davinciucberkeley-collab/DBF-Combined/redesign/interfaces/REPORT.md

# Interfaces merge report

Generated by `python -I redesign/interfaces/merge_check.py`. Do not edit by hand.

| Sources | Parts | Connection types | Edges | Errors | Warnings |
|---|---|---|---|---|---|
| 11 | 239 | 60 | 358 | 0 | 5 |

## Mass and CG (declared part data, flight parts)

| Subsystem | Parts | Status P/M/C/V | Mass g | Alloc g | CG x,y,z m | No mass | No CG |
|---|---|---|---|---|---|---|---|
| avionics | 7 | 0/7/0/0 | 36 | 45 | -0.017, 0.002, 0.062 | - | - |
| fins | 54 | 0/54/0/0 | 433 | 438 | 0.100, 0.000, 0.002 | - | - |
| harness | 38 | 0/38/0/0 | 141 | 129 | 0.066, 0.000, 0.014 | - | - |
| landing | 18 | 0/18/0/0 | 59 | 60 | 0.311, 0.000, 0.000 | - | - |
| mechanisms | 26 | 0/26/0/0 | 72 | 72 | 0.217, 0.000, -0.002 | - | - |
| pod | 12 | 0/12/0/0 | 145 | 146 | -0.007, -0.004, 0.049 | - | - |
| power | 13 | 0/13/0/0 | 626 | 630 | -0.031, -0.005, 0.046 | - | - |
| propulsion | 32 | 0/32/0/0 | 462 | 462 | 0.012, 0.000, 0.000 | - | - |
| wing | 15 | 0/15/0/0 | 392 | 405 | 0.114, 0.000, 0.005 | - | - |
| **total** | 215 | | **2367** | 2600 | 0.049, -0.001, 0.018 | | |

Budget: params/mass_budget.json

## Findings

| Severity | Check | Item | Detail |
|---|---|---|---|
| WARN | mass | harness | subsystem 141 g > allocation 129 g |
| WARN | mass | mechanisms | subsystem 72 g > allocation 72 g |
| WARN | one-sided | E-HRN-22 | avionics acknowledges an edge nobody declares |
| WARN | one-sided | E-WNG-14 | declared by wing; fins has not acknowledged it |
| WARN | one-sided | E-WNG-15 | declared by wing; fins has not acknowledged it |
