davinciucberkeley-collab/DBF-Combined/redesign/fusion/DATUMS.md

# K09-L datum sheet

Status: `PROPOSED` (A5, 2026-11-09, params revision A1-R3, geometry R3). Every designer builds from these names, never from
typed numbers. The table in section 3 is generated by `python -I redesign/fusion/k09kit.py --datums-md` from
`params/params.json` and, for the R3 points the designers own, from their subsystem files: `DP-MOTOR-FACE`,
`DX-COLLAR-*`, `DX-ANCHOR-*` from `subsystems/fins/params.json#fin_detail` (D3), `DX-FOOT-*` from
`subsystems/landing/params.json#landing.pad` (D5). `check.py` warns when the table is stale against any of them.
A datum moves only when A1 changes `params.json` or the owning designer changes those keys (and A5 regenerates).

## 1. Frame

| Item | Value | Source |
|---|---|---|
| Origin | wing root leading edge, on the chord line, in the plane of symmetry | `params.json#frame.origin` |
| +x | aft, LE → TE (cruise drag direction) | `params.json#frame.x` |
| +y | right wing tip, seen from behind in cruise | `params.json#frame.y` |
| +z | up in cruise (toward the pod) | `params.json#frame.z` |
| Handedness · units | right-handed · metres in files and code; `fusionkit` hands Fusion cm | `fusion/README.md` |
| Fusion view | Preferences > General > Design > Default modeling orientation = **Z up** | — |
| Symmetry | `DP-SYM` (y = 0) left/right; `DP-CHORD` (z = 0) upper/lower motor pairs | `params.json#frame.symmetry_plane` |
| Part position | centre of its bounding box; motors by shaft axis at the mount face | `params.json#frame.station_convention` |

## 2. Attitudes

| Attitude | Transform from the frame | Ground | Use |
|---|---|---|---|
| Cruise (model attitude) | none | — | all CAD, `interfaces.json` `cg_xyz_m`, analyses |
| Transport | none: the aircraft stays in the frame, props off, pitot boom out; the box is modelled around it, centre `DX-BOX` (`k09kit.box_frame()`) | box floor | `transport` module (flight: false), `check.py` transport fit |
| Hover / standing | rotate +90° about y (body +x → world −z, body +z → world +x), lift 0.368 m (TE 0.320 + foot 0.048, D-30) | `DP-GROUND` (x = TE + foot) on world z = 0 | renders, viewer, tip-over, ground keep-out |

`k09kit.hover_pose(params)` and `k09kit.to_hover(p, params)` give the transform. Never model a part in the hover
attitude. There is no tilt joint on K09-L: motors are fixed, the aircraft pitches as a whole.

## 3. Datums

Names: `DP-` plane (normal = the axis column), `DA-` axis (point + direction), `DX-` point. Motor stations
`UR UL LR LL`: U/L = +z/−z, R/L = +y/−y; counter-rotating pairs are diagonal (UR+LL, UL+LR). In code: `ctx.D('DP-SPAR')`
→ 0.080; `ctx.D('DX-HUB-UR')` → (−0.0082, 0.320, 0.190). In Fusion: component **00 Datums (DATUMS.md)**, grounded,
never edited by hand.

<!-- datums:begin (generated by k09kit.py --datums-md; do not edit by hand) -->
| Name | Kind | x | y | z | Normal / dir | From `params.json` | What it is |
|---|---|---|---|---|---|---|---|
| `DP-SYM` | plane | — | 0 | — | Y | `frame.symmetry_plane` | symmetry plane; ctx.mirror(plane="XZ") |
| `DP-CHORD` | plane | — | — | 0 | Z | `frame.origin` | wing chord plane; mirror plane for upper/lower motors |
| `DP-LE` | plane | 0 | — | — | X | `wing.le_x_m` | wing leading edge = frame origin |
| `DP-TE` | plane | 0.320 | — | — | X | `wing.te_x_m` | wing and fin trailing edge |
| `DP-SPAR` | plane | 0.080 | — | — | X | `wing.spar.x_m` | spar centreline station (25.0 % chord) |
| `DP-HINGE` | plane | 0.2496 | — | — | X | `wing.elevon.chord_frac` | elevon hinge line = c (1 - chord_frac) |
| `DP-CG` | plane | 0.049 | — | — | X | `cg.x_target_m` | CG target station (range in cg.x_range_m) |
| `DP-POD-LE` | plane | -0.140 | — | — | X | `pod.x_le_m` | pod front face |
| `DP-TUBE` | plane | 0.045 | — | — | X | `fins.tube.x_m` | motor-tube centreline station = fin LE |
| `DP-MOUNT` | plane | 0.034 | — | — | X | `propulsion.stations.x_mount_m` | tube front face = tube x - tube OD/2 (D-28: stays here) |
| `DP-MOTOR-FACE` | plane | 0.0244 | — | — | X | `fins/params.json#fin_detail.mount` | motor base plate face on the motor axis (D-28); the plate is canted 7 deg about this point |
| `DP-PROP` | plane | -0.0127 | — | — | X | `propulsion.stations.x_prop_plane_m` | propeller disc plane (all four props) |
| `DP-GROUND` | plane | 0.368 | — | — | X | `cg.foot_height_m` | ground in hover = TE + foot (D-30: 48 mm); nothing but feet beyond it |
| `DP-FIN-R` | plane | — | 0.320 | — | Y | `fins.y_m` | fin mid-plane, motor stations, through-core block |
| `DP-TIP-R` | plane | — | 0.575 | — | Y | `wing.span_m` | wing tip |
| `DP-SPAR-END-R` | plane | — | 0.500 | — | Y | `wing.spar.length_m` | spar end; foam outboard is unspanned |
| `DP-FIN-L` | plane | — | -0.320 | — | Y | `fins.y_m` | fin mid-plane, motor stations, through-core block |
| `DP-TIP-L` | plane | — | -0.575 | — | Y | `wing.span_m` | wing tip |
| `DP-SPAR-END-L` | plane | — | -0.500 | — | Y | `wing.spar.length_m` | spar end; foam outboard is unspanned |
| `DP-MOTOR-U` | plane | — | — | 0.190 | Z | `propulsion.stations.z_m` | upper / lower motor axis height |
| `DP-MOTOR-L` | plane | — | — | -0.190 | Z | `propulsion.stations.z_m` | upper / lower motor axis height |
| `DP-POD-BASE` | plane | — | — | 0.015 | Z | `pod.z_base_m` | pod floor on the upper skin |
| `DA-SPAR` | axis | 0.080 | 0 | 0.0066 | Y | `wing.spar.x_m` | spar axis, along Y |
| `DA-TUBE-R` | axis | 0.045 | 0.320 | 0 | Z | `fins.tube.length_m` | motor-tube axis, along Z; tube ends at z +/-0.172 |
| `DA-HINGE-R` | axis | 0.2496 | ±panel | upper skin | Y | `wing.elevon.chord_frac` | hinge line (z = upper surface, set by the module) |
| `DA-TUBE-L` | axis | 0.045 | -0.320 | 0 | Z | `fins.tube.length_m` | motor-tube axis, along Z; tube ends at z +/-0.172 |
| `DA-HINGE-L` | axis | 0.2496 | ±panel | upper skin | Y | `wing.elevon.chord_frac` | hinge line (z = upper surface, set by the module) |
| `DX-MOTOR-UR` | point | 0.045 | 0.320 | 0.190 | — | `propulsion.stations` | motor station: tube centreline at motor height; shaft along -x |
| `DX-HUB-UR` | point | -0.0127 | 0.320 | 0.190 | — | `propulsion.stations.x_prop_plane_m` | prop hub centre on the prop plane |
| `DX-FOOT-UR` | point | 0.368 | 0.320 | 0.218 | — | `landing/params.json#landing.pad` | foot pad contact on DP-GROUND: z = +/-(pad outer edge - edge round), CL-D5-CONTACT-Z, D-30 splay; tip-over pivot |
| `DX-COLLAR-UR` | point | 0.045 | 0.3023 | 0.1535 | — | `fins/params.json#fin_detail.station_collar` | brace end in the station-collar ear (tube axis x, ear just below the mount grip) |
| `DX-ANCHOR-UR` | point | 0.080 | 0.242 | 0.0266 | — | `fins/params.json#fin_detail.brace` | brace end in the anchor on the spar line (transport cradles stay inboard of it) |
| `DX-MOTOR-UL` | point | 0.045 | -0.320 | 0.190 | — | `propulsion.stations` | motor station: tube centreline at motor height; shaft along -x |
| `DX-HUB-UL` | point | -0.0127 | -0.320 | 0.190 | — | `propulsion.stations.x_prop_plane_m` | prop hub centre on the prop plane |
| `DX-FOOT-UL` | point | 0.368 | -0.320 | 0.218 | — | `landing/params.json#landing.pad` | foot pad contact on DP-GROUND: z = +/-(pad outer edge - edge round), CL-D5-CONTACT-Z, D-30 splay; tip-over pivot |
| `DX-COLLAR-UL` | point | 0.045 | -0.3023 | 0.1535 | — | `fins/params.json#fin_detail.station_collar` | brace end in the station-collar ear (tube axis x, ear just below the mount grip) |
| `DX-ANCHOR-UL` | point | 0.080 | -0.242 | 0.0266 | — | `fins/params.json#fin_detail.brace` | brace end in the anchor on the spar line (transport cradles stay inboard of it) |
| `DX-MOTOR-LR` | point | 0.045 | 0.320 | -0.190 | — | `propulsion.stations` | motor station: tube centreline at motor height; shaft along -x |
| `DX-HUB-LR` | point | -0.0127 | 0.320 | -0.190 | — | `propulsion.stations.x_prop_plane_m` | prop hub centre on the prop plane |
| `DX-FOOT-LR` | point | 0.368 | 0.320 | -0.218 | — | `landing/params.json#landing.pad` | foot pad contact on DP-GROUND: z = +/-(pad outer edge - edge round), CL-D5-CONTACT-Z, D-30 splay; tip-over pivot |
| `DX-COLLAR-LR` | point | 0.045 | 0.3023 | -0.1535 | — | `fins/params.json#fin_detail.station_collar` | brace end in the station-collar ear (tube axis x, ear just below the mount grip) |
| `DX-ANCHOR-LR` | point | 0.080 | 0.242 | -0.0127 | — | `fins/params.json#fin_detail.brace` | brace end in the anchor on the spar line (transport cradles stay inboard of it) |
| `DX-MOTOR-LL` | point | 0.045 | -0.320 | -0.190 | — | `propulsion.stations` | motor station: tube centreline at motor height; shaft along -x |
| `DX-HUB-LL` | point | -0.0127 | -0.320 | -0.190 | — | `propulsion.stations.x_prop_plane_m` | prop hub centre on the prop plane |
| `DX-FOOT-LL` | point | 0.368 | -0.320 | -0.218 | — | `landing/params.json#landing.pad` | foot pad contact on DP-GROUND: z = +/-(pad outer edge - edge round), CL-D5-CONTACT-Z, D-30 splay; tip-over pivot |
| `DX-COLLAR-LL` | point | 0.045 | -0.3023 | -0.1535 | — | `fins/params.json#fin_detail.station_collar` | brace end in the station-collar ear (tube axis x, ear just below the mount grip) |
| `DX-ANCHOR-LL` | point | 0.080 | -0.242 | -0.0127 | — | `fins/params.json#fin_detail.brace` | brace end in the anchor on the spar line (transport cradles stay inboard of it) |
| `DX-BLOCK-R` | point | 0.0625 | 0.320 | 0.0066 | — | `fins.saddle` | through-core block centre: tube bore on DA-TUBE, spar bore on DA-SPAR |
| `DX-BLOCK-L` | point | 0.0625 | -0.320 | 0.0066 | — | `fins.saddle` | through-core block centre: tube bore on DA-TUBE, spar bore on DA-SPAR |
| `DX-CG` | point | 0.049 | 0 | 0.0185 | — | `cg.x_target_m` | CG target |
| `DX-POD` | point | -0.0225 | 0 | 0.050 | — | `pod.size_m` | pod box centre |
| `DX-BOX` | point | 0.114 | 0 | 0 | — | `requirements.box_external_m` | transport box centre: aircraft upright, span along the box length, centred on the props-off envelope (box_frame) |
<!-- datums:end -->

## 4. Derived geometry designers need

Section: `subsystems/wing/s5010.dat` (B2's UIUC file, copied 2026-11-09; `k09kit.section()` reads it). Numbers from
`team/A5/claims.json` unless noted.

| Parameter | Value | Unit | Source | Status |
|---|---|---|---|---|
| Hinge line x / height of the upper skin there | 0.2496 / 0.0056 | m | `CL-A5-HINGE-X`, `CL-A5-HINGE-Z` | `CHECKED` |
| Elevon chord · section thickness at the hinge | 0.0704 · 0.0096 | m | `CALC-A5-HINGE` | `CHECKED` |
| Fin thickness (2 × `fins.board_t_m` 4.8 mm) | 0.0096 | m | `CALC-A5-ELEVON-GAPS` | `UNVERIFIED` (measure a sheet) |
| Smallest elevon end gap (fin faces, tips; the 0.14 m pod ends 155 mm ahead of the hinge) | 0.015 | m | `CL-A5-ELEVON-GAP-MIN` (≥ 0.010) | `CHECKED` |
| Spar foam cover at `wing.spar.z_m` 0.0066: upper / lower | 0.0050 / 0.0043 | m | `CL-A5-SPAR-COVER` (≥ 0.002) | `CHECKED` |
| Camber line at the spar station (x/c 0.25) | 0.0070 | m | `CL-A5-SPAR-Z-CAMBER` | `CHECKED` |
| Upper / lower skin at the tube (x 0.045) and at the spar (x 0.080) | +0.0198 / −0.0079 · +0.0226 / −0.0087 | m | `k09kit.surface_z()` | `CHECKED` |
| Motor tube (`DA-TUBE-*`): length · ends | 0.344 · z ±0.172 (18 mm short of `DP-MOTOR-U/L`) | m | `fins.tube.length_m` (D-26) | `PROPOSED` |
| Motor mount envelope: tube-end grip · plate face · caps | z ±(0.160 … 0.172) · `DP-MOTOR-FACE` 0.0309 on the axis (7° canted corners to 0.0284, D3) · z ±0.2075 | m | D3 `fin_detail.mount` | `PROPOSED` |
| Station collar (ring + ear + 40 mm tail) | z ±(0.1435 … 0.1595), x 0.031 … 0.096 | m | D3 `fin_detail.station_collar` | `PROPOSED` |
| Brace line `DX-COLLAR-*` → `DX-ANCHOR-*` (CF 10 × 3): length upper / lower | 0.145 / 0.157 | m | `k09kit.fin_brace_points()` | `CHECKED` (= D3 `fins.py`, test) |
| Anchor on the spar (20 × 16 mm, 8 mm proud) at y ±0.242; transport cradles stay inboard (≤ 0.23) | x 0.070 … 0.090 | m | D3 `fin_detail.anchor`, `transport.cradle` | `PROPOSED` |
| Through-core block envelope (`k09kit.core_block()`) | x 0.028 … 0.097, skin to skin, 36 mm wide | m | D3 `fin_detail.block` | `PROPOSED` |
| Half-fin outline (skeleton `k09kit.half_fin()`; D3's top edge slopes from the collar to a 40 mm square tip) | LE x 0.056 … TE 0.320, root on the skin, tip z ±0.210 | m | `fins.*` | `PROPOSED` |
| Foot pad contact (`DX-FOOT-*`) · pad outer edge | z ±0.218 · ±0.219 on `DP-GROUND` x 0.368 | m | D5 `landing.pad`, `CL-D5-CONTACT-Z` | `PROPOSED` |
| Aircraft envelope incl. prop discs and pitot (x · y · z) | −0.200 … 0.373 · ±0.580 · ±0.335 | m | `k09kit.envelope()` | `CHECKED` (check.py) |
| Transport box (0.54 m, D-31) in the aircraft frame: external / interior | x −0.149 … 0.402, y ±0.625, z ±0.270 / x −0.124 … 0.377, y ±0.600, z ±0.245 | m | `k09kit.box_frame()`, centre `DX-BOX` | `PROPOSED` |
| Prop keep-out | disc ⌀ 0.279 + 2 × 0.025, axial ±(0.008 + 0.025) about `DP-PROP` −0.0082 | m | `k09kit.prop_keepout()` | `PROPOSED` |

## 5. Rules

1. Read positions with `ctx.D(name)` or `ctx.value(key, unit)`; a literal that duplicates a datum fails review.
2. Build the right / upper-right part, then mirror: `k9.pair()` (through `DP-SYM`), `k9.quad()` (also `DP-CHORD`).
3. The elevon hinge is on the upper skin (`params.json#wing.elevon.hinge`): use `k9.hinge_point()`.
4. Nothing but the feet may reach `DP-GROUND`; nothing but a prop and its motor may enter a prop keep-out. The
   landing and propulsion modules register these; `check.py` enforces them.
5. Ground items (`transport`) are modelled in this frame at their transport position, around the aircraft;
   never move the aircraft to fit the box.
6. A new datum (a designer needs a shared station) is a change request to A5 with the `params.json` key it comes
   from; A5 adds it to `k09kit.datum_specs()` and regenerates this sheet.
