davinciucberkeley-collab/DBF-Combined/redesign/inputs/DECISIONS-ADOPTED.md

# Decisions adopted as inputs to redesign v1

> **Superseded in part (2026-11-09):** the team lead made the aircraft configuration open again; the only real
> constraints are the $2,000 budget, VTOL, transportability, student build and the schedule. Entries tied to the C0
> configuration (D1–D4, D12, D14, and the sizing-dependent parts of D5–D11) are void until the configuration study
> (`redesign/config-study/`) chooses a configuration. D13 (all CAD in Autodesk Fusion) and D15 still stand.

Source: one analysis agent per open decision (full write-ups in `decisions/D1.md` … `D15.md`), reconciled
2026-11-09. These are **fixed inputs** for the redesign. Status: adopted for the redesign, pending team sign-off.
A subsystem agent that believes one is wrong files a change request; it does not silently deviate.

| # | Decision | Adopted value |
|---|---|---|
| D1 | Baseline | 11-02 resize (v0.4.0) is the starting point: span 2.4 m, NACA 2415, MTOW 7.438 kg design, 4 lift + 1 pusher |
| D2 | Cruise speed | 18 m/s (stall 11.75 m/s design, R11 limit ≤ 12 m/s) |
| D3 | Mass | Sizing 7.438 kg; **hard as-built take-off limit ≤ 7.75 kg** (replaces R2's 8–15 kg target); growth margin only ~0.3 kg, so mass is tracked per subsystem |
| D4 | Payload / ballast | None. CG at 28 % MAC by layout (nose extension); ≤ 100 g nose trim allowed only as contingency, inside the 7.75 kg limit |
| D5 | Battery disconnect | Amass AS150U (anti-spark) on aircraft trunk and each pack; XT90S removed from the power path. **Pack-to-PDB wire 8 AWG** (10 AWG is under-rated at 53.9 A hover) |
| D6 | Lift ESCs | LANRC BLHeli_S 45 A, individual ESCs (4-pack × 2) |
| D7 | Airspeed | RMRC MS4525DO + pitot, I2C 0x28, `ARSPD_TYPE 1`, `ARSPD_BUS 0` (board baro SPL06 at 0x76) |
| D8 | GPS | RMRC SAM-M10Q-5883, JST-SH 6-pin |
| D9 | Spare motor | Not bought now; cash held, revisit March |
| D10 | Budget | Root `docs/purchasing/C0_BOM.csv` is the single BOM + $25 shop consumables; reserve ≥ $100 floor (expected ~$118) |
| D11 | Thermal | R21: no full mission / transition above 25 °C at the field; morning flights at Richmond Field Station; take-off hover ≤ 30 s before transition; battery-bay vents |
| D12 | Prop spec | Lift: 18.2 N hover, ≥ 29.2 N peak per rotor (T/W ≥ 1.6, R13); pusher 8.4 N at 18 m/s; 6 lift props (3 CW + 3 CCW), 2 pusher |
| D13 | CAD | **Overridden by the team lead: all CAD is done in Autodesk Fusion from now on.** The SOLIDWORKS `cad/` model and C# pipeline are frozen as the rev G reference record. The redesign Fusion model is generated by Python scripts in `redesign/fusion/` from `redesign/params/params.json`. |
| D14 | Tilt-wing | Archived; not a competing configuration |
| D15 | Links / repos | DBF-Combined GitHub Pages is canonical; old repos to be archived (team lead action) |

Cross-cutting findings to carry into the design:
- Thrust-to-weight is 1.68 vs a 1.6 floor and stall sets a ~7.76 kg ceiling: every gram counts.
- `docs/TEST-PLAN` 7.82 kg mass gate is wrong; use 7.75 kg.
- Joiner is a 6061-T6 tube with reserve factor 1.41 at ultimate (1.23 on minimum yield) — structures must re-check.
- Many existing docs are stale (SoloGood, HGLRC, MS5525, XT90S, 20 m/s). The redesign writes fresh docs; it does not patch the old ones.
