davinciucberkeley-collab/DBF-Combined/redesign/team/G1/PROCESS-TABLE.md

# G1 process table: every parts.csv line to one allowed process family

Revision G1-R1, 2026-11-13. Generated by `python -I redesign/team/G1/make_process_table.py` from `subsystems/*/parts.csv` (data: the CAD parts lists). Evidence for `R-PROCESS`.

133 part lines read from 11 subsystems; **0 exception(s)** (below).

| Process family | Lines | Subsystems |
|---|---|---|
| hot-wire XPS (templates, Jacobs: not listed, bought gear G11/H05) | 7 | pod, transport, wing |
| FDM print (PETG / ASA / TPU, see G3 print list) | 26 | avionics, fins, harness, landing, mechanisms, pod, power, wing |
| packing-tape skin / hand-laid tape | 3 | transport, wing |
| knife- or laser-cut foam board, laminated | 2 | fins, transport |
| laser-cut ply / print-and-laminate | 2 | transport |
| Coroplast score and fold, PE foam cut | 4 | transport |
| epoxy / microballoon bond or fillet | 2 | wing |
| electrical: cut, twist, solder, crimp (Electronics Lab) | 4 | harness, power |
| hand-cut foam, sheet and tube liners (knife, scissors, saw, fence) | 9 | harness, landing |
| bought, then cut / drilled / soldered to size | 21 | avionics, fins, landing, mechanisms, pod, power, propulsion, wing |
| bought, used as supplied (fasteners, wire, electronics, consumables) | 53 | avionics, fins, ground, harness, landing, mechanisms, pod, power, propulsion, transport |

## Lines per subsystem and family

| Subsystem | F1 | F2 | F3 | F4 | F5 | F6 | F7 | F8 | F9 | F10 | F11 |
|---|---|---|---|---|---|---|---|---|---|---|---|
| wing | 3 | 3 | 1 |  |  |  | 2 |  |  | 1 |  |
| fins |  | 5 |  | 1 |  |  |  |  |  | 5 | 7 |
| pod | 2 | 7 |  |  |  |  |  |  |  | 1 | 2 |
| landing |  | 4 |  |  |  |  |  |  | 7 | 1 | 1 |
| mechanisms |  | 4 |  |  |  |  |  |  |  | 5 | 3 |
| power |  | 1 |  |  |  |  |  | 2 |  | 3 | 9 |
| avionics |  | 1 |  |  |  |  |  |  |  | 4 | 2 |
| harness |  | 1 |  |  |  |  |  | 2 | 2 |  | 10 |
| propulsion |  |  |  |  |  |  |  |  |  | 1 | 7 |
| transport | 2 |  | 2 | 1 | 2 | 4 |  |  |  |  | 11 |
| ground |  |  |  |  |  |  |  |  |  |  | 1 |

Family key: F1 = hot-wire XPS (templates, Jacobs: not listed, bought gear G11/H05); F2 = FDM print (PETG / ASA / TPU, see G3 print list); F3 = packing-tape skin / hand-laid tape; F4 = knife- or laser-cut foam board, laminated; F5 = laser-cut ply / print-and-laminate; F6 = Coroplast score and fold, PE foam cut; F7 = epoxy / microballoon bond or fillet; F8 = electrical: cut, twist, solder, crimp (Electronics Lab); F9 = hand-cut foam, sheet and tube liners (knife, scissors, saw, fence); F10 = bought, then cut / drilled / soldered to size; F11 = bought, used as supplied (fasteners, wire, electronics, consumables)

## Exceptions (need a G1 decision or a parts.csv fix)

None.

## Notes

- Drilling is the only machining: motor-mount holes from a printed guide (never through the motor), pin holes through strip and laminate, brass-tube cartridge bores.
- The wing-core slot may be cut with a heated U-wire on a rail or a router with a ball bit (`wing/BUILD.md`); the router is hand-held woodshop work, not machining of a flight part to tolerance, and is allowed only as the fallback to the hot-tool route. G1 decision: hot tool first.
- Hot-wire gear is bought (`G11`, `H05`); Jacobs lists no hot-wire cutter (labs-and-equipment page, checked 2026-11-13).
