davinciucberkeley-collab/DBF-Combined/redesign/team/H1/JACOBS-LOAN-REQUEST.md

# Jacobs Hall staff questions: rewritten 2026-11-13 (was a loan request, D-72, `T-I1-BORROW`)

Status `PROPOSED`: **not sent**. Context: the owner pays the Maker Pass for the team outside the budget. The pass is drop-in access to the Jacobs Hall makerspaces
and says nothing about equipment loans (https://jacobsinstitute.berkeley.edu/making-at-jacobs/, checked 2026-11-13). The soldering station, solder, multimeters, power
supplies, oscilloscope and heat guns are on the Electronics Lab list (https://jacobsinstitute.berkeley.edu/our-spaces-at-a-glance/labs-and-equipment/, checked 2026-11-13),
so no purchase waits on a reply. The questions below are to remove the last unknowns; ask in person in the Electronics Lab (studio 110) or by email from a Berkeley account,
and file the reply as `team/H1/logs/T-I1-BORROW_<YYYYMMDD>.pdf`. Ask before the 20 Nov order if possible.

| # | Question | If yes | If no (cost, incl. tax) |
|---|---|---|---|
| 1 | Do the Electronics Lab soldering stations stock flux and desoldering wick? | do not buy `G10` | buy `G10` (gate `X10`), $16.54 |
| 2 | Does a lab multimeter read K-type thermocouples (3 channels for the ESC dummy, GT-04)? | do not buy `X09` | buy `X09`, $16.54 |
| 3 | May we hot-wire cut XPS in the shop, or machine 2 in XPS foam on the ShopBot? | a yes on the ShopBot would remove `G11` + `H05` ($62.54) if the team accepts CNC cores | keep the hot-wire gear (bought) |
| 4 | Does the Spring 2027 pass cover all four team members from 19 Jan, and when do spring trainings run? | build starts 19 Jan as planned | owner decision (outside the budget) |
| 5 | Scrap: two pieces of 3 mm mild steel plate about 40 x 200 mm, 2x4 and 18 mm plywood offcuts, 350 ohm 0.1 % resistors, a dial indicator with a magnetic base to use on the test frame | use them | `H01` hardware share, resistors about $5 `EST`; 10 mm dial re-zeroed mid-test |

Draft message for question 3 and 4 (send from a Berkeley account; the sender fills the name and contact):

> Hello Jacobs staff. We are a UC Berkeley capstone team building a 2.6 kg electric tailsitter drone. We hold Maker Passes. (1) Do the Electronics Lab stations have flux and
> desoldering wick? (2) Does a lab multimeter read K-type thermocouples? (3) We cut wing cores from 2 in XPS foam: is hot-wire cutting allowed in the shop, or may the ShopBot machine
> XPS foam? (4) Does our pass cover Spring 2027 from 19 January, and when are the spring trainings? Thank you. <name>, K09-L capstone team.
