davinciucberkeley-collab/DBF-Combined/redesign/team/I1/LINKS-CHECK.md

# Link check, I1 BOM (second pass 2026-11-11)

> R4 2026-11-13: lines G07, G08, G09 were deleted from the BOM (Electronics Lab, Maker Pass); their rows below are history. G10 is a gated fallback (X10); G11 and H05 are bought.

Method: web search plus WebFetch. Amazon, Home Depot, Zoro, Harbor Freight, Bolt Depot, getfpv and McMaster blocked fetch (403/503) and Aloft, West3D, Pyrodrone rate-limited (429), so those are 'link not opened; matched by search'. Lines opened: B05, B07, A04, M01, F05, D01, G07, G08, T09; for these price_status is CHK (seen 2026-11-11) and the page price is in the note. unit_usd is never changed. Edits live in LINK_FIXES in build_bom.py.

| line | item | old url | new url | how verified |
|---|---|---|---|---|
| B05 | Prop adapter ring APC LPAR06E-type (centres the hub on  | https://www.apcprop.com/ | https://gravesrc.com/apclpar06e-apc-adapter-rings-for-electric-propellers | opened 2026-11-11: APCLPAR06E, price seen $2.49 at Graves RC (BOM $0.50) |
| B07 | Motor screw M3x8 SHCS ISO 4762 A2 (16 fitted + 4 spare) | https://www.boltdepot.com/ | https://aspenfasteners.com/m3-0-5-x-8mm-din-912-iso-4762-metric-hex-socket-head-cap-screws-a2-stainless-steel | opened 2026-11-11: M3-0.5 x 8 A2 ISO 4762, bag of 125 (price per pack not shown) |
| A04 | Airspeed sensor RMRC digital (MS4525DO) + pitot tube | https://www.readymaderc.com/ | https://www.readymaderc.com/products/details/rmrc-digital-air-speed-sensor-pixhawk-ii-2 | opened 2026-11-11: RMRC kit, MS4525DO confirmed, price seen $59.99 (matches) |
| A05 | microSD card 16-32 GB (FC log) | https://www.amazon.com/ | https://www.amazon.com/dp/B08GY9NYRM | Amazon search result title; link not opened; matched by search |
| A06 | 2 x 150 mm U.FL / IPEX1 2.4 GHz T-antenna (dipole) for  | https://www.amazon.com/ | https://www.amazon.com/dp/B0BGN7N6PL | Amazon search result title; link not opened; matched by search |
| A07 | FC isolation set: alpha-gel 5 mm sheet (4 cubes), 1 mm  | https://www.amazon.com/ | https://www.getfpv.com/rtom-anti-vibration-moongel.html | not found; nearest substitute; link not opened; matched by search |
| M01 | Elevon servo Savox SH-0255MG+ 12 mm micro, 3.9 kgf-cm a | https://www.savoxusa.com/ | https://www.amainhobbies.com/savox-sh0255mg-digital-metal-gear-micro-servo-sav-sh-0255mg/p183344 | opened 2026-11-11: AMain SH-0255MGP, price seen $34.99 (BOM $41.99), page shows back order |
| W01 | XPS FOAMULAR NGX F-250 2 in x 4 x 8 ft (about 6 wing co | https://www.homedepot.com/ | https://www.homedepot.com/p/Owens-Corning-FOAMULAR-NGX-F-250-2-in-x-4-ft-x-8-ft-SSE-R-10-XPS-Rigid-Foam-Board-Insulation-52DDNGX/315197962 | Home Depot search result title/model; link not opened; matched by search |
| W05 | PETG filament 1 kg (Ambrosia) | https://west3d.com/ | https://west3d.com/products/ambrosia-petg-filament-of-the-gods-1kg-bambu-ams-friendly-cardboard-spools-premium-3d-printing-filament | vendor search result title and price snippet; link not opened; matched by search |
| W07 | Foam-safe glue (UHU Por / Gorilla clear) | https://www.amazon.com/ | https://www.amazon.com/dp/B004GHJ9NW | Amazon review-page URL for ASIN in search; link not opened; matched by search |
| H01 | Harness parts (F2 parts.csv HRN-103..106, 108, 109): 26 | https://www.amazon.com/ | https://www.amazon.com/dp/B0CKZCFC54 | Amazon search result title; one of six items; link not opened; matched by search |
| H02 | Mechanisms hardware (D6 parts.csv): Du-Bro 2-56 rod + s | https://www.amazon.com/ | https://www.amazon.com/dp/B0006O4G8M | Amazon search result title; one of four items; link not opened; matched by search |
| H03 | Charger-side XT60 pair for the AS150U charge adapter +  | https://www.amazon.com/ | https://www.amazon.com/dp/B08LLBMT1N | Amazon search result title; link not opened; matched by search |
| F01 | Amass AS150U connector pair (male + female) x 5: aircra | https://www.amazon.com/ | https://www.amazon.com/dp/B0BWH5D7H7 | Amazon search result title; link not opened; matched by search |
| F02 | Silicone wire 10 AWG red + black 0.3 m each (PWR-104) + | https://www.amazon.com/ | https://www.amazon.com/dp/B017TGYW3S | Amazon search result title; link not opened; matched by search |
| F03 | Silicone wire 16 AWG red + black + yellow, 3 m each (HR | https://www.amazon.com/ | https://www.amazon.com/dp/B017TFR664 | Amazon search result title; link not opened; matched by search |
| F04 | Silicone wire 20 AWG red + black, 1 m each | https://www.amazon.com/ | https://www.amazon.com/dp/B01AAX64EC | Amazon search result title; link not opened; matched by search |
| F05 | UBEC 6 V, 8 A class (Hobbywing type) | https://www.readymaderc.com/ | https://www.readymaderc.com/products/details/hobbywing-ubec-8a | opened 2026-11-11: HobbyWing UBEC-8A, price seen $18.49 (BOM $18), page says Discontinued |
| F06 | Mini blade fuse 5 A x 3 + inline holder | https://www.amazon.com/ | https://www.amazon.com/dp/B07L4QFXTB | Amazon search result title; link not opened; matched by search |
| F07 | Capacitor 680 uF 25 V low-ESR x 5 | https://www.amazon.com/ | https://www.amazon.com/pcs-Panasonic-FR-Capacitors-680uf/dp/B072SSXHW | Amazon search result title; link not opened; matched by search |
| F08 | FR4 1.6 mm 1 oz copper sheet 100 x 70 mm (bus board PWR | https://www.amazon.com/ | https://www.amazon.com/dp/B08LDXGCMJ | Amazon search result title (only exact 1.6 mm match); link not opened; matched by search |
| F09 | Adhesive-lined 3:1 heat-shrink assortment 2.4-9.5 mm (H | https://www.amazon.com/ | https://www.amazon.com/dp/B089D82FLG | Amazon search result title; link not opened; matched by search |
| C01 | M3 steel A2 kit: SHCS M3x16 x6 (D3 pinch bolts), nyloc  | https://www.boltdepot.com/ | https://boltdepot.com/Product-Details?product=4792 | Bolt Depot search snippet (product id per snippet); link not opened; matched by search |
| C06 | M3 nylon PA66 set: socket-head M3x18 x11, M3x16 x3 + he | https://www.amazon.com/ | https://www.amazon.com/dp/B0F5J2ZLXY | Amazon search result title; link not opened; matched by search |
| C02 | M3 x 5.7 brass heat-set inserts x12 + M3 nylon washers  | https://www.amazon.com/ | https://www.amazon.com/dp/B08BCRZZS3 | Amazon search result title; link not opened; matched by search |
| C03 | Pultruded CF rod 2.5 mm x 1 m x 2 (one + spare): strip  | https://www.amazon.com/ | https://alofthobbies.com/products/2-5mm-x-1000mm-rod | vendor search result title; fetch rate-limited; link not opened; matched by search |
| C04 | Loctite 243 (10 ml) + paint pen (torque witness) | https://www.amazon.com/ | https://www.amazon.com/dp/B004VODM24 | Amazon search result title; link not opened; matched by search |
| C05 | Laminating epoxy 30 min (small kit) + colloidal silica  | https://www.amazon.com/ | https://www.amazon.com/dp/B0CBLK7R2M | Amazon search result title; link not opened; matched by search |
| D01 | Pultruded CF strip 10 x 2 x 1000 mm x 1 (4 braces, FIN- | https://alofthobbies.com/ | https://alofthobbies.com/products/2mm-x-10mm-x-1000mm | opened 2026-11-11: 2 mm x 10 mm strip, price seen $5.50 (BOM $10.00), in stock |
| D02 | Pultruded CF strip 10 x 1 x 1000 mm x 3 (8 edge strips) | https://alofthobbies.com/ | https://alofthobbies.com/products/1mm-x-10mm-x-1000mm | vendor search result title; link not opened; matched by search |
| D03 | CF tube 20 x 18 x 1000 mm x 1 (D3 plugs 2 x 53 mm; C2's | https://alofthobbies.com/ | https://alofthobbies.com/products/20-x-18-x-1000mm-mw-carbon-tubing | vendor search result title; price from snippet only; link not opened; matched by search |
| D07 | Brass tube 7/32 in OD K&S x 1 (cartridge bore cutter GE | https://www.ksmetals.com/ | https://www.zoro.com/k-s-precision-metals-k-s-precision-metals-8130-022-od-x-12-l-in-round-brass-tube-691089/i/G304145442 | search result title; ksmetals.com not found; link not opened; matched by search |
| D04 | 10 mm hook-and-loop straps x 10 (ESC retention x4, spar | https://www.amazon.com/ | https://www.amazon.com/dp/B01LZK3UAR | Amazon search result title; link not opened; matched by search |
| D05 | Neoprene sheet 1/16 in 40A adhesive back 12 x 12 in | https://www.mcmaster.com/ | https://www.zoro.com/zoro-select-neoprene-sheet-40a-12x12x116-black-bulk-rs-n40txt-14/i/G4865769 | search result title; zoro.com blocked fetch; link not opened; matched by search |
| D06 | Pack straps 20 x 300 mm hook-and-loop rubber-backed x2  | https://www.amazon.com/ | https://www.amazon.com/dp/B019QYCXR8 | Amazon search result title; link not opened; matched by search |
| W08 | ASA filament 1 kg (motor mounts FIN-003, ESC pads FIN-0 | https://west3d.com/ | https://west3d.com/products/polymaker-polylite-asa-3d-printer-filament-1kg-1-75mm | vendor search result title; price from snippet only; link not opened; matched by search |
| T01 | Coroplast 4 mm 48 x 96 in x 2 (box base, lid) | https://www.homedepot.com/ | https://www.homedepot.com/p/Coroplast-48-in-x-96-in-x-0-157-in-White-Corrugated-Plastic-Sheet-CP4896S/205351385 | Home Depot search result title; price from snippet only; link not opened; matched by search |
| T02 | LSE double-sided tape, 1 roll (3M 300LSE class) | https://www.homedepot.com/ | https://www.pelicansalessupply.com/products/3m-adhesive-transfer-tape-3-4-wide-60-yd-series-9472le | search result title; fetch rate-limited; link not opened; matched by search |
| T03 | Cam-buckle straps x2 + strap handles x3 | https://www.homedepot.com/ | https://www.homedepot.com/p/Keeper-1-in-x-6-ft-x-400-lbs-Motorcycle-Cam-Buckle-Tie-Down-2-Pack-05715/204752873 | Home Depot search result title; link not opened; matched by search |
| T04 | Field pouch + 10 mm prop spanner (D-40) + M3x16 / nyloc | https://www.homedepot.com/ | https://www.harborfreight.com/12-in-zipper-utility-pouch-black-70998.html | search result title; harborfreight.com blocked fetch; link not opened; matched by search |
| T05 | Landing mat 0.8 x 0.8 m: 3 mm birch ply (Jacobs stock)  | https://www.homedepot.com/ | https://www.homedepot.com/p/Rubber-Cal-Neoprene-1-16-in-x-36-in-x-12-in-Commercial-Grade-45A-Soft-Rubber-Sheet-Rolls-20-104-0062-36-012/303172042 | Home Depot search result title; link not opened; matched by search |
| T06 | PE foam plank 2 in + 1 in (cradle columns, lid pillars) | https://www.homedepot.com/ | https://www.homedepot.com/p/Customizable-Polyethylene-Foam-Sheets-16L-x-12W-x-1-Thick-Padding-for-Cases-Tool-Foam-for-Packaging-Crafts-2-Pack-638PH01222D/336659215 | not found; nearest substitute; link not opened; matched by search |
| T07 | Field tote about 0.45 x 0.35 x 0.25 m (TX, landing-spar | https://www.homedepot.com/ | https://www.homedepot.com/p/Husky-12-Gal-Professional-Heavy-Duty-Waterproof-Stackable-Plastic-Storage-Container-with-Hinged-Lid-in-Red-248921/313861297 | Home Depot search result title; link not opened; matched by search |
| T08 | Landing-spares box 1 L food container (TRN-108) | https://www.homedepot.com/ | https://www.homedepot.com/p/OXO-Good-Grips-1-5-Qt-Short-Round-POP-Food-Storage-Container-with-Airtight-Lid-11283800/315329961 | Home Depot search result title; link not opened; matched by search |
| T09 | Labels for lid and end walls (TRN-109) | https://www.homedepot.com/ | https://www.avery.com/products/labels/5163 | opened 2026-11-11: Avery 5163 2x4 in, 1000 labels, price seen $46.99 (BOM $2.00) |
| H05 | Hot-wire bow/jig + airfoil template stock |  | https://www.amazon.com/dp/B0FBL3342W | Amazon search result title; partial; link not opened; matched by search |
| R02 | 18650 cells, 2-pack for the Pocket (not included) | https://www.getfpv.com/ | https://www.getfpv.com/lumenier-nav-3000mah-1s-18650-lithium-ion-battery-2pcs.html | vendor search result title and price snippet; link not opened; matched by search |
| G02 | LiPo bag (Pyrodrone) | https://pyrodrone.com/ | https://pyrodrone.com/products/pyrodrone-lipo-safe-pouch | vendor search result title; price from snippet only; link not opened; matched by search |
| G06 | Thrust stand: 20 kg load cell + HX711 + Nano | https://www.amazon.com/ | https://www.amazon.com/dp/B07BGS58TL | Amazon search result title; link not opened; matched by search |
| G07 | Soldering iron Pinecil V2 | https://pine64.com/ | https://pine64.com/product/pinecil-smart-mini-portable-soldering-iron/ | opened 2026-11-11: Pinecil V2, price seen $25.99 (matches), in stock |
| G08 | USB-C PD supply for the iron | https://www.amazon.com/ | https://www.anker.com/products/a2663 | opened 2026-11-11: Anker 715 (Nano II 65 W), 20 V 3.25 A PD, price seen $29.99 (BOM $20.00) |
| G09 | Multimeter | https://www.amazon.com/ | https://www.amazon.com/dp/B071JL6LLL | Amazon search result title; link not opened; matched by search |
| G10 | Solder, flux, wick | https://www.amazon.com/ | https://www.amazon.com/dp/B0H94VTN26 | Amazon search result title; link not opened; matched by search |
| G12 | Ground-test additions: 1 kgf bar cell + HX711 (torque a | https://www.amazon.com/ | https://www.amazon.com/dp/B0F52QCK3T | Amazon search result title; partial; link not opened; matched by search |
| G13 | 2 foil strain gauges 350 ohm (pack of 5-10) + cyanoacry | https://www.amazon.com/ | https://www.amazon.com/dp/B07WYD7Z4P | Amazon search result title; link not opened; matched by search |

NO PRODUCT PAGE FOUND (partial or none): A07, T06, H05
