davinciucberkeley-collab/DBF-Combined/redesign/team/I2/SCHEDULE.md

# I2 schedule: 16 Nov 2026 to 30 Apr 2027, team of 4

Revision I2-R1, 2026-11-13. Status `PROPOSED`; generated by `python -I redesign/team/I2/make_schedule.py` from the task list in that file (forward and backward pass, so
the critical path and slack below are computed). Hours are `EST` unless a source is named. Owners are roles (P1 wing and fin structure, P2 electrical and software, P3 printing,
pod, mechanisms and landing, P4 test, compliance and pilot), not names: the team assigns people. Requirement ids: `R-SCHEDULE`, `R-BUILD-HOURS` (A2).

## Verdict

| Item | Plan | Requirement | Status |
|---|---|---|---|
| First cut | 19 Jan 2027 (build week 1) | build start 2027-01-19 (`params.json#schedule`) | on date |
| First tethered hover | 22 Feb - 24 Feb (build week 5) | `R-SCHEDULE`: build week 4; `MANUFACTURING.md` section 5: week 5 is the honest target | **week 5 is the baseline; week 4 is the stretch. The two documents disagree: A1 decides** (`CR-I2-01`) |
| First transition (gate 6) | 14 Mar - 20 Mar (build week 8) | build week 7 | one week late (build week 8 vs 7); `MANUFACTURING.md` calls week 7 a stretch (`CR-I2-01`) |
| Crash-repair loop | 21 Mar - 31 Mar, 11 d | >= 1.5 weeks calendar (10.5 d) | meets, as a contingency block |
| Last task ends | 28 Apr 2027 (F06) | complete by 2027-04-30 | meets; slack of the last task 2 d |
| Build hours to first hover | 113.5 h (airframe, electrical, checks; excludes the transport box) from the BUILD-GUIDE stage times | <= 90 h (`R-BUILD-HOURS`) | **FAIL by 23.5 h on the guide's own stage times** (`CR-I2-02`) |
| Hours before first cut (Nov-Jan) | 226 h (EST) | not bounded | shifts hours out of the 3-week window; the requirement text does not say whether pre-work counts |
| Twin flown before the 15 Dec order | 08 Dec - 13 Dec | `R-SCHEDULE` | meets (needs the 7-business-day request out by 24 Nov) |
| Early order 20 Nov, December order 15 Dec | tasks `O01`, `OR2`; arrivals `O02`, `OR3` | `ORDER-PLAN.md` | consistent with its lead times (5 d; packs 14 d; servos 7 d) |

Facts the plan rests on, each from a page checked on 2026-11-13 unless stated:

- Fall instruction and Jacobs fall access end 18 Dec; spring instruction starts 19 Jan 2027, spring recess 22-26 Mar (third-party calendar sites; the Registrar page was not fetched: confirm) (https://berkeleyglobal.zendesk.com/hc/en-us/articles/4641371985943-Class-Start-Dates, search 2026-11-13).
- Jacobs Maker Pass: drop-in access, hands-on trainings only in the first half of each semester (https://jacobsinstitute.berkeley.edu/making-at-jacobs/). **The fall window (31 Aug - 23 Oct, `review/MANUFACTURING.md`) is already closed.** Any tool that needs hands-on training is therefore at risk until spring week 1 (`CR-I2-03`). `M02` asks staff in the week of 16 Nov.
- Soldering is Electronics Lab only (no loans, no home iron after the R4 BOM change): `EL1` before 18 Dec, `B12` and `B13` from 19 Jan. The closure block `HR1` contains no soldering.
- RFS: flight request 7 business days ahead (campus policy, https://oercs.berkeley.edu/policies/campus-policy-library/unmanned-aircraft-system-drone-policy), RFS asks 72 h (https://rfs.berkeley.edu/services.html); flights 06:00 to sunset only, so the flight card's 07:00-10:00 window sits inside it.
- Hot-wire cutting is not a Jacobs capability: the team needs a ventilated place (`CR-I2-04`, owner to name it) for `W01`, `B01`.

## Gantt (week commencing Monday; `#` = task active with slack, **X** = active on the critical path)

| ID | Task | Own | 11/16 | 11/23 | 11/30 | 12/7 | 12/14 | 12/21 | 12/28 | 1/4 | 1/11 | 1/18 | 1/25 | 2/1 | 2/8 | 2/15 | 2/22 | 3/1 | 3/8 | 3/15 | 3/22 | 3/29 | 4/5 | 4/12 | 4/19 | 4/26 | Start | End | Slack d |
|---|---|---|---|---|---|---|---|---|---|---|---|---|---|---|---|---|---|---|---|---|---|---|---|---|---|---|---|---|---|
| M01 | Compliance: TRUST, UC Drone Program, AMA / insurance answer, FAA registration | 4 | # | # |  |  |  |  |  |  |  |  |  |  |  |  |  |  |  |  |  |  |  |  |  |  | 16 Nov | 23 Nov | 23 |
| M02 | Jacobs: Spring-pass and training answers, flux/wick and K-type check (T-I1-BORROW) | 4 | # |  |  |  |  |  |  |  |  |  |  |  |  |  |  |  |  |  |  |  |  |  |  |  | 16 Nov | 20 Nov | 15 |
| S01 | SITL install and >= 10 h pilot log (R-PILOT) | 4 | # | # | # | # | # | # |  |  |  |  |  |  |  |  |  |  |  |  |  |  |  |  |  |  | 16 Nov | 25 Dec | 60 |
| O01 | Early order placed (20 Nov): packs and FC carts first | 2 | # |  |  |  |  |  |  |  |  |  |  |  |  |  |  |  |  |  |  |  |  |  |  |  | 21 Nov | 21 Nov | 15 |
| O02 | Early order arrives (lead 5 d EST, Thanksgiving week: allow 7) | 2 | # | # |  |  |  |  |  |  |  |  |  |  |  |  |  |  |  |  |  |  |  |  |  |  | 22 Nov | 28 Nov | 15 |
| O03 | Ovonic packs arrive (ships from Germany, about 14 d); weigh, log | 2 | # | # | # |  |  |  |  |  |  |  |  |  |  |  |  |  |  |  |  |  |  |  |  |  | 22 Nov | 05 Dec | 21 |
| TW2 | RFS flight request for twin days (7 business days ahead; RFS 72 h) | 4 |  | # | # |  |  |  |  |  |  |  |  |  |  |  |  |  |  |  |  |  |  |  |  |  | 24 Nov | 03 Dec | 23 |
| WN1 | RFS anemometer mornings x 3 (R-WIND-MEASURE) | 4 |  | # | # | # |  |  |  |  |  |  |  |  |  |  |  |  |  |  |  |  |  |  |  |  | 24 Nov | 07 Dec | 144 |
| H01 | Thrust stand build and calibration (GT-01), stand campaign (GT-02/03) | 1,2 |  | # | # | # |  |  |  |  |  |  |  |  |  |  |  |  |  |  |  |  |  |  |  |  | 29 Nov | 12 Dec | 15 |
| W01 | Hot-wire bow, templates (laser), practice cores x 2-3, LE sanding | 1,3 |  | # | # | # | # |  |  |  |  |  |  |  |  |  |  |  |  |  |  |  |  |  |  |  | 29 Nov | 16 Dec | 36 |
| TW1 | Foam-board twin build (about $40) | 3,2 |  |  | # | # |  |  |  |  |  |  |  |  |  |  |  |  |  |  |  |  |  |  |  |  | 30 Nov | 07 Dec | 19 |
| W02 | Test coupons, fin test article, tube bend test (GT-15/16): result to I1 by 10 Dec | 1,3 |  |  | # | # |  |  |  |  |  |  |  |  |  |  |  |  |  |  |  |  |  |  |  |  | 30 Nov | 11 Dec | 16 |
| W03 | Print jigs and test articles (clocking jig, cant gauge, drill guides) | 3 |  |  | # | # |  |  |  |  |  |  |  |  |  |  |  |  |  |  |  |  |  |  |  |  | 30 Nov | 11 Dec | 17 |
| EL1 | Electronics Lab days before Jacobs closes (18 Dec): bus board, AS150U, ESC leads, FC flash | 2 |  |  | # | # | # |  |  |  |  |  |  |  |  |  |  |  |  |  |  |  |  |  |  |  | 01 Dec | 17 Dec | 23 |
| TW3 | Twin flights: hover in 5 m/s, QLOITER 30 m, transition (R-TWIN) | 4,2,1,3 |  |  |  | # |  |  |  |  |  |  |  |  |  |  |  |  |  |  |  |  |  |  |  |  | 08 Dec | 13 Dec | 19 |
| OR2 | December order placed (15 Dec): Aloft cart first, servos same day | 2 |  |  |  |  | # |  |  |  |  |  |  |  |  |  |  |  |  |  |  |  |  |  |  |  | 15 Dec | 15 Dec | 18 |
| OR3 | December order arrives (lands about 20-22 Dec; the overseas carbon fallback would be 14 d: a risk, not the baseline) | 2 |  |  |  |  | # | # |  |  |  |  |  |  |  |  |  |  |  |  |  |  |  |  |  |  | 16 Dec | 22 Dec | 18 |
| FZ1 | Design freeze (18 Dec): CG fix, fin tip, collar, pins, mount material | 1,2,3,4 |  |  |  |  | # |  |  |  |  |  |  |  |  |  |  |  |  |  |  |  |  |  |  |  | 18 Dec | 18 Dec | 10 |
| PR1 | Home printing: blocks, collars (after freeze), pod prints, feet, pistons, mounts (ASA) | 3 |  |  |  |  | # | # | # | # | # |  |  |  |  |  |  |  |  |  |  |  |  |  |  |  | 19 Dec | 17 Jan | 10 |
| HR1 | Harness cut, labelled, twisted; ESC and FC flash; Plane 4.7; K09L.param; SITL (no soldering) | 2 |  |  |  |  |  | # | # | # | # | # |  |  |  |  |  |  |  |  |  |  |  |  |  |  | 23 Dec | 19 Jan | 18 |
| B03 | Spar plugs bonded (24 h cure): done before build week 1 in the home workspace (CR-I2-04), tube and plugs only | 1 |  |  |  |  |  |  |  | # |  |  |  |  |  |  |  |  |  |  |  |  |  |  |  |  | 04 Jan | 05 Jan | 22 |
| B01 | Cut cores 1 and 2, sand LE, accept core 1 by gauge | 1 |  |  |  |  |  |  |  |  |  | # |  |  |  |  |  |  |  |  |  |  |  |  |  |  | 19 Jan | 21 Jan | 3 |
| B08 | Fin laminates and cuts (3M 77, spray booth); half-fin boards | 3 |  |  |  |  |  |  |  |  |  | # |  |  |  |  |  |  |  |  |  |  |  |  |  |  | 19 Jan | 21 Jan | 13 |
| B11 | Pod box, tray, recess fillet, pod into the recess, handle (3 cures) | 3 |  |  |  |  |  |  |  |  |  | # | # | # |  |  |  |  |  |  |  |  |  |  |  |  | 19 Jan | 01 Feb | 12 |
| B12 | Power stack on the bench (Electronics Lab: soldering), weigh 88 g | 2 |  |  |  |  |  |  |  |  |  | # |  |  |  |  |  |  |  |  |  |  |  |  |  |  | 19 Jan | 23 Jan | 14 |
| B02 | Spar slot, pockets, grooves (core in its bed) | 1 |  |  |  |  |  |  |  |  |  | # |  |  |  |  |  |  |  |  |  |  |  |  |  |  | 22 Jan | 24 Jan | 3 |
| B04 | Spar and blocks in the clocking jig (cure) | 1,3 |  |  |  |  |  |  |  |  |  |  | **X** |  |  |  |  |  |  |  |  |  |  |  |  |  | 26 Jan | 27 Jan | 2 |
| B05 | Bond spar and blocks into the core, beads, weight on the bed (24 h cure) | 1 |  |  |  |  |  |  |  |  |  |  | **X** |  |  |  |  |  |  |  |  |  |  |  |  |  | 28 Jan | 29 Jan | 2 |
| B06 | Elevons free, torque-tube grooves | 1 |  |  |  |  |  |  |  |  |  |  | # |  |  |  |  |  |  |  |  |  |  |  |  |  | 30 Jan | 31 Jan | 89 |
| B07 | Motor tubes cut, plugged, through the blocks, squared in the jig (cure) | 1,3 |  |  |  |  |  |  |  |  |  |  | **X** | **X** |  |  |  |  |  |  |  |  |  |  |  |  | 30 Jan | 01 Feb | 2 |
| TB1 | Transport box and mat (X07 kit if the gate passes) | 3,4 |  |  |  |  |  |  |  |  |  |  |  | # | # |  |  |  |  |  |  |  |  |  |  |  | 01 Feb | 14 Feb | 75 |
| B09 | Half-fin roots and cove fillets (weigh a cup per batch) | 1,3 |  |  |  |  |  |  |  |  |  |  |  | **X** |  |  |  |  |  |  |  |  |  |  |  |  | 02 Feb | 04 Feb | 2 |
| FR1 | RFS flight request for the first hover block | 4 |  |  |  |  |  |  |  |  |  |  |  | # | # |  |  |  |  |  |  |  |  |  |  |  | 03 Feb | 12 Feb | 11 |
| B10 | Collars, strips, pins, braces, ESC pads, heat-tent post-cure | 1,3 |  |  |  |  |  |  |  |  |  |  |  | # | # |  |  |  |  |  |  |  |  |  |  |  | 05 Feb | 09 Feb | 4 |
| B13 | Harness solder and route; JR recesses; T-F2-CONT | 2 |  |  |  |  |  |  |  |  |  |  |  | **X** | **X** |  |  |  |  |  |  |  |  |  |  |  | 05 Feb | 11 Feb | 2 |
| B14 | Skin the wing (two people) | 1,3 |  |  |  |  |  |  |  |  |  |  |  |  | **X** |  |  |  |  |  |  |  |  |  |  |  | 12 Feb | 13 Feb | 2 |
| B15 | Servos, linkage, hinges (both sides in parallel, 2 x 24 h cures) | 3,1 |  |  |  |  |  |  |  |  |  |  |  |  | **X** | **X** |  |  |  |  |  |  |  |  |  |  | 14 Feb | 16 Feb | 2 |
| B16 | Motor mounts, motors, props, slip test, spin test | 1,2 |  |  |  |  |  |  |  |  |  |  |  |  | **X** | **X** |  |  |  |  |  |  |  |  |  |  | 14 Feb | 16 Feb | 2 |
| B17 | Avionics and calibration | 2 |  |  |  |  |  |  |  |  |  |  |  |  | # | # |  |  |  |  |  |  |  |  |  |  | 14 Feb | 15 Feb | 3 |
| B18 | Feet and corner caps (cure) | 3 |  |  |  |  |  |  |  |  |  |  |  |  | **X** | **X** |  |  |  |  |  |  |  |  |  |  | 14 Feb | 16 Feb | 2 |
| B19 | Weigh, CG, control directions, stand run-up, compassmot (GT-06/07/12/13/18) | 1,2,3,4 |  |  |  |  |  |  |  |  |  |  |  |  |  | **X** |  |  |  |  |  |  |  |  |  |  | 17 Feb | 20 Feb | 2 |
| RG1 | RC range check GT-14 (T-F5-RANGE), props off | 2,4 |  |  |  |  |  |  |  |  |  |  |  |  |  | **X** |  |  |  |  |  |  |  |  |  |  | 21 Feb | 21 Feb | 2 |
| F01 | First tethered hover (gate 3) | 4,2,1,3 |  |  |  |  |  |  |  |  |  |  |  |  |  |  | **X** |  |  |  |  |  |  |  |  |  | 22 Feb | 24 Feb | 2 |
| F02 | Free hover, QLOITER, landing practice (gate 4) | 4,2 |  |  |  |  |  |  |  |  |  |  |  |  |  |  | **X** | **X** |  |  |  |  |  |  |  |  | 25 Feb | 04 Mar | 2 |
| F03 | Fixed-wing tune as a plain flying wing (gate 5) | 4,2 |  |  |  |  |  |  |  |  |  |  |  |  |  |  |  | **X** | **X** |  |  |  |  |  |  |  | 05 Mar | 13 Mar | 2 |
| F04 | First transition at >= 50 m (gate 6) and back-transition (gate 7) | 4,2,1 |  |  |  |  |  |  |  |  |  |  |  |  |  |  |  |  | **X** | **X** |  |  |  |  |  |  | 14 Mar | 20 Mar | 2 |
| CR1 | Crash-repair loop (contingency block, >= 1.5 weeks calendar) | 1,3 |  |  |  |  |  |  |  |  |  |  |  |  |  |  |  |  |  | **X** | **X** | **X** |  |  |  |  | 21 Mar | 31 Mar | 2 |
| F05 | Transition round trips, landing practice in calm air (gates 7-8) | 4,2 |  |  |  |  |  |  |  |  |  |  |  |  |  |  |  |  |  |  |  | **X** | **X** | **X** |  |  | 01 Apr | 12 Apr | 2 |
| F06 | Full mission demonstrations (gate 9), data and report | 4,2,1,3 |  |  |  |  |  |  |  |  |  |  |  |  |  |  |  |  |  |  |  |  |  | **X** | **X** | **X** | 13 Apr | 28 Apr | 2 |

## Critical path

Computed as the tasks with the least slack (the minimum over all tasks, 2 d) against 30 Apr: B04 > B05 > B07 > B09 > B13 > B14 > B15 > B16 > B18 > B19 > RG1 > F01 > F02 > F03 > F04 > CR1 > F05 > F06.

| Task | Start | End | Why it is on the path |
|---|---|---|---|
| B04 Spar and blocks in the clocking jig (cure) | 26 Jan | 27 Jan | wing/BUILD.md step 7; MF-06 |
| B05 Bond spar and blocks into the core, beads, weight on the bed (24 h cure) | 28 Jan | 29 Jan | wing/BUILD.md step 8 |
| B07 Motor tubes cut, plugged, through the blocks, squared in the jig (cure) | 30 Jan | 01 Feb | BUILD-GUIDE stage 4 step 2 (stage 4 total 16 h, split EST) |
| B09 Half-fin roots and cove fillets (weigh a cup per batch) | 02 Feb | 04 Feb | BUILD-GUIDE stage 4 step 3 |
| B13 Harness solder and route; JR recesses; T-F2-CONT | 05 Feb | 11 Feb | BUILD-GUIDE stage 6 (1-2 days) |
| B14 Skin the wing (two people) | 12 Feb | 13 Feb | BUILD-GUIDE stage 6 (3-4 h for two people) |
| B15 Servos, linkage, hinges (both sides in parallel, 2 x 24 h cures) | 14 Feb | 16 Feb | BUILD-GUIDE stage 7 (half a day per side) |
| B16 Motor mounts, motors, props, slip test, spin test | 14 Feb | 16 Feb | BUILD-GUIDE stage 8 (1 h per station) |
| B18 Feet and corner caps (cure) | 14 Feb | 16 Feb | BUILD-GUIDE stage 10 (1 h bench + cartridges most of a day) |
| B19 Weigh, CG, control directions, stand run-up, compassmot (GT-06/07/12/13/18) | 17 Feb | 20 Feb | BUILD-GUIDE stage 11 (about 2 days); H1 plan |
| RG1 RC range check GT-14 (T-F5-RANGE), props off | 21 Feb | 21 Feb | team/F5/RANGE-TEST.md |
| F01 First tethered hover (gate 3) | 22 Feb | 24 Feb | team/H2/FLIGHT-TEST-PLAN.md gate 3 |
| F02 Free hover, QLOITER, landing practice (gate 4) | 25 Feb | 04 Mar | H2 plan gate 4 |
| F03 Fixed-wing tune as a plain flying wing (gate 5) | 05 Mar | 13 Mar | H2 plan gate 5; F4 TUNING-PLAN steps 6-6d |
| F04 First transition at >= 50 m (gate 6) and back-transition (gate 7) | 14 Mar | 20 Mar | H2 plan gates 6-7; R-SCHEDULE wk 7 |
| CR1 Crash-repair loop (contingency block, >= 1.5 weeks calendar) | 21 Mar | 31 Mar | R-SCHEDULE; MANUFACTURING.md section 5 (core 4-5 days through the cure chain) |
| F05 Transition round trips, landing practice in calm air (gates 7-8) | 01 Apr | 12 Apr | H2 plan |
| F06 Full mission demonstrations (gate 9), data and report | 13 Apr | 28 Apr | H2 plan gate 9; R-MISSION |

Long poles named by `MANUFACTURING.md`: design freeze (`FZ1`), Jacobs access and training (`M02`), Ovonic packs from Germany (`O03`, 14 d), Aloft carbon (`OR3`). The
path through the build is core, spar and blocks in the jig, tubes, collars, pins and braces, skin, bench checks, hover; the pod chain (`B11`) joins before skinning.
A late freeze or a failed fin-station decision (STATUS issue 1) moves every later date one-for-one.

## Team-of-4 load (person-hours per week, `EST`)

| Person | Total h | Peak week |
|---|---|---|
| P1 | 114 | 22.9 (week of 07 Dec) |
| P2 | 155 | 22.2 (week of 30 Nov) |
| P3 | 144 | 21.9 (week of 30 Nov) |
| P4 | 99 | 9.3 (week of 16 Nov) |

| Week of | P1 | P2 | P3 | P4 | Team h |
|---|---|---|---|---|---|
| 16 Nov | 0.0 | 3.0 | 0.0 | 9.3 | 12.3 |
| 23 Nov | 0.0 | 3.0 | 0.0 | 6.2 | 9.2 |
| 30 Nov | 17.9 | 22.2 | 21.9 | 5.8 | 67.8 |
| 07 Dec | 22.9 | 21.7 | 20.9 | 7.9 | 73.4 |
| 14 Dec | 4.2 | 11.4 | 4.2 | 3.3 | 23.1 |
| 21 Dec | 0.0 | 2.6 | 6.0 | 2.3 | 10.9 |
| 28 Dec | 0.0 | 3.0 | 6.0 | 0.0 | 9.0 |
| 04 Jan | 1.0 | 3.0 | 6.0 | 0.0 | 10.0 |
| 11 Jan | 0.0 | 3.0 | 6.0 | 0.0 | 9.0 |
| 18 Jan | 9.0 | 4.2 | 6.4 | 0.0 | 19.6 |
| 25 Jan | 8.5 | 0.0 | 5.7 | 0.0 | 14.2 |
| 01 Feb | 4.5 | 2.4 | 9.1 | 4.1 | 20.1 |
| 08 Feb | 5.5 | 9.6 | 9.2 | 4.4 | 28.7 |
| 15 Feb | 10.0 | 15.5 | 17.0 | 5.5 | 48.0 |
| 22 Feb | 4.0 | 7.3 | 4.0 | 7.3 | 22.7 |
| 01 Mar | 0.0 | 8.3 | 0.0 | 8.3 | 16.7 |
| 08 Mar | 0.0 | 8.3 | 0.0 | 8.3 | 16.7 |
| 15 Mar | 5.3 | 5.3 | 0.0 | 5.3 | 16.0 |
| 22 Mar | 7.5 | 0.0 | 7.5 | 0.0 | 15.0 |
| 29 Mar | 4.5 | 3.0 | 4.5 | 3.0 | 15.0 |
| 05 Apr | 0.0 | 7.5 | 0.0 | 7.5 | 15.0 |
| 12 Apr | 3.0 | 4.5 | 3.0 | 4.5 | 15.0 |
| 19 Apr | 3.8 | 3.8 | 3.8 | 3.8 | 15.0 |
| 26 Apr | 2.2 | 2.2 | 2.2 | 2.2 | 9.0 |

Capacity per student per week is **not in the repo** (`—`): the team states it before the freeze. Peaks above that capacity move tasks right, which the critical path above shows.
Flight-phase durations assume 5.0 to 5.7 usable mornings a week (`config-study/tiebreak/DECISION.md`, wind at 07-10 h), so 8-16 calendar days hold 6 to 13 flying mornings. Durations are calendar days including weekends and cures; weekend work is assumed in the build window. Hours of one task are spread evenly over its Mon-Fri days among its owners; the table is a load picture, not a roster.

## Open items for people

| # | Item | Why | By |
|---|---|---|---|
| CR-I2-01 | A1: hover in build week 4 (`R-SCHEDULE`) or 5 (`MANUFACTURING.md`)? | the stage times sum past 90 h and the cure chain needs 4 weeks to the restrained run | before 18 Dec |
| CR-I2-02 | A2 and G4: does `R-BUILD-HOURS` count pre-build work (printing, harness cut, templates)? | 114 h on the stage times vs 90 h | before 18 Dec |
| CR-I2-03 | Team: ask Jacobs staff for hands-on trainings now (laser, printer, drill press, woodshop, electronics) | the fall hands-on window closed 23 Oct; spring window opens with the term | week of 16 Nov |
| CR-I2-04 | Team: name a ventilated workspace for hot-wire cutting, epoxy and spray lamination (spray booth is at Jacobs) | Jacobs lists no hot-wire cutter; XPS fumes (`BUILD-GUIDE.md` safety) | before 30 Nov |
| CR-I2-05 | Owner: Spring 2027 Maker Pass for all four from 19 Jan | the pass is semesterly and not transferable (https://jacobsaccess.ist.berkeley.edu/Maker-Pass-troubleshooting.html) | before 19 Jan |
