davinciucberkeley-collab/DBF-Combined/redesign/collision/out/REPORT.md

# Interference check (no parts phasing)

Generated by `collision/collide.py` on 2026-11-12 from the stub-backend CAD (the geometry the GLB and the shop STLs are made from). Depth = how far a point of one part lies inside a different part (deepest sampled point); touching faces measure ~0 and pass. Error threshold 0.05 mm; listed from 0.01 mm.

**PASS.** 1077 bodies in 212 parts; 3 poses (static + each elevon joint at each limit); 359 s. Wire ends not seated in a part: 0.

## static

| Part A | Part B | Depth mm | At (x, y, z) mm | Deepest bodies | Result |
|---|---|---|---|---|---|
| GER-007-L | WNG-001 | 0.043 | 305.7, -563.8, -1.3 | WNG-001 "xps core y0.560-0.575" x GER-007-L "cap U" 0.04 mm | below tol |
| GER-007-R | WNG-001 | 0.043 | 305.7, 561.9, -1.3 | WNG-001 "xps core y0.560-0.575" x GER-007-R "cap U" 0.04 mm | below tol |
| FIN-001-UR | WNG-001 | 0.026 | 117.2, 325.6, 22.0 | FIN-001-UR "root fillet" x WNG-001 "xps core y0.305-0.335 aft" 0.03 mm; FIN-001-UR "root fillet" x WNG-001 "xps core y0.305-0.335 aft" 0.03 mm ... | below tol |
| FIN-001-UL | WNG-001 | 0.026 | 117.2, -325.6, 22.0 | FIN-001-UL "root fillet" x WNG-001 "xps core y0.305-0.335 aft" 0.03 mm; FIN-001-UL "root fillet" x WNG-001 "xps core y0.305-0.335 aft" 0.03 mm ... | below tol |
| E-HRN-29#3 | E-HRN-29#4 | 0.020 | 53.9, 61.3, 36.6 | E-HRN-29 "wire strand 3 (0.9 mm)" x E-HRN-29 "wire strand 4 (1.3 mm)" 0.02 mm | below tol |
| WNG-001 | WNG-003 | 0.019 | 283.7, -338.1, 1.8 | WNG-001 "xps core y0.302-0.303 aft" x WNG-003 "tape skin aft upper" 0.02 mm; WNG-001 "xps core y0.337-0.338 aft" x WNG-003 "tape skin aft upper" 0.02 mm ... | below tol |
| E-HRN-29 | WNG-003 | 0.018 | 109.2, 96.8, 22.3 | E-HRN-29 "wire strand 5 (1.3 mm)" x WNG-003 "tape skin upper" 0.02 mm | below tol |
| E-HRN-29#4 | E-HRN-29#5 | 0.015 | 52.8, 60.9, 36.7 | E-HRN-29 "wire strand 4 (1.3 mm)" x E-HRN-29 "wire strand 5 (1.3 mm)" 0.01 mm | below tol |
| E-HRN-28#4 | E-HRN-28#5 | 0.012 | 52.7, 56.4, 35.5 | E-HRN-28 "wire strand 4 (1.3 mm)" x E-HRN-28 "wire strand 5 (1.3 mm)" 0.01 mm | below tol |
| E-HRN-28#3 | E-HRN-28#4 | 0.010 | 54.0, 56.8, 35.7 | E-HRN-28 "wire strand 3 (0.9 mm)" x E-HRN-28 "wire strand 4 (1.3 mm)" 0.01 mm | below tol |

## elevons at lower limit (E-WNG-06 -25, E-WNG-04 -25, E-WNG-07 -25, E-WNG-05 -25)

Moved: MEC-004-L, MEC-004-R, MEC-005-L, MEC-005-R, MEC-006-L, MEC-006-R, MEC-009-LI, MEC-009-LO, MEC-009-RI, MEC-009-RO, WNG-011-L, WNG-011-R, WNG-012-L, WNG-012-R.

Not checked against the moved parts (linkage path not modelled): MEC-003-L, MEC-003-R, MEC-010-L, MEC-010-R.

No overlaps.

## elevons at upper limit (E-WNG-06 +25, E-WNG-04 +25, E-WNG-07 +25, E-WNG-05 +25)

Moved: MEC-004-L, MEC-004-R, MEC-005-L, MEC-005-R, MEC-006-L, MEC-006-R, MEC-009-LI, MEC-009-LO, MEC-009-RI, MEC-009-RO, WNG-011-L, WNG-011-R, WNG-012-L, WNG-012-R.

Not checked against the moved parts (linkage path not modelled): MEC-003-L, MEC-003-R, MEC-010-L, MEC-010-R.

No overlaps.

## Not checked

Not solids: HRN-001 (mass proxy), HRN-002-L (mass proxy), HRN-002-R (mass proxy). Wires (centre lines) are not solids. The pushrods and servo arms stay at neutral in the sweep (four-bar path not modelled here).
