davinciucberkeley-collab/DBF-Combined/redesign/team/A5/INTEGRATION.md

# Integration check (A5)

Generated by `python -I redesign/team/A5/integration_check.py` on 2026-11-11. Do not edit; re-run.

| Run | Result |
|---|---|
| `fusion/check.py` on `redesign/subsystems` | 10 modules built, **0 errors, 6 warnings** |
| Assembly (declared masses) | 2344.2 g, CG (0.0505, -0.0012, 0.0185) m |
| Allocation layout (R3 skeleton) | 2355.0 g, CG x 0.0466 m |

## Mass and CG by subsystem

| Subsystem | Owner | Allocation g | Declared g | parts.csv g | CG x m | Skeleton CG x m | Share of CG shift mm |
|---|---|---|---|---|---|---|---|
| `wing` | D1 | 405 | 391.7 | 391.7 | 0.1137 | 0.1156 | -0.71 |
| `fins` | D3 | 437 | 437.1 | 437.1 | 0.1005 | 0.1030 | -0.01 |
| `pod` | D2 | 146 | 146.0 | 146.0 | -0.0073 | -0.0175 | +0.23 |
| `landing` | D5 | 48 | 42.5 | 42.5 | 0.3203 | 0.3380 | -0.39 |
| `propulsion` | E1 | 462 | 462.0 | 462.0 | 0.0123 | 0.0125 | -0.05 |
| `mechanisms` | D6 | 72 | 71.4 | 71.4 | 0.2164 | 0.2261 | -0.95 |
| `power` | F1 | 648 | 639.8 | 639.8 | -0.0167 | -0.0361 | +5.57 |
| `avionics` | F3 | 45 | 36.5 | 36.5 | -0.0219 | -0.0350 | +0.50 |
| `harness` | F2 | 123 | 117.2 | 117.2 | 0.0665 | 0.0706 | -0.26 |
| `transport` | D7 | None | 0.0 | 0.0 | — | — | +0.00 |

Share of CG shift: this subsystem's x-moment change from the skeleton over the assembly mass, less the effect of its mass change on the skeleton CG; the column sums to the CG shift (+3.9 mm).

## Declared CG vs CAD centroid (> 10 mm)

| Part | Owner | Mass g | Declared CG m | CAD centroid m | Diff mm | Moment error g·m |
|---|---|---|---|---|---|---|
| `FIN-001-UL` | D3 | 25.5 | 0.2074, -0.3200, 0.0785 | 0.2001, -0.3200, 0.0975 | 20.3 | 517.5 |
| `FIN-001-UR` | D3 | 25.5 | 0.2074, 0.3200, 0.0785 | 0.2001, 0.3200, 0.0975 | 20.3 | 517.5 |
| `FIN-001-LL` | D3 | 26.23 | 0.2014, -0.3200, -0.0759 | 0.1967, -0.3200, -0.0946 | 19.2 | 504.8 |
| `FIN-001-LR` | D3 | 26.23 | 0.2014, 0.3200, -0.0759 | 0.1967, 0.3200, -0.0946 | 19.2 | 504.8 |
| `POD-001` | D2 | 24.7 | -0.0391, -0.0010, 0.0432 | -0.0249, 0.0001, 0.0385 | 15.0 | 371.2 |
| `AVN-005` | F3 | 4.84 | -0.1433, -0.0460, 0.0450 | -0.1545, -0.0460, 0.0450 | 11.2 | 54.1 |

## parts.csv vs interfaces.json

| Owner | Item | Problem |
|---|---|---|
| — | — | none |

## check.py issues by role

| Role | Severity | Check | Item | Detail |
|---|---|---|---|---|
| ? | WARN | missing | `GND-001` | PROPOSED part has no component (ground) |
| ? | WARN | datums | `DATUMS.md` | stale against params.json: python -I redesign/fusion/k09kit.py --datums-md |
| D3 | WARN | graph:one-sided | `E-WNG-14` | declared by wing; fins has not acknowledged it |
| D3 | WARN | graph:one-sided | `E-WNG-15` | declared by wing; fins has not acknowledged it |
| D3 | WARN | graph:mass | `fins` | subsystem 437 g > allocation 437 g |
| D7 | WARN | transport | `POD-006` | overlaps TRN-001 (nose pad) by 5 mm: pressed, or does not fit the box |
