davinciucberkeley-collab/DBF-Combined/redesign/team/C6/JOINTS.md

# Joints and fasteners — K09-L

Owner C6. Revision **C6-R5b**, 2026-11-10, at params A1-R5 (D-63 … D-72). Inputs read live: C1 claims and
`team/C1/data/envelope.json` (D-65 re-run of 14:29: half-fin section torsion **12.67 N·m** limit, J-FIN Mz 17.18 N·m
ult); C4's frozen R4 fin set `team/C4/claims.d3.json` (11:51: strip 1 243 N, pin 72.4 N, collar 6.24 N·m, solved at
C1's earlier 7.37 N·m); fins D3-R5b (`subsystems/fins/params.json`: pins Ø 2.5 at 15 mm, collar 15 mm, block edges
R 3 mm, root fillet fail-safe only); D5 R5 shoe bond (1 350 mm², 85.7 N, RF 1.57); F1 power frame. Re-run in a few
seconds: `python -I redesign/team/C6/joints.py`, `python -I redesign/team/C6/make_stacks.py`, then
`python -I redesign/proofs/build_graph.py`. Joint stacks `PROPOSED`; claims `UNVERIFIED` until the C6 coupons run.
Blocks for the edge owners: [`joint_stacks.json`](joint_stacks.json) (84 edges + 1 withdrawn). Every fastener of
every stack is a modelled part since R5c: [`FASTENERS-CAD.md`](FASTENERS-CAD.md) (`fastener_parts.py`).

Check method: reserve factor RF = allowable / applied at the **design load** = C1 ultimate (1.5 × limit) × fitting
factor 1.15, × 1.25 more for anything printed or bonded (`ASM-C1-FITTING-FACTOR`, `ASM-C1-PRINTED-FACTOR`).
RF ≥ 1.0 passes; the proof chain shows the margin RF − 1.

## What changed since C6-R4

The R5 action items were run as asked (C4's frozen set, 13 mm collar, 2.5 mm pins, D5's bond, the R 3 mm pocket,
fillet RF kept on the joint side). Two things moved underneath them. First, the four C1 envelope values `joints.py`
held as hand copies had drifted (J-FIN Mz 9.04 → 17.18 N·m ult), so they are now read live from `envelope.json`.
Second, C1 re-ran for D-65 (n 6.6, 39.3 / 59.0 N foot side load) twice during this session, and the half-fin torsion
went 7.39 → 8.13 → **12.67 N·m** limit. At 8.13 N·m the 13 mm collar read RF 0.9995, so C6 asked for 15 mm (CR-C6-36)
and D3 drew it within the hour. At 12.67 N·m, 15 mm is not enough either.

| Item | C6-R4 | C6-R5b (now) | Consequence |
|---|---|---|---|
| Collar torsion, max(C1, C4) | max(7.39, 6.26) N·m + 163 N brace | **max(12.67, 6.24) N·m** + 163 N brace (C1 governs) | needs **19.45 mm**; drawn 15 mm RF **0.77**; 16 mm 0.82 → **22 mm, RF 1.13** (CR-C6-37). The D-70 12 mm option is void (0.63 even at 4.1 MPa) |
| Pins | Ø 2 drawn 0.82; Ø 2.5 proposed 1.59 | **Ø 2.5 at 15 mm drawn: 1.60** on C4's 72.4 N | D-70 closed for C4's R4 load; on D-65 loads, estimate **0.93** (CR-C6-38) |
| Strip tail anchor / net section | 1.27 / 1.14 at 1 248 N | 1.27 / 1.15 at 1 243 N (C4 frozen) | estimate on D-65 loads **0.74 / 0.67** at ≈ 2 130 N: hold collar and tail prints for C4 (CR-C6-38) |
| Tube in block / block on spar | 5.03 / 5.66 | **2.65 / 4.64** (envelope read live) | still pass |
| Root fillet | 1.14 (15 mm, zoned) | **0.81** on D-65's 59 N side load; fail-safe only (D-68) | kept as a C6 claim; D3's CR-D3-35 (zone to 0.185 m) supported |
| Block pocket (D-68) | — | new `CALC-C6-BLOCK-POCKET`: wall area × 0.976; square-corner void 1.24 mm; pocket corner R 3.0–4.2 mm; beads 1.1 g | `E-FIN-51/52` rewritten; CR-C6-40 to D1 |
| Foot shoe `E-GER-01…04` | 1.57 | **1.57**, 85.7 N on 1 350 mm² (D5 R5) | — |
| Power frame `E-PWR-03` | 0.08 N·m | unchanged, **open with F1** (CR-C6-26) | — |
| Avionics crash load | 10.0 N (hand copy) | 5.62 N (envelope) | insert RF set by the unplug case; still 1.74 |

The `-EST` claims (`CALC-C6-FIN-SCALE`) scale C4's frozen strip and pin forces by k = C1 torsion now / the torsion C4
solved at (12.62 / 7.37 = **1.71**). The D-65 side load drives both the torsion and the strip couple, so linear scaling
is the right first estimate. They are bounding estimates for planning and retire when C4 re-runs.

## Verdict

| Question | Answer | Claim | Status |
|---|---|---|---|
| How many fastener sizes? | **One bought thread, M3**: steel 8 and 16 mm, PA66 16 and 18 mm, one nyloc, one washer, one heat-set insert, plus Ø 2.5 CF rod for pins. M2 and 2-56 only as supplied mechanism hardware; M3x4 + M6 nut with the prop adapter (D-58) | kit table | `PROPOSED` |
| Fastened joints pass? | Yes. Motor screws 0.20 N·m: head 1.32, separation 3.69, 3.5 mm engagement. Power frame at 0.08 N·m: engagement 1.22, install 1.35, tension 1.46, friction 1.24, insert 1.74 | `CL-C6-MOTOR-*`, `-CANT-ENGAGE`, `-PWR-*` | `UNVERIFIED` |
| Station collar? | **Fails as drawn.** 15 mm RF 0.77 on C1's 12.67 N·m; needs 19.45 mm; **22 mm gives 1.13** for ≈ +4.4 g `EST` (four) | `CL-C6-COLLAR-RF`, `-L-REQ`, `-RF-PROP` | `FAIL` → CR-C6-37 |
| Fin strips and pins? | On C4's frozen R4 loads: tail 1.27, net section 1.15, pins 1.60, bearing 3.45, strip net 2.41. **On C1's D-65 loads (estimate ×1.71): tail 0.74, net 0.67, pins 0.93** | `CL-C6-STRIP-*`, `-*-EST` | `FAIL` (estimate) → CR-C6-38 |
| Block bonds and pocket? | Tube in block 2.65, block on spar 4.64; pocket corners R 3.0–4.2 mm, no square corners | `CL-C6-TUBE-BLOCK-RF`, `-BLOCK-SPAR-RF`, `-POCKET-*` | `UNVERIFIED` |
| Foam bonds? | Foot shoe 1.57. Root fillet 0.81 (fail-safe path, D-68). Servo frame and horn ≥ 719 mm² | `CL-C6-FOOT-SHOE-RF`, `-FIN-ROOT-RF`, `-LINK-BOND-AREA-MIN` | root `FAIL` → D3 CR-D3-35 |
| Pod joints? | Pod bond 1.15 / 1.33 crash, tray 2.59, hatch 1.18, floor glue line 2.03 with the fillet C3 flies | `CL-C6-POD-*` | `UNVERIFIED` |

## Rules: which fastening goes where

| Situation | Use | Engagement minimum (D-41) | Torque / locking | Never |
|---|---|---|---|---|
| Steel screw into metal (motor base, prop adapter into the bell) | SHCS A2-70, tapped hole | ≥ 1.0 d (3.0 mm), except `E-PRP-01…04` (D-58: 2.0 mm); ≤ hole depth − 0.5 mm | per table; Loctite 243 on the **tip threads only** | threadlocker on or under a printed or nylon part |
| Through a printed part, both sides reachable | SHCS + ISO 7089 washer + ISO 10511 nyloc | nut fully on + 2 pitches (5.0 mm past the grip for M3) | ≤ 0.4 N·m; nyloc reused ≤ 3 times | split washers; plain nuts |
| Into a printed part, one side or repeated service | M3 × 5.7 brass heat-set insert, bore Ø 4.0 × ≥ engagement + 0.5 mm, boss wall ≥ 1.6 mm (boss Ø ≥ 7.2 mm), 230–245 °C | ≥ 1.5 d (4.5 mm), ≤ 5.7 mm (insert length) | steel ≤ 0.4 N·m; **PA66 ≤ 0.08 N·m**; no threadlocker; paint-pen witness | screws straight into printed plastic |
| Screw on a canted face | holes drilled square to the face, head seat parallel to it | as above | as above | holes normal to one face with the motor canted on pads |
| Within 50 mm of the compass, or beside bare bus bars | PA66 screw (+ PA66 nut) | nut fully on + 2 pitches; insert 1.5 d | ≤ 0.08 N·m (1.6 N on the luggage scale) | steel |
| Self-tapping into plastic | only the supplied M2 (servo cover, D-58); 1.6 mm pilot in a printed boss | ≥ 2.0 d (4.0 mm) | snug, head seated | |
| Anything into XPS or foam board | **no screw**: bond a printed hardpoint ≥ 719 mm² (`CL-C6-LINK-BOND-AREA-MIN`) and fasten into it | — | — | screws, pins or inserts in foam |
| Field joints | tool-free (straps, plug-ins, snap hooks), except the prop nut | — | — | any tool other than the one 10 mm spanner (D-40) |

Torque without a torque screwdriver: hook a luggage scale on the long arm of the hex key 50 mm from the screw axis;
0.08 N·m = 1.6 N, 0.20 N·m = 4.0 N (0.41 kg), 0.4 N·m = 8.0 N.

## Deviations from the thread rules (D-58, granted by A1)

| # | Interface | Deviation | Rule it breaks | Justification | Condition |
|---|---|---|---|---|---|
| a | `E-PRP-01…04` prop adapter → bell | vendor M3x4, **2.0 mm** minimum engagement (2.5 mm nominal) | 1.0 d into metal (3.0 mm) | strip RF 1.70 at 2.0 mm against the 0.83 kN tightening preload; service 14 N shear, 4 N axial per screw (`CL-E1-ADAPTER-STRIP`) | `T-E1-MOTOR-RM` measures ≥ 2.5 mm of bell thread; 0.5 N·m + 243 on the tips |
| b | `E-MEC-07…10`, `E-MEC-35/36` mechanisms | supplied **2-56** clevis thread; **M2 × 6** self-tapping cover screws (5.2 mm engaged in a 1.6 mm pilot, 6 mm deep) | M3 only | bought servo and clevis hardware; no M3 part at this size | silicone keeper on every clevis; covers snug only |

## Fastener kit (bought; I1)

| Item | Standard | Qty (incl. spares) | Used at | Tool |
|---|---|---|---|---|
| M3x8 SHCS A2-70 | ISO 4762 | 20 | motor to mount (`PRP-005`, 16) | 2.5 mm hex |
| M3x16 SHCS A2-70 | ISO 4762 | 6 | mount pinch bolts (4, `FIN-101`) | 2.5 mm hex |
| M3x16 PA66 screw + PA66 hex nut | — | 3 + 3 | GPS mast cross-bolt (1) | 2.5 mm hex / fingers |
| M3x18 PA66 screw, socket head preferred | — | 11 | power frame (4), `T-C6-NYLON-TORQUE` (5), spares | 2.5 mm hex (PH1 if pan head) |
| M3 nyloc A2 | ISO 10511 | 8 | pinch bolts | 5.5 mm spanner |
| M3 washer A2 | ISO 7089 | 12 | pinch bolts (8) | — |
| M3 × 5.7 brass heat-set insert | Ruthex RX-M3x5.7 class | 12 | power frame (4), `T-C6-INSERT` (3), spares | iron + insert tip |
| M3 nylon washer 0.5 mm + 10 mm nylon spacer (OD 6 / ID 3.2) | — | 6 + 6 | power frame | — |
| Pultruded CF rod **Ø 2.5 mm** × 1 m | — | 1 + 1 spare | strip through-pins at 15 mm (D-70): 15 per half-fin × 4 = 60 × 11.6 mm ≈ 0.70 m (76 pins ≈ 0.88 m at 12 mm, if CR-C6-38 needs it: still one rod) | 2.5 mm drill |
| Supplied, not bought | M3x4 × 4 + M6 nut + washer per adapter (`PRP-004`); servo cover M2 × 6 and 2-56 clevises (D6); gel cubes (F3) | — | prop adapter, mechanisms, FC | 2.5 mm hex, 10 mm spanner, Phillips #1 |
| Ground (D7 buys) | handle stacks `E-TRN-13…15`: M3x16 + fender washer + nyloc on a ply strip | — | transport box | 2.5 mm hex, 5.5 mm spanner |

Tool set for the whole aircraft: 2.5 mm hex key, 5.5 and 10 mm spanners, Phillips #1, luggage scale.

## Fastened and retained joint stacks

Ids are the declared edges in `subsystems/*/interfaces.json`. Order = install / removal within the owner's build.

| Interface | Parts | Fastener × n | Hole / insert | Engagement (min), mm | Washer / nut | Torque · locking | Design load · check | Status |
|---|---|---|---|---|---|---|---|---|
| `E-FIN-61…64` | `PRP-001-<st>` → `FIN-003-<st>` | M3x8 SHCS × 4 | Ø 3.4 drilled square to the canted 4.5 mm plate on the measured pattern | 3.5 (3.0); ≤ probed depth − 0.5 | none, head flat | **0.20 N·m** + 243 on tip | 90 N per screw incl. 7° side moment 0.14 N·m ult; head RF 1.32, no-gap RF 3.69, strip RF 29 | `PROPOSED` |
| `E-FIN-05…08` | `FIN-003-<st>` → `FIN-002-<R/L>` | M3x16 SHCS × 1 | Ø 3.4 through both ears (grip 10.5) | 5.5 past grip (5.0) | 2 washers + nyloc | set by `T-D3-SLIP` (85–100 N at the can), ≈ 0.14 N·m, ≤ 0.4 | prop nut 3.23 N·m: bearing RF 3.26, hoop 5.94; 7° side: slip RF 16.8 / 48 | `PROPOSED` |
| `E-PWR-03` | `PWR-006` frame → `POD-002` | **M3x18 PA66 × 4** | deck and spacer Ø 3.4; brass insert, bore 4.0 × 6.5 | **5.5 (4.5)**, ≤ 5.7; tip 1.0 clear | 0.5 nylon washer + 2.0 deck + 10 nylon spacer | **0.08 N·m** (1.6 N at 50 mm), no 243, witness | 50 N unplug at 18 mm: 39 N tension per screw, RF 1.46; shear 108 N, friction RF 1.24 (0.62 after creep, then spacer bending RF 7.2); insert RF 1.74; install RF 1.35 | `PROPOSED` (CR-C6-26) |
| `E-POD-06` | `POD-005` → `POD-007` | M3x16 PA66 × 1 | Ø 3.4 across the boss | 6.0 past grip (4.0); grip 10.0 (≤ 11.0) | PA66 nut | finger + ¼ turn (≤ 0.08 N·m) | mast is the fuse; non-magnetic | `PROPOSED` (D2 adopted CR-C6-18) |
| `E-AVN-01` | `AVN-001` → `POD-002` | 4 gel cubes 5 mm, no screws (F3) | — | — | + 10 mm strap over the board, 1–2 mm slack | — | 10 N crash on the strap if the cubes let go | `PROPOSED` |
| `E-AVN-04` | airspeed board → `POD-002` | foam tape + 1 tie (D-33) | — | — | — | — | 6 g part | `PROPOSED` |
| `E-MEC-35/36`, `E-MEC-03/04` | `MEC-007-<L/R>` → `MEC-008-<L/R>`; servo `MEC-001-<L/R>` held in the frame ear slots by the cover | M2 × 6 self-tapping pan head × 2 (`MEC-011-<L/R>`, the same two screws on both edges; D-58 b) | 1.6 pilot, 6 deep in the 4 × 5 × 6 mm end-wall bosses | 5.2 (4.0) | — | snug, from below (−z) | 2.0 N crash on 2 screws; thread shear 245 N each | `PROPOSED` (D6; 03/04 reinstated, FASTENERS-CAD) |
| `E-PRP-01…04` | `PRP-004-<st>` → `PRP-001-<st>` | M3x4 × 4 (supplied) | bell tapped | 2.5 (**2.0, D-58 a**) | — | 0.5 N·m + 243 | RF 1.70 (`CL-E1-ADAPTER-STRIP`) | `PROPOSED` |
| `E-PRP-05…08` field | `PRP-003-<st>` → `PRP-004-<st>` | M6 nut ISO 4032 (LH on CW motors) | prop on LPAR06E ring | nut fully on (5.2) | 1.0 mm washer | 1.5 N·m, bell held | `CL-E1-NUT-ENGAGE` | `UNVERIFIED` |
| `E-TRN-13…15` ground | handle → box | M3x16 × 2 + 12 mm fender washer + nyloc on a 3 mm ply strip | Ø 3.4 | grip ≤ 11.0 → ≥ 5.0 (nyloc + 2 pitches) | — | snug, wall not crushed | 57–59 N per bolt, 27 kPa on Coroplast | **confirmed** (CR-D7-10) |
| withdrawn | `E-PWR-05` (bus board taped, F1) | — | — | — | — | — | no C6 stack | — |
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
