davinciucberkeley-collab/DBF-Combined/redesign/subsystems/flight-software/SITL-PLAN.md

# flight-software — SITL plan

Revision F4-R5, 2026-11-10. Status `UNVERIFIED`: ArduPilot SITL is not installed on the design machine; nothing below has run. Owner F4; the
pilot's ≥ 10 h (`R-PILOT`, `P:requirements.sitl_hours_min`) run on the same set-up after S1–S13 pass.

## Set-up

| Item | Value | Status |
|---|---|---|
| Build | ArduPlane 4.7.x stable, the tag flashed on the CoreWing F405 Wing V2 (D-33) | — |
| Stage A model | `sim_vehicle.py -v ArduPlane -f quadplane-copter_tailsitter --add-param-file=K09L.param` | frame name `UNVERIFIED` (check `Tools/autotest/pysim/vehicleinfo.py`) |
| Stage A use | logic only: modes, failsafes, output map, transition sequence. Not for gains or margins | — |
| Stage B model | JSON SITL backend (`-f JSON`) driven by a Python model from B3's aero table (`team/B3/results/sc_results.json`, CR-B3-04e), E1 thrust/torque per output, 7° cant in the sense of SPEC.md, 2.6 kg, inertia from A3, one torsion mode 11.7–14.9 Hz (C2) | to write after install |
| Wind | `SIM_WIND_SPD` 0 / 5 / 8 m/s, `SIM_WIND_TURB` 1 | — |
| Sagged pack | battery model loaded to thrust factor 0.76 (D-35) | parameter names to confirm |
| Logs kept | `.bin` + one line per case in `team/F4/sitl/RESULTS.md` (case, build, pass/fail, numbers) | — |
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
