davinciucberkeley-collab/DBF-Combined/redesign/subsystems/flight-software/SPEC.md

# flight-software (FSW)

ArduPilot Plane tailsitter set-up for K09-L: parameter file, output map, transition logic, elevon schedule,
failsafes, tuning and SITL plans. Owner F4. No parts. Status `PROPOSED`, revision F4-R5, 2026-11-10 (D-65, D-66, D-71, D-62 CG). Firmware
ArduPlane 4.7.x stable on the CoreWing F405 Wing V2 (D-33, no Lua). Not loaded on any board and not run in SITL
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
