davinciucberkeley-collab/DBF-Combined/redesign/blender/out/examples/figures/aileron_closeup.annotated.png

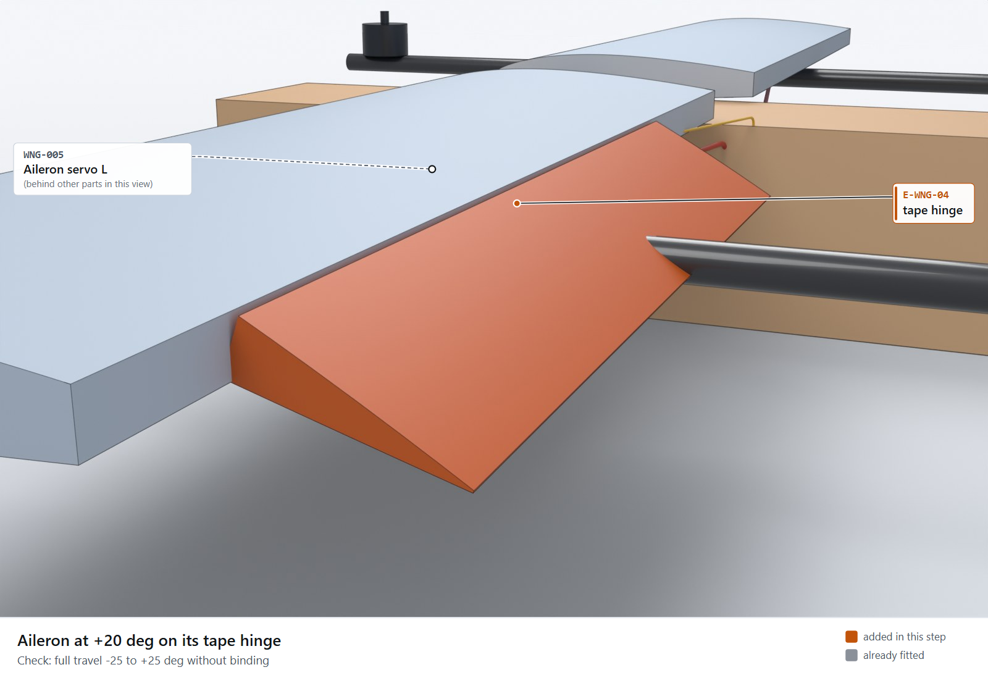
redesign/blender/out/examples/figures/aileron_closeup.annotated.png
