davinciucberkeley-collab/DBF-Combined/redesign/blender/out/examples/figures/aileron_closeup.jpg

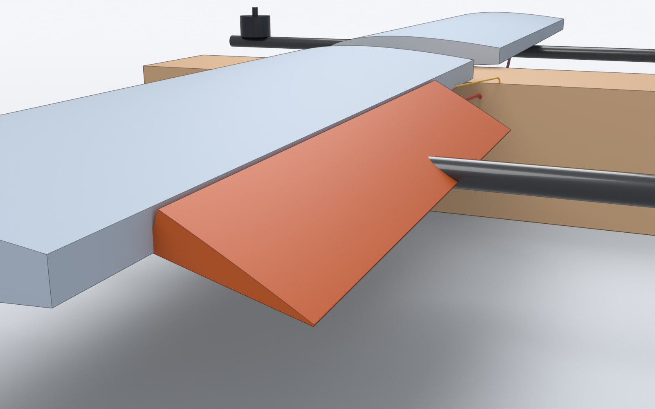
redesign/blender/out/examples/figures/aileron_closeup.jpg
