davinciucberkeley-collab/DBF-Combined/redesign/blender/out/examples/figures/exploded.annotated.png

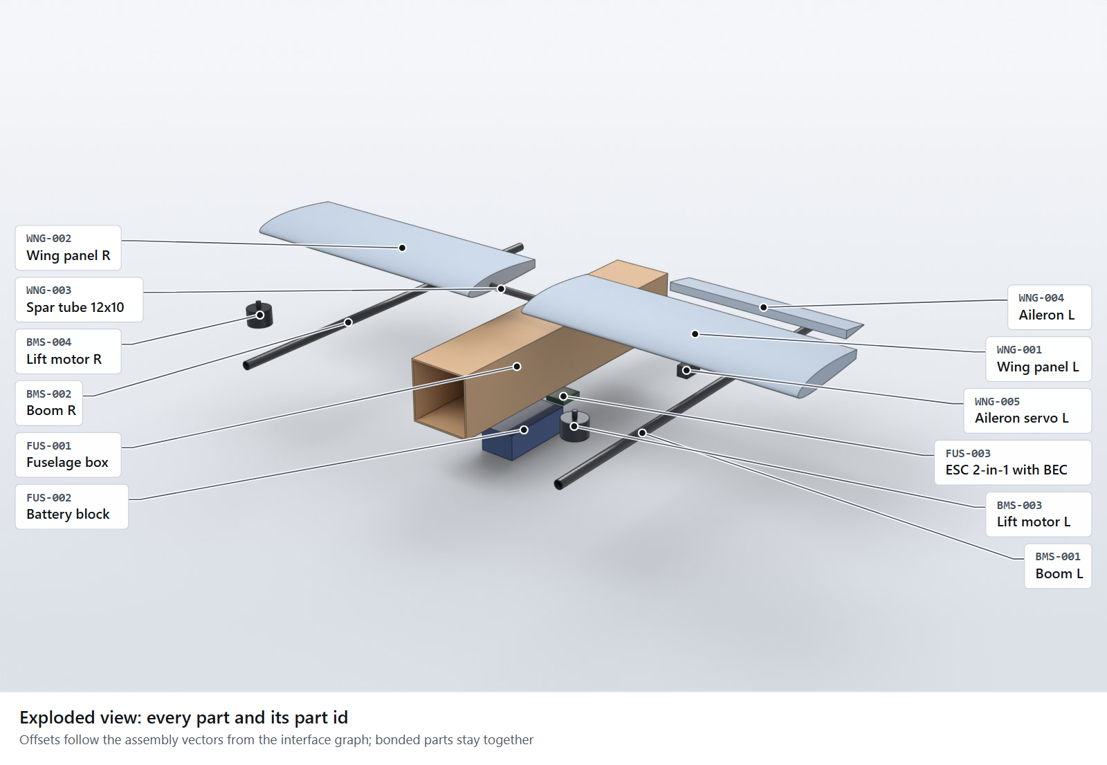
redesign/blender/out/examples/figures/exploded.annotated.png
