davinciucberkeley-collab/DBF-Combined/redesign/blender/out/examples/figures/exploded.jpg

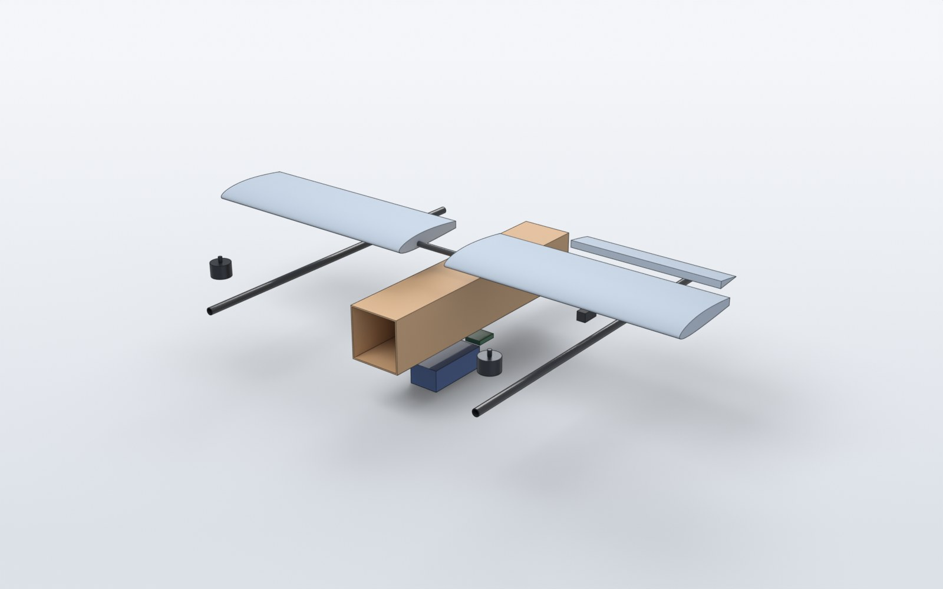
redesign/blender/out/examples/figures/exploded.jpg
