davinciucberkeley-collab/DBF-Combined/redesign/blender/out/examples/figures/iso.annotated.png

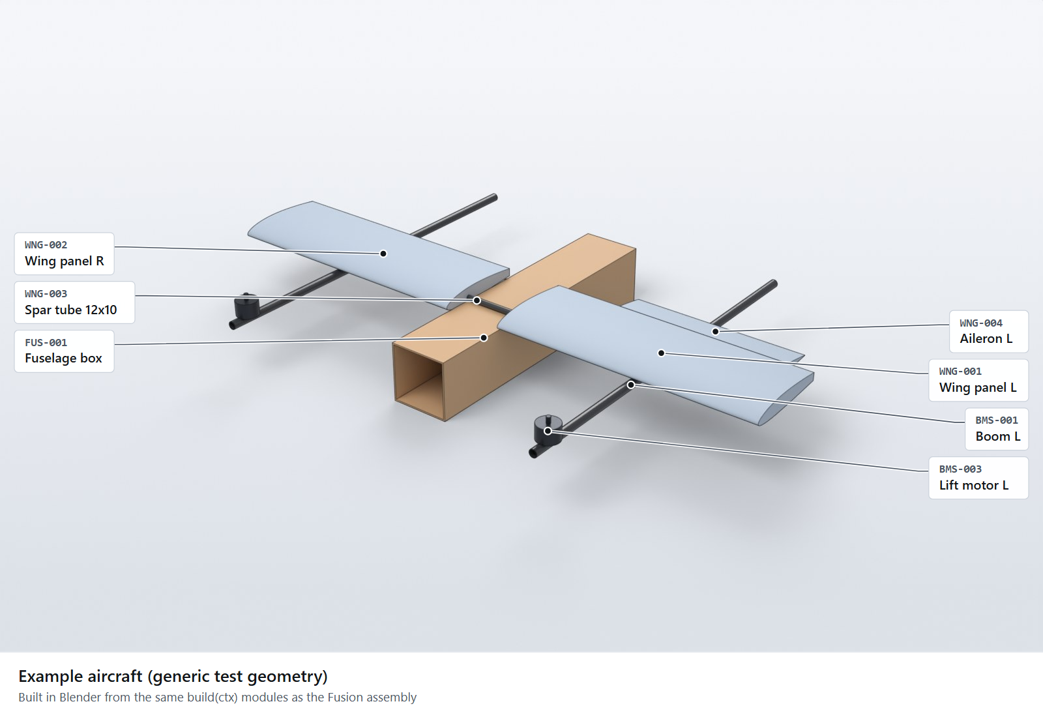
redesign/blender/out/examples/figures/iso.annotated.png
