davinciucberkeley-collab/DBF-Combined/redesign/blender/out/examples/figures/iso.jpg

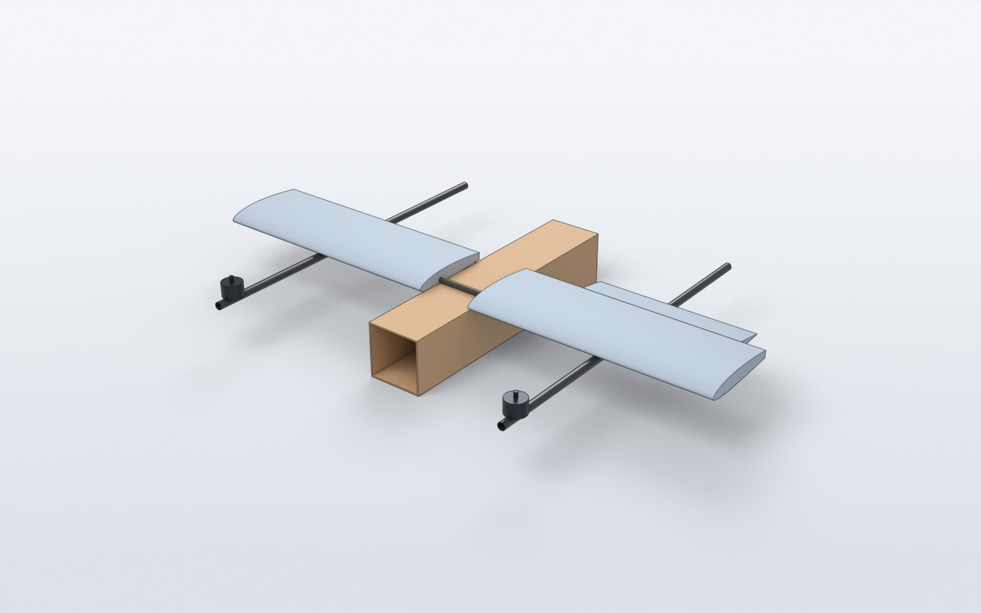
redesign/blender/out/examples/figures/iso.jpg
