davinciucberkeley-collab/DBF-Combined/redesign/blender/out/examples/figures/side.annotated.png

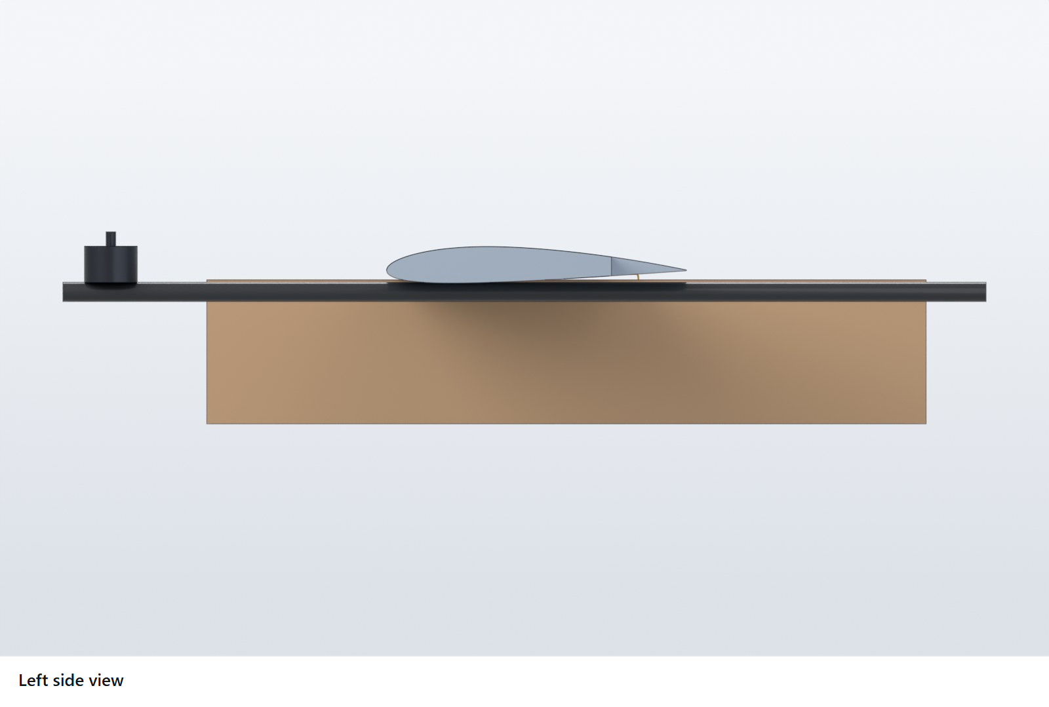
redesign/blender/out/examples/figures/side.annotated.png
