davinciucberkeley-collab/DBF-Combined/redesign/blender/out/examples/figures/side.jpg

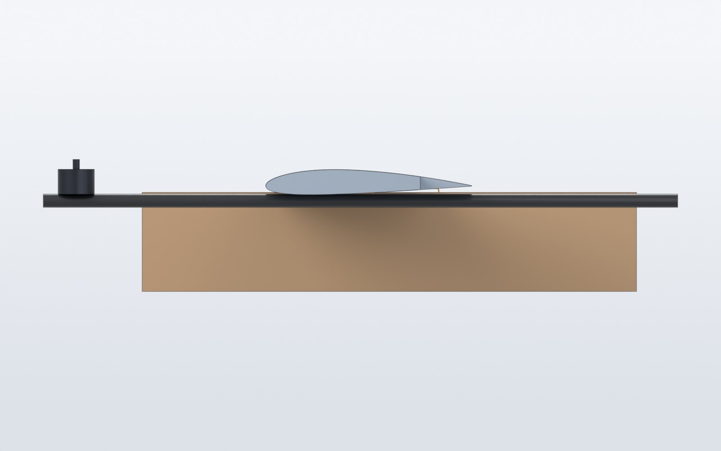
redesign/blender/out/examples/figures/side.jpg
