davinciucberkeley-collab/DBF-Combined/redesign/blender/out/examples/figures/top.annotated.png

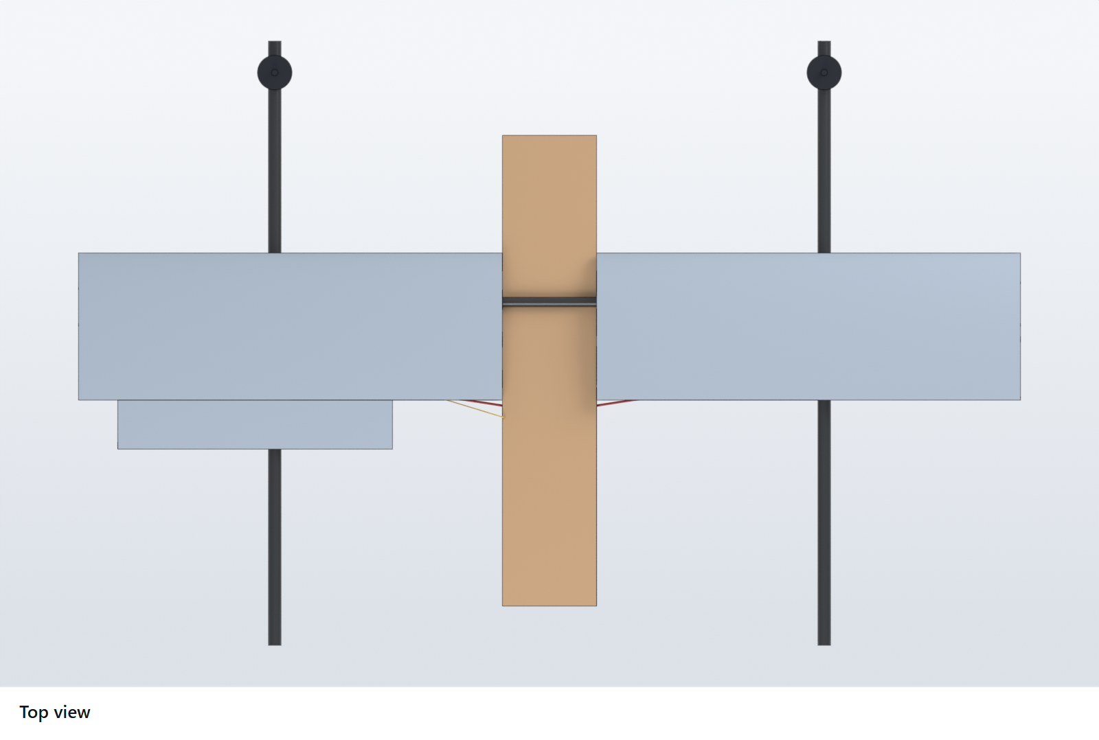
redesign/blender/out/examples/figures/top.annotated.png
