davinciucberkeley-collab/DBF-Combined/redesign/blender/out/examples/figures/top.jpg

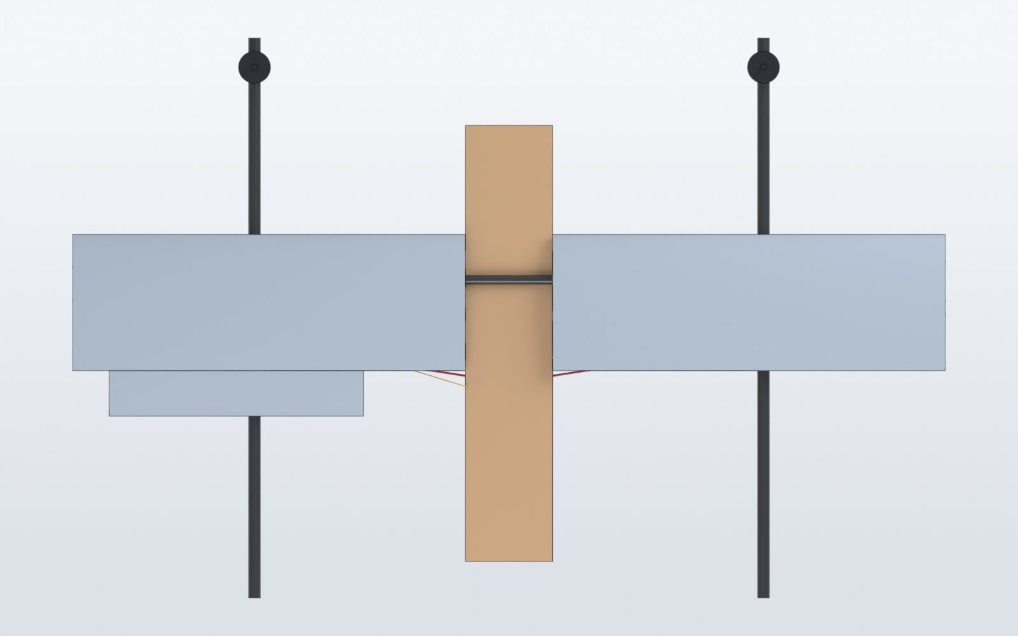
redesign/blender/out/examples/figures/top.jpg
