davinciucberkeley-collab/DBF-Combined/redesign/review/inspection-2026-11-11/fixed/00-overview.png

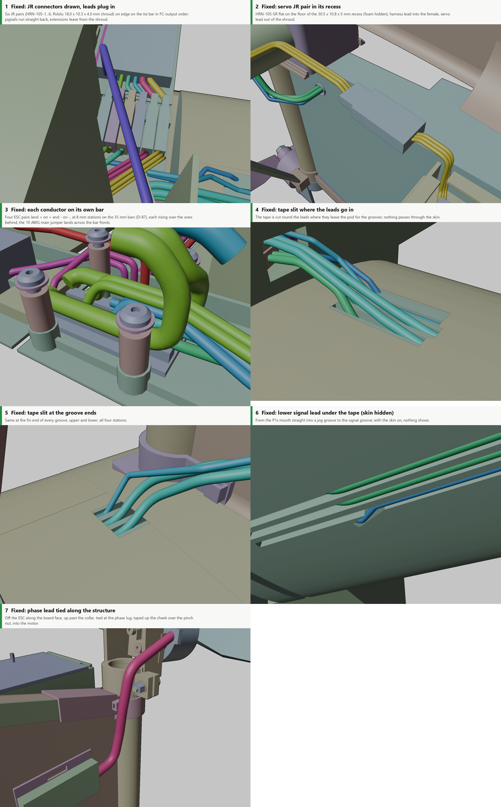
redesign/review/inspection-2026-11-11/fixed/00-overview.png
