davinciucberkeley-collab/DBF-Combined/redesign/review/inspection-2026-11-11/fixed/07.png

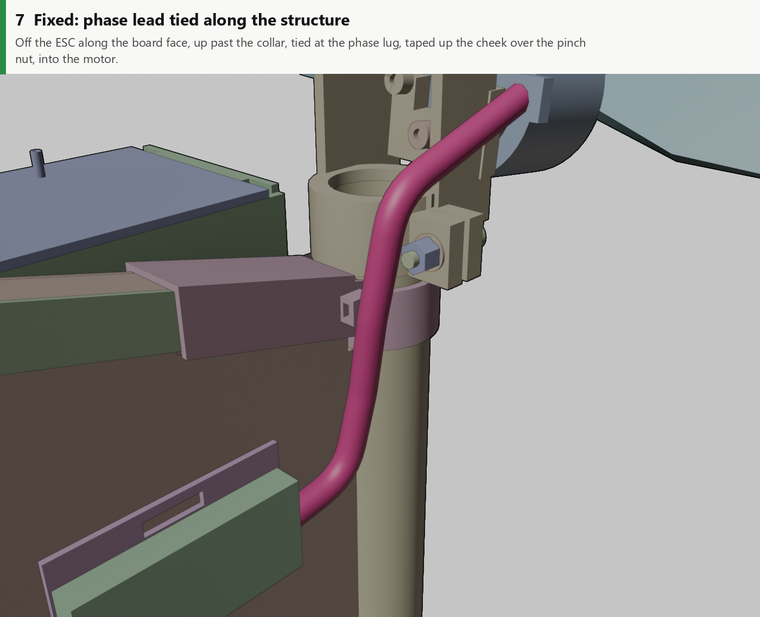
redesign/review/inspection-2026-11-11/fixed/07.png
