davinciucberkeley-collab/DBF-Combined/redesign/review/inspection-2026-11-11/round2/00-overview.png

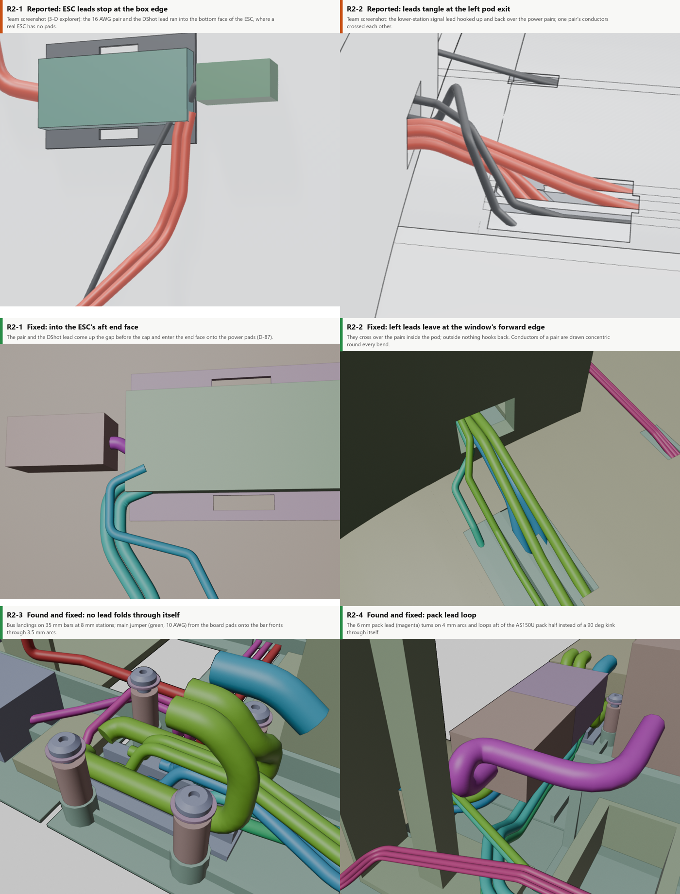
redesign/review/inspection-2026-11-11/round2/00-overview.png
