davinciucberkeley-collab/DBF-Combined/redesign/review/inspection-2026-11-11/round2/01.png

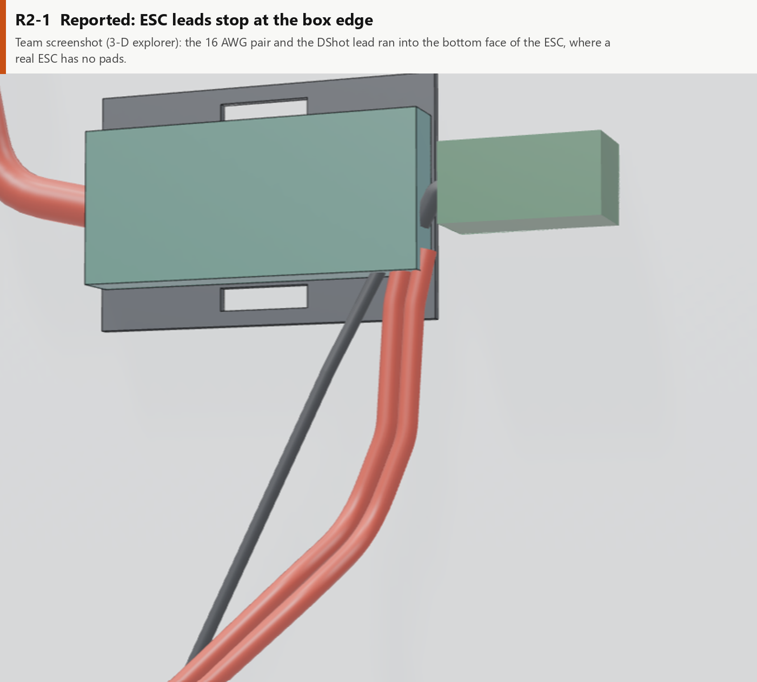
redesign/review/inspection-2026-11-11/round2/01.png
