davinciucberkeley-collab/DBF-Combined/redesign/review/inspection-2026-11-11/round2/04.png

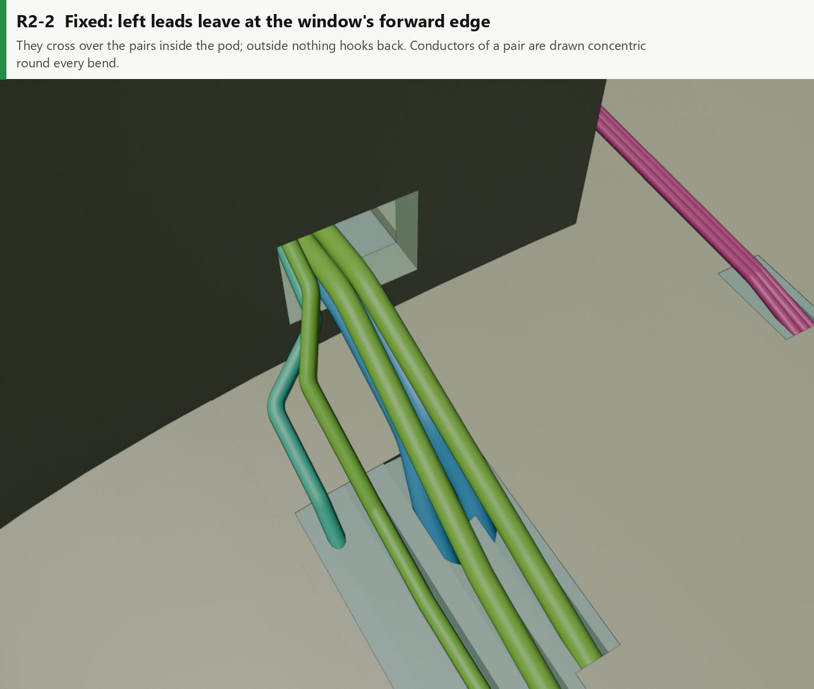
redesign/review/inspection-2026-11-11/round2/04.png
