davinciucberkeley-collab/DBF-Combined/redesign/review/inspection-2026-11-11/round2/05.png

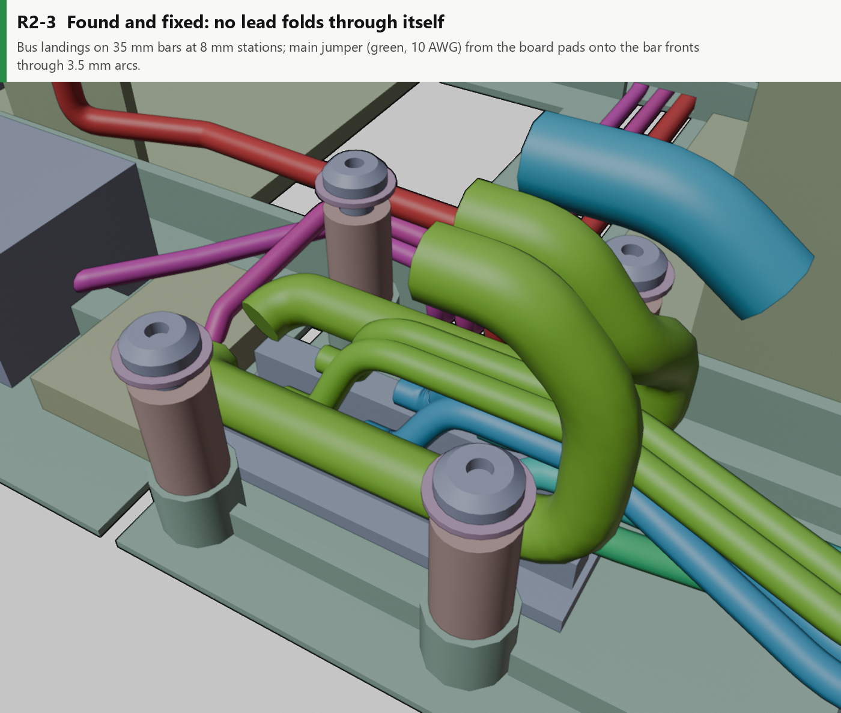
redesign/review/inspection-2026-11-11/round2/05.png
