davinciucberkeley-collab/DBF-Combined/redesign/review/inspection-2026-11-12/V1_esc_UR.png

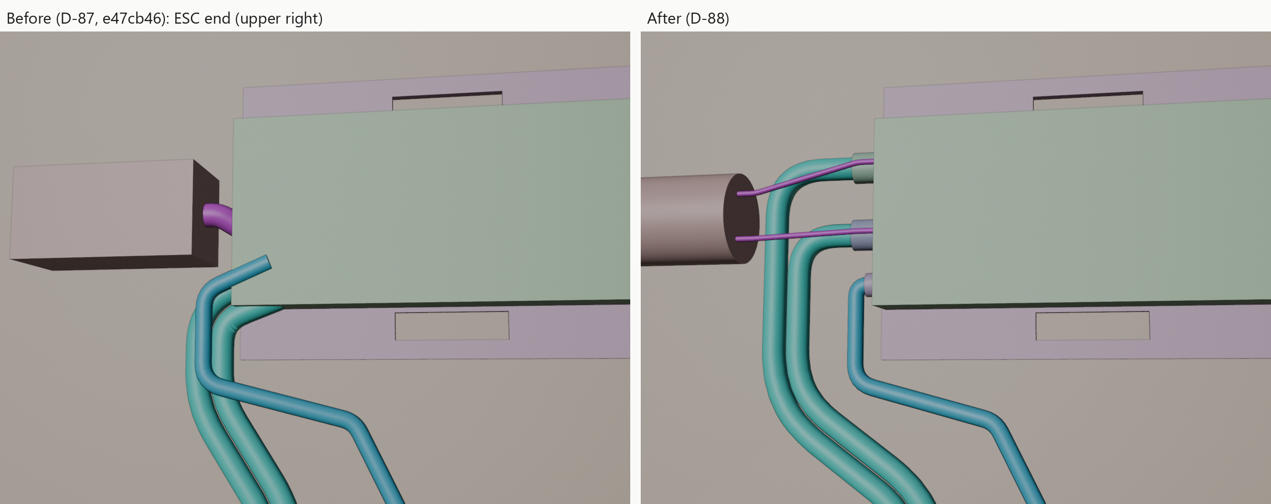
redesign/review/inspection-2026-11-12/V1_esc_UR.png
