davinciucberkeley-collab/DBF-Combined/redesign/review/inspection-2026-11-12/V2_pod_exit_L.png

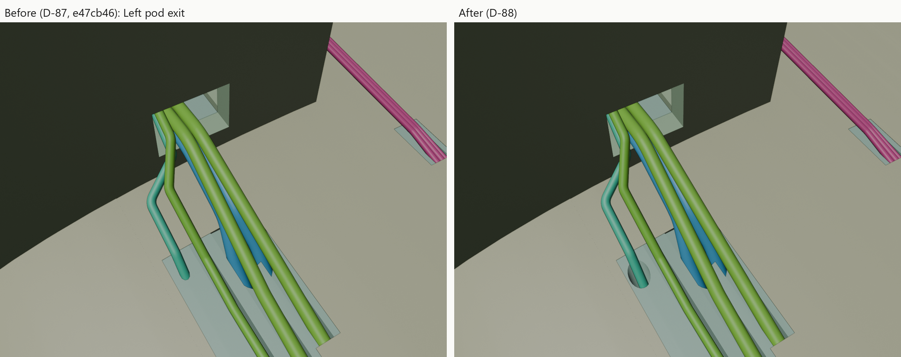
redesign/review/inspection-2026-11-12/V2_pod_exit_L.png
