davinciucberkeley-collab/DBF-Combined/redesign/review/inspection-2026-11-12/V3_bus.png

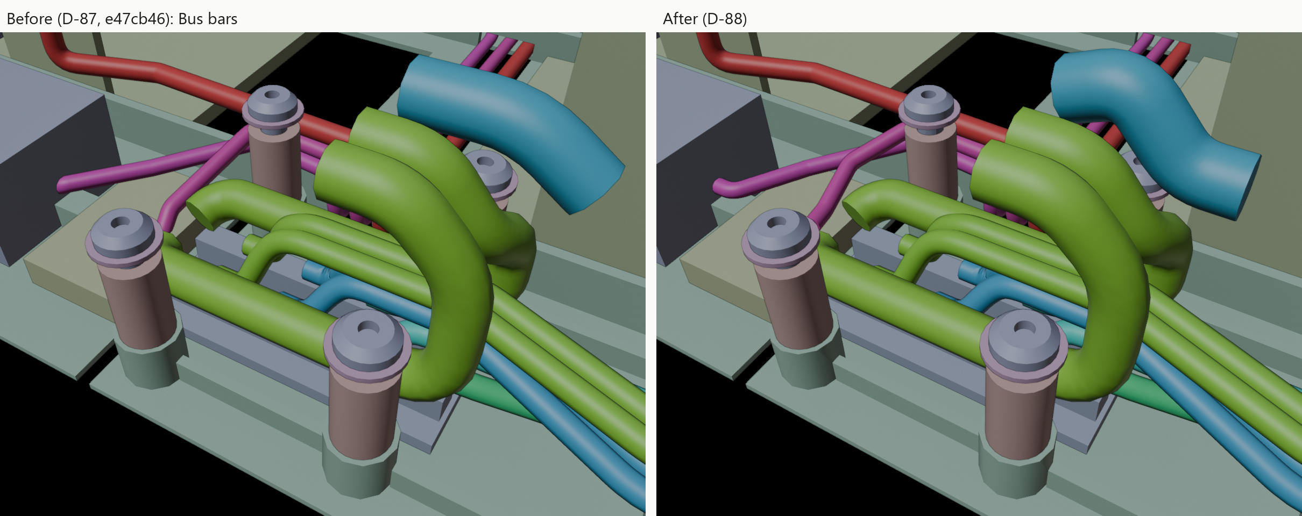
redesign/review/inspection-2026-11-12/V3_bus.png
