davinciucberkeley-collab/DBF-Combined/redesign/review/inspection-2026-11-12/V4_pack_lead.png

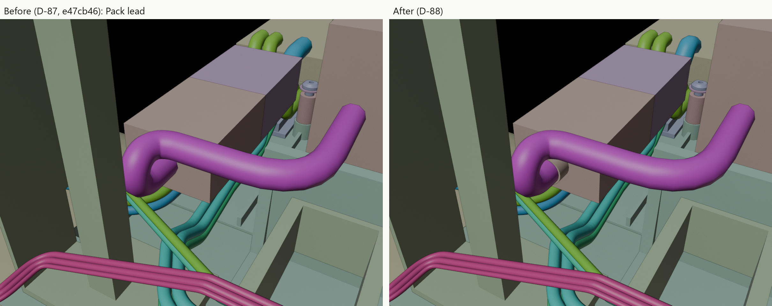
redesign/review/inspection-2026-11-12/V4_pack_lead.png
