davinciucberkeley-collab/DBF-Combined/redesign/review/inspection-2026-11-13/T1_fc_aft.png

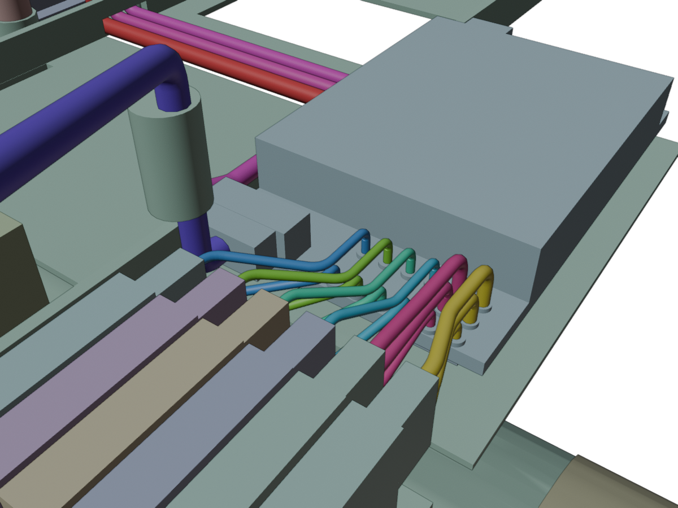
redesign/review/inspection-2026-11-13/T1_fc_aft.png
