davinciucberkeley-collab/DBF-Combined/redesign/review/inspection-2026-11-13/T2_fc_fore_rx_plug.png

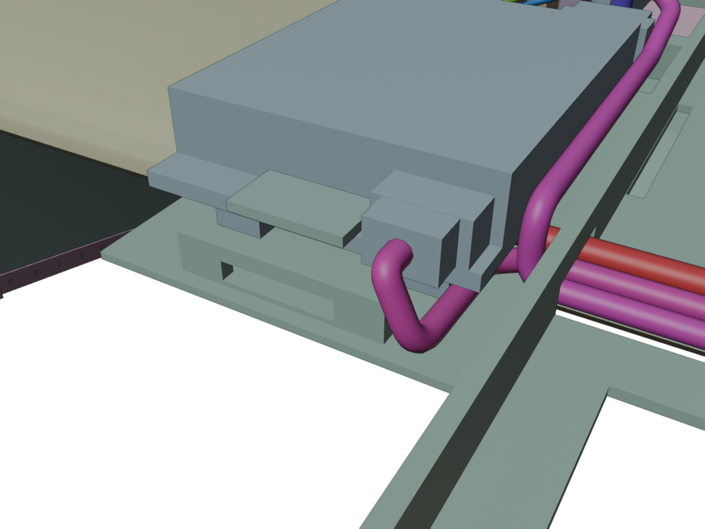
redesign/review/inspection-2026-11-13/T2_fc_fore_rx_plug.png
