davinciucberkeley-collab/DBF-Combined/redesign/review/inspection-2026-11-13/T3_rx_pads.png

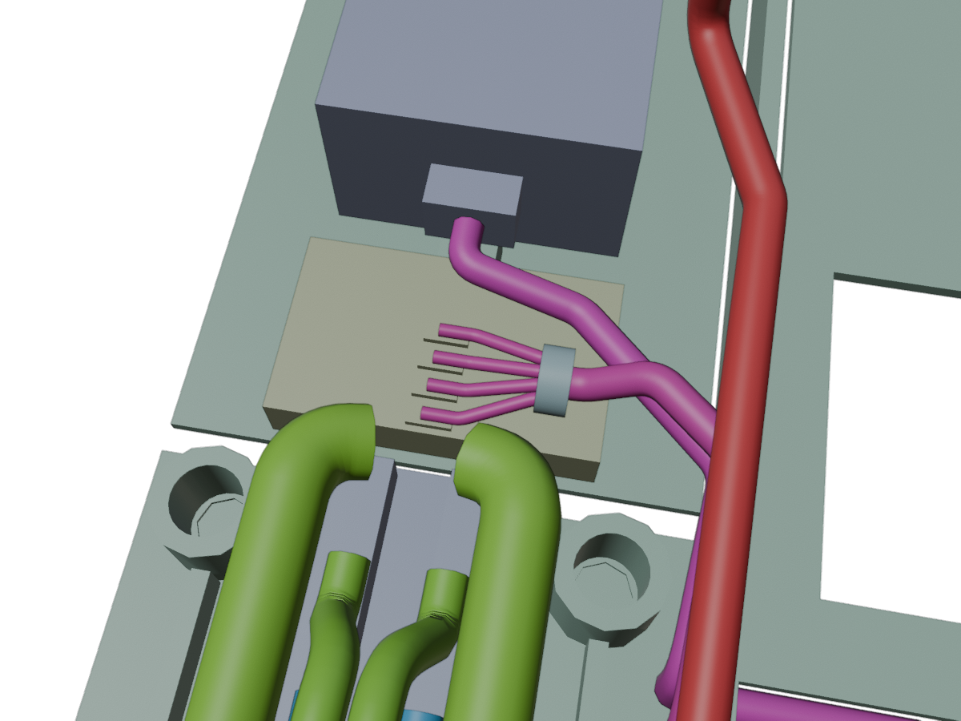
redesign/review/inspection-2026-11-13/T3_rx_pads.png
