davinciucberkeley-collab/DBF-Combined/redesign/review/inspection-2026-11-13/T5_gps_plug.png

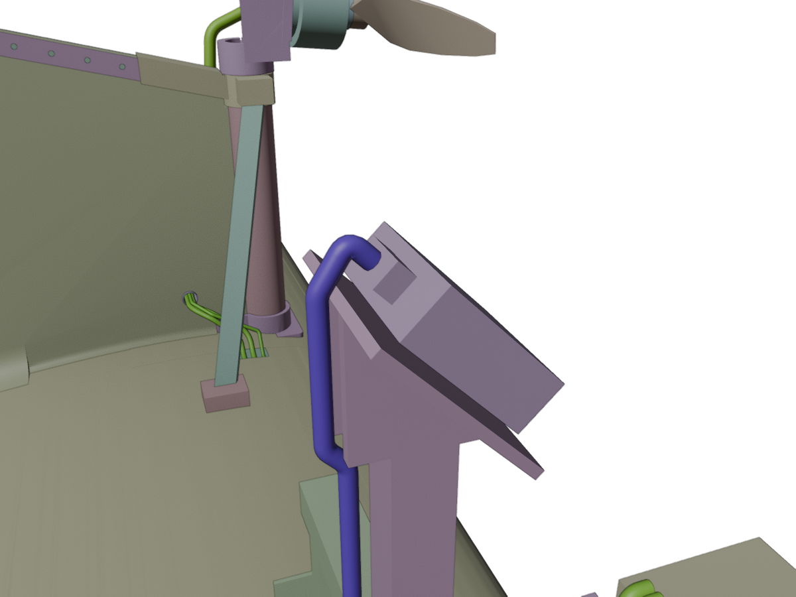
redesign/review/inspection-2026-11-13/T5_gps_plug.png
