davinciucberkeley-collab/DBF-Combined/redesign/review/inspection-2026-11-13/T6_pdb_link_pads.png

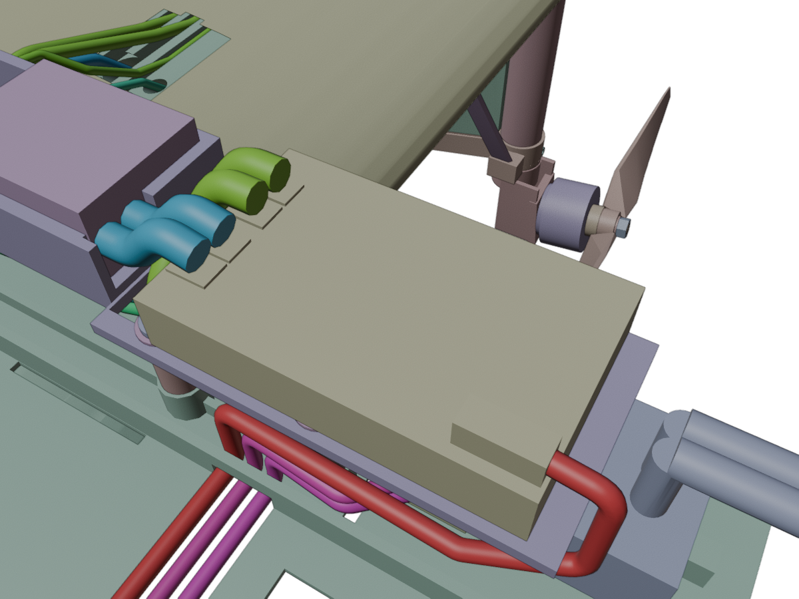
redesign/review/inspection-2026-11-13/T6_pdb_link_pads.png
