davinciucberkeley-collab/DBF-Combined/redesign/review/inspection-2026-11-13/T7_fc_under_link.png

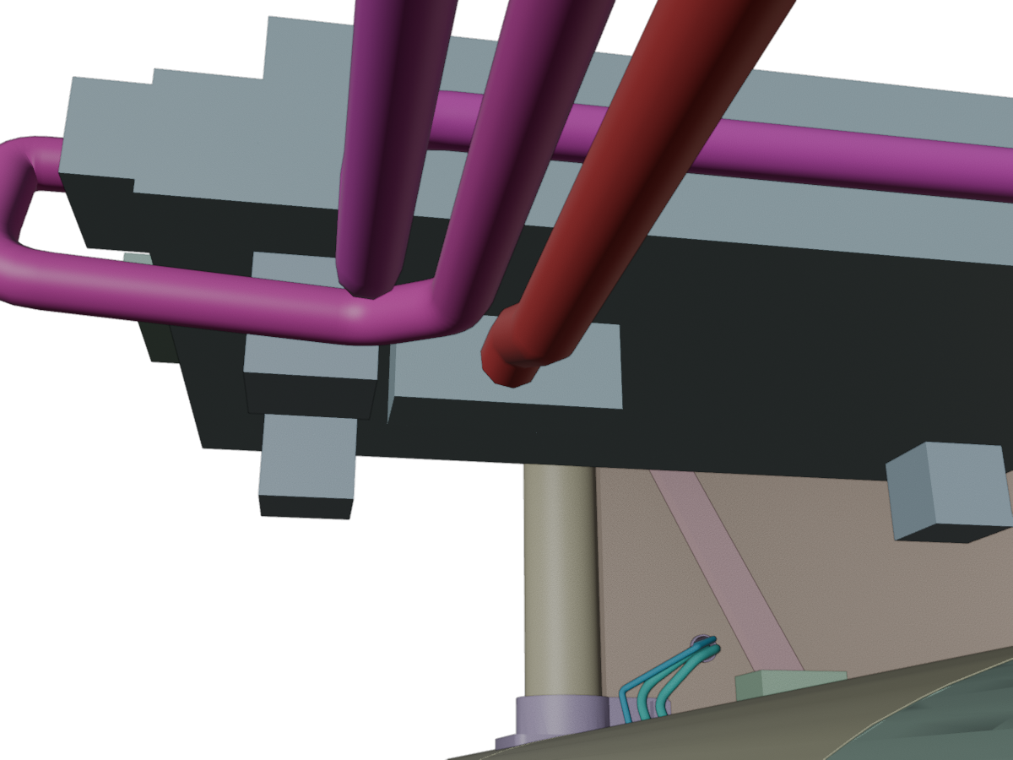
redesign/review/inspection-2026-11-13/T7_fc_under_link.png
