davinciucberkeley-collab/DBF-Combined/redesign/showcase/_work/cutaway-xray.jpg

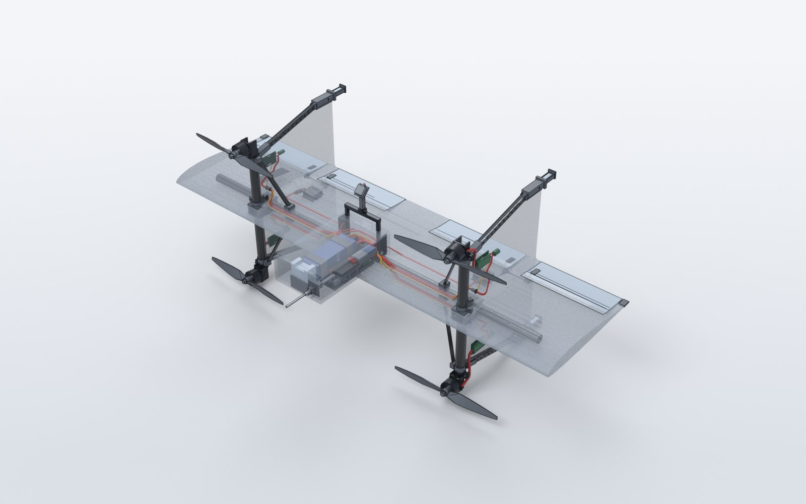
redesign/showcase/_work/cutaway-xray.jpg
