davinciucberkeley-collab/DBF-Combined/redesign/showcase/_work/detail-fasteners.jpg

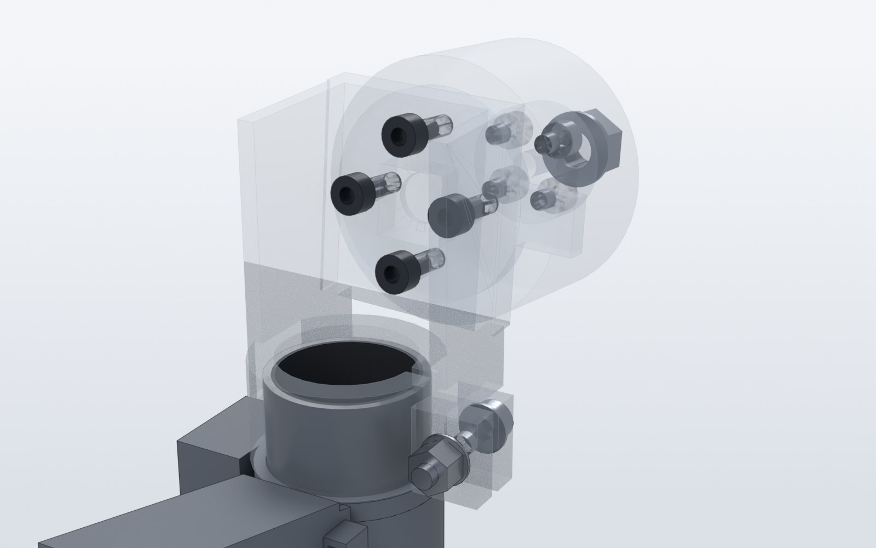
redesign/showcase/_work/detail-fasteners.jpg
