davinciucberkeley-collab/DBF-Combined/redesign/showcase/_work/detail-fin.jpg

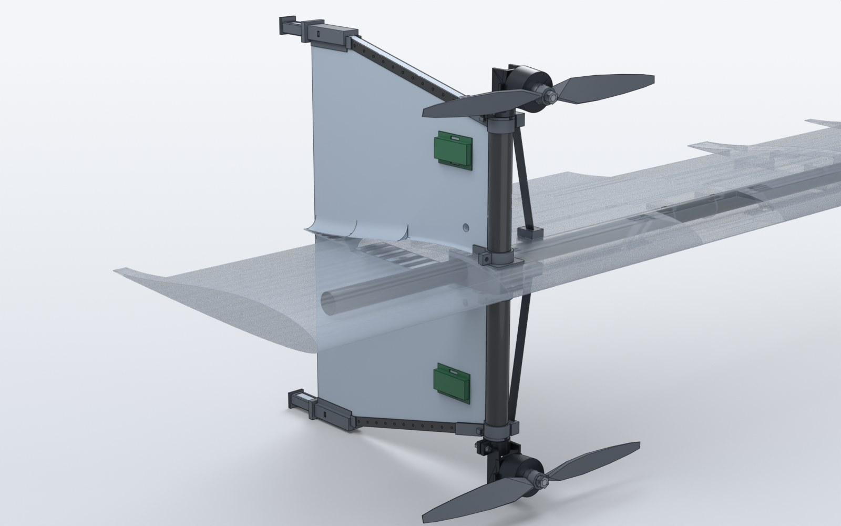
redesign/showcase/_work/detail-fin.jpg
