davinciucberkeley-collab/DBF-Combined/redesign/showcase/_work/detail-foot.jpg

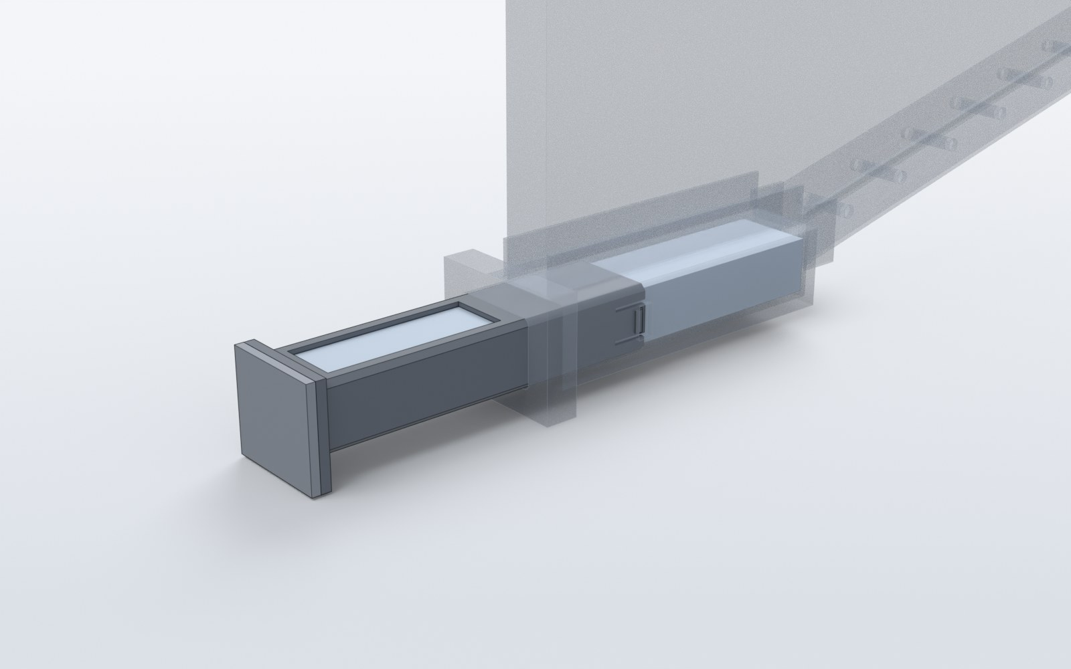
redesign/showcase/_work/detail-foot.jpg
