davinciucberkeley-collab/DBF-Combined/redesign/showcase/_work/detail-harness.jpg

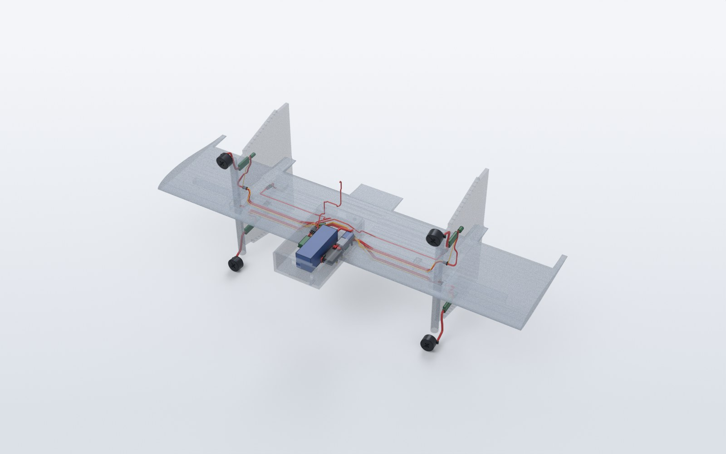
redesign/showcase/_work/detail-harness.jpg
