davinciucberkeley-collab/DBF-Combined/redesign/showcase/_work/detail-harness.png

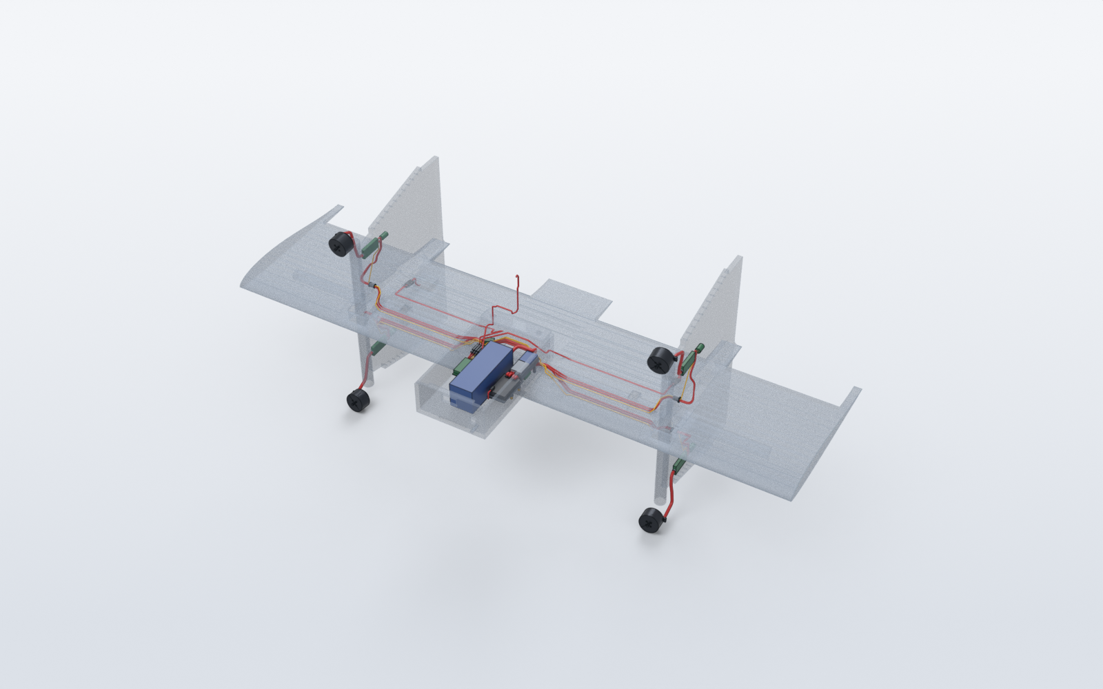
redesign/showcase/_work/detail-harness.png
