davinciucberkeley-collab/DBF-Combined/redesign/showcase/_work/detail-mechanisms.jpg

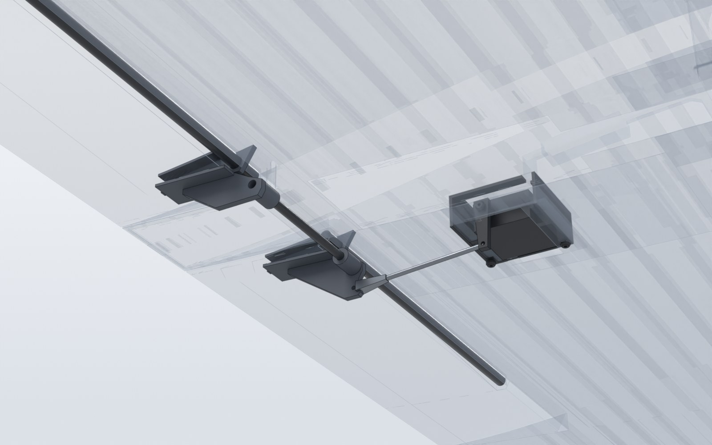
redesign/showcase/_work/detail-mechanisms.jpg
