davinciucberkeley-collab/DBF-Combined/redesign/showcase/_work/detail-pod.jpg

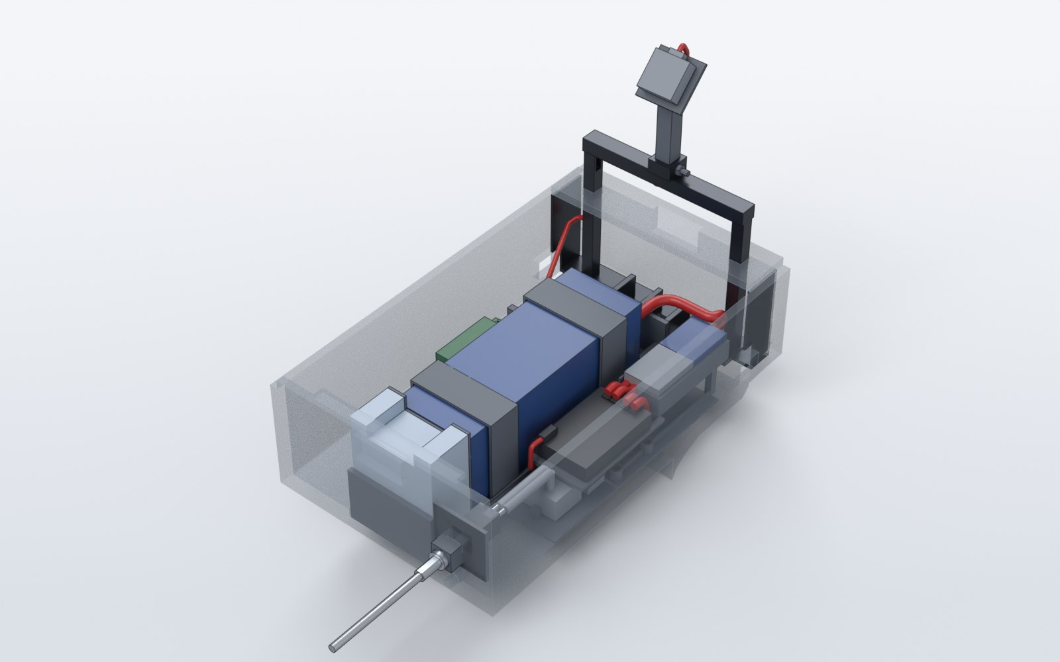
redesign/showcase/_work/detail-pod.jpg
