davinciucberkeley-collab/DBF-Combined/redesign/showcase/_work/detail-propulsion.jpg

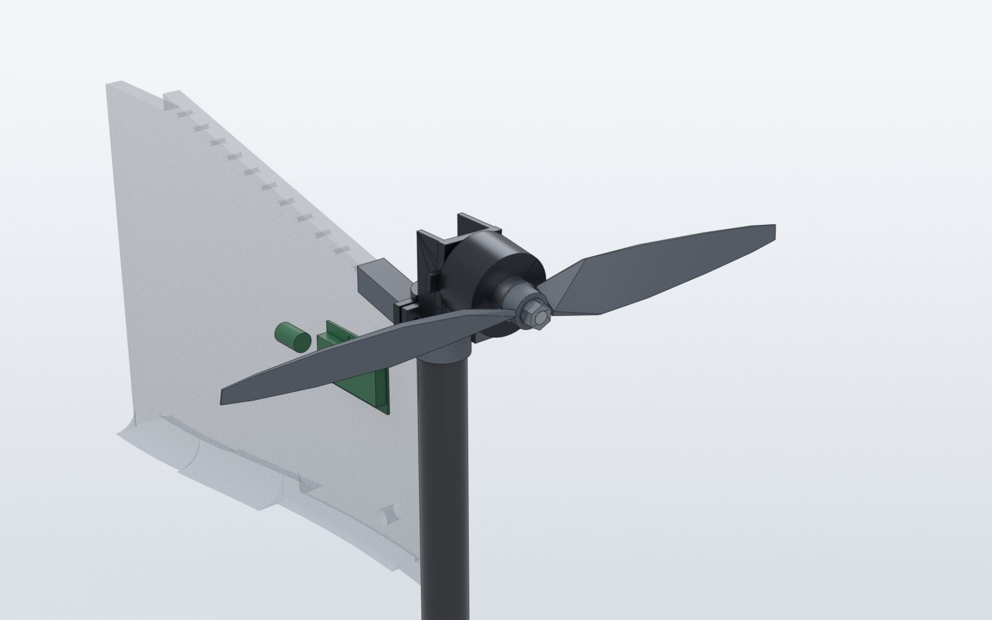
redesign/showcase/_work/detail-propulsion.jpg
