davinciucberkeley-collab/DBF-Combined/redesign/showcase/_work/detail-wing.jpg

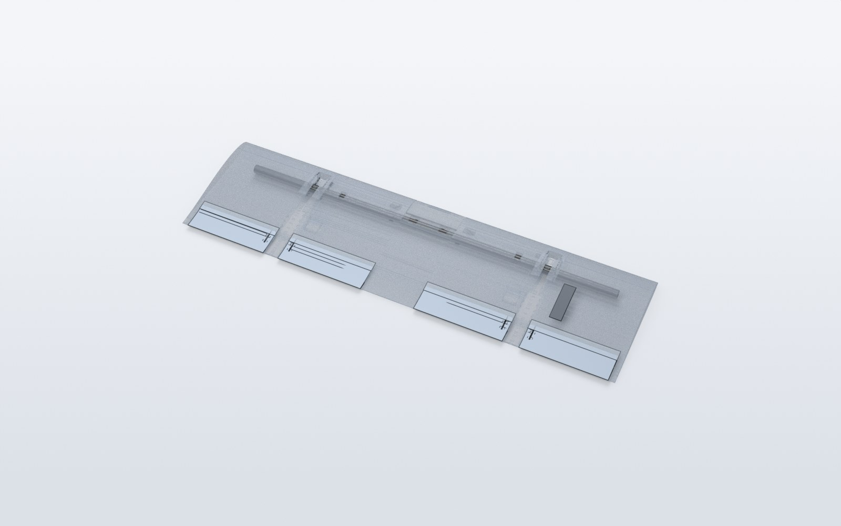
redesign/showcase/_work/detail-wing.jpg
