davinciucberkeley-collab/DBF-Combined/redesign/showcase/_work/exploded.jpg

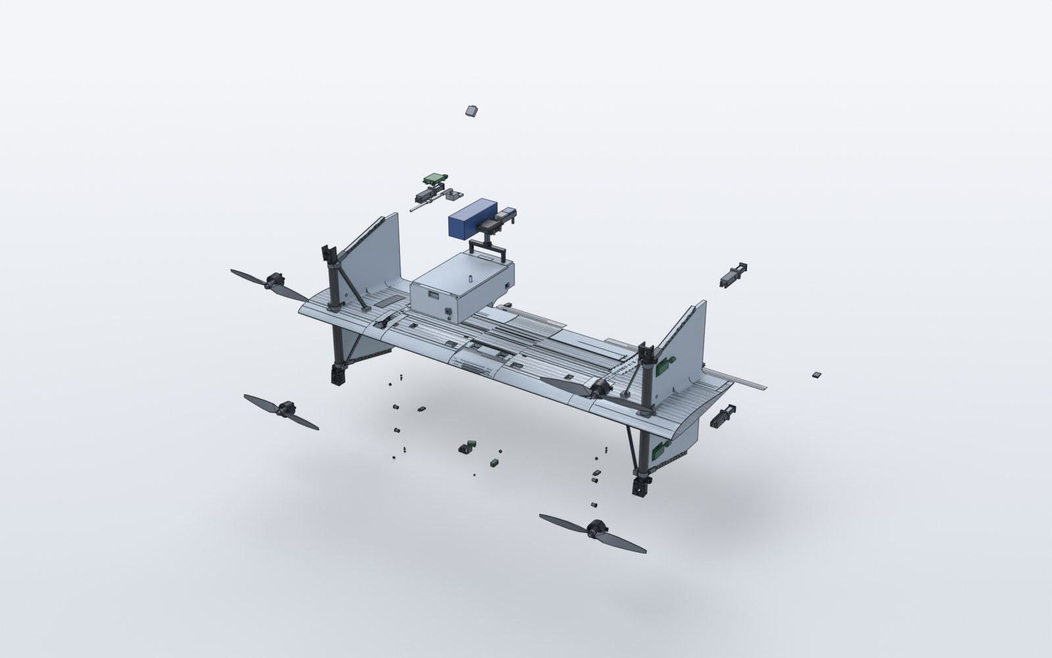
redesign/showcase/_work/exploded.jpg
