davinciucberkeley-collab/DBF-Combined/redesign/showcase/_work/front.jpg

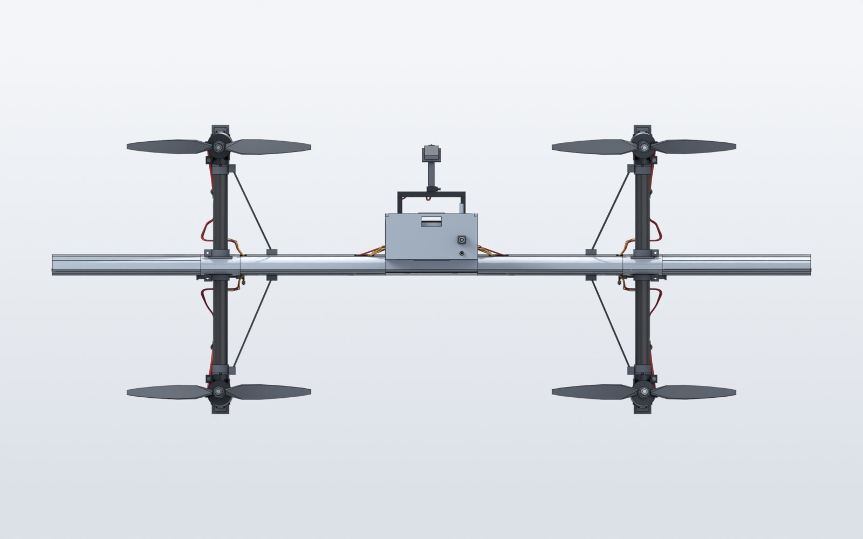
redesign/showcase/_work/front.jpg
