davinciucberkeley-collab/DBF-Combined/redesign/showcase/_work/hover-pose.jpg

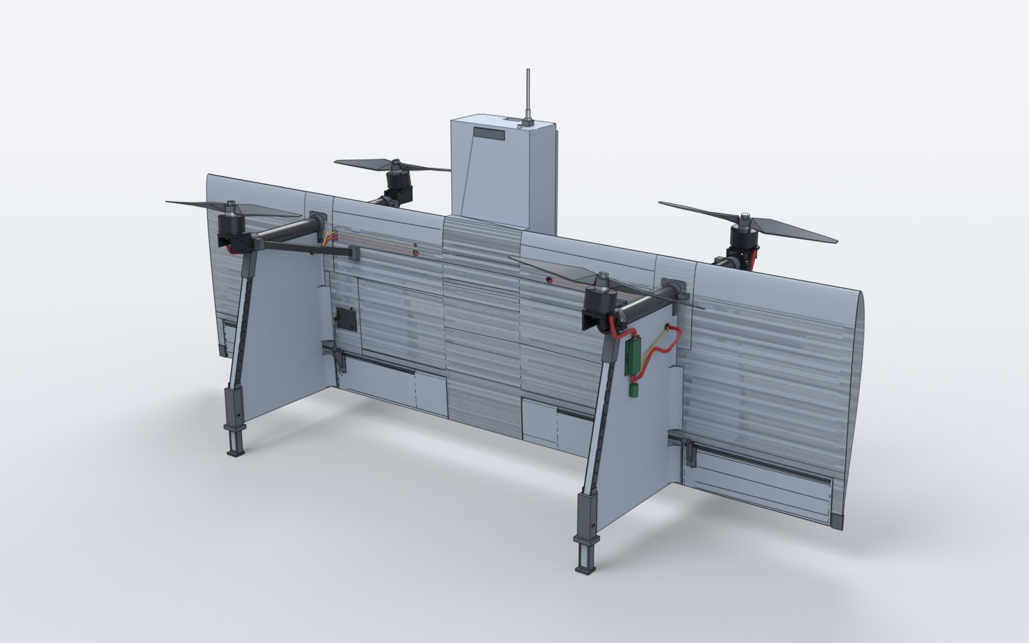
redesign/showcase/_work/hover-pose.jpg
