davinciucberkeley-collab/DBF-Combined/redesign/showcase/_work/side.jpg

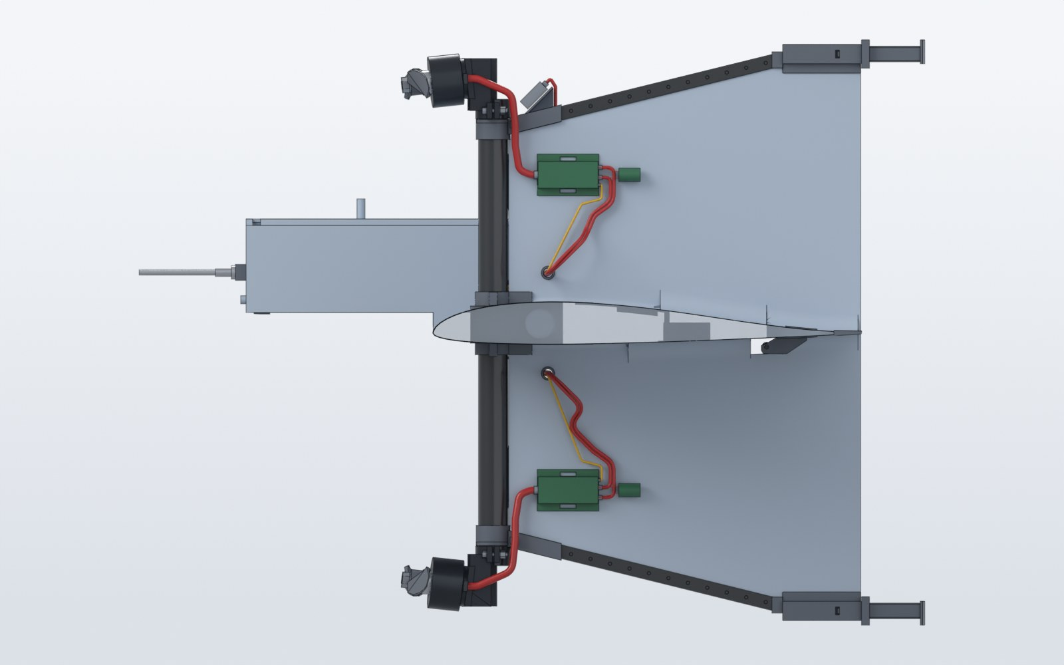
redesign/showcase/_work/side.jpg
