davinciucberkeley-collab/DBF-Combined/redesign/showcase/_work/top.jpg

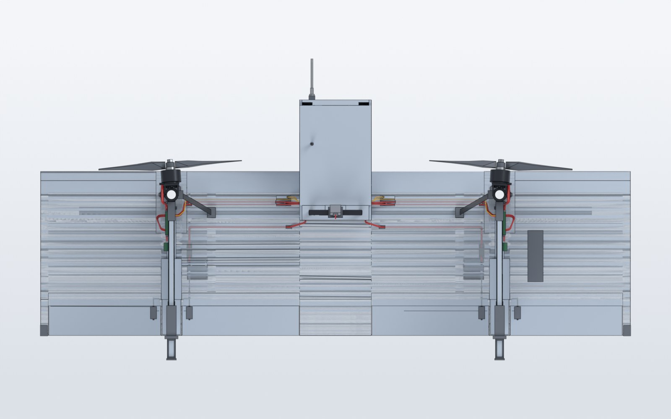
redesign/showcase/_work/top.jpg
