davinciucberkeley-collab/DBF-Combined/redesign/showcase/_work/transport-box.jpg

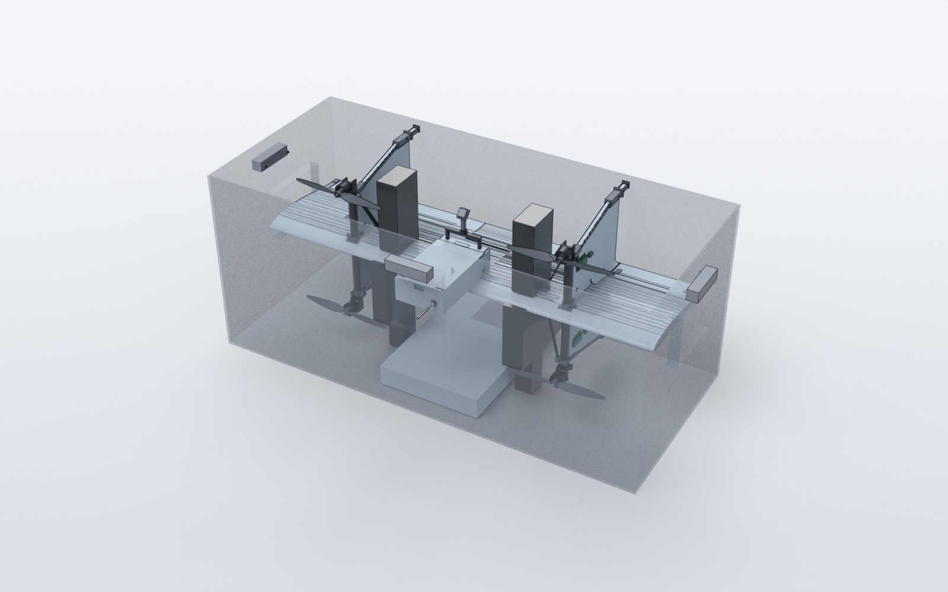
redesign/showcase/_work/transport-box.jpg
