davinciucberkeley-collab/DBF-Combined/redesign/showcase/animation/poster.png

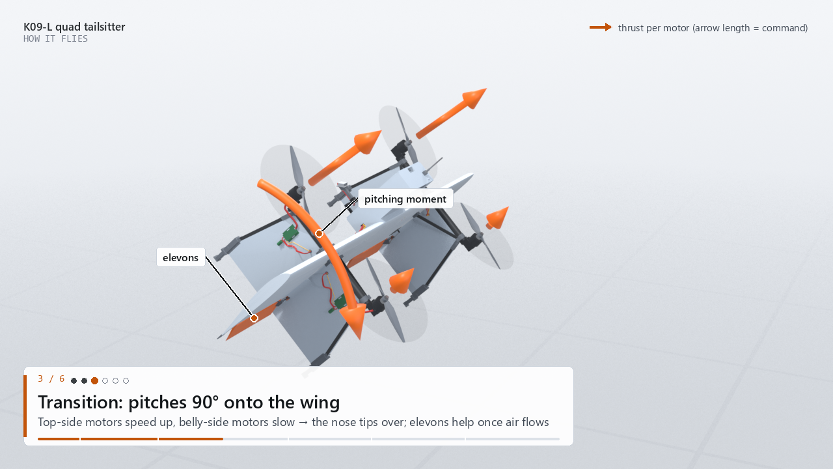
redesign/showcase/animation/poster.png
