davinciucberkeley-collab/DBF-Combined/redesign/showcase/pages/overview-decision.png

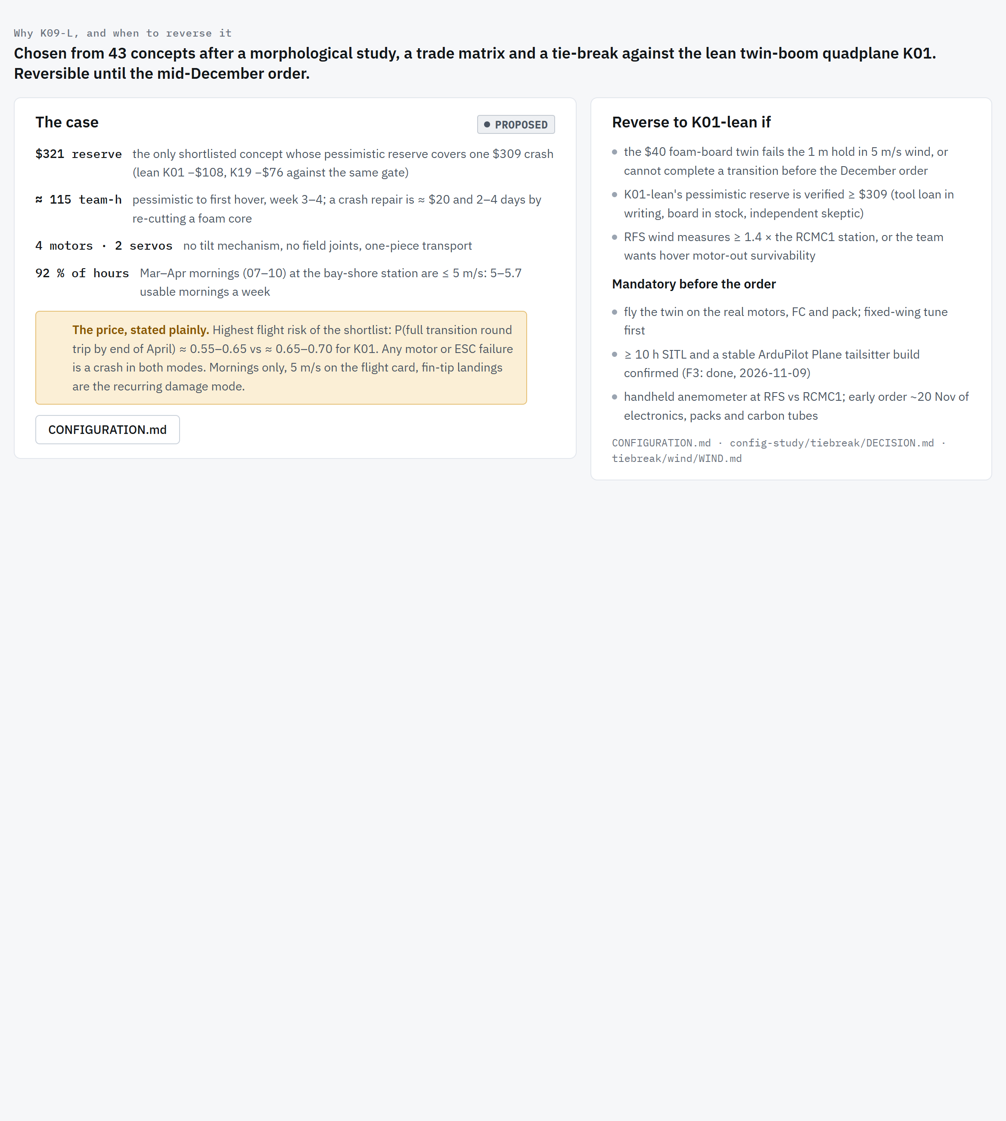
redesign/showcase/pages/overview-decision.png
