davinciucberkeley-collab/DBF-Combined/redesign/showcase/pages/overview-sources.png

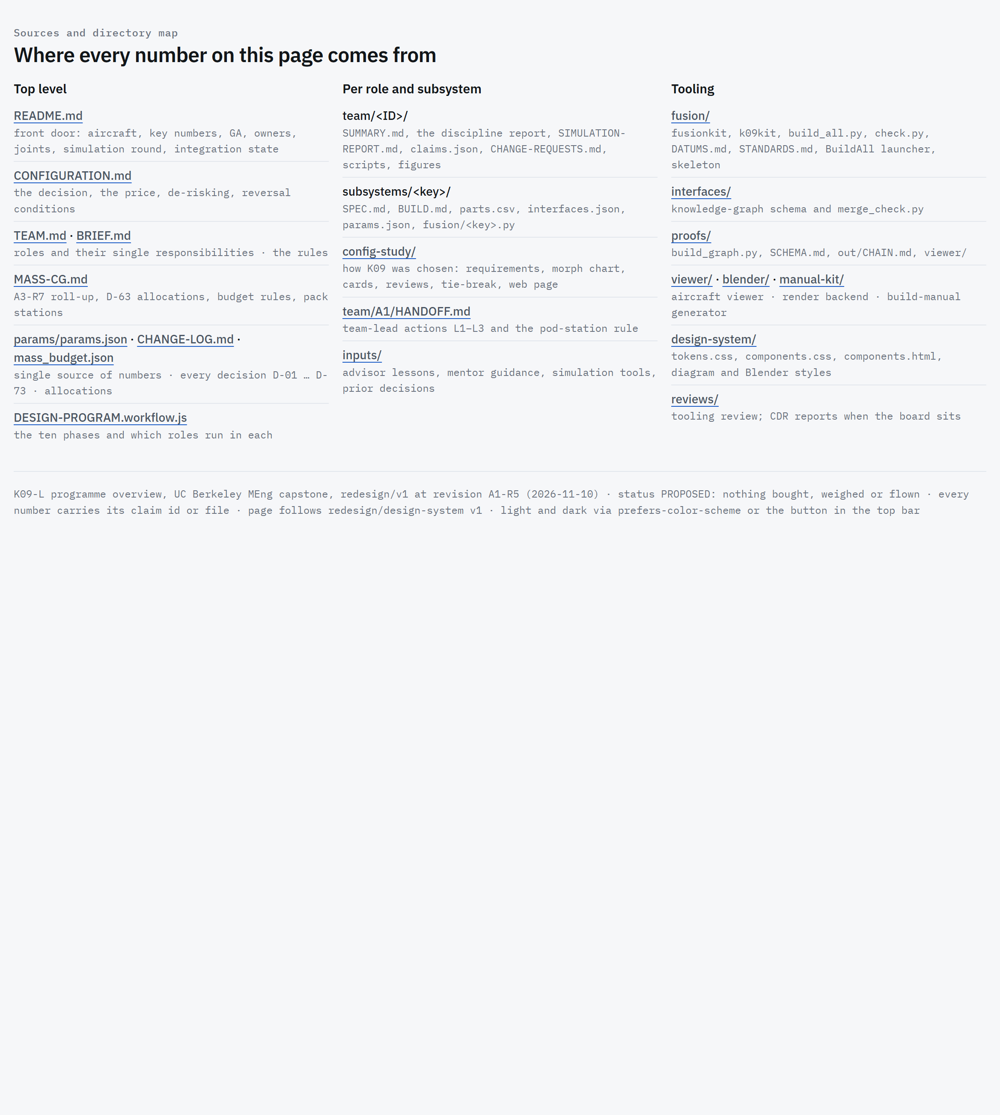
redesign/showcase/pages/overview-sources.png
