davinciucberkeley-collab/DBF-Combined/redesign/site/assets/drawing/front.webp

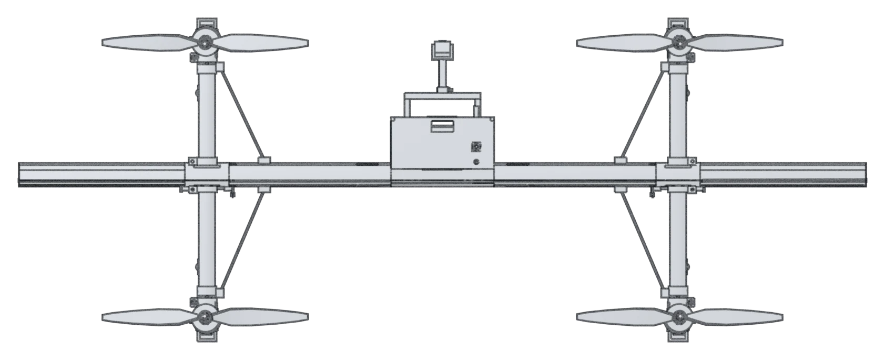
redesign/site/assets/drawing/front.webp
