davinciucberkeley-collab/DBF-Combined/redesign/site/assets/drawing/iso.webp

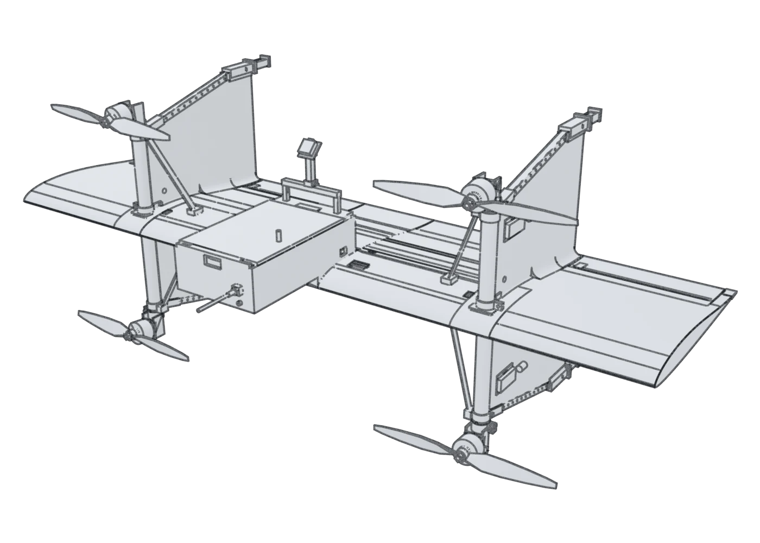
redesign/site/assets/drawing/iso.webp
