davinciucberkeley-collab/DBF-Combined/redesign/site/assets/drawing/side.webp

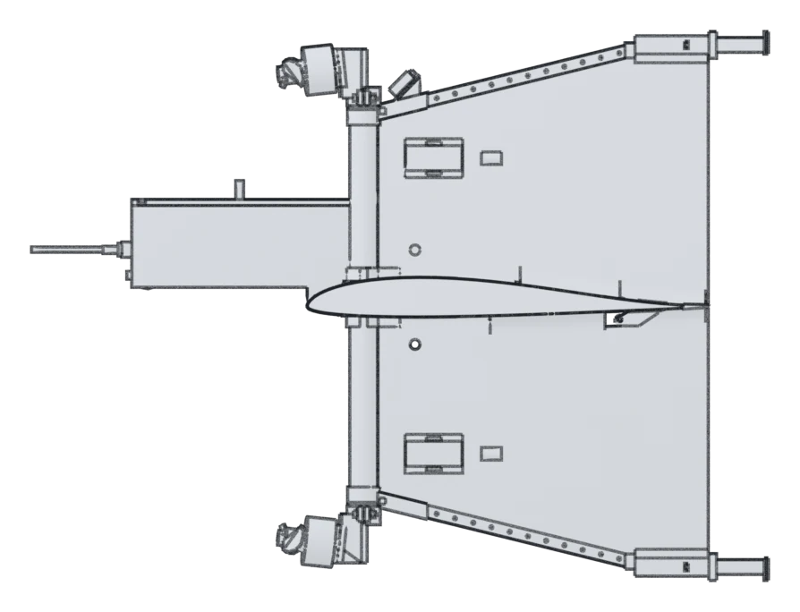
redesign/site/assets/drawing/side.webp
