davinciucberkeley-collab/DBF-Combined/redesign/site/assets/drawing/top.webp

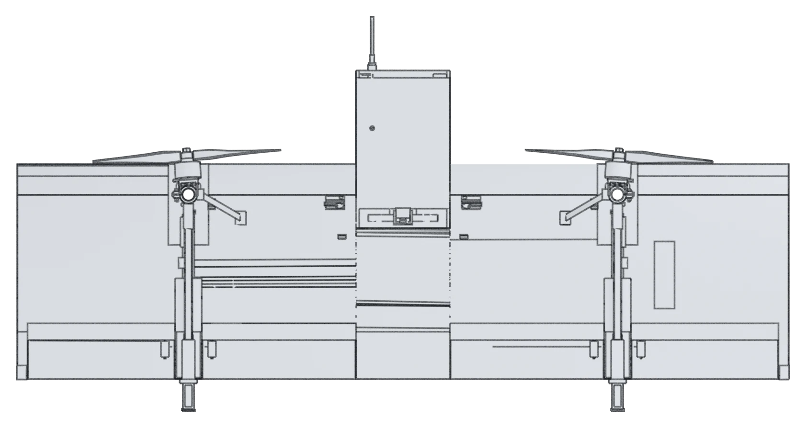
redesign/site/assets/drawing/top.webp
