davinciucberkeley-collab/DBF-Combined/redesign/site/assets/renders/thumb/detail-foot.jpg

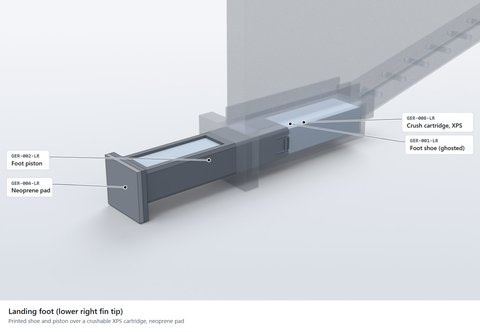
redesign/site/assets/renders/thumb/detail-foot.jpg
