davinciucberkeley-collab/DBF-Combined/redesign/site/assets/renders/thumb/detail-mechanisms.jpg

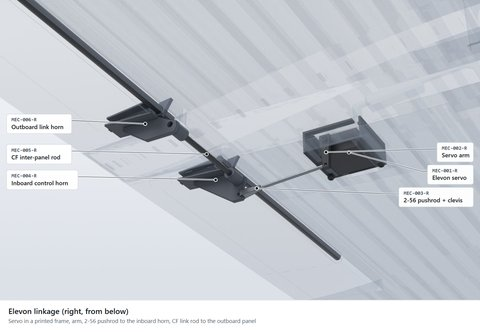
redesign/site/assets/renders/thumb/detail-mechanisms.jpg
