davinciucberkeley-collab/DBF-Combined/redesign/site/assets/renders/thumb/detail-pod.jpg

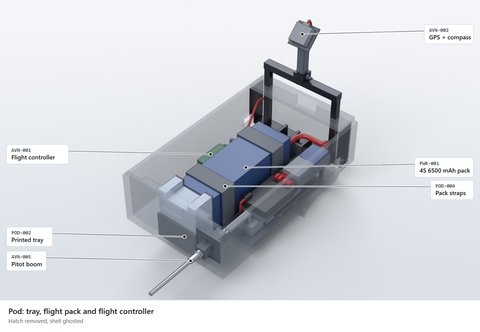
redesign/site/assets/renders/thumb/detail-pod.jpg
