davinciucberkeley-collab/DBF-Combined/redesign/team/B1/sim/png/fig-b1-convergence.png

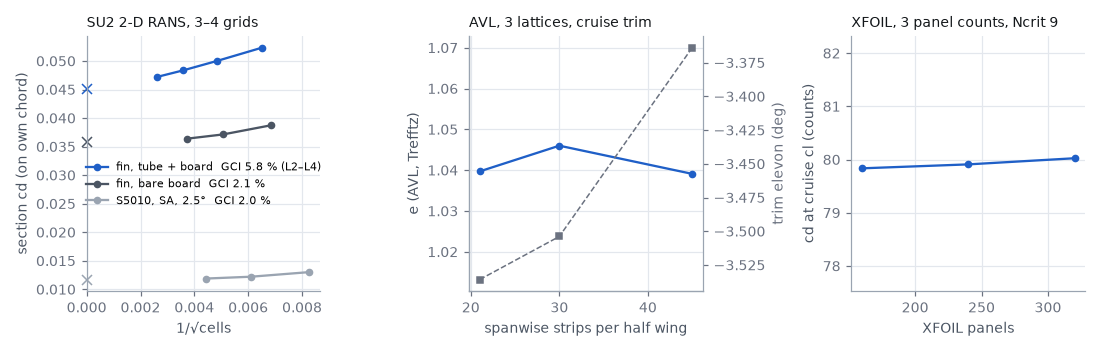
redesign/team/B1/sim/png/fig-b1-convergence.png
