davinciucberkeley-collab/DBF-Combined/redesign/team/B1/sim/png/fig-b1-corridor-asdesigned.png

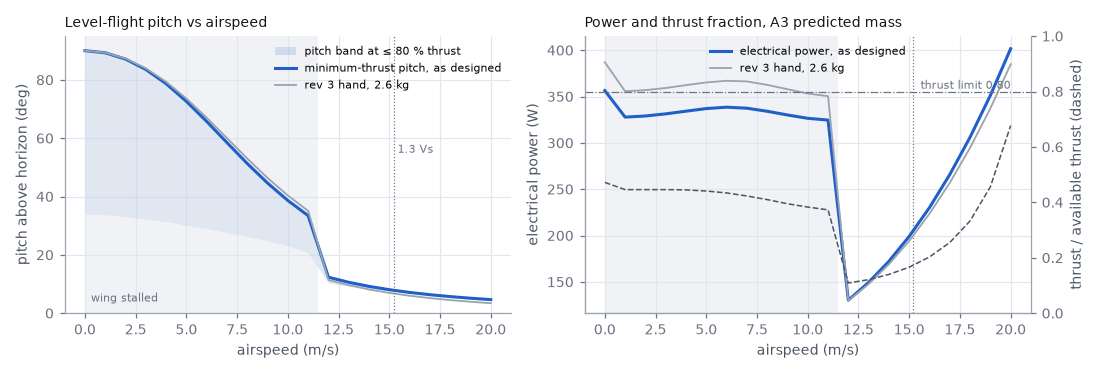
redesign/team/B1/sim/png/fig-b1-corridor-asdesigned.png
