davinciucberkeley-collab/DBF-Combined/redesign/team/B1/sim/png/fig-b1-cruise-power.png

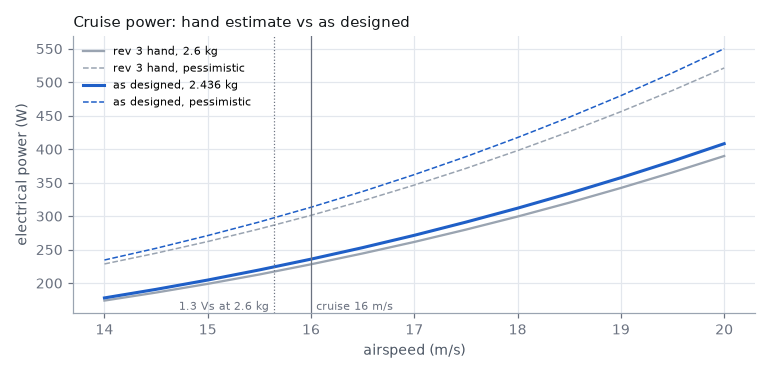
redesign/team/B1/sim/png/fig-b1-cruise-power.png
