davinciucberkeley-collab/DBF-Combined/redesign/team/B1/sim/png/fig-b1-drag-breakdown.png

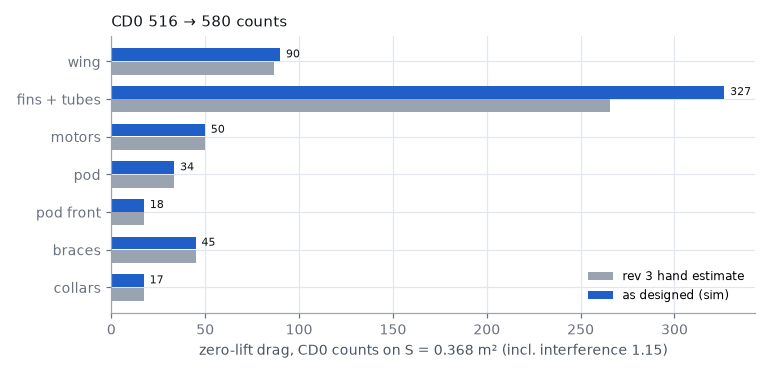
redesign/team/B1/sim/png/fig-b1-drag-breakdown.png
