davinciucberkeley-collab/DBF-Combined/redesign/team/B1/sim/png/fig-b1-margins.png

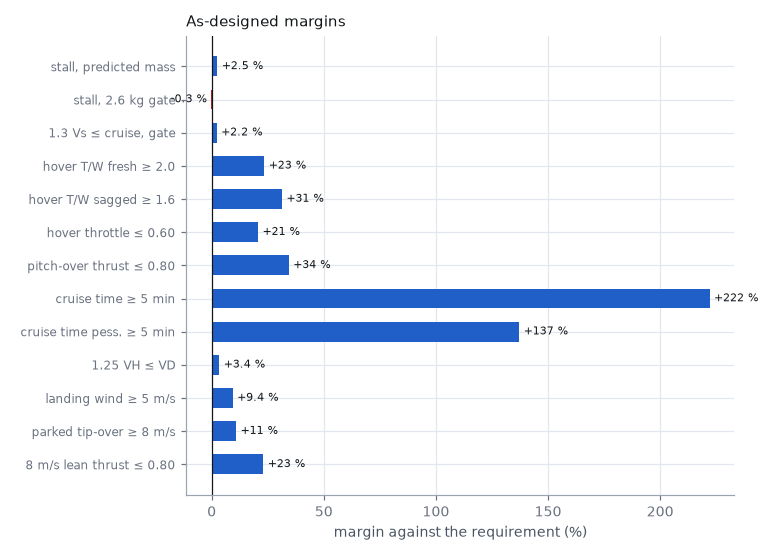
redesign/team/B1/sim/png/fig-b1-margins.png
