davinciucberkeley-collab/DBF-Combined/redesign/team/I1/BOM.csv

line | group | part_id | item | vendor | part_number | url | order | qty_fitted | qty_spare | qty_total | unit_usd | unit_usd_pessimistic | ext_usd | tax_usd | ext_incl_tax_usd | lead_time_days | long_lead | price_status | price_seen | note
B01 | propulsion | PRP-001 | Motor SunnySky X3108S KV900 | SunnySky USA | X3108S, KV900 variant | https://sunnyskyusa.com/products/sunnysky-x3108s-motors | EARLY | 4 | 1 | 5 | 24.99 | 24.99 | 124.95 | 12.81 | 137.76 | 5 |  | CHK | 2026-11-09 | search snippet of the vendor page: $24.99, 60 in stock; page itself 429 on fetch. Measure bolt pattern and lead length on arrival
B02 | propulsion | PRP-002 | ESC LANRC BLHeli_S 45 A 4-pack (4 fitted, 0 spare) | Amazon | ASIN B0D2HS4Y4J | https://www.amazon.com/dp/B0D2HS4Y4J | EARLY | 1 | 0 | 1 | 30.00 | 30.00 | 30.00 | 3.07 | 33.07 | 4 |  | CARRY | 2026-11-01 | UNVERIFIED: Amazon 503 on 2026-11-09, search finds no US LANRC 4-pack page. Check the live page (title, 45 A, 4-pack, price) before the order. Fallback Holybro Tekko32 F4 45A AM32 $22.50 each (backorder to Dec 2026): +$60 for 4
B03 | propulsion | PRP-003 | Prop APC 11x5.5MR / 11x5.5MRP (LP11055MR / MRP): 2 + 2 fitted, 4 spare | APC | LP11055MR, LP11055MRP | https://www.apcprop.com/product/11x5-5mr/ | EARLY | 4 | 4 | 8 | 3.83 | 3.83 | 30.64 | 3.14 | 33.78 | 5 |  | CHK | 2026-11-09 | vendor page fetched 2026-11-09: $3.83, 0.60 oz; stock not stated on the page
B04 | propulsion | PRP-003 | Prop APC 11x4.5MR / 11x4.5MRP (LP11045MR, LP11045MRP) for the thrust-stand A/B | APC | LP11045MR, LP11045MRP | https://www.apcprop.com/product/11x4-5mr/ | EARLY | 4 | 0 | 4 | 3.83 | 3.83 | 15.32 | 1.57 | 16.89 | 5 |  | CHK | 2026-11-09 | 2 MR + 2 MRP (CR-E1-12); $3.83 per SRC-APC-11X45MR, checked 2026-11-09
B05 | propulsion | PRP-004 | Prop adapter ring APC LPAR06E-type (centres the hub on the M6 post) | APC | LPAR06E | https://gravesrc.com/apclpar06e-apc-adapter-rings-for-electric-propellers | EARLY | 4 | 8 | 12 | 0.50 | 0.50 | 6.00 | 0.61 | 6.61 | 5 |  | CHK | 2026-11-11 | price ESTIMATE as cost.csv; link: Graves RC (US reseller) page for APC LPAR06E; motionrc.com listing seen sold out. Price not seen
B07 | propulsion | PRP-005 | Motor screw M3x8 SHCS ISO 4762 A2 (16 fitted + 4 spare) | Bolt Depot | M3-0.5 x 8 socket head A2 | https://aspenfasteners.com/m3-0-5-x-8mm-din-912-iso-4762-metric-hex-socket-head-cap-screws-a2-stainless-steel | EARLY | 16 | 4 | 20 | 0.10 | 0.10 | 2.00 | 0.20 | 2.20 | 5 |  | CHK | 2026-11-11 | per-piece price from the old design's F01; check Bolt Depot minimum order; the hardware kit may already hold M3x8; link: Bolt Depot has no M3x8 A2 page in search; Aspen Fasteners (US) lists the exact M3-0.5 x 8 mm ISO 4762 A2 screw. Price not seen
P01 | power | PWR-001 | LiPo Ovonic 4S 6500 mAh 120C hard case, EC5, 2-pack (2 flight packs, no packs 3-4, no 4S 4000) | Ampow / OVONIC (same SKU) | 2-Pack Ovonic 14.8V 120C 4S 6500mAh Hardcase LiPo, EC5 plug, 1/8 scale RC car | https://www.ampow.com/products/2-pack-ovonic-4s-6500mah-120c-lipo-hardcase-ec5-1-8-rc-car | EARLY | 1 | 0 | 1 | 114.48 | 131.43 | 114.48 | 11.73 | 126.21 | 14 | YES | EST | 2026-11-10 | D-64 / CR-E2-24. NO USD price found: ampow page 429, us.ovonicshop.com has no EC5 hard-case listing. Baseline = EUR 98.69 (E2, EU page) x 1.16 = $114.48; pessimistic = EUR 113.30 (ampow el-gb page, in stock, 2026-11-10 search) x 1.16 = $131.43. Ampow ships from Germany: lead about 14 days (long). Two checks BEFORE paying: (a) 10 AWG discharge leads confirmed by the seller (12 AWG: stop, tell E2 and F1), (b) EC5 / 4S / 6500 / hard case / 2 packs in the cart. Listed 551 +/- 5 g, 135 x 46 x 49 mm. The 130C XT60 SKU (680 g, 12 AWG) is NOT bought. Fallback if unavailable: Tattu 4S 6750 25C XT90 605 g (A1 must accept the mass)
A01 | avionics | AVN-001 | Flight controller CoreWing F405 Wing APP V2 | ReadyMadeRC | CoreWing F405 Wing APP V2 | https://www.readymaderc.com/products/details/87195-corewing-f405-wing-app-v2-fixed-wing-flight-controller-unsoldered-pins | EARLY | 1 | 0 | 1 | 67.26 | 67.26 | 67.26 | 6.89 | 74.15 | 5 |  | CARRY | 2026-10-13 | WB-01 / BR-05 / D-74: place this cart FIRST in the early order and run subsystems/power/BOARD-CHECK.md the day it arrives, before D2 freezes the pod CAD; check the PDB ('PDB Board PLUS') and the 470 uF cap are in the box (the RMRC 'included' list names neither; the CoreWing manual lists both). CR-F3-06 / CR-A1-39: order V2 now (the Mini lacks bdshot). ReadyMadeRC product 87195 'unsoldered pins'; the old URL returns 404 and search shows no price, so the price is carried from 2026-10-13: re-read before ordering. Fallback SpeedyBee F405 Wing APP $47.99 (-$19.27, RaceDayQuads, stock unverified)
A02 | avionics | AVN-002 | GPS + compass HGLRC M100-5883 | RaceDayQuads | M100-5883 | https://www.racedayquads.com/products/hglrc-m100-5883-gps-module-10th-gen | EARLY | 1 | 0 | 1 | 20.49 | 20.49 | 20.49 | 2.10 | 22.59 | 5 |  | CARRY | 2026-10-13
A03 | avionics | AVN-003 | Receiver RadioMaster RP3 V2 ELRS | RadioMaster | RP3 V2 ELRS 2.4 GHz, FCC variant | https://www.radiomasterrc.com/products/rp3-expresslrs-2-4ghz-nano-receiver | EARLY | 1 | 0 | 1 | 19.99 | 19.99 | 19.99 | 2.05 | 22.04 | 5 |  | CHK | 2026-11-09 | CR-F5-06: select the FCC variant, NOT LBT (LBT caps 100 mW). Page fetched 2026-11-09: $19.99 sale, FCC and LBT both listed at $19.99 and available
A04 | avionics | AVN-004 | Airspeed sensor RMRC digital (MS4525DO) + pitot tube | ReadyMadeRC | RMRC digital airspeed sensor MS4525DO + pitot | https://www.readymaderc.com/products/details/rmrc-digital-air-speed-sensor-pixhawk-ii-2 | DEC (GATED X08) | 1 | 0 | 1 | 59.99 | 59.99 | 59.99 | 6.15 | 66.14 | 10 |  | CHK | 2026-11-11 | CR-F3-06: MS4525DO replaces the MS5525 line (same $59.99). Needed for the fixed-wing tune (January), not for the twin. Lever if the reserve needs help (+$66.14 incl. tax, DECISION 5.1); link: RMRC kit page (sensor + pitot + tubing); confirm the board is the MS4525DO (sensor-board-only SKU 86845 names it). Price not seen
A05 | avionics | AVN-006 | microSD card 16-32 GB (FC log) | Amazon | SanDisk class, 16-32 GB | https://www.amazon.com/dp/B08GY9NYRM | EARLY | 1 | 0 | 1 | 6.00 | 6.00 | 6.00 | 0.61 | 6.61 | 4 |  | EST | 2026-11-09 | CR-F3-06: team stock first; nothing is owned, so carried. Gel pads from shop consumables; link: SanDisk Ultra 32 GB A1 microSDHC; representative product; any equivalent; link not opened; matched by search
A06 | avionics | AVN-003 | 2 x 150 mm U.FL / IPEX1 2.4 GHz T-antenna (dipole) for the RP3 V2 (D-72) | Amazon | 2.4 GHz 150 mm U.FL T antenna, pair | https://www.amazon.com/dp/B0BGN7N6PL | EARLY | 1 | 0 | 1 | 6.00 | 6.00 | 6.00 | 0.61 | 6.61 | 4 |  | EST | 2026-11-10 | CR-F5-11 / CR-F3-15: stock 65 mm leads do not reach the carbon-free zone. F5 estimate $6, no listing fetched. U.FL plug-in, no iron needed. Check IPEX1 vs IPEX4 on the RP3 V2; link: FrSky 150 mm IPEX1 dipole; sold singly, not a verified T-antenna pair; confirm IPEX1 and order 2; link not opened; matched by search
A07 | avionics | AVN-006 | FC isolation set: alpha-gel 5 mm sheet (4 cubes), 1 mm foam tape, 10 mm hook-and-loop | Amazon | alpha-gel sheet + VHB-class tape | https://www.getfpv.com/rtom-anti-vibration-moongel.html | DEC | 1 | 0 | 1 | 10.00 | 10.00 | 10.00 | 1.02 | 11.02 | 4 |  | EST | 2026-11-10 | F3 AVN-006 prices $3 and CR-F3-06 says shop consumables, but nothing is owned and gel sheets sell for about $10: carried at $10 (+$7 over F3). Drop if Jacobs stock is confirmed; link: NO PRODUCT PAGE FOUND for a 5 mm alpha-gel sheet; RTOM Moongel (drum damping gel) is not a confirmed match; representative product; any equivalent; link not opened; matched by search
M01 | mechanisms | MEC-001 | Elevon servo Savox SH-0255MG+ 12 mm micro, 3.9 kgf-cm at 6 V (2 fitted; the spare is gated X02) | Savox USA / hobby dealer | SH-0255MG+ | https://www.amainhobbies.com/savox-sh0255mg-digital-metal-gear-micro-servo-sav-sh-0255mg/p183344 | DEC | 2 | 0 | 2 | 41.99 | 41.99 | 83.98 | 8.61 | 92.59 | 7 |  | CHK | 2026-11-11 | CR-D6-02 / CR-A1-52: replaces the ES3005HV placeholder (42 g, does not fit the 12 mm pocket). $41.99 from D6 (SRC-D6-SH0255-PRICE, UNVERIFIED); no dealer page re-read. Buy from a US dealer with stock; no other 12 mm servo with >= 3.5 kgf-cm is known; link: US dealer AMain page for Savox SH-0255MGP (the SH-0255MG+); savoxusa.com lists it at $41.99 per search snippet; AMain price not seen
W01 | airframe | WNG-001 | XPS FOAMULAR NGX F-250 2 in x 4 x 8 ft (about 6 wing cores) | Home Depot El Cerrito | F-250 2 in | https://www.homedepot.com/p/Owens-Corning-FOAMULAR-NGX-F-250-2-in-x-4-ft-x-8-ft-SSE-R-10-XPS-Rigid-Foam-Board-Insulation-52DDNGX/315197962 | LOCAL | 1 | 0 | 1 | 59.97 | 59.97 | 59.97 | 6.15 | 66.12 | 0 |  | CARRY | 2026-10-01 | pick-up; check the sheet is flat and unbroken; link: Home Depot model 52DDNGX (scored square edge); price not seen; link not opened; matched by search
W02 | airframe | FIN-001 | Foam board 20x30 in, 10-pack (fins, first foam-board twin) | Amazon | ASIN B074QZMLQF | https://www.amazon.com/dp/B074QZMLQF | EARLY | 1 | 0 | 1 | 35.92 | 35.92 | 35.92 | 3.68 | 39.60 | 4 |  | CARRY | 2026-10-01
W03 | airframe | WNG-002 | Carbon tube 22x20x1000 mm matte, US stock (one for C4's bend test, then the spare) | Aloft Hobbies | 22 x 20 x 1000mm MW carbon tubing matte | https://alofthobbies.com/products/22-x-20-x-1000mm-mw-carbon-tubing-matte-finish | EARLY | 1 | 0 | 1 | 24.00 | 24.00 | 24.00 | 2.46 | 26.46 | 5 |  | CHK | 2026-11-09 | CR-J1-07. Vendor page: $24.00, in stock, shipping at checkout; mandrel-wound, layup unstated. Weigh and bend-test on arrival
W04 | airframe | WNG-002 | Carbon tube 22x20x1000 mm matte (spar + 2 motor tubes cut from one + 0 spare), order after the bend test | Aloft Hobbies | same SKU as W03 | https://alofthobbies.com/products/22-x-20-x-1000mm-mw-carbon-tubing-matte-finish | DEC | 2 | 0 | 2 | 24.00 | 28.32 | 48.00 | 4.92 | 52.92 | 5 |  | CHK | 2026-11-09 | baseline: Aloft $24 if the W03 bend test passes. Pessimistic and fallback: the BOM's overseas Amazon tube $28.32 (cost.csv, ~14 days: order first, 15 Dec at the latest)
W05 | airframe | FIN-002 | PETG filament 1 kg (Ambrosia) | West3D | PETG 1 kg | https://west3d.com/products/ambrosia-petg-filament-of-the-gods-1kg-bambu-ams-friendly-cardboard-spools-premium-3d-printing-filament | DEC | 1 | 0 | 1 | 20.99 | 20.99 | 20.99 | 2.15 | 23.14 | 5 |  | CARRY | 2026-10-01 | non-structural prints in Jacobs' free PLA; link: West3D Ambrosia PETG 1 kg; search snippet shows $20.99, matches; link not opened; matched by search
W06 | airframe | WNG-003 | Packing tape Scotch Heavy Duty, 6 rolls | Amazon | ASIN B000087KUA | https://www.amazon.com/dp/B000087KUA | EARLY | 1 | 0 | 1 | 19.98 | 19.98 | 19.98 | 2.05 | 22.03 | 4 |  | CARRY | 2026-10-01
W07 | airframe | WNG-004 | Foam-safe glue (UHU Por / Gorilla clear) | Amazon | ESTIMATE vendor | https://www.amazon.com/dp/B004GHJ9NW | EARLY | 1 | 0 | 1 | 12.99 | 12.99 | 12.99 | 1.33 | 14.32 | 4 |  | EST | 2026-11-01 | link: UHU Por 50 ml; representative product; any equivalent; link not opened; matched by search
H01 | hardware | HRN-103 | Harness parts (F2 parts.csv HRN-103..106, 108, 109): 26 AWG servo extension 2 m $5, 28 AWG 3 colours $7, JR/Futaba connector kit $7, JST-GH housings + pigtails $12, cable ties $4, PET braid sleeve $6 | Amazon / DigiKey | assorted, see F2 parts.csv | https://www.amazon.com/dp/B0CKZCFC54 | EARLY | 1 | 0 | 1 | 41.00 | 41.00 | 41.00 | 4.20 | 45.20 | 4 |  | EST | 2026-11-10 | F2 prices all EST UNVERIFIED; one line = six purchases. 16 AWG, 20 AWG and heat-shrink are F03, F04, F09. JST-GH from DigiKey adds shipping: use pre-crimped pigtails from Amazon if the cart allows; link: line = six purchases; link is the JST-GH pigtail kit only. Servo extension e.g. https://www.amazon.com/dp/B00Q683IFE; representative product; any equivalent; link not opened; matched by search
H02 | hardware | MEC-005 | Mechanisms hardware (D6 parts.csv): Du-Bro 2-56 rod + steel clevises $8, 1/8 in (3.18 mm) pultruded CF rod 1 m $5, CF tube 5 x 4 x 1000 mm $8, M2 x 6 self-tapping pan-head screws (servo covers MEC-011: 4 fitted + spares, pack of 20) $3 | Amazon / hobby shop | Du-Bro 2-56, CF rod 1/8 in, CF tube 5x4, M2 x 6 self-tapping pan head A2 | https://www.amazon.com/dp/B0006O4G8M | DEC | 1 | 0 | 1 | 24.00 | 24.00 | 24.00 | 2.46 | 26.46 | 5 |  | EST | 2026-11-10 | CR-D6-02, CR-D6-16: the 1/8 in CF rod replaces the 3/32 in music wire ($5, was $3). Hinge tape is the wing tape (W06). M2 x 6: 2 per servo cover (E-MEC-03/04, -35/36, C6 FASTENERS-CAD); buy even if the servo box has screws (length unverified); link: link is the Du-Bro DUB185 2-56 rod + steel Kwik-Link only; CF rod, CF tube 5x4 and M2x6 screws not linked; representative product; any equivalent; link not opened; matched by search
H03 | hardware | HRN-002 | Charger-side XT60 pair for the AS150U charge adapter + 0.3 m 10 AWG stub | Amazon | XT60 pair, 10 AWG silicone | https://www.amazon.com/dp/B08LLBMT1N | DEC | 1 | 0 | 1 | 5.00 | 5.00 | 5.00 | 0.51 | 5.51 | 4 |  | EST | 2026-11-09 | was $15 for the whole AS150U re-termination; F01 now buys the five AS150U pairs, so only the charger-side XT60 and a short 10 AWG stub remain; link: Hobbypark XT60 pair with 10 AWG leads; representative product; any equivalent; link not opened; matched by search
H06 | hardware | HRN-113 | Amass XT30U male + female pairs, 10-pair pack (4 fitted: one per ESC pair at the pod side exits, WB-03; rest spares) | Amazon | Amass XT30U (genuine Amass, 2-pin, 20 A) | https://www.amazon.com/ | EARLY | 1 | 0 | 1 | 9.99 | 9.99 | 9.99 | 1.02 | 11.01 | 4 |  | EST | 2026-11-11 | D-74 / WB-03: pod-wing power disconnect, harness SPEC.md 'Pod-wing power disconnect'. Price EST (10-pair packs list about $8-12); buy genuine Amass (1.2 mOhm contact resistance, 20 A on 16 AWG per the Amass manual), not unbranded
F01 | power | PWR-003 | Amass AS150U connector pair (male + female) x 5: aircraft, 2 packs, charge lead, spare | Amazon | Amass AS150U | https://www.amazon.com/dp/B0BWH5D7H7 | EARLY | 5 | 0 | 5 | 5.00 | 5.00 | 25.00 | 2.56 | 27.56 | 5 |  | EST | 2026-11-09 | F1 price EST $25 for 5; open the Amass sheet. Confirm the SKU is the anti-spark AS150U, not AS150; link: Amass AS150U with signal pin, one pair; need 5 pairs (check pack size); confirm AS150U not AS150; link not opened; matched by search
F02 | power | PWR-004 | Silicone wire 10 AWG red + black 0.3 m each (PWR-104) + 8 AWG 0.1 m each (bus bars) | Amazon | 10 AWG + 8 AWG silicone | https://www.amazon.com/dp/B017TGYW3S | EARLY | 1 | 0 | 1 | 8.00 | 8.00 | 8.00 | 0.82 | 8.82 | 4 |  | EST | 2026-11-09 | main pigtail; vendors sell 1 m minimum; link: BNTECHGO 10 AWG red+black 5 ft; 8 AWG bus wire not linked; representative product; any equivalent; link not opened; matched by search
F03 | power | PWR-004 | Silicone wire 16 AWG red + black + yellow, 3 m each (HRN-101) | Amazon | BNTECHGO 16 AWG 252/0.08 silicone, 10 ft per colour | https://www.amazon.com/dp/B017TFR664 | EARLY | 1 | 0 | 1 | 14.00 | 14.00 | 14.00 | 1.43 | 15.43 | 4 |  | EST | 2026-11-09 | ESC leads, F2 cuts; link: BNTECHGO 16 AWG red+black 10 ft; no yellow in this listing, add a yellow 16 AWG; representative product; any equivalent; link not opened; matched by search
F04 | power | PWR-005 | Silicone wire 20 AWG red + black, 1 m each | Amazon | 20 AWG silicone | https://www.amazon.com/dp/B01AAX64EC | EARLY (GATED X12) | 1 | 0 | 1 | 4.00 | 4.00 | 4.00 | 0.41 | 4.41 | 4 |  | EST | 2026-11-09 | was UBEC feed + servo bus; D-74 deletes the UBEC, so this line is held behind gate X12 with F05 / F06; link: BNTECHGO 20 AWG red+black 10 ft each; representative product; any equivalent; link not opened; matched by search
F05 | power | PWR-005 | UBEC 6 V, 8 A class (Hobbywing type) | Amazon | UBEC 6 V 8 A | https://www.readymaderc.com/products/details/hobbywing-ubec-8a | EARLY (GATED X12) | 1 | 0 | 1 | 18.00 | 18.00 | 18.00 | 1.84 | 19.84 | 5 |  | CHK | 2026-11-11 | F1: datasheet UNVERIFIED; 13 g in A3's roll-up. D-74: gate X12, bought only if power/BOARD-CHECK.md step 7 fails; then buy a 4S-input part (the linked UBEC-8A is listed 2-3S); link: Hobbywing UBEC-8A (5/6 V, 8 A, 2-3S); a retailer snippet marks it discontinued: check stock; alt RMRC 8A/12A UBEC
F06 | power | PWR-003 | Mini blade fuse 5 A x 3 + inline holder | Amazon | ATM mini fuse + holder | https://www.amazon.com/dp/B07L4QFXTB | EARLY (GATED X12) | 1 | 0 | 1 | 6.00 | 6.00 | 6.00 | 0.61 | 6.61 | 4 |  | EST | 2026-11-09 | UBEC feed protection; gate X12 with F05 (D-74); link: HUIQIAODS 2-pack inline holders with 5 A ATM fuses (listing mixes ATM/ATC wording: check); representative product; any equivalent; link not opened; matched by search
F07 | power | PWR-003 | Capacitor 680 uF 25 V low-ESR x 5 | Amazon | 680 uF 25 V | https://www.amazon.com/pcs-Panasonic-FR-Capacitors-680uf/dp/B072SSXHW | EARLY | 1 | 0 | 1 | 5.00 | 5.00 | 5.00 | 0.51 | 5.51 | 4 |  | EST | 2026-11-09 | one per ESC + 1 spare; link: Panasonic FR 680 uF 25 V 6-pack (ultra low ESR); representative product; any equivalent; link not opened; matched by search
F08 | power | PWR-105 | FR4 1.6 mm 1 oz copper sheet 100 x 70 mm (bus board PWR-004 / PWR-105; 3 boards per sheet) | Amazon | FR4 single-sided copper clad | https://www.amazon.com/dp/B08LDXGCMJ | EARLY | 1 | 0 | 1 | 3.00 | 3.00 | 3.00 | 0.31 | 3.31 | 4 |  | EST | 2026-11-10 | F1 replaced the bare PDB with a cut FR4 bus board; was $6; link: IIVVERR FR-4 single-sided 100x70x1.6 mm 5-pack; representative product; any equivalent; link not opened; matched by search
F09 | power | PWR-003 | Adhesive-lined 3:1 heat-shrink assortment 2.4-9.5 mm (HRN-107; also F1 joints) | Amazon | Wirefy 3:1 assortment | https://www.amazon.com/dp/B089D82FLG | EARLY | 1 | 0 | 1 | 9.00 | 9.00 | 9.00 | 0.92 | 9.92 | 4 |  | EST | 2026-11-09 | joints; link: Wirefy 3:1 adhesive-lined kit 200 pcs; representative product; any equivalent; link not opened; matched by search
C01 | hardware | HRN-003 | M3 steel A2 kit: SHCS M3x16 x6 (D3 pinch bolts), nyloc x8, washer x12 (C6 kit R4; M3x8 x20 is B07) | Bolt Depot | ISO 4762 / 10511 / 7089 A2 | https://boltdepot.com/Product-Details?product=4792 | EARLY | 1 | 0 | 1 | 5.00 | 5.00 | 5.00 | 0.51 | 5.51 | 5 |  | EST | 2026-11-09 | C6 kit table; piece prices about $3 plus minimum-order rounding. M3x8 x20 is B07. M3 only; link: Bolt Depot M3 18-8 nylon-insert nut (kit also needs M3x16 screws and washers, product 4513: not linked); representative product; any equivalent; link not opened; matched by search
C06 | hardware | PWR-101 | M3 nylon PA66 set: socket-head M3x18 x11, M3x16 x3 + hex nut x3, 0.5 mm washer x6, 10 mm spacer OD 6 / ID 3.2 x6 (power frame, GPS mast, T-C6-NYLON-TORQUE) | Amazon | PA66 M3 socket-head assortment + spacers | https://www.amazon.com/dp/B0F5J2ZLXY | DEC | 1 | 0 | 1 | 7.00 | 7.00 | 7.00 | 0.72 | 7.72 | 4 |  | EST | 2026-11-10 | CR-C6-30 / CR-C6-26: PA66 SOCKET heads (not pan) so the 2.5 mm hex key torques them at 0.08 N m; PWR-101..103 are inside this line. C6 kit total EST $26, here $28; link: Happinesspark PA66 socket-head M3 assortment; spacers separate (e.g. https://www.amazon.com/dp/B074N5HD42); representative product; any equivalent; link not opened; matched by search
C02 | hardware | HRN-003 | M3 x 5.7 brass heat-set inserts x12 + M3 nylon washers / FC grommets x8 | Amazon | Ruthex-class RX-M3x5.7 | https://www.amazon.com/dp/B08BCRZZS3 | DEC | 1 | 0 | 1 | 9.00 | 9.00 | 9.00 | 0.92 | 9.92 | 4 |  | EST | 2026-11-09 | pod FC plate (4), PDB (4), spares (4); link: Ruthex RX-M3x5.7 inserts, 100 pcs; nylon washers not included; representative product; any equivalent; link not opened; matched by search
C03 | hardware | FIN-012 | Pultruded CF rod 2.5 mm x 1 m x 2 (one + spare): strip through-pins at 15 mm, 48 pins (D3 FIN-012 uses the same rod) | Amazon | CF rod 2.5 mm x 1000 mm | https://alofthobbies.com/products/2-5mm-x-1000mm-rod | DEC | 2 | 0 | 2 | 3.50 | 3.50 | 7.00 | 0.72 | 7.72 | 4 |  | EST | 2026-11-10 | CR-C6-31 / CR-C6-35 / D-70: 2 mm to 2.5 mm; if 2.5 mm cannot be bought, 2 mm at 9 mm pitch. Not double counted with D3; link: Aloft 2.5 mm x 1000 mm pultruded CF rod, $2.63 per search snippet (BOM $3.50), not changed; link not opened; matched by search
C04 | hardware | HRN-003 | Loctite 243 (10 ml) + paint pen (torque witness) | Amazon | Loctite 243 | https://www.amazon.com/dp/B004VODM24 | DEC | 1 | 0 | 1 | 9.00 | 9.00 | 9.00 | 0.92 | 9.92 | 4 |  | EST | 2026-11-09 | motor screws, tip threads only; link: Loctite 243 10 mL (page shown unavailable in snippet); paint pen not linked; representative product; any equivalent; link not opened; matched by search
C05 | hardware | HRN-003 | Laminating epoxy 30 min (small kit) + colloidal silica + glass microballoons | Amazon | 30 min epoxy kit | https://www.amazon.com/dp/B0CBLK7R2M | DEC | 1 | 0 | 1 | 14.00 | 14.00 | 14.00 | 1.43 | 15.43 | 4 |  | EST | 2026-11-09 | C6 and D3 (FIN-105) both list shop stock; nothing is owned, so one kit is carried. Drop if Jacobs Hall confirms stock in writing; link: West System 105 + 206 slow hardener + 406 silica (larger than a small kit; 206 is slow, not 30 min; no microballoons); representative product; any equivalent; link not opened; matched by search
D01 | airframe | FIN-009 | Pultruded CF strip 10 x 2 x 1000 mm x 1 (4 braces, FIN-009) | Aloft Hobbies | CF strip 10x2 | https://alofthobbies.com/products/2mm-x-10mm-x-1000mm | DEC | 1 | 0 | 1 | 10.00 | 10.00 | 10.00 | 1.02 | 11.02 | 5 |  | CHK | 2026-11-11 | D3 est. about $10 per length; link: Aloft 2 mm x 10 mm x 1000 mm strip; search snippet shows $5.50 (BOM $10.00): not changed, page not fetched
D02 | airframe | FIN-011 | Pultruded CF strip 10 x 1 x 1000 mm x 3 (8 edge strips) | Aloft Hobbies | CF strip 10x1 | https://alofthobbies.com/products/1mm-x-10mm-x-1000mm | DEC | 3 | 0 | 3 | 6.00 | 6.00 | 18.00 | 1.84 | 19.84 | 5 |  | EST | 2026-11-09 | D3 est. about $6 per length, 3 m asked in CR-D3-09; link: Aloft 1 mm x 10 mm x 1000 mm strip; price not seen; link not opened; matched by search
D03 | airframe | FIN-006 | CF tube 20 x 18 x 1000 mm x 1 (D3 plugs 2 x 53 mm; C2's spar plugs if the same size) | Aloft Hobbies | 20 x 18 x 1000 CF tube | https://alofthobbies.com/products/20-x-18-x-1000mm-mw-carbon-tubing | DEC | 1 | 0 | 1 | 20.00 | 20.00 | 20.00 | 2.05 | 22.05 | 5 |  | EST | 2026-11-09 | D3 priced a $1 share; stock is sold by the metre. Ask C2 whether its six 36 mm plugs use this tube; link: Aloft 20x18x1000 mm MW tube; search snippet shows $19.25 (BOM $20.00): not changed, page not fetched; link not opened; matched by search
D07 | landing | GER-013 | Brass tube 7/32 in OD K&S x 1 (cartridge bore cutter GER-013, shop tool, not flying) | Amazon / hobby shop | K&S 7/32 in round brass tube | https://www.zoro.com/k-s-precision-metals-k-s-precision-metals-8130-022-od-x-12-l-in-round-brass-tube-691089/i/G304145442 | DEC | 1 | 0 | 1 | 3.00 | 3.00 | 3.00 | 0.31 | 3.31 | 5 |  | EST | 2026-11-10 | CR-D5-27: 7/32 in replaces 1/4 in. D5 price UNVERIFIED, no listing fetched; link: K&S 8130 round brass tube 7/32 in OD x 12 in via Zoro (US); price not seen; link not opened; matched by search
D04 | airframe | FIN-104 | 10 mm hook-and-loop straps x 10 (ESC retention x4, spares) | Amazon | ONE-WRAP class | https://www.amazon.com/dp/B01LZK3UAR | DEC | 1 | 0 | 1 | 8.00 | 8.00 | 8.00 | 0.82 | 8.82 | 4 |  | EST | 2026-11-09 | D3 FIN-104, 4 needed; link: nearest listing: 0.5 in x 8 in hook-and-loop ties, 10-pack (12.7 mm, not 10 mm); representative product; any equivalent; link not opened; matched by search
D05 | landing | GER-006 | Neoprene sheet 1/16 in 40A adhesive back 12 x 12 in | Amazon | neoprene 40A 1/16 in | https://www.zoro.com/zoro-select-neoprene-sheet-40a-12x12x116-black-bulk-rs-n40txt-14/i/G4865769 | DEC | 1 | 0 | 1 | 12.00 | 12.00 | 12.00 | 1.23 | 13.23 | 5 |  | EST | 2026-11-09 | CR-D5-10: D5 names McMaster-Carr (separate cart and shipping); an Amazon sheet is carried. Price UNVERIFIED; 4 pads + 12 spares per sheet; link: Zoro Select neoprene 40A, 12 x 12 in x 1/16 in, textured, acrylic adhesive back (BULK-RS-N40TXT-14); McMaster would not give a part number; representative product; any equivalent; link not opened; matched by search
D06 | pod | POD-004 | Pack straps 20 x 300 mm hook-and-loop rubber-backed x2 + 2 EVA shims (POD-004) | Amazon | battery strap | https://www.amazon.com/dp/B019QYCXR8 | DEC | 1 | 0 | 1 | 7.00 | 7.00 | 7.00 | 0.72 | 7.72 | 4 |  | EST | 2026-11-09 | D2 POD-004; link: Apex RC 20x300 mm rubberized straps 5-pack; EVA shims not linked; representative product; any equivalent; link not opened; matched by search
W08 | airframe | FIN-003 | ASA filament 1 kg (motor mounts FIN-003, ESC pads FIN-007; D-42) | West3D | ASA 1 kg | https://west3d.com/products/polymaker-polylite-asa-3d-printer-filament-1kg-1-75mm | DEC | 1 | 0 | 1 | 24.99 | 24.99 | 24.99 | 2.56 | 27.55 | 5 |  | EST | 2026-11-09 | NOT in CR-A1-39: D-42 prints mounts and pads in ASA and Jacobs Hall stocks PLA only, so a spool is bought. 4 x 12.66 + 4 x 1.86 g = 58 g; a 0.5 kg spool if offered; link: West3D carries Polymaker PolyLite ASA 1 kg (no Ambrosia ASA there); search snippet shows $25.99-28.99 vs BOM $24.99: not changed; link not opened; matched by search
T01 | transport | TRN-001 | Coroplast 4 mm 48 x 96 in x 2 (box base, lid) | Home Depot El Cerrito | Coroplast 4 mm | https://www.homedepot.com/p/Coroplast-48-in-x-96-in-x-0-157-in-White-Corrugated-Plastic-Sheet-CP4896S/205351385 | LOCAL (GATED X07) | 2 | 0 | 2 | 15.00 | 15.00 | 30.00 | 3.07 | 33.07 | 0 |  | EST | 2026-11-09 | D7 TRN-001 $30 incl. lid TRN-005; replaces H04 plywood box; link: Home Depot Coroplast CP4896S 4 mm white; search snippet shows about $37.98 per sheet vs BOM $15: large gap, price not changed; link not opened; matched by search
T02 | transport | TRN-101 | LSE double-sided tape, 1 roll (3M 300LSE class) | Home Depot El Cerrito | 3M 300LSE class | https://www.pelicansalessupply.com/products/3m-adhesive-transfer-tape-3-4-wide-60-yd-series-9472le | LOCAL (GATED X07) | 1 | 0 | 1 | 12.00 | 12.00 | 12.00 | 1.23 | 13.23 | 0 |  | EST | 2026-11-09 | D7; link: 3M 9472LE transfer tape (300LSE acrylic), 3/4 in x 60 yd, about $68.34 per snippet vs BOM $12; not Home Depot; other sellers sell by case of 12; link not opened; matched by search
T03 | transport | TRN-006 | Cam-buckle straps x2 + strap handles x3 | Home Depot El Cerrito | 25 mm tie-down, luggage handle | https://www.homedepot.com/p/Keeper-1-in-x-6-ft-x-400-lbs-Motorcycle-Cam-Buckle-Tie-Down-2-Pack-05715/204752873 | LOCAL (GATED X07) | 1 | 0 | 1 | 24.00 | 24.00 | 24.00 | 2.46 | 26.46 | 0 |  | EST | 2026-11-09 | D7 TRN-006-A/B 2 x 6 + TRN-007 3 x 4; link: Keeper 05715 cam-buckle 2-pack (snippet $13.99-15.92); handles not linked; representative product; any equivalent; link not opened; matched by search
T04 | transport | TRN-008 | Field pouch + 10 mm prop spanner (D-40) + M3x16 / nyloc / fender washers x6 | Home Depot El Cerrito | pouch, 10 mm spanner | https://www.harborfreight.com/12-in-zipper-utility-pouch-black-70998.html | LOCAL (GATED X07) | 1 | 0 | 1 | 13.80 | 13.80 | 13.80 | 1.41 | 15.21 | 0 |  | EST | 2026-11-09 | D7 TRN-008 8 + TRN-106 4 + TRN-102 1.80; link: Yukon 12 in zipper pouch (the field pouch); 10 mm spanner is a separate item, e.g. https://www.homedepot.com/p/Husky-10-mm-12-Point-Metric-Full-Polish-Combination-Wrench-HCW10MM/202916162; M3 hardware not linked; representative product; any equivalent; link not opened; matched by search
T05 | transport | TRN-104 | Landing mat 0.8 x 0.8 m: 3 mm birch ply (Jacobs stock) + 1.5 mm rubber sheet, cloth-tape hinge (TRN-104, CR-D7-17) | Home Depot El Cerrito | rubber sheet 1.5 mm + cloth tape | https://www.homedepot.com/p/Rubber-Cal-Neoprene-1-16-in-x-36-in-x-12-in-Commercial-Grade-45A-Soft-Rubber-Sheet-Rolls-20-104-0062-36-012/303172042 | LOCAL (GATED X07) | 1 | 0 | 1 | 25.00 | 25.00 | 25.00 | 2.56 | 27.56 | 0 |  | EST | 2026-11-09 | CR-D7-17 settles CR-I1-18: one rubber-on-ply mat (mu 0.7, C5). D7 estimate $25; ply is free if Jacobs stock is confirmed; link: Rubber-Cal neoprene 1/16 in x 12 x 36 in 45A (snippet $15.31, may be stale); thickness near 1.5 mm; representative product; any equivalent; link not opened; matched by search
T06 | transport | TRN-002 | PE foam plank 2 in + 1 in (cradle columns, lid pillars) | Home Depot El Cerrito | PE foam 1.7 pcf | https://www.homedepot.com/p/Customizable-Polyethylene-Foam-Sheets-16L-x-12W-x-1-Thick-Padding-for-Cases-Tool-Foam-for-Packaging-Crafts-2-Pack-638PH01222D/3366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 | LOCAL (GATED X07) | 1 | 0 | 1 | 18.00 | 18.00 | 18.00 | 1.84 | 19.84 | 0 |  | EST | 2026-11-09 | D7 TRN-002-L/R 12, TRN-004-L/R 6; XPS offcuts for the tray; link: NO PRODUCT PAGE FOUND for 2 in PE plank at Home Depot; 1 in PE foam sheets as nearest; representative product; any equivalent; link not opened; matched by search
T07 | transport | TRN-107 | Field tote about 0.45 x 0.35 x 0.25 m (TX, landing-spares box, flight card, anemometer) (TRN-107) | Home Depot El Cerrito | tote | https://www.homedepot.com/p/Husky-12-Gal-Professional-Heavy-Duty-Waterproof-Stackable-Plastic-Storage-Container-with-Hinged-Lid-in-Red-248921/313861297 | LOCAL (GATED X07) | 1 | 0 | 1 | 8.00 | 8.00 | 8.00 | 0.82 | 8.82 | 0 |  | EST | 2026-11-10 | CR-D7-17; link: Husky 12 gal tote; check size against the 0.45 x 0.35 x 0.25 m target; representative product; any equivalent; link not opened; matched by search
T08 | transport | TRN-108 | Landing-spares box 1 L food container (TRN-108) | Home Depot El Cerrito | 1 L box | https://www.homedepot.com/p/OXO-Good-Grips-1-5-Qt-Short-Round-POP-Food-Storage-Container-with-Airtight-Lid-11283800/315329961 | LOCAL (GATED X07) | 1 | 0 | 1 | 3.00 | 3.00 | 3.00 | 0.31 | 3.31 | 0 |  | EST | 2026-11-10 | CR-D7-17; link: OXO 1.5 qt (about 1.4 L, snippet $17.99, above BOM $3); representative product; any equivalent; link not opened; matched by search
T09 | transport | TRN-109 | Labels for lid and end walls (TRN-109) | Home Depot El Cerrito | label sheet | https://www.avery.com/products/labels/5163 | LOCAL (GATED X07) | 1 | 0 | 1 | 2.00 | 2.00 | 2.00 | 0.20 | 2.20 | 0 |  | CHK | 2026-11-11 | CR-D7-17; link: Avery 5163 white 2 x 4 in labels, 1000-pack; price seen $46.99 vs BOM $2.00, price not changed; representative product; any equivalent
H05 | hardware | WNG-005 | Hot-wire bow/jig + airfoil template stock | Home Depot El Cerrito | - | https://www.amazon.com/dp/B0FBL3342W | LOCAL | 1 | 0 | 1 | 15.00 | 15.00 | 15.00 | 1.54 | 16.54 | 0 |  | EST | 2026-11-09 | K01 REVIEW section 2; link: Ni80 20 ga 30 ft wire only (BOM line also needs bow/jig and template stock: NO PRODUCT PAGE FOUND for those); representative product; any equivalent; link not opened; matched by search
R01 | avionics | GND-001 | Transmitter RadioMaster Pocket Crush ELRS | RadioMaster | Pocket Crush, ELRS / FCC variant | https://www.radiomasterrc.com/products/pocket-crush-radio-controller | EARLY | 1 | 0 | 1 | 64.99 | 64.99 | 64.99 | 6.66 | 71.65 | 5 |  | CHK | 2026-11-09 | CR-F5-06: choose 'ELRS / FCC' (page lists ELRS/FCC and ELRS/LBT at $64.99). The page does not state the module power: F5 confirms 25-250 mW on arrival. Fetched 2026-11-09. Batteries not included
R02 | avionics | GND-001 | 18650 cells, 2-pack for the Pocket (not included) | GetFPV | Lumenier 18650 2-pack | https://www.getfpv.com/lumenier-nav-3000mah-1s-18650-lithium-ion-battery-2pcs.html | EARLY | 1 | 0 | 1 | 24.49 | 24.49 | 24.49 | 2.51 | 27.00 | 5 |  | CARRY | 2026-11-09 | K09 REVIEW section 6; the Pocket does not run on USB alone. RadioMaster says batteries cannot ship separately from a radio order: if GetFPV cannot ship them, add RadioMaster cells to the same order; link: GetFPV Lumenier NAV 3000 mAh 18650 2-pack; snippet $24.49 matches; one cached page showed Out of Stock; link not opened; matched by search
G01 | ground | GND-002 | Charger HTRC C150 150 W AC | Amazon | ASIN B0H4QLJYHY | https://www.amazon.com/dp/B0H4QLJYHY | EARLY | 1 | 0 | 1 | 56.99 | 56.99 | 56.99 | 5.84 | 62.83 | 4 |  | CARRY | 2026-11-01 | E2: read the manual for max charge current and IR function on arrival
G02 | ground | GND-003 | LiPo bag (Pyrodrone) | Pyrodrone | LiPo bag | https://pyrodrone.com/products/pyrodrone-lipo-safe-pouch | EARLY | 2 | 0 | 2 | 9.99 | 9.99 | 19.98 | 2.05 | 22.03 | 5 |  | CARRY | 2026-11-01 | link: Pyrodrone LiPo Safe Pouch; snippet $7.99 vs BOM $9.99: not changed; link not opened; matched by search
G03 | ground | GND-004 | Ammo can (Harbor Freight 63750) | Harbor Freight | 63750 | https://www.harborfreight.com/50-caliber-metal-ammo-can-63750.html | LOCAL | 1 | 0 | 1 | 19.99 | 19.99 | 19.99 | 2.05 | 22.04 | 0 |  | CARRY | 2026-11-01
G04 | ground | GND-005 | Watt meter 150 A | Amazon | ASIN B0F13JWDFV | https://www.amazon.com/dp/B0F13JWDFV | EARLY | 1 | 0 | 1 | 12.99 | 12.99 | 12.99 | 1.33 | 14.32 | 4 |  | CARRY | 2026-11-01
G05 | ground | GND-006 | IR thermometer | Amazon | ASIN B0BN317X6Z | https://www.amazon.com/dp/B0BN317X6Z | EARLY | 1 | 0 | 1 | 8.98 | 8.98 | 8.98 | 0.92 | 9.90 | 4 |  | CARRY | 2026-11-01
G06 | ground | GND-007 | Thrust stand: 20 kg load cell + HX711 + Nano | Amazon | kit (budget-energy-test.md) | https://www.amazon.com/dp/B07BGS58TL | EARLY | 1 | 0 | 1 | 17.97 | 17.97 | 17.97 | 1.84 | 19.81 | 4 |  | CARRY | 2026-11-01 | H1: the stand must take >= 2.5 kgf; link: NOYITO 20 kg load cell + HX711 combo; Arduino Nano not included; link not opened; matched by search
G10 | ground | GND-010 | Flux + desoldering wick (fallback only: the Electronics Lab stations supply solder; flux and wick are not listed) | Amazon | ESTIMATE | https://www.amazon.com/dp/B0H94VTN26 | EARLY (GATED X10) | 1 | 0 | 1 | 15.00 | 15.00 | 15.00 | 1.54 | 16.54 | 4 |  | EST | 2026-11-09 | 2026-11-13: the soldering iron, multimeter and PD supply (old G07-G09) are Electronics Lab equipment covered by the Jacobs Maker Pass (paid outside the budget) and are no longer BOM lines. Bought only if the lab has no flux or wick (gate X10, check on the first visit); link: KELLYSHUN flux paste + 63/37 solder wire + tip tinner; no wick, add desoldering wick; representative product; any equivalent; link not opened; matched by search
G11 | ground | GND-011 | Hot-wire: NICE-POWER 30 V 10 A supply + Ni80 24 AWG | Amazon | ASIN B0CRSS744F + B0CP9V3DBX | https://www.amazon.com/dp/B0CRSS744F | EARLY | 1 | 0 | 1 | 41.73 | 41.73 | 41.73 | 4.28 | 46.01 | 4 |  | CARRY | 2026-11-01 | BOUGHT (2026-11-13): the Jacobs labs-and-equipment page lists no hot-wire foam cutter (checked 2026-11-13), so X11 is dissolved. EARLY order so the bow and 2-3 practice cores exist before Jacobs closes 18 Dec. The ASIN B0CRSS744F title reads 0-30 V 0-10 A 150 W (15 V 10 A / 30 V 5 A); price carried from 2026-11-01, not re-read
G12 | groundtest | GND-012 | Ground-test additions: 1 kgf bar cell + HX711 (torque arm) + 5 K-type thermocouple probes | Amazon | 1 kg bar load cell + HX711; K-type bead probe x5 | https://www.amazon.com/dp/B0F52QCK3T | EARLY | 1 | 0 | 1 | 17.00 | 17.00 | 17.00 | 1.74 | 18.74 | 4 |  | EST | 2026-11-09 | CR-A1-39 / D-39: the only NEW ground-test purchase, <= $20. With G06 (20 kgf cell kit, $17.97) the bought rig is $34.97; everything else on H1's list is borrowed (ORDER-PLAN borrow table); link: 1 kg load cell + HX711 listing; K-type probes not linked (e.g. https://www.amazon.com/dp/B0FW56V11S); link not opened; matched by search
G13 | groundtest | GND-012 | 2 foil strain gauges 350 ohm (pack of 5-10) + cyanoacrylate gauge kit, for T-C4-FIN-PROOF (paper face + strip) | Amazon | 350 ohm foil gauge 3 x 5 mm, pack | https://www.amazon.com/dp/B07WYD7Z4P | DEC | 1 | 0 | 1 | 9.00 | 9.00 | 9.00 | 0.92 | 9.92 | 4 |  | EST | 2026-11-10 | CR-C4-38 / D-70: two gauges on the fin proof article; read on the HX711 from G12 as a half bridge with two 350 ohm resistors (H1 confirms the amp). Pushes the NEW ground-test purchase to $26.00, above the D-39 $20 line: A1 decision; link: Eastar BF350-3AA 350 ohm foil gauge; CA adhesive not linked; representative product; any equivalent; link not opened; matched by search
TOTAL |  |  | Goods pre-tax, baseline |  |  |  |  |  |  |  |  |  | 1366.05
TOTAL |  |  | Sales tax 10.25 % |  |  |  |  |  |  |  |  |  | 140.02
TOTAL |  |  | Shipping, all vendors (ESTIMATE) |  |  |  |  |  |  |  |  |  | 120.00
TOTAL |  |  | FAA registration (not taxed) |  |  |  |  |  |  |  |  |  | 5.00
TOTAL |  |  | Lines marked GATED are excluded from every total below
TOTAL |  |  | Spend baseline |  |  |  |  |  |  |  |  |  | 1631.07
TOTAL |  |  | Spend pessimistic (list prices + adders 57) |  |  |  |  |  |  |  |  |  | 1716.28
TOTAL |  |  | Reserve baseline / pessimistic |  |  |  |  |  |  |  |  |  | 368.93 / 283.72
TOTAL |  |  | Reserve baseline / pessimistic if gated lines X07, X08 were also bought |  |  |  |  |  |  |  |  |  | 105.66 / 20.45
