davinciucberkeley-collab/DBF-Combined/redesign/subsystems/harness/parts.csv

part_id | name | qty | make_or_buy | process | material | mass_g | unit_cost_usd | vendor_or_file | notes
HRN-001 | Pod harness bundle (lumped) | 1 | make | cut, twist, solder, crimp | copper + silicone | 38.2 | 0 | subsystems/harness/WIRE-LIST.csv | every lead's pod run + GPS cable + JR row + GH plugs; position from interfaces.json
HRN-002 | Wing-fin harness bundle (lumped, per side; R and L differ) | 2 | make | cut, twist, solder, lay in grooves | copper + silicone | 44.42 | 0 | subsystems/harness/WIRE-LIST.csv | per unit = mean of R 44.7 g and L 44.2 g; instance masses in interfaces.json
HRN-101 | Silicone wire 16 AWG 252/0.08, red 3 m + black 3 m + yellow 1.5 m | 1 | buy | - | - | 0 | 14.0 | Amazon: BNTECHGO 16 AWG silicone wire, 10 ft per colour (red, black, yellow) | mass carried in HRN-001/002. Price EST, UNVERIFIED. ESC leads 4 x 2 conductors (2.32 m each colour) + phase extensions; replaces F1's 16 AWG line
HRN-104 | Silicone wire 28 AWG, 3 colours x 3 m | 1 | buy | - | - | 0 | 7.0 | Amazon: BNTECHGO 28 AWG silicone wire, 6-colour kit | mass carried in HRN-001/002. Price EST, UNVERIFIED. DShot pairs and pigtails
HRN-105 | JR/Futaba connector kit (male + female housings, crimp contacts), 10 sets | 1 | buy | - | - | 0 | 7.0 | Amazon: generic JR servo connector kit 2.54 mm (needs an open-barrel crimper, e.g. Engineer PA-09) | mass carried in HRN-001/002. Price EST, UNVERIFIED. 8 used: 6 tray in-line pairs, 2 wing-recess pairs (servo leads re-terminated); 2 spare
HRN-106 | JST-GH 1.25 mm housings GHR-04V-S (x4), GHR-06V-S (x4) + pre-crimped 28 AWG leads 150 mm (x20) | 1 | buy | - | - | 0 | 12.0 | DigiKey: JST GHR-04V-S, GHR-06V-S; pre-crimped GH leads (JST SSHL-002T-P0.2 contacts) | mass carried in HRN-001/002. Price EST, UNVERIFIED. no crimp tool needed: insert contacts; FC-side plugs usually come with the CoreWing kit (F3)
HRN-107 | Adhesive-lined heat-shrink 3:1 assortment (2.4-9.5 mm) | 1 | buy | - | - | 0 | 9.0 | Amazon: Wirefy 3:1 adhesive-lined heat-shrink assortment | mass carried in HRN-001/002. Price EST, UNVERIFIED. every solder joint and splice
HRN-108 | Cable ties 2.5 x 100 mm, 100 pack | 1 | buy | - | - | 0 | 4.0 | Amazon: generic nylon 66 ties 4 in | mass carried in HRN-001/002. Price EST, UNVERIFIED.
HRN-109 | PET expandable braided sleeve 6 mm, 2 m | 1 | buy | - | - | 0 | 6.0 | Amazon: Alex Tech 1/4 in PET braided sleeve | mass carried in HRN-001/002. Price EST, UNVERIFIED. exit and crossing chafe sleeves
HRN-110 | Fin-hole grommet ASA 10/7 x 12 mm (printed, G3) | 6 | make | - | - | 0 | 0.0 | subsystems/harness/BUILD.md | mass carried in HRN-001/002. Price EST, UNVERIFIED. 4 + 2 spare; D-83: 4 fitted drawn as parts HRN-110-UR/UL/LR/LL (0.5 g each EST)
HRN-111 | Straw liner 7 mm PP, 40 mm (P1 pass-through) | 2 | make | - | - | 0 | 0.0 | drinking straw | mass carried in HRN-001/002. Price EST, UNVERIFIED.
HRN-112 | Straw liner 4 mm PP, 15 mm (servo lead hole, CR-D1-06) | 2 | make | - | - | 0 | 0.0 | coffee stirrer straw | mass carried in HRN-001/002. Price EST, UNVERIFIED.
HRN-102 | Silicone wire 22 AWG, red + black 1.5 m each | 1 | buy | - | - | 0 | 4.0 | Amazon: BNTECHGO 22 AWG silicone wire, red/black 10 ft | mass carried in HRN-001/002. Price EST, UNVERIFIED. elevon servo + / - (FC pad -> wing recess, D-74 follow-up: 26 AWG gave 5.61 V at double stall); the signal core is 28 AWG from HRN-104
HRN-113 | Amass XT30U male + female pairs, 10-pair pack | 1 | buy | - | - | 0 | 9.99 | team/I1/BOM.csv#H06 (Amass XT30U, genuine, 2-pin, 20 A) | mass carried in HRN-001/002. Price EST, UNVERIFIED. D-74 / WB-03: 4 fitted as parts HRN-113-UR/UL/LR/LL (2.0 g each, drawn 20.1 x 10.2 x 5.2 mm): right pair stacked just inside the right exit, left pair stacked in the tunnel under the cradle; rest spares
HRN-114 | Male pin-header strip 1 x 40 (pitch per power BOARD-CHECK.md step 4) + 10-way 28 AWG ribbon 0.3 m | 1 | buy | - | - | 0 | 3.0 | any (DigiKey / Amazon); 1.27 mm pitch -> bought IDC ribbon instead | mass carried in HRN-001/002. Price EST, UNVERIFIED. W-PMOD board link, case S (D-74); not needed in case U; I1 to add to the BOM
