davinciucberkeley-collab/DBF-Combined/redesign/subsystems/power/parts.csv

part_id | name | qty | make_or_buy | process | material | mass_g | unit_cost_usd | vendor_or_file | notes
PWR-001 | Flight pack 4S 6500 mAh (re-terminated AS150U, own 10 AWG leads 0.10 m) | 1 | buy | re-terminate (solder AS150U pack half) | LiPo | 550.0 | 41.49 | team/I1/BOM.csv#P01 (Ovonic 4S 6500 130C 2-pack $82.97) | mass UNVERIFIED (listings 503-680 g, weigh on arrival); CG = pack centroid at the D-24 station; the body also shows the leads and the AS150U pack half
PWR-002 | Main disconnect AS150U aircraft half + two 10 AWG main jumpers | 1 | buy | solder, bond into PWR-006 | electronics (bought) | 18.6 | 5.0 | team/I1/BOM.csv#F01 (Amass AS150U pair) | AS150U half 9.0 g EST + 10 AWG jumpers 9.6 g (W-MAIN-1 0.030 m + W-MAIN-2 0.050 m, + and -); the wires are harness edges E-HRN-11/12, their mass is booked here (CR-F1-18)
PWR-003 | Power module: CoreWing F405 Wing V2 power board (V/I sense, servo BEC), separated from the FC stack | 1 | buy | separate from the stack, set the servo-BEC jumper to 6 V, foam-tape on PWR-006 | electronics (bought) | 28.0 | 0.0 | team/I1/BOM.csv#A01 (part of the CoreWing V2 stack, F3) | 90 A cont / 215 A peak sense, 64 A/V (CL-F3-SENSE-*; CoreWing manual V2.1); servo BEC 8 A cont / 14 A peak on the 6 V jumper feeds the elevon servos through the FC Vx rail (D-74, CL-F1-SERVO-BEC-RATING; Vx >= 5.8 V at BOARD-CHECK.md step 7); outline 52 x 32 mm (manual), M2 holes 30.5 x 26.5; drawn 52 mm pads-aft in keep-out KO-PWR-BOARD 56 x 34 x 24 mm (deck re-drawn to it, D-74), fits split (PDB alone) and whole stack (SPEC.md); height and link pitch measured at BOARD-CHECK.md; mass ~28 g EST (listing 11.4 g) moved from AVN-001 (F3 CR-F3-13, CR-F1-19)
PWR-004 | Bus board: FR4 strip with two tinned 8 AWG bus bars (+ / -) | 1 | make | shear FR4, file isolation slot, solder bars | FR4 + copper (made) | 8.8 | 3.0 | FR4 1 oz single-sided sheet + 8 AWG offcut (team/I1/BOM.csv#F02, F08 replaced) | 4 ESC pigtails (XT30U female at the pod side exits, D-74) and the main input solder to the bars on the bench; 36 x 16 mm between D2 boss rows
PWR-006 | Power frame: deck on 4 spacers (56 x 34 mm board seat = KO-PWR-BOARD), wire window, AS150U cradle, legs (printed PETG) | 1 | make | FDM PETG, deck flat on the bed | PETG (printed) | 8.06 | 1.5 | subsystems/power/fusion/power.py (export STL) | PETG 100 % (2 mm plates), 4 perimeters; screws, spacers, washers, tie and tape inside the mass; D-74: deck 42 -> 56 mm, fuse clip deleted [C6-HW] 1.64 g of fasteners now modelled as their own parts (team/C6/fastener_parts.py)
PWR-008 | ESC capacitor 680 uF 25 V low-ESR (UR/UL/LR/LL) | 4 | buy | solder at the ESC pads, foam-tape | electronics (bought) | 2.2 | 1.0 | team/I1/BOM.csv#F07 (x5, 1 spare) | one per ESC, leads <= 20 mm
PWR-101 | Power-frame screw set: 4 x M3x18 pan head, nylon PA66 | 1 | buy | - | nylon PA66 | 0.64 | 0.40 | any nylon M3 assortment (I1 C06) | [C6-HW] per set (one node per joint, CAD set of bodies; C6 FASTENERS-CAD); 4 fitted + 7 in I1 C06 (T-C6-NYLON-TORQUE, spares); 0.16 g each; 0.08 N m (1.6 N at 50 mm), no 243; mass moved out of PWR-006
PWR-102 | Power-frame spacer set: 4 x nylon spacer M3, 10 mm, OD 6 / ID 3.2 | 1 | buy | - | nylon PA66 | 0.92 | 0.40 | any (I1 C06) | [C6-HW] per set (one node per joint, CAD set of bodies; C6 FASTENERS-CAD); 4 fitted + 2 spare (I1 C06); 0.23 g each; mass moved out of PWR-006
PWR-103 | Power-frame washer set: 4 x M3 nylon washer 0.5 mm | 1 | buy | - | nylon PA66 | 0.08 | 0.08 | any (I1 C06) | [C6-HW] per set (one node per joint, CAD set of bodies; C6 FASTENERS-CAD); under the screw heads; 4 fitted + 2 spare (I1 C06); mass moved out of PWR-006
PWR-104 | Silicone wire 10 AWG red + black, 0.3 m each | 1 | buy | - | copper + silicone | 0 | 4.0 | team/I1/BOM.csv#F02 (replaces 8 AWG) | main jumpers; mass inside PWR-002
PWR-105 | FR4 sheet 1.6 mm, 1 oz copper one side, 100 x 70 mm | 1 | buy | - | FR4 | 0 | 3.0 | any | bus board; 3 boards per sheet
PWR-106 | Foam tape 3M VHB-class 1.1 mm, 25 mm wide | 1 | buy | - | acrylic foam | 0 | 0.0 | shared shop stock | power board, bus board, caps; mass inside each part
PWR-201 | Second flight pack (ground: charge / rotate; flight false) | 1 | buy | - | LiPo | 0 | 41.49 | team/I1/BOM.csv#P01 | not on the aircraft; 550 g in the LiPo bag, not in the flying roll-up
PWR-202 | AS150U-to-XT60 charge lead (built from F01 + H03) | 1 | make | solder | copper + PA | 0 | 0.0 | team/I1/BOM.csv#H03 | ground item; 6.5 A charge
PWR-107 | Power-frame insert set: 4 x M3 x 5.7 brass heat-set insert in POD-002 | 1 | buy | - | brass (CuZn39Pb3) | 1.6 | 0.60 | Ruthex-class RX-M3x5.7 (I1 C02) | [C6-HW] per set (one node per joint, CAD set of bodies; C6 FASTENERS-CAD); set at 230-245 C in D2's 7.2 mm bosses (bore 4.0 x 6.5); 0.40 g each EST; new mass (no part carried it before); 12 in I1 C02 incl. T-C6-INSERT coupons
