davinciucberkeley-collab/DBF-Combined/redesign/subsystems/wing/parts.csv

part_id | name | qty | make_or_buy | process | material | mass_g | unit_cost_usd | vendor_or_file | notes
WNG-001 | Wing core, one piece (XPS), with all cuts | 1 | make | hot-wire (templates from wing.py), slot and pockets by hot tool / knife | XPS foam F-250 | 201.9 | 15.99 | FOAMULAR NGX F-250 2 in sheet (SRC-XPS-F250), 6 cores per sheet | S5010, 1.150 x 0.320 m, hot-wired LE sanded smooth; spar bore 22.4 mm (slot from below, cap re-bonded); pod recess x 0.0226-0.065 floor z 0.015, |y| <= 0.07; pod saddle windows |y| 0.029-0.053 with tie channels at 0.036; anchor pockets |y| 0.2335-0.2505 top and bottom; block pockets |y| 0.302-0.338 x 0.028-0.097 full depth, corners R 3.15, 3 x 3 mm lip chamfers inboard and outboard both surfaces; ESC grooves both surfaces |y| 0.086-0.296; servo groove and branch with the JR recess x 0.150-0.168 |y| 0.280-0.290 5 mm deep; servo pockets (open below) x 0.1722-0.2075 |y| 0.2527-0.2879; elevon cut-outs with R 3 mm corners at the fin-root tabs; mass incl. the 15 g slot fill (C2); cost incl. the wing epoxy, microballoons and silica ($6.00, shared kit)
WNG-002 | Spar CF 22x20x1000 | 1 | buy | cut square, scuff 120 grit, IPA | CF tube 22x20 (bought) | 102.0 | 28.32 | SRC-CF-TUBE 22 x 20 x 1000 mm $28.32 | unspliced, |y| <= 0.50, axis x 0.080 z +0.0066 (D-03); stock length used as is
WNG-003 | Tape skin (packing tape, both surfaces, doublers, tip edge layer) | 1 | make | hand-laid spanwise strips, 10 % overlap | packing tape (BOPP), 48 mm | 47.9 | 15.66 | Scotch Heavy Duty packing tape 48 mm (cost.csv) | 1 layer each side; one 100 mm LE strip laid last (edges x 0.045 upper / 0.047 lower, aft of x/c 0.10); none under the pod (x 0-0.095, |y| <= 0.07) or the half-fin roots; 60 mm doublers over the block pockets (wrapped round the LE, continuous over the lip beads) and the servo pockets; 24 mm strip folded round each fin-root tab edge; 2nd layer folded round each tip
WNG-004 | Spar plug under the through-core block (PETG) | 2 | make | FDM PETG 4 perimeters 50 % gyroid | PETG (printed) | 7.0 | 0.25 | subsystems/wing/fusion/wing.py | D 19.8 x 36 mm inside the spar at |y| 0.320, bonded with thickened epoxy (C2 CR-C2-01); per-unit mass = mean of R 7.0 g, L 7.0 g
WNG-005 | Spar plug at the brace anchors (PETG) | 2 | make | FDM PETG 30 % fill | PETG (printed) | 4.0 | 0.25 | subsystems/wing/fusion/wing.py | D 19.8 x 20 mm inside the spar at |y| 0.242; upper and lower anchors share it; pushed in first; per-unit mass = mean of R 4.0 g, L 4.0 g
WNG-006 | Block-pocket lip beads (microballoon epoxy) | 2 | make | chamfer the pocket lip 3 x 3 mm 45 deg, fill wet with the block bond, sand flush | epoxy + glass microballoons 1:1 by volume | 1.0 | 0.00 | subsystems/wing/fusion/wing.py | inboard and outboard pocket lips, upper and lower, x 0.0279-0.0972 (D-68, CR-C2-11); 60 mm tape doubler over them; per-unit mass = mean of R 1.0 g, L 1.0 g
WNG-007 | Recess-step fillet (microballoon epoxy) | 1 | make | spatula fillet, cure 24 h, sand to a flat 45 deg face before the pod goes in | epoxy + glass microballoons 1:1 by volume | 1.1 | 0.00 | subsystems/wing/fusion/wing.py | floor-to-step corner at x 0.065, legs 5 mm floor x 5 mm step, |y| <= 0.070 (D-69, CR-C3-17); pod floor bevelled onto it
WNG-011 | Elevon inboard | 2 | make | cut from the core after the hot-wire pass; tape both faces | XPS foam F-250 + packing-tape skin | 3.7 | 0.00 | subsystems/wing/fusion/wing.py | y 0.071-0.299, hinge x 0.2496 on the upper skin, lower edge bevelled 30 deg; D6 torque-tube groove (open below) |y| 0.1335-0.296 and 2.5 mm horn-blade slot at y 0.285; outboard front corner relieved round the R 3 mm tab fill; tape cut back for the horn flange (14 mm) and backplate (12 mm); per-unit mass = mean of R 3.7 g, L 3.7 g
WNG-012 | Elevon outboard | 2 | make | cut from the core after the hot-wire pass; tape both faces | XPS foam F-250 + packing-tape skin | 3.5 | 0.00 | subsystems/wing/fusion/wing.py | y 0.341-0.559, hinge x 0.2496 on the upper skin, lower edge bevelled 30 deg; D6 torque-tube groove |y| 0.344-0.556 and 2.5 mm link-horn slot at y 0.355; inboard front corner relieved round the R 3 mm tab fill; tape cut back for the horn flange and backplate; per-unit mass = mean of R 3.5 g, L 3.5 g
WNG-020 | FAA registration label | 1 | make | print, laminate, apply | vinyl label (printed) | 0.5 | 1.00 | registration number from H3 (FAADroneZone) | right wing upper surface x 0.115-0.215, y 0.375-0.405; visible without tools
