davinciucberkeley-collab/DBF-Combined/redesign/subsystems/mechanisms/parts.csv

part_id | name | qty | make_or_buy | process | material | mass_g | unit_cost_usd | vendor_or_file | notes
MEC-001 | Elevon servo Savox SH-0255MG+ | 2 | buy | bought | servo (bought) | 15.8 | 41.99 | Savox SH-0255MG+ (SRC-D6-SH0255) | UNVERIFIED price (SRC-D6-SH0255-PRICE); 3.9 kgf cm at 6 V, 1.4 A stall; buy 3 (1 spare, I1)
MEC-002 | Servo arm, single, hole at 15.6 mm | 2 | buy | trim + drill | nylon (supplied with servo) | 0.6 | 0.0 | supplied with MEC-001; hole drilled 1.6 mm | supplied with the servo
MEC-003 | Pushrod 2-56 steel, Z-bend + steel clevis + keeper | 2 | buy | cut, Z-bend | steel (bought) | 1.58 | 2.5 | Du-Bro 2-56 threaded rod + 2-56 steel clevis (SRC-D6-CLEVIS) | per side: 1/3 of a 12 in 2-56 rod + 1 clevis + keeper; EST
MEC-004 | Control horn, inboard panel (clevis + rod boss) | 2 | make | FDM PETG 100 % | PETG (printed) | 3.2 | 0.2 | subsystems/mechanisms/fusion/mechanisms.py#build_horn | mass per unit EST; instances L R
MEC-005 | Inter-panel rod, 1/8 in pultruded CF | 2 | buy | cut 67 mm (abrasive disc), scuff | CF rod pultruded (bought) | 0.85 | 1.5 | 1/8 in (3.18 mm) pultruded carbon rod (SRC-D6-CFROD) | cut from one 1 m 1/8 in pultruded CF rod (EST $5/rod); D6-R2, was music wire
MEC-006 | Link horn, outboard panel (rod boss) | 2 | make | FDM PETG 100 % | PETG (printed) | 2.95 | 0.2 | subsystems/mechanisms/fusion/mechanisms.py#build_horn | mass per unit EST; instances L R
MEC-007 | Servo cover with arm slot | 2 | make | FDM PETG | PETG (printed) | 1.53 | 0.1 | subsystems/mechanisms/fusion/mechanisms.py#build_cover | mass per unit EST; instances L R [C6-HW] 0.20 g of fasteners now modelled as their own parts (team/C6/fastener_parts.py)
MEC-008 | Servo frame (ear slots, cover bosses) | 2 | make | FDM PETG | PETG (printed) | 3.19 | 0.2 | subsystems/mechanisms/fusion/mechanisms.py#build_frame | mass per unit EST; instances L R
MEC-009 | Elevon torque tube CF 5 x 4 mm | 4 | buy | cut, scuff | CF tube 5x4 roll-wrapped (bought) | 2.58 | 2.0 | CF tube 5 x 4 x 1000 mm (SRC-D6-CFTUBE) | cut from one 1 m tube (EST $8): 2 x 0.210 m outboard + 2 x 0.160 m inboard
MEC-010 | Elevon hinge tape, two strips | 2 | buy | cut | packing tape BOPP | 0.57 | 0.2 | clear packing tape 48 mm, slit to 25 mm | from the wing tape roll
MEC-011 | Servo cover screw pair: 2 x M2 x 6 self-tapping pan head A2 | 2 | buy | - | A2 stainless | 0.4 | 0.30 | supplied with the servo if 6 mm, else I1 H02 (M2 x 6 self-tapping) | [C6-HW] per set (one node per joint, CAD set of bodies; C6 FASTENERS-CAD); closes E-MEC-35/36 and holds the servo in its ear slots (E-MEC-03/04, FIX 1); 1.6 mm pilot 6 mm deep, snug; 0.2 g each (was booked 0.1 g each in MEC-007); D-58 b
MEC-012 | Servo arm screw: M2 x 4 pan head (supplied with MEC-001) | 2 | buy | - | A2 stainless | 0.17 | 0.00 | supplied with MEC-001 | [C6-HW] per set (one node per joint, CAD set of bodies; C6 FASTENERS-CAD); Loctite 222; new mass (no part carried it before)
