davinciucberkeley-collab/DBF-Combined/redesign/subsystems/fins/parts.csv

part_id | name | qty | make_or_buy | process | material | mass_g | unit_cost_usd | vendor_or_file | notes
FIN-001 | Half-fin, two-layer foam board (UR/UL/LR/LL) | 4 | make | laminate + knife cut | foam board 4.8 mm x 2, paper faced, laminated | 25.96 | 0.4 | Dollar Tree / Adams foam board 20 x 30 in, $1.25 (SRC-K09-CARD) | two 4.8 mm boards spray-laminated (D-26), knife-cut together from the DXF of this outline (notch for the collar tongue, D5 stepped 45.4 mm tip); LE butts the tube; root fillets are microballoon epoxy (BUILD step 11); per-unit mass = mean of UR 25.60 g, UL 25.60 g, LR 26.33 g, LL 26.33 g
FIN-002 | Motor tube CF 22x20, 344 mm | 2 | buy | cut (fine-tooth saw, tape-wrapped) | CF tube 22x20 (bought) | 35.09 | 14.16 | SRC-CF-TUBE 22 x 20 x 1000 mm $28.32, two tubes per stock length (I1 fixes the listing) | two per 1 000 mm stock length; scuff the bond zones (block, collars) with 120 grit; per-unit mass = mean of R 35.09 g, L 35.09 g
FIN-003 | Motor mount ASA, 7 deg canted plate, slip clamp (prints A and B) | 4 | make | 3D print + drill | ASA (printed) | 9.99 | 0.4 | fusion/fins.py (Fusion export STL), ASA ~$25/kg (D-42) | ASA (D-42), 0.2 mm layers, 5 perimeters, enclosed printer; collar axis vertical on the bed; slit + ears outboard; A = UR/LL, B = UL/LR (mirror); drill the motor holes 3.4 mm through the pilots to the measured pattern; plate face 7.5 mm ahead of the collar front, cheeks 17 mm (D-61); per-unit mass = mean of UR 11.39 g, UL 11.39 g, LR 11.39 g, LL 11.39 g [C6-HW] 1.40 g of fasteners now modelled as their own parts (team/C6/fastener_parts.py)
FIN-004 | Through-core block (tube socket + spar saddle + strap eyes) | 2 | make | 3D print | PETG (printed) | 40.87 | 0.7 | fusion/fins.py, PETG | PETG, 3 perimeters, 15 % gyroid, spar bore horizontal on the bed; sand the socket top/bottom flush; strap eyes print with it; four vertical plan-form edges R 3 mm (D-68) to match the R 3 mm pocket corners; per-unit mass = mean of R 40.87 g, L 40.87 g
FIN-006 | Tube plug CF 20x18 x 53 mm | 2 | buy | cut + sand | CF tube 20x18 (bought) | 5.45 | 1.06 | CF tube 20 x 18 x 1000 mm, $20 per metre (I1 D03): one length gives both FIN-006 plugs (2 x 53 mm) and C2 six 36 mm spar plugs (216 mm) with ~0.65 m spare (CR-I1-17); cost = 53 mm share | CF 20 x 18 offcut, 53 mm, sanded to slide in the 20 mm bore, laminating epoxy; per-unit mass = mean of R 5.45 g, L 5.45 g
FIN-007 | ESC pad, ASA | 4 | make | 3D print | ASA (printed) | 2.04 | 0.05 | fusion/fins.py, ASA (D-42) | ASA 1.2 mm, 100 % (D-42); two strap slots, matching slots knifed through the laminate; per-unit mass = mean of UR 2.04 g, UL 2.04 g, LR 2.04 g, LL 2.04 g
FIN-008 | Station collar, 15 mm + 40 mm two-face tail | 4 | make | 3D print | PETG (printed) | 10.5 | 0.15 | fusion/fins.py, PETG | PETG, 100 %, printed upside down on the tail cap (slots open upward on the bed); 15 mm ring (CR-C6-36), 40 mm two-face tail, brace ear inboard; phase tie lug at x 0.060, slot open along x (CR-F2-16); per-unit mass = mean of UR 10.50 g, UL 10.50 g, LR 10.50 g, LL 10.50 g
FIN-009 | Brace, CF strip 10 x 2 (C4 CR-C4-16) | 4 | buy | cut | CF strip, pultruded (bought) | 5.15 | 2.0 | pultruded CF strip 10 x 2 x 1000 mm, ~$10 per length, 4 braces per length UNVERIFIED (I1, CR-D3-09) | pultruded CF strip 10 x 2 mm, cut to length on the jig, ends scuffed; per-unit mass = mean of UR 4.96 g, UL 4.96 g, LR 5.35 g, LL 5.35 g
FIN-010 | Brace anchor on the spar | 4 | make | 3D print | PETG (printed) | 3.17 | 0.1 | fusion/fins.py, PETG | PETG, 80 %, brace slot vertical on the bed; foot sits on the spar through a core pocket; per-unit mass = mean of UR 3.24 g, UL 3.24 g, LR 3.09 g, LL 3.09 g
FIN-011 | Edge strip, CF 10 x 1 | 8 | buy | cut | CF strip, pultruded (bought) | 3.87 | 2.0 | pultruded CF strip 10 x 1 x 1000 mm, ~$6 per length, 4 strips per length UNVERIFIED (I1, CR-D3-09) | pultruded CF strip 10 x 1 mm, cut to the template, one per laminate face, ends at the step front x 0.2746; per-unit mass = mean of URO 3.87 g, URI 3.87 g, ULO 3.87 g, ULI 3.87 g, LRO 3.87 g, LRI 3.87 g, LLO 3.87 g, LLI 3.87 g
FIN-012 | Edge-strip pin set, CF rod 2.5 mm | 4 | buy | cut + drill + bond | CF rod 2.5 mm, pultruded (bought) | 1.37 | 0.75 | pultruded CF rod 2.5 x 1000 mm, ~$4, one rod makes all four pin sets UNVERIFIED (I1) | pultruded CF rod 2.5 mm cut to 12 mm (D-70); 2.5 mm drill through strip-laminate-strip after cure, epoxy injected before the pin, sanded flush; per-unit mass = mean of UR 1.37 g, UL 1.37 g, LR 1.37 g, LL 1.37 g
FIN-101 | Pinch bolt: M3x16 SHCS ISO 4762 A2 | 4 | buy | - | A2 stainless | 1.1 | 0.10 | Bolt Depot (I1 C01) | [C6-HW] per set (one node per joint, CAD set of bodies; C6 FASTENERS-CAD); 4 fitted + 2 spare (I1 C01); ISO 4762 M3x16 1.1 g (was booked 1.0 g in FIN-003 mount.hardware_g)
FIN-102 | Pinch-bolt nut: M3 nyloc ISO 10511 A2 | 4 | buy | - | A2 stainless | 0.36 | 0.05 | Bolt Depot (I1 C01) | [C6-HW] per set (one node per joint, CAD set of bodies; C6 FASTENERS-CAD); 4 fitted + 4 spare (I1 C01); reuse <= 3 times; DIN 985 / ISO 10511 M3 0.36 g
FIN-103 | Pinch-bolt washer pair: 2 x M3 ISO 7089 A2 | 4 | buy | - | A2 stainless | 0.24 | 0.06 | Bolt Depot (I1 C01) | [C6-HW] per set (one node per joint, CAD set of bodies; C6 FASTENERS-CAD); one under the head, one under the nyloc; 8 fitted + 4 spare (I1 C01); ISO 7089 M3 0.12 g each
FIN-104 | Hook-and-loop strap 10 x 200 mm + 25 x 40 mm tape | 4 | buy | - | nylon | 0 | 0.4 | any (Velcro ONE-WRAP class) | ESC retention, one strap per ESC (E-FIN-65...68, CR-E3-02); mass with the ESC (propulsion)
FIN-105 | 30 min epoxy + glass microballoons + colloidal silica (consumable) | 1 | buy | - | epoxy | 0 | 0.0 | shared shop stock (G2) | mass inside the bonded parts
FIN-106 | Spray adhesive 3M 77 class (consumable) | 1 | buy | - | - | 0 | 0.0 | shared shop stock (G2) | laminates the two board layers (D-26); mass inside FIN-001 (fin.adhesive_kgm2)
FIN-107 | Loctite 243 (consumable) | 1 | buy | - | - | 0 | 0.0 | shared shop stock (G2) | motor screws, tip only (E-FIN-61...64)
