davinciucberkeley-collab/DBF-Combined/redesign/subsystems/landing/parts.csv

part_id | name | qty | make_or_buy | process | material | mass_g | unit_cost_usd | vendor_or_file | notes
GER-001 | Foot shoe (UR UL LR LL) | 4 | make | FDM print, PETG, 0.2 mm layers, standing on the rim end (layers stacked along the sleeve axis, CR-C5-18), 1.2 mm walls = 3 perimeters, 100 % solid, R 1 inside fillets from the model; supports only under the leg ends at the TE | PETG (printed) | 9.93 | 0.1 | subsystems/landing/fusion/landing.py (export body GER-001-UR; one part for all four) | sleeve 19.1 x 14.4 mm, 1.2 mm walls with R 1.0 inside fillets, short snap windows, on the half-fin TE step; back wall on the step front and strip end faces, legs 7 mm down both faces, 8 mm collar cheeks over the edge-strip ends, 3.4 mm rim at the sleeve end (R6, CR-C5-18); permanent; includes 0.35 g epoxy; mass per unit, EST from CALC-D5-MASS
GER-002 | Foot piston (UR UL LR LL) | 4 | make | FDM print, PETG, 0.2 mm layers, flange on the bed, 2 perimeters, slots and hook ramps from the model | PETG (printed) | 3.28 | 0.08 | subsystems/landing/fusion/landing.py (export GER-002-UR; print 2 orange + 2 blue) | tine 16.3 x 11.6 mm (1 mm corner chamfers), 25 mm engaged at rest, two 6.5 mm snap fingers with ramped hooks, stop flange, inspection windows, replace-mark groove; ORANGE on UR/UL, BLUE on LR/LL; slides 38 mm into the shoe when the cartridge crushes; mass per unit, EST from CALC-D5-MASS
GER-003 | Crush cartridge type U (solid) (UR UL) | 2 | make | cut from 2 in F-400 (D-76): 14.5 x 9.8 mm sticks across the thickness, 35.0 mm long (3 per foot), each pressed 1 mm to 34.0 mm | XPS foam FOAMULAR 400 (cut, D-76) | 0.51 | 0.0 | wing-core offcut, knife cut (BUILD.md step 4) | 3 segments 34.0 mm long, 14.5 x 9.8 mm, each pre-crushed 1 mm (cut 35.0 mm), crush axis = board thickness, orange stripe; plateau 39.2 N; bonded on the piston floor; consumable; mass per unit, EST from CALC-D5-MASS
GER-004 | Foot pad (UR UL LR LL) | 4 | make | scissors/knife from sheet, 19.1 x 17.8 mm, 1 mm corner round | neoprene 40A 1/16 in, adhesive back (bought sheet, cut) | 0.71 | 0.25 | from GER-006 sheet | ground contact 19.1 x 17.8 mm, mu >= 0.7 (CR-C1-02); outboard edge at z +/-0.219 (contact 0.218); mass per unit, EST from CALC-D5-MASS
GER-007 | Wingtip TE corner cap (R L) | 2 | make | FDM print, TPU 95A, 2 perimeters, open side up | TPU (printed) | 0.73 | 0.03 | subsystems/landing/fusion/landing.py (export GER-007-R, mirror for L) | TPU 95A U-cap over the fixed wingtip TE corner (y 0.5615-0.575) + tip wall, held by 2 wraps of 12 mm filament tape (CR-C5-04); includes 0.10 g tape; mass per unit, EST from CALC-D5-MASS
GER-008 | Crush cartridge type L (bored) (LR LL) | 2 | make | as GER-003, then a 3.97 mm axial bore with a sharpened 5/32 in K&S brass tube (before pressing) | XPS foam FOAMULAR 400 (cut, D-76) | 0.47 | 0.0 | wing-core offcut, knife cut + brass-tube bore (BUILD.md step 4) | type U with a 3.97 mm axial bore (sharpened 5/32 in brass tube), pre-crushed, blue stripe; plateau 35.8 N; bonded on the piston floor; consumable; mass per unit, EST from CALC-D5-MASS
GER-005 | Spare insert, upper (orange piston + type-U cartridge + pad, pre-glued) | 4 | make | as GER-002/003/004 | PETG / XPS / neoprene | 4.5 | 0.35 | field kit | ground spare, not flying
GER-009 | Spare insert, lower (blue piston + type-L cartridge + pad, pre-glued) | 4 | make | as GER-002/008/004 | PETG / XPS / neoprene | 4.46 | 0.35 | field kit | ground spare, not flying
GER-010 | Spare cartridge pair type U, loose (orange stripe) | 16 | make | as GER-003 | XPS F-400 | 0.51 | 0.0 | field kit | ground spare, not flying (C5 CR-C5-06: 16 per type)
GER-011 | Spare cartridge pair type L, loose (blue stripe) | 16 | make | as GER-008 | XPS F-400 | 0.47 | 0.0 | field kit | ground spare, not flying (C5 CR-C5-06: 16 per type)
GER-012 | Spare shoe | 2 | make | as GER-001 | PETG (printed) | 9.58 | 0.1 | field kit | ground spare, not flying
GER-006 | Neoprene sheet 1/16 in 40A adhesive back 12 x 12 in | 1 | buy | bought | neoprene 40A | 193.2 | 12.0 | SRC-D5-NEOPRENE (UNVERIFIED price) | stock for GER-004 and spares; not flying (whole-sheet mass; flying pads are counted in GER-004)
GER-013 | Brass tube 5/32 in OD (K&S), sharpened, cartridge bore cutter | 1 | buy | bought | brass | 10.5 | 3.0 | hobby shop, K&S 5/32 in round tube (UNVERIFIED price) | shop tool, not flying
