davinciucberkeley-collab/DBF-Combined/redesign/subsystems/ground/parts.csv

part_id | name | qty | make_or_buy | process | material | mass_g | unit_cost_usd | vendor_or_file | notes
GND-001 | RC transmitter RadioMaster Pocket (Crush), internal ELRS 2.4 GHz FCC, with 2 x 18650 cells | 1 | buy | bought; ELRS 3.x FCC domain, EdgeTX model K09L (model match on) | electronics (bought) | 330.0 | 89.48 | RadioMaster (I1 BOM R01) + GetFPV 18650 2-pack (R02) | flight: false; radio link E-AVN-09 to AVN-003 (declared by avionics, acknowledged here); 25-250 mW, flown at 100 mW fixed, range check at 25 mW (T-F5-RANGE); no electrical role (battery inside, no harness wire); mass about 0.33 kg incl. cells: seller figure, UNVERIFIED, weigh on arrival (T-F5-BENCH)
