davinciucberkeley-collab/DBF-Combined/redesign/subsystems/avionics/parts.csv

part_id | name | qty | make_or_buy | process | material | mass_g | unit_cost_usd | vendor_or_file | notes
AVN-001 | Flight controller CoreWing F405 Wing APP V2 | 1 | buy | bought; 100 mm signal pigtails soldered | electronics (bought) | 12.0 | 67.26 | ReadyMadeRC (I1 BOM A01) | FC top board + wireless app board (stable ArduPilot Plane 4.7.x, target CoreWingF405WingV2, Q_TAILSIT_ENABLE 1); flat, arrow -x (AHRS_ORIENTATION 0); the power board of the stack is PWR-003 on the PDB plate (price shared) (mass EST until weighed, T-F3-ARRIVAL)
AVN-002 | GPS + compass HGLRC M100-5883 | 1 | buy | bought | electronics (bought) | 7.73 | 20.49 | getfpv.com / RaceDayQuads (I1 BOM A02) | u-blox M10 + QMC5883 compass; 21 x 21 x 8 mm, 7.73 g; on the 45 deg mast pad, arrow toward the nose; no steel within 50 mm (mass EST until weighed, T-F3-ARRIVAL)
AVN-003 | RC receiver RadioMaster RP3 V2 (ELRS 2.4 GHz) | 1 | buy | bought; FCC firmware flashed | electronics (bought) | 4.6 | 19.99 | RadioMaster dealer (I1 BOM A03) | 22 x 13 x 4 mm, 4.6 g with two U.FL antennas; CRSF on SERIAL6; telemetry over the same link (no separate radio) (mass EST until weighed, T-F3-ARRIVAL)
AVN-004 | Airspeed sensor MS4525DO (I2C 0x28) | 1 | buy | bought; 2 silicone lines cut to 40 mm | electronics (bought) | 4.51 | 59.99 | ReadyMadeRC digital airspeed sensor (I1 BOM A04) | RMRC board 20 x 21 x 13 mm, 3.5 g, ports up, between the tray tie posts; I2C1 0x28 (ARSPD_TYPE 1); replaces the MS5525 (0x76 clashes with the baro) (mass EST until weighed, T-F3-ARRIVAL)
AVN-005 | Pitot boom (plug-in): pitot-static probe in a printed keyed sleeve | 1 | make | FDM PETG sleeve (100 % infill), probe bonded with 5 min epoxy | PETG (printed) + aluminium probe | 4.84 | 0.50 | subsystems/avionics/fusion/avionics.py; probe in BOM A04 kit | tip at params avionics.pitot_tip_xyz_m; 6 mm sleeve with a 5.6 mm key flat on +z and a 10 mm shoulder on the socket collar; 2 barbed couplers on the probe root barbs part when the boom is pulled; removed for transport (mass EST until weighed, T-F3-ARRIVAL)
AVN-006 | Isolation and retention set: 4 gel cubes, foam tape, ties, FC strap | 1 | buy | cut 5 mm cubes from gel sheet; tape and ties from shop stock | silicone gel + consumables | 2.4 | 3.00 | Kyosho Zeal / alpha-gel 5 mm sheet; 3M VHB-class tape | gel cubes under the FC corners (f_n ~ 36 Hz); 1 mm foam tape under GPS, RX, airspeed board; 3 ties; 10 mm hook-and-loop strap over the FC with 1-2 mm slack (C6 secondary retention) (mass EST until weighed, T-F3-ARRIVAL)
AVN-007 | microSD 16-32 GB (logging) | 1 | buy | bought; FAT32 | electronics (bought) | 0.4 | 0.00 | team stock (else ~$6) | SDHC class 10; LOG_BITMASK default + batch sampler for T-F3-VIBE (mass EST until weighed, T-F3-ARRIVAL)
