davinciucberkeley-collab/DBF-Combined/analysis/benchmarks/aircraft.csv

name | configuration | source_url | date_checked | mtow_kg | empty_mass_kg | payload_kg | wingspan_m | wing_area_m2 | length_m | cruise_speed_ms | max_speed_ms | stall_speed_ms | endurance_min | endurance_condition | range_km | battery | battery_mass_kg | n_lift_rotors | lift_prop_in | lift_motor | cruise_prop_motor | hover_limits | price_usd | wing_loading_kgm2_DERIVED | disk_loading_Nm2_DERIVED | battery_Wh_DERIVED | battery_Wh_per_kg_MTOW_DERIVED | aspect_ratio_DERIVED | battery_mass_fraction_DERIVED | payload_fraction_DERIVED | W_V_over_P_DERIVED | notes
C0 (this project; design, not built) | Lift+cruise quadplane (4 lift + 1 pusher) | caller brief (repo analysis) | 2026-10-26 | 6.55 | — | 0.50 | 2.400 | 0.682 | — | 20.0 | — | 11.75 | 13 | mission 120 s hover + 600 s cruise + 40 s transition, 20% reserve (design) | — | 2x 6S 6500 mAh LiPo | 0.82 | 4 | 17.0 | — | — | — | $2,000 total budget cap | 9.6 | 110 | 144 | 22 | 8.45 | 0.13 | 0.08 | 3.8 | Reference row. Predicted L/D 7.46, CD0 0.0445 (clean 0.0266), cruise 338 W, hover 916 W (FM 0.52 assumed). Empty mass not given; MTOW-battery-payload = 5.23 kg (derived). W*V/P from 338 W cruise.
DeltaQuad Evo | Lift+cruise quadplane (flying wing, 4 lift + pusher) | https://docs.deltaquad.com/evo/vehicle-specifications | 2026-10-26 | 10.00 | 4.80 | 1.00–3.00 | 2.690 | 0.840 | 0.750 | 16.5 | — | — | 272 | dual battery, 90% battery use, low wind, sea level, low-altitude VTOL (manufacturer) | 270 | 2x 6S 22 Ah semi-solid-state Li-ion (Wh not published) | 4.00 | 4 | — | — | — | — | — | 11.9 | — | 977 | 98 | 8.61 | 0.40 | 0.10–0.30 | 8.4 | Payload 3 kg single battery, 1 kg dual. Empty incl. 1 battery 6.8 kg -> battery ~2.0 kg each (derived). Wh assumes 3.7 V/cell nominal (estimate). W*V/P uses MTOW 10 kg, 90% of est. 977 Wh over 272 min; marketing best case. Tolerances 'provisional'.
DeltaQuad Pro #CARGO | Lift+cruise quadplane (flying wing, 4 lift + pusher) | https://www.deltaquad.com/cargo (official page in search index; returned 404 on direct fetch 2026-10-26) | 2026-10-26 | 6.20 | — | 1.20 | 2.350 | 0.900 | 0.900 | — | — | — | 110–165 | 2+ h no payload; 1 h 50 at 1 kg payload; 2 h 45 with auxiliary LiPo and 400 g payload (manufacturer) | 150 | — | — | 4 | — | — | — | — | — | 6.9 | — | — | — | 6.14 | — | 0.19 | — | Discontinued predecessor of Evo. Range 150 km from 2017 launch article (unmannedsystemstechnology.com, 403 on fetch). Values via search-index snippet of official page: medium confidence.
Foxtech Baby Shark 260 VTOL | Lift+cruise quadplane (4 lift + pusher) | https://www.suasnews.com/2019/01/foxtech-baby-shark-260-vtol/ | 2026-10-26 | 12.00 | 5.50 | 6.50 | 2.500 | — | — | — | 27.8 | 15.00–16.00 | 150 | 'Max flight time 2.5 hours', no conditions (manufacturer); a used-unit seller on discuss.ardupilot.org reports max ~30 min flown | — | suggested 2x 6S 5000 mAh LiPo (lift) + 6S 30000-40000 mAh Li-ion (cruise) | — | 4 | 16.5 | 4x T-motor MN505 KV260, 60 A ESC | 4120 KV500, 15x8 wood prop, 100 A ESC | — | — | — | 213 | 888–1110 | 74–93 | — | — | 0.54 | — | Empty = 'total weight 5.5 kg without battery'; frame 2.68 kg. Max payload 6.5 kg INCLUDES battery. Wh from suggested packs at 3.7 V/cell (estimate). 2.5 h is marketing.
Foxtech Loong 2160 VTOL | Lift+cruise quadplane (4 lift + tractor 'puller') | https://docs.px4.io/main/en/frames_vtol/vtol_quadplane_foxtech_loong_2160.html | 2026-10-26 | 7.00–8.50 | — | 1.50 | 2.160 | — | 1.200 | 17.0 | — | — | 90 | 'up to 1 h 30 min depending on weather and takeoff weight' (PX4 docs) | — | recommended 12S 22 Ah (linked product named 6S 22000 mAh - conflict) | — | 4 | — | — | — | hover current up to 120 A on 12S power module | — | — | — | 488–977 | 57–140 | — | — | 0.18–0.21 | — | '~7 kg takeoff weight excluding payload'; MTOW range = 7 to 7+1.5 kg payload (derived). Battery voltage ambiguous so Wh range spans 6S-12S.
MakeFlyEasy Fighter VTOL | Lift+cruise quadplane (4+1) | https://ardupilot.org/plane/docs/common-makeflyeasy-fighter-vtol.html | 2026-10-26 | 11.50 | — | 2.50 | 2.430 | 0.725 | 1.450 | 17.0–20.0 | — | 10.00 | — | — | 150 | — | — | 4 | — | — | — | — | — | 15.9 | — | — | — | 8.14 | — | 0.22 | — | Range 150 km at 600 g load. 4+1 per zbotic.in retailer. Stall 10 m/s at MTOW wing loading 15.9 kg/m2 implies CLmax ~2.5 -> almost certainly not at MTOW / marketing.
MakeFlyEasy Striver Mini VTOL | Lift+cruise quadplane (4+1) | https://ardupilot.org/plane/docs/common-makeflyeasy-striver-mini-vtol.html | 2026-10-26 | 7.50 | — | 1.00 | 2.100 | 0.590 | 1.200 | 18.0–21.0 | — | — | 107 | 19 m/s, 600 g load, 6S 22000 mAh, 6.8 kg takeoff, (manufacturer test) | 115 | 6S 22000 mAh (test condition) | — | 4 | — | — | — | — | — | 11.5 | — | 488 | 72 | 7.47 | — | 0.13 | 5.1 | MTOW listed as '<7.5 kg'. Wh assumes 3.7 V/cell (Li-ion type implied, estimate). W*V/P at 6.8 kg, 90% usable energy assumed. Wh/kg uses the 6.8 kg test mass.
MakeFlyEasy Freeman 2300 VTOL | Lift+cruise quadplane (4+1) | https://rcdrone.top/products/makeflyeasy-freeman-2300-rc-plane (403 on direct fetch; values from search summary) | 2026-10-26 | 8.00 | — | 1.00 | 2.300 | — | 1.070 | 18.1 | — | — | 80 | claimed; 80 km range with 1000 g load (retailer) | 80 | — | — | 4 | — | — | — | — | — | — | — | — | — | — | — | 0.12 | — | Retailer listing only; low confidence. Length is fuselage.
JOUAV CW-007 | Fixed-wing VTOL (subtype not stated by maker; lift+cruise assumed - verify) | https://jouav.com/products/cw-007.html | 2026-10-26 | 6.80 | — | 1.00 | 2.200 | — | 1.300 | 17.0 | — | — | 55 | max flight time; 'theoretical values from lab tests' (manufacturer) | — | battery (unspecified) | — | — | — | — | — | wind limit takeoff/landing 10 m/s | — | — | — | — | — | — | — | 0.15 | — | Length is fuselage. Configuration not explicitly stated on page.
JOUAV CW-10 | Lift+cruise ('fixed wing and quadrotor hybrid') | https://www.vision-systems.com/embedded/article/16750971/uav-with-fixed-wing-and-quadrotor-hybrid-design-to-be-shown-at-xponential | 2026-10-26 | — | — | 1.00–2.00 | 2.591 | — | — | 19.7 | 30.0 | — | 90 | 'up to 90 minutes' (2017 trade-show article) | — | — | — | 4 | — | — | — | — | — | — | — | — | — | — | — | — | — | 2017 article; payload 2.2-4.4 lb. MTOW not published. Possibly superseded model.
JOUAV CW-20E | Fixed-wing VTOL (lift+cruise family; subtype not stated on page) | https://www.jouav.com/flightSystem/cw-25e.html | 2026-10-26 | 24.90 | — | 5.00–6.00 | 3.500 | — | 2.070 | 20.0 | — | — | 150–180 | 150 min spec table; 180 min with 2 kg payload in overview (conflict) | — | — | — | — | — | — | — | — | — | — | — | — | — | — | — | 0.20–0.24 | — | Upper end of size range; payload 5 vs 6 kg conflict on same page.
Avy Aera | Lift+cruise (4 VTOL motors + pusher) | https://avy.eu/product/aera | 2026-10-26 | 19.50 | — | 2.00–3.00 | 2.400 | — | 1.500 | 23.0 | 38.9 | — | 60–75 | standard battery: 60 min spec table vs 75 min text (conflict); extended 100-120 min | 80–130 | 1 kWh smart battery | — | 4 | — | — | — | — | — | — | — | 1000 | 51 | — | — | 0.10–0.15 | 6.1 | Span taken from 'W' of 1500x2400x300 L×W×H (inferred). Max speed 140 km/h from avy.eu/discover. W*V/P: MTOW, 115 km range at MTOW, 23 m/s, all 1000 Wh used (upper-bound estimate).
ALTI Transition (hybrid) | Lift+cruise quadplane, petrol pusher + electric lift (hybrid) | https://www.ust-media.com/ust-magazine/UST008/files/assets/basic-html/page-23.html | 2026-10-26 | 12.00 | — | 2.00 | 2.745 | — | 1.925 | — | 30.0 | — | 240–360 | 4-6 h wing-borne, still being tested (magazine profile); later claims 8-12 h | 300 | battery for VTOL only; petrol cruise | — | 4 | — | custom Al/steel motors | petrol engine, pusher | — | — | — | — | — | — | — | — | 0.17 | — | Fuel cruise - endurance not comparable to battery aircraft. Later article cites 16 kg MTOW (conflict).
Mugin-2 Pro 2930 VTOL | Lift+cruise quadplane, gasoline cruise + electric lift (hybrid) | https://www.muginuav.com/product/mugin-2-pro/ | 2026-10-26 | 23.00 | — | 3.00 | 2.930 | 0.970 | 2.021 | 21.0–23.0 | — | 18.00 | 120–300 | 2 h at 3 kg/2.5 L fuel; 4.5 h at 1 kg/5 L; 'up to 5 h' (manufacturer) | — | VTOL battery unspecified; 5 L fuel | — | — | — | — | gasoline engine | — | — | 23.7 | — | — | — | 8.85 | — | 0.13 | — | Length from unlabeled overall dims. Search snippet of an older page gave 100.85 dm2 / 7.8 kg empty / 5 kg payload (conflict).
Skywalker X8 quadplane (ArduPilot 'Tale of Two Quadplanes') | Lift+cruise quadplane conversion (flying wing, 4 lift + pusher) | https://discuss.ardupilot.org/t/a-tale-of-two-quadplanes/18856 | 2026-10-26 | 5.10 | — | — | — | — | — | — | — | — | 25 | rough calculation, not measured (builder) | — | 2x 4S 5800 mAh LiPo parallel | — | 4 | 14.0 | 4x T-Motor 3510-13 700 kV, 40 A ESC | SK3 40xx, 13x8.5 prop, 85 A ESC | measured hover up to 60 A (~888 W at 14.8 V nominal, derived); transition spikes >90 A | — | — | 126 | 172 | 34 | — | — | — | — | Hobby build, measured currents (approximate - one pack metered). Cruise ~10 A measured after prop change (~148 W derived), speed not stated. Hover W/kg ~174 (derived).
Skywalker X8 quadplane (ArduPilot 'Build 4') | Lift+cruise quadplane conversion (flying wing, lift + pusher) | https://discuss.ardupilot.org/t/skywalker-x8-quadplane-build-4/42083 | 2026-10-26 | 7.00 | 5.00 | — | — | 0.960 | — | 17.0 | — | — | 5–60 | ~5 min on vertical battery (test); up to ~60 min with 2 forward packs (unverified) | 60 | 4S 5000 mAh (lift) + 1-2x 4S 8000 mAh (cruise) | — | 4 | 12.0–13.0 | SunnySky 3120-1100 kV (count not stated) | SK3 4240-740 kV, 13x8 | measured 60 A hover, 90 A peak (~888 W at 14.8 V, derived) | — | 7.3 | 200–235 | 192–311 | 27–44 | — | — | — | 7.9 | Measured: <10 A cruise at 17 m/s airspeed (W*V/P is upper bound since <10 A). Lift prop 12x4.8 vs 13 in conflict; 4 lift motors assumed. Area 96 dm2 with wing extensions. Range estimated.
U. Michigan QuadPlane (Mathur & Atkins, arXiv 2301.12316) | Lift+cruise quadplane (4 vertical pushers + tractor), academic | https://arxiv.org/html/2301.12316v1 | 2026-10-26 | 1.68 | — | — | 1.219 | 0.186 | — | — | — | 10.09 | — | — | — | 4S 2650 mAh LiPo | — | 4 | 9.5 | 920 kV, 30 A ESC | 920 kV, 9.5x4.5 | — | — | 9.1 | 90 | 39 | 23 | 8.00 | — | — | — | Below 3 kg target range; included for wind-tunnel-measured aero (paper reports increased drag/reduced thrust from rotor-wing interaction). Area = span x 6 in chord (derived). AR 8 stated.
Wingcopter 178 Heavy Lift (delivery) | CONTRAST: tilt-rotor (4 rotors) | https://wingcopter.com/wp-content/uploads/2021/02/Technical-Details-Wingcopter-178-Heavy-Lift-A-Delivery-Variant-1-1.pdf | 2026-10-26 | 18.00 | 8.40 | 6.00 | 1.780 | — | 1.460 | 24.0 | 42.0 | 14.00 | 35–120 | max 120 min; range table 35/50/85/100 min for 2/3/4/4 batteries at 6/4/2/0 kg payload, ideal conditions, 30% reserve | 40–120 | 2-4x LiPo 22.2 V 16 Ah | 3.60–7.20 | 4 | — | — | same rotors tilted | multicopter mode max 2 min at a time | — | — | — | 710–1421 | 39–79 | — | 0.20–0.40 | 0.33 | 5.2 | Battery ~1.8 kg each derived from (12.0-8.4)/2. 14 m/s = fixed-wing minimum speed (not stall). W*V/P: 4 batt, 0 kg payload (15.7 kg), 120 km in 100 min, 70% of 1421 Wh used.
Quantum Systems Trinity F90+ | CONTRAST: tilt-rotor (flying wing, 3 rotors) | https://www.ferntech.co.nz/trinity-f90-plus-fixed-wing-mapping-drone | 2026-10-26 | 5.00 | — | 0.70 | 2.394 | — | — | 17.0 | — | — | 60–90 | 60 min default limit; 90+ min unlocked (export-controlled) | 100 | Wh not published | 1.50 | — | — | — | — | — | NZ$32,798 (currency not stated; discontinued) | — | — | — | — | — | 0.30 | 0.14 | — | Battery mass 1.5 kg -> 30% of MTOW. Rotor count not on cited page.
WingtraOne Gen II | CONTRAST: tailsitter | https://wingtra.com/wingtraone-gen-ii-drone/ | 2026-10-26 | 4.80 | — | 0.80 | 1.250 | — | — | 16.0 | — | — | 59 | 'up to 59 min', conditions in KB (manufacturer) | — | 2x 99 Wh Li-ion (pair) | — | 2 | — | — | — | — | — | — | — | 198 | 41 | — | — | 0.17 | 3.5 | Older docs list MTOW 4.5 kg; 3.7 kg with batteries (volatusdrones.ca/korec). Span from retailers. W*V/P at 4.5 kg, 100% of 198 Wh (upper bound).
Autel Dragonfish Lite | CONTRAST: tilt-rotor | https://www.gpsworld.com/autel-robotics-tilt-rotor-dragonfish-lite-and-pro-uavs-available-in-us/ | 2026-10-26 | 5.50 | — | 1.00 | 1.600 | — | 0.965 | — | 30.0 | — | 75–81 | 75 min (GPS World) vs 81 min (Autel brochure) | — | — | — | — | — | — | — | — | — | — | — | — | — | — | — | 0.18 | — | 4.5 kg incl. 2 batteries. Max speed is series-wide. Values via search summaries of retailer/press pages.
Heewing T2 Cruza VTOL | CONTRAST: tilt-rotor tricopter (3 motors, 2 tilt servos) | https://www.fpv24.com/en/heewing/heewing-t2-cruza-vtol-fpv-glider-airplane-pnp-black | 2026-10-26 | 2.00–3.50 | — | — | 1.200 | — | 1.110 | — | — | — | — | — | — | 6S LiPo 2000-20000 mAh (not incl.) | — | 3 | 10.0 | 3x 2812 (fpv24) vs 3x 3110 (rotorama) - conflict | shared tilting motors | — | EUR 779.90 PNP (fpv24); EUR 723.79 (rotorama) | — | 129–226 | — | — | — | — | — | — | Below 3 kg at low end. Configuration inferred from parts list (3 motors + 2 tilt servos).
TiltOne box-wing (Univ. Pisa / SkyBox, NATO STO-MP-AVT-323-27) | CONTRAST: tilt-wing box-wing, 4 props (academic) | https://publications.sto.nato.int/publications/STO%20Meeting%20Proceedings/STO-MP-AVT-323/MP-AVT-323-27.pdf | 2026-10-26 | 11.00 | — | 0.30 | 1.000 | 0.500 | 1.000 | 19.5 | — | 15.60 | 39 | design: 5 min hover + ~34 min cruise on 80% of capacity (calculated) | 40 | 2x 6S 10000 mAh 15C LiPo | — | 4 | 13.0 | Kv 490 (bench: 3.35 kgf max, ~35 A) | same (tilt-wing), 13x6 | calc hover 1417 W, cruise 569 W | — | 22.0 | 315 | 444 | 40 | — | — | 0.03 | 3.7 | 11 kg is a design mass cap, not weighed. L/D max ~6 (AVL/XFOIL est.). Stall 15.6 m/s 'very conservative'. AR not meaningful for box-wing (b^2/S = 2). Hover W/kg 129 (derived).
