davinciucberkeley-collab/DBF-Combined/redesign/manufacturing/out/PRINT-LIST.csv

file | part | instances | material | colour | qty_flight | qty_spare | qty_total | orientation | layer_mm | perimeters | infill | supports | size_on_bed_mm | est_time_each_min | est_mass_each_g | cad_mass_each_g | status | machine | source | notes
print/WNG-004_PETG_x2.stl | WNG-004 | R L | PETG |  | 2 | 0 | 2 | largest flat face -Y on the bed (307 mm2) | 0.2 (default) | 4 | 50 % gyroid | none | 19.8 x 19.8 x 36.0 | 32 | 10.3 | 7.0 | print | Prusa FDM (Jacobs open-access printers, studio 110/120) | wing/parts.csv; wing/BUILD.md stock row
print/WNG-005_PETG_x2.stl | WNG-005 | R L | PETG |  | 2 | 0 | 2 | largest flat face -Y on the bed (307 mm2) | 0.2 (default) | 2 (default) | 30 % | none | 19.8 x 19.8 x 20.0 | 16 | 3.8 | 4.0 | print | Prusa FDM (Jacobs open-access printers, studio 110/120) | wing/parts.csv
print/FIN-003-A_ASA_x4.stl | FIN-003-A | UR LL | ASA |  | 2 | 2 | 4 | face -Z on the bed (shopconfig) | 0.2 | 5 | 20 % (default) | check: 601 mm2 overhang > 50 deg (auto) | 36.6 x 36.3 x 48.0 | 43 | 10.6 | 9.99 | print | Enclosed printer: NOT on the Jacobs open-access list (MF-15). Staffed Fortus/Markforged lab (room 332) or a teammate's enclosed printer | fins/parts.csv ("collar axis vertical on the bed"); spares: MANUFACTURING.md "Make x2" (8 total: 4 A + 4 B) | A = UR/LL, B = UL/LR; drill 3.4 mm to the measured motor; R5 prints only
print/FIN-003-B_ASA_x4.stl | FIN-003-B | UL LR | ASA |  | 2 | 2 | 4 | face -Z on the bed (shopconfig) | 0.2 | 5 | 20 % (default) | check: 601 mm2 overhang > 50 deg (auto) | 36.6 x 36.3 x 48.0 | 43 | 10.6 | 9.99 | print | Enclosed printer: NOT on the Jacobs open-access list (MF-15). Staffed Fortus/Markforged lab (room 332) or a teammate's enclosed printer | fins/parts.csv ("collar axis vertical on the bed"); spares: MANUFACTURING.md "Make x2" (8 total: 4 A + 4 B) | A = UR/LL, B = UL/LR; drill 3.4 mm to the measured motor; R5 prints only
print/FIN-004-A_PETG_x2.stl | FIN-004-A | R | PETG |  | 1 | 1 | 2 | largest flat face +X on the bed (939 mm2) | 0.2 (default) | 3 | 15 % gyroid | check: 2010 mm2 overhang > 50 deg (auto) | 48.4 x 42.6 x 69.3 | 92 | 37.8 | 40.87 | print | Prusa FDM (Jacobs open-access printers, studio 110/120) | fins/parts.csv ("spar bore horizontal on the bed"); spare: MANUFACTURING.md (3 blocks)
print/FIN-004-B_PETG_x1.stl | FIN-004-B | L | PETG |  | 1 | 0 | 1 | largest flat face +X on the bed (939 mm2) | 0.2 (default) | 3 | 15 % gyroid | check: 2010 mm2 overhang > 50 deg (auto) | 48.4 x 42.6 x 69.3 | 92 | 37.8 | 40.87 | print | Prusa FDM (Jacobs open-access printers, studio 110/120) | fins/parts.csv ("spar bore horizontal on the bed"); spare: MANUFACTURING.md (3 blocks)
print/FIN-007_ASA_x4.stl | FIN-007 | UR LR UL LL | ASA |  | 4 | 0 | 4 | largest flat face -Y on the bed (1354 mm2) | 0.2 (default) | 2 (default) | 100 % | none | 46.0 x 31.0 x 1.2 | 9 | 1.7 | 2.04 | print | Enclosed printer: NOT on the Jacobs open-access list (MF-15). Staffed Fortus/Markforged lab (room 332) or a teammate's enclosed printer | fins/parts.csv
print/FIN-008-A_PETG_x4.stl | FIN-008-A | UR LL | PETG |  | 2 | 2 | 4 | face +Z on the bed (shopconfig) - no flat face there, check supports | 0.2 (default) | 3 | 100 % ring; tongue 3 perimeters + 20 % gyroid | check: 330 mm2 overhang > 50 deg (auto) | 63.8 x 35.5 x 25.9 | 33 | 12.2 | 10.5 | ON HOLD: STATUS issue 1 / MF-13 "do not print collars until settled" (freeze 18 Dec) | Prusa FDM (Jacobs open-access printers, studio 110/120) | fins/parts.csv ("upside down on the tail cap"), fins/BUILD.md prints row; spares: MANUFACTURING.md (8 collars)
print/FIN-008-B_PETG_x4.stl | FIN-008-B | LR UL | PETG |  | 2 | 2 | 4 | face -Z on the bed (shopconfig) - no flat face there, check supports | 0.2 (default) | 3 | 100 % ring; tongue 3 perimeters + 20 % gyroid | check: 330 mm2 overhang > 50 deg (auto) | 63.8 x 35.5 x 25.9 | 33 | 12.2 | 10.5 | ON HOLD: STATUS issue 1 / MF-13 "do not print collars until settled" (freeze 18 Dec) | Prusa FDM (Jacobs open-access printers, studio 110/120) | fins/parts.csv ("upside down on the tail cap"), fins/BUILD.md prints row; spares: MANUFACTURING.md (8 collars)
print/FIN-010-A_PETG_x1.stl | FIN-010-A | UR | PETG |  | 1 | 0 | 1 | largest flat face -Y on the bed (260 mm2) | 0.2 (default) | 2 (default) | 80 % | check: 70 mm2 overhang > 50 deg (auto) | 20.0 x 13.0 x 16.0 | 16 | 4.5 | 3.17 | print | Prusa FDM (Jacobs open-access printers, studio 110/120) | fins/parts.csv ("brace slot vertical on the bed")
print/FIN-010-B_PETG_x1.stl | FIN-010-B | LR | PETG |  | 1 | 0 | 1 | largest flat face -Y on the bed (245 mm2) | 0.2 (default) | 2 (default) | 80 % | check: 71 mm2 overhang > 50 deg (auto) | 20.0 x 12.3 x 16.0 | 16 | 4.3 | 3.17 | print | Prusa FDM (Jacobs open-access printers, studio 110/120) | fins/parts.csv ("brace slot vertical on the bed")
print/FIN-010-C_PETG_x1.stl | FIN-010-C | UL | PETG |  | 1 | 0 | 1 | largest flat face -Y on the bed (260 mm2) | 0.2 (default) | 2 (default) | 80 % | check: 65 mm2 overhang > 50 deg (auto) | 20.0 x 13.0 x 16.0 | 16 | 4.5 | 3.17 | print | Prusa FDM (Jacobs open-access printers, studio 110/120) | fins/parts.csv ("brace slot vertical on the bed")
print/FIN-010-D_PETG_x1.stl | FIN-010-D | LL | PETG |  | 1 | 0 | 1 | largest flat face -Y on the bed (245 mm2) | 0.2 (default) | 2 (default) | 80 % | check: 67 mm2 overhang > 50 deg (auto) | 20.0 x 12.3 x 16.0 | 16 | 4.3 | 3.17 | print | Prusa FDM (Jacobs open-access printers, studio 110/120) | fins/parts.csv ("brace slot vertical on the bed")
print/POD-001-lip_PETG_x1.stl | POD-001-lip | POD-001 | PETG |  | 1 | 0 | 1 | largest flat face -Z on the bed (542 mm2) | 0.2 | 2 (default) | 20 % (default) | none | 90.4 x 6.0 x 2.8 | 8 | 1.9 |  | print | Prusa FDM (Jacobs open-access printers, studio 110/120) | pod/BUILD.md step 1 (nose lip, antenna tube B); board and XPS bodies go to the cut list
print/POD-001-tube_PETG_x1.stl | POD-001-tube | POD-001 | PETG |  | 1 | 0 | 1 | largest flat face -X on the bed (18 mm2) | 0.2 | 2 (default) | 20 % (default) | none | 5.8 x 5.8 x 18.8 | 10 | 0.4 |  | print | Prusa FDM (Jacobs open-access printers, studio 110/120) | pod/BUILD.md step 1 (nose lip, antenna tube B); board and XPS bodies go to the cut list
print/POD-002-floorF_PETG_x1.stl | POD-002-floorF | POD-002 | PETG |  | 1 | 0 | 1 | largest flat face -Z on the bed (4520 mm2) | 0.2 | 2 (default) | 100 % (T, aft stop, plates); others default | none | 101.7 x 55.0 x 1.0 | 15 | 5.7 |  | print | Prusa FDM (Jacobs open-access printers, studio 110/120) | pod/BUILD.md step 1 (separate prints, bonded full-area to the floor)
print/POD-002-floorR_PETG_x1.stl | POD-002-floorR | POD-002 | PETG |  | 1 | 0 | 1 | largest flat face -Z on the bed (3894 mm2) | 0.2 | 2 (default) | 100 % (T, aft stop, plates); others default | none | 84.5 x 55.0 x 30.5 | 33 | 11.3 |  | print | Prusa FDM (Jacobs open-access printers, studio 110/120) | pod/BUILD.md step 1 (separate prints, bonded full-area to the floor)
print/POD-002-stopT_PETG_x1.stl | POD-002-stopT | POD-002 | PETG |  | 1 | 0 | 1 | largest flat face -Z on the bed (648 mm2) | 0.2 | 2 (default) | 100 % (T, aft stop, plates); others default | none | 54.0 x 12.0 x 32.0 | 26 | 7.3 |  | print | Prusa FDM (Jacobs open-access printers, studio 110/120) | pod/BUILD.md step 1 (separate prints, bonded full-area to the floor)
print/POD-002-guide_PETG_x2.stl | POD-002-guide | POD-002 POD-002 | PETG |  | 2 | 0 | 2 | largest flat face +Z on the bed (268 mm2) | 0.2 | 2 (default) | 100 % (T, aft stop, plates); others default | none | 178.7 x 1.5 x 6.0 | 9 | 2.0 |  | print | Prusa FDM (Jacobs open-access printers, studio 110/120) | pod/BUILD.md step 1 (separate prints, bonded full-area to the floor)
print/POD-002-FC_PETG_x1.stl | POD-002-FC | POD-002 | PETG |  | 1 | 0 | 1 | largest flat face -Z on the bed (2275 mm2) | 0.2 | 2 (default) | 100 % (T, aft stop, plates); others default | none | 62.0 x 36.7 x 4.8 | 10 | 2.5 |  | print | Prusa FDM (Jacobs open-access printers, studio 110/120) | pod/BUILD.md step 1 (separate prints, bonded full-area to the floor)
print/POD-002-avn_PETG_x1.stl | POD-002-avn | POD-002 | PETG |  | 1 | 0 | 1 | largest flat face -Z on the bed (1762 mm2) | 0.2 | 2 (default) | 100 % (T, aft stop, plates); others default | none | 48.0 x 36.7 x 5.8 | 9 | 2.0 |  | print | Prusa FDM (Jacobs open-access printers, studio 110/120) | pod/BUILD.md step 1 (separate prints, bonded full-area to the floor)
print/POD-002-PDB_PETG_x1.stl | POD-002-PDB | POD-002 | PETG |  | 1 | 0 | 1 | largest flat face -Z on the bed (3085 mm2) | 0.2 | 2 (default) | 100 % (T, aft stop, plates); others default | none | 84.0 x 36.7 x 6.8 | 15 | 4.7 |  | print | Prusa FDM (Jacobs open-access printers, studio 110/120) | pod/BUILD.md step 1 (separate prints, bonded full-area to the floor) | CAD bodies touching along an edge fused with a 0.01 mm overlap
print/POD-002-JR_PETG_x1.stl | POD-002-JR | POD-002 | PETG |  | 1 | 0 | 1 | largest flat face -Z on the bed (147 mm2) | 0.2 | 2 (default) | 100 % (T, aft stop, plates); others default | none | 36.7 x 4.0 x 5.0 | 7 | 0.9 |  | print | Prusa FDM (Jacobs open-access printers, studio 110/120) | pod/BUILD.md step 1 (separate prints, bonded full-area to the floor)
print/POD-003-tongue_PETG_x1.stl | POD-003-tongue | POD-003 | PETG |  | 1 | 0 | 1 | largest flat face -Z on the bed (497 mm2) | 0.2 | 2 (default) | 20 % (default) | none | 90.4 x 5.5 x 2.0 | 7 | 1.3 |  | print | Prusa FDM (Jacobs open-access printers, studio 110/120) | pod/BUILD.md step 1 (hatch tongue, latch tab, antenna tube A)
print/POD-003-tab_PETG_x1.stl | POD-003-tab | POD-003 | PETG |  | 1 | 0 | 1 | largest flat face -Z on the bed (480 mm2) | 0.2 | 2 (default) | 20 % (default) | none | 40.0 x 12.0 x 1.0 | 5 | 0.6 |  | print | Prusa FDM (Jacobs open-access printers, studio 110/120) | pod/BUILD.md step 1 (hatch tongue, latch tab, antenna tube A)
print/POD-003-tube_PETG_x1.stl | POD-003-tube | POD-003 | PETG |  | 1 | 0 | 1 | largest flat face -Z on the bed (18 mm2) | 0.2 | 2 (default) | 20 % (default) | none | 5.8 x 5.8 x 23.8 | 11 | 0.6 |  | print | Prusa FDM (Jacobs open-access printers, studio 110/120) | pod/BUILD.md step 1 (hatch tongue, latch tab, antenna tube A)
print/POD-010_PETG_x1.stl | POD-010 | POD-010 | PETG |  | 1 | 0 | 1 | largest flat face -X on the bed (2787 mm2) | 0.2 (default) | 2 (default) | 100 % | none | 58.9 x 51.4 x 1.5 | 14 | 5.3 | 5.3 | print | Prusa FDM (Jacobs open-access printers, studio 110/120) | pod/parts.csv ("solid")
print/POD-008-2mm_PETG-white_x1.stl | POD-008-2mm | POD-008 | PETG | white | 1 | 0 | 1 | largest flat face -X on the bed (197 mm2) | 0.2 | 2 (default) | 20 % (default) | none | 50.0 x 12.0 x 2.0 | 5 | 0.5 |  | print | Prusa FDM (Jacobs open-access printers, studio 110/120) | pod/BUILD.md step 1; set from pod/params.json spacer_set_m, colours spacer_colour
print/POD-008-4mm_PETG-yellow_x1.stl | POD-008-4mm | POD-008 | PETG | yellow | 1 | 0 | 1 | largest flat face -X on the bed (197 mm2) | 0.2 | 2 (default) | 20 % (default) | none | 50.0 x 12.0 x 4.0 | 7 | 1.0 |  | print | Prusa FDM (Jacobs open-access printers, studio 110/120) | pod/BUILD.md step 1; set from pod/params.json spacer_set_m, colours spacer_colour
print/POD-008-6mm_PETG-green_x1.stl | POD-008-6mm | POD-008 | PETG | green | 1 | 0 | 1 | largest flat face -Z on the bed (300 mm2) | 0.2 | 2 (default) | 20 % (default) | none | 50.0 x 6.0 x 12.0 | 10 | 1.4 |  | print | Prusa FDM (Jacobs open-access printers, studio 110/120) | pod/BUILD.md step 1; set from pod/params.json spacer_set_m, colours spacer_colour
print/POD-008-8mm_PETG-blue_x1.stl | POD-008-8mm | POD-008 | PETG | blue | 1 | 0 | 1 | largest flat face -Z on the bed (400 mm2) | 0.2 | 2 (default) | 20 % (default) | none | 50.0 x 8.0 x 12.0 | 10 | 1.8 |  | print | Prusa FDM (Jacobs open-access printers, studio 110/120) | pod/BUILD.md step 1; set from pod/params.json spacer_set_m, colours spacer_colour
print/POD-006_PETG_x1.stl | POD-006 | POD-006 | PETG |  | 1 | 0 | 1 | largest flat face -X on the bed (115 mm2) | 0.2 | 2 (default) | 20 % (default) | check: 880 mm2 overhang > 50 deg (auto) | 32.0 x 32.0 x 34.8 | 23 | 5.6 | 5.8 | print | Prusa FDM (Jacobs open-access printers, studio 110/120) | pod/BUILD.md step 1
print/POD-007_PETG_x2.stl | POD-007 | POD-007 | PETG |  | 1 | 1 | 2 | face -Z on the bed (shopconfig) | 0.2 | 3 | 25 % (40 % feet and grip; bridge 100 %) | under the strut ribs (pod/BUILD.md) | 130.4 x 39.7 x 110.6 | 110 | 41.8 | 39.8 | print | Prusa FDM (Jacobs open-access printers, studio 110/120) | pod/BUILD.md step 1 ("standing on the foot plates"; parts.csv says "lying flat": BUILD.md is newer); spare: MANUFACTURING.md "Make x2"
print/POD-005_PETG_x1.stl | POD-005 | POD-005 | PETG |  | 1 | 0 | 1 | largest flat face (-0.71 0.00 0.71) on the bed (784 mm2) | 0.2 | 2 (default) | 20 % (default) | none | 56.0 x 28.0 x 43.5 | 24 | 5.1 | 5.5 | print | Prusa FDM (Jacobs open-access printers, studio 110/120) | pod/BUILD.md step 1
print/GER-001_PETG_x6.stl | GER-001 | UR UL LR LL | PETG |  | 4 | 2 | 6 | face +X on the bed (shopconfig) | 0.2 | 3 | 100 % | only under the two leg ends at the TE | 25.9 x 24.8 x 73.0 | 40 | 9.6 | 9.93 | print | Prusa FDM (Jacobs open-access printers, studio 110/120) | landing/parts.csv + BUILD.md step 1 ("rim end on the bed"); spares = GER-012 x2
print/GER-002_PETG-orange_x6.stl | GER-002 | UR UL | PETG | orange | 2 | 4 | 6 | face +X on the bed (shopconfig) | 0.2 | 2 | 20 % (default) | none | 19.1 x 17.8 x 64.8 | 26 | 3.3 | 3.28 | print | Prusa FDM (Jacobs open-access printers, studio 110/120) | landing/parts.csv + BUILD.md step 2 ("flange on the bed"); spares = GER-005 x4 (orange) + GER-009 x4 (blue) inserts
print/GER-007-A_TPU95A_x1.stl | GER-007-A | R | TPU95A |  | 1 | 0 | 1 | face +Y on the bed (shopconfig) | 0.2 (default) | 2 | 20 % (default) | none | 20.8 x 4.0 x 14.3 | 12 | 0.6 | 0.73 | print | Prusa FDM with a direct-drive extruder (Jacobs open access); slow, 2 mm3/s | landing/parts.csv ("open side up")
print/GER-007-B_TPU95A_x1.stl | GER-007-B | L | TPU95A |  | 1 | 0 | 1 | face -Y on the bed (shopconfig) | 0.2 (default) | 2 | 20 % (default) | none | 20.8 x 4.0 x 14.3 | 12 | 0.6 | 0.73 | print | Prusa FDM with a direct-drive extruder (Jacobs open access); slow, 2 mm3/s | landing/parts.csv ("open side up")
print/GER-002_PETG-blue_x6.stl | GER-002 | LR LL | PETG | blue | 2 | 4 | 6 | face +X on the bed (shopconfig) | 0.2 | 2 | 20 % (default) | none | 19.1 x 17.8 x 64.8 | 26 | 3.3 | 3.28 | print | Prusa FDM (Jacobs open-access printers, studio 110/120) | landing/parts.csv + BUILD.md step 2 ("flange on the bed"); spares = GER-005 x4 (orange) + GER-009 x4 (blue) inserts
print/MEC-004-A_PETG_x2.stl | MEC-004-A | R | PETG |  | 1 | 1 | 2 | largest flat face -Y on the bed (36 mm2) | 0.2 (default) | 2 (default) | 100 % | check: 599 mm2 overhang > 50 deg (auto) | 44.7 x 29.1 x 18.2 | 14 | 3.1 | 3.2 | print | Prusa FDM (Jacobs open-access printers, studio 110/120) | mechanisms/BUILD.md ("horns flat on the y face"); spares: MANUFACTURING.md "Make x2"
print/MEC-004-B_PETG_x2.stl | MEC-004-B | L | PETG |  | 1 | 1 | 2 | largest flat face +Y on the bed (36 mm2) | 0.2 (default) | 2 (default) | 100 % | check: 599 mm2 overhang > 50 deg (auto) | 44.7 x 29.1 x 18.2 | 14 | 3.1 | 3.2 | print | Prusa FDM (Jacobs open-access printers, studio 110/120) | mechanisms/BUILD.md ("horns flat on the y face"); spares: MANUFACTURING.md "Make x2"
print/MEC-006-A_PETG_x2.stl | MEC-006-A | R | PETG |  | 1 | 1 | 2 | largest flat face +Y on the bed (36 mm2) | 0.2 (default) | 2 (default) | 100 % | check: 510 mm2 overhang > 50 deg (auto) | 44.7 x 22.2 x 18.2 | 14 | 2.9 | 2.95 | print | Prusa FDM (Jacobs open-access printers, studio 110/120) | mechanisms/BUILD.md ("flat on the y face"); spares: MANUFACTURING.md "Make x2"
print/MEC-006-B_PETG_x2.stl | MEC-006-B | L | PETG |  | 1 | 1 | 2 | largest flat face -Y on the bed (36 mm2) | 0.2 (default) | 2 (default) | 100 % | check: 510 mm2 overhang > 50 deg (auto) | 44.7 x 22.2 x 18.2 | 14 | 2.9 | 2.95 | print | Prusa FDM (Jacobs open-access printers, studio 110/120) | mechanisms/BUILD.md ("flat on the y face"); spares: MANUFACTURING.md "Make x2"
print/MEC-007-A_PETG_x1.stl | MEC-007-A | R | PETG |  | 1 | 0 | 1 | largest flat face -Z on the bed (1673 mm2) | 0.2 (default) | 2 | 20 % (default) | none | 42.9 x 40.9 x 0.8 | 7 | 1.7 | 1.53 | print | Prusa FDM (Jacobs open-access printers, studio 110/120) | mechanisms/BUILD.md (cover 2 perimeters)
print/MEC-007-B_PETG_x1.stl | MEC-007-B | L | PETG |  | 1 | 0 | 1 | largest flat face -Z on the bed (1673 mm2) | 0.2 (default) | 2 | 20 % (default) | none | 42.9 x 40.9 x 0.8 | 7 | 1.7 | 1.53 | print | Prusa FDM (Jacobs open-access printers, studio 110/120) | mechanisms/BUILD.md (cover 2 perimeters)
print/MEC-008-A_PETG_x2.stl | MEC-008-A | R | PETG |  | 1 | 1 | 2 | largest flat face +Z on the bed (475 mm2) | 0.2 (default) | 3 | 20 % (default) | check: 28 mm2 overhang > 50 deg (auto) | 34.9 x 34.9 x 13.5 | 13 | 2.9 | 3.19 | print | Prusa FDM (Jacobs open-access printers, studio 110/120) | mechanisms/BUILD.md (frame 3 perimeters); spares: MANUFACTURING.md "Make x2"
print/MEC-008-B_PETG_x2.stl | MEC-008-B | L | PETG |  | 1 | 1 | 2 | largest flat face +Z on the bed (475 mm2) | 0.2 (default) | 3 | 20 % (default) | check: 28 mm2 overhang > 50 deg (auto) | 34.9 x 34.9 x 13.5 | 13 | 2.9 | 3.19 | print | Prusa FDM (Jacobs open-access printers, studio 110/120) | mechanisms/BUILD.md (frame 3 perimeters); spares: MANUFACTURING.md "Make x2"
print/PWR-006_PETG_x1.stl | PWR-006 | PWR-006 | PETG |  | 1 | 0 | 1 | largest flat face +Z on the bed (263 mm2) | 0.2 | 4 | 100 % | check: 3275 mm2 overhang > 50 deg (auto) | 126.0 x 34.0 x 28.8 | 36 | 13.0 | 8.06 | print | Prusa FDM (Jacobs open-access printers, studio 110/120) | power/BUILD.md step 2 ("deck flat on the bed": deck parallel to the bed; the cradle walls and legs leave no free deck face, so the wall tops go down)
print/AVN-005_PETG_x1.stl | AVN-005 | AVN-005 | PETG |  | 1 | 0 | 1 | largest flat face -X on the bed (15 mm2) | 0.2 (default) | 2 (default) | 100 % | none; use a brim (tall, 10 mm footprint) | 9.8 x 9.8 x 49.8 | 19 | 1.1 | 4.84 | print | Prusa FDM (Jacobs open-access printers, studio 110/120) | avionics/BUILD.md step 7; the aluminium probe and couplers are bought
print/HRN-110-A_ASA_x3.stl | HRN-110-A | LL LR | ASA |  | 2 | 1 | 3 | largest flat face -Y on the bed (40 mm2) | 0.2 (default) | 2 (default) | 100 % | none | 10.0 x 10.0 x 12.0 | 7 | 0.2 | 0 | print | Enclosed printer: NOT on the Jacobs open-access list (MF-15). Staffed Fortus/Markforged lab (room 332) or a teammate's enclosed printer | harness/parts.csv (x6 incl. 2 spare), D-83: flange on the bed, barrel up | CAD bodies touching along an edge fused with a 0.01 mm overlap
print/HRN-110-B_ASA_x3.stl | HRN-110-B | UL UR | ASA |  | 2 | 1 | 3 | largest flat face -Y on the bed (40 mm2) | 0.2 (default) | 2 (default) | 100 % | none | 10.0 x 10.0 x 12.0 | 7 | 0.2 | 0 | print | Enclosed printer: NOT on the Jacobs open-access list (MF-15). Staffed Fortus/Markforged lab (room 332) or a teammate's enclosed printer | harness/parts.csv (x6 incl. 2 spare), D-83: flange on the bed, barrel up
jigs/JIG-01_PETG_x2.stl | JIG-01 | R L | PETG |  | 2 | 0 | 2 | face -Z on the bed (shopconfig) | 0.2 | 4 | 40 % | none | 64.0 x 64.0 x 51.0 | 100 | 44.6 |  | JIG (shop aid) | Prusa FDM (Jacobs open-access printers, studio 110/120) | manufacturing/jigs.py | flange on the bed; bore = tube OD + 0.3 mm; bolt to the base board with 4 x M4
jigs/JIG-02_PETG_x4.stl | JIG-02 | R | PETG |  | 1 | 3 | 4 | largest flat face -Z on the bed (814 mm2) | 0.2 | 3 | 30 % | none | 77.0 x 34.0 x 25.0 | 48 | 20.1 |  | JIG (shop aid) | Prusa FDM (Jacobs open-access printers, studio 110/120) | manufacturing/jigs.py | 4 total: one per half-fin root bond
jigs/JIG-03-A_PETG_x2.stl | JIG-03-A | UR LL | PETG |  | 2 | 0 | 2 | largest flat face +Z on the bed (1665 mm2) | 0.2 | 3 | 40 % | none | 60.0 x 31.2 x 24.0 | 62 | 27.6 |  | JIG (shop aid) | Prusa FDM (Jacobs open-access printers, studio 110/120) | manufacturing/jigs.py | face D is the cant datum: do not sand it; write A or B on the part
jigs/JIG-03-B_PETG_x2.stl | JIG-03-B | UL LR | PETG |  | 2 | 0 | 2 | largest flat face +Z on the bed (1665 mm2) | 0.2 | 3 | 40 % | none | 60.0 x 31.2 x 24.0 | 62 | 27.6 |  | JIG (shop aid) | Prusa FDM (Jacobs open-access printers, studio 110/120) | manufacturing/jigs.py | face D is the cant datum: do not sand it; write A or B on the part
