davinciucberkeley-collab/DBF-Combined/redesign/team/A3/mass_model.csv

item_id | subsystem | discipline | name | qty | sym | mass_g | x_m | y_m | z_m | lx_m | ly_m | lz_m | maturity | growth_pct | part_ids | with_parts | basis | if_sub_g
WNG-E01 | wing | structure | XPS core one piece incl. elevon panels (less spar slot) | 1 | - | 201.9 | =0.42*P:wing.chord_m | 0 | 0 | =P:wing.chord_m | =P:wing.span_m | =P:wing.t_c*P:wing.chord_m | CALC |  | WNG-001 |  | C2 CL-C2-WING-MASS core 201.9 g (team/C2/sizing.json mass_g); centroid 42 % chord; density UNVERIFIED
WNG-E02 | wing | structure | Packing-tape skin both sides | 1 | - | 48.6 | =0.5*P:wing.chord_m | 0 | 0 | =P:wing.chord_m | =P:wing.span_m | 0.03 | EST |  | WNG-003 |  | C2 sizing.json tape 48.6 g incl. overlap and block/servo doublers
WNG-E03 | wing | structure | CF spar 22x20 x 1000 mm | 1 | - | 102.0 | =P:wing.spar.x_m | 0 | =P:wing.spar.z_m | 0.022 | =P:wing.spar.length_m | 0.022 | CALC |  | WNG-002 |  | C2 sizing.json spar 102 g; weigh on arrival
WNG-E04 | wing | structure | Spar slot epoxy fill | 1 | - | 15.0 | =P:wing.spar.x_m | 0 | 0 | 0.03 | =P:wing.spar.length_m | 0.03 | EST |  |  |  | C2 sizing.json slot fill 15 g
WNG-E05 | wing | structure | Edge tape and FAA label | 1 | - | 5 | =0.5*P:wing.chord_m | 0 | 0 | =P:wing.chord_m | =P:wing.span_m | 0.01 | EST |  |  |  | A3 EST; not in C2's 397 g (allocation note carries it)
WNG-E06 | wing | structure | Spar plug under the through-core block (PETG 19.8 x 36 mm) | 2 | y | 7.0 | =P:wing.spar.x_m | 0.32 | =P:wing.spar.z_m | 0.036 | 0.02 | 0.02 | EST |  | WNG-004 |  | fallback and self-inertia box for D1 WNG-004-L/R (7.0 g each at |y| 0.320; CR-A1-44)
WNG-E07 | wing | structure | Spar plug at the brace anchors (PETG 19.8 x 20 mm) | 2 | y | 4.0 | =P:wing.spar.x_m | 0.242 | =P:wing.spar.z_m | 0.02 | 0.02 | 0.02 | EST |  | WNG-005 |  | fallback and self-inertia box for D1 WNG-005-L/R (4.0 g each at |y| 0.242; upper and lower anchors share one plug). D1 four plugs 22 g (was six plugs 30 g at C2)
FIN-E01 | fins | structure | Fin foam board (layers per params) | 4 | yz | =P:fins.areal_mass_kgm2*P:fins.layers*P:fins.chord_m*P:fins.half_height_m*1000 | =(P:fins.le_x_m+P:fins.te_x_m)/2 | =P:fins.y_m | =P:fins.half_height_m/2 | =P:fins.chord_m | 0.01 | =P:fins.half_height_m | EST |  | FIN-001 |  | fallback only (fins/parts.csv exists); one row per half-fin; box for FIN-001 self-inertia
FIN-E02 | fins | structure | CF motor tube 22x20 | 2 | y | =P:wing.spar.mass_per_m_kgm*P:fins.tube.length_m*1000 | =P:fins.tube.x_m | =P:fins.y_m | 0 | 0.022 | 0.022 | =P:fins.tube.length_m | CALC |  | FIN-002 |  | fallback only; box for FIN-002 self-inertia
FIN-E03 | fins | structure | Printed motor mount | 4 | yz | 11.3 | =P:propulsion.stations.x_mount_m-0.005 | =P:fins.y_m | =P:propulsion.stations.z_m | 0.04 | 0.04 | 0.04 | EST |  |  |  | fallback only; D3 CAD 11.28 g
FIN-E04 | fins | structure | Printed PETG through-core block (tube + spar bores) | 2 | y | 40.1 | =(P:fins.tube.x_m+P:wing.spar.x_m)/2 | =P:fins.y_m | 0 | =P:wing.spar.x_m-P:fins.tube.x_m+0.022 | 0.04 | 0.03 | EST |  |  |  | fallback only; matches FIN-004-L/R (CR-A4-17a); D3 CAD 40.14 g
FIN-005 | fins | structure | Fin-tube bond and clip set per half-fin | 4 | yz | 15 | =P:fins.tube.x_m+0.02 | =P:fins.y_m | =P:fins.half_height_m/2 | 0.04 | 0.02 | =P:fins.half_height_m | EST |  |  |  | fallback only; CR-A4-17c one set per half-fin (FIN-005-<station>); D3's CAD carries bonds inside the bonded parts (FIN-105) so no adder
FIN-E06 | fins | structure | Fin glue tape and consumables | 2 | y | 14 | =(P:fins.le_x_m+P:fins.te_x_m)/2 | =P:fins.y_m | 0 | =P:fins.chord_m | 0.01 | =2*P:fins.half_height_m | EST |  |  |  | fallback only
POD-E01 | pod | structure | Pod shell tray and hatch | 1 | - | 51 | =P:pod.x_le_m+P:pod.size_m[0]/2 | 0 | =P:pod.z_base_m+P:pod.size_m[2]/2 | =P:pod.size_m[0] | =P:pod.size_m[1] | =P:pod.size_m[2] | EST |  |  |  | fallback only (pod/parts.csv exists); D2 POD-001..003
POD-E02 | pod | structure | Pack strap and Velcro | 1 | - | 10.1 | =P:pod.pack_x_nominal_m-0.0002 | 0 | =P:pod.z_base_m+P:pod.size_m[2] | 0.10 | 0.05 | 0.01 | EST |  | POD-004 |  | fallback and box for POD-004; moves with the pack (D-47 nominal station); POD-004 positioned by overrides.csv until D2-R5
GER-E01 | landing | structure | Foot 48 mm (shoe piston cartridge pad) | 4 | yz | 10.28 | =P:wing.te_x_m+P:cg.foot_height_m/2 | =P:fins.y_m | =P:fins.half_height_m | 0.02 | 0.02 | 0.05 | EST |  |  |  | fallback only; D5-R4 parts.csv shoe 5.68 + piston 3.14 + cartridge 0.66 + pad 0.80 (48 mm foot; the old +0.85 g adder GER-E02 is retired)
PRP-E01 | propulsion | propulsion | Motor X3108S KV900 with factory leads | 4 | yz | =P:propulsion.motor_mass_kg*1000 | =P:propulsion.stations.x_mount_m-P:fins.tube.od_m/2-P:propulsion.motor_length_m/2 | =P:propulsion.stations.y_m | =P:propulsion.stations.z_m | =P:propulsion.motor_length_m | =P:propulsion.motor_diameter_m | =P:propulsion.motor_diameter_m | DATASHEET |  | PRP-001;PRP-005 |  | positions for E1 parts.csv motors and motor screws (no propulsion/interfaces.json yet)
PRP-E02 | propulsion | propulsion | Prop APC 11x5.5MR | 4 | yz | 17.0 | =P:propulsion.stations.x_prop_plane_m | =P:propulsion.stations.y_m | =P:propulsion.stations.z_m | 0.01 | =P:propulsion.prop_diameter_m | 0.02 | DATASHEET |  | PRP-003 |  | E1 parts.csv 17.0 g
PRP-E03 | propulsion | propulsion | Prop adapter nut and washer | 4 | yz | 6.7 | =P:propulsion.stations.x_prop_plane_m+0.005 | =P:propulsion.stations.y_m | =P:propulsion.stations.z_m | 0.02 | 0.01 | 0.01 | EST |  | PRP-004 |  | E1 parts.csv 6.7 g
PRP-E04 | propulsion | propulsion | ESC LANRC 45 A on fin pad with leads | 4 | yz | 11.0 | 0.101 | =P:fins.y_m | 0.118 | 0.04 | 0.005 | 0.02 | EST |  | PRP-002 |  | E1 parts.csv 11.0 g EST; on the ESC pad FIN-007 (x 0.101 z +/-0.118 from fins/interfaces.json)
PWR-E01 | power | energy | Flight pack 4S 6500 (LiPo) | 1 | - | =P:battery.mass_kg*1000 | =P:pod.pack_x_nominal_m | 0 | =P:pod.z_base_m+0.003+P:battery.size_m[2]/2 | =P:battery.size_m[0] | =P:battery.size_m[1] | =P:battery.size_m[2] | DATASHEET | 0 | PWR-001 |  | nominal centroid x = pod.pack_x_nominal_m (D-47 -0.022; was -0.001 at D-24); box gives PWR-001 its self-inertia; listings 503-680 g reported as bounding cases at their D-47 stations (ASM-A3-PACK-RANGE / -STATIONS) not as growth
PWR-E02 | power | electrical | AS150U aircraft half + heat-shrink (parked) | 1 | - | 10.0 | 0.045 | -0.046 | 0.035 | 0.055 | 0.022 | 0.014 | DATASHEET |  |  |  | F1 ASM-F1-MASS-ITEMS; parked slot x 0.030-0.060 left channel (F1 POWER.md)
PWR-E03 | power | electrical | Main path 8 AWG 0.15 m (two conductors) | 1 | - | 29.03 | 0.03 | -0.03 | 0.035 | 0.15 | 0.02 | 0.01 | CALC |  |  |  | F1 CL-F1-MAIN-MASS 29.03 g
PWR-E04 | power | electrical | UBEC 6 V 8 A class | 1 | - | 13.0 | -0.04 | -0.046 | 0.03 | 0.04 | 0.025 | 0.01 | DATASHEET |  |  |  | F1 ASM-F1-MASS-ITEMS; left channel >= 0.10 m from the GPS mast
PWR-E05 | power | electrical | Bus PDB board | 1 | - | 6.0 | -0.06 | -0.046 | 0.03 | 0.04 | 0.03 | 0.005 | DATASHEET |  |  |  | F1 ASM-F1-MASS-ITEMS; left channel
PWR-E06 | power | electrical | Mini blade fuse 5 A + holder | 1 | - | 3.0 | -0.03 | -0.046 | 0.03 | 0.03 | 0.01 | 0.01 | EST |  |  |  | F1 ASM-F1-MASS-ITEMS
PWR-E07 | power | electrical | 4 x 680 uF caps on the bus | 1 | - | 8.0 | -0.06 | -0.046 | 0.04 | 0.03 | 0.03 | 0.015 | DATASHEET |  |  |  | F1 ASM-F1-MASS-ITEMS
PWR-E08 | power | electrical | CoreWing V2 power board (separated from the FC stack) | 1 | - | 28.0 | -0.031 | -0.046 | 0.044 | 0.042 | 0.032 | 0.009 | EST |  | PWR-003 |  | F3 CR-F3-13 / F1 CR-F1-19: 28 g moved from AVN-001 to power
AVN-E01 | avionics | avionics | CoreWing F405 Wing V2 top board (power board moved to PWR-003) | 1 | - | 12.0 | -0.01 | 0.046 | 0.03 | 0.054 | 0.036 | 0.015 | DATASHEET |  | AVN-001 |  | F3 ASM-F3-MASS; right channel (-0.010 0.046) tray top (F3 AVIONICS.md)
AVN-E02 | avionics | avionics | GPS + compass HGLRC M100-5883 | 1 | - | 7.73 | 0.08 | 0 | 0.169 | 0.025 | 0.025 | 0.01 | EST |  | AVN-002 |  | F3; mast top (0.080 0 0.169)
AVN-E03 | avionics | avionics | Receiver RadioMaster RP3 V2 | 1 | - | 3.0 | -0.03 | -0.046 | 0.025 | 0.02 | 0.01 | 0.005 | EST |  | AVN-003 |  | F3; left floor
AVN-E04 | avionics | avionics | Airspeed MS4525DO | 1 | - | 5.0 | -0.085 | -0.046 | 0.03 | 0.03 | 0.02 | 0.01 | EST |  | AVN-004 |  | F3; left channel front behind the pitot socket
AVN-E05 | avionics | avionics | Pitot boom sleeve tube couplers silicone | 1 | - | 4.84 | -0.15 | -0.046 | 0.045 | 0.07 | 0.006 | 0.006 | EST |  | AVN-005 |  | F3; boom from the pod nose to the tip (-0.185 -0.046 0.045)
AVN-E06 | avionics | avionics | Gel pads foam tape ties | 1 | - | 2.4 | -0.01 | 0.046 | 0.022 | 0.05 | 0.04 | 0.005 | EST |  | AVN-006 |  | F3
AVN-E07 | avionics | avionics | microSD | 1 | - | 0.5 | -0.01 | 0.046 | 0.03 | 0.015 | 0.011 | 0.001 | DATASHEET |  | AVN-007 |  | F3; in the FC
HRN-E01 | harness | electrical | ESC power lead pair 16 AWG 0.5 m | 4 | yz | 16.16 | =(P:pod.x_le_m+0.08+P:fins.tube.x_m+0.04)/2 | =P:fins.y_m/2 | =0.3*P:propulsion.stations.z_m | 0.15 | =P:fins.y_m | 0.05 | CALC |  |  |  | F1 CL-F1-ESC-MASS 64.6 g / 4 (18 AWG rejected)
HRN-E02 | harness | electrical | ESC signal lead 0.5 m | 4 | yz | 1.5 | =(P:pod.x_le_m+0.14+P:fins.tube.x_m+0.04)/2 | =P:fins.y_m/2 | =0.3*P:propulsion.stations.z_m | 0.15 | =P:fins.y_m | 0.05 | EST |  |  |  | A3 EST; F2 mass_estimate.csv pending (CR-A3-06)
HRN-E03 | harness | electrical | Motor phase bullets and short leads | 4 | yz | 4 | =P:fins.tube.x_m+0.01 | =P:fins.y_m | =0.8*P:propulsion.stations.z_m | 0.03 | 0.01 | 0.05 | EST |  |  |  | 3 x 3.5 mm bullet pairs per station (E1 motor mass has no bullets)
HRN-E04 | harness | electrical | Servo lead extension and UBEC servo bus 20 AWG | 2 | y | 5 | =0.6*P:wing.chord_m | =P:fins.y_m/2 | 0 | 0.05 | =P:fins.y_m | 0.005 | EST |  |  |  | A3 EST; F1 POWER.md bus 4.6 g + feed 2.0 g sit inside this and HRN-E05
HRN-E05 | harness | electrical | Sensor cables GPS airspeed RX | 1 | - | 6 | =P:pod.x_le_m+0.10 | 0 | 0.04 | 0.10 | 0.02 | 0.02 | EST
HRN-E06 | harness | electrical | Ties sleeve heat shrink chafe guard | 2 | y | 5 | 0.0 | =P:fins.y_m/2 | 0 | 0.1 | =P:fins.y_m | 0.02 | EST
MEC-E01 | mechanisms | controls | Elevon servo >= 3.93 kgf cm | 2 | y | 18.5 | =0.63*P:wing.chord_m | =P:wing.elevon.inboard_y_m[1] | 0 | 0.023 | 0.012 | 0.025 | EST |  | MEC-001 |  | B2 CR-B2-10: 4 kgf cm class typically 17-20 g; D6 chooses
MEC-E02 | mechanisms | controls | Control horn (one per side on the inboard panel) | 2 | y | 1.5 | =(1-P:wing.elevon.chord_frac/2)*P:wing.chord_m | =P:wing.elevon.inboard_y_m[1] | 0 | 0.02 | 0.01 | 0.02 | EST |  | MEC-004 |  | CR-A4-17b: MEC-004-L/R; outboard panel driven by the link MEC-005
MEC-E03 | mechanisms | controls | Pushrod and clevises | 2 | y | 3 | =(0.63+1-P:wing.elevon.chord_frac)/2*P:wing.chord_m | =P:wing.elevon.inboard_y_m[1] | 0 | 0.06 | 0.005 | 0.005 | EST
MEC-E04 | mechanisms | controls | Inter-panel link across fin root | 2 | y | 3 | =(1-P:wing.elevon.chord_frac/2)*P:wing.chord_m | =P:fins.y_m | 0 | 0.02 | 0.06 | 0.01 | EST |  | MEC-005
MEC-E05 | mechanisms | controls | Hinge tape | 2 | y | 4 | =(1-P:wing.elevon.chord_frac)*P:wing.chord_m | =(P:wing.elevon.inboard_y_m[0]+P:wing.elevon.outboard_y_m[1])/2 | 0 | 0.02 | =P:wing.elevon.outboard_y_m[1]-P:wing.elevon.inboard_y_m[0] | 0.001 | EST
MEC-E06 | mechanisms | controls | Servo cover and frame | 2 | y | 2 | =0.63*P:wing.chord_m | =P:wing.elevon.inboard_y_m[1] | 0 | 0.03 | 0.02 | 0.005 | EST
GER-R5-SLEEVE | landing | structure | Shoe sleeve-end fix: wall 2.0, rim 3.0, R 1 mm fillet, 25 mm engagement (D-63, D-65) | 4 | yz | 1.25 | 0.301 | 0.32 | 0.2076 | 0.025 | 0.012 | 0.012 | EST |  |  | y | D-63 (C5 CR-C5-18): +5 g EST on the four GER-001 shoes; A3 adder until D5-R5 lists it | 42.46
