davinciucberkeley-collab/DBF-Combined/redesign/showcase/stl/k09l-assembly.stl

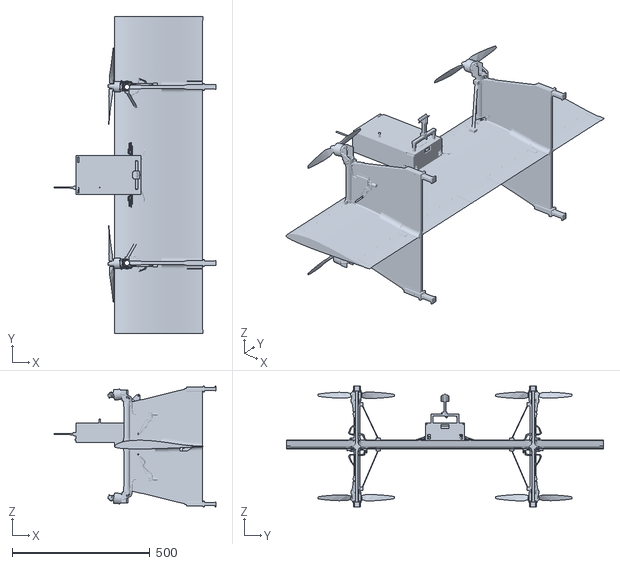
[picture p106: CAD file, 2026-11-13]
redesign/showcase/stl/k09l-assembly.stl
588.0 x 1151.6 x 438.0
