davinciucberkeley-collab/DBF-Combined/cad/mesh/Pitot_Tube.STL

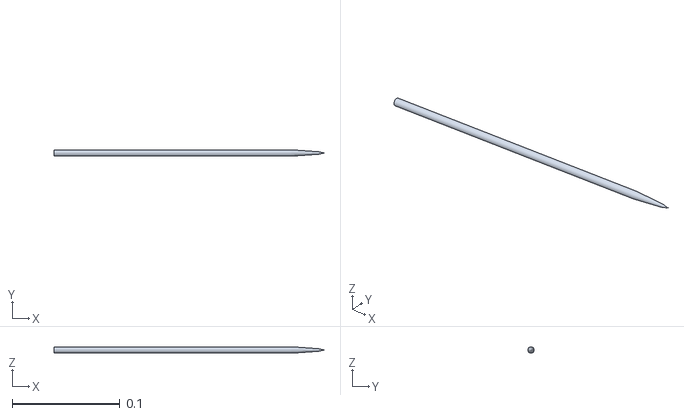
[picture p107: CAD file, 2026-11-09]
cad/mesh/Pitot_Tube.STL
0.25 x 0.00597 x 0.006
