davinciucberkeley-collab/DBF-Combined/redesign/manufacturing/out/laser/foamboard_sheet1of5.dxf

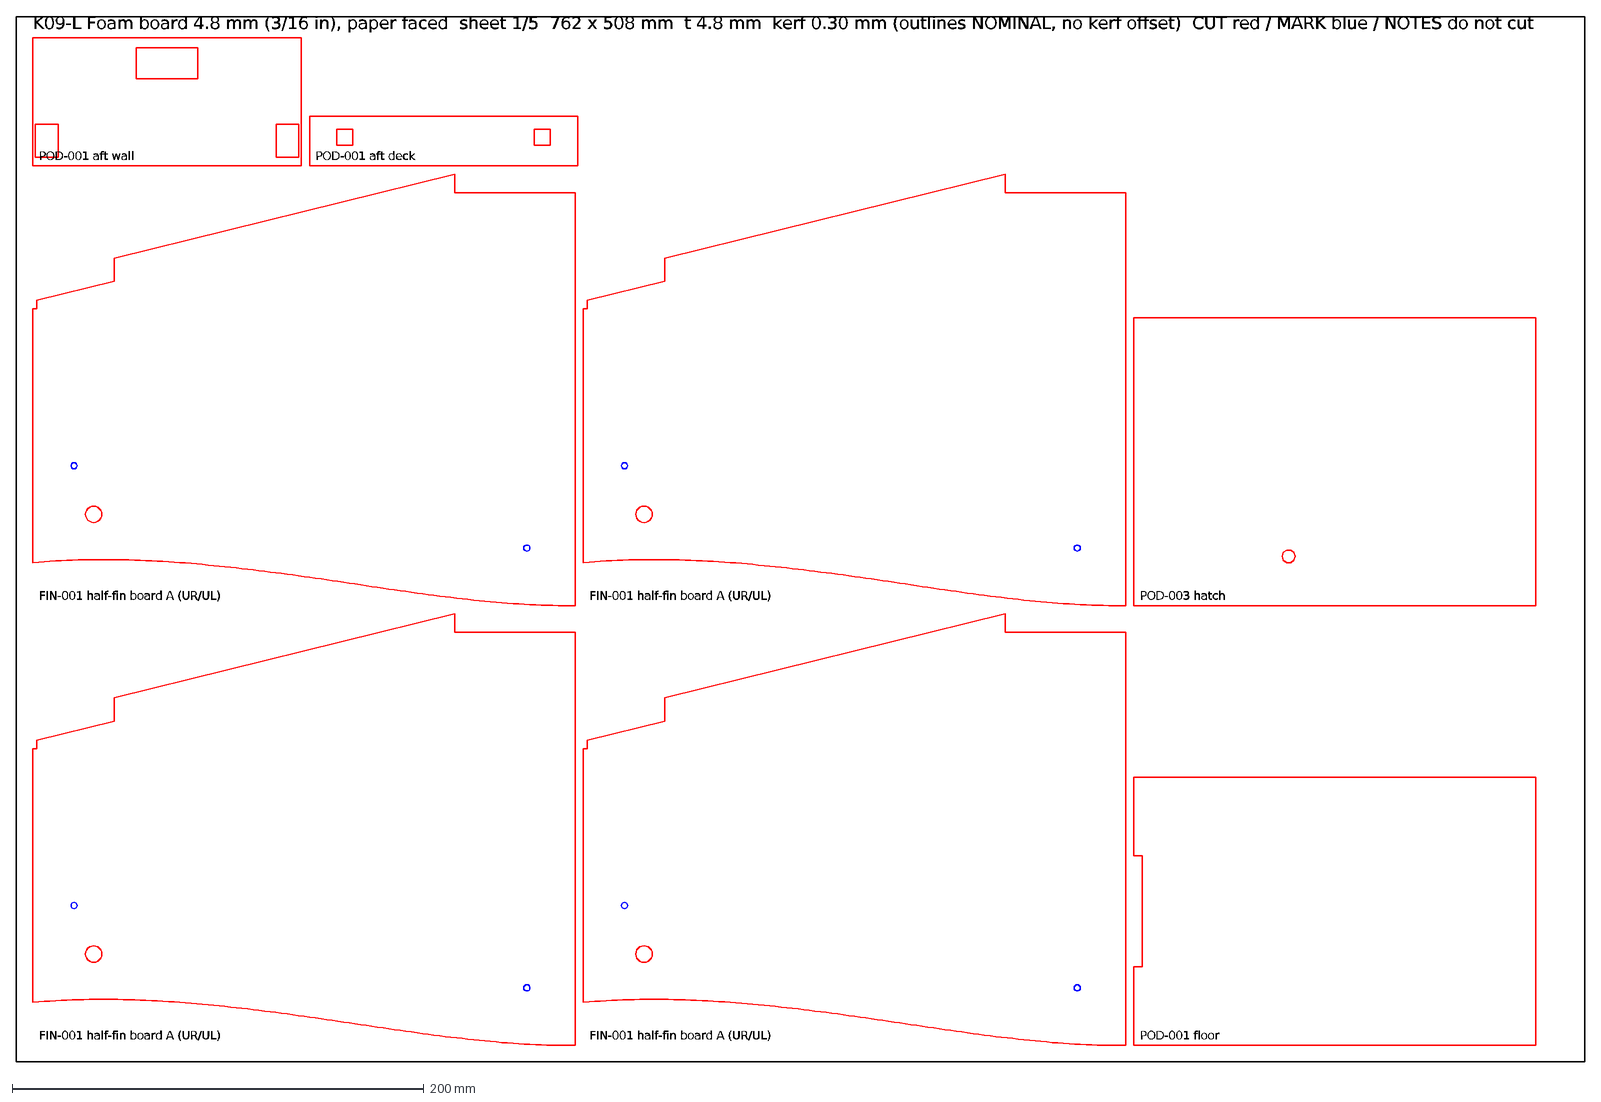
[picture p109: CAD file, 2026-11-12]
redesign/manufacturing/out/laser/foamboard_sheet1of5.dxf
K09-L Foam board 4.8 mm (3/16 in), paper faced sheet 1/5 762 x 508 mm t 4.8 mm kerf 0.30 mm (outlines NOMINAL, no kerf offset) CUT red / MARK blue / NOTES do no
FIN-001 half-fin board A (UR/UL)
POD-001 floor
POD-001 aft wall
POD-001 aft deck
POD-003 hatch
