davinciucberkeley-collab/DBF-Combined/redesign/showcase/stl/mechanisms.stl

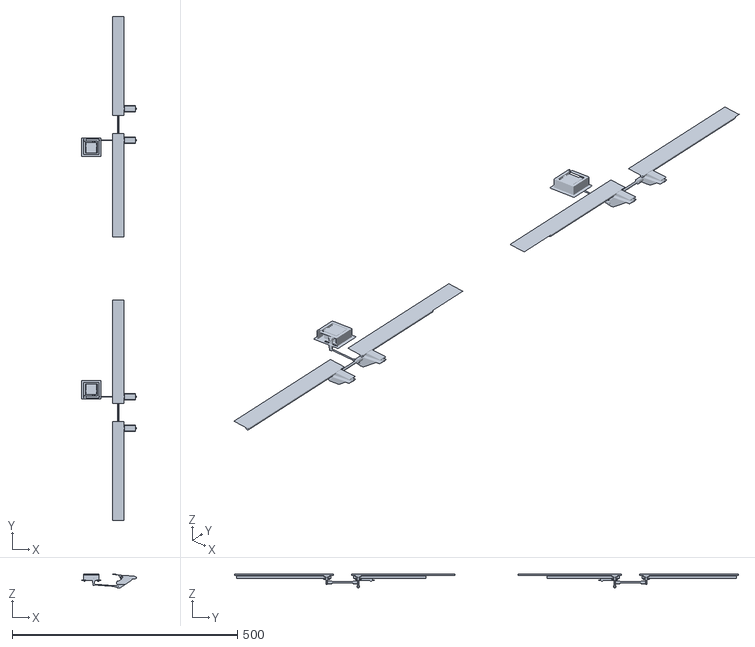
[picture p110: CAD file, 2026-11-13]
redesign/showcase/stl/mechanisms.stl
121.3 x 1120.0 x 30.9
