davinciucberkeley-collab/DBF-Combined/cad/mesh/N02_M5_Nylock.STL

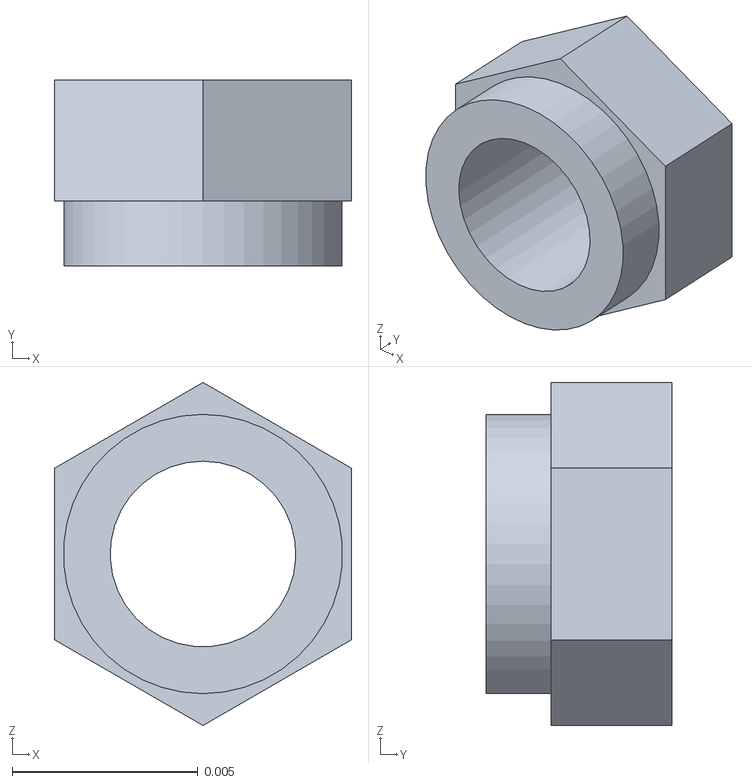
[picture p111: CAD file, 2026-11-09]
cad/mesh/N02_M5_Nylock.STL
0.008 x 0.005 x 0.00924
