davinciucberkeley-collab/DBF-Combined/redesign/manufacturing/out/hotwire/WNG-001_template_tip.dxf

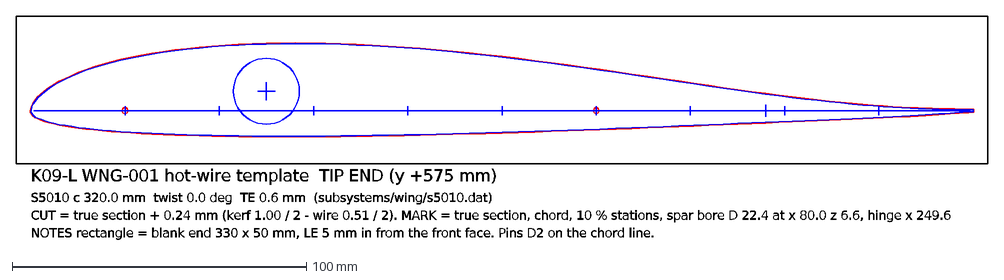
[picture p112: CAD file, 2026-11-11]
redesign/manufacturing/out/hotwire/WNG-001_template_tip.dxf
K09-L WNG-001 hot-wire template TIP END (y +575 mm)
S5010 c 320.0 mm twist 0.0 deg TE 0.6 mm (subsystems/wing/s5010.dat)
CUT = true section + 0.24 mm (kerf 1.00 / 2 - wire 0.51 / 2). MARK = true section, chord, 10 % stations, spar bore D 22.4 at x 80.0 z 6.6, hinge x 249.6
NOTES rectangle = blank end 330 x 50 mm, LE 5 mm in from the front face. Pins D2 on the chord line.
