davinciucberkeley-collab/DBF-Combined/redesign/showcase/stl/avionics.stl

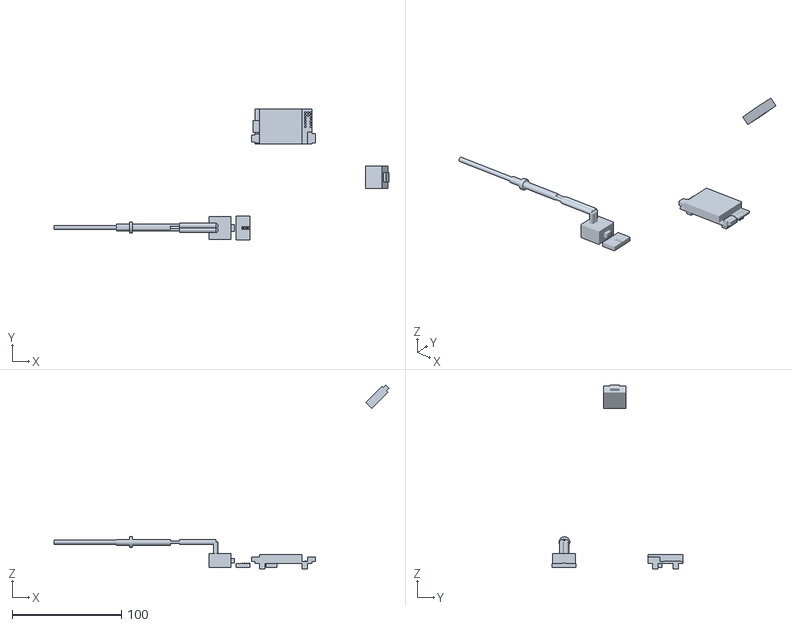
[picture p114: CAD file, 2026-11-13]
redesign/showcase/stl/avionics.stl
306.5 x 119.7 x 168.0
