davinciucberkeley-collab/DBF-Combined/cad/mesh/Fuselage_Pod.STL

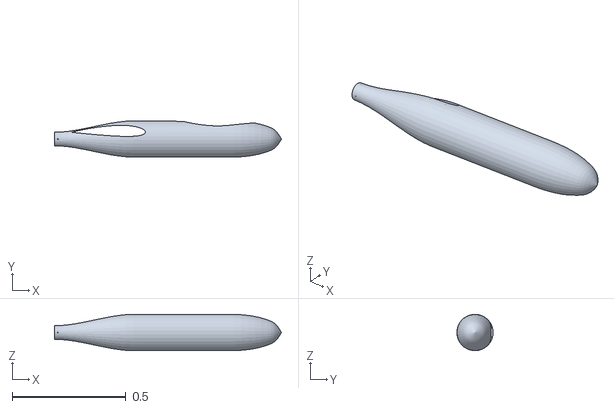
[picture p115: CAD file, 2026-11-09]
cad/mesh/Fuselage_Pod.STL
1.00 x 0.16 x 0.16
