davinciucberkeley-collab/DBF-Combined/redesign/showcase/stl/harness.stl

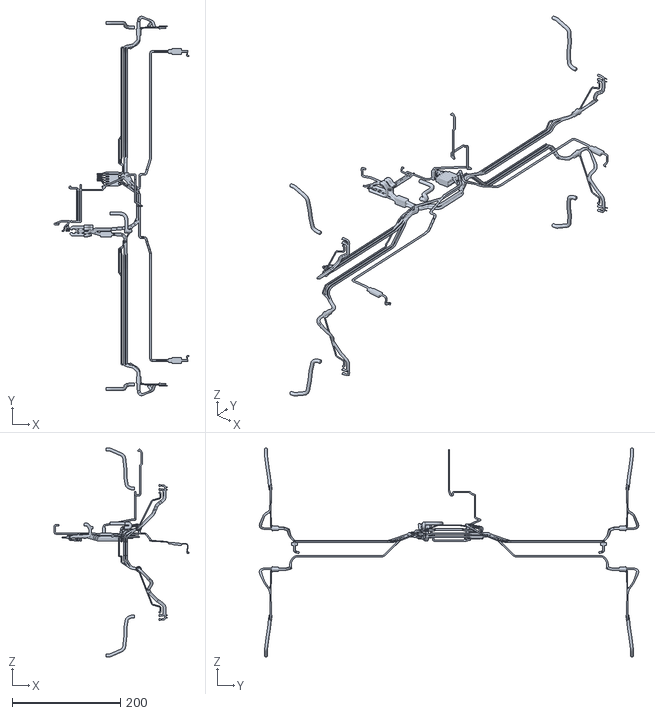
[picture p117: CAD file, 2026-11-13]
redesign/showcase/stl/harness.stl
248.5 x 700.0 x 385.4
