davinciucberkeley-collab/DBF-Combined/redesign/manufacturing/out/laser/foamboard_sheet3of5.dxf

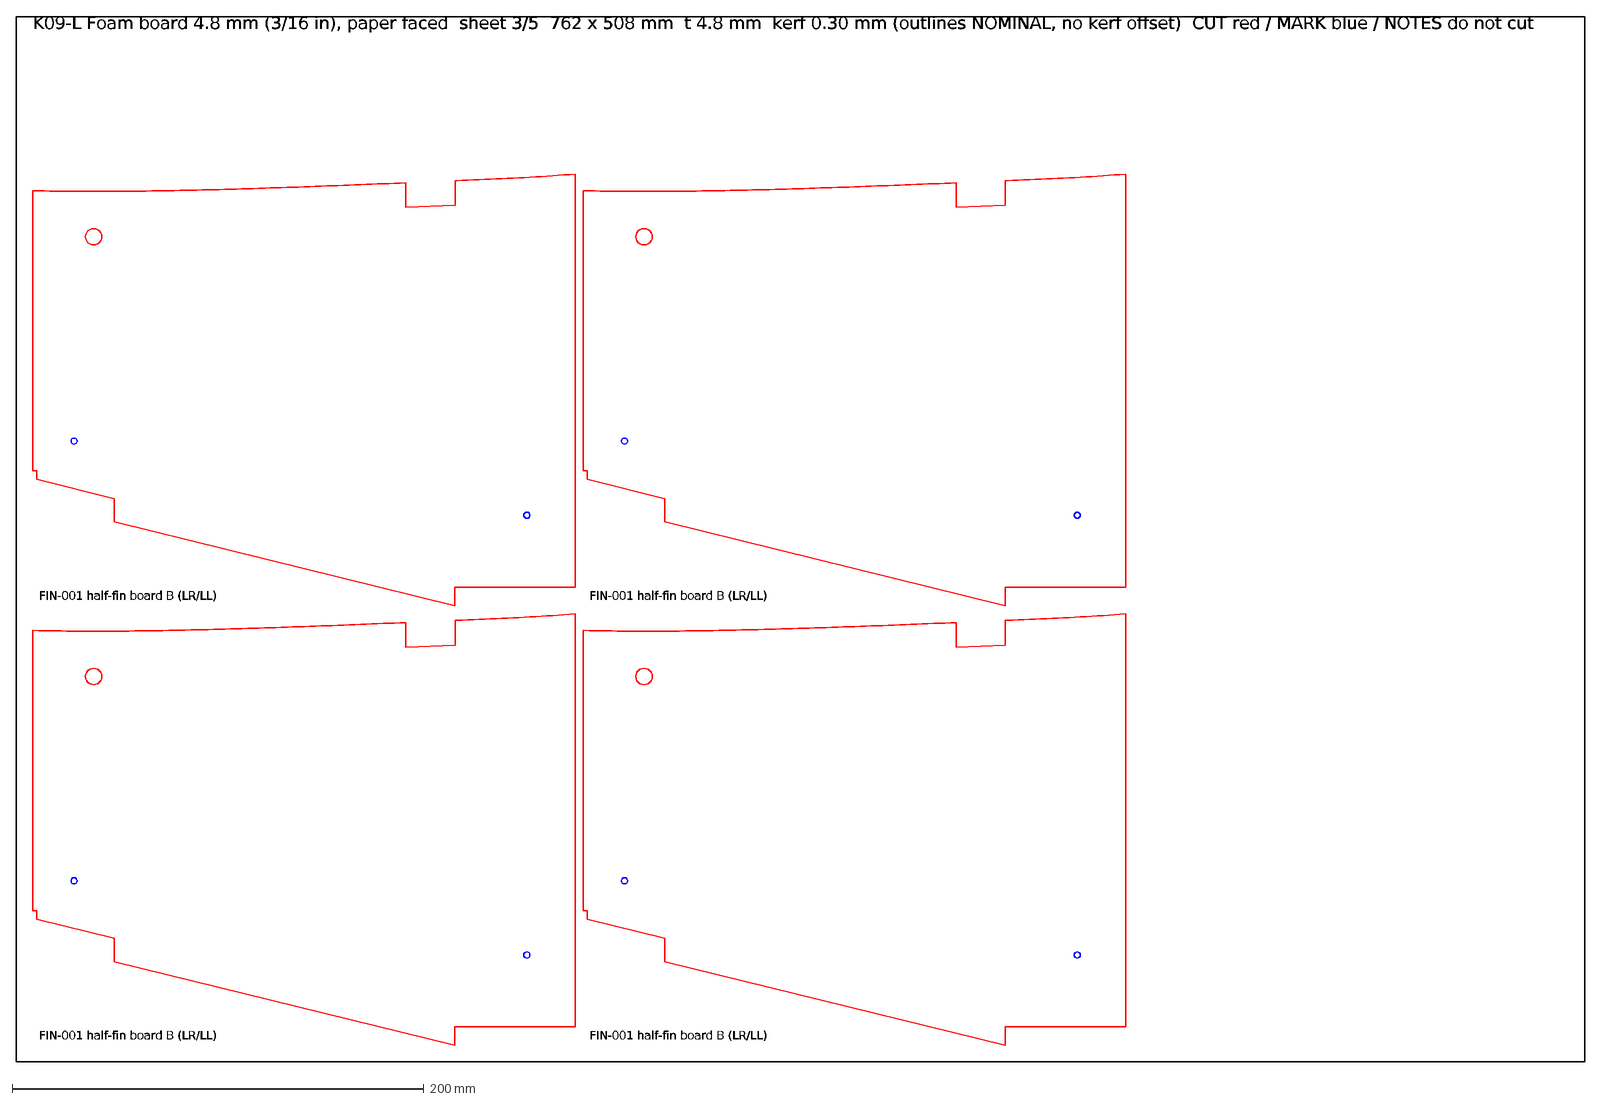
[picture p118: CAD file, 2026-11-12]
redesign/manufacturing/out/laser/foamboard_sheet3of5.dxf
K09-L Foam board 4.8 mm (3/16 in), paper faced sheet 3/5 762 x 508 mm t 4.8 mm kerf 0.30 mm (outlines NOMINAL, no kerf offset) CUT red / MARK blue / NOTES do no
FIN-001 half-fin board B (LR/LL)
