davinciucberkeley-collab/DBF-Combined/redesign/showcase/stl/power.stl

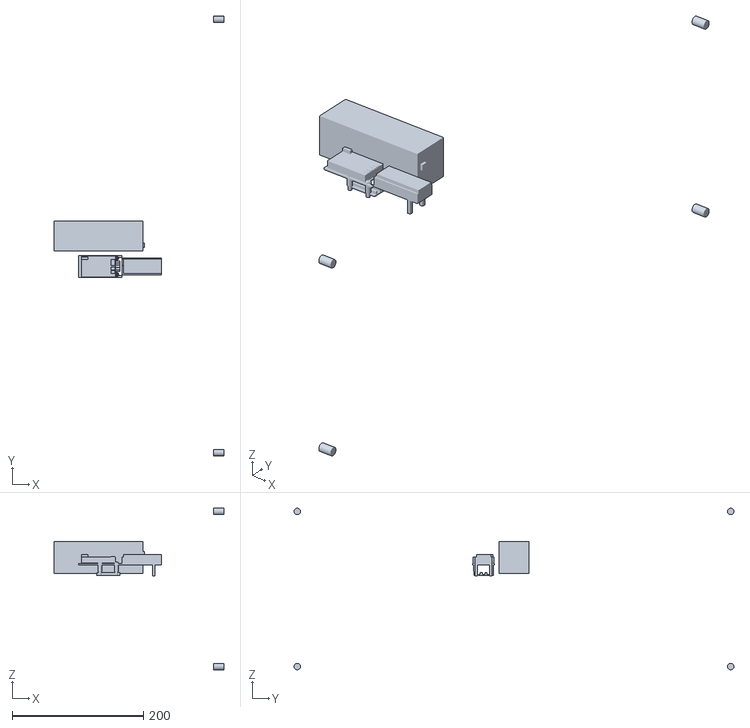
[picture p119: CAD file, 2026-11-13]
redesign/showcase/stl/power.stl
258.5 x 669.6 x 246.0
