davinciucberkeley-collab/DBF-Combined/cad/mesh/Battery_Tray.STL

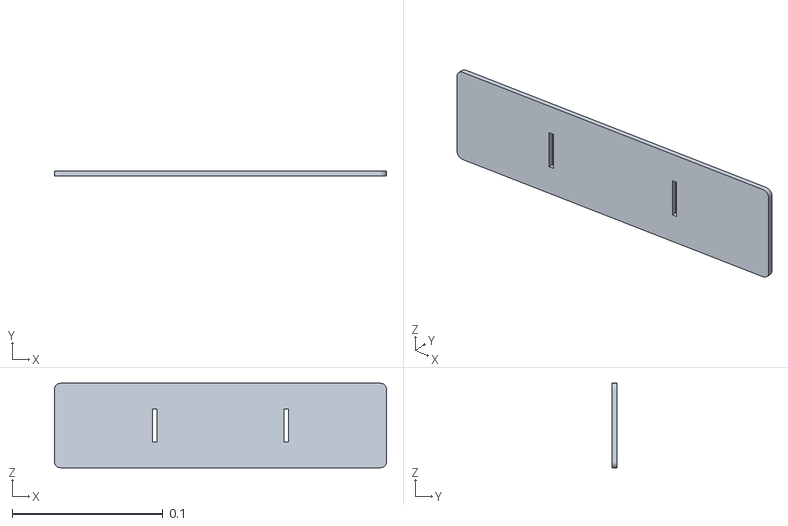
[picture p120: CAD file, 2026-11-09]
cad/mesh/Battery_Tray.STL
0.22 x 0.003 x 0.056
