davinciucberkeley-collab/DBF-Combined/cad/mesh/Lift_Motor.STL

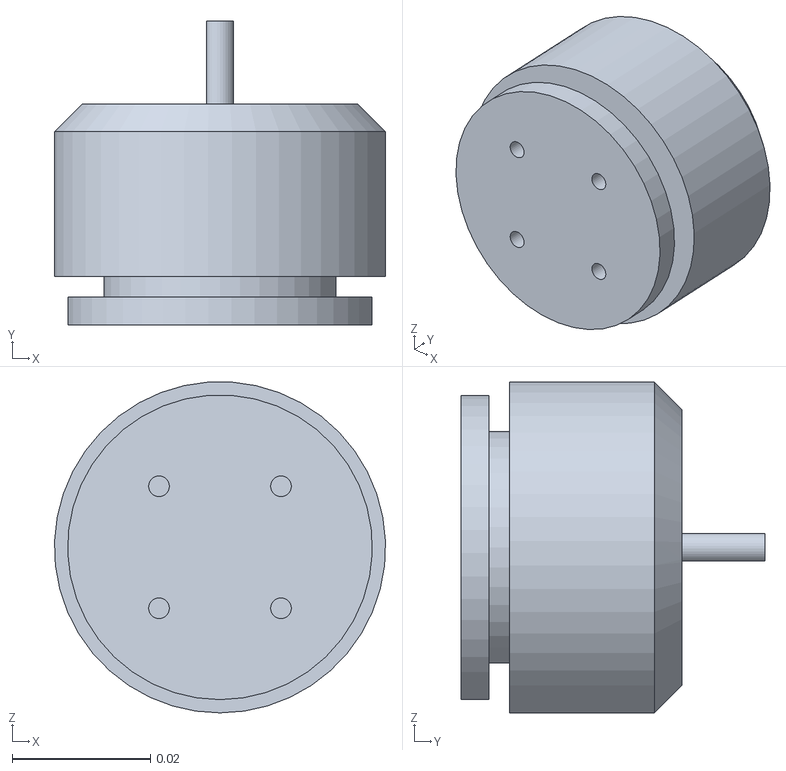
[picture p121: CAD file, 2026-11-09]
cad/mesh/Lift_Motor.STL
0.048 x 0.044 x 0.0479
