davinciucberkeley-collab/DBF-Combined/redesign/showcase/stl/wing.stl

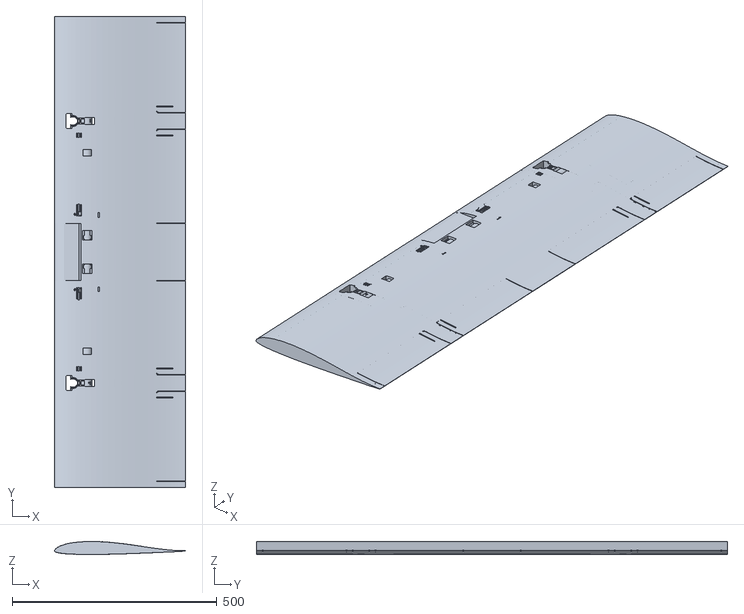
[picture p122: CAD file, 2026-11-13]
redesign/showcase/stl/wing.stl
320.3 x 1150.4 x 32.0
