davinciucberkeley-collab/DBF-Combined/cad/mesh/Spar_Collar.STL

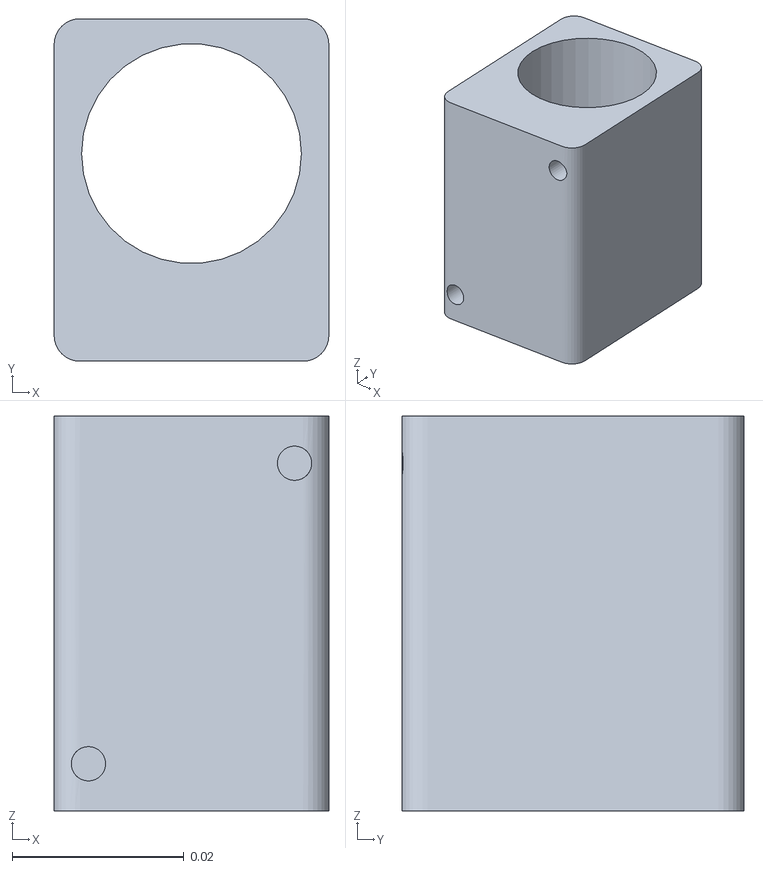
[picture p123: CAD file, 2026-11-09]
cad/mesh/Spar_Collar.STL
0.032 x 0.0399 x 0.046
