davinciucberkeley-collab/DBF-Combined/redesign/showcase/stl/transport.stl

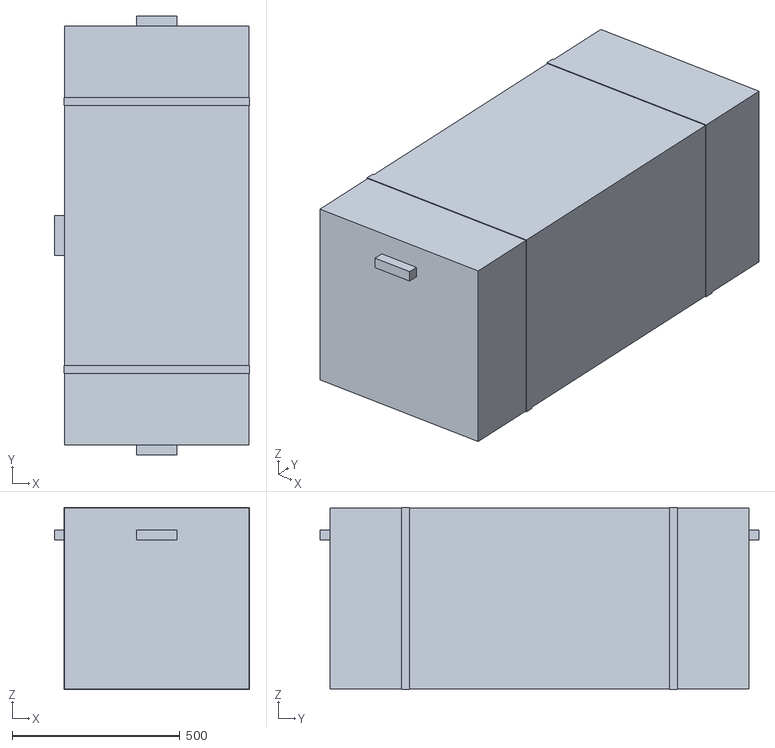
[picture p124: CAD file, 2026-11-13]
redesign/showcase/stl/transport.stl
582.0 x 1310.0 x 544.0
