davinciucberkeley-collab/DBF-Combined/redesign/manufacturing/out/laser/foamboard_sheet5of5.dxf

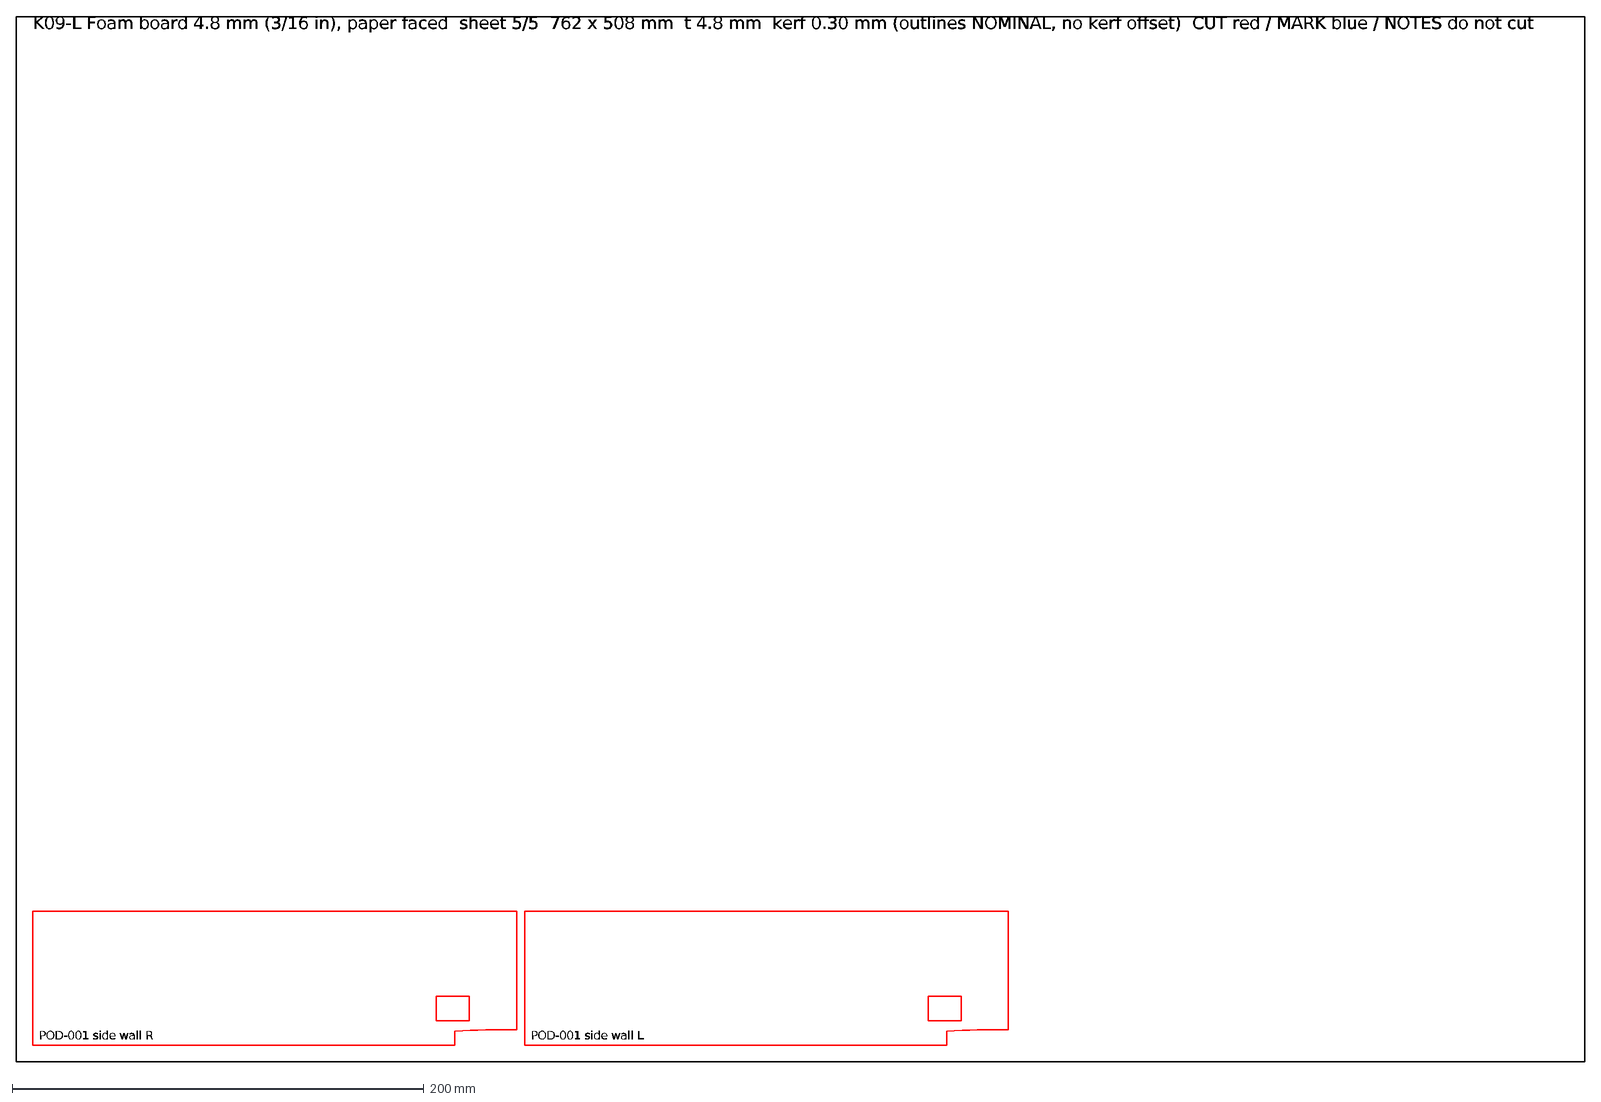
[picture p126: CAD file, 2026-11-11]
redesign/manufacturing/out/laser/foamboard_sheet5of5.dxf
K09-L Foam board 4.8 mm (3/16 in), paper faced sheet 5/5 762 x 508 mm t 4.8 mm kerf 0.30 mm (outlines NOMINAL, no kerf offset) CUT red / MARK blue / NOTES do no
POD-001 side wall R
POD-001 side wall L
