davinciucberkeley-collab/DBF-Combined/redesign/showcase/stl/propulsion.stl

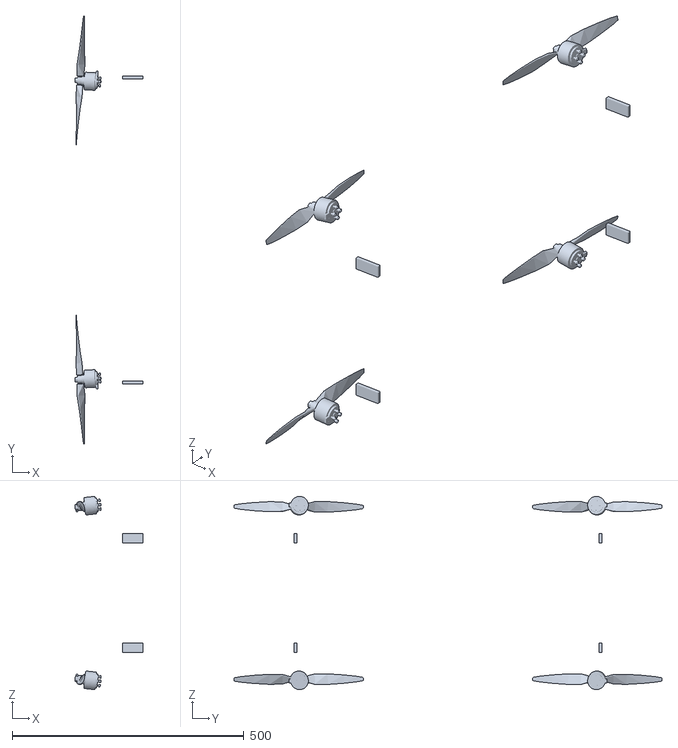
[picture p127: CAD file, 2026-11-13]
redesign/showcase/stl/propulsion.stl
147.3 x 923.6 x 417.1
