davinciucberkeley-collab/DBF-Combined/cad/mesh/Pushrod_Aileron.STL

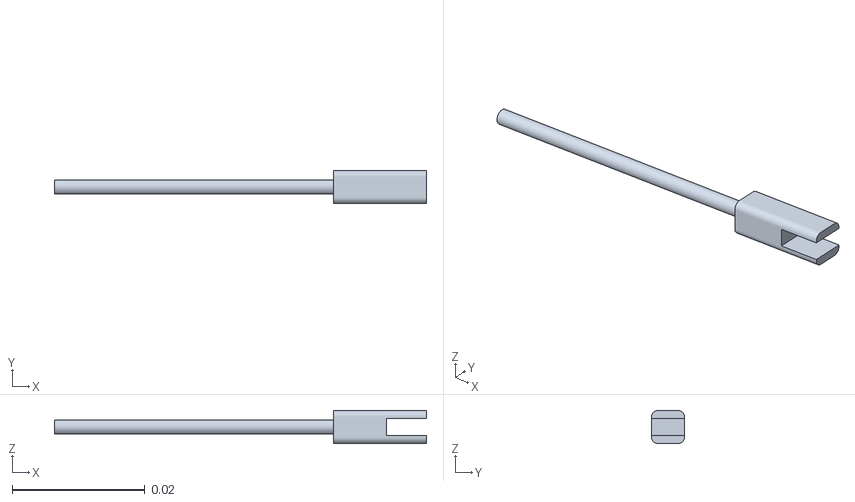
[picture p128: CAD file, 2026-11-09]
cad/mesh/Pushrod_Aileron.STL
0.056 x 0.005 x 0.005
