davinciucberkeley-collab/DBF-Combined/redesign/showcase/stl/pod.stl

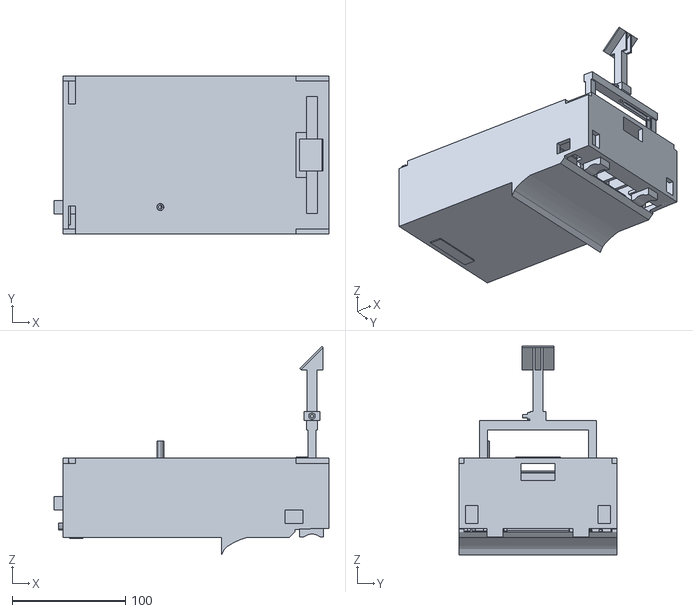
[picture p129: CAD file, 2026-11-13]
redesign/showcase/stl/pod.stl
243.0 x 140.0 x 184.3
