davinciucberkeley-collab/DBF-Combined/cad/mesh/F02_M3x16_SHCS.STL

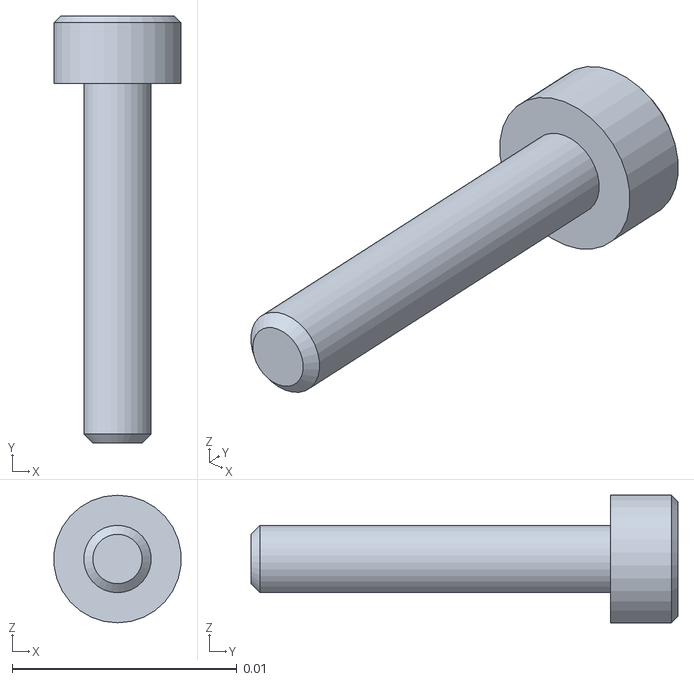
[picture p130: CAD file, 2026-11-09]
cad/mesh/F02_M3x16_SHCS.STL
0.00565 x 0.019 x 0.00568
