davinciucberkeley-collab/DBF-Combined/(list of files, cad)

Other CAD files:
cad/model/VTOL_Exploded.SLDASM
cad/model/FC_Tray.SLDPRT
cad/sim/THERM_Lift_Motor.SLDPRT
cad/sim/thermal/THERM_Pusher.SLDPRT
concepts/variants/a1/fusion/a1.step
concepts/variants/a1/fusion/kinematics/Tip_Prop_Set_L.stl
concepts/variants/a1/fusion/stl/Fuselage_Pod.stl
concepts/variants/a2/fusion/a2.step
concepts/variants/a2/fusion/kinematics/Canopy.stl
concepts/variants/a2/fusion/stl/RX1.stl
concepts/variants/a3/fusion/a3.step
concepts/variants/a3/fusion/stl/Lift_Nacelle_L1.stl
explorations/tiltwing/cad/cruise_tilt0/Tail_Tilt_Spar.stl
explorations/tiltwing/cad/hover_tilt90/H_Tail_NACA0009.stl
inventory/fusion/kinematics/Arm_Aileron_R.stl
inventory/fusion/stl/J-29_ESC_mounting_lift_L.stl
inventory/fusion/VTOL_Fusion.step
inventory/v031/cad/mesh/Fuselage_Pod.STL
redesign/manufacturing/out/jigs/JIG-02_PETG_x4.stl
redesign/manufacturing/out/print/PWR-006_PETG_x1.stl
tools/opencae-studio/opencae/tests/data/geometry/wing_s1223_half.step
cad/model/Pushrod_Rudder.SLDPRT
cad/sim/FEA_Boom_Arm.SLDPRT
cad/sim/thermal/THERM_Pod.SLDPRT
concepts/variants/a1/fusion/kinematics/Tip_Prop_Set_R.stl
concepts/variants/a1/fusion/stl/Nacelle_Mount_R.stl
concepts/variants/a2/fusion/kinematics/Battery_6S_LiPo.stl
concepts/variants/a2/fusion/stl/J-A2-01_Tail_joint_inserts.stl
concepts/variants/a3/fusion/kinematics/Lift_Prop_L4.stl
concepts/variants/a3/fusion/stl/Motor_Mount_1.stl
explorations/tiltwing/cad/cruise_tilt0/Tail_Prop_2.stl
explorations/tiltwing/cad/hover_tilt90/Wing_Prop_4.stl
inventory/fusion/kinematics/Pushrod_Aileron_L.stl
inventory/fusion/stl/JB_J1_L.stl
inventory/v031/cad/mesh/Pusher_Prop_14in.STL
redesign/manufacturing/out/jigs/JIG-03-B_PETG_x2.stl
redesign/manufacturing/out/print/MEC-008-B_PETG_x2.stl
cad/model/Pusher_Motor.SLDPRT
cad/sim/FEA_Spar_Joiner.SLDPRT
cad/sim/thermal/THERM_Lift_Unit.SLDPRT
concepts/variants/a1/fusion/stl/Tip_Tube_Ext_R.stl
concepts/variants/a2/fusion/kinematics/Pusher_Prop_Set.stl
concepts/variants/a2/fusion/stl/J-26_FC_stack_on_avionics_deck_deck_on_formers.stl
concepts/variants/a3/fusion/stl/Motor_Mount_3.stl
explorations/tiltwing/cad/cruise_tilt0/Wing_Prop_4.stl
explorations/tiltwing/cad/hover_tilt90/Wing_Tilt_Spar.stl
inventory/fusion/kinematics/Wheel_RL.stl
inventory/fusion/stl/Hinge_Elevator.stl
inventory/v031/cad/mesh/Gear_Clamp.STL
redesign/manufacturing/out/jigs/JIG-03-A_PETG_x2.stl
redesign/manufacturing/out/print/MEC-008-A_PETG_x2.stl
cad/model/Fin_Shoe.SLDPRT
cad/sim/thermal/THERM_Motor_Only.SLDPRT
concepts/variants/a1/fusion/stl/Tip_Connectors_L.stl
concepts/variants/a2/fusion/stl/RID1.stl
concepts/variants/a3/fusion/stl/Reed_L2.stl
explorations/tiltwing/cad/cruise_tilt0/Wing_Tilt_Spar.stl
explorations/tiltwing/cad/hover_tilt90/Tail_Prop_2.stl
inventory/fusion/kinematics/Arm_Aileron_L.stl
inventory/fusion/stl/J-05_Rear_boom_clamp_R.stl
inventory/v031/cad/mesh/Pitot_Tube.STL
redesign/manufacturing/out/jigs/JIG-01_PETG_x2.stl
redesign/manufacturing/out/print/HRN-110-B_ASA_x3.stl
cad/model/Boom_Rear_Stub.SLDPRT
concepts/variants/a1/fusion/stl/Pod_Aft_Cap.stl
concepts/variants/a2/fusion/stl/XT90S_1.stl
concepts/variants/a3/fusion/kinematics/Lift_Prop_L2.stl
concepts/variants/a3/fusion/stl/Reed_Wire_L1.stl
explorations/tiltwing/cad/cruise_tilt0/Tail_Nacelle_1.stl
explorations/tiltwing/cad/hover_tilt90/TiltWing_hover_tilt90.step
inventory/fusion/kinematics/Lift_Prop_L2.stl
inventory/fusion/stl/ESC_L4.stl
inventory/v031/cad/mesh/Wing_Panel_R.STL
redesign/manufacturing/out/laser/coroplast_sheet1of2.dxf
redesign/manufacturing/out/print/MEC-004-A_PETG_x2.stl
cad/model/Tail_Clamp_Cap.SLDPRT
concepts/variants/a1/fusion/stl/Tip_Tube_Ext_L.stl
concepts/variants/a3/fusion/stl/Reed_Wire_L2.stl
explorations/tiltwing/cad/cruise_tilt0/Wing_Nacelle_1.stl
explorations/tiltwing/cad/hover_tilt90/Wing_Nacelle_2.stl
inventory/fusion/kinematics/Pushrod_Rudder_L.stl
inventory/fusion/stl/J-02_Wing_saddle_pod_R.stl
inventory/v031/cad/mesh/Aileron_R.STL
redesign/manufacturing/out/laser/coroplast_sheet2of2.dxf
redesign/manufacturing/out/print/MEC-006-A_PETG_x2.stl
cad/model/Battery_Tray.SLDPRT
concepts/variants/a1/fusion/stl/Nacelle_Mount_L.stl
concepts/variants/a2/fusion/stl/Fuselage_Pod.stl
concepts/variants/a3/fusion/kinematics/Lift_Cap_L1.stl
concepts/variants/a3/fusion/stl/Magnet_Fix_L2.stl
explorations/tiltwing/cad/cruise_tilt0/Wing_Nacelle_4.stl
explorations/tiltwing/cad/hover_tilt90/Tail_Nacelle_2.stl
inventory/fusion/kinematics/Arm_Rudder_R.stl
inventory/fusion/stl/Boom_Front_1.stl
inventory/v031/cad/mesh/Landing_Leg.STL
redesign/manufacturing/out/laser/ply3_sheet2of2.dxf
redesign/manufacturing/out/print/FIN-010-C_PETG_x1.stl
cad/model/Horn_Backplate.SLDPRT
concepts/variants/a2/fusion/stl/Tail_connectors.stl
concepts/variants/a3/fusion/kinematics/Lift_Prop_L1.stl
concepts/variants/a3/fusion/stl/Reed_L1.stl
explorations/tiltwing/cad/cruise_tilt0/Wing_S1223.stl
explorations/tiltwing/cad/hover_tilt90/Wing_S1223.stl
inventory/fusion/kinematics/Elevator.stl
inventory/fusion/stl/Boom_Rear_Stub_2.stl
inventory/v031/cad/mesh/Battery_6S_LiPo.STL
redesign/manufacturing/out/print/FIN-010-A_PETG_x1.stl
cad/model/Pushrod_Aileron.SLDPRT
concepts/variants/a1/fusion/stl/Pitot_Tube.stl
concepts/variants/a2/fusion/stl/W15x_phase_extension.stl
concepts/variants/a3/fusion/kinematics/Lift_Cap_L2.stl
concepts/variants/a3/fusion/stl/Reed_Wire_L4.stl
explorations/tiltwing/cad/cruise_tilt0/Tail_Nacelle_2.stl
explorations/tiltwing/cad/hover_tilt90/Wing_Prop_3.stl
inventory/fusion/kinematics/Pusher_Prop_Set.stl
inventory/fusion/stl/JB_J2_R.stl
inventory/v031/cad/mesh/Boom_Rear_Stub.STL
redesign/manufacturing/out/laser/ply3_sheet1of2.dxf
redesign/manufacturing/out/print/MEC-006-B_PETG_x2.stl
cad/model/Lift_Prop.SLDPRT
concepts/variants/a1/fusion/stl/W_TIP_R_pod.stl
concepts/variants/a2/fusion/stl/J-29_ESC_mounting_lift_ESCs_on_boom_outboard_faces__C_.stl
concepts/variants/a3/fusion/kinematics/Lift_Cap_L4.stl
concepts/variants/a3/fusion/stl/Motor_Mount_2.stl
explorations/tiltwing/cad/cruise_tilt0/H_Tail_NACA0009.stl
cad/drawings/DBF-DRW-001.SLDDRW
cad/mesh/Aileron_L.STL
cad/mesh/Aileron_R.STL
cad/mesh/Battery_6S_LiPo.STL
cad/mesh/Bolt_Pillar.STL
cad/mesh/Boom_Clamp_F_Lower.STL
cad/mesh/Boom_Clamp_F_Upper.STL
cad/mesh/Boom_Clamp_R_Lower.STL
cad/mesh/Boom_Clamp_R_Upper.STL
cad/mesh/Boom_Front.STL
cad/mesh/Boom_Rear_Stub.STL
cad/mesh/Canopy.STL
cad/mesh/Control_Horn.STL
cad/mesh/Crush_Sleeve.STL
cad/mesh/Elevator.STL
cad/mesh/F01_M3x8_SHCS.STL
cad/mesh/F03_M3x20_SHCS.STL
cad/mesh/F04_M3x40_SHCS.STL
cad/mesh/F05_M3x30_SHCS.STL
cad/mesh/F06_M3x35_SHCS.STL
cad/mesh/F07_M3x8_BHCS.STL
cad/mesh/F08_M3x12_SHCS.STL
cad/mesh/F09_M5x20_BHCS.STL
cad/mesh/F09_M5x25_BHCS.STL
cad/mesh/F10_M2x10_SHCS.STL
cad/mesh/F11_M2x14_PAN.STL
cad/mesh/F13_M3x8_SHCS.STL
cad/mesh/FC_Tray.STL
cad/mesh/Fin.STL
cad/mesh/Fin_Shoe.STL
cad/mesh/Gear_Clamp_Lower.STL
cad/mesh/Gear_Clamp_Upper.STL
cad/mesh/Gear_Fairing.STL
cad/mesh/H_Tail.STL
cad/mesh/Horn_Backplate.STL
cad/mesh/Horn_Hardpoint.STL
cad/mesh/I01_M3_Insert.STL
cad/mesh/Joiner_Stop.STL
cad/mesh/Landing_Leg.STL
cad/mesh/Lift_Prop.STL
cad/mesh/Motor_Mount_Cap.STL
cad/mesh/Motor_Mount_Upper.STL
cad/mesh/N01_M3_Nylock.STL
cad/mesh/N03_M2_Hex_Nut.STL
cad/mesh/N04_M6_Bullet_Nut.STL
cad/mesh/Part12.STL
cad/mesh/Part5.STL
cad/mesh/Pitot_Clamp.STL
cad/mesh/Prop_Plate.STL
cad/mesh/Prop_Washer.STL
cad/mesh/Pusher_Adapter.STL
cad/mesh/Pusher_Cup.STL
cad/mesh/Pusher_Motor.STL
cad/mesh/Pusher_Prop_14in.STL
cad/mesh/Pushrod_Elevator.STL
cad/mesh/Pushrod_Rudder.STL
cad/mesh/Rear_Hardpoint.STL
cad/mesh/Root_Tongue.STL
cad/mesh/Rudder.STL
cad/mesh/Servo.STL
cad/mesh/Servo_Tray.STL
cad/mesh/Spar_Tube.STL
cad/mesh/Splice_Plug.STL
cad/mesh/Tail_Clamp_Cap.STL
cad/mesh/Tail_Clamp_Upper.STL
cad/mesh/W01_M3_Washer.STL
cad/mesh/Wing_Joiner.STL
cad/mesh/Wing_Panel_L.STL
cad/mesh/Wing_Panel_R.STL
cad/mesh/Wing_Saddle.STL
cad/model/Aileron_L.SLDPRT
cad/model/Aileron_R.SLDPRT
cad/model/Battery_6S_LiPo.SLDPRT
cad/model/Bolt_Pillar.SLDPRT
cad/model/Boom_Clamp_F_Lower.SLDPRT
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
