davinciucberkeley-collab/DBF-Combined/redesign/review/WIRING-BATTERY.md

# K09-L build review: wiring, power distribution and battery

Reviewer: electrical integration ("how would we actually build this?"), 2026-11-11, branch `redesign/v1`.
Scope: pack bay and retention, AS150U, power stack, bus board, UBEC and fuse, ESC leads and caps, the wing and fin
grooves, phase splices, FC, GPS and compass, RX, airspeed and pitot line. Sources: `subsystems/{harness,power,avionics,pod}/`,
`team/F1..F4, E2, E3, D2`, `params/params.json`, `params/CHANGE-LOG.md`, the three showcase renders and `hover-pose.png`.
I did not make new Blender renders: the showcase renders and the CAD coordinates in the SPECs were enough for these
findings. Every number below is quoted from the repo or a cited web source, or it is labelled as my estimate (`REVIEWER EST`).

## Verdict

The electrical design is careful on paper and mostly right on gauges: 10 AWG mains, 16 AWG ESC leads at an 8.4 A
hover share, an AS150U rated well above the 30.3 A continuous need, a cap at every ESC, and no solder joints buried in
the foam grooves (every splice sits on a fin face or in the pod). Building it is the weak part. Four things stop me from
handing it to a student crew as written:

- **The CoreWing stack split is unproven.** The pod's power layout assumes the CoreWing power board separates from the
  FC and talks to it over a 6-pin GH link without Vx, with outputs on FC pads. None of that is published, and the
  cited sources disagree even on the servo BEC rating.
- **The two BUILD files contradict each other** on when the ESC leads are soldered to the bus bars.
- **The wing-fin harness has no disconnect.** One lead fault or one broken fin means peeling the skin tape and
  desoldering 10 AWG and 8 AWG joints inside a foam-board pod.
- **The only safety disconnect sits inside the hatch.** It is a stiff connector in a cradle hung on nylon screws, and
  it is also the only post-crash kill on an unfused pack.

Buy one CoreWing V2, one ESC 4-pack and one pack now and measure them. Add a connector per ESC pair inside the pod.
Put the AS150U on a short flying pigtail. Then the pod CAD can be frozen for FEA. Wire gauge, voltage drop and compass
interference do not need more analysis before CFD/FEA. They need bench tests that are already planned.

## Findings

| ID | Severity | Component | Problem | Evidence | Changes CFD/FEA inputs? | Recommended fix | Cost / time |
|---|---|---|---|---|---|---|---|
| WB-01 | **Blocker** (for freezing the pod CAD) | CoreWing F405 Wing V2 stack, `PWR-003` / `AVN-001`, link `W-PMOD` | The pod power architecture rests on unverified board facts. It assumes all of these: the power board separates, its outline is ≤ 42 × 32 × 9 mm, a JST-GH 6 link to the FC exists, Vx can be left off that link, PWM outputs are pads on the FC top board, and the servo BEC is 4.5 A, which is why the UBEC is there. The CoreWing manual says its PDB pin definitions differ from the SpeedyBee F405 Wing APP. F1's separation argument leans on the SpeedyBee layout. The Banggood kit list includes a 90° 3 × 12 PWM header, and which board carries it is not published. | `subsystems/power/SPEC.md` open issues (CR-F1-21); `team/F1/POWER.md` § "does it separate?" (outline assumed 52 × 32, deck takes 42); `harness/SPEC.md` open issue 2 (pin-out unpublished, ports ±10 mm); ArduPilot CoreWing page (servo BEC 8 A cont / 14 A peak, 5/6/7.2 V; 470 µF 35 V input cap "should be installed"); Banggood listing (servo BEC "4A sustained, 14A peak"; 3 × 12 PWM header; current sense 90 A / 125 A peak vs ArduPilot 215 A) | **Yes.** Pod FEA (C3): if the PDB is 52 mm, the deck grows 10 mm forward to x ≈ −0.063 (F1 note), so the frame, PDB plate, bosses and the unplug load case move. Mass and CG roll-up (A3) change if the 28 g EST becomes the 11.4 g listing or the whole stack goes on gel. | Buy one CoreWing V2 "unsoldered pins" kit now and do `T-F3-ARRIVAL` / `T-PWR-ARRIVAL` this month. Photograph both sides and caliper each board. Map which board carries S1–S12, Vx, the current-sense and Vbat pins, and the battery pads. Then decide between the split and the whole stack on gel, and freeze the deck and plate. | $67 already in the BOM (A01), pulled forward. 1 day of bench work. Pod CAD re-run if the outline differs. |
| WB-02 | Major | Bus board `PWR-004` ↔ ESC leads `W-PWR-*`, build order | The two BUILD files disagree. Power BUILD step 5 solders the four 16 AWG pairs to the bars before the frame and deck go on, and the header says this happens "before the harness ESC leads are routed into the wing". Harness BUILD threads the bare pod end of each lead from the fin, because the ESC and cap are soldered on the bench first and cannot pass the Ø 8 mm fin hole or the 7 mm P1 straw. It also says the stack is built and screwed in before harness step 8 solders to the bars. Followed literally, harness step 8 means 8 joints onto 8 AWG bars 11.1 mm under the deck, inside a foam-board and PETG pod, with an 80–100 W iron. | `power/BUILD.md` header and steps 5–7; `harness/BUILD.md` header, steps 5, 6, 8; `power/SPEC.md` "deck clear of the bus-bar joints 11.1 mm"; `W-MAIN-2` ties the board on the deck to the bars, so the frame cannot be lifted clear without desoldering | No | Rewrite one sequence: wing and fins → ESCs soldered on the bench → leads routed and taped → bus board soldered **before** the frame goes on. Better still, use the connectors in WB-03 so the bus board is fully soldered on the bench and only plugs are made inside the pod. | 1 h to reconcile the documents. Fixed for good with WB-03. |
| WB-03 | Major | ESC power leads (4 × 16 AWG, 0.475–0.620 m), fin-break repair | There is no disconnect anywhere between the bus bars and the ESC pads. The harness is soldered at both ends on purpose ("no bullet contacts in the propulsion path, −15.6 g"). Replacing a damaged lead means peeling the packing-tape skin over the groove, removing the power frame (4 screws plus a 10 AWG `W-MAIN-2` desolder) and desoldering at the bars inside the pod. Replacing a broken half-fin, a planned failure mode (D-23 "mounts are the fuse"; fins BUILD repair table "half-fin broken … 24 h cure"), means desoldering the 16 AWG pair, cap and DShot splice at the ESC and pulling 0.6 m of lead back through the grommet. | `harness/SPEC.md` removable-joint table and "Soldered on purpose"; `power/BUILD.md` "Service … unsolder ESC leads at the bars"; `fins/BUILD.md` § Repair; `CHANGE-LOG.md` D-23 | No CFD. FEA: no if the connectors sit inside the pod. Pod CAD fit check needed: four plug pairs in the tunnel or exit zone. | Put one keyed 2-pin power connector per ESC pair **inside the pod at the side-wall exits**, with the bus-board side as short pigtails made on the bench. XT60 class is enough: the repo cites Amass XT60 at 35 A continuous, against 8.4 A hover and 24.8 A limited per ESC. DShot already has a JR in-line. Keep the ESC end soldered. Optionally add a second plug at the fin root if fin swaps turn out frequent. The connector adds contact resistance, so re-run `CL-F1-DROP-PEAK` (see WB-11). | Parts < $15 (`REVIEWER EST`). Mass: weigh it. Harness and propulsion are at zero margin, so take it from the reserve. 2 h. Saves many hours on the first repair. |
| WB-04 | Major | Main disconnect AS150U `PWR-002` in the cradle; arming procedure | (a) The pack-to-aircraft disconnect is also the only hardware kill (D-32, D5 "disconnect as the physical safety switch"). It sits inside the pod, under a hatch with a hook tab. When the aircraft stands nose-up, that hatch is vertical and between the upper props (`hover-pose.png`). (b) Mating force is 4–8 kg (D5), pushed into a PETG cradle on 4 × M3 nylon screws at 0.08–0.2 N·m. Those screws go into inserts in a 0.8 mm plate bonded to foam board, and the unplug moment check is RF 1.11 `UNVERIFIED` at a 0.05 MPa allowable. That joint takes the load every flight, and the mating life is 100 cycles. (c) The field card says "Plug in last, after the RC link is up". The RX is powered only from the pack through the FC, so the link cannot be up before the plug goes in. The card does not say what it means. | `pod/SPEC.md` `CL-D2-PDB-PAD-M` 2.16 vs 1.94 N·m; `power/SPEC.md` `E-PWR-01/-03`; `inputs/decisions/D5.md`; `pod/BUILD.md` field card step 4; `power/BUILD.md` "thumb on the cradle when unplugging"; requirement D8 (`config-study/requirements/REQUIREMENTS.md`) | **Yes** (pod FEA): the 1.94 N·m unplug load case on the PDB plate goes away if the cradle goes. | Put the aircraft half on a ~0.10 m 10 AWG flying pigtail. F1 already accepts this gauge and length for the pack's own lead: 16.4 °C ≤ 20 °C, `CL-F1-PACKLEAD-RISE`. Park the pigtail in a light clip so it can be mated two-handed with no load on the frame. Rewrite the card as "transmitter on, model selected, throttle down, then plug; arm only from the RC switch; e-stop `RC9_OPTION 31` checked". Add a post-crash line: "approach from behind the pod, open the hatch, pull the plug". | $0. 1 h. F1 relaxes its "never extend the jumpers" rule for this lead only. |
| WB-05 | Major | Fusing and post-crash safety | There is no fuse in the propulsion path. I agree with that for flight: a fuse that opens kills a motor. But a crash that cuts or crushes a 16 AWG lead under the wing tape, or at the fin-root grommet, puts a 120C 6500 mAh pack across a dead short inside an XPS-and-tape wing. The only interrupt is behind the hatch (WB-04). | `team/F1/POWER.md` § Protection ("propulsion path fuse: none"); `params.json#battery.pack` (Ovonic 120C) | No | Keep no in-flight fuse. Make the disconnect reachable in seconds (WB-04). Add to the field kit and card: LiPo bag, sand, and a rule to pull the plug before touching the props or fins after any crash. Optionally add a high-rated fuse per ESC branch, well above the 24.8 A limiter and the 51.6 A 2 s burst. Agree on it as a team. | $10–20 field kit (`REVIEWER EST`). Card edit. |
| WB-06 | Major | Pack station: spacer stack and crush block per pack | Each pack needs its own spacer colours and its own block length: 16 / 14 / 8 mm stacks; blocks of 26.2 / 28.2 / 34.2 mm. Grabbing the wrong set moves the pack by up to 16 mm. 0.55 kg / 2.46–2.6 kg × 16 mm ≈ 3.4–3.6 mm of CG shift (`REVIEWER EST`), against a CG band of 0.0466–0.0514 m (4.8 mm wide, about ±2.4 mm around 0.049). Play inside a correct stack (0.4–1.9 mm) is only ≈ 0.4 mm of CG and does not matter. The crush block is single-use after a nose-in. | `pod/SPEC.md` "Pack on the crush stack" and key numbers; `pod/BUILD.md` step 16; `params.json#cg.x_range_m`; `CHANGE-LOG.md` D-62/D-63 (≈ 2 458 g predicted) | No (CG is A3's roll-up, not CFD) | Make one kit per pack. Velcro or tether the spacer stack and block to that pack, colour-matched to its label. Add a preflight balance check on the CG marks (`T-A3-CG-BALANCE` per pack). Replace and re-cut the block after any nose-first hit. | $0. 10 min per pack. |
| WB-07 | Major | ESC caps `PWR-008` and the FC input cap | (a) The 680 µF part is unnamed (`EST`, "low-ESR radial 10 × 20 mm"). Its ripple rating has not been checked against F2's bound of 4.2 A RMS hover and 12.4 A max (CR-F2-18 still open). It is rated 25 V on a 16.8 V pack, while the CoreWing kit ships a 35 V part for the same job. (b) The can is foam-taped on the fin face in the prop wash, hanging on 11 mm folded legs. Those legs are the only thing holding it, under vibration and tip strikes. (c) The CoreWing's own 470 µF 35 V input cap, which ArduPilot says "should be installed", appears nowhere in the power stack. Its analog current sensor is noise-sensitive, and the 100 A limiter (`Q_M_BAT_CURR_MAX 100`) depends on it. | `power/params.json#cap_m`; `team/F2/SUMMARY.md` (`CL-F2-CAP-RIPPLE-*`); `CHANGE-LOG.md` CR-F2-18 row; ArduPilot CoreWing page | **Yes, CFD, if the caps are not in the CFD geometry:** a 10 × 20 mm can on each fin's outboard face in the slipstream. Check the B4 / CFD body list. | Specify a named 35 V low-ESR part whose datasheet ripple rating is ≥ the `T-F1-RIPPLE` measurement, or use two in parallel. Bed the can in a dab of silicone or epoxy so the legs carry no load. Fit the supplied 470 µF 35 V at the power-board battery pads. | ≈ $5. Mass +1–3 g (`REVIEWER EST`, weigh). 1 h. |
| WB-08 | Minor | Wing-to-fin and wing-to-pod transitions (strain relief) | At the fin root the lead leaves the groove 12 mm early, climbs over the bead lip and boss, is tied at the lug, passes the Ø 8 mm grommet 22 mm off the skin, and is taped on the fin face. The fin is designed to move or break first in a tip-over (D-23). There is no service loop, so a root crack or mount slip pulls on the ESC pad joints. The pod side exits (16 × 12 mm, PET sleeve, taped edges) are fine: the pod is bonded to the wing, so nothing moves there. | `harness/SPEC.md` routing "Fin root", "Fin face"; `CL-F2-FREE-SPAN` 47 mm ≤ 50 | No | Leave a 20–30 mm service loop on the fin face below the ESC. Add a drop of silicone at the grommet so the lead cannot saw. WB-03 makes a lead replacement cheap. | $0. 15 min per fin. |
| WB-09 | Minor | UBEC `PWR-005` + 5 A fuse `PWR-007` | The UBEC exists because the FC servo BEC was taken as 4.5 A against a required 5.6 A (2 × 2 × 1.4 A stall). ArduPilot's page lists the Wing V2 servo BEC as 8 A continuous / 14 A peak at a selectable 6 V. The Banggood listing says 4 A sustained. The two stalled servos actually draw 2.8 A. The UBEC part is unnamed ("8 A class", `UNVERIFIED`) and overruns its pod zone (CR-D2-27). | `team/F1/POWER.md` § Protection; `power/parts.csv` `PWR-005`; `pod/SPEC.md` open issues; ArduPilot and Banggood sources in WB-01 | No (pod mass −16.5 g if deleted, A3 only) | Decide at arrival (WB-01). If the board's servo BEC, set to 6 V, holds ≥ 5.8 V with both servos stalled (`T-F1-SERVO-STALL`), delete the UBEC, the fuse and two 20 AWG runs. If not, name the UBEC part and give it its own zone. | Possible saving 16.5 g and ≈ $24. 1 h test. |
| WB-10 | Minor | Wing grooves, 16 AWG under packing tape | Groove 3.0 × 3.1 mm, routed by hand with a 3 mm ball-nose. The modelled clearance to the walls and the tape is 0.05–0.35 mm. The silicone OD of the purchased reel has not been measured. A wire standing proud makes tape bumps and chafes. | `ROUTE-CLEARANCE.md` "tight after … 0.05–0.35 mm"; `wing/SPEC.md` groove sizes; `harness/BUILD.md` step 3 | No, unless a wire ends up proud; then it is a small CFD surface item | Caliper the reel OD on arrival. Cut the groove to OD + 0.5 mm with a depth-stop sled on a straightedge. Lay the wire before the tape and run a finger-check along it. | 0 $. 30 min. |
| WB-11 | Minor | Voltage drop on the long ESC leads | At the 100 A limiter the drop to the LR ESC is 4.89 % against F1's own 5 % limit (+2 %). Any connector (WB-03), a cold joint or a longer cut fails it on paper. 16 AWG is correct for heat: 9.2 °C open-groove rise at 8.4 A. The 5 % figure is a choice, not a hardware limit. | `team/F1/POWER.md` "Voltage drop" (`CL-F1-DROP-PEAK`, `-ESC-LEN-ALLOW` 0.643 m) | No (r_ext feeds E1/E2 performance, not CFD/FEA) | Treat 5 % as a guideline. Measure `T-F1-DROP` on the built harness, connectors included. Go to 14 AWG on the two right-hand leads only if the measured drop costs real thrust, and that needs a deeper groove. | 0 $. Test already planned. |
| WB-12 | Minor | Compass (HGLRC M100-5883 on the mast) | F3 estimates interference at 0.075 of the Earth field in hover and 0.247 at 100 A (limit 0.3), with 8.7° of uncorrected heading at hover. The ESC side exits (x 0.056–0.072) and the pod crossing (x 0.085–0.088) sit almost directly under the mast (0.075–0.080, 0, ~0.17–0.18). My dipole check says the separated + / − grooves in the wing are negligible. The pod loop dominates. The chip is listed as QMC5883 by sellers, and F3 lists L or P as unknown. Driver support in Plane 4.7 must be confirmed for whichever it is. | `team/F3/AVIONICS.md` lines 65–67, 91, 99; `CL-F2-GROOVE-MAST` 0.180 m; HGLRC listings | No | Keep every power pair twisted right up to the side exit. Run `COMPASS_MOTCT` current-based compassmot on the stand. Check the chip ID at `T-F3-I2C-SCAN`. If interference exceeds 30 %, raise the mast before re-routing anything. | 0 $. Test planned. |
| WB-13 | Minor | Pitot line (MS4525DO, couplers inside the hatch) | Every set-up means pushing two 40 mm silicone lines onto barbed couplers inside a crowded bay, next to antenna tube B. T/S can be swapped, a line can come off, or it can kink under the hatch. The blow test only proves that T is connected. | `avionics/BUILD.md` steps 5, 7, 8 | No | Use two different coupler sizes or colours so T and S cannot be swapped. Give the lines a short loop clipped to the tie post. Add a card check: cover the static holes, blow on the tip, airspeed rises; then suck on the tip, airspeed reads ≈ 0 or negative. | < $5. 10 min. |
| WB-14 | Minor | Heat in the closed pod | The FC peaks at 54.9 °C (vented mission), 68.3 °C sealed, 68.9 °C hover-only, against an 85 °C limit. The model covers ram air in cruise only. Ground time with the hatch closed (waiting for GPS lock in the sun) is handled only by a "hatch open > 5 min" note. The power board's BECs, the UBEC and the shunt all sit in the same air. | `team/E3/THERMAL.md` lines 53–55, 90–104 | No | Card rule: hatch stays open until the pre-arm checks pass, and close it ≤ 2 min before take-off. Log the FC temperature in the first tethered hover. | 0 $ |
| WB-15 | Minor | Pack access and swap | The bay is 52 mm wide for a 46 mm hard case, and the pack has no lift tab. The block and spreader are loose. If the hatch is opened with the aircraft standing nose-up, they sit on top of the pack and fall out. The 10 AWG pack lead turns back over the aft-stop edge (taped) and the strut ribs into the park within 84 mm. My estimate is 3–5 min per swap: hatch, plug, two straps, block, pack, matching spacers, re-route lead, plug, hatch, pitot lines (`REVIEWER EST`). | `pod/BUILD.md` field card; `WIRE-LIST.csv` `W-PACK` 0.084 m; `hover-pose.png` | No | Add a ribbon lift loop under the pack. Do swaps with the aircraft lying flat on the box cradle. Tether the block (WB-06). Add a PET edge guard on the aft stop. | 0 $. Swap time goes down to roughly 2–3 min (`REVIEWER EST`). |
| WB-16 | Minor | Pack itself (Ovonic 4S 6500 120C hardcase, EC5) | The lead gauge is unpublished. F1 rejects a 12 AWG pack (28.5 °C rise). Listing masses range from 503 to 680 g, and the gate depends on the weigh-in. The re-termination from EC5 to AS150U is a hot job, and the LiPo procedure is written (good). | `params.json#battery.*`; `team/F1/POWER.md` derating table; web listings (no AWG found) | Indirect: mass and CG (A3) | Buy the two packs now. Caliper the leads, weigh, measure IR. | $83 already in the BOM, pulled forward |
| WB-17 | Minor | Current-sense routing (`W-PMOD`, 28 AWG GH-6, 0.175 m under the pack) | The analog current and voltage lines run in the under-pack floor channel, 10 mm from the 16 AWG tunnel. ArduPilot warns that this board's sensor is sensitive to ESC switching noise. `T-F1-SENSOR-CAL` checks it on the bench only (5–30 A clamp). | `WIRE-LIST.csv` `W-PMOD`; `team/F1/POWER.md` tests; ArduPilot CoreWing page | No | Twist the current-sense wire with its ground. Repeat the calibration on the thrust stand with the motors running at 20–40 A. | 0 $ |
| WB-18 | Minor | ESC (LANRC BLHeli_S 45 A, Amazon) and bidirectional DShot | The rpm notch and the rpm cap (CR-B4-06) need Bluejay with bidirectional DShot on outputs 1–4. The ESC's Bluejay layout is unidentified (`SERVO_DSHOT_ESC 1` "UNVERIFIED for Bluejay"). The longest DShot run is 0.674 m of 28 AWG next to the + groove, with a margin of +4 % on an assumed 0.7 m limit. The 45 A rating comes from a seller listing. | `propulsion/parts.csv` `PRP-002`; `K09L.param` lines 46–53; `CL-F2-DSHOT-LEN` | No | Buy one 4-pack now. Identify the MCU and layout, flash Bluejay, and check the bdshot error rate on the CoreWing over a 0.7 m lead (`T-F2-DSHOT`) before the December order. The fallback (Tekko32 AM32) is already named. | $30 pulled forward. Half a day. |

Counts: **1 Blocker, 6 Major, 11 Minor.**

What is fine and needs no action: 10 AWG mains (0.5 °C above the joints); 16 AWG for the hover share (9.2 °C); the AS150U
rating against 37.8 A / 120 A (reseller figures; open the Amass sheet, as F1 already says); no soldered joints in the
foam grooves; signal runs in their own lanes; GH and JR service plugs on the avionics; the LiPo re-termination
procedure; ArduPilot arming on an RC switch with an RC e-stop (`RC9_OPTION 31`); retention in hover attitude (the pack
sits on the spacer stack, the aft stop and the strut, along +x) and in a crash (crush block, stops and straps, owned
by C3/C5).

## Build steps as I'd actually do them

Order assumes WB-01 is closed (board measured), WB-03 is adopted (one plug per ESC pair in the pod) and WB-04 is
adopted (AS150U pigtail).

1. **Arrival bench (week 1).** Measure the CoreWing V2 boards, one ESC, one pack, the UBEC (if kept), the AS150U, the
   caps, and the OD of every wire reel. Flash the FC with Plane 4.7 and the ESC with Bluejay. Bench-test bdshot over a
   0.7 m 28 AWG twisted lead. Write the numbers into the params files, then freeze the pod CAD.
2. **Bench: ESC sub-assemblies (×4 + 1 spare).** Solder a 16 AWG pair, cut to length + 30 mm, to each ESC's pads from
   below. Twist it. Solder the cap legs to the same pads, bed the can in silicone, and fit adhesive heat-shrink. Splice
   the 28 AWG DShot pair to the factory signal lead. Crimp the plug half on the pod end **after** threading (step 5).
   Continuity, polarity, then a 10 N pull test.
3. **Bench: power stack, out of the pod.** Make the bus board: FR4 with two tinned 8 AWG bars, then four short 16 AWG
   pigtails with the aircraft-side plugs, plus the 20 AWG fuse feed. Mount the power board on the deck with the
   supplied 470 µF 35 V cap at its battery pads. Fit the 10 AWG pigtail with the AS150U aircraft half. Fit the
   `W-MAIN-2` jumpers to the bars. Do all of this with an 80–100 W iron in free air. Check the loop resistance
   (`T-F1-DROP` coupon) and > 1 MΩ between rails.
4. **Wing (before skinning).** Rout the grooves to the measured OD + 0.5 mm with a depth sled. Drill P1 and the fin
   holes, then glue the straws and grommets. Dry-fit an offcut of each wire for the full length.
5. **Fins.** Strap each ESC on its pad. Thread the free end of the pair inboard through the grommet, leaving a
   20–30 mm service loop on the fin face. Tie at the boss lug. Lay the wire in the grooves (the lower pairs via P1) and
   tape-tab it. Bring the end into the pod through the side exit. Crimp or solder the plug half on now.
6. **Phase leads.** Measure the motor lead reach first. If an extension is needed, make staggered splices with an
   outer sleeve and the two ties. Label the phase order. Hand-spin the motor and check for ≥ 5 mm clearance off the
   bell.
7. **Skin the wing** over the grooves. Run a finger along each run and check that nothing stands proud.
8. **Pod.** Drop the pre-wired stack onto the inserts (4 screws, no soldering in the pod). Mate the four ESC plugs at
   the exits and tie them in their lanes. Fit the UBEC if kept, then the FC on gel with its pigtails to the JR bar. Run
   the GH cables: GPS up the leg, then RX, airspeed and the power-board link, with the current-sense wire twisted.
9. **Props off. Power-up check.** Full continuity and isolation check with the pack out. Then plug the pack through an
   inline smoke stopper or current-limited supply first. Check the 6 V rail, 5 V, I²C scan, ESC beeps and motor
   direction from `MOTOR_TEST`.
10. **Stand tests.** `T-F1-RIPPLE` at each ESC, `T-F1-DROP`, current-sense calibration with the motors running,
    compassmot, `T-F1-WIRE-HEAT` on the straw and groove coupon.
11. **Field kit per pack.** Label each pack and tether its spacer stack and block to it. Weigh the pack, then do the
    CG balance check.
12. **Field card.** TX on → aircraft flat on the cradle → pack in → plug → hatch open until pre-arm passes → pitot
    lines → hatch → stand it up → arm by switch. Crash: e-stop, approach from behind, open the hatch, pull the plug,
    bag the pack.

## Questions for the team

1. F3/F1: which CoreWing board physically carries the S1–S12 header and its Vx rail? What pins join the FC to the
   PDB? If the outputs live on the PDB, the "FC output pad" pigtails and the "no Vx on the GH-6 link" plan both
   change.
2. F1: the ArduPilot page says the servo BEC is 8 A continuous at 6 V. Banggood says 4 A sustained. Where does the
   4.5 A in D-32 come from? Will you drop the UBEC and fuse if the stall test passes on the board BEC?
3. F2/F1: are you willing to add one plug per ESC pair in the pod, if that means relaxing the self-imposed 5 % drop
   limit or adding a few grams?
4. D2/F1: can the AS150U come out of the bonded cradle onto a short pigtail? That would remove the 1.94 N·m unplug
   case from the PDB plate.
5. H3: what exactly does "plug in last, after the RC link is up" mean, given the RX has no power until the pack is
   plugged? Is the pack swapped with the aircraft standing or lying flat?
6. F1: which named 680 µF part, and at what voltage and ripple rating? Is the supplied 470 µF 35 V input cap being
   fitted?
7. B4/CFD: are the four ESC caps (10 × 20 mm) and the ESC strap in the CFD geometry?
8. A3/H3: how is a wrong spacer stack caught before take-off? Is there a CG check on every pack change?
9. E1: has anyone identified the LANRC 45 A ESC's MCU and Bluejay layout?
10. F3: QMC5883L or QMC5883P on the M100-5883, and is that variant's driver in Plane 4.7?
11. Everyone: after a crash, who pulls the plug, from where, and how long does it take with the hatch tab and the
    upper props in the way?

Web sources used: [ArduPilot CoreWing F405 Wing V2 page](https://ardupilot.org/plane/docs/common-CoreWingF405WingV2.html),
[Banggood CoreWing F405 Wing APP V2 listing](https://www.banggood.com/COREWING-F405-Wing-APP-V2-Flight-Controller-Supports-VTOL-Ardupilot-for-Fixed-wing-RC-Airplane-p-2048661.html),
[HGLRC M100-5883 listing (fpv24)](https://www.fpv24.com/en/hglrc/hglrc-m100-gps-qmc5883l-compass-fpv),
[Ovonic 4S 6500 120C hardcase listing (Ampow)](https://www.ampow.com/el-gb/products/2-pack-ovonic-4s-6500mah-120c-lipo-hardcase-ec5-1-8-rc-car).
