davinciucberkeley-collab/DBF-Combined/redesign/team/G3/PRINT-LIST.md

# G3 print plan and print list: K09-L

Revision G3-R1, 2026-11-13. Status `PROPOSED`. Generated by `python -I redesign/team/G3/make_print_plan.py` from `manufacturing/out/PRINT-LIST.csv`
(the exporter's per-file list, itself built from the CAD parts lists `subsystems/*/parts.csv`); re-run after any CAD change and after
`python -B redesign/manufacturing/make_shop_files.py`. Times and masses are the exporter's estimates (`EST`): the slicer replaces them on the first print. STLs are in `manufacturing/out/print/` and `jigs/`.
Requirement `R-PROCESS` (printed parts <= 0.2 m on any axis): the largest bed dimension of any file is 178.7 mm (limit 200 mm: pass).

## 1. Printer classes and decisions

| Class | Material | Why | Where | Decision |
|---|---|---|---|---|
| A | PETG, 0.2 mm, 3-4 perimeters | blocks, tray, pod, landing, mechanisms, plugs | Jacobs Prusa printers if staff confirm PETG, else a team printer | print everything here that C4/C6 have not put on hold |
| J | PLA, 0.2 mm | jigs and drill guides (shop aids) | Jacobs Prusa printers (free PLA) | print first; flight loads never pass through them |
| B | TPU 95A, 2 perimeters | two wingtip corner caps `GER-007`, 0.73 g each | a Prusa with a direct-drive extruder | print last; **no TPU spool is in the BOM** (BR-32): the smallest spool, price `—`, goes to I1 (`CR-G3-02`) |
| C | ASA, 0.2 mm, 5 perimeters | motor mounts `FIN-003` (D-42: ASA for temperature), ESC pads `FIN-007`, grommets `HRN-110` | enclosed printer, not Jacobs open access | **book an enclosed printer now** (`CR-G3-01`); fallback: PETG mounts only if C4 and C6 re-run on PETG (BR-30), not decided here |

Colours: the CAD colours (blue, green, orange, white, yellow) identify parts (spacers by thickness, pistons upper/lower). The BOM holds one PETG spool (W05) of no stated colour,
so **G3 decides: print in one colour and mark the colour code with the paint pen from `C04`** (dot on the part, matching the colour table in `subsystems/pod/params.json` `spacer_set_m`
and landing `BUILD.md`). If the team prefers coloured filament, that is a purchase for I1, not assumed.

## 2. Totals by class

| Class | Pieces | Machine hours `EST` | Filament g `EST` | Where |
|---|---|---|---|---|
| A: Prusa, PETG (Jacobs open access, or a team printer) | 76 | 32.9 | 555 | Jacobs Prusa printers, no cost or training required for PLA per the labs page (https://jacobsinstitute.berkeley.edu/our-spaces-at-a-glance/labs-and-equipment/, checked 2026-11-13); PETG is not stated there: ask staff, else a team printer |
| B: Prusa, TPU (direct drive) | 2 | 0.4 | 1 | a Prusa with a direct-drive extruder, slow (2 mm3/s, `shopconfig.py`) |
| C: enclosed printer (ASA) | 18 | 7.0 | 93 | **not on the Jacobs open-access list** (MF-15); Fortus 380MC / Markforged are staffed lab machines (room 332); or a teammate's enclosed printer; or PETG/CF-PETG if C4 signs off (BR-30) |
| J: Prusa, PLA (Jacobs free filament), shop aids | 10 | 10.7 | 280 | Jacobs Prusa printers: PLA is free and needs no training (labs page, checked 2026-11-13). **G3 decision: print the shop aids in PLA, not PETG** (they carry no flight load; this keeps 280 g off the PETG spool) |
| **All** | 106 | 51.0 | 929 | |

By material, flight set only (jigs excluded): PETG 555 g, ASA 93 g; jigs 280 g of PLA.

| Check | Value | Limit | Result |
|---|---|---|---|
| PETG flight filament vs spool W05 (1 x 1 kg) | 555 g with spares (jigs are PLA: 280 g, Jacobs free stock) | 1 000 g, keep 20 % for failed prints and purge (rule: <= 800 g) | pass (margin 445 g) |
| ASA vs spool W08 | 93 g | 1 000 g | pass (spool is far larger than the need; the smallest practical spool, CR-I1-20) |
| Parts on hold | FIN-008-A x4, FIN-008-B x4: 98 g, 4.4 h | print only after the 18 Dec freeze | STATUS issue 1 (collar height) |
| Mass: exporter vs CAD (flight parts) | see the g-each column against `subsystems/*/parts.csv` | A3 weighs every first print | open until weighed |

## 3. Print order (what goes on the bed first)

1. **Jigs and drill guides** (`jigs/`: JIG-01 tube posts, JIG-02 fin-alignment collar, JIG-03 cant gauge A/B): needed for the first block and mount (MF-06, MF-07). Print in the week of 30 Nov (`I2` task `W03`).
2. **Test-fit set** (BUILD-GUIDE stage 1 step 5): one mount, one collar, one servo frame, one block; fit them on the real motor, tube and servo, then print the flight set. The collar is on hold until the 18 Dec freeze: print the test collar only.
3. **Flight set** after the freeze, in the closure window (19 Dec - 18 Jan, `I2` task `PR1`, about 30 days for the machine hours below on one printer).
4. **Make two of every crash part from day one** (`review/MANUFACTURING.md` section 5): the quantities in the table already include the spares (8 mounts, 8 collars, 3 blocks, 2 spare shoes, 8 spare pistons).
5. Weigh each first print and report to A3 (`T-A3-WEIGH-PARTS`) before the rest of the batch (BUILD-GUIDE stage 10 step 1 does this for the foot).

## 4. The print list

Source: `manufacturing/out/PRINT-LIST.csv`; status `print` = flight part, `jig` = shop aid, `ON HOLD` = do not print yet. Class column letters refer to section 1.

| # | Part | Instances | Mat | Colour (CAD) | Qty fl + sp | Printer class | Orientation | Layer mm | Perim | Infill | Supports | Bed mm | Time each min | g each | Time total h | g total | Status | File |
|---|---|---|---|---|---|---|---|---|---|---|---|---|---|---|---|---|---|---|
| 1 | JIG-01 | R L | PLA (CAD: PETG) | - | 2 + 0 | J | face -Z on the bed (shopconfig) | 0.2 | 4 | 40 % | none | 64.0 x 64.0 x 51.0 | 100 | 44.6 | 3.3 | 89.2 | jig | `jigs/JIG-01_PETG_x2.stl` |
| 2 | JIG-02 | R | PLA (CAD: PETG) | - | 1 + 3 | J | largest flat face -Z on the bed (814 mm2) | 0.2 | 3 | 30 % | none | 77.0 x 34.0 x 25.0 | 48 | 20.1 | 3.2 | 80.4 | jig | `jigs/JIG-02_PETG_x4.stl` |
| 3 | JIG-03-A | UR LL | PLA (CAD: PETG) | - | 2 + 0 | J | largest flat face +Z on the bed (1665 mm2) | 0.2 | 3 | 40 % | none | 60.0 x 31.2 x 24.0 | 62 | 27.6 | 2.1 | 55.2 | jig | `jigs/JIG-03-A_PETG_x2.stl` |
| 4 | JIG-03-B | UL LR | PLA (CAD: PETG) | - | 2 + 0 | J | largest flat face +Z on the bed (1665 mm2) | 0.2 | 3 | 40 % | none | 60.0 x 31.2 x 24.0 | 62 | 27.6 | 2.1 | 55.2 | jig | `jigs/JIG-03-B_PETG_x2.stl` |
| 5 | FIN-003-A | UR LL | ASA | - | 2 + 2 | C | face -Z on the bed (shopconfig) | 0.2 | 5 | 20 % (default) | check: 601 mm2 overhang > 50 deg (auto) | 36.6 x 36.3 x 48.0 | 43 | 10.6 | 2.9 | 42.4 | print | `print/FIN-003-A_ASA_x4.stl` |
| 6 | FIN-003-B | UL LR | ASA | - | 2 + 2 | C | face -Z on the bed (shopconfig) | 0.2 | 5 | 20 % (default) | check: 601 mm2 overhang > 50 deg (auto) | 36.6 x 36.3 x 48.0 | 43 | 10.6 | 2.9 | 42.4 | print | `print/FIN-003-B_ASA_x4.stl` |
| 7 | FIN-004-A | R | PETG | - | 1 + 1 | A | largest flat face +X on the bed (939 mm2) | 0.2 (default) | 3 | 15 % gyroid | check: 2010 mm2 overhang > 50 deg (auto) | 48.4 x 42.6 x 69.3 | 92 | 37.8 | 3.1 | 75.6 | print | `print/FIN-004-A_PETG_x2.stl` |
| 8 | FIN-004-B | L | PETG | - | 1 + 0 | A | largest flat face +X on the bed (939 mm2) | 0.2 (default) | 3 | 15 % gyroid | check: 2010 mm2 overhang > 50 deg (auto) | 48.4 x 42.6 x 69.3 | 92 | 37.8 | 1.5 | 37.8 | print | `print/FIN-004-B_PETG_x1.stl` |
| 9 | FIN-010-A | UR | PETG | - | 1 + 0 | A | largest flat face -Y on the bed (260 mm2) | 0.2 (default) | 2 (default) | 80 % | check: 70 mm2 overhang > 50 deg (auto) | 20.0 x 13.0 x 16.0 | 16 | 4.5 | 0.3 | 4.5 | print | `print/FIN-010-A_PETG_x1.stl` |
| 10 | FIN-010-B | LR | PETG | - | 1 + 0 | A | largest flat face -Y on the bed (245 mm2) | 0.2 (default) | 2 (default) | 80 % | check: 71 mm2 overhang > 50 deg (auto) | 20.0 x 12.3 x 16.0 | 16 | 4.3 | 0.3 | 4.3 | print | `print/FIN-010-B_PETG_x1.stl` |
| 11 | FIN-010-C | UL | PETG | - | 1 + 0 | A | largest flat face -Y on the bed (260 mm2) | 0.2 (default) | 2 (default) | 80 % | check: 65 mm2 overhang > 50 deg (auto) | 20.0 x 13.0 x 16.0 | 16 | 4.5 | 0.3 | 4.5 | print | `print/FIN-010-C_PETG_x1.stl` |
| 12 | FIN-010-D | LL | PETG | - | 1 + 0 | A | largest flat face -Y on the bed (245 mm2) | 0.2 (default) | 2 (default) | 80 % | check: 67 mm2 overhang > 50 deg (auto) | 20.0 x 12.3 x 16.0 | 16 | 4.3 | 0.3 | 4.3 | print | `print/FIN-010-D_PETG_x1.stl` |
| 13 | WNG-004 | R L | PETG | - | 2 + 0 | A | largest flat face -Y on the bed (307 mm2) | 0.2 (default) | 4 | 50 % gyroid | none | 19.8 x 19.8 x 36.0 | 32 | 10.3 | 1.1 | 20.6 | print | `print/WNG-004_PETG_x2.stl` |
| 14 | WNG-005 | R L | PETG | - | 2 + 0 | A | largest flat face -Y on the bed (307 mm2) | 0.2 (default) | 2 (default) | 30 % | none | 19.8 x 19.8 x 20.0 | 16 | 3.8 | 0.5 | 7.6 | print | `print/WNG-005_PETG_x2.stl` |
| 15 | AVN-005 | AVN-005 | PETG | - | 1 + 0 | A | largest flat face -X on the bed (15 mm2) | 0.2 (default) | 2 (default) | 100 % | none; use a brim (tall, 10 mm footprint) | 9.8 x 9.8 x 49.8 | 19 | 1.1 | 0.3 | 1.1 | print | `print/AVN-005_PETG_x1.stl` |
| 16 | FIN-007 | UR LR UL LL | ASA | - | 4 + 0 | C | largest flat face -Y on the bed (1354 mm2) | 0.2 (default) | 2 (default) | 100 % | none | 46.0 x 31.0 x 1.2 | 9 | 1.7 | 0.6 | 6.8 | print | `print/FIN-007_ASA_x4.stl` |
| 17 | GER-001 | UR UL LR LL | PETG | - | 4 + 2 | A | face +X on the bed (shopconfig) | 0.2 | 3 | 100 % | only under the two leg ends at the TE | 25.9 x 24.8 x 73.0 | 40 | 9.6 | 4.0 | 57.6 | print | `print/GER-001_PETG_x6.stl` |
| 18 | GER-002 | UR UL | PETG | orange | 2 + 4 | A | face +X on the bed (shopconfig) | 0.2 | 2 | 20 % (default) | none | 19.1 x 17.8 x 64.8 | 26 | 3.3 | 2.6 | 19.8 | print | `print/GER-002_PETG-orange_x6.stl` |
| 19 | GER-002 | LR LL | PETG | blue | 2 + 4 | A | face +X on the bed (shopconfig) | 0.2 | 2 | 20 % (default) | none | 19.1 x 17.8 x 64.8 | 26 | 3.3 | 2.6 | 19.8 | print | `print/GER-002_PETG-blue_x6.stl` |
| 20 | GER-007-A | R | TPU95A | - | 1 + 0 | B | face +Y on the bed (shopconfig) | 0.2 (default) | 2 | 20 % (default) | none | 20.8 x 4.0 x 14.3 | 12 | 0.6 | 0.2 | 0.6 | print | `print/GER-007-A_TPU95A_x1.stl` |
| 21 | GER-007-B | L | TPU95A | - | 1 + 0 | B | face -Y on the bed (shopconfig) | 0.2 (default) | 2 | 20 % (default) | none | 20.8 x 4.0 x 14.3 | 12 | 0.6 | 0.2 | 0.6 | print | `print/GER-007-B_TPU95A_x1.stl` |
| 22 | HRN-110-A | LL LR | ASA | - | 2 + 1 | C | largest flat face -Y on the bed (40 mm2) | 0.2 (default) | 2 (default) | 100 % | none | 10.0 x 10.0 x 12.0 | 7 | 0.2 | 0.3 | 0.6 | print | `print/HRN-110-A_ASA_x3.stl` |
| 23 | HRN-110-B | UL UR | ASA | - | 2 + 1 | C | largest flat face -Y on the bed (40 mm2) | 0.2 (default) | 2 (default) | 100 % | none | 10.0 x 10.0 x 12.0 | 7 | 0.2 | 0.3 | 0.6 | print | `print/HRN-110-B_ASA_x3.stl` |
| 24 | MEC-004-A | R | PETG | - | 1 + 1 | A | largest flat face -Y on the bed (36 mm2) | 0.2 (default) | 2 (default) | 100 % | check: 599 mm2 overhang > 50 deg (auto) | 44.7 x 29.1 x 18.2 | 14 | 3.1 | 0.5 | 6.2 | print | `print/MEC-004-A_PETG_x2.stl` |
| 25 | MEC-004-B | L | PETG | - | 1 + 1 | A | largest flat face +Y on the bed (36 mm2) | 0.2 (default) | 2 (default) | 100 % | check: 599 mm2 overhang > 50 deg (auto) | 44.7 x 29.1 x 18.2 | 14 | 3.1 | 0.5 | 6.2 | print | `print/MEC-004-B_PETG_x2.stl` |
| 26 | MEC-006-A | R | PETG | - | 1 + 1 | A | largest flat face +Y on the bed (36 mm2) | 0.2 (default) | 2 (default) | 100 % | check: 510 mm2 overhang > 50 deg (auto) | 44.7 x 22.2 x 18.2 | 14 | 2.9 | 0.5 | 5.8 | print | `print/MEC-006-A_PETG_x2.stl` |
| 27 | MEC-006-B | L | PETG | - | 1 + 1 | A | largest flat face -Y on the bed (36 mm2) | 0.2 (default) | 2 (default) | 100 % | check: 510 mm2 overhang > 50 deg (auto) | 44.7 x 22.2 x 18.2 | 14 | 2.9 | 0.5 | 5.8 | print | `print/MEC-006-B_PETG_x2.stl` |
| 28 | MEC-007-A | R | PETG | - | 1 + 0 | A | largest flat face -Z on the bed (1673 mm2) | 0.2 (default) | 2 | 20 % (default) | none | 42.9 x 40.9 x 0.8 | 7 | 1.7 | 0.1 | 1.7 | print | `print/MEC-007-A_PETG_x1.stl` |
| 29 | MEC-007-B | L | PETG | - | 1 + 0 | A | largest flat face -Z on the bed (1673 mm2) | 0.2 (default) | 2 | 20 % (default) | none | 42.9 x 40.9 x 0.8 | 7 | 1.7 | 0.1 | 1.7 | print | `print/MEC-007-B_PETG_x1.stl` |
| 30 | MEC-008-A | R | PETG | - | 1 + 1 | A | largest flat face +Z on the bed (475 mm2) | 0.2 (default) | 3 | 20 % (default) | check: 28 mm2 overhang > 50 deg (auto) | 34.9 x 34.9 x 13.5 | 13 | 2.9 | 0.4 | 5.8 | print | `print/MEC-008-A_PETG_x2.stl` |
| 31 | MEC-008-B | L | PETG | - | 1 + 1 | A | largest flat face +Z on the bed (475 mm2) | 0.2 (default) | 3 | 20 % (default) | check: 28 mm2 overhang > 50 deg (auto) | 34.9 x 34.9 x 13.5 | 13 | 2.9 | 0.4 | 5.8 | print | `print/MEC-008-B_PETG_x2.stl` |
| 32 | POD-001-lip | POD-001 | PETG | - | 1 + 0 | A | largest flat face -Z on the bed (542 mm2) | 0.2 | 2 (default) | 20 % (default) | none | 90.4 x 6.0 x 2.8 | 8 | 1.9 | 0.1 | 1.9 | print | `print/POD-001-lip_PETG_x1.stl` |
| 33 | POD-001-tube | POD-001 | PETG | - | 1 + 0 | A | largest flat face -X on the bed (18 mm2) | 0.2 | 2 (default) | 20 % (default) | none | 5.8 x 5.8 x 18.8 | 10 | 0.4 | 0.2 | 0.4 | print | `print/POD-001-tube_PETG_x1.stl` |
| 34 | POD-002-FC | POD-002 | PETG | - | 1 + 0 | A | largest flat face -Z on the bed (2275 mm2) | 0.2 | 2 (default) | 100 % (T, aft stop, plates); others default | none | 62.0 x 36.7 x 4.8 | 10 | 2.5 | 0.2 | 2.5 | print | `print/POD-002-FC_PETG_x1.stl` |
| 35 | POD-002-JR | POD-002 | PETG | - | 1 + 0 | A | largest flat face -Z on the bed (147 mm2) | 0.2 | 2 (default) | 100 % (T, aft stop, plates); others default | none | 36.7 x 4.0 x 5.0 | 7 | 0.9 | 0.1 | 0.9 | print | `print/POD-002-JR_PETG_x1.stl` |
| 36 | POD-002-PDB | POD-002 | PETG | - | 1 + 0 | A | largest flat face -Z on the bed (3085 mm2) | 0.2 | 2 (default) | 100 % (T, aft stop, plates); others default | none | 84.0 x 36.7 x 6.8 | 15 | 4.7 | 0.2 | 4.7 | print | `print/POD-002-PDB_PETG_x1.stl` |
| 37 | POD-002-avn | POD-002 | PETG | - | 1 + 0 | A | largest flat face -Z on the bed (1762 mm2) | 0.2 | 2 (default) | 100 % (T, aft stop, plates); others default | none | 48.0 x 36.7 x 5.8 | 9 | 2 | 0.1 | 2.0 | print | `print/POD-002-avn_PETG_x1.stl` |
| 38 | POD-002-floorF | POD-002 | PETG | - | 1 + 0 | A | largest flat face -Z on the bed (4520 mm2) | 0.2 | 2 (default) | 100 % (T, aft stop, plates); others default | none | 101.7 x 55.0 x 1.0 | 15 | 5.7 | 0.2 | 5.7 | print | `print/POD-002-floorF_PETG_x1.stl` |
| 39 | POD-002-floorR | POD-002 | PETG | - | 1 + 0 | A | largest flat face -Z on the bed (3894 mm2) | 0.2 | 2 (default) | 100 % (T, aft stop, plates); others default | none | 84.5 x 55.0 x 30.5 | 33 | 11.3 | 0.6 | 11.3 | print | `print/POD-002-floorR_PETG_x1.stl` |
| 40 | POD-002-guide | POD-002 POD-002 | PETG | - | 2 + 0 | A | largest flat face +Z on the bed (268 mm2) | 0.2 | 2 (default) | 100 % (T, aft stop, plates); others default | none | 178.7 x 1.5 x 6.0 | 9 | 2 | 0.3 | 4.0 | print | `print/POD-002-guide_PETG_x2.stl` |
| 41 | POD-002-stopT | POD-002 | PETG | - | 1 + 0 | A | largest flat face -Z on the bed (648 mm2) | 0.2 | 2 (default) | 100 % (T, aft stop, plates); others default | none | 54.0 x 12.0 x 32.0 | 26 | 7.3 | 0.4 | 7.3 | print | `print/POD-002-stopT_PETG_x1.stl` |
| 42 | POD-003-tab | POD-003 | PETG | - | 1 + 0 | A | largest flat face -Z on the bed (480 mm2) | 0.2 | 2 (default) | 20 % (default) | none | 40.0 x 12.0 x 1.0 | 5 | 0.6 | 0.1 | 0.6 | print | `print/POD-003-tab_PETG_x1.stl` |
| 43 | POD-003-tongue | POD-003 | PETG | - | 1 + 0 | A | largest flat face -Z on the bed (497 mm2) | 0.2 | 2 (default) | 20 % (default) | none | 90.4 x 5.5 x 2.0 | 7 | 1.3 | 0.1 | 1.3 | print | `print/POD-003-tongue_PETG_x1.stl` |
| 44 | POD-003-tube | POD-003 | PETG | - | 1 + 0 | A | largest flat face -Z on the bed (18 mm2) | 0.2 | 2 (default) | 20 % (default) | none | 5.8 x 5.8 x 23.8 | 11 | 0.6 | 0.2 | 0.6 | print | `print/POD-003-tube_PETG_x1.stl` |
| 45 | POD-005 | POD-005 | PETG | - | 1 + 0 | A | largest flat face (-0.71 0.00 0.71) on the bed (784 mm2) | 0.2 | 2 (default) | 20 % (default) | none | 56.0 x 28.0 x 43.5 | 24 | 5.1 | 0.4 | 5.1 | print | `print/POD-005_PETG_x1.stl` |
| 46 | POD-006 | POD-006 | PETG | - | 1 + 0 | A | largest flat face -X on the bed (115 mm2) | 0.2 | 2 (default) | 20 % (default) | check: 880 mm2 overhang > 50 deg (auto) | 32.0 x 32.0 x 34.8 | 23 | 5.6 | 0.4 | 5.6 | print | `print/POD-006_PETG_x1.stl` |
| 47 | POD-007 | POD-007 | PETG | - | 1 + 1 | A | face -Z on the bed (shopconfig) | 0.2 | 3 | 25 % (40 % feet and grip; bridge 100 %) | under the strut ribs (pod/BUILD.md) | 130.4 x 39.7 x 110.6 | 110 | 41.8 | 3.7 | 83.6 | print | `print/POD-007_PETG_x2.stl` |
| 48 | POD-008-2mm | POD-008 | PETG | white | 1 + 0 | A | largest flat face -X on the bed (197 mm2) | 0.2 | 2 (default) | 20 % (default) | none | 50.0 x 12.0 x 2.0 | 5 | 0.5 | 0.1 | 0.5 | print | `print/POD-008-2mm_PETG-white_x1.stl` |
| 49 | POD-008-4mm | POD-008 | PETG | yellow | 1 + 0 | A | largest flat face -X on the bed (197 mm2) | 0.2 | 2 (default) | 20 % (default) | none | 50.0 x 12.0 x 4.0 | 7 | 1 | 0.1 | 1.0 | print | `print/POD-008-4mm_PETG-yellow_x1.stl` |
| 50 | POD-008-6mm | POD-008 | PETG | green | 1 + 0 | A | largest flat face -Z on the bed (300 mm2) | 0.2 | 2 (default) | 20 % (default) | none | 50.0 x 6.0 x 12.0 | 10 | 1.4 | 0.2 | 1.4 | print | `print/POD-008-6mm_PETG-green_x1.stl` |
| 51 | POD-008-8mm | POD-008 | PETG | blue | 1 + 0 | A | largest flat face -Z on the bed (400 mm2) | 0.2 | 2 (default) | 20 % (default) | none | 50.0 x 8.0 x 12.0 | 10 | 1.8 | 0.2 | 1.8 | print | `print/POD-008-8mm_PETG-blue_x1.stl` |
| 52 | POD-010 | POD-010 | PETG | - | 1 + 0 | A | largest flat face -X on the bed (2787 mm2) | 0.2 (default) | 2 (default) | 100 % | none | 58.9 x 51.4 x 1.5 | 14 | 5.3 | 0.2 | 5.3 | print | `print/POD-010_PETG_x1.stl` |
| 53 | PWR-006 | PWR-006 | PETG | - | 1 + 0 | A | largest flat face +Z on the bed (263 mm2) | 0.2 | 4 | 100 % | check: 3275 mm2 overhang > 50 deg (auto) | 126.0 x 34.0 x 28.8 | 36 | 13 | 0.6 | 13.0 | print | `print/PWR-006_PETG_x1.stl` |
| 54 | FIN-008-A | UR LL | PETG | - | 2 + 2 | A | face +Z on the bed (shopconfig) - no flat face there, check supports | 0.2 (default) | 3 | 100 % ring; tongue 3 perimeters + 20 % gyroid | check: 330 mm2 overhang > 50 deg (auto) | 63.8 x 35.5 x 25.9 | 33 | 12.2 | 2.2 | 48.8 | ON HOLD | `print/FIN-008-A_PETG_x4.stl` |
| 55 | FIN-008-B | LR UL | PETG | - | 2 + 2 | A | face -Z on the bed (shopconfig) - no flat face there, check supports | 0.2 (default) | 3 | 100 % ring; tongue 3 perimeters + 20 % gyroid | check: 330 mm2 overhang > 50 deg (auto) | 63.8 x 35.5 x 25.9 | 33 | 12.2 | 2.2 | 48.8 | ON HOLD | `print/FIN-008-B_PETG_x4.stl` |

## 5. Process notes by part family (from the BUILD.md files)

| Family | Rule | Source |
|---|---|---|
| Through-core block `FIN-004` | spar bore horizontal on the bed, 3 perimeters, 15 % gyroid; sets the thrust lines, so check both bores with the clocking jig before bonding | `fins/parts.csv`, MF-06 |
| Motor mount `FIN-003` | ASA, collar axis vertical; check the 1.5 mm slit with a feeler; drill 3.4 mm to the measured motor from a printed guide, never through the motor; post-cure 4 h at 50 C needs a heat box | MM-01, MM-04, `MANUFACTURING.md` section 2 |
| Landing shoes and pistons | PETG, rim end on the bed; fit is sensitive to extrusion: print a test piston first | `landing/BUILD.md`; `MANUFACTURING.md` |
| Tray and pod prints | seven prints epoxied full-area to the board; spacers by thickness, colour-coded | `pod/parts.csv` POD-002, POD-008 |
| Servo frame, covers, horns | PETG 100 % infill for the horns | `mechanisms/parts.csv` |
| TPU caps | two wraps of 12 mm filament tape hold them (`E-GER-21/22`) | `wing/BUILD.md` step 12 |
| ASA grommets `HRN-110` | six pieces (3 A + 3 B) | `harness/parts.csv` |
| Elevated risk | supports flagged `check` in the table are auto-estimated overhangs: slice with the real orientation and look | `PRINT-LIST.csv` supports column |

## 6. Change requests from G3

| # | To | What | Why |
|---|---|---|---|
| CR-G3-01 | G1, I2 | Book an enclosed printer for 93 g of ASA (7.0 h) before 18 Dec | ASA is not on the Jacobs open-access list (`MANUFACTURING.md` MF-15) |
| CR-G3-02 | I1 | Add the smallest TPU 95A spool (two caps, 1.2 g) to the BOM; price `—` (no vendor page read) | BR-32; `GER-007` is TPU |
| CR-G3-03 | D2, D5 | Accept paint-pen colour coding instead of coloured filament, or say which parts must be coloured | one PETG spool in the BOM |
| CR-G3-04 | C4, C6 | State by 18 Dec whether collars are printed in PETG or another material (hold) | STATUS issue 1 |
