davinciucberkeley-collab/DBF-Combined/redesign/manufacturing/out/CHECKS.md

# Shop-file checks

Generated by `make_shop_files.py` (params.json). PASS/FAIL per check; NOTE = information.

**249 checks, 0 FAIL.**

| Result | Check | Detail |
|---|---|---|
| PASS | every CAD module builds | 10 modules |
| PASS | STL watertight: WNG-004_PETG_x2.stl | open/non-manifold edges 0, mis-oriented 0 |
| PASS | STL size < 5 MB: WNG-004_PETG_x2.stl | 0.01 MB |
| PASS | volume sane: WNG-004_PETG_x2.stl | mesh 11053 mm3, sum of CAD bodies 11085 mm3 (overlaps make the sum larger) |
| PASS | STL watertight: WNG-005_PETG_x2.stl | open/non-manifold edges 0, mis-oriented 0 |
| PASS | STL size < 5 MB: WNG-005_PETG_x2.stl | 0.01 MB |
| PASS | volume sane: WNG-005_PETG_x2.stl | mesh 6141 mm3, sum of CAD bodies 6158 mm3 (overlaps make the sum larger) |
| PASS | STL watertight: FIN-003-A_ASA_x4.stl | open/non-manifold edges 0, mis-oriented 0 |
| PASS | STL size < 5 MB: FIN-003-A_ASA_x4.stl | 0.05 MB |
| PASS | bbox = CAD bodies: FIN-003-A_ASA_x4.stl | STL 36.3 x 36.6 x 48.0 vs CAD 36.3 x 36.7 x 48.0 mm |
| PASS | volume sane: FIN-003-A_ASA_x4.stl | mesh 9885 mm3, sum of CAD bodies 10374 mm3 (overlaps make the sum larger) |
| PASS | STL watertight: FIN-003-B_ASA_x4.stl | open/non-manifold edges 0, mis-oriented 0 |
| PASS | STL size < 5 MB: FIN-003-B_ASA_x4.stl | 0.05 MB |
| PASS | bbox = CAD bodies: FIN-003-B_ASA_x4.stl | STL 36.3 x 36.6 x 48.0 vs CAD 36.3 x 36.7 x 48.0 mm |
| PASS | volume sane: FIN-003-B_ASA_x4.stl | mesh 9885 mm3, sum of CAD bodies 10374 mm3 (overlaps make the sum larger) |
| PASS | STL watertight: FIN-004-A_PETG_x2.stl | open/non-manifold edges 0, mis-oriented 0 |
| PASS | STL size < 5 MB: FIN-004-A_PETG_x2.stl | 0.09 MB |
| PASS | bbox = CAD bodies: FIN-004-A_PETG_x2.stl | STL 42.6 x 48.4 x 69.3 vs CAD 42.6 x 48.4 x 69.3 mm |
| PASS | volume sane: FIN-004-A_PETG_x2.stl | mesh 53967 mm3, sum of CAD bodies 54217 mm3 (overlaps make the sum larger) |
| PASS | STL watertight: FIN-004-B_PETG_x1.stl | open/non-manifold edges 0, mis-oriented 0 |
| PASS | STL size < 5 MB: FIN-004-B_PETG_x1.stl | 0.09 MB |
| PASS | bbox = CAD bodies: FIN-004-B_PETG_x1.stl | STL 42.6 x 48.4 x 69.3 vs CAD 42.6 x 48.4 x 69.3 mm |
| PASS | volume sane: FIN-004-B_PETG_x1.stl | mesh 53967 mm3, sum of CAD bodies 54217 mm3 (overlaps make the sum larger) |
| PASS | STL watertight: FIN-007_ASA_x4.stl | open/non-manifold edges 0, mis-oriented 0 |
| PASS | STL size < 5 MB: FIN-007_ASA_x4.stl | 0.00 MB |
| PASS | bbox = CAD bodies: FIN-007_ASA_x4.stl | STL 1.2 x 31.0 x 46.0 vs CAD 1.2 x 31.0 x 46.0 mm |
| PASS | volume sane: FIN-007_ASA_x4.stl | mesh 1625 mm3, sum of CAD bodies 1625 mm3 (overlaps make the sum larger) |
| PASS | STL watertight: FIN-008-A_PETG_x4.stl | open/non-manifold edges 0, mis-oriented 0 |
| PASS | STL size < 5 MB: FIN-008-A_PETG_x4.stl | 0.07 MB |
| PASS | bbox = CAD bodies: FIN-008-A_PETG_x4.stl | STL 25.9 x 35.5 x 63.8 vs CAD 25.9 x 35.5 x 63.8 mm |
| PASS | volume sane: FIN-008-A_PETG_x4.stl | mesh 9627 mm3, sum of CAD bodies 9936 mm3 (overlaps make the sum larger) |
| PASS | STL watertight: FIN-008-B_PETG_x4.stl | open/non-manifold edges 0, mis-oriented 0 |
| PASS | STL size < 5 MB: FIN-008-B_PETG_x4.stl | 0.07 MB |
| PASS | bbox = CAD bodies: FIN-008-B_PETG_x4.stl | STL 25.9 x 35.5 x 63.8 vs CAD 25.9 x 35.5 x 63.8 mm |
| PASS | volume sane: FIN-008-B_PETG_x4.stl | mesh 9630 mm3, sum of CAD bodies 9936 mm3 (overlaps make the sum larger) |
| PASS | STL watertight: FIN-010-A_PETG_x1.stl | open/non-manifold edges 0, mis-oriented 0 |
| PASS | STL size < 5 MB: FIN-010-A_PETG_x1.stl | 0.00 MB |
| PASS | bbox = CAD bodies: FIN-010-A_PETG_x1.stl | STL 13.0 x 16.0 x 20.0 vs CAD 13.0 x 16.0 x 20.0 mm |
| PASS | volume sane: FIN-010-A_PETG_x1.stl | mesh 4068 mm3, sum of CAD bodies 4157 mm3 (overlaps make the sum larger) |
| PASS | STL watertight: FIN-010-B_PETG_x1.stl | open/non-manifold edges 0, mis-oriented 0 |
| PASS | STL size < 5 MB: FIN-010-B_PETG_x1.stl | 0.00 MB |
| PASS | bbox = CAD bodies: FIN-010-B_PETG_x1.stl | STL 12.3 x 16.0 x 20.0 vs CAD 12.3 x 16.0 x 20.0 mm |
| PASS | volume sane: FIN-010-B_PETG_x1.stl | mesh 3833 mm3, sum of CAD bodies 3920 mm3 (overlaps make the sum larger) |
| PASS | STL watertight: FIN-010-C_PETG_x1.stl | open/non-manifold edges 0, mis-oriented 0 |
| PASS | STL size < 5 MB: FIN-010-C_PETG_x1.stl | 0.00 MB |
| PASS | bbox = CAD bodies: FIN-010-C_PETG_x1.stl | STL 13.0 x 16.0 x 20.0 vs CAD 13.0 x 16.0 x 20.0 mm |
| PASS | volume sane: FIN-010-C_PETG_x1.stl | mesh 4068 mm3, sum of CAD bodies 4157 mm3 (overlaps make the sum larger) |
| PASS | STL watertight: FIN-010-D_PETG_x1.stl | open/non-manifold edges 0, mis-oriented 0 |
| PASS | STL size < 5 MB: FIN-010-D_PETG_x1.stl | 0.00 MB |
| PASS | bbox = CAD bodies: FIN-010-D_PETG_x1.stl | STL 12.3 x 16.0 x 20.0 vs CAD 12.3 x 16.0 x 20.0 mm |
| PASS | volume sane: FIN-010-D_PETG_x1.stl | mesh 3833 mm3, sum of CAD bodies 3920 mm3 (overlaps make the sum larger) |
| PASS | STL watertight: POD-001-lip_PETG_x1.stl | open/non-manifold edges 0, mis-oriented 0 |
| PASS | STL size < 5 MB: POD-001-lip_PETG_x1.stl | 0.00 MB |
| PASS | bbox = CAD bodies: POD-001-lip_PETG_x1.stl | STL 2.8 x 6.0 x 90.4 vs CAD 2.8 x 6.0 x 90.4 mm |
| PASS | volume sane: POD-001-lip_PETG_x1.stl | mesh 1519 mm3, sum of CAD bodies 1519 mm3 (overlaps make the sum larger) |
| PASS | STL watertight: POD-001-tube_PETG_x1.stl | open/non-manifold edges 0, mis-oriented 0 |
| PASS | STL size < 5 MB: POD-001-tube_PETG_x1.stl | 0.00 MB |
| PASS | volume sane: POD-001-tube_PETG_x1.stl | mesh 345 mm3, sum of CAD bodies 345 mm3 (overlaps make the sum larger) |
| PASS | STL watertight: POD-002-floorF_PETG_x1.stl | open/non-manifold edges 0, mis-oriented 0 |
| PASS | STL size < 5 MB: POD-002-floorF_PETG_x1.stl | 0.00 MB |
| PASS | bbox = CAD bodies: POD-002-floorF_PETG_x1.stl | STL 1.0 x 55.0 x 101.7 vs CAD 1.0 x 55.0 x 101.7 mm |
| PASS | volume sane: POD-002-floorF_PETG_x1.stl | mesh 4520 mm3, sum of CAD bodies 4520 mm3 (overlaps make the sum larger) |
| PASS | STL watertight: POD-002-floorR_PETG_x1.stl | open/non-manifold edges 0, mis-oriented 0 |
| PASS | STL size < 5 MB: POD-002-floorR_PETG_x1.stl | 0.01 MB |
| PASS | bbox = CAD bodies: POD-002-floorR_PETG_x1.stl | STL 30.5 x 55.0 x 84.5 vs CAD 30.5 x 55.0 x 84.5 mm |
| PASS | volume sane: POD-002-floorR_PETG_x1.stl | mesh 8914 mm3, sum of CAD bodies 8914 mm3 (overlaps make the sum larger) |
| PASS | STL watertight: POD-002-stopT_PETG_x1.stl | open/non-manifold edges 0, mis-oriented 0 |
| PASS | STL size < 5 MB: POD-002-stopT_PETG_x1.stl | 0.00 MB |
| PASS | bbox = CAD bodies: POD-002-stopT_PETG_x1.stl | STL 12.0 x 32.0 x 54.0 vs CAD 12.0 x 32.0 x 54.0 mm |
| PASS | volume sane: POD-002-stopT_PETG_x1.stl | mesh 5767 mm3, sum of CAD bodies 5767 mm3 (overlaps make the sum larger) |
| PASS | STL watertight: POD-002-guide_PETG_x2.stl | open/non-manifold edges 0, mis-oriented 0 |
| PASS | STL size < 5 MB: POD-002-guide_PETG_x2.stl | 0.00 MB |
| PASS | STL watertight: POD-002-FC_PETG_x1.stl | open/non-manifold edges 0, mis-oriented 0 |
| PASS | STL size < 5 MB: POD-002-FC_PETG_x1.stl | 0.00 MB |
| PASS | bbox = CAD bodies: POD-002-FC_PETG_x1.stl | STL 4.8 x 36.7 x 62.0 vs CAD 4.8 x 36.7 x 62.0 mm |
| PASS | volume sane: POD-002-FC_PETG_x1.stl | mesh 1994 mm3, sum of CAD bodies 1994 mm3 (overlaps make the sum larger) |
| PASS | STL watertight: POD-002-avn_PETG_x1.stl | open/non-manifold edges 0, mis-oriented 0 |
| PASS | STL size < 5 MB: POD-002-avn_PETG_x1.stl | 0.00 MB |
| PASS | bbox = CAD bodies: POD-002-avn_PETG_x1.stl | STL 5.8 x 36.7 x 48.0 vs CAD 5.8 x 36.7 x 48.0 mm |
| PASS | volume sane: POD-002-avn_PETG_x1.stl | mesh 1569 mm3, sum of CAD bodies 1569 mm3 (overlaps make the sum larger) |
| PASS | STL watertight: POD-002-PDB_PETG_x1.stl | open/non-manifold edges 0, mis-oriented 0 |
| PASS | STL size < 5 MB: POD-002-PDB_PETG_x1.stl | 0.03 MB |
| PASS | bbox = CAD bodies: POD-002-PDB_PETG_x1.stl | STL 6.8 x 36.7 x 84.0 vs CAD 6.8 x 36.7 x 84.0 mm |
| PASS | volume sane: POD-002-PDB_PETG_x1.stl | mesh 3698 mm3, sum of CAD bodies 3622 mm3 (overlaps make the sum larger) |
| PASS | STL watertight: POD-002-JR_PETG_x1.stl | open/non-manifold edges 0, mis-oriented 0 |
| PASS | STL size < 5 MB: POD-002-JR_PETG_x1.stl | 0.00 MB |
| PASS | bbox = CAD bodies: POD-002-JR_PETG_x1.stl | STL 4.0 x 5.0 x 36.7 vs CAD 4.0 x 5.0 x 36.7 mm |
| PASS | volume sane: POD-002-JR_PETG_x1.stl | mesh 680 mm3, sum of CAD bodies 680 mm3 (overlaps make the sum larger) |
| PASS | STL watertight: POD-003-tongue_PETG_x1.stl | open/non-manifold edges 0, mis-oriented 0 |
| PASS | STL size < 5 MB: POD-003-tongue_PETG_x1.stl | 0.00 MB |
| PASS | bbox = CAD bodies: POD-003-tongue_PETG_x1.stl | STL 2.0 x 5.5 x 90.4 vs CAD 2.0 x 5.5 x 90.4 mm |
| PASS | volume sane: POD-003-tongue_PETG_x1.stl | mesh 994 mm3, sum of CAD bodies 994 mm3 (overlaps make the sum larger) |
| PASS | STL watertight: POD-003-tab_PETG_x1.stl | open/non-manifold edges 0, mis-oriented 0 |
| PASS | STL size < 5 MB: POD-003-tab_PETG_x1.stl | 0.00 MB |
| PASS | bbox = CAD bodies: POD-003-tab_PETG_x1.stl | STL 1.0 x 12.0 x 40.0 vs CAD 1.0 x 12.0 x 40.0 mm |
| PASS | volume sane: POD-003-tab_PETG_x1.stl | mesh 480 mm3, sum of CAD bodies 480 mm3 (overlaps make the sum larger) |
| PASS | STL watertight: POD-003-tube_PETG_x1.stl | open/non-manifold edges 0, mis-oriented 0 |
| PASS | STL size < 5 MB: POD-003-tube_PETG_x1.stl | 0.00 MB |
| PASS | volume sane: POD-003-tube_PETG_x1.stl | mesh 436 mm3, sum of CAD bodies 436 mm3 (overlaps make the sum larger) |
| PASS | STL watertight: POD-010_PETG_x1.stl | open/non-manifold edges 0, mis-oriented 0 |
| PASS | STL size < 5 MB: POD-010_PETG_x1.stl | 0.00 MB |
| PASS | bbox = CAD bodies: POD-010_PETG_x1.stl | STL 1.5 x 51.4 x 58.9 vs CAD 1.5 x 51.4 x 58.9 mm |
| PASS | volume sane: POD-010_PETG_x1.stl | mesh 4181 mm3, sum of CAD bodies 4181 mm3 (overlaps make the sum larger) |
| PASS | STL watertight: POD-008-2mm_PETG-white_x1.stl | open/non-manifold edges 0, mis-oriented 0 |
| PASS | STL size < 5 MB: POD-008-2mm_PETG-white_x1.stl | 0.00 MB |
| PASS | bbox = CAD bodies: POD-008-2mm_PETG-white_x1.stl | STL 2.0 x 12.0 x 50.0 vs CAD 2.0 x 12.0 x 50.0 mm |
| PASS | volume sane: POD-008-2mm_PETG-white_x1.stl | mesh 394 mm3, sum of CAD bodies 394 mm3 (overlaps make the sum larger) |
| PASS | STL watertight: POD-008-4mm_PETG-yellow_x1.stl | open/non-manifold edges 0, mis-oriented 0 |
| PASS | STL size < 5 MB: POD-008-4mm_PETG-yellow_x1.stl | 0.00 MB |
| PASS | bbox = CAD bodies: POD-008-4mm_PETG-yellow_x1.stl | STL 4.0 x 12.0 x 50.0 vs CAD 4.0 x 12.0 x 50.0 mm |
| PASS | volume sane: POD-008-4mm_PETG-yellow_x1.stl | mesh 787 mm3, sum of CAD bodies 787 mm3 (overlaps make the sum larger) |
| PASS | STL watertight: POD-008-6mm_PETG-green_x1.stl | open/non-manifold edges 0, mis-oriented 0 |
| PASS | STL size < 5 MB: POD-008-6mm_PETG-green_x1.stl | 0.00 MB |
| PASS | bbox = CAD bodies: POD-008-6mm_PETG-green_x1.stl | STL 6.0 x 12.0 x 50.0 vs CAD 6.0 x 12.0 x 50.0 mm |
| PASS | volume sane: POD-008-6mm_PETG-green_x1.stl | mesh 1181 mm3, sum of CAD bodies 1181 mm3 (overlaps make the sum larger) |
| PASS | STL watertight: POD-008-8mm_PETG-blue_x1.stl | open/non-manifold edges 0, mis-oriented 0 |
| PASS | STL size < 5 MB: POD-008-8mm_PETG-blue_x1.stl | 0.00 MB |
| PASS | bbox = CAD bodies: POD-008-8mm_PETG-blue_x1.stl | STL 8.0 x 12.0 x 50.0 vs CAD 8.0 x 12.0 x 50.0 mm |
| PASS | volume sane: POD-008-8mm_PETG-blue_x1.stl | mesh 1574 mm3, sum of CAD bodies 1574 mm3 (overlaps make the sum larger) |
| PASS | STL watertight: POD-006_PETG_x1.stl | open/non-manifold edges 0, mis-oriented 0 |
| PASS | STL size < 5 MB: POD-006_PETG_x1.stl | 0.01 MB |
| PASS | bbox = CAD bodies: POD-006_PETG_x1.stl | STL 32.0 x 32.0 x 34.8 vs CAD 32.0 x 32.0 x 34.8 mm |
| PASS | volume sane: POD-006_PETG_x1.stl | mesh 5770 mm3, sum of CAD bodies 5770 mm3 (overlaps make the sum larger) |
| PASS | STL watertight: POD-007_PETG_x2.stl | open/non-manifold edges 0, mis-oriented 0 |
| PASS | STL size < 5 MB: POD-007_PETG_x2.stl | 0.04 MB |
| PASS | bbox = CAD bodies: POD-007_PETG_x2.stl | STL 39.7 x 110.6 x 130.4 vs CAD 39.7 x 110.6 x 130.4 mm |
| PASS | volume sane: POD-007_PETG_x2.stl | mesh 32908 mm3, sum of CAD bodies 32908 mm3 (overlaps make the sum larger) |
| PASS | STL watertight: POD-005_PETG_x1.stl | open/non-manifold edges 0, mis-oriented 0 |
| PASS | STL size < 5 MB: POD-005_PETG_x1.stl | 0.01 MB |
| PASS | volume sane: POD-005_PETG_x1.stl | mesh 3985 mm3, sum of CAD bodies 3985 mm3 (overlaps make the sum larger) |
| PASS | STL watertight: GER-001_PETG_x6.stl | open/non-manifold edges 0, mis-oriented 0 |
| PASS | STL size < 5 MB: GER-001_PETG_x6.stl | 0.03 MB |
| PASS | bbox = CAD bodies: GER-001_PETG_x6.stl | STL 24.8 x 25.9 x 73.0 vs CAD 24.8 x 25.9 x 73.0 mm |
| PASS | volume sane: GER-001_PETG_x6.stl | mesh 7543 mm3, sum of CAD bodies 7543 mm3 (overlaps make the sum larger) |
| PASS | STL watertight: GER-002_PETG-orange_x6.stl | open/non-manifold edges 0, mis-oriented 0 |
| PASS | STL size < 5 MB: GER-002_PETG-orange_x6.stl | 0.01 MB |
| PASS | bbox = CAD bodies: GER-002_PETG-orange_x6.stl | STL 17.8 x 19.1 x 64.8 vs CAD 17.8 x 19.1 x 64.8 mm |
| PASS | volume sane: GER-002_PETG-orange_x6.stl | mesh 2581 mm3, sum of CAD bodies 2581 mm3 (overlaps make the sum larger) |
| PASS | STL watertight: GER-007-A_TPU95A_x1.stl | open/non-manifold edges 0, mis-oriented 0 |
| PASS | STL size < 5 MB: GER-007-A_TPU95A_x1.stl | 0.00 MB |
| PASS | bbox = CAD bodies: GER-007-A_TPU95A_x1.stl | STL 4.0 x 14.3 x 20.8 vs CAD 4.0 x 14.3 x 20.8 mm |
| PASS | volume sane: GER-007-A_TPU95A_x1.stl | mesh 517 mm3, sum of CAD bodies 517 mm3 (overlaps make the sum larger) |
| PASS | STL watertight: GER-007-B_TPU95A_x1.stl | open/non-manifold edges 0, mis-oriented 0 |
| PASS | STL size < 5 MB: GER-007-B_TPU95A_x1.stl | 0.00 MB |
| PASS | bbox = CAD bodies: GER-007-B_TPU95A_x1.stl | STL 4.0 x 14.3 x 20.8 vs CAD 4.0 x 14.3 x 20.8 mm |
| PASS | volume sane: GER-007-B_TPU95A_x1.stl | mesh 517 mm3, sum of CAD bodies 517 mm3 (overlaps make the sum larger) |
| PASS | STL watertight: GER-002_PETG-blue_x6.stl | open/non-manifold edges 0, mis-oriented 0 |
| PASS | STL size < 5 MB: GER-002_PETG-blue_x6.stl | 0.01 MB |
| PASS | bbox = CAD bodies: GER-002_PETG-blue_x6.stl | STL 17.8 x 19.1 x 64.8 vs CAD 17.8 x 19.1 x 64.8 mm |
| PASS | volume sane: GER-002_PETG-blue_x6.stl | mesh 2581 mm3, sum of CAD bodies 2581 mm3 (overlaps make the sum larger) |
| PASS | STL watertight: MEC-004-A_PETG_x2.stl | open/non-manifold edges 0, mis-oriented 0 |
| PASS | STL size < 5 MB: MEC-004-A_PETG_x2.stl | 0.04 MB |
| PASS | volume sane: MEC-004-A_PETG_x2.stl | mesh 2461 mm3, sum of CAD bodies 2535 mm3 (overlaps make the sum larger) |
| PASS | STL watertight: MEC-004-B_PETG_x2.stl | open/non-manifold edges 0, mis-oriented 0 |
| PASS | STL size < 5 MB: MEC-004-B_PETG_x2.stl | 0.04 MB |
| PASS | volume sane: MEC-004-B_PETG_x2.stl | mesh 2461 mm3, sum of CAD bodies 2535 mm3 (overlaps make the sum larger) |
| PASS | STL watertight: MEC-006-A_PETG_x2.stl | open/non-manifold edges 0, mis-oriented 0 |
| PASS | STL size < 5 MB: MEC-006-A_PETG_x2.stl | 0.04 MB |
| PASS | volume sane: MEC-006-A_PETG_x2.stl | mesh 2247 mm3, sum of CAD bodies 2321 mm3 (overlaps make the sum larger) |
| PASS | STL watertight: MEC-006-B_PETG_x2.stl | open/non-manifold edges 0, mis-oriented 0 |
| PASS | STL size < 5 MB: MEC-006-B_PETG_x2.stl | 0.04 MB |
| PASS | volume sane: MEC-006-B_PETG_x2.stl | mesh 2247 mm3, sum of CAD bodies 2321 mm3 (overlaps make the sum larger) |
| PASS | STL watertight: MEC-007-A_PETG_x1.stl | open/non-manifold edges 0, mis-oriented 0 |
| PASS | STL size < 5 MB: MEC-007-A_PETG_x1.stl | 0.00 MB |
| PASS | bbox = CAD bodies: MEC-007-A_PETG_x1.stl | STL 0.8 x 40.9 x 42.9 vs CAD 0.8 x 40.9 x 42.9 mm |
| PASS | volume sane: MEC-007-A_PETG_x1.stl | mesh 1338 mm3, sum of CAD bodies 1338 mm3 (overlaps make the sum larger) |
| PASS | STL watertight: MEC-007-B_PETG_x1.stl | open/non-manifold edges 0, mis-oriented 0 |
| PASS | STL size < 5 MB: MEC-007-B_PETG_x1.stl | 0.00 MB |
| PASS | bbox = CAD bodies: MEC-007-B_PETG_x1.stl | STL 0.8 x 40.9 x 42.9 vs CAD 0.8 x 40.9 x 42.9 mm |
| PASS | volume sane: MEC-007-B_PETG_x1.stl | mesh 1338 mm3, sum of CAD bodies 1338 mm3 (overlaps make the sum larger) |
| PASS | STL watertight: MEC-008-A_PETG_x2.stl | open/non-manifold edges 0, mis-oriented 0 |
| PASS | STL size < 5 MB: MEC-008-A_PETG_x2.stl | 0.01 MB |
| PASS | bbox = CAD bodies: MEC-008-A_PETG_x2.stl | STL 13.5 x 34.9 x 34.9 vs CAD 13.5 x 34.9 x 34.9 mm |
| PASS | volume sane: MEC-008-A_PETG_x2.stl | mesh 2249 mm3, sum of CAD bodies 2529 mm3 (overlaps make the sum larger) |
| PASS | STL watertight: MEC-008-B_PETG_x2.stl | open/non-manifold edges 0, mis-oriented 0 |
| PASS | STL size < 5 MB: MEC-008-B_PETG_x2.stl | 0.01 MB |
| PASS | bbox = CAD bodies: MEC-008-B_PETG_x2.stl | STL 13.5 x 34.9 x 34.9 vs CAD 13.5 x 34.9 x 34.9 mm |
| PASS | volume sane: MEC-008-B_PETG_x2.stl | mesh 2249 mm3, sum of CAD bodies 2529 mm3 (overlaps make the sum larger) |
| PASS | STL watertight: PWR-006_PETG_x1.stl | open/non-manifold edges 0, mis-oriented 0 |
| PASS | STL size < 5 MB: PWR-006_PETG_x1.stl | 0.01 MB |
| PASS | bbox = CAD bodies: PWR-006_PETG_x1.stl | STL 28.8 x 34.0 x 126.0 vs CAD 28.8 x 34.0 x 126.0 mm |
| PASS | volume sane: PWR-006_PETG_x1.stl | mesh 10274 mm3, sum of CAD bodies 10534 mm3 (overlaps make the sum larger) |
| PASS | STL watertight: AVN-005_PETG_x1.stl | open/non-manifold edges 0, mis-oriented 0 |
| PASS | STL size < 5 MB: AVN-005_PETG_x1.stl | 0.02 MB |
| PASS | volume sane: AVN-005_PETG_x1.stl | mesh 878 mm3, sum of CAD bodies 878 mm3 (overlaps make the sum larger) |
| PASS | STL watertight: HRN-110-A_ASA_x3.stl | open/non-manifold edges 0, mis-oriented 0 |
| PASS | STL size < 5 MB: HRN-110-A_ASA_x3.stl | 0.04 MB |
| PASS | volume sane: HRN-110-A_ASA_x3.stl | mesh 162 mm3, sum of CAD bodies 162 mm3 (overlaps make the sum larger) |
| PASS | STL watertight: HRN-110-B_ASA_x3.stl | open/non-manifold edges 0, mis-oriented 0 |
| PASS | STL size < 5 MB: HRN-110-B_ASA_x3.stl | 0.03 MB |
| PASS | volume sane: HRN-110-B_ASA_x3.stl | mesh 160 mm3, sum of CAD bodies 162 mm3 (overlaps make the sum larger) |
| PASS | STL watertight: JIG-01_PETG_x2.stl | open/non-manifold edges 0, mis-oriented 0 |
| PASS | STL size < 5 MB: JIG-01_PETG_x2.stl | 0.05 MB |
| PASS | bbox = CAD bodies: JIG-01_PETG_x2.stl | STL 51.0 x 64.0 x 64.0 vs CAD 51.0 x 64.0 x 64.0 mm |
| PASS | volume sane: JIG-01_PETG_x2.stl | mesh 40561 mm3, sum of CAD bodies 40561 mm3 (overlaps make the sum larger) |
| PASS | STL watertight: JIG-02_PETG_x4.stl | open/non-manifold edges 0, mis-oriented 0 |
| PASS | STL size < 5 MB: JIG-02_PETG_x4.stl | 0.02 MB |
| PASS | bbox = CAD bodies: JIG-02_PETG_x4.stl | STL 25.0 x 34.0 x 77.0 vs CAD 25.0 x 34.0 x 77.0 mm |
| PASS | volume sane: JIG-02_PETG_x4.stl | mesh 20346 mm3, sum of CAD bodies 20346 mm3 (overlaps make the sum larger) |
| PASS | STL watertight: JIG-03-A_PETG_x2.stl | open/non-manifold edges 0, mis-oriented 0 |
| PASS | STL size < 5 MB: JIG-03-A_PETG_x2.stl | 0.00 MB |
| PASS | bbox = CAD bodies: JIG-03-A_PETG_x2.stl | STL 24.0 x 31.2 x 60.0 vs CAD 24.0 x 31.2 x 60.0 mm |
| PASS | volume sane: JIG-03-A_PETG_x2.stl | mesh 39221 mm3, sum of CAD bodies 39221 mm3 (overlaps make the sum larger) |
| PASS | STL watertight: JIG-03-B_PETG_x2.stl | open/non-manifold edges 0, mis-oriented 0 |
| PASS | STL size < 5 MB: JIG-03-B_PETG_x2.stl | 0.00 MB |
| PASS | bbox = CAD bodies: JIG-03-B_PETG_x2.stl | STL 24.0 x 31.2 x 60.0 vs CAD 24.0 x 31.2 x 60.0 mm |
| PASS | volume sane: JIG-03-B_PETG_x2.stl | mesh 39221 mm3, sum of CAD bodies 39221 mm3 (overlaps make the sum larger) |
| PASS | WNG-004 = wing plugs.od_m x length | STL 19.8 x 19.8 x 36.0 vs params 19.8 x 19.8 x 36.0 mm |
| PASS | WNG-005 = wing plugs.od_m x length | STL 19.8 x 19.8 x 20.0 vs params 19.8 x 19.8 x 20.0 mm |
| PASS | FIN-007 ESC pad = fin_detail.esc_pad len x h x t | STL 1.2 x 31.0 x 46.0 vs params 1.2 x 31.0 x 46.0 mm |
| PASS | POD-008 spacer 2 mm = pod spacer_set_m | 2.00 mm thick |
| PASS | POD-008 spacer 4 mm = pod spacer_set_m | 4.00 mm thick |
| PASS | POD-008 spacer 6 mm = pod spacer_set_m | 6.00 mm thick |
| PASS | POD-008 spacer 8 mm = pod spacer_set_m | 8.00 mm thick |
| PASS | JIG-01 post height | 51.0 mm |
| PASS | FIN-003 mounts = propulsion.n_motors | 4 |
| PASS | DXF closed CUT polylines: foamboard_sheet1of5.dxf | 18 closed outlines |
| PASS | DXF pieces inside the sheet: foamboard_sheet1of5.dxf | 762 x 508 mm |
| PASS | DXF closed CUT polylines: foamboard_sheet2of5.dxf | 12 closed outlines |
| PASS | DXF pieces inside the sheet: foamboard_sheet2of5.dxf | 762 x 508 mm |
| PASS | DXF closed CUT polylines: foamboard_sheet3of5.dxf | 8 closed outlines |
| PASS | DXF pieces inside the sheet: foamboard_sheet3of5.dxf | 762 x 508 mm |
| PASS | DXF closed CUT polylines: foamboard_sheet4of5.dxf | 8 closed outlines |
| PASS | DXF pieces inside the sheet: foamboard_sheet4of5.dxf | 762 x 508 mm |
| PASS | DXF closed CUT polylines: foamboard_sheet5of5.dxf | 4 closed outlines |
| PASS | DXF pieces inside the sheet: foamboard_sheet5of5.dxf | 762 x 508 mm |
| PASS | DXF closed CUT polylines: coroplast_sheet1of2.dxf | 6 closed outlines |
| PASS | DXF pieces inside the sheet: coroplast_sheet1of2.dxf | 2438.4 x 1219.2 mm |
| PASS | DXF closed CUT polylines: coroplast_sheet2of2.dxf | 2 closed outlines |
| PASS | DXF pieces inside the sheet: coroplast_sheet2of2.dxf | 2438.4 x 1219.2 mm |
| PASS | DXF closed CUT polylines: ply3_sheet1of2.dxf | 19 closed outlines |
| PASS | DXF pieces inside the sheet: ply3_sheet1of2.dxf | 1219.2 x 609.6 mm |
| PASS | DXF closed CUT polylines: ply3_sheet2of2.dxf | 4 closed outlines |
| PASS | DXF pieces inside the sheet: ply3_sheet2of2.dxf | 1219.2 x 609.6 mm |
| PASS | FIN-001 board UR/UL: tip |z| = fins.half_height_m, TE x = fins.te_x_m | tip 210.00 (params 210.00), TE 320.00 (params 320.00) mm |
| PASS | FIN-001 board LR/LL: tip |z| = fins.half_height_m, TE x = fins.te_x_m | tip 210.00 (params 210.00), TE 320.00 (params 320.00) mm |
| PASS | POD-001 floor width = pod.size_m[1] - 2 board_t | 130.4 vs 130.4 mm |
| PASS | TRN-001 floor = trn.box.external_m L x W | 1250.0 x 550.0 mm |
| PASS | JIG-01 board post spacing = 2 x fins.y_m | 640.00 vs 640.00 mm |
| PASS | template root chord = wing.chord_m + 2 x kerf offset | 320.51 vs 320.49 mm |
| PASS | template root section max thickness = wing.t_c x chord | 31.44 vs 31.42 mm |
| PASS | template root depth = section z-extent (.dat) + 2 x offset | 31.92 vs 31.94 mm |
| PASS | template root TE >= k09kit.TE_MIN_M | TE 0.60 mm |
| PASS | template root spar mark at wing.spar.x_m / z_m | x 80.0 z 6.6 mm, bore D 22.4 |
| PASS | template tip chord = wing.chord_m + 2 x kerf offset | 320.51 vs 320.49 mm |
| PASS | template tip section max thickness = wing.t_c x chord | 31.44 vs 31.42 mm |
| PASS | template tip depth = section z-extent (.dat) + 2 x offset | 31.92 vs 31.94 mm |
| PASS | template tip TE >= k09kit.TE_MIN_M | TE 0.60 mm |
| PASS | template tip spar mark at wing.spar.x_m / z_m | x 80.0 z 6.6 mm, bore D 22.4 |
