davinciucberkeley-collab/DBF-Combined/redesign/manufacturing/out/SHOP-PACK.md

# K09-L shop pack

Generated by `python -B redesign/manufacturing/make_shop_files.py` from the CAD builders (stub backend) and Blender 4.2. Re-run after any CAD change; every file below is rebuilt. Checks: [`CHECKS.md`](CHECKS.md). Fixes MF-01 (review/MANUFACTURING.md).

## What is here

| File(s) | What | Make on (Jacobs Hall) |
|---|---|---|
| `print/*.stl` (51 files, 96 prints) | Every printed flight part, one STL per distinct geometry, mm, already in print orientation (flat face down; see the `orientation` column). Name = `<part>_<material>_x<qty incl. spares>.stl`. Mirror parts are separate files (A/B) | PETG/TPU: Prusa (open access). ASA: enclosed printer, not on the open-access list (MF-15) |
| `PRINT-LIST.csv` | Per file: part, material, colour, qty (flight + spare), orientation, layer, perimeters, infill, supports, est. time and mass each, CAD mass, source of each setting, hold status | - |
| `jigs/*.stl` (4 files) | JIG-01 tube posts, JIG-02 fin-alignment collar, JIG-03 cant gauge A/B | Prusa, PETG |
| `laser/foamboard_sheet*.dxf` | Half-fin boards (2 per laminate, incl. 4 spare laminates) and the pod shell / hatch boards, nested on 20 x 30 in sheets | Universal laser **48 x 25 in** (the only bed a 20 x 30 sheet fits); or print `foamboard_1to1_letter.pdf` and knife-cut |
| `laser/coroplast_sheet*.dxf` | Box floor, walls, lid and lid lips as separate panels on 48 x 96 in sheets (MF-16: the cross blank does not fit a sheet) | Knife and straightedge on the bench (panels exceed every laser bed) |
| `laser/ply3_sheet*.dxf` | JIG-01 base board and top bar, 3 handle backing strips, 2 landing-mat panels | Universal laser 48 x 25 in |
| `laser/foamboard_1to1_letter.pdf` (15 pages) | 1:1 knife templates of every foam-board piece | any printer at 100 % |
| `hotwire/WNG-001_template_root.dxf`, `..._tip.dxf` | S5010 c 320 hot-wire templates, true size + 0.24 mm kerf offset, TE 0.6 mm; MARK layer: true section, chord line, 10 % stations, spar bore D 22.4 at x 80 z 6.6, hinge x 249.6; pin holes on the chord line | Universal laser, 2 mm hardboard/ply |
| `hotwire/WNG-001_templates_1to1_letter.pdf` (4 pages) | The same templates tiled 1:1 on letter paper with registration crosses and a 100 mm scale check, for gluing onto hardboard if the laser is not available | any printer at 100 % |
| `CUT-LIST.csv` | Every sheet piece: file, qty, size, material, kerf, which laser bed it fits, source | - |
| `contact-sheet.png`, `dxf-preview.png` | Picture of every print on its bed; every nest | - |

Estimated printing: about **40 printer-hours** for all flight prints incl. spares (PRINT-LIST estimate: volume flow + layer changes, not a slicer), filament about ASA 93 g, PETG 555 g, TPU95A 1 g.

## Order to make them

Shop access ends 18 Dec (MF-04): items 1-6 before then.

1. **Print the jigs and the fit-test set** (`jigs/`, then one each of FIN-004, FIN-003-A, GER-001, GER-002). Check the 22.3 mm bores on a real tube, the shoe/piston slide, the block on the spar. If a fit is off, change the CAD params (not the STL) and re-run.
2. **Laser-cut the hot-wire templates** (`hotwire/*.dxf`, 2 mm hardboard). Sand the riding edge. Pin both to the blank ends through the chord-line holes so both LEs sit on one line. Cut 2-3 practice cores; measure the kerf and update `shopconfig.HOTWIRE["kerf_mm"]` if it is not 1.0 mm (MF-05).
3. **Laser-cut the ply** (`laser/ply3_*`): JIG-01 board and top bar first (needed for the spar bond), then handle strips and mat panels.
4. **Print the long-lead flight parts**: FIN-004 blocks (+1 spare; MF-06), FIN-003 mounts in ASA (A and B, 8 total), WNG-004/005 plugs, POD-002 tray set, POD-007 handle, PWR-006 frame, MEC-* horns/frames/covers, GER-001/002 (colours), GER-007 in TPU. **FIN-008 collars are ON HOLD** until the 18 Dec freeze (MF-13).
5. **Cut the foam-board** (`laser/foamboard_*`): laminate fin boards in pairs (3M 77, spray booth) - either cut single boards and laminate on pins through the MARK circles, or laminate first and knife-cut the pair from the 1:1 PDF. Then the pod board set.
6. **Wing core** (wing/BUILD.md 2-5) with the templates; then **spar + block bond in JIG-01**: bolt the two posts to the base board, stand dummy 22 mm tubes (tape-wrapped as release) in the posts, thread both blocks, slide the spar through, drop the top bar over both tube tops, check the tubes with a square in two directions, bond and cure 24 h without moving the jig.
7. **Half-fin root bonds with JIG-02**: slide a collar down each motor tube to the tube end, half-fin in the slot, root fillet, cure. Remove before the station collars go on.
8. **Motor mounts with JIG-03** (fins/BUILD.md step 18): hold the gauge (A on UR/LL, B on UL/LR) flat on the outboard fin face against the tube at |z| 60-85 mm (clear of the ESC pad), zero an angle cube on face D (the face looking forward, -x), move the cube to the bell top (prop off): 0.0 +/- 0.5 deg; turn the cube 90 deg and repeat. Face D is 7.00 deg from square to the tube (the modelled cant, params propulsion.stations.cant_deg).
9. **Coroplast box** (`laser/coroplast_*`, knife): panels, corner angles, then transport/BUILD.md 5-16.

## Jigs: how to use

| Jig | Files | Use |
|---|---|---|
| JIG-01 tube-bore / block clocking (MF-06) | `jigs/JIG-01_*` (2 posts), `laser/ply3_*` (base board, top bar) | Board flat on the bench; posts bolted with 4 x M4 each into the engraved squares; the LE line on the board is parallel to the tube line. Bores in post and bar are tube OD + 0.3 / + 0.4 mm. The two supports 45 mm and ~cradle + core height mm apart hold each tube within about 0.4 deg, so both blocks are clocked by the tubes, not by eye |
| JIG-02 fin-alignment collar (MF-08) | `jigs/JIG-02_*` (x4) | On the motor tube near its end; the half-fin laminate sits in the slot (laminate + 0.3 mm), so the fin plane passes through the tube axis and stays square to the wing while the root fillet cures |
| JIG-03 cant gauge (MF-07) | `jigs/JIG-03-A_*` (UR/LL), `JIG-03-B_*` (UL/LR) | Datum face D = the bell top of that station as modelled (7 deg tangential cant). Relieved over the 10 mm LE edge strip so it sits on the board face. Check after every prop strike or mount slip |

## Not exported, or exported with a caveat

- POD-001 "fb floor bevel": not a flat sheet body (depth 130.4 mm, section 4.8 x 4.8 mm) -> shaped by hand (pod/BUILD.md step 3)
- Hot-wired and hand-cut foam parts (wing core cuts, elevons, pod LE filler and crush block, cradle saddles, prop tray, cartridges) are not sheet or print parts: the templates and BUILD.md numbers cover them.
- DXF outlines are nominal (no kerf offset). Laser kerf is listed per sheet; the hot-wire templates DO include the wire kerf.
