davinciucberkeley-collab/DBF-Combined/redesign/blender/out/examples/figures/step_1.annotated.png

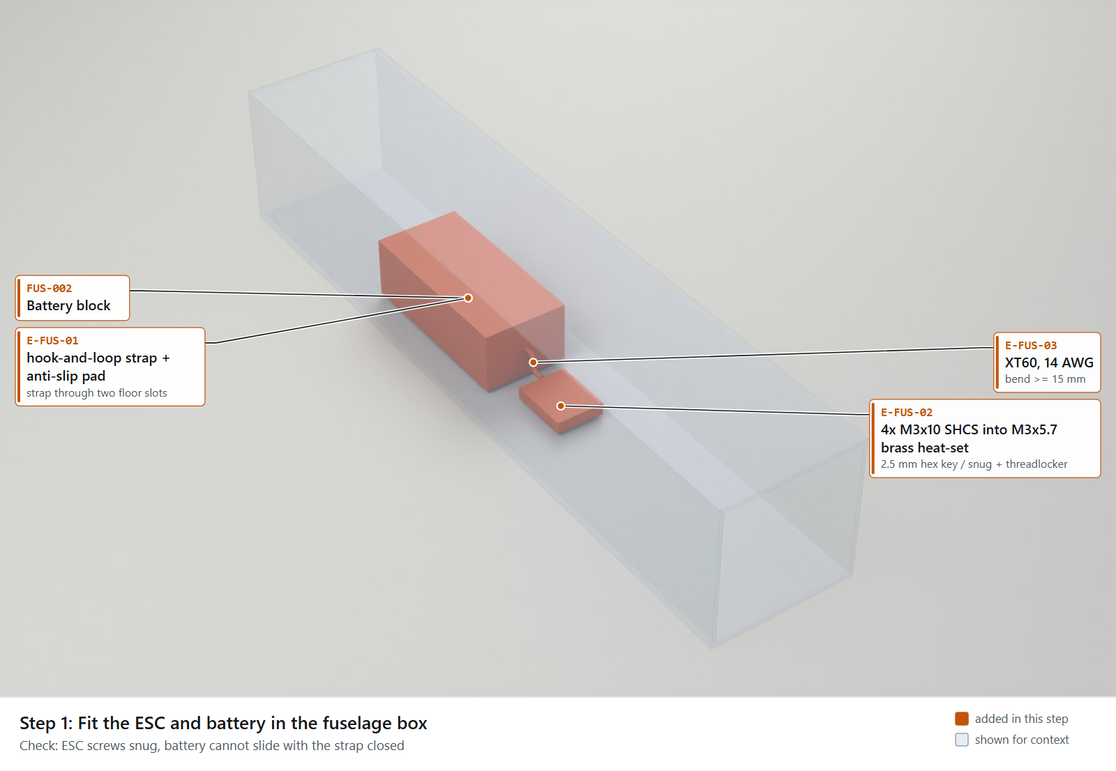
redesign/blender/out/examples/figures/step_1.annotated.png
