davinciucberkeley-collab/DBF-Combined/redesign/blender/out/examples/figures/step_1.jpg

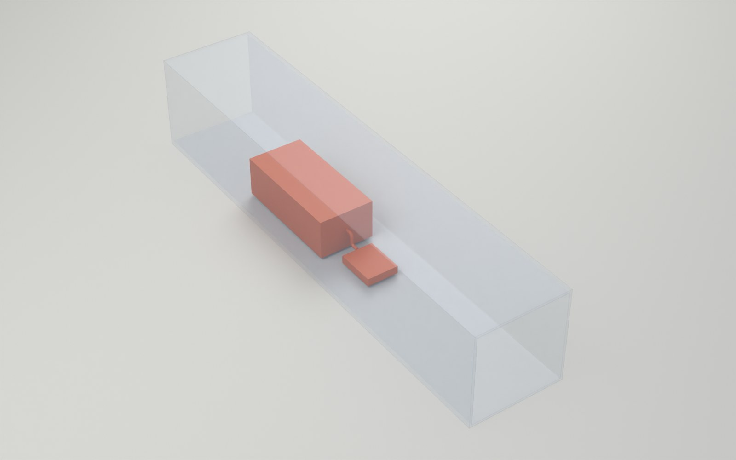
redesign/blender/out/examples/figures/step_1.jpg
