davinciucberkeley-collab/DBF-Combined/redesign/blender/out/examples/figures/step_2.annotated.png

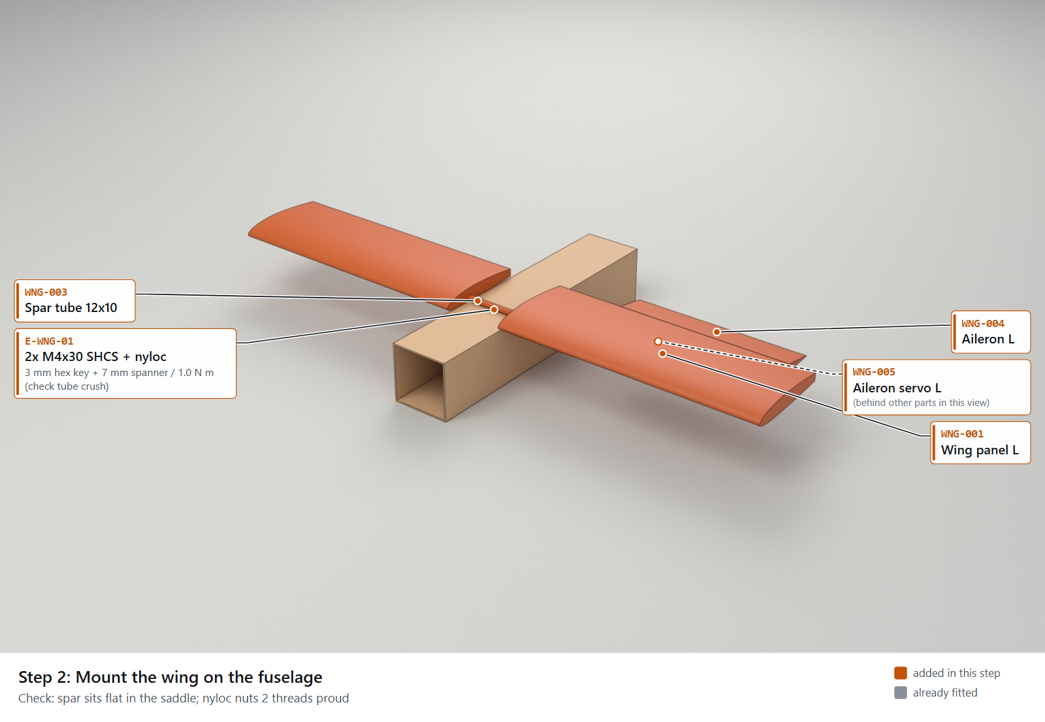
redesign/blender/out/examples/figures/step_2.annotated.png
