davinciucberkeley-collab/DBF-Combined/redesign/blender/out/examples/figures/step_2.jpg

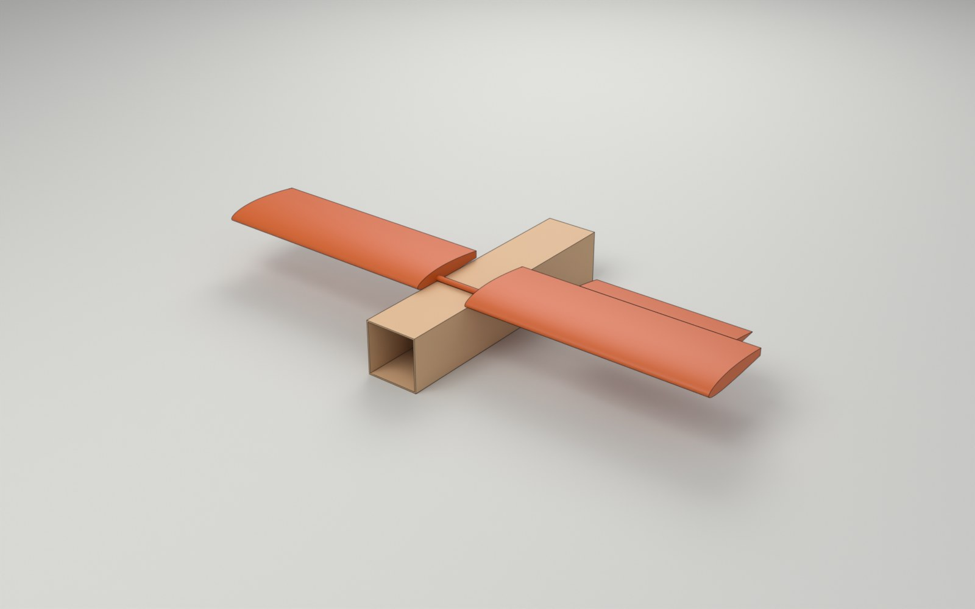
redesign/blender/out/examples/figures/step_2.jpg
