davinciucberkeley-collab/DBF-Combined/redesign/blender/out/examples/figures/step_3.annotated.png

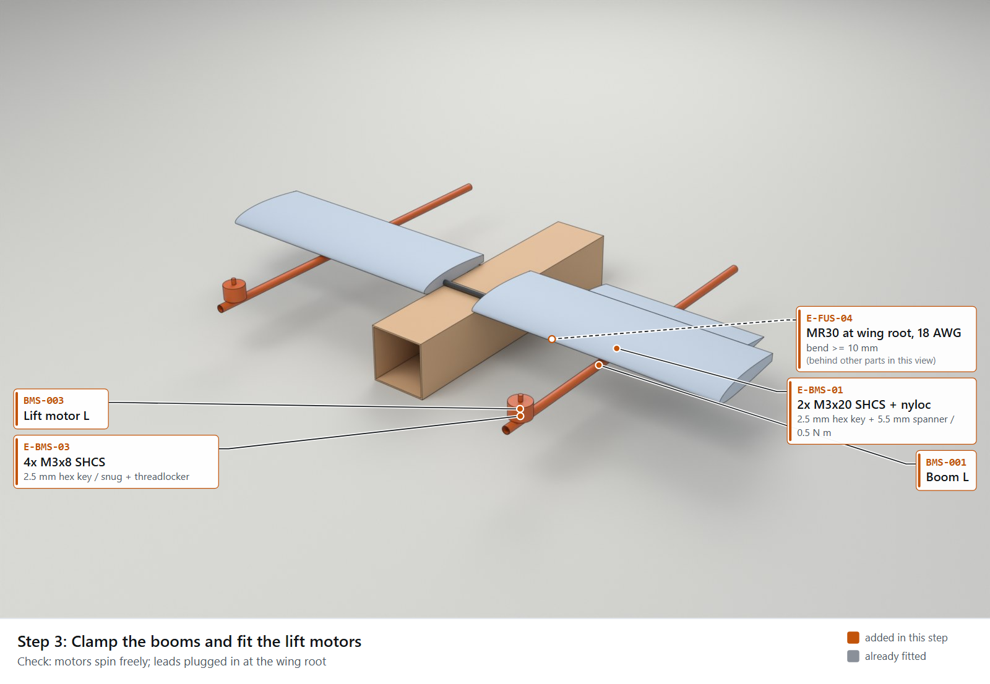
redesign/blender/out/examples/figures/step_3.annotated.png
