davinciucberkeley-collab/DBF-Combined/redesign/blender/out/examples/figures/step_3.jpg

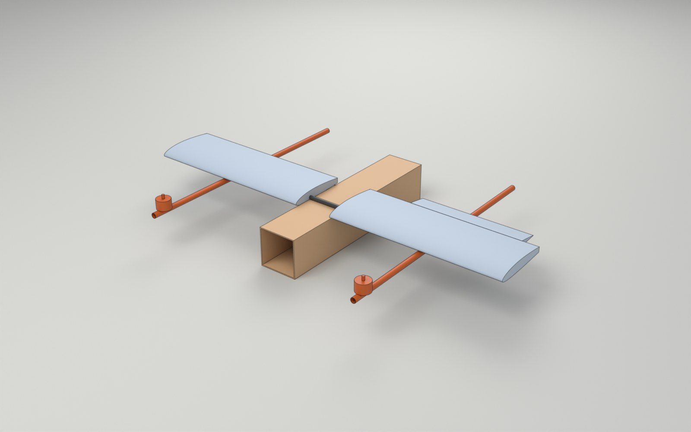
redesign/blender/out/examples/figures/step_3.jpg
