davinciucberkeley-collab/DBF-Combined/redesign/manufacturing/out/contact-sheet.png

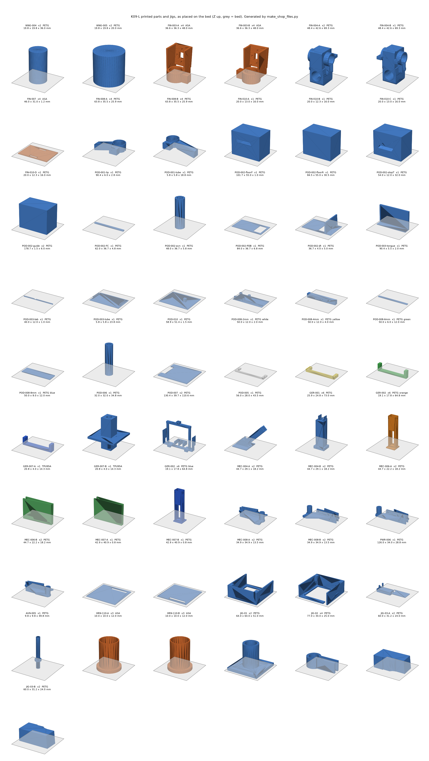
redesign/manufacturing/out/contact-sheet.png
