davinciucberkeley-collab/DBF-Combined/redesign/manufacturing/out/dxf-preview.png

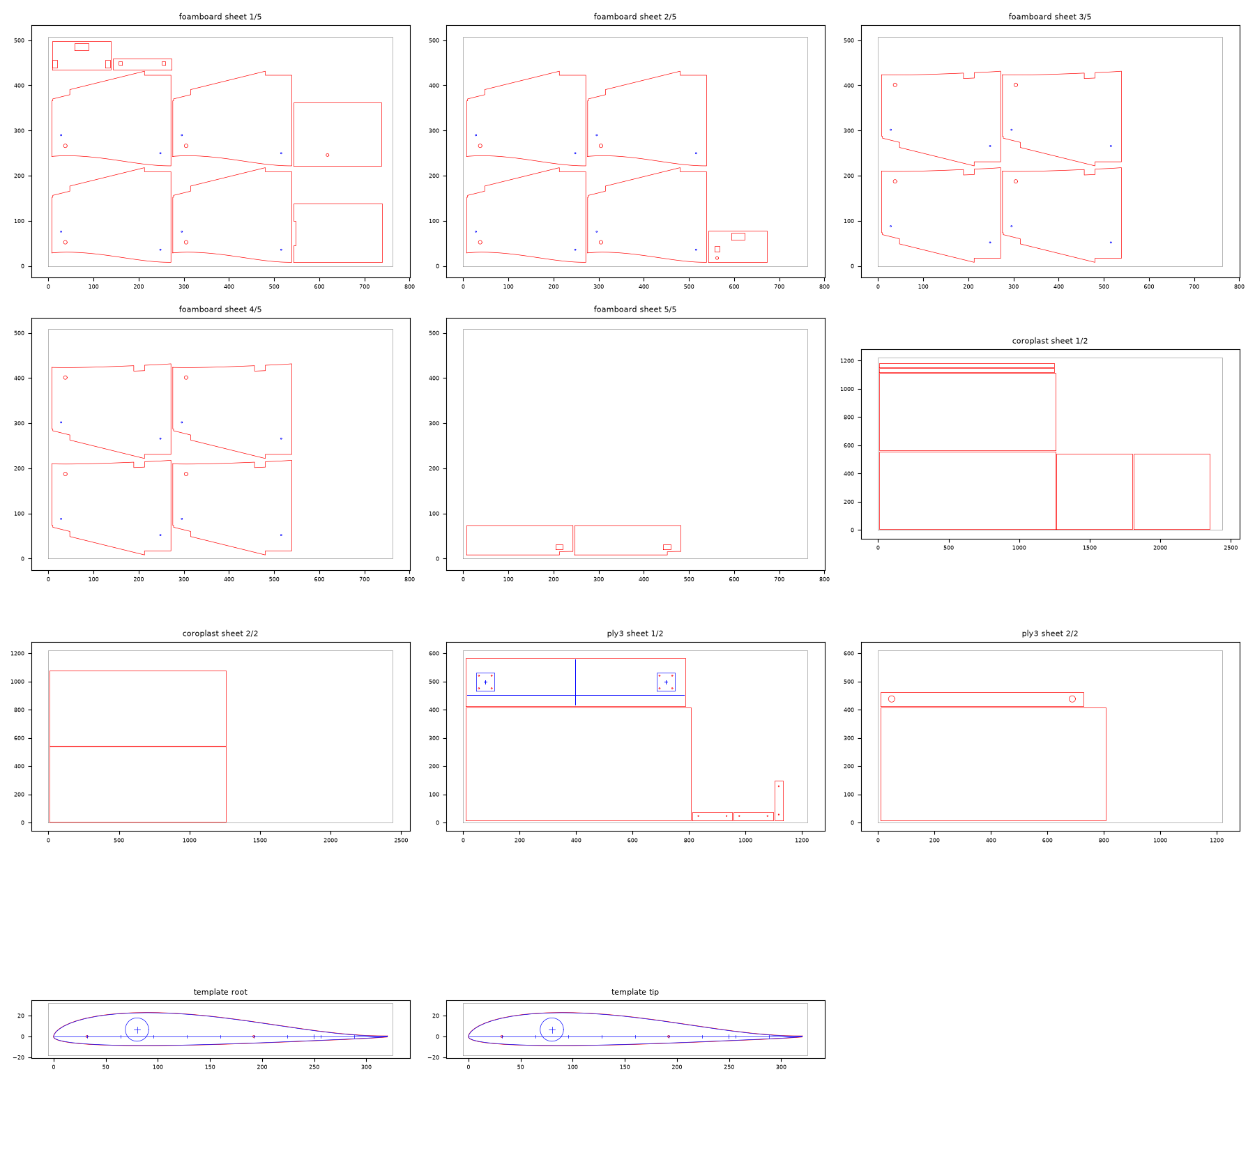
redesign/manufacturing/out/dxf-preview.png
