davinciucberkeley-collab/DBF-Combined/redesign/showcase/pages/overview-howto.png

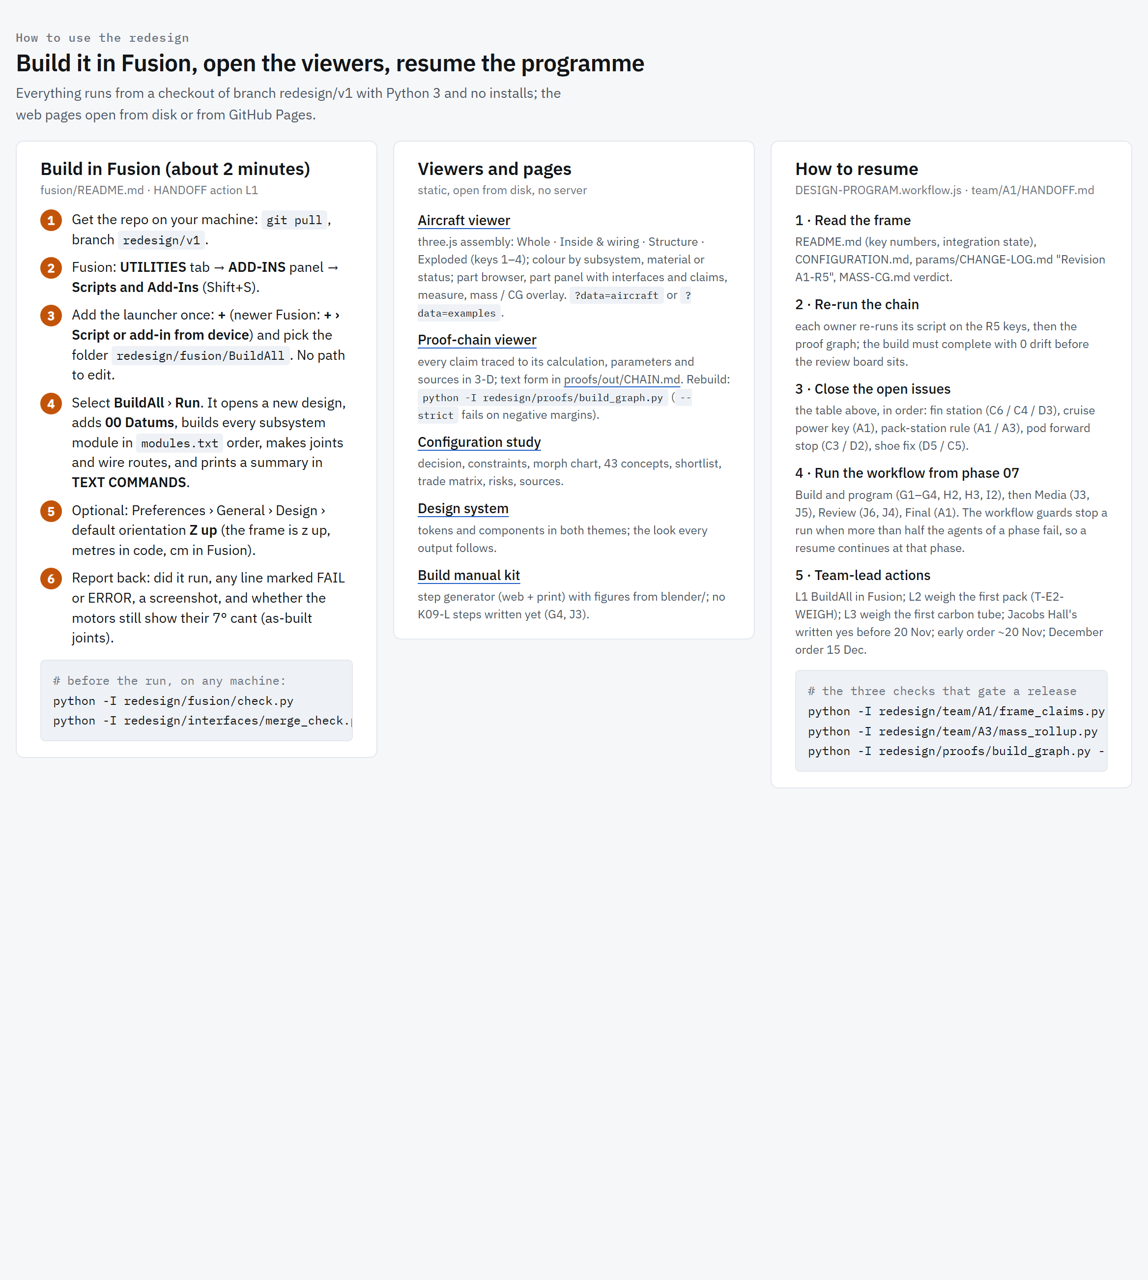
redesign/showcase/pages/overview-howto.png
