davinciucberkeley-collab/DBF-Combined/redesign/subsystems/flight-software/TUNING-PLAN.md

# flight-software — tuning plan

Revision F4-R5, 2026-11-10 (D-65 descent, D-71 `AIRSPEED_MIN` from the measured stall). Status `PROPOSED`; nothing below has been done. Order follows CONFIGURATION.md (twin
first, fixed-wing tune before any transition) and the ArduPilot tailsitter tuning guide. Each step has a stop
condition; a failed step is repeated, not skipped. Owner F4 with H1 (bench, stand) and H2 (flight).

| Step | Where | What | Parameters touched | Done when |
|---|---|---|---|---|
| 1 | bench, **props off** | load `K09L.param`; motor test A–D; check by eye (inclinometer) that every prop end leans outboard and toward the wing (SPEC.md, CR-F4-11); LH nuts on LL and UR; elevon directions in FBWA and QSTABILIZE; failsafes with the transmitter off and a bench supply | `SERVO5/6_MIN/MAX/TRIM/REVERSED` (`T-D6-THROW`, CR-D6-09): start from the file (L 1003/1500/1976 rev, R 1024/1500/1997), full pitch + full roll stick in FBWA, protractor on each TE, trim each end to +25.0 / −25.0° separately; no end outside 1000–2000 µs without D6 | map as SPEC.md; elevons move the right way; each TE ±25° ± 0.5°; RC loss → QLAND shown in the HUD |
| 1b | bench, props on, hanging (CR-B4-16b, `T-F4-HANG-YAW`) | airframe nose-up on one line; motor test UR + LL only at 15 %: frame yaws the way of their reaction torque (−x); repeat UL + LR (+x) | none | both pairs yaw the expected way; otherwise stop: cant prints swapped (CR-F4-11) |
| 2 | thrust stand (H1), one station | load `K09L-STAND.param` over the flight file (limiter 25 A, raw-IMU batch log ≥ 1 kHz, CR-H1-18); full stick in QSTABILIZE, fresh pack; ESC rpm telemetry; 10 % output step for the thrust lag (`T-F4-THRUST-LAG`); thrust vs output curve; reload `K09L.param` after | `Q_M_SPIN_MAX`, `Q_M_SPIN_MIN`/`ARM`, `Q_M_THST_EXPO` (from the curve), `SERVO_BLH_POLES` | rpm ≤ 9 350 at 0.84; output 0.704 gives ≤ 7 950 rpm; pack ≤ 100 A on four motors (R-ESC-CURRENT); lag reported to B3 (below 30 ms: pitch margin < 6 dB at 4 Hz) |
| 3 | twin / tethered hover | hover 60 s, log `INS_LOG_BAT`; set notch from the FFT | `INS_HNTCH_*`, `Q_M_THST_HOVER` (learnt) | no gyro peak at 1P/2P; VIBE < 30 m/s², Clip 0 |
| 4 | tethered hover | after T-C2-TAP-TEST: sharp pitch and yaw stick inputs → feed-forward from log, then D and P by oscillate-and-halve; QAUTOTUNE roll only. **P ceilings (crossover ≤ 4.5 / 4.5 / 2.4 Hz until T-C2-TAP-TEST, CR-B3-19; A3-R5 inertia): roll 0.34, pitch 0.14 (with D 0.002), yaw 0.94, yaw D 0** (`CALC-F4-XOVER`); reject autotune values above them; a gyro FFT peak at 12–15 Hz or 21–27 Hz → static notch `INS_HNTC2_*` on it before any gain increase | `Q_A_RAT_*` | no oscillation; yaw holds in 5 m/s fan or wind; no 12–15 Hz peak growing with gain |
| 5 | free hover | QLOITER, landings wingtip into wind with QLAND for the last 6 m (0.3 m/s, CR-D5-21); one QHOVER full-down-stick descent from 10 m to 2 m on the twin to read the overshoot over `Q_PILOT_SPD_DN` 1.0 (≤ 1.2 m/s, D-65); RC9 cut at contact, 20 logged touchdowns (`T-F4-TD-CUT`) | `Q_WVANE_GAIN`, `Q_LOIT_*` if needed | hold within 1 m in 5 m/s (R-TWIN); contact → RCOU minimum ≤ 0.5 s |
| 6 | hand-launch, FBWA | plain flying wing, motors as throttle; AUTOTUNE pitch then roll; trim elevons (expect −6.1° at 16 m/s, target CG; CR-B3-15). Before the MS4525DO is bought (CR-I1-16): `ARSPD_TYPE` 0, FBWA only (no CRUISE/AUTO/RTL in fixed wing); speed scaling then uses the synthetic estimate | `RLL_RATE_*`, `PTCH_RATE_*`, `TRIM`, `YAW2SRV_DAMP`, `RUDD_DT_GAIN` | yaw doublet damped (T-B3-YAW-DOUBLET); TECS holds 16 m/s (sensor fitted) |
| 6b | FBWA at ≥ 80 m | full-down stick, idle, 20 s (`T-F4-DIVE`); keep FW `RLL/PTCH_RATE_D` at 0 (12 Hz default D filter sits on the torsion mode) | — | airspeed ≤ 20.5 m/s |
| 6c | FBWB at ≥ 60 m, fresh pack | full-throttle level leg, 20 s (CR-B1-17 b, CR-C1-20) | `THR_MAX`, downward only | airspeed ≤ 21.8 m/s, ESC rpm ≤ 7 950; each motor RCOU ≤ 0.79 with rudder |
| 6d | twin, then K09-L at ≥ 60 m (B2's `T-B2-STALL`, D-71) | three slow-flight stalls in FBWA at 2.6 kg and the forward CG (0.0466), airspeed logged, 1 kt/s deceleration; F4 reads the trimmed stall from the logs | `AIRSPEED_MIN` = ceil(1.3 × measured stall) (16 while ≤ 12.31 m/s), `AIRSPEED_STALL` = ceil(measured stall), `AIRSPEED_CRUISE` ≥ `AIRSPEED_MIN`; re-run `fsw_check.py` | three runs agree within 0.3 m/s; `CL-F4-ARSPD-MIN-D71` re-pointed at the measured value; no transition before this step |
| 7 | transition at ≥ 50 m | FBWA from QHOVER, 12 °/s, morning ≤ 5 m/s; abort to QHOVER on any doubt | `Q_TAILSIT_RAT_FW`, `Q_TAILSIT_ANGLE` | ≥ 15.5 m/s, height loss ≤ 10 m (T-B1-TRANSITION-LOG); peak motor output logged |
| 8 | back-transition at ≥ 50 m | QHOVER from cruise | `Q_TAILSIT_RAT_VT`, `Q_TAILSIT_THR_VT` | no tumble, height loss ≤ 10 m |
| 9 | after the cold-pack stand run | raise `Q_TAILSIT_RAT_FW` to **15 °/s at most** (CR-B1-12 rev 3), only if the stand shows sag ≥ 0.76 and step-7 logs show peak output ≤ 0.7 | `Q_TAILSIT_RAT_FW` | peak output ≤ 0.77 of full on a pack at `BATT_LOW` |

Rules: one parameter change per flight; every change logged with the log number in `team/F4/sitl/RESULTS.md` or the
flight log; the parameter file is re-saved and re-checked (`python -I redesign/team/F4/fsw_check.py`) after each
session. Gains above the step-4 ceilings or `THR_MAX` above 70 need a new F4 revision, not a field change.
