davinciucberkeley-collab/DBF-Combined/redesign/team/A2/VERIFICATION-MATRIX.md

# Verification matrix — K09-L quad tailsitter

Generated 2026-11-10 23:22 UTC by `team/A2/build_requirements.py` from `team/A2/requirements.json` and `proofs/out/graph.json` (graph built 2026-11-10 20:10 UTC, OK). Status is computed by `proofs/build_graph.py` from the claims that name each requirement in `verifies`; nobody types it. Re-run: `python -I redesign/team/A2/build_requirements.py`.

## Summary

| Requirements | With ≥ 1 claim | `VERIFIED` | `CHECKED` | `PROPOSED` | `UNVERIFIED` | `FAIL` |
|---|---|---|---|---|---|---|
| 59 | 44 | 0 | 1 | 1 | 57 | 11 |

Failing now: `R-MASS-GATE` (CL-A1-MASS-SIZED is UNVERIFIED; CL-A1-RESERVE-COVERS is UNVERIFIED; CL-A1-ALLOC-GATE is UNVERIFIED; CL-A3-MASS-BASIC is UNVERIFIED; CL-A3-MASS-PREDICTED is UNVERIFIED; CL-A3-GATE-MARGIN is UNVERIFIED; CL-A3-GATE-MARGIN-680: FAILS: margin -66.0% (0.03403 kg vs >= 0.1 kg); CL-A3-GATE-MARGIN-503 is UNVERIFIED; CL-A5-ASSY-MASS is UNVERIFIED), `R-MASS-ALLOC` (CL-A3-ALLOC-WORST: FAILS: margin -4.4% (1.044 vs <= 1); CL-C2-WING-MASS is UNVERIFIED; CL-C3-POD-MASS-REC is UNVERIFIED; CL-D1-WING-MASS is UNVERIFIED; CL-D2-MASS is UNVERIFIED; CL-D3-MASS: FAILS: margin -4.0% (434.8 g vs <= 418 g)), `R-STATIC-MARGIN` (CL-A1-CG-RANGE-AFT is UNVERIFIED; CL-A1-PACK-CG-AFT is UNVERIFIED; CL-B3-SM-TARGET is UNVERIFIED; CL-B3-V-CG-A3-AFT is UNVERIFIED; CL-B3-V-SM-A3 is UNVERIFIED; CL-B3-V-CG-A3-AFT-ENV is UNVERIFIED; CL-B3-V-SM-A3-ENV: FAILS: margin -4.8% (0.0476 vs >= 0.05)), `R-WIND` (CL-B1-LEAN-5MS is UNVERIFIED; CL-B1-WIND-HOVER-MAX is UNVERIFIED; CL-B1-GUST-8-THRUST is UNVERIFIED; CL-B1-GROUND-TIP-WIND is UNVERIFIED; CL-B1V-WIND-HOVER-MAX is UNVERIFIED; CL-B1V-GROUND-TIP-WIND is UNVERIFIED; CL-B1V-GUST-8-THRUST is UNVERIFIED; CL-B3-HOVER-PITCH-RATIO is UNVERIFIED; CL-B3-HOVER-ROLL-RATIO is UNVERIFIED; CL-B3-HOVER-YAW-RATIO is UNVERIFIED; CL-C5-V-LAND-SPANWISE is UNVERIFIED; CL-C5-V-PARK-GUST is UNVERIFIED; CL-C5-SIM3D-V-BROADSIDE: FAILS: margin -20.0% (4 m/s vs >= 5 m/s); CL-C5-SIM3D-V-SPANWISE is UNVERIFIED), `R-PROP-CLEAR` (CL-A1-PROP-CLEAR is UNVERIFIED; CL-B4-GAP-V is UNVERIFIED; CL-B4-TIP-WING is UNVERIFIED; CL-B4-TIP-WING-LOWER is UNVERIFIED; CL-B4-GAP-TUBE-ENV: FAILS: margin -15.4% (0.02114 m vs >= 0.025 m); CL-B4-GAP-TUBE is UNVERIFIED; CL-B4-GAP-COLLAR is UNVERIFIED; CL-D3-PROP-GAP is UNVERIFIED; CL-D3-PROP-TIP-GAP is UNVERIFIED; CL-E1-TIP-GAP-TUBE: FAILS: margin -15.6% (0.02111 m vs >= 0.025 m)), `R-PACK-MASS` (CL-A3-GATE-MARGIN-680: FAILS: margin -66.0% (0.03403 kg vs >= 0.1 kg); CL-E2-SKU-MASS-MARGIN is UNVERIFIED), `R-STRUCT-MARGIN` (CL-C2-SPAR-SIGMA-ULT is UNVERIFIED; CL-C2-SPAR-SIGMA-ENV is UNVERIFIED; CL-C2-SPAR-TAU-ULT is UNVERIFIED; CL-C2-SPAR-BUCKLE is UNVERIFIED; CL-C2-SPAR-SIGMA-BRACE is UNVERIFIED; CL-C2-V-REVERSAL is UNVERIFIED; CL-C2-V-DIVERGENCE is UNVERIFIED; CL-C2-V-FLUTTER is UNVERIFIED; CL-C2-PLUG-BEARING is UNVERIFIED; CL-C2-SPAR-BOND-TAU is UNVERIFIED; CL-C2-CHORD-TAPE is UNVERIFIED; CL-C2-TIP-FOAM is UNVERIFIED; CL-C2-ROOT-TAPE is UNVERIFIED; CL-C2-POD-FOAM is UNVERIFIED; CL-C2-FEA-SPAR-SIGMA-ULT is UNVERIFIED; CL-C2-FEA-TIP-DEFL-FRAC is UNVERIFIED; CL-C2-FEA-FOAM-S1 is UNVERIFIED; CL-C2-FEA-FOAM-TAU is UNVERIFIED; CL-C2-FEA-PETG is UNVERIFIED; CL-C2-FEA-FOAM-CORNER-S1: FAILS: margin -35.5% (2.032e+05 Pa vs <= 1.5e+05 Pa); CL-C2-FEA-FOAM-CORNER-S3: FAILS: margin -65.8% (1.99e+05 Pa vs <= 1.2e+05 Pa); CL-C3-FEA-BOND-R-DESIGN: FAILS: margin -40.5% (1.405 vs <= 1); CL-C3-FEA-TIED-R-DESIGN is UNVERIFIED; CL-C3-BOND-R-DESIGN is UNVERIFIED; CL-C3-BOND-SIGMA-DESIGN is UNVERIFIED; CL-C3-OVERHANG-DESIGN is UNVERIFIED; CL-C3-HANDLE-TIES is UNVERIFIED; CL-C3-GRIP is UNVERIFIED; CL-C4-D3-MS-FACE is UNVERIFIED; CL-C4-D3-MS-EDGE is UNVERIFIED; CL-C4-D3-MS-TUBE is UNVERIFIED; CL-C4-D3-MS-BRACE is UNVERIFIED; CL-C4-D3-MS-BRACE-END is UNVERIFIED; CL-C4-D3-MS-COLLAR is UNVERIFIED; CL-C4-D3-MS-ANCHOR is UNVERIFIED; CL-C4-D3-MS-EAR is UNVERIFIED; CL-C4-D3-MS-STRIP-PAPER is UNVERIFIED; CL-C4-D3-MS-CAP-G3 is UNVERIFIED; CL-C4-D3-MS-MOUNT-SLIP is UNVERIFIED; CL-C4-D3-BLOCK-MS is UNVERIFIED; CL-C4-D3-MS-FACE-SHOE is UNVERIFIED; CL-C6-MOTOR-HEAD-RF is UNVERIFIED; CL-C6-MOTOR-SEP-RF is UNVERIFIED; CL-C6-MOTOR-STRIP-RF is UNVERIFIED; CL-C6-MOUNT-SIDE-SLIP-RF is UNVERIFIED; CL-C6-MOUNT-SIDE-AXIAL-RF is UNVERIFIED; CL-C6-MOUNT-ROCK-RF is UNVERIFIED; CL-C6-MOUNT-HOOP-RF is UNVERIFIED; CL-C6-PWR-INSTALL-RF is UNVERIFIED; CL-C6-PWR-TENSION-RF is UNVERIFIED; CL-C6-PWR-SLIP-RF is UNVERIFIED; CL-C6-PWR-SPACER-RF is UNVERIFIED; CL-C6-INSERT-PULL-RF is UNVERIFIED; CL-C6-TUBE-BLOCK-RF is UNVERIFIED; CL-C6-BLOCK-SPAR-RF is UNVERIFIED; CL-C6-COLLAR-RF is UNVERIFIED; CL-C6-COLLAR-RF-13MM is UNVERIFIED; CL-C6-COLLAR-RF-16MM is UNVERIFIED; CL-C6-COLLAR-L-REQ is UNVERIFIED; CL-C6-STRIP-ANCHOR-F is UNVERIFIED; CL-C6-STRIP-ANCHOR-RF is UNVERIFIED; CL-C6-STRIP-EMBED-REQ is UNVERIFIED; CL-C6-STRIP-TAIL-NET-RF is UNVERIFIED; CL-C6-STRIP-FACE-RF is UNVERIFIED; CL-C6-STRIP-PIN-RF: FAILS: margin -18.5% (0.815 vs >= 1); CL-C6-STRIP-PIN-RF-PROP is UNVERIFIED; CL-C6-STRIP-PIN-RF-ALT is UNVERIFIED; CL-C6-STRIP-PIN-PITCH-MAX is UNVERIFIED; CL-C6-STRIP-PIN-BRG-RF is UNVERIFIED; CL-C6-STRIP-NET-PIN-RF is UNVERIFIED; CL-C6-BRACE-END-RF is UNVERIFIED; CL-C6-ANCHOR-PULL-RF is UNVERIFIED; CL-C6-FOOT-SHOE-RF is UNVERIFIED; CL-C6-FIN-ROOT-RF is UNVERIFIED; CL-C6-FIN-ROOT-RF-PROP is UNVERIFIED; CL-C6-POD-WING-RF is UNVERIFIED; CL-C6-POD-HATCH-RF is UNVERIFIED; CL-C6-POD-ALLOW-RATIO is UNVERIFIED; CL-C6-LINK-BOND-AREA-MIN is UNVERIFIED; CL-D2-TIE-CAP is UNVERIFIED; CL-D3-SLIP-HOLD is UNVERIFIED; CL-D3-STRAP-EYE-RF is UNVERIFIED; CL-D3-ROOT-FILLET-RF-ALLOW is UNVERIFIED; CL-D3-BRACE-PCR is UNVERIFIED; CL-D3-WIRE-HOLE-CLEAR is UNVERIFIED), `R-VIBRATION` (CL-C2-WING-MODE-SEP: FAILS: margin -64.2% (0.07166 vs >= 0.2); CL-C4-D3-SEP is UNVERIFIED; CL-C4-D3-SEP-WORST is UNVERIFIED; CL-C4-D3-SEP-WHIRL is UNVERIFIED; CL-C4-D3-MOUNT-K-REQ is UNVERIFIED; CL-C4-SIM-SEP is UNVERIFIED; CL-F3-VIBE-T1P is UNVERIFIED; CL-F4-XOVER-RLL is UNVERIFIED; CL-F4-XOVER-PIT is UNVERIFIED; CL-F4-FILT-SEP is UNVERIFIED; CL-F4-NOTCH-LOW is UNVERIFIED; CL-J1-TUBE-MODE-SEP: FAILS: margin -91.4% (0.0172 vs >= 0.2)), `R-PACK-RETENTION` (CL-C1-CRASH-N is UNVERIFIED; CL-C1-PACK-CRASH-LOAD is UNVERIFIED; CL-C3-FEA-BOND-R-CRASH: FAILS: margin -1003.7% (11.04 vs <= 1); CL-C3-FEA-TIED-R-CRASH: FAILS: margin -350.0% (4.5 vs <= 1); CL-C3-FEA-SADDLE-TIES is UNVERIFIED; CL-C3-FEA-OVERHANG-CRASH is UNVERIFIED; CL-C3-FEA-AFT-STOP-PEAK: FAILS: margin -232.9% (4.993e+07 Pa vs <= 1.5e+07 Pa); CL-C3-FEA-AFT-TRAY-BEND: FAILS: margin -92.6% (4.816e+07 Pa vs <= 2.5e+07 Pa); CL-C3-FEA-AFT-PEEL: FAILS: margin -716.3% (4.081e+05 Pa vs <= 50000 Pa); CL-C3-FEA-AFT-PROP-PEEL is UNVERIFIED; CL-C3-FEA-AFT-PROP-PEAK is UNVERIFIED; CL-C3-FEA-FWD-PEEL: FAILS: margin -704.1% (4.02e+05 Pa vs <= 50000 Pa); CL-C3-FEA-FWD-BED-PEEL: FAILS: margin -681.6% (3.908e+05 Pa vs <= 50000 Pa); CL-C3-STRUT-BEARING is UNVERIFIED; CL-C3-STRUT-BUCKLE is UNVERIFIED; CL-C3-STRUT-BRIDGE is UNVERIFIED; CL-C3-FEA-FWD-TRAY-BEND: FAILS: margin -197.6% (7.441e+07 Pa vs <= 2.5e+07 Pa); CL-C3-BOND-R-CRASH is UNVERIFIED; CL-C3-AFT-STOP-D2: FAILS: margin -10.6% (1.659e+07 Pa vs <= 1.5e+07 Pa); CL-C3-AFT-STOP-BOND is UNVERIFIED; CL-C3-AFT-STOP-REC: FAILS: margin -10.6% (1.659e+07 Pa vs <= 1.5e+07 Pa); CL-C3-FWD-STOP-REC is UNVERIFIED; CL-C3-GUIDE-D2 is UNVERIFIED; CL-C3-GUIDE-REC is UNVERIFIED; CL-C3-STRAP-LEG is UNVERIFIED; CL-C3-STRAP-OVERLAP-REQ is UNVERIFIED; CL-C3-TRAY-FLAT is UNVERIFIED; CL-C3-FLOOR-GLUE-FILLET is UNVERIFIED; CL-C3-OVERHANG-CRASH is UNVERIFIED; CL-C3-FWD-STOP-FUSE is UNVERIFIED; CL-C3-BLOCK-A-SHARE is UNVERIFIED; CL-C3-STOP-SECTION-PENALTY is UNVERIFIED; CL-C5-PACK-NOSE-ROOM is UNVERIFIED; CL-C5-PACK-ROOM-MARGIN-WORST is UNVERIFIED; CL-C6-POD-CRASH-RF is UNVERIFIED; CL-C6-POD-TRAY-RF is UNVERIFIED; CL-C6-POD-FLOOR-RF: FAILS: margin -9.6% (0.9035 vs >= 1); CL-C6-POD-FLOOR-RF-PROP is UNVERIFIED; CL-D2-BLOCK-B-550 is UNVERIFIED; CL-D2-BLOCK-B-LIGHT is UNVERIFIED; CL-D2-BLOCK-B-HEAVY is UNVERIFIED; CL-D2-BLOCK-B-NOM is UNVERIFIED; CL-D2-PACK-X-FWD-MIN is UNVERIFIED; CL-D2-FWD-STOP-BOND is UNVERIFIED; CL-D2-AFT-STOP-BOND is UNVERIFIED; CL-D2-STRAP-CAP is UNVERIFIED), `R-LANDING-IMPACT` (CL-C1-N-LAND-STROKE-MIN is UNVERIFIED; CL-C1-WINGTIP-STRIKE-ANGLE is UNVERIFIED; CL-C1-FOOT-D5-RATIO is UNVERIFIED; CL-C5-DROP-PAIR-PITCH is UNVERIFIED; CL-C5-DROP-PAIR-ROLL is UNVERIFIED; CL-C5-DYN-LEVEL-FREE-PROP is UNVERIFIED; CL-C5-DYN-N-LEVEL is UNVERIFIED; CL-C5-SIM3D-STROKE: FAILS: margin -10.2% (0.03859 m vs <= 0.035 m); CL-C5-SIM3D-N: FAILS: margin -9.8% (6.586 vs <= 6); CL-C5-SIM3D-BOTTOM-TILT: FAILS: margin -50.0% (5 deg vs >= 10 deg); CL-C5-FEA-SHOE-SF: FAILS: margin -78.1% (0.2189 vs >= 1); CL-D3-TIP-SQUARE is UNVERIFIED; CL-D3-TIP-STEP-MISMATCH is UNVERIFIED; CL-D3-ROOT-FILLET-RF is UNVERIFIED; CL-D3-ROOT-FILLET-RF-ALLOW is UNVERIFIED), `R-DISCONNECT` (CL-PWR-JUMPER-RISE is UNVERIFIED; CL-F1-DISC-REQ-CONT is UNVERIFIED; CL-F1-DISC-REQ-SHORT is UNVERIFIED; CL-F1-ILIM-WORST is UNVERIFIED; CL-F1-MAIN-RISE is UNVERIFIED; CL-F1-MAIN-PEAK is UNVERIFIED; CL-F1-ESC-RISE is UNVERIFIED; CL-F1-ESC-PEAK is UNVERIFIED; CL-F1-BUNDLE-RISE is UNVERIFIED; CL-F1-BUNDLE-PEAK is UNVERIFIED; CL-F1-PACKLEAD-RISE is UNVERIFIED; CL-F1-PACKLEAD-PEAK is UNVERIFIED; CL-J1-DISCONNECT-REQ is UNVERIFIED; CL-J1-DISCONNECT-REQ-PESS is UNVERIFIED; CL-J1-XT60-CONT-PESS: FAILS: margin -6.3% (35 A vs >= 37.36 A); CL-J1-XT60-BURST: FAILS: margin -50.0% (60 A vs >= 120 A)).

Method: A analysis · I inspection · T test · D demonstration. On disk: evidence files that exist today / listed (a `logs/<test id>_*.csv` entry is H1's raw-data name per CR-H1-07 and counts when any dated file matches). `UNVERIFIED (no claim)` means the owner has not yet emitted a claim naming the id.

## Matrix

| ID | Title | Owner | Support | Method | Evidence | On disk | Claims | Margin | Status |
|---|---|---|---|---|---|---|---|---|---|
| `R-CONFIG` | Configuration K09-L | A1 | A4 | I | `README.md` `team/A1/claims.json` | 2/2 | `CL-A1-WING-AREA` | — | `CHECKED` |
| `R-MISSION` | Mission endurance | B1 | E2 H2 | A+T | `team/B1/claims.json` `team/E2/claims.json` `team/H2/logs/` | 2/3 | `CL-B1-CRUISE-P` `CL-B1-CRUISE-TIME` `CL-B1-CRUISE-TIME-PESS` `CL-B1V-CRUISE-P` `CL-B1V-CRUISE-TIME` `CL-B1V-CRUISE-TIME-PESS` `CL-E1-CRUISE-P-55` `CL-E2-CRUISE-MIN-BASE` `CL-E2-CRUISE-MIN-PESS` `CL-E2-CRUISE-TO-LOW-PESS` `CL-F4-BATT-CRT` | +0 % | `UNVERIFIED` |
| `R-ENVELOPE` | Props-off envelope | A5 | D1 D3 | A+I | `fusion/check.py` `team/A5/claims.json` | 2/2 | — | — | `UNVERIFIED` (no claim) |
| `R-STALL` | Stall speed | B2 | B1 H2 | A+T | `team/B2/claims.json` `team/A1/claims.json` `team/H2/logs/` | 2/3 | `CL-A1-STALL-GATE` `CL-B1-VS-GATE` `CL-B1-VS-SIZED` `CL-B1V-VS-PRED` `CL-B1V-VS-GATE` `CL-B2-STALL-GATE` `CL-B2-STALL-GATE-FWD` `CL-B2R3-VS-GATE-FWD` `CL-B2R3-VS-GATE-AFT` `CL-B3-VS-TRIM` `CL-B3-VS-TRIM-FWD` `CL-B3-V-VS-A3` | +0 % | `UNVERIFIED` |
| `R-TRANSITION` | Transition speed | B1 | F4 H2 | A+T | `team/B1/claims.json` `team/H2/logs/` | 1/2 | `CL-A1-TRANSITION-GATE` `CL-B1-VT-GATE` `CL-B1-CORR-THRUST` `CL-B1-TRANS-ALT-LOSS` `CL-B1-TRANS-THRUST` `CL-B1V-VT-PRED` `CL-B1V-VT-GATE` `CL-B1V-TRANS-THRUST` `CL-B1V-TRANS-ALT-LOSS` `CL-B1V-CORR-THRUST` `CL-B2-TRANSITION-GATE` `CL-B2-TRANSITION-GATE-FWD` `CL-B2R3-VTR-GATE-FWD` `CL-B3-VT-TRIM` `CL-B3-TRANS-PITCH-USE` `CL-B3-V-VT` `CL-E1-CORRIDOR-45` `CL-E1-CORRIDOR-55` `CL-F4-ARSPD-MIN-FLOOR` `CL-F4-CRUISE-TRANS` | +0 % | `UNVERIFIED` |
| `R-MASS-GATE` | Mass gate 2.6 kg | A3 | H1 | A+T | `MASS-CG.md` `team/A1/claims.json` `team/A3/claims.json` `team/H1/claims.json` `team/H1/logs/T-A1-WEIGH_*.csv` | 4/5 | `CL-A1-MASS-SIZED` `CL-A1-RESERVE-COVERS` `CL-A1-ALLOC-GATE` `CL-A3-MASS-BASIC` `CL-A3-MASS-PREDICTED` `CL-A3-GATE-MARGIN` `CL-A3-GATE-MARGIN-680` `CL-A3-GATE-MARGIN-503` `CL-A5-ASSY-MASS` | -66 % | `UNVERIFIED` `FAIL` |
| `R-MASS-ALLOC` | Subsystem mass allocations | A3 | all designers | A+T | `MASS-CG.md` `team/A3/claims.json` | 2/2 | `CL-A3-ALLOC-WORST` `CL-C2-WING-MASS` `CL-C3-POD-MASS-REC` `CL-D1-WING-MASS` `CL-D2-MASS` `CL-D3-MASS` | -4 % | `UNVERIFIED` `FAIL` |
| `R-CG-RANGE` | As-built CG range | A3 | B3 A5 H1 | A+T | `MASS-CG.md` `team/A3/claims.json` `team/B3/claims.verify.json` `team/A5/claims.json` `team/A1/claims.json` `team/H1/claims.json` `team/H1/logs/T-A3-CG-BALANCE_*.csv` | 6/7 | `CL-A1-CG-RANGE-FWD` `CL-A1-CG-RANGE-AFT` `CL-A1-CG-CENTRED` `CL-A1-PACK-STATION` `CL-A1-PACK-CG-FWD` `CL-A1-PACK-CG-AFT` `CL-A1-NOSE-BALLAST` `CL-A3-CG-X-RANGE` `CL-A3-CG-X-STATIONS` `CL-A3-PACK-TRIM` `CL-A3-CG-Y` `CL-A3-CG-Z-RANGE` `CL-A5-ASSY-CG-X` `CL-A5-ASSY-CG-X-FWD` `CL-A5-ASSY-CG-X-RANGE-USE` `CL-B3-V-CG-A3-FWD` `CL-B3-V-CG-A3-AFT` `CL-B3-V-CG-A3-AFT-ENV` `CL-D2-PACK-X-NOM` `CL-D2-PACK-X-LIGHT` `CL-D2-PACK-X-550` `CL-D2-PACK-FWD-ROOM` `CL-D2-AFT-REACH` `CL-D2-PACK-TRAVEL` `CL-D2-SPACER-SUM` | +0 % | `UNVERIFIED` |
| `R-HOVER-SPLIT` | Hover pitch-trim thrust split | A3 | B3 F4 H2 | A+T | `MASS-CG.md` `team/A3/claims.json` `team/H2/logs/` | 2/3 | `CL-A3-HOVER-SPLIT` | +3 % | `UNVERIFIED` |
| `R-STATIC-MARGIN` | Static margin | B3 | H2 | A+T | `team/B3/claims.json` `team/B3/claims.verify.json` `team/H2/logs/` | 2/3 | `CL-A1-CG-RANGE-AFT` `CL-A1-PACK-CG-AFT` `CL-B3-SM-TARGET` `CL-B3-V-CG-A3-AFT` `CL-B3-V-SM-A3` `CL-B3-V-CG-A3-AFT-ENV` `CL-B3-V-SM-A3-ENV` | -5 % | `UNVERIFIED` `FAIL` |
| `R-HOVER-TW` | Hover thrust-to-weight | E1 | H1 | A+T | `team/E1/claims.json` `team/A1/claims.json` `team/H1/claims.json` | 3/3 | `CL-A1-HOVER-TW-GATE` `CL-A1-HOVER-TW-SAG` `CL-B1-HOVER-THROTTLE` `CL-B1-HOVER-TW-SAG` `CL-B1V-HOVER-THROTTLE` `CL-B1V-HOVER-TW-SAG` `CL-B1V-HOVER-TW` `CL-B4-TW-CAP` `CL-B4-SIM-TW-CAP` `CL-E1-TW-TABLE` `CL-E1-ILIM-TW-FRESH` `CL-E1-TW-WORST` | +17 % | `UNVERIFIED` |
| `R-WIND` | Wind | B1 | H2 H3 | A+D | `team/B1/claims.json` `team/H2/logs/` | 1/2 | `CL-B1-LEAN-5MS` `CL-B1-WIND-HOVER-MAX` `CL-B1-GUST-8-THRUST` `CL-B1-GROUND-TIP-WIND` `CL-B1V-WIND-HOVER-MAX` `CL-B1V-GROUND-TIP-WIND` `CL-B1V-GUST-8-THRUST` `CL-B3-HOVER-PITCH-RATIO` `CL-B3-HOVER-ROLL-RATIO` `CL-B3-HOVER-YAW-RATIO` `CL-C5-V-LAND-SPANWISE` `CL-C5-V-PARK-GUST` `CL-C5-SIM3D-V-BROADSIDE` `CL-C5-SIM3D-V-SPANWISE` `CL-D5-PAD-MU` | -20 % | `UNVERIFIED` `FAIL` |
| `R-GUST-LEAN` | 8 m/s gust survive-and-land | B1 | F4 | A | `team/B1/claims.json` `subsystems/flight-software/params/` | 1/2 | — | — | `UNVERIFIED` (no claim) |
| `R-TIPOVER` | Stance tip-over | C5 | D5 H1 H3 | A+T | `team/C5/LANDING.md` `team/C5/claims.json` `team/C5/claims.sim.json` `team/A1/claims.json` `team/H1/GROUND-TEST-PLAN.md` `team/H1/logs/T-C5-TILT-BOARD_*.csv` `team/H3/FLIGHT-CARD.md` | 5/7 | `CL-A1-TIPOVER` `CL-B1-GROUND-TIP-WIND` `CL-B1V-GROUND-TIP-WIND` `CL-C1-TIPOVER-WITH-FOOT` `CL-C5-TIPOVER-R1` `CL-C5-TIPOVER-WORST` `CL-C5-TIPOVER-D47` `CL-C5-TIPOVER-REQ-SPANWISE` `CL-C5-SIM3D-DRIFT-TIPS` `CL-D5-TIPOVER-CORNER` | +2 % | `UNVERIFIED` |
| `R-DIRECTIONAL` | Directional stability in cruise | B3 | J1 H2 | A+T | `team/B3/claims.json` `team/J1/claims.json` `team/H2/logs/` | 2/3 | `CL-B3-CNB` `CL-B3-DR-ZETA` `CL-B3-V-CNB` `CL-B3-V-DR-ZETA` `CL-J1-FIN-YAW-ARM` | +18 % | `UNVERIFIED` |
| `R-SPIRAL` | Spiral mode | B3 | F4 H2 H3 | A+I+D | `team/B3/claims.verify.json` `team/B3/S-AND-C.md` `subsystems/flight-software/K09L.param` `team/F4/claims.json` `team/H3/FLIGHT-CARD.md` `team/H2/logs/` | 4/6 | — | — | `UNVERIFIED` (no graph) |
| `R-HOVER-AUTHORITY` | Hover control authority | B3 | A3 H2 | A+D | `team/B3/claims.json` `team/H2/logs/` | 1/2 | `CL-B3-HOVER-PITCH-RATIO` `CL-B3-HOVER-PITCH-ACCEL` `CL-B3-HOVER-ROLL-RATIO` `CL-B3-HOVER-ROLL-ACCEL` `CL-B3-HOVER-YAW-RATIO` `CL-B3-HOVER-YAW-ACCEL` `CL-B3-HOVER-CANT-REQ` `CL-B3-FLEX-GM-PITCH` `CL-B3-FLEX-GM-YAW` | +46 % | `UNVERIFIED` |
| `R-CRUISE-AUTHORITY` | Elevon authority in cruise | B3 | B2 H2 | A+T | `team/B3/claims.json` `team/H2/logs/` | 1/2 | `CL-B3-TRIM-USE-VT` `CL-B3-ROLL-RATE-VT` | +39 % | `UNVERIFIED` |
| `R-ELEVON-AREA` | Elevon area | B3 | D1 H2 | A+D | `team/A1/claims.json` `team/B3/claims.json` `team/H2/logs/` | 2/3 | `CL-A1-ELEVON-FRAC` `CL-A5-ELEVON-GAP-MIN` `CL-B3-ELEVON-FRAC-MAX` `CL-B3-ELEVON-FRAC-MIN` `CL-D1-ELEVON-FRAC` | +14 % | `UNVERIFIED` |
| `R-SERVO-TORQUE` | Elevon servo torque | D6 | B2 H1 | A+T | `team/B2/sim/claims.sim.json` `team/B2/claims.json` `team/D6/claims.json` `subsystems/mechanisms/SPEC.md` `team/H1/claims.json` | 5/5 | `CL-B2R3-SERVO-TORQUE-REQ` `CL-D6-SERVO-TORQUE-REQ` | +11 % | `UNVERIFIED` |
| `R-PROP-CLEAR` | Prop clearance | D3 | B4 E1 A5 | A+I | `team/E1/claims.json` `team/B4/claims.json` `team/A5/claims.json` `team/A1/claims.json` `fusion/check.py` `subsystems/fins/SPEC.md` | 6/6 | `CL-A1-PROP-CLEAR` `CL-B4-GAP-V` `CL-B4-TIP-WING` `CL-B4-TIP-WING-LOWER` `CL-B4-GAP-TUBE-ENV` `CL-B4-GAP-TUBE` `CL-B4-GAP-COLLAR` `CL-D3-PROP-GAP` `CL-D3-PROP-TIP-GAP` `CL-E1-TIP-GAP-TUBE` | -16 % | `UNVERIFIED` `FAIL` |
| `R-AIRSPEED` | Airspeed sensor placement and accuracy | F3 | B4 H2 | A+T | `subsystems/avionics/SPEC.md` `team/F3/claims.json` `team/B4/claims.json` `team/H2/logs/` | 3/4 | `CL-D2-PITOT-BOOM-L` `CL-F3-ASPD-ERR` | +10 % | `UNVERIFIED` |
| `R-ESC-CURRENT` | Motor and ESC current with the pack-current limiter | E1 | F4 F1 H1 | I+A+T | `subsystems/flight-software/K09L.param` `team/E1/claims.json` `team/F4/claims.json` `team/H1/GROUND-TEST-PLAN.md` `team/H1/logs/T-E1-STAND_*.csv` `team/H1/logs/T-H1-RESTRAINED-RUN_*.csv` | 4/6 | `CL-E1-HOVER-I-55` `CL-E1-IMAX-168-55` `CL-E1-IPACK-LIM` `CL-E1-ILIM-I` `CL-F4-BAT-CURR-MAX` `CL-F4-SPIN-MAX` `CL-F4-BAT-CURR-MOTOR` | +0 % | `UNVERIFIED` |
| `R-PACK-MASS` | Flight pack mass and capacity | E2 | A3 | T | `team/E2/claims.json` `team/E2/pack_log.csv` `team/H1/GROUND-TEST-PLAN.md` | 3/3 | `CL-A3-GATE-MARGIN-680` `CL-E2-SKU-MASS-MARGIN` `CL-E2-PACK-MASS` | -66 % | `UNVERIFIED` `FAIL` |
| `R-THERMAL` | Thermal limits | E3 | E1 E2 H1 H2 H3 | A+T | `team/E3/THERMAL.md` `team/E3/claims.json` `team/E3/sim/claims.json` `team/E3/thermal_results.json` `team/H1/GROUND-TEST-PLAN.md` `team/H1/logs/T-E3-MOTOR-TAU_*.csv` `team/H1/logs/T-E3-ESC-PAD_*.csv` `team/H1/logs/T-E3-ESC-PAD-CFD_*.csv` `team/H2/logs/` `team/H3/FLIGHT-CARD.md` | 5/10 | `CL-D3-ESC-WASH` `CL-E1-HOVER-DT` `CL-E2-PACK-T-END` `CL-E3-MOTOR-PEAK` `CL-E3-MOUNT-ASA` `CL-E3-ESC-PEAK` `CL-E3-ESC-ABUSE` `CL-E3-BURST-MAX` `CL-E3-PACK-END` `CL-E3-FC-PEAK` `CL-E3-FC-HOVERONLY` `CL-E3-CEIL-MISSION` `CL-E3-CEIL-HOVERONLY` `CL-E3-SWEEP-DES` `CL-E3-GT04-ESC-RISE` `CL-E3-ASD-MOTOR-PEAK` `CL-E3-ASD-ESC-PEAK` `CL-E3-ASD-PACK-END` `CL-E3-ASD-FC-PEAK` `CL-E3-CEIL-ASD` | +6 % | `UNVERIFIED` |
| `R-LOADS` | Load cases defined | C1 | B1 C5 | A | `team/C1/LOADS.md` `team/C1/claims.json` | 2/2 | `CL-C1-T-CAP` `CL-C1-T-LIMIT` `CL-C1-VD` `CL-C1-N-LIMIT-POS` `CL-C1-N-LIMIT-NEG` `CL-C1-GUST-N-POS` `CL-C1-SPAR-MB-ULT` `CL-C1-SPAR-MX-ULT` `CL-C1-SPAR-MZ-ULT` `CL-C1-WING-TORSION-ULT` `CL-C1-WING-SHEAR-ULT` `CL-C1-FINJOINT-F-ULT` `CL-C1-FINJOINT-M-ULT` `CL-C1-FINJOINT-M-DESIGN` `CL-C1-FINHALF-MB-ULT` `CL-C1-MOUNT-F-ULT` `CL-C1-MOUNT-M-ULT` `CL-C1-MOTOR-F-ULT` `CL-C1-POD-F-ULT` `CL-C1-FOOT-F-ULT` `CL-C1-FINHALF-T-LIM` `CL-C1-FINHALF-T-ULT` `CL-C1-TRANSPORT-N-ALLOW` `CL-C1-TRANSPORT-N-ALLOW-X` `CL-C1-TRANSPORT-N-ALLOW-Y` `CL-C1-TRANSPORT-N-ALLOW-LID` `CL-C1-TRANSPORT-N-ALLOW-AFT` `CL-C1-FINHALF-T-WINGPLANE-LIM` `CL-C1-FINHALF-T-WINGPLANE-ULT` `CL-C1-MOTOR-FSIDE-LIM` `CL-C1-MOTOR-MB-LIM` `CL-C1-MOTOR-MB-ULT` `CL-C1-PILLAR-F-LIM` `CL-C1-CRADLE-F-LIM` `CL-C1-CRADLE-PAD-P-LIM` `CL-C1-FINJOINT-M-FLIGHT-LIM` `CL-C1-DROP-HEIGHT-ALLOW` `CL-C1-CRADLE-STROKE-REQ` `CL-C1-TRANSPORT-N-AFT` `CL-D7-CRADLE-STROKE` `CL-D7-DROP-N` `CL-D7-A1-BOX-DROP-ALLOW` | +0 % | `UNVERIFIED` |
| `R-STRUCT-MARGIN` | Structural margins | C2 | C3 C4 C5 C6 H1 | A+T | `team/C2/claims.json` `team/C3/claims.json` `team/C4/claims.json` `team/C5/claims.json` `team/C6/claims.json` `team/H1/claims.json` | 6/6 | `CL-C2-SPAR-SIGMA-ULT` `CL-C2-SPAR-SIGMA-ENV` `CL-C2-SPAR-TAU-ULT` `CL-C2-SPAR-BUCKLE` `CL-C2-SPAR-SIGMA-BRACE` `CL-C2-TIP-DEFL-FRAC` `CL-C2-V-REVERSAL` `CL-C2-V-DIVERGENCE` `CL-C2-V-FLUTTER` `CL-C2-PLUG-BEARING` `CL-C2-SPAR-BOND-TAU` `CL-C2-CHORD-TAPE` `CL-C2-TIP-FOAM` `CL-C2-ROOT-TAPE` `CL-C2-POD-FOAM` `CL-C2-FEA-SPAR-SIGMA-ULT` `CL-C2-FEA-TIP-DEFL-FRAC` `CL-C2-FEA-FOAM-S1` `CL-C2-FEA-FOAM-TAU` `CL-C2-FEA-PETG` `CL-C2-FEA-FOAM-CORNER-S1` `CL-C2-FEA-FOAM-CORNER-S3` `CL-C3-FEA-BOND-R-DESIGN` `CL-C3-FEA-TIED-R-DESIGN` `CL-C3-BOND-R-DESIGN` `CL-C3-BOND-SIGMA-DESIGN` `CL-C3-OVERHANG-DESIGN` `CL-C3-HANDLE-TIES` `CL-C3-GRIP` `CL-C4-D3-MS-FACE` `CL-C4-D3-MS-EDGE` `CL-C4-D3-MS-TUBE` `CL-C4-D3-MS-BRACE` `CL-C4-D3-MS-BRACE-END` `CL-C4-D3-MS-COLLAR` `CL-C4-D3-MS-ANCHOR` `CL-C4-D3-MS-EAR` `CL-C4-D3-MS-STRIP-PAPER` `CL-C4-D3-MS-CAP-G3` `CL-C4-D3-MS-MOUNT-SLIP` `CL-C4-D3-BLOCK-MS` `CL-C4-D3-MS-FACE-SHOE` `CL-C6-MOTOR-HEAD-RF` `CL-C6-MOTOR-SEP-RF` `CL-C6-MOTOR-STRIP-RF` `CL-C6-MOUNT-SIDE-SLIP-RF` `CL-C6-MOUNT-SIDE-AXIAL-RF` `CL-C6-MOUNT-ROCK-RF` `CL-C6-MOUNT-HOOP-RF` `CL-C6-PWR-INSTALL-RF` `CL-C6-PWR-TENSION-RF` `CL-C6-PWR-SLIP-RF` `CL-C6-PWR-SPACER-RF` `CL-C6-INSERT-PULL-RF` `CL-C6-TUBE-BLOCK-RF` `CL-C6-BLOCK-SPAR-RF` `CL-C6-COLLAR-RF` `CL-C6-COLLAR-RF-13MM` `CL-C6-COLLAR-RF-16MM` `CL-C6-COLLAR-L-REQ` `CL-C6-STRIP-ANCHOR-F` `CL-C6-STRIP-ANCHOR-RF` `CL-C6-STRIP-EMBED-REQ` `CL-C6-STRIP-TAIL-NET-RF` `CL-C6-STRIP-FACE-RF` `CL-C6-STRIP-PIN-RF` `CL-C6-STRIP-PIN-RF-PROP` `CL-C6-STRIP-PIN-RF-ALT` `CL-C6-STRIP-PIN-PITCH-MAX` `CL-C6-STRIP-PIN-BRG-RF` `CL-C6-STRIP-NET-PIN-RF` `CL-C6-BRACE-END-RF` `CL-C6-ANCHOR-PULL-RF` `CL-C6-FOOT-SHOE-RF` `CL-C6-FIN-ROOT-RF` `CL-C6-FIN-ROOT-RF-PROP` `CL-C6-POD-WING-RF` `CL-C6-POD-HATCH-RF` `CL-C6-POD-ALLOW-RATIO` `CL-C6-LINK-BOND-AREA-MIN` `CL-D2-TIE-CAP` `CL-D3-SLIP-HOLD` `CL-D3-STRAP-EYE-RF` `CL-D3-ROOT-FILLET-RF-ALLOW` `CL-D3-BRACE-PCR` `CL-D3-WIRE-HOLE-CLEAR` | -66 % | `UNVERIFIED` `FAIL` |
| `R-FIN-TUBE-JOINT` | Fin-tube-block joint | C4 | D3 C6 G3 | A+I | `subsystems/fins/SPEC.md` `team/C4/claims.json` | 2/2 | `CL-C4-D3-MS-BRACE-END` `CL-C4-D3-MS-COLLAR` `CL-C4-D3-MS-ANCHOR` `CL-C4-D3-COLLAR-H-REQ` `CL-C4-D3-BLOCK-MS` `CL-C6-MOUNT-SIDE-SLIP-RF` `CL-C6-MOUNT-SIDE-AXIAL-RF` `CL-C6-MOUNT-ROCK-RF` `CL-C6-MOUNT-HOOP-RF` `CL-C6-TUBE-BLOCK-RF` `CL-C6-BLOCK-SPAR-RF` `CL-C6-COLLAR-RF` `CL-C6-COLLAR-RF-13MM` `CL-C6-COLLAR-RF-16MM` `CL-C6-COLLAR-L-REQ` `CL-C6-STRIP-ANCHOR-F` `CL-C6-STRIP-ANCHOR-RF` `CL-C6-STRIP-EMBED-REQ` `CL-C6-STRIP-TAIL-NET-RF` `CL-C6-BRACE-END-RF` `CL-C6-ANCHOR-PULL-RF` `CL-C6-FIN-ROOT-RF` `CL-C6-FIN-ROOT-RF-PROP` `CL-D3-COLLAR-H` `CL-D3-COLLAR-H-C6` `CL-D3-TONGUE-FIT` `CL-D3-TAIL-EMBED` | +0 % | `UNVERIFIED` |
| `R-VIBRATION` | Rotor-excited vibration | C4 | C2 B3 F4 E1 H1 H2 | A+T | `team/C4/claims.sim.json` `team/C4/claims.d3.json` `team/C2/claims.json` `team/F4/claims.json` `team/B3/claims.json` `team/H1/GROUND-TEST-PLAN.md` `team/H1/logs/T-C4-TAP-D3_*.csv` `team/H1/logs/T-C2-TAP-TEST_*.csv` `team/H2/logs/` | 6/9 | `CL-C2-WING-MODE-SEP` `CL-C4-D3-SEP` `CL-C4-D3-SEP-WORST` `CL-C4-D3-SEP-WHIRL` `CL-C4-D3-MOUNT-K-REQ` `CL-C4-SIM-SEP` `CL-F3-VIBE-T1P` `CL-F4-XOVER-RLL` `CL-F4-XOVER-PIT` `CL-F4-FILT-SEP` `CL-F4-NOTCH-LOW` `CL-J1-TUBE-MODE-SEP` | -91 % | `UNVERIFIED` `FAIL` |
| `R-PACK-RETENTION` | Pack retained in a crash | C3 | D2 C5 H1 | A+T | `subsystems/pod/SPEC.md` `team/C3/claims.json` `team/H1/GROUND-TEST-PLAN.md` `team/H1/logs/GT-10-PACK-PULL_*.csv` | 3/4 | `CL-C1-CRASH-N` `CL-C1-PACK-CRASH-LOAD` `CL-C3-FEA-BOND-R-CRASH` `CL-C3-FEA-TIED-R-CRASH` `CL-C3-FEA-SADDLE-TIES` `CL-C3-FEA-OVERHANG-CRASH` `CL-C3-FEA-AFT-STOP-PEAK` `CL-C3-FEA-AFT-TRAY-BEND` `CL-C3-FEA-AFT-PEEL` `CL-C3-FEA-AFT-PROP-PEEL` `CL-C3-FEA-AFT-PROP-PEAK` `CL-C3-FEA-FWD-PEEL` `CL-C3-FEA-FWD-BED-PEEL` `CL-C3-STRUT-BEARING` `CL-C3-STRUT-BUCKLE` `CL-C3-STRUT-BRIDGE` `CL-C3-FEA-FWD-TRAY-BEND` `CL-C3-BOND-R-CRASH` `CL-C3-AFT-STOP-D2` `CL-C3-AFT-STOP-BOND` `CL-C3-AFT-STOP-REC` `CL-C3-FWD-STOP-REC` `CL-C3-GUIDE-D2` `CL-C3-GUIDE-REC` `CL-C3-STRAP-LEG` `CL-C3-STRAP-OVERLAP-REQ` `CL-C3-TRAY-FLAT` `CL-C3-FLOOR-GLUE-FILLET` `CL-C3-OVERHANG-CRASH` `CL-C3-FWD-STOP-FUSE` `CL-C3-BLOCK-A-SHARE` `CL-C3-STOP-SECTION-PENALTY` `CL-C5-PACK-NOSE-ROOM` `CL-C5-PACK-ROOM-MARGIN-WORST` `CL-C6-POD-CRASH-RF` `CL-C6-POD-TRAY-RF` `CL-C6-POD-FLOOR-RF` `CL-C6-POD-FLOOR-RF-PROP` `CL-D2-BLOCK-B-550` `CL-D2-BLOCK-B-LIGHT` `CL-D2-BLOCK-B-HEAVY` `CL-D2-BLOCK-B-NOM` `CL-D2-PACK-X-FWD-MIN` `CL-D2-FWD-STOP-BOND` `CL-D2-AFT-STOP-BOND` `CL-D2-STRAP-CAP` | -1004 % | `UNVERIFIED` `FAIL` |
| `R-LANDING-IMPACT` | Fin-tip landing | C5 | D5 C1 C4 F4 H1 | A+T | `team/C5/LANDING.md` `team/C5/SIMULATION-REPORT.md` `team/C5/claims.sim.json` `team/C5/claims.json` `team/C1/claims.json` `subsystems/landing/SPEC.md` `subsystems/flight-software/K09L.param` `team/H1/GROUND-TEST-PLAN.md` `team/H1/logs/T-C5-AIRCRAFT-DROP_*.csv` `team/H1/logs/T-C5-FOOT-RIG_*.csv` | 8/10 | `CL-C1-N-LAND-STROKE-MIN` `CL-C1-WINGTIP-STRIKE-ANGLE` `CL-C1-FOOT-D5-RATIO` `CL-C5-DROP-PAIR-PITCH` `CL-C5-DROP-PAIR-ROLL` `CL-C5-DYN-LEVEL-FREE-PROP` `CL-C5-DYN-N-LEVEL` `CL-C5-SIM3D-STROKE` `CL-C5-SIM3D-N` `CL-C5-SIM3D-BOTTOM-TILT` `CL-C5-FEA-SHOE-SF` `CL-D3-TIP-SQUARE` `CL-D3-TIP-STEP-MISMATCH` `CL-D3-ROOT-FILLET-RF` `CL-D3-ROOT-FILLET-RF-ALLOW` | -78 % | `UNVERIFIED` `FAIL` |
| `R-DISCONNECT` | Connectors carry the current | F1 | E1 E2 H1 | A+T | `team/F1/POWER.md` `team/F1/claims.json` `team/H1/GROUND-TEST-PLAN.md` `team/H1/logs/T-F1-WIRE-HEAT_*.csv` `team/H1/logs/T-F1-CONN-HEAT_*.csv` | 3/5 | `CL-PWR-JUMPER-RISE` `CL-F1-DISC-REQ-CONT` `CL-F1-DISC-REQ-SHORT` `CL-F1-ILIM-WORST` `CL-F1-AS150U-CONT` `CL-F1-AS150U-SHORT` `CL-F1-AS150U-BURST` `CL-F1-MAIN-RISE` `CL-F1-MAIN-PEAK` `CL-F1-ESC-RISE` `CL-F1-ESC-PEAK` `CL-F1-BUNDLE-RISE` `CL-F1-BUNDLE-PEAK` `CL-F1-PACKLEAD-RISE` `CL-F1-PACKLEAD-PEAK` `CL-J1-DISCONNECT-REQ` `CL-J1-DISCONNECT-REQ-PESS` `CL-J1-XT60-CONT` `CL-J1-XT60-CONT-PESS` `CL-J1-XT60-BURST` `CL-J1-AS150U-CONT` `CL-J1-AS150U-BURST` | -50 % | `UNVERIFIED` `FAIL` |
| `R-AVIONICS-POWER` | Avionics power | F1 | F3 H1 | A+T | `subsystems/power/SPEC.md` `team/F1/claims.json` `team/H1/claims.json` | 3/3 | `CL-F1-SERVO-BEC-REQ` `CL-F1-SERVO-STALL-BUS` `CL-F1-UBEC-RATING` `CL-F1-SENSOR-PEAK` `CL-F1-SENSOR-CONT` `CL-F1-PMOD-RISE` `CL-F3-5V-REQ` `CL-F3-SENSE-CONT` | +43 % | `UNVERIFIED` |
| `R-HARNESS-INSTALL` | Wiring is an installation | F2 | A4 | I | `subsystems/harness/SPEC.md` `subsystems/harness/interfaces.json` | 2/2 | `CL-F2-ESC-LEN-MAX` `CL-F2-MAIN-LEN` `CL-F2-CAP-LEAD` `CL-F2-MASS` `CL-F2-BEND` `CL-F2-FREE-SPAN` | +2 % | `UNVERIFIED` |
| `R-FC-STABLE` | Stable autopilot build | F3 | F4 | I+D | `subsystems/avionics/SPEC.md` `team/F3/claims.json` | 2/2 | `CL-F3-FC-STABLE` | — | `PROPOSED` |
| `R-FSW-PARAMS` | Tailsitter parameter file | F4 | E1 H1 | I+D | `subsystems/flight-software/SPEC.md` `subsystems/flight-software/params/` | 1/2 | `CL-F4-MOTOR-MAP-ERR` `CL-F4-BAT-CURR-MAX` | +0 % | `UNVERIFIED` |
| `R-ARM-KILL` | Arming and emergency stop | F4 | H1 H3 | T | `subsystems/flight-software/SPEC.md` `team/F5/claims.json` `team/H1/GROUND-TEST-PLAN.md` `team/H1/logs/GT-12-ARM-KILL_*.csv` | 3/4 | `CL-F5-SWITCH-LATENCY` | +94 % | `UNVERIFIED` |
| `R-FAILSAFES` | Failsafes and geofence | F4 | H1 H3 | T+D | `subsystems/flight-software/SPEC.md` `subsystems/flight-software/SITL-PLAN.md` `team/H1/claims.json` | 3/3 | `CL-E2-BATT-CRT-MAH` `CL-E2-BATT-LOW-MAH` `CL-F4-DESCENT` `CL-F4-BATT-CRT` `CL-F4-BATT-LOW` `CL-F4-FENCE-ALT` `CL-F4-FENCE-RADIUS` `CL-F5-FS-TIME` | +0 % | `UNVERIFIED` |
| `R-RC-LINK` | RC link and telemetry | F5 | H2 | T | `team/F5/RC-LINK.md` `team/F5/claims.json` `team/H1/GROUND-TEST-PLAN.md` `team/H1/logs/T-F5-RANGE_*.csv` `team/H2/logs/` | 3/5 | `CL-D2-ANT-A-CLR` `CL-D2-ANT-B-CLR` `CL-F5-LINK-DIST` `CL-F5-LINK-MARGIN` `CL-F5-RC-RSSI-REQ` | +13 % | `UNVERIFIED` |
| `R-COMPASS` | Compass and GPS | F3 | F2 H1 | T+I | `subsystems/avionics/SPEC.md` `team/F3/claims.json` `team/H1/GROUND-TEST-PLAN.md` `team/H1/logs/T-F3-COMPASSMOT_*.csv` | 3/4 | `CL-D2-GPS-CLR` `CL-F3-COMPASS-RATIO` `CL-F3-GPS-CLEAR` | +52 % | `UNVERIFIED` |
| `R-TRANSPORT` | One-piece transport | D7 | C1 A1 | A+D | `team/A1/claims.json` `team/D7/claims.json` `subsystems/transport/SPEC.md` `subsystems/transport/CAR-FIT.md` | 4/4 | `CL-A1-BOX-FIT` `CL-A4-FIELD-DISCONNECTS` `CL-C5-BOX-X-SLACK-NOSE` `CL-D5-BOX-SLACK` `CL-D7-CRADLE-STROKE` `CL-D7-DROP-N` `CL-D7-BOX-H-REQ` `CL-D7-TUBE-CLEAR-DROP` `CL-D7-SIDE-CLEAR` `CL-D7-TIP-PAD-GAP` `CL-D7-A1-BOX-DROP-ALLOW` `CL-D7-CRADLE-PAD-AREA` `CL-D7-BRACE-GAP` `CL-D7-HANDLE-ENGAGE` `CL-D7-LOADED-MASS` | +0 % | `UNVERIFIED` |
| `R-FIELD-SETUP` | Field set-up time | D7 | G4 E1 | D | `subsystems/transport/CHECKLIST.md` `subsystems/transport/SPEC.md` `team/D7/claims.json` | 3/3 | `CL-D7-SETUP-MIN` | +5 % | `UNVERIFIED` |
| `R-CAR-FIT` | Box fits two cars | D7 | A1 | D | `subsystems/transport/CAR-FIT.md` `subsystems/transport/SPEC.md` | 2/2 | — | — | `UNVERIFIED` (no claim) |
| `R-PROCESS` | Build processes | G1 | G2 G3 | I | `team/G1/PROCESS-PLAN.md` | 0/1 | — | — | `UNVERIFIED` (no claim) |
| `R-BUILD-HOURS` | Build hours | I2 | G4 | A+D | `team/I2/SCHEDULE.md` `team/G4/claims.json` | 0/2 | — | — | `UNVERIFIED` (no claim) |
| `R-SCHEDULE` | Milestones | I2 | I1 H3 | I | `team/I2/SCHEDULE.md` | 0/1 | — | — | `UNVERIFIED` (no claim) |
| `R-CRASH-REPAIR` | Crash repair | G1 | I1 G2 | I+D | `team/G1/PROCESS-PLAN.md` `team/I1/BOM.csv` | 1/2 | `CL-D3-SLIP-FUSE` | +25 % | `UNVERIFIED` |
| `R-BUDGET` | Budget $2 000 | I1 | A1 | A | `team/I1/BOM.csv` `team/I1/claims.json` `team/I1/bom_summary.json` `team/I1/ORDER-PLAN.md` | 4/4 | `CL-A1-RESERVE` `CL-I1-SPEND-BASE` `CL-I1-SPEND-PESS` `CL-I1-RESERVE-PESS` | +1 % | `UNVERIFIED` |
| `R-RESERVE` | Crash reserve | I1 | A1 | A | `team/I1/BOM.csv` `team/I1/claims.json` `team/I1/bom_summary.json` | 3/3 | `CL-A1-RESERVE` `CL-I1-RESERVE-PESS` `CL-I1-RESERVE-BASE` | +1 % | `UNVERIFIED` |
| `R-NO-FLOATING` | Every part connected | A4 | A5 | A | `interfaces/REPORT.md` `fusion/check.py` | 2/2 | — | — | `UNVERIFIED` (no claim) |
| `R-JOINT-STACK` | Joint stacks | C6 | A4 G4 | I | `team/C6/JOINTS.md` `team/C6/joint_stacks.json` `team/C6/claims.json` `interfaces/interfaces.json` | 4/4 | `CL-C6-CANT-ENGAGE` `CL-C6-PINCH-ENGAGE-RF` `CL-C6-PINCH-TORQUE` `CL-C6-PWR-ENGAGE-RF` `CL-C6-PWR-BORE-RF` `CL-C6-PWR-INSERT-LEN-RF` `CL-C6-SNAP-L-MIN` `CL-D2-MAST-BOLT-PAST` `CL-D3-SCREW-ENGAGE` | +4 % | `UNVERIFIED` |
| `R-PROOF-BUILD` | Proof chain builds | J2 | A2 | A | `proofs/out/CHAIN.md` `team/A2/VERIFICATION-MATRIX.md` | 2/2 | — | — | `UNVERIFIED` (no claim) |
| `R-LEGAL` | FAA and university compliance | H3 | A1 | I | `team/H3/COMPLIANCE.md` | 0/1 | — | — | `UNVERIFIED` (no claim) |
| `R-SITE` | Site rules and flight card | H3 | H2 | I+D | `team/H3/FLIGHT-CARD.md` `team/H3/COMPLIANCE.md` | 0/2 | — | — | `UNVERIFIED` (no claim) |
| `R-BATT-HANDLING` | Battery handling | H3 | E2 | I | `team/H3/BATTERY-PROCEDURE.md` `team/E2/claims.json` | 1/2 | `CL-D2-BAY-L` `CL-D2-BAY-W` `CL-D2-BAY-H` | +0 % | `UNVERIFIED` |
| `R-PILOT` | Pilot readiness | H2 | F4 | I | `team/H2/PILOT-LOG.md` `subsystems/flight-software/SITL-PLAN.md` | 1/2 | — | — | `UNVERIFIED` (no claim) |
| `R-TWIN` | Foam-board twin gate | H2 | F4 B3 E1 | D | `team/H2/TWIN-REPORT.md` `team/H2/logs/` | 0/2 | — | — | `UNVERIFIED` (no claim) |
| `R-TEST-ORDER` | Test gates in order | H2 | H1 H3 | D | `team/H2/FLIGHT-TEST-PLAN.md` `team/H2/logs/` | 0/2 | — | — | `UNVERIFIED` (no claim) |
| `R-WIND-MEASURE` | RFS wind measured | H3 | B1 | T | `team/H3/WIND-RFS.md` | 0/1 | — | — | `UNVERIFIED` (no claim) |

## By owner

| Owner | Requirements | Open (no claim yet) |
|---|---|---|
| A1 | `R-CONFIG` | — |
| A3 | `R-MASS-GATE` `R-MASS-ALLOC` `R-CG-RANGE` `R-HOVER-SPLIT` | — |
| A4 | `R-NO-FLOATING` | `R-NO-FLOATING` |
| A5 | `R-ENVELOPE` | `R-ENVELOPE` |
| B1 | `R-MISSION` `R-TRANSITION` `R-WIND` `R-GUST-LEAN` | `R-GUST-LEAN` |
| B2 | `R-STALL` | — |
| B3 | `R-STATIC-MARGIN` `R-DIRECTIONAL` `R-SPIRAL` `R-HOVER-AUTHORITY` `R-CRUISE-AUTHORITY` `R-ELEVON-AREA` | `R-SPIRAL` |
| C1 | `R-LOADS` | — |
| C2 | `R-STRUCT-MARGIN` | — |
| C3 | `R-PACK-RETENTION` | — |
| C4 | `R-FIN-TUBE-JOINT` `R-VIBRATION` | — |
| C5 | `R-TIPOVER` `R-LANDING-IMPACT` | — |
| C6 | `R-JOINT-STACK` | — |
| D3 | `R-PROP-CLEAR` | — |
| D6 | `R-SERVO-TORQUE` | — |
| D7 | `R-TRANSPORT` `R-FIELD-SETUP` `R-CAR-FIT` | `R-CAR-FIT` |
| E1 | `R-HOVER-TW` `R-ESC-CURRENT` | — |
| E2 | `R-PACK-MASS` | — |
| E3 | `R-THERMAL` | — |
| F1 | `R-DISCONNECT` `R-AVIONICS-POWER` | — |
| F2 | `R-HARNESS-INSTALL` | — |
| F3 | `R-AIRSPEED` `R-FC-STABLE` `R-COMPASS` | — |
| F4 | `R-FSW-PARAMS` `R-ARM-KILL` `R-FAILSAFES` | — |
| F5 | `R-RC-LINK` | — |
| G1 | `R-PROCESS` `R-CRASH-REPAIR` | `R-PROCESS` |
| H2 | `R-PILOT` `R-TWIN` `R-TEST-ORDER` | `R-PILOT` `R-TWIN` `R-TEST-ORDER` |
| H3 | `R-LEGAL` `R-SITE` `R-BATT-HANDLING` `R-WIND-MEASURE` | `R-LEGAL` `R-SITE` `R-WIND-MEASURE` |
| I1 | `R-BUDGET` `R-RESERVE` | — |
| I2 | `R-BUILD-HOURS` `R-SCHEDULE` | `R-BUILD-HOURS` `R-SCHEDULE` |
| J2 | `R-PROOF-BUILD` | `R-PROOF-BUILD` |

## Retired limit ids still cited

These scripts cite an `ASM-A2-…` id that was retired by D-14. A2 emits a thin alias (value copied from `params.json`) so they build; each owner points at the `P:requirements.<key>` instead, then the alias goes.

| Retired id | Point at | Files |
|---|---|---|
| `ASM-A2-SERVO-TORQUE-FACTOR` | `P:requirements.servo_torque_factor` | `redesign/team/B2/claims.json` `redesign/team/B2/wing_claims.py` |

## How to verify this matrix

1. `python -I redesign/proofs/build_graph.py` must print `OK` (the statuses above come from its `graph.json`).
2. `python -I redesign/team/A2/build_requirements.py` must exit 0: every P1–P25 line maps to a requirement, every `R-…` id in the graph has a row, no id is defined twice, every `{P:key}` and source key exists in `params.json`, no row names a retired limit.
3. Before CDR every row has ≥ 1 claim; before first flight `build_graph.py --strict` passes (`R-PROOF-BUILD`).
