davinciucberkeley-collab/DBF-Combined/tools/opencae-studio/docs/validation/validation_report.html

# OpenCAE Studio - engineering validation

{"solver": "CalculiX 2.21", "quick": false, "date": "2026-10-28 21:00", "su2": "found", "runtime_s": 966.9}

## Summary

Benchmark | Criterion | Result
A - Axially loaded bar | |error| < 0.01 % for u = FL/(AE) and sigma = F/A on every mesh | PASS
B - Cantilever beam (tip load) | finest C3D10 tip deflection within 2 % of Euler-Bernoulli and Timoshenko; global equilibrium residual < 1e-5 on every mesh | PASS
C - Mesh refinement / convergence | monotone convergence of C3D10 tip deflection; mid-span bending stress within 2 % of M*c/I on the finest mesh | PASS
D - Boundary condition validation | every insufficiently constrained case is detected before solving; the properly constrained control case is accepted | PASS
E - Units and serialization | identical physics in mm-N-s and m-N-s (rel. diff < 1e-4, limited by 6-digit output); reopened project has equal inputs, geometry, mesh, stored results and reproduces the solution | PASS
X - Extended physics (thermal, dynamics, stability, flow) | every quantity within its stated tolerance of the closed-form / reference value | PASS

## A - Axially loaded bar

Steel bar 100.0 x 10.0 x 10.0 mm, F = 5000.0 N along +X on the end face; symmetry constraints on x = 0, y = 0, z = 0 faces (uniaxial stress, free lateral contraction).

Theory: u = FL/(AE) = 2.500000e-02 mm, sigma = F/A = 50.0000 MPa.

Element | h max [mm] | Nodes | u tip [mm] | u error [%] | max nodal sigma dev [%] | max IP sigma dev [%]
C3D4 | 10 | 87 | 2.500000e-02 | +0.00000 | 0.00000 | 0.00000
C3D4 | 5 | 190 | 2.500000e-02 | +0.00000 | 0.00000 | 0.00000
C3D4 | 2.5 | 1073 | 2.500000e-02 | +0.00000 | 0.00000 | 0.00000
C3D10 | 10 | 458 | 2.500000e-02 | +0.00000 | 0.00100 | 0.00000
C3D10 | 5 | 998 | 2.500000e-02 | +0.00000 | 0.00100 | 0.00000
C3D10 | 2.5 | 6602 | 2.500000e-02 | +0.00000 | 0.00100 | 0.00000

- The exact solution is a linear displacement field, which both C3D4 and C3D10 represent exactly; agreement to output precision verifies the whole pipeline (geometry, load mapping, units, deck, result parsing) rather than discretisation accuracy.
- .frd values carry 6 significant digits, limiting the attainable agreement to ~1e-5.

## B - Cantilever beam (tip load)

Steel cantilever L = 200.0 mm, 20.0 x 20.0 mm section, root face fully fixed, F = 1000.0 N (-Z) as uniform traction on the tip face. Tip deflection = mean -Uz of tip-face nodes.

Euler-Bernoulli FL³/(3EI) = 1.000000 mm; Timoshenko (Cowper k) = 1.007650 mm.

Element | h max | Nodes | Elements | tip defl. [mm] | vs EB [%] | vs Timoshenko [%] | mid-span |sxx| [MPa] | vs Mc/I [%] | peak VM nodal | peak VM IP | equilibrium resid. | solve [s]
C3D10 | 10 | 998 | 433 | 0.998226 | -0.177 | -0.935 | 75.016 | +0.02 | 150.3 | 136.3 | 1.2e-12 | 0.08
C3D10 | 8 | 2011 | 944 | 0.999033 | -0.097 | -0.855 | 75.019 | +0.03 | 151.4 | 137.3 | 3.3e-12 | 0.19
C3D10 | 6 | 4437 | 2364 | 0.999770 | -0.023 | -0.782 | 74.997 | -0.00 | 150.7 | 146.0 | 3.9e-12 | 0.52
C3D10 | 5 | 6630 | 3594 | 0.999822 | -0.018 | -0.777 | 74.929 | -0.09 | 150.6 | 149.2 | 7.0e-12 | 0.83
C3D10 | 4 | 11370 | 6585 | 1.000133 | +0.013 | -0.746 | 75.022 | +0.03 | 154.2 | 157.2 | 4.1e-12 | 1.84
C3D10 | 3 | 24247 | 14755 | 1.000445 | +0.044 | -0.715 | 74.961 | -0.05 | 171.4 | 169.8 | 3.7e-12 | 5.29
C3D10 | 2.5 | 39598 | 24960 | 1.000534 | +0.053 | -0.706 | 75.047 | +0.06 | 180.7 | 177.9 | 5.0e-12 | 11.40
C3D4 | 10 | 190 | 433 | 0.475560 | -52.444 | -52.805 | 22.423 | -70.10 | 84.5 | 120.5 | 9.5e-13 | 0.03
C3D4 | 8 | 363 | 944 | 0.682559 | -31.744 | -32.262 | 42.469 | -43.37 | 91.3 | 114.0 | 8.1e-13 | 0.03
C3D4 | 6 | 731 | 2364 | 0.795696 | -20.430 | -21.034 | 50.433 | -32.76 | 104.5 | 128.3 | 2.0e-12 | 0.07
C3D4 | 5 | 1079 | 3594 | 0.838190 | -16.181 | -16.817 | 55.025 | -26.63 | 113.3 | 141.9 | 2.8e-12 | 0.16
C3D4 | 4 | 1753 | 6585 | 0.882113 | -11.789 | -12.458 | 59.525 | -20.63 | 123.9 | 143.9 | 2.3e-12 | 0.19
C3D4 | 3 | 3607 | 14755 | 0.933430 | -6.657 | -7.366 | 65.474 | -12.70 | 131.1 | 149.7 | 2.8e-12 | 0.43
C3D4 | 2.5 | 5717 | 24960 | 0.952277 | -4.772 | -5.495 | 66.537 | -11.28 | 135.7 | 149.3 | 1.6e-12 | 0.71

- Euler-Bernoulli: plane sections remain plane and normal to the axis; shear deformation neglected.
- Timoshenko: adds shear deformation with Cowper's shear coefficient k = 10(1+nu)/(12+11nu).
- Small displacements, linear-elastic isotropic material.
- Beam theory assumes the load acts at the section centroid and ignores how the end is clamped; the 3-D model fixes all displacements on the root face (which also suppresses Poisson contraction, slightly stiffening the root) and applies the load as a uniform traction on the tip face.
- Beam theory gives the bending stress M*c/I away from the ends. The 3-D model has stress singularities at the corners of the fully clamped root face, so peak FE stress there grows with mesh refinement and must not be compared directly; compare stresses a section depth away from the root.
- Slenderness L/h = 10: shear deformation adds ~0.8 % (Timoshenko). The fully clamped root (Poisson contraction suppressed) stiffens the 3-D model slightly, so the converged solid result lies close to Euler-Bernoulli and just below Timoshenko.
- Linear tetrahedra (C3D4) are known to be overly stiff in bending (shear locking) and converge slowly; they are included to show this behaviour, not as a recommendation.

## C - Mesh refinement / convergence

Element | Observed order p | Richardson tip defl. [mm] | GCI fine [%] | Monotone
C3D10 | 3.64 | 1.000633 | 0.012 | True
C3D4 | 2.53 | 0.986033 | 4.431 | True

- Richardson extrapolation and the grid convergence index (GCI, Roache) use the three finest meshes of each element type with h = (V / n_elements)^(1/3).
- The peak von Mises stress sits at the corners of the fully clamped root face, a stress singularity: it keeps rising with refinement (see table) and is not a convergent quantity. Mid-span bending stress, away from the root and load introduction, converges.
- A Richardson estimate is only meaningful in the asymptotic range. C3D4 results are still dominated by shear locking at these densities, so its extrapolated value and GCI are indicative only; the C3D10 sequence is the reference for the converged solution.

convergence_cantilever

peak_stress_singularity

## D - Boundary condition validation

Case | Pre-check | Messages | CalculiX if bypassed
no constraints | detected | model has no constraints: the stiffness matrix is singular (rigid-body motion). | -
ux = 0 only on root face | detected | model is insufficiently constrained (rigid-body restraint rank 3/6). Unrestrained motion(s): translation Z, translation Y, rotation about X. | ran, max |u| = 5.296e+10 mm
single fixed vertex | detected | model is insufficiently constrained (rigid-body restraint rank 3/6). Unrestrained motion(s): rotation about X, rotation about Y, rotation about Z. | ran, max |u| = 8.198e+10 mm
fully fixed root face (control) | accepted | | ran, max |u| = 1.002e+00 mm

- The pre-check computes the rank of the six rigid-body modes evaluated at all constrained DOFs; rank < 6 means a rigid-body motion is unrestrained, and the free modes are named.
- With the pre-check bypassed, the table records what CalculiX itself does with the singular system. Depending on the case, SPOOLES may still return a 'solution' with enormous or arbitrary displacements, which is why the application blocks such models instead of relying on solver diagnostics.

## E - Units and serialization

{
  "units": {
    "max_rel_diff_displacement": 1.0001670280178445e-06,
    "max_rel_diff_von_mises": 6.637201823557087e-06,
    "mm_tip_uz": 0.999833,
    "m_tip_uz": 0.000999833
  },
  "serialization": {
    "inputs_equal": true,
    "geometry_equal": true,
    "mesh_equal": true,
    "stored_results_equal": true,
    "resolve_max_abs_diff": 0.0,
    "results_current_after_reopen": true
  }
}
- The unit comparison solves the same mesh (scaled) in both systems to isolate unit handling from mesher differences.

## X - Extended physics (thermal, dynamics, stability, flow)

Benchmark | Quantity | FE / FV | Reference | Error [%] | Tolerance [%] | Pass | Reference / note
T1 slab, flux + fixed T | T(L) [°C] | 40 | 40 | +0.000 | 0.01 | True | T = T0 + q x / k
T1 slab, flux + fixed T | heat through fixed face [W] | 1 | 1 | +0.000 | 0.01 | True | energy balance
T2 slab, convection | T(0) [°C] | 120 | 120 | +0.000 | 0.01 | True | q = h (T0 - T_inf)
T3 slab, radiation | T(0) [°C] | 417.73 | 417.73 | +0.000 | 0.01 | True | q = eps sigma (T0^4 - T_inf^4)
T4 heat generation | T max [°C] | 25 | 25 | -0.000 | 0.1 | True | T_max = q L^2 / (8 k)
T5 transient conduction, dt = 10 s | T(L, t = 520 s) [°C] | 96.9791 | 97.6249 | -0.661 | 1.5 | True | Fourier series; backward Euler error ~ dt
T5 transient conduction, dt = 5 s | T(L, t = 520 s) [°C] | 97.3005 | 97.6249 | -0.332 | 1.5 | True | Fourier series; backward Euler error ~ dt
M1 cantilever modes | f1 bending [Hz] | 406.618 | 407.69 | -0.263 | 1 | True | Euler-Bernoulli
M1 cantilever modes | torsion [Hz] | 3608.14 | 3593.95 | +0.395 | 1 | True | square section, J = 0.1406 a^4
M1 cantilever modes | axial [Hz] | 6328.98 | 6309.43 | +0.310 | 1 | True | quarter-wave rod
B1 Euler column (fixed-free) | P_cr [N] | 10289.5 | 10280.8 | +0.084 | 1 | True | pi^2 E I / (4 L^2)
S1 end moment | tip deflection [mm] | 0.746093 | 0.75 | -0.521 | 2 | True | M L^2 / (2 E I)
S2 large deflection (NLGEOM) | vertical tip deflection / L | 0.301436 | 0.3017 | -0.088 | 1 | True | elastica, P L^2 / EI = 1 (Bisshopp & Drucker)
S2 large deflection (NLGEOM) | horizontal shortening / L | 0.0563552 | 0.0566 | -0.432 | 3 | True | elastica
S3 restrained thermal expansion | sigma_xx [MPa] | -239.998 | -240 | -0.001 | 0.1 | True | -E alpha dT
F1 2-D channel, 8 quads across | dp/dx [Pa/m] | -1.06666 | -1.04993 | +1.593 | 2 | True | plane Poiseuille, Re = 100
F1 2-D channel, 16 quads across | dp/dx [Pa/m] | -1.12938 | -1.12491 | +0.398 | 1 | True | plane Poiseuille, Re = 100
F1 2-D channel, 32 quads across | dp/dx [Pa/m] | -1.1636 | -1.16239 | +0.104 | 1 | True | plane Poiseuille, Re = 100
F2 square duct, 10 hexes across | dp/dz [Pa/m] | -1.18974 | -1.15124 | +3.344 | 4 | True | f Re = 56.91 (Shah & London)
F2 square duct, 20 hexes across | dp/dz [Pa/m] | -1.29396 | -1.28274 | +0.875 | 4 | True | f Re = 56.91 (Shah & London)
F3 circular pipe (tets, D/h = 20) | dp/dz [Pa/m] | -1.50398 | -1.46133 | +2.919 | 4 | True | Hagen-Poiseuille, Re = 50; 444721 cells, 520 s
F3 circular pipe (tets, D/h = 20) | centre-line velocity [m/s] | 0.00915555 | 0.00902727 | +1.421 | 3 | True | u_max = 2 U_mean
F4 sphere drag, Re = 20 | Cd | 2.6359 | 2.60955 | +1.010 | 8 | True | Schiller-Naumann correlation (±5 % vs experiments); side walls at 4 D
