davinciucberkeley-collab/DBF-Combined/redesign/params/CHANGE-LOG.md

# params.json change log — K09-L

Owner A1 (chief engineer). One row per decision; `params.json#meta.revision` names the current revision. A decision
changes `params.json` only here; the owning role then re-runs its script so `build_graph.py` shows no drift.
Every change request written so far is dispositioned in the second table (accept / reject / forward with one reason).

| Revision | Date | What | Re-check |
|---|---|---|---|
| A1-R0 | 2026-11-09 | design frame from the config study (chord 0.30, MH 45, tubes at x −0.10, CG 0.060) | — |
| A1-R1 | 2026-11-09 | after the first analysis round: D-01 … D-15 | `python -I redesign/team/A1/frame_claims.py` |
| A1-R2 | 2026-11-09 | change-request round: D-16 … D-23 | same, then `python -I redesign/proofs/build_graph.py` |
| A1-R3 | 2026-11-09 | detail-analysis round (C2–C6, D2, D3, D5, D7, E3, F1, F3, F4, F5, H1, I1 and the B/E re-runs): D-24 … D-46 | same; A3 re-runs `mass_rollup.py`, B3/B4/B1/E2/E1/C1 re-run on the R3 keys |
| **A1-R4** | 2026-11-09 | integration round (A3-R5 roll-up, A4-R4 and A5 integration checks, every designer's parts.csv and interfaces.json): D-47 … D-58 | same; D2 re-lays the bay first, then A3, B3, B1, E2, C1, C5, F4, H1 re-run on the R4 keys |
| A1-R4a | 2026-11-09 | addendum: D-59 (pack aft travel 12 mm, per-pack flight stations, nose-ballast cap; two new keys, no existing value changed) | `frame_claims.py`; D2 moves the aft stop, A3 reads the keys (CR-A1-53, -54) |
| A1-R4b | 2026-11-10 | addendum: D-60 (CG range [0.0509, 0.0548] on B3's R4 limits; the 0.0529 target was accepted but never written, superseded by D-62) | `frame_claims.py` |
| **A1-R5** | 2026-11-10 | simulation round (B1–B4 CFD/VLM, C2–C5 FEA and 6-DOF, E3 CFD, plus the integration-fix deliveries of A3-R6a, A5, C1-R4, C6-R4, D1, D3-R4, D5-R5, D6-R2, D7-R4, E1 rev 7, E2-R4, F1-R4, F2, F3, F4, F5): D-61 … D-73 | `frame_claims.py` (24 claims); D2 re-lays the bay and D3 the mount first, then A3, B3, B4, B1, E1, E2, C1, C3, C4, C5, D5, D7, F4, H1 re-run on the R5 keys |

## Decisions

| Id | Decision | From | Keys changed | Why (numbers) |
|---|---|---|---|---|
| D-01 | Chord 0.30 → **0.32 m**; cruise 15 → **16 m/s** | CR-B2-01, CR-B1-01, CR-A1-05, CR-A2-07 | `wing.chord_m`, `wing.te_x_m`, `performance.cruise_ms` | trimmed CLmax 0.80 gives Vs 11.86 m/s and 1.3 Vs 15.42 m/s at 2.6 kg (+1 % / +4 %); CLmax ≥ 0.92 is not reachable trimmed; +40 g from the reserve |
| D-02 | Airfoil MH 45 → **S5010** | CR-B2-02 | `wing.airfoil`, `wing.t_c` 0.0982, `performance.clmax` 0.80 (`CL-B2-CLMAX-DESIGN`) | trimmed CLmax +4 %, softer stall, same t/c and process; `ASM-A1-CLMAX` 0.9 superseded |
| D-03 | Spar centre z 0 → **+0.0066 m** (camber line at x 0.080) | CR-B2-03, CR-A5-01 | `wing.spar.z_m` | at z 0 the 22 mm tube breaks the lower skin by 2.9 mm; centred it has 3.7 mm foam each side |
| D-04 | **Motor tubes through the wing core at x = +0.045 m** (B3 option O4b); fin LE on the tube, fin chord 0.275, two half-fins per side, printed through-core block joins tube, spar and core | CR-B3-02, CR-A4-03, CR-A5-03, P25 | `fins.le_x_m`, `fins.chord_m`, `fins.pieces_per_fin`, `fins.tube.x_m`, `fins.saddle`, `propulsion.stations.x_mount_m` 0.045, `x_prop_plane_m` −0.005 | cruise Cn_β −0.105 → +0.044 /rad; tube-to-spar offset 0.18 → 0.035 m; prop-to-tube gap stays 39 mm |
| D-05 | Prop 11×4.5MR → **APC 11×5.5MR/MRP**; 4 × 11×4.5MR kept for the stand A/B | CR-E1-01, CR-B4-01, CR-B4-02, CR-E1-12 | `propulsion.prop`, `prop_mass_kg` 0.017, `thrust_max_per_motor_kg` 1.62 (limiter, fresh pack), `current_max_per_motor_a` 24.8, `thrust_table_g_w` note | −17 % cruise power for +3 % hover power, same price and diameter |
| D-06 | Voltage-sag thrust factor 0.93 → **0.72** (worst state: 20 % charge, 10 °C) | CR-E2-01c | `propulsion.voltage_sag` | T/W with sag at the gate 1.79 ≥ 1.6; E1's warm case 0.86 is the other bound; one worst-state claim to come (E1 + E2) |
| D-07 | **Allocations 2 200 g, A1 reserve 400 g** (wing 405, fins 370, pod 105, landing 40, propulsion 440, power 595, avionics 75, harness 105, mechanisms 65) | CR-A3-01, CR-B2-05, CR-E1-13, CR-A1-04 | `mass.allocation_g.*`, `mass.growth_reserve_g`, `requirements.mtow_sized_kg` 2.55 | A3 bottom-up plus D-01/D-04/D-11 geometry and the 15 g servos; predicted 2 495 g leaves 105 g under the gate |
| D-08 | Pod LE −0.02 → **−0.105 m** (pod spans −0.105 … 0.095) | CR-B3-02/03, CR-A3-02, CR-A5-03 | `pod.x_le_m`, `avionics.pitot_tip_xyz_m` −0.185 | with the motors at 0.045 the pod group moves forward, not aft, to hold the CG near 0.044 |
| D-09 | **3° tangential motor cant** | CR-B3-05, CR-B4-04 | `propulsion.stations.cant_deg` | hover yaw authority / 5 m/s disturbance 1.08 → 3.75; costs 0.14 % of thrust |
| D-10 | **CG range 0.040–0.049 m, target 0.044**; static margin ≥ 5 % kept | CR-B3-01, CR-A1-06 | `cg.x_range_m`, `cg.x_target_m`, `mass_budget.json#cg_x_m` | NP with props 0.0641 m at the R0 geometry; the old aft end 0.075 would be SM −3.6 %. B3 re-derives at R1 (D-17) |
| D-11 | **Feet 45 mm** beyond the TE, crush stroke ≥ 40 mm at η 0.5 (or ≥ 25 mm at η ≥ 0.8); landing allocation 24 → 40 g | CR-C1-01, CR-A4-02, CR-J1-08 | `cg.foot_height_m`, `requirements.foot_crush_stroke_min_m`, `landing_n_design` 6, `mass.allocation_g.landing` | with 10 mm feet a 2.2° roll error lands on the wingtip and n = 23 at 1.5 m/s |
| D-12 | **Two flight packs.** No 4S 4000 fallback; packs 3–4 ($87.37) only if the pessimistic reserve after the December order stays ≥ $309 + $87; test days at 2 sorties until then | CR-E2-01e, CR-E2-05 | `battery.pack` note | 4000 mAh gives 2.3 min pessimistic cruise (< 5); packs 3–4 now would take the reserve to $234 (< one $309 crash) |
| D-13 | **Performance block at the 2.6 kg gate**, conservative value carried where B1/E1/E2 disagree | CR-B1-02, CR-E1-02, CR-E2-01d | `performance.*` (hover 400 W / 27 A, cruise 307 W / 20.7 A, 12.3 min, 6.4 min pessimistic, lean 15 / 34°) | one basis for F1, F4, E2; B1 re-runs with the 11×5.5MR at 16 m/s |
| D-14 | **Limits adopted from A2 (39) and C1 (5)** as `requirements.*` keys | CR-A2-01, CR-C1-06 | `requirements.load_factor_limit_*`, `vd_ms`, `thrust_limit_per_motor_n`, `landing_*`, `box_drop_m`, `crash_decel_g`, `vibration_sep_frac`, … | one source per limit; A2 retires the `ASM-A2-*` duplicates |
| D-15 | Small adoptions: fin height **0.38 m** confirmed; `fins.board_t_m` 0.0048; `battery.size_m` [0.140, 0.048, 0.050] and pod height 0.07; `propulsion.rpm_max` 9 350; pitot on the pod nose; download 1.06 kept; `SRC-X3108S`, `SRC-APC-11X45MR`, `SRC-APC-11X55MR`, `SRC-S5010` checked; `SRC-LANRC-45A`, `SRC-OVONIC-4S6500` stay unchecked | CR-A2-02, CR-A5-05, CR-E2-01a/b, CR-E2-02, CR-B4-02, CR-B4-05, CR-A4-07, CR-E1-03 | as listed | numbers their owners produced; the pack is weighed before its source is marked checked |
| **D-16** | **Transport box 0.45 → 0.50 m high** (external 1.25 × 0.55 × 0.50) | `CL-A1-BOX-FIT` −25 mm, CR-A4-02 | `requirements.box_external_m` | the tube ends (±0.21 m) set a 0.425 m envelope; with 25 mm walls a 0.45 box is 25 mm short, a 0.50 box has 25 mm slack. D7 measures two cars before freezing; fallback 0.48 m with 12 mm lining |
| **D-17** | **Hold the pod at −0.105 m; no further layout move until B3 re-derives the CG range at R1 geometry** (c 0.32, S5010, tube at 0.045, 3° cant). Until then A3 carries the pack 29 mm forward of the pod centre (CG 0.044 on the R0 range). If the re-derived aft limit is < 0.051 m, A1 moves the pod to −0.125 | CR-A3-02, CR-B3-03, CR-A5-03, `CL-A3-CG-X-RANGE` | `cg._note`, `pod.x_le_m` note | A3 roll-up (basic, pack centred) 0.051 m is 2 mm aft of a range derived at the old NP; tubes and props at 0.045 and the longer chord both move the NP aft, so moving geometry twice would be waste |
| **D-18** | **Hover pitch-trim split limit 1.25** (`requirements.hover_split_max`) | CR-B3-10, CR-A3-04 | new key | B3: the 1.19 split uses 9.7 % of the pitch differential against 12.5 % allowed; no tube offset or pack recess |
| **D-19** | **Static margin stays 0.05**; CR-J1-02's 0.03 rejected | CR-J1-02, CR-B3-01 | — | B2's trimmed CLmax 0.80 already pays the elevon up-trim at SM 5 %; B3 keeps 5 % as the aft limit |
| **D-20** | **Joint ownership rules:** elevon hinge is owned by `wing` (D6 designs); ESC power leads by `harness` only (`power` owns the boxes); electrical `part_a` = supply side | CR-A4-01 | README joint table | an owner must hold one side of its edge; no edge under two owners |
| **D-21** | **CR-B3-07 superseded:** cruise stays 16 m/s; `ARSPD_FBW_MIN` comes from B3's trimmed stall at R1 geometry, not the 16.6 m/s derived at c 0.30 / MH 45 | CR-B3-07 | — | at c 0.32 and S5010 (trimmed CLmax 0.80) 1.3 Vs = 15.42 m/s; B3's 12.73 m/s stall was the R0 wing |
| **D-22** | **Box drop 0.3 m stays**; D7 puts ≥ 70 mm crush foam under the spar cradles (or a cradle under the pod with ≥ 55 mm); 1.5 m/s sink stays | CR-C1-05, CR-C1-10 | `requirements.box_drop_m` note | the cradle sits inside the 0.21 m the lower tubes need anyway, so the foam costs no box height; a 0.087 m label limit is not credible for students |
| **D-23** | **Mounts are the fuse:** printed motor mounts and props fail before the tube and the through-core block in a tip-over; carry point on the pod/spar with a "do not lift by the motors" label, and C4 still sizes the fin joint to case G2 (10.7 N·m) | CR-C1-03, CR-C1-04 | `fins.saddle` note (unchanged) | 3.5 J tip-over cannot be bumpered; students will lift by the tubes anyway |

### Revision A1-R3 (detail-analysis round)

| Id | Decision | From | Keys changed | Why (numbers) |
|---|---|---|---|---|
| **D-24** | **CG range at R1 geometry: 0.050–0.055 m, target 0.0526 m; the pod stays at the D-08 layout; D-17 closed.** A3 sets the pack nominal centroid to x = −0.001 m (4 mm aft of the old pod centre); the −0.125 m fallback, `CALC-A1-POD-RULE` and `ASM-A1-POD-*` are retired; replaced by `CALC-A1-CG-RANGE` (params range inside B3's claims, pack-centred CG +1.5 mm from the forward end) | CR-B3-11; supersedes CR-A3-11, CR-A5-11, CR-D2-02, CR-A1-22/23/24 | `cg.x_range_m`, `cg.x_target_m`, `cg._note`, `pod.x_le_m` note, `mass_budget.json#cg_x_m` | NP with props and pod 0.0713 m; forward limit from elevon trim ≤ 12.5° at CLmax (`CL-B3-CG-FWD` 0.0499), aft from SM 5 % (`CL-B3-CG-AFT` 0.0553); pack-centred CG 0.0515 is inside; the pod at −0.125 would be 5.5 mm ahead of the forward limit. B3 re-runs once for D-26/D-27 |
| **D-25** | **Pod nose shell to −0.115 m with an XPS crush block; pod 0.21 × 0.14 × 0.07 m; pitot tip [−0.195, −0.046, 0.045]; pod allocation 122 g.** Tray, hatch and bay forward stop (x −0.1002) unchanged; the 3 mm printed forward stop is the spreader backstop; D2 re-lays the bay so the pack aft face reaches x 0.069 (0.073 with a 680 g pack); CR-C3-02 (−0.108) void | CR-C5-02, CR-C3-06, CR-C3-03, CR-D2-01, CR-D2-03, CR-C3-01 | `pod.x_le_m`, `pod.size_m`, `avionics.pitot_tip_xyz_m`, `mass.allocation_g.pod` | ≥ 24.3 mm of crush holds any 503–680 g pack to ≤ 100 g in a 5 m/s nose-in crash (`CL-C5-PACK-NOSE-ROOM` fails by 5 mm today); a 0.10 m pod cannot hold the 52 mm bay and the FC side by side (+3 % drag, B1 re-runs); at y 0 the pitot socket sits in the pack; C3 stops + guides 9.5 g |
| **D-26** | **Fins: two board layers (one layer rejected), half-fins 0.21 m high, tube 0.344 m, fins allocation 408 g, half-fin ids `FIN-001-UR/UL/LR/LL`** | CR-C4-14 (over CR-D3-02), CR-B3-14, CR-C4-20, CR-D3-01, CR-C4-15, CR-A4-15b, CR-A5-15 (over CR-D3-08) | `fins.layers` note, `fins.half_height_m`, `fins.tube.length_m`, `fins.saddle`, `fins.pieces_per_fin` note, `propulsion.stations.z_m` note, `mass.allocation_g.fins` | one-layer station mode 228 Hz is 14 % from cruise 2P (`CL-C4-D3-SEP-1L` 0.14 FAIL; two layers 0.41); Cn_β at the aft limit 0.0286 → 0.0373 /rad with 0.21 m fins (R-DIRECTIONAL ≥ 0.03), +6 g, envelope unchanged; the shorter tube lets the motor screws be reached from behind the plate (−7.8 g per tube; C4 mount stiffness ≥ 900 N·m/rad); D3 CAD 364.5 + 37.5 g second layer = 402 g; one suffix family per part (README rule) |
| **D-27** | **Motor cant 3° → 7°**, same sense (UR + LL print A, UL + LR print B) | CR-B3-12; A2's 30 % differential cap kept | `propulsion.stations.cant_deg` | 3° gives hover yaw 1.15 × the 5 m/s disturbance and 1.15 rad/s² against 1.5 × and 2 rad/s² (`CL-B3-HOVER-YAW-RATIO/ACCEL` FAIL); 6.1° needed, 7° gives 2.23 × / 2.24 rad/s² for 0.75 % thrust. B4 re-runs swirl recovery; D3 changes one print parameter; C4/C6 check the 12 % side component on the mount |
| **D-28** | **Prop plane x −0.0082 m, motor plate face x 0.0309 m** (D3's CAD stack carried over E1's −0.0033); the tube front face stays at 0.034; D3 and E1 freeze the stack on the measured motor | CR-D3-04 (over CR-E1-16), CR-E1-16 | `propulsion.stations.x_prop_plane_m`, `x_mount_m` note | the 2 mm collar wall sits ahead of the tube, so the plate moves 3 mm forward to keep ≥ 39 mm (0.14 D, B4) from the prop plane to any structure (`CL-D3-PROP-GAP` 1.02); E1's stack 37.3 mm would put the plane at −0.0064 |
| **D-29** | **Loads: n⁺ 3.4, VD 27.2 m/s, thrust limit 21.1 N per motor; elevon deflection schedule (full travel to VA 20.5 m/s, ≤ 1/3 at VD) enforced by F4; servo ≥ 3.93 kgf·cm** | CR-C1-16, CR-C1-13, CR-C1-12, CR-H1-01, CR-F4-07, CR-C1-15, CR-B2-10 | `requirements.load_factor_limit_pos`, `vd_ms`, `thrust_limit_per_motor_n` | gust n 3.36 at VH 21.8 m/s; VD = 1.25 × the 11×5.5MR pitch speed at the 9 350 rpm cap; `CL-C1-T-CAP` 21.08 N (the 100 A limiter is time-filtered and does not bound a step); F4 keeps the cap rather than lowering it to 8 590 rpm; spar and fin joints are landing-governed, mounts and motors +18 %; hinge moment at VD would need 5.9 kgf·cm, the schedule keeps B2's 3.93 at 1.3 × cruise |
| **D-30** | **Feet 48 mm, constant-force cartridge stroke ≥ 38 mm with biased plateaus; landing 43 g; tip-over ≥ 30° toward the pod side at the worst flying CG with the pad contact at z ±0.218 and z_cg subtracted; the 33° target (CR-A1-20) retired** | CR-C5-10, CR-C5-11 (over CR-C1-17's 41 / 26 mm), CR-C5-01, CR-D5-01, CR-D5-06 | `cg.foot_height_m`, `requirements.foot_crush_stroke_min_m`, `tipover_min_deg` note, `mass.allocation_g.landing`, `CALC-A1-TIPOVER` | C5's planar model: the 17 mm z_cg pitches a level landing onto the pod-side pair and a pair-first touchdown lands the second pair harder (today 32.8 mm needed vs 29 usable, FAIL); 38 mm gives 34.5 of 35 mm, n 5.84 / 5.54; 48 mm keeps the TE ≥ 10 mm off the ground after the stroke; tip-over 32.4° worst flying CG, 30.6° corner bound (`CL-A1-TIPOVER`), 28.3–29.2° unsplayed (FAIL) |
| **D-31** | **Transport box 1.25 × 0.55 × 0.54 m (`PROPOSED`, freeze after two measured cars; fallback 0.50 m with a "max drop 0.15 m" label); box 3.63 kg; packs in the LiPo bag; envelope [1.15, 0.483, 0.438]; D-22's "costs no box height" corrected** | CR-D7-01, CR-D7-07, CR-D5-01, CR-A2-18 | `requirements.box_external_m`, `box_wall_m` note, `box_drop_m` note, `box_mass_max_kg` note, `mass.transport_box_kg`, `transport.envelope_props_off_m`, `transport.cradle` | in a floor drop the aircraft sinks by the ~70 mm cradle stroke, so the lower tube ends and pads need that travel above the floor: height needed 0.535 m (`CL-D7-BOX-H-REQ`); the 0.50 box allows a 0.18 m drop (`CL-D7-A1-BOX-DROP-ALLOW` −42 %); loaded 5.90 kg without packs, 7.00 with |
| **D-32** | **Main disconnect Amass AS150U, packs re-terminated (XT60 rejected); `electrical.r_ext_mohm` 6.5; UBEC fitted with a 5 A fuse; power allocation 620 g.** Closes CR-A2-08, CR-A4-09, CR-J1-04 | CR-F1-02, CR-F1-03, CR-F3-04, CR-F1-14 | `electrical.main_disconnect`, `electrical.r_ext_mohm`, `battery.pack`, `mass.allocation_g.power` | required 37.8 A continuous (1.25 × 30.3 A) and 53.7 A ≤ 60 s; XT60 35 A fails and has no cited rating ≥ 120 A momentary; AS150U 70 / 140 A (reseller: F1 opens the maker sheet before the order); FC servo BEC 4.5 A < 5.2 A needed; power excluding the pack 69 g vs 45 carried; pack leads ≥ 10 AWG (12 AWG rises 28 °C) |
| **D-33** | **Avionics: CoreWing F405 Wing APP V2 (Plane 4.7.x stable, target CoreWingF405WingV2); MS4525DO airspeed at 0x28 (MS5525 dropped); HGLRC M100-5883 on a 45°-tilted mast pad; telemetry over ELRS (no radio); RC FCC firmware; avionics 80 g; `requirements.rc_rssi_check_min_dbm` −93.8; range check at 25 mW** | CR-F3-01, CR-F3-03, CR-F5-06, CR-F5-07, CR-F5-05 | `avionics.flight_controller`, `airspeed`, `gps`, `rc`, `telemetry`, `requirements.range_check_min_m` note, `rc_rssi_check_min_dbm`, `mass.allocation_g.avionics` | stable tailsitter build checked on firmware.ardupilot.org; the MS5525's 0x76 clashes with the board baro on the only I²C bus; a level patch faces the horizon in hover; 78.5 g vs 75 (the FC's 40 g includes its power board, carried at 0 g in power); no Lua on any F405; a SiK pair only if the reserve later allows |
| **D-34** | **Propulsion allocation 476 g; motor screws stay in `propulsion`; `propulsion.motor_max_a` 25 A, `esc_burst_a` 55 A added** | CR-E1-14, CR-A2-12b | `mass.allocation_g.propulsion`, `propulsion.motor_max_a`, `propulsion.esc_burst_a` | per station: motor 81.0 with leads, ESC 11.0 with leads and heat-shrink, prop 17, adapter + nut + washer 6.7, screws 3.2 = 118.9 g (`CL-E1-MASS-PRP` 475.6 FAIL at 440); E1's limiter claims cite parameters, not typed ratings (CR-A2-13) |
| **D-35** | **Voltage-sag thrust factor 0.72 → 0.76** (E2's limiter-consistent value); E1's 0.854 (`CL-E1-TW-WORST` 2.18) is the other bound; E1 and E2 publish one worst-state claim and the cold-pack stand run decides | CR-E2-12, CR-E1-15 | `propulsion.voltage_sag`, `CL-A1-HOVER-TW-SAG` note | T/W with sag at the gate 1.89 ≥ 1.6; E2 applied (V/14.8)² to an already current-limited thrust (E1: with the limiter binding thrust ∝ V), so 0.72 double-counted; the lower of the two reconciled numbers is carried (D-13 rule). F4's 12 °/s pitch-over rate (CR-B1-12) was derived at 0.72: B1 re-checks at 0.76 |
| **D-36** | **Performance block from B1 rev 2 (16 m/s, 11×5.5MR): cruise 218 W / 14.7 A (pessimistic 285 W / 19.3 A), L/D 6.9, cruise after hover 13.7 min (E2 mission base; B1 17.0), pessimistic 7.3 (E2 re-run; B1 12.7), hover-only 11.9, lean 16 / 36°, transition 15.6 m/s (B3 `CL-B3-VT-TRIM` at the forward CG limit), stall 11.9.** E1's 247 W not carried (reads the old L/D 5.6) | CR-B1-10, CR-B3-15, CR-E2-12, CR-E1-19 (part), CR-B1-11 | `performance.*` | the 13.7 / 7.3 min are `build_graph.py`'s re-run of E2's `CALC-E2-BUDGET-*` on B1's `CL-B1-CRUISE-P` 216.9 / 283.4 W (E2 publishes, CR-E2-11); `AIRSPEED_MIN` 15.6 (F4; 15 holds only if Vs ≤ 12.5); B1 re-runs for the 0.14 m pod (+3 % drag) |
| **D-37** | **Airspeed error allowance 1.0 → 0.5 m/s**; cruise stays 16 m/s (B1's 16.5 m/s alternative not taken) | CR-B1-13, CR-F3-09 | `requirements.airspeed_err_max_ms` | margin from cruise down to 1.3 Vs is 0.49–0.58 m/s; F3's RSS budget 0.44 m/s after `ARSPD_AUTOCAL` and reciprocal legs; 16.5 m/s would cost 15 W and 1.1 min |
| **D-38** | **Mass allocations 2 324 g (wing 405, fins 408, pod 122, landing 43, propulsion 476, power 620, avionics 80, harness 105, mechanisms 65); A1 reserve 276 g; growth allowance 250 → 170 g; sized 2.59 kg.** A3 re-runs the roll-up on these allocations; the gate rests on A3's maturity growth ≤ 170 g and the pack weigh-in | CR-C4-15, CR-C3-03, CR-C5-11, CR-E1-14, CR-F1-02, CR-F3-01, CR-A3-12, CR-C2-06, CR-D5-06 | `mass.allocation_g.*`, `mass.growth_reserve_g`, `requirements.growth_allowance_kg`, `mtow_sized_kg`, `mass_budget.json` | six allocations raised to the designers' own numbers (+124 g); the flat 250 g allowance double-counted growth on CAD and datasheet masses; `CL-A1-MASS-SIZED` 2.594 kg (+0 %), `CL-A1-RESERVE-COVERS` +6 g: thin. A1 rough prediction with A3's factors: ≈ 2 450 g with a 550 g pack, ≈ 2 580 g with 680 g, before the 100 g overrun. Levers: Tekko32 ESCs −21 g, aluminium nuts −4 g, pack ≤ 550 g; the one-layer fin (−40 g) is rejected (D-26) and 18 AWG leads (−18 g) by F1 |
| **D-39** | **Budget: ground-test equipment counts against the $2 000; cost keys from I1's BOM (spend 1 569.03 / 1 680.35, reserve 319.65); lever order for any new line: gate the Small Parts adapter set (X05, $26.40), SpeedyBee FC (+$21.25), defer the airspeed sensor last (+$66.14)** | CR-H1-02, CR-I1-02, CR-I1-03, CR-E1-20 | `cost.*` | the pessimistic margin to the $309 crash is $10.65; H1's rigs ≈ $160–180 `EST` cannot all be bought: borrow from Jacobs Hall, buy ≤ $20 (load cell); the adapter set is out of stock anyway and E1's fallback (motor-box adapters + Loctite) is accepted; expected reserve ≈ $326 |
| **D-40** | **Field kit: one 10 mm prop spanner is the single allowed tool** (R-FIELD-SETUP "no tools" re-worded by A2) | CR-C6-05, CR-D7-05 | `requirements.field_setup_max_min` note, `transport.field_steps` | the M6 prop nut at 1.5 N·m is the only field joint needing a tool; a tool-free prop retention is not worth inventing (4 × 35 s of a 265 s set-up) |
| **D-41** | **Thread engagement per type: 1.0 d metal, 1.5 d heat-set insert, 2.0 d self-tapping plastic, nyloc + 2 pitches** | CR-C6-06 | `requirements.thread_engagement_min` note, `thread_engagement_insert_min`, `thread_engagement_plastic_min`, `nyloc_pitches_min` | A2 (1.0 d in an insert) and SCHEMA (1.5 d) disagreed |
| **D-42** | **Thermal keys: `env.ambient_ceiling_c` 43, `pack_takeoff_max_c` 34, `full_throttle_max_s` 10; motor mounts and ESC pads printed in ASA (PETG 58 °C limit fails by 8 K)** | CR-E3-07, CR-E3-01, CR-E3-04, CR-E3-05 | `env.*`, `fins.saddle` note | motor base 65.8 °C mission / 66.4 steady hover; ESC pad 61.6 °C; from a hover-warm motor full throttle is thermally limited to ~13 s (E1's "≤ 30 s" is not available); the PETG collar would relax the D-23 slip-torque preload |
| **D-43** | **Spar stays 22 × 20 mm at z +0.0066 m** (CR-B2-09's +0.0070 and the 16 × 14 trade rejected) | CR-B2-09, CR-C2-10 | — | cover 5.0 / 4.3 mm already passes ≥ 2 mm (`CL-A5-SPAR-COVER`); C2 sized the slot and plugs at 0.0066; a 16 × 14 spar saves 29 g but costs 26 % of the first torsion frequency and needs separate stock |
| **D-44** | **`R-STALL` is judged over the R3 CG range** (0.050–0.055): B2 re-runs `CL-B2-STALL-GATE-FWD` at 0.050 (B3: 11.93 m/s there); the SM-7.8 % case at 0.040 is void | CR-B2-11 (closed by D-24) | `performance.stall_ms` note | at the old forward limit the stall was 12.06 m/s (−0.5 %); the new forward limit is set by elevon trim, not SM, and sits 10 mm further aft |
| **D-45** | **Wing modes close by the tap-test branch of `R-VIBRATION` plus the rpm-tracking notch;** B3 adds the 12–15 Hz antisymmetric torsion mode to the hover loop model; F4 keeps the rate-loop crossover ≤ 5 Hz | CR-C2-03, CR-C2-04, CR-C4-06 | — (A2 words it) | no spar between 16 and 25 mm clears the ±20 % windows over the E uncertainty (`CL-C2-WING-MODE-SEP` 0.077 FAIL); fin/tube modes are C4's `CL-C4-D3-SEP` 0.41 (supersedes `CL-J1-TUBE-MODE-SEP`) |
| **D-46** | **Shared tooling: A4 is assigned the `redesign/interfaces/` changes** (19 plan connection types; `merge_check.py`: harness-owned electrical edges exempt from the `owner` warning, non-structural types skipped in the floating check, power wires followed `part_a` → `part_b`); A5 re-runs `fusion/tests` and `check.py` after | CR-A4-15a, CR-A5-10a | — | `merge_check.py --strict` cannot pass at a gate while 23 wires warn `owner`; `check.py`, `build_all.py` and the Blender backend import the module |

## Change-request dispositions

`accept` = adopted in `params.json` or README; `forward` = not A1's to decide, A1's position given, the named role acts;
`reject` = not adopted; `closed` = already answered by another row. One line each; evidence is the requester's file.

### To A1

| CR | From | Decision | Reason |
|---|---|---|---|
| CR-A2-01 | A2 | accept (D-14) | 39 limits are `requirements.*` keys; A2 retires `ASM-A2-*` |
| CR-A2-02 | A2 | accept (D-15) | fin height 0.38 m; P6's 0.40 was the old fin chord |
| CR-A2-03 | A2 | closed | CR-A1-09 closed; CR-A4-13 and CR-J1-09 are answered by A2's `R-NO-FLOATING`, `R-DIRECTIONAL`, `R-VIBRATION` |
| CR-A3-01 | A3 | accept with changes (D-07) | A3's 2 185 g plus D-01/D-04/D-11 geometry and 15 g servos = 2 200 g; reserve 400 g |
| CR-A3-02 | A3 | superseded (D-04, D-08, D-17) | with the motors at 0.045 the pod moved forward 85 mm, not aft |
| CR-A4-01 | A4 | accept (D-20) | README joint table rewritten |
| CR-A4-02 | A4 | accept (D-11, D-16) | feet 45 mm; box 0.50 m |
| CR-A5-01 | A5 | accept as B2's value (D-03) | 0.0066 m on the S5010 camber line, not the 0.0048 placeholder |
| CR-A5-03 | A5 | closed (D-04, D-08, D-10, D-17) | layout CG now 0.051 (A3) against 0.040–0.049; B3 re-derives the range |
| CR-A5-05 | A5 | accept (D-15) | `fins.board_t_m` 0.0048 |
| CR-A5-08 | A5 | accept, assigned to the team lead | a teammate with Fusion runs BuildAll on the skeleton; listed in HANDOFF |
| CR-B1-01 | B1 | accept (D-01) | cruise 16 m/s |
| CR-B1-02 | B1 | accept in part (D-13) | B1's values carried where they are the conservative ones; B1 re-runs with the 11×5.5MR |
| CR-B2-01 | B2 | accept (D-01) | chord 0.32 m, cruise 16 m/s; gate mass unchanged |
| CR-B2-02 | B2 | accept (D-02) | S5010 |
| CR-B2-03 | B2 | accept (D-03) | spar z 0.0066 m |
| CR-B3-01 | B3 | accept (D-10) | CG range 0.040–0.049, SM 0.05, elevons unchanged |
| CR-B3-02 | B3 | accept O4b (D-04) | tube at 0.045 through the core; fallback O7 not needed |
| CR-B3-05 | B3 | accept (D-09) | 3° cant |
| CR-B3-07 | B3 | superseded (D-21) | re-run at R1 geometry before any cruise-speed change |
| CR-B4-02 | B4 | accept (D-05, D-15) | prop, rpm_max, pitot, download 1.06 kept, APC source checked |
| CR-C1-01 | C1 | accept (D-11) | feet 45 mm, stroke ≥ 40 mm |
| CR-C1-06 | C1 | accept (D-14) | five load limits are `requirements.*` keys |
| CR-E1-01 | E1 | accept with changes (D-05, D-06) | prop and 24.8 A adopted; `thrust_max` carried as 1.62 kg (fresh, limited) with sag 0.72 from E2 instead of 1.48 kg |
| CR-E1-02 | E1 | accept (D-13) | hover 400 W / 27 A; cruise carried at B1's 307 W until B1 re-runs |
| CR-E1-03 | E1 | accept (D-15) | sources marked as E1 reported; LANRC stays unchecked |
| CR-E2-01 | E2 | accept (D-06, D-12, D-13, D-15) | pack envelope, sag 0.72, pessimistic 6.4 min, no 4000 fallback; mass stays `UNVERIFIED` |
| CR-E2-05 | E2 | defer (D-12) | packs 3–4 only if the post-order reserve is ≥ $396; 2 sorties per test day |
| CR-J1-02 | J1 | reject (D-19) | SM stays 0.05; the up-trim penalty is inside B2's trimmed CLmax |

### Forwarded (A1's position; the named role acts)

| CR | To | Decision | Reason |
|---|---|---|---|
| CR-A1-01 | A5 | closed | `fusion/modules.txt` rewritten |
| CR-A1-02 | A4 | open | the six queued `interfaces/` changes; apply D-20 and CR-A3-09, CR-A5-04 in the same pass |
| CR-A1-03 | J4 / viewer | open | prefix → hue map |
| CR-A1-04 … 09 | A3, B1/B2, B3, E1, E2, A2 | closed | D-07, D-01, D-10, D-15, D-15, A2's P-map |
| CR-A2-04 | A3 | forward | point the CG claims at `R-CG-RANGE`, `CL-A3-ALLOC-WORST` at `R-MASS-ALLOC` |
| CR-A2-05 | A4 | forward | `R-NO-FLOATING`, `R-JOINT-STACK` |
| CR-A2-06 | J1 | forward | `R-VIBRATION`, `R-DIRECTIONAL`; re-run after R1 (six calcs drift today) |
| CR-A2-07 | B1, B2 | closed by D-01 | B2 re-runs `CL-B2-STALL-GATE` at c 0.32; B1 the 8 m/s lean is already at the gate |
| CR-A2-08, CR-A4-09, CR-J1-04 | F1 | forward | A1 accepts XT60 only with a claim that the ≤ 5 s momentary case at the 100 A limiter is inside a cited XT60 burst rating; otherwise AS150U. UBEC: F1 decides on the FC's BEC rating × 2 |
| CR-A2-09 | C1 | closed | `team/C1/LOADS.md` exists; C1 re-runs at R1 |
| CR-A2-10 | H1, H2, H3 | forward | use A2's file names |
| CR-A2-11 | J2 | forward, optional | `--requirements` filter |
| CR-A3-03 | B3 | forward (D-17) | NP with props at R1 geometry is B3's first job |
| CR-A3-04, CR-B3-10 | A3, B3, F4 | accept (D-18) | split 1.25; A3 points `ASM-A3-SPLIT-MAX` at `P:requirements.hover_split_max` |
| CR-A3-05, CR-E1-13 | E1 | forward | propulsion allocation stays 440 g; E1 writes `parts.csv` with per-unit masses incl. leads |
| CR-A3-06 | F1, F2 | forward | 18 AWG if 30 A momentary on 0.5 m passes `wire_temp_rise_max_c`; `team/F2/mass_estimate.csv` |
| CR-A3-07 | D2 | forward | pod carries mast and pitot mount; pack low |
| CR-A3-08 | E2 | forward | weigh one pack in the November order first |
| CR-A3-09 | A4, A5 | accept | per-unit `mass_g`, one node per instance `<id>-<UR|UL|LR|LL|L|R>`; rule written into README; A4 puts it in SCHEMA.md |
| CR-A3-10 | C5 | forward | tip-over at the R1 CG is 30.6° (A1) — thin; D5 splays the feet (see D-11 note) |
| CR-A4-03 | D3, D1, C4 | closed (D-04) | half-fins, tube through a core hole, printed through-core block |
| CR-A4-04 | D6, D3, B3 | forward | both panels stay (B3); D6/D3 slot the lower half-fin root for the link |
| CR-A4-05 | F2, D1 | forward | wire channel aft of the spar (x > 0.095) or through the through-core block |
| CR-A4-06 | E1, E3 | forward | bolt pattern, screw length, adapter; PETG mount temperature |
| CR-A4-07, CR-B4-05 | D2, F3 | accept (D-15) | pitot on the pod nose, tip at x −0.185 |
| CR-A4-08 | F3, F5 | forward | I2C 0x76 clash, compass distance, antennas |
| CR-A4-10 | C6, C4 | forward | 19 joint stacks + 8 clamps, M2/M3 only |
| CR-A4-11 | A5 | forward | transport touch checks, harness bodies, thermal contact |
| CR-A4-12 | F4 | forward | ports from `signal.fc_port`; publish the motor map |
| CR-A4-13, CR-J1-09, CR-B3-08 | A2 | closed | `R-NO-FLOATING`, `R-DIRECTIONAL`, `R-VIBRATION`, `R-HOVER-AUTHORITY` exist |
| CR-A4-14 | all designers | forward | use the register ids |
| CR-A5-02, CR-B2-04 | B2 → D1, A5 | accept | copy `team/B2/airfoils/s5010.dat` to `subsystems/wing/s5010.dat` (D1) |
| CR-A5-04 | A4 | forward | SCHEMA.md frame text → `params.json#frame`; `9xx` ids reserved |
| CR-A5-06 | E1 | forward | prop hub thickness, shaft + adapter length |
| CR-A5-07 | designers | forward, endorsed | start from `fusion/skeleton/<key>/` |
| CR-A5-09 | J3 | forward | `k09kit.hover_pose()` for renders |
| CR-B1-03, CR-B2-08 | B2 → B1 | closed | B2 answered; B1 re-runs |
| CR-B1-04, CR-B3-07 | B3 → B1 | forward | CLα 3.56, e 0.93 (R0); B3 re-derives at R1 first |
| CR-B1-05, CR-B4-08 | B4 → B1 | closed | 11×5.5MR η 0.474; B1 re-runs |
| CR-B1-06, CR-C1-07, CR-E1-11, CR-B4-09, CR-E2-09, CR-B3-09, CR-B1-09 | H1, H2 | forward | one stand campaign: Rm/I0, A/B props, fresh-pack peak thrust and torque, pack weigh/capacity/IR; flight tests as listed |
| CR-B1-07, CR-B3-04, CR-B4-06, CR-C1-08, CR-E1-08, CR-E2-03, CR-J1-05, CR-A4-12 | F4 | forward | one parameter file; the list is in `team/A1/SUMMARY.md` |
| CR-B1-08, CR-E1-09, CR-E2-04 | F1 | forward | design currents: hover 29.9 A, climb 30.2 A, transition 42.9 A (20 s), limited peak 100 A, momentary 120 A (< 5 s) |
| CR-B2-05 | D6, A3 | accept (D-07) | servo ≥ 3.04 kgf·cm; mechanisms 65 g |
| CR-B2-06, CR-B3-06 | B3, B2 | closed | B2 answered with `CL-B2-ELEVON-ETA`, `CL-B2-DCM-VISC` |
| CR-B2-07, CR-C1-09 | C1 | forward | replace the guesses with B2 claims and `loads_spanwise.json` |
| CR-B3-03 | A3, D2 | superseded (D-08, D-17) | — |
| CR-B4-01, CR-E1-06 | E1, B4 | closed (D-05) | concur |
| CR-B4-03, CR-E1-04 | B3 | forward | hover authority with fin swirl recovery and cant; motor-out roll 0.22 N·m |
| CR-B4-04, CR-C1-03 | D3 | accept (D-09, D-23) | canted mounts; tube face ≥ 39 mm behind the prop plane; mounts as the fuse |
| CR-B4-07, CR-J1-03 | C4 | forward, first job | fin + tube modes outside 80–330 Hz; `CL-J1-TUBE-MODE-SEP` fails today |
| CR-B4-10, CR-E1-10, CR-E2-07 | E3 | forward | ESC pads in the slipstream, motor losses, pack heat path |
| CR-B4-11, CR-E1-12, CR-J1-07 | I1 | accept | props 8 + 4 (+ optional 11×5.5E pair), US-stock tube in the ~20 Nov order |
| CR-C1-02 | H3, C5 | forward | flight card: lay flat between flights above 5 m/s; rubber foot pads |
| CR-C1-04 | D2, D7, H3, C4 | accept (D-23) | carry point and label, and C4 sizes to G2 |
| CR-C1-05 | D7 | accept (D-22) | ≥ 70 mm crush foam under the cradles |
| CR-C1-10 | A2 | closed (D-11, D-22) | both requirement numbers kept |
| CR-C1-11 | C6 | forward | mount clamp sized to the 3.2 N·m prop-nut case |
| CR-E1-05, CR-E2-08 | B1 | forward | re-run with 11×5.5MR 216 W (E1) / 181 W (B4) and feed E2 |
| CR-E1-07 | A2 | forward, concur | rewrite `R-ESC-CURRENT` around the 100 A limiter |
| CR-E2-02 | D2 | accept (D-15) | bay ≥ 0.160 × 0.052 × 0.053 m; pod height 0.07 |
| CR-E2-06 | H3 | forward | charging room, pack ≥ 20 °C at take-off |
| CR-E2-10 | I2 | forward (D-12) | 2 sorties per test day |
| CR-J1-01 | B3 | closed (D-04) | — |
| CR-J1-06 | B4, B1 | closed (D-05) | — |
| CR-J1-08 | C5, C1 | closed (D-11) | C1's case supersedes the 10 mm stroke |

## Change-request dispositions, revision A1-R3 (detail-analysis round)

Same rules. Requests from the first round that were dispositioned above are not repeated; C4's and C5's first-round
requests (never logged) are included.

### To A1

| CR | From | Decision | Reason |
|---|---|---|---|
| CR-A2-12 | A2 | accept (D-34) | (a) `R-TRANSPORT` text now reads `requirements.box_external_m` (A1 edits `params/claims.json`); (b) `propulsion.motor_max_a` 25, `esc_burst_a` 55 added; (c) CR-A1-17 closed |
| CR-A3-11 | A3 | superseded (D-24) | the pack goes 4 mm aft of the pod centre, not 26–29 mm forward; the nose-wall problem disappears |
| CR-A3-12 | A3 | accept (D-26, D-38) | one-layer fin rejected by C4; fins 408 and power 620 g allocated from the reserve; the pack weigh-in decides the gate |
| CR-A4-15 | A4 | accept (D-46, D-26) | (a) A4 does the `interfaces/` changes, A5 re-tests; (b) `FIN-001-UR/UL/LR/LL` |
| CR-A5-11 | A5 | closed (D-24) | 0.053 m is inside the R1 range; no pod move, no aft channel needed for CG reasons |
| CR-A5-15 | A5 | accept (D-26) | station codes |
| CR-B1-10 | B1 | accept (D-36) | all rev-2 values carried; cruise minutes from E2's mission budget (conservative), B1's level-cruise figures in the notes |
| CR-B1-13 | B1 | accept (D-37) | 0.5 m/s; F3's RSS 0.44 fits |
| CR-B2-09 | B2 | reject (D-43) | 0.0066 passes; C2 has sized to it |
| CR-B2-11 | B2 | closed (D-24, D-44) | the forward limit moved to 0.050; `R-STALL` judged over the new range; B2 re-runs the forward-CG stall there |
| CR-B3-11 | B3 | accept (D-24) | D-17 closed; A3 moves the pack; D2 re-lays the bay |
| CR-B3-12 | B3 | accept (D-27) | 7° cant; B4 re-runs swirl, D3 one print parameter, C4/C6 mount side load, F4 cant check |
| CR-B3-14 | B3 | accept (D-26) | 0.21 m half-fins with two layers (C4 CR-C4-20); D5 pads stay at ±0.219 (C5) |
| CR-B4-02 (R2 notes) | B4 | accept | pitot note 1.66 %, download 1.034–1.043 kept at 1.06, `SRC-APC-11X45MR` checked |
| CR-C1-12 | C1 | accept (D-29) | 21.1 N; F4 keeps the cap (CR-F4-07); H1 replaces with the measured peak (CR-H1-01) |
| CR-C1-13 | C1 | accept (D-29) | VD 27.2 m/s with the elevon deflection schedule; B1 re-runs VMAX (CR-C1-14) |
| CR-C1-16 | C1 | accept (D-29) | n⁺ 3.4 |
| CR-C1-17 | C1 | accept in part (D-30) | C5's planar model governs: 38 mm constant-force stroke at 48 mm; C1's 41 / 26 mm is the single-foot bound |
| CR-C2-10 | C2 | accept (D-43) | spar unchanged |
| CR-C3-02 | C3 | void (D-25) | the 10 mm nose extension of CR-C5-02 absorbs the 3 mm |
| CR-C3-03 | C3 | accept (D-25, D-38) | pod 122 g |
| CR-C3-06 | C3 | accept (D-25) | crush block + spreader stop |
| CR-C4-01 (R1) | C4 | accept in part | brace and edge strips done by D3; one layer withdrawn by C4 itself (CR-C4-14) |
| CR-C4-14 | C4 | accept (D-26) | two layers; `fins.layers` `CHECKED` against `CL-C4-D3-SEP` 0.41 |
| CR-C4-15 | C4 | accept (D-26, D-38) | fins 408 g (402 + 6 for the 0.21 m fin) |
| CR-C5-01 | C5 | accept (D-30) | `CALC-A1-TIPOVER` reads `CL-D5-CONTACT-Z` and subtracts z_cg at the worst corner (30.6°); 33° retired; A2 re-words `R-TIPOVER` |
| CR-C5-02 (revised) | C5 | accept (D-25) | pod nose shell −0.115 with the XPS block; box slack 17 mm |
| CR-C5-11 | C5 | accept (D-30, D-38) | feet 48 mm; landing 43 g |
| CR-C6-05 | C6 | accept (D-40) | one prop spanner |
| CR-C6-06 | C6 | accept (D-41) | per-type keys |
| CR-D2-01 | D2 | accept (D-25) | pod width 0.14; B1 adds the drag |
| CR-D2-02 | D2 | superseded (D-24) | nominal pack centroid x −0.001 (B3), not the forward stop; aft travel must reach 0.073 m pack aft face |
| CR-D2-03 | D2 | accept (D-25) | pitot y −0.046; B4 re-runs (CR-F3-11) |
| CR-D3-01 | D3 | accept (D-26) | tube 0.344 |
| CR-D3-02 | D3 | reject (D-26) | C4's mode check fails with one layer on D3's own geometry |
| CR-D3-04 | D3 | accept (D-28) | prop plane −0.0082; E1 stack reconciled on the measured motor |
| CR-D3-08 (id part) | D3 | reject (D-26) | ids are `FIN-001-UR/UL/LR/LL`; D3 renames, D5's edges already use them |
| CR-D5-01 | D5 | accept (D-30, D-31) | envelope 0.438 m; `CL-A1-TIPOVER` on the contact z; README feet row |
| CR-D7-01 | D7 | accept as `PROPOSED` (D-31) | 0.54 m box pending two measured cars; fallback 0.50 + 0.15 m label; box 3.63 kg |
| CR-E1-14 | E1 | accept (D-34, D-38) | 476 g; screws stay in propulsion |
| CR-E1-15 | E1 | accept in part (D-35) | one worst-state claim is right; 0.76 (E2) carried until E2 concurs or the stand decides; `CL-A1-HOVER-TW-SAG` notes `CL-E1-TW-WORST` |
| CR-E1-16 | E1 | superseded (D-28) | D3's collar moves the plate; −0.0082 carried |
| CR-E1-19 | E1 | reject (D-36) | 247 W reads the old L/D 5.6; B1's 218 / 285 W carried; E1 re-points at `CL-B1-CRUISE-LD` (CR-B1-11) |
| CR-E2-12 | E2 | accept with changes (D-35, D-36) | sag 0.76; pessimistic cruise 7.3 min from the re-run on B1 rev 2 (not 5.1, which was the 11×4.5MR) |
| CR-E3-07 | E3 | accept (D-42) | three `env` keys |
| CR-F1-02 | F1 | accept (D-32) | AS150U, re-termination, `r_ext_mohm`, power 620 |
| CR-F3-01 | F3 | accept (D-33) | FC, airspeed, GPS, avionics 80 |
| CR-F4-07 | F4 | accept (D-29) | 21.1 N; the cap stays at 9 350 rpm |
| CR-F5-07 | F5 | accept (D-33) | telemetry key, 25 mW note, `rc_rssi_check_min_dbm` |
| CR-H1-01 | H1 | accept (D-29) | 21.1 N until GT-02d; then the measured peak rounded up to 0.5 N |
| CR-H1-02 | H1 | accept (D-39) | rigs count; borrow first, buy ≤ $20; I1 adds the line |
| CR-I1-02 | I1 | accept (D-39) | `cost.*` from the BOM; `CL-A1-RESERVE` reads it |
| CR-I1-03 | I1 | accept (D-39) | lever order: adapter set gated, SpeedyBee, airspeed last |

### Forwarded (A1's position; the named role acts)

| CR | To | Decision | Reason |
|---|---|---|---|
| CR-A2-13, CR-A5-13, CR-E3-12, CR-F4-03, CR-E1-17 | E1 | forward | re-point the limiter claims at `propulsion.motor_max_a` / `esc_burst_a`; `CL-E1-HOVER-T` parts → `PRP-001-<st>`; publish `subsystems/propulsion/interfaces.json` with instance nodes; motor-map and adapter hand (LH on CW) as F4 published; slotted mount pattern until measured |
| CR-A2-14, CR-B1-12, CR-B3-15, CR-C1-08, CR-C1-15, CR-C2-03, CR-C2-04, CR-C4-07, CR-C5-05, CR-C5-09 (part), CR-D5-09, CR-E1-21, CR-E3-05, CR-F1-10, CR-F3-02, CR-F5-01, CR-J1-12, CR-D3-07 | F4 | forward | one parameter file: `AIRSPEED_MIN` 15.6, `Q_TAILSIT_RAT_FW` 12 (re-check at sag 0.76), deflection schedule to VD 27.2, `THR_MAX`, rate-loop crossover ≤ 5 Hz and notch on ESC rpm, `Q_M_BAT_CURR_MAX` 100 claim, spin-min at touchdown, wingtip-into-wind landing, cant sense A/B vs the map, `ARSPD_TYPE 1`, ELRS channel map, LH adapters on CW motors |
| CR-A2-15, CR-C1-19, CR-C2-06, CR-D5-06, CR-E2-15, CR-F1-12, CR-A4-17, CR-B2-10 | A3 | forward | re-run on D-24 (pack at x −0.001, D-38 allocations); `CL-A3-HOVER-SPLIT` verifies `R-HOVER-SPLIT`; rows from C2 (397 g + plugs), D5 (39.1 g), F1 (69 g, UBEC 13 g, ESC leads 64.6 g), E1 parts.csv; clip rows per half-fin; 17–20 g servos |
| CR-A2-16, CR-B1-15, CR-B3-13, CR-C1-18, CR-C2-09, CR-C1-15 (hinge part) | B2 | forward | `sf` → `P:requirements.servo_torque_factor`; AVL polar and trimmed CL(α) as params keys; `clmax_vs_flap` key; `loads_spanwise.json` at c 0.32 and the R3 CG range; `CL-B2-STALL-GATE-FWD` at 0.050 (D-44); flexible-wing roll effectiveness noted |
| CR-A2-17, CR-B1-11, CR-E3-10, CR-F1-03, CR-F1-04, CR-D7-07, CR-I1-06 | E2 | forward | `cap_frac` → `P:requirements.pack_capacity_min_frac`; re-run on B1 rev 2 and `r_ext` 6.5; phase currents as claims; one sag claim with E1 (D-35); packs in the LiPo bag; confirm the pack connector and lead gauge at order |
| CR-A2-18, CR-A4-21, CR-A5-14, CR-C2-05, CR-D3-11, CR-C6-08 | D7 | forward (D-31) | cradle pads ≥ 40 × 40 mm at y ±0.20, inboard of 0.23; box in the aircraft frame with `stowed` edges; pitot slot; M3 handles; two measured cars before the 0.54 m freeze |
| CR-A2-19, CR-A3-13, CR-B2-12, CR-B4-03, CR-B4-12, CR-C2-03, CR-C4-20, CR-F4-01, CR-F4-02, CR-J1-11, CR-C5-05 (yaw) | B3 | forward | re-run once at R3 (7° cant, 0.21 m fins, pack at −0.001, A3 inertia): publish `CL-B3-CG-FWD/AFT/TARGET` under the same ids (A1's `CALC-A1-CG-RANGE` reads them), Cn_β at the aft limit with prop normal force, symmetric differential-thrust yaw with `THR_MIN` 10 %, the 12–15 Hz torsion mode in the hover loop |
| CR-A4-16, CR-D2-03, CR-D3-15, CR-F3-11, CR-C4-08 | B4 | forward | half-fin ids; pitot at [−0.195, −0.046, 0.045]; swirl recovery and yaw at 7° cant; collars, braces and ESC pads in the download and drag models |
| CR-A4-18, CR-C4-16, CR-C4-17, CR-C4-19, CR-C6-01, CR-C6-02, CR-C6-03, CR-C6-10, CR-D5-03, CR-E3-01, CR-E3-02, CR-H1-08, CR-C2-02 | D3 | forward (D-26, D-27, D-28, D-42) | two layers, 0.21 m half-fins, tube 0.344, 7° mount angle, ASA mounts and pads, 40 mm two-face collar tail, CF through-pins on the strips, collar 16 mm, motor screws 0.20 N·m on a drilled (not slotted) pattern, ids `UR/UL/LR/LL`, square 40 mm tips for the feet, strap eye at each root, SPEC pointed at `CL-C4-D3-*`; the 36 mm spar plug is C2's part |
| CR-C2-01, CR-C2-02, CR-C4-18, CR-D2-04, CR-D3-03, CR-D7-04, CR-A5-12 | D1 (C2) | forward | build the wing from `team/C2/sizing.json`: six PETG spar plugs, slot from the lower surface, block pockets x 0.0279–0.0972 at y 0.302–0.338, anchor pockets 20 × 16 at (0.080, ±0.242), pod recess and bare-foam footprint, ties under the spar, cradle patches free, wire channel ahead of the spar or through the block; declare `WNG-001/002` and acknowledge the fins, pod and transport edges |
| CR-C3-01, CR-C3-04, CR-C5-07, CR-C6-07, CR-C6-09, CR-E3-03, CR-F1-08, CR-F1-13, CR-F3-03, CR-F5-03, CR-A4-19, CR-C2-07, CR-A1-24 (closed) | D2 (C3) | forward (D-24, D-25) | pod at 0.21 × 0.14 × 0.07 with the crush block; stops 3.0 mm, guides 1.5 mm, epoxy tray-to-floor, 50 mm strap overlap, 12 × 40 hatch tab; bay re-laid for the pack aft face at 0.069 / 0.073; AS150U park 60 mm; vents; FC on gel pads, airspeed on foam tape (no M2); pitot flange and y −0.046; two antenna exits; bond to bare foam; nothing waits on the pod station any more |
| CR-C4-09, CR-C5-04, CR-C5-10, CR-C6-12, CR-D3-08 (shoe part), CR-H1-08 | D5 (C5) | forward (D-30) | 48 mm foot, ≥ 38 mm stroke, biased cartridges colour-marked, shoe for the 9.6 mm board + strip ends, 6 mm snap fingers, TE corner caps, CG-jig patch free at \|y\| 0.45 |
| CR-D3-05, CR-C6-13, CR-D7-04, CR-F1-11, CR-I1-07, CR-B2-10 | D6 | forward | link slot x 0.2376–0.2616 in the lower half-fin root; horns and frames ≥ 720 mm² into XPS, through-panel horn, screws into bosses; servo ≥ 3.93 kgf·cm, ≤ 6 V, stall current to F1; keep the cradle patches clear |
| CR-A4-20, CR-C3-05, CR-C4-22, CR-D5-04, CR-C1-11 | C6 | closed / forward | joint stacks delivered (`joint_stacks.json`); own the pod allowables; collar and brace-end bonds on C4's R2 numbers; coupons CR-C6-14 |
| CR-C5-09, CR-C6-03, CR-C6-02a, CR-D3-10, CR-C4-13, CR-C4-21 | C4 (C1) | forward | fin face and strips at μ 0.7 side load (23 N); agree the collar torsion (5.29 vs 9.3 N·m: C6 sizes to C4's); strip shear flow in the FE; mount side component at 7° cant; `T-C4-MOUNT-STIFF`, `T-C4-TAP-D3` |
| CR-C1-14, CR-C4-08, CR-D2-01 (drag), CR-D3-15, CR-E2-11, CR-B2-14 | B1 | forward | `CL-B1-VMAX` with the 11×5.5MR at the cap; +3 % pod drag, collars and braces; re-check the 12 °/s pitch-over at sag 0.76; keep `CL-B1-CRUISE-P` ids |
| CR-D7-02, CR-H1-03, CR-J1-10, CR-C5-09, CR-C6-03 | C1 | forward | cradle stroke 0.0699, x/y box allowables, lid preload case; whiffletree loads and limit/ultimate labels for H1; retire `ASM-J1-*` names; L4/L5 at μ 0.7; `J-FINHALF` torsion with C4 |
| CR-A5-10, CR-D2-08, CR-D3-13, CR-D5-07, CR-D7-03, CR-E3-11, CR-F1-06, CR-F3-08, CR-F5-10, CR-C6-15 | A4 | forward (D-46) | `stowed` key; new parts, edges and connection types from D2, D3, D5, D7, E3, F1, F3, F5; `E-HRN-10` → `CT-AS150U`; `E-AVN-01` gel pad, `E-AVN-04` tape; `GND-001`; merge the joint stacks; `interfaces/` tooling changes |
| CR-D3-14, CR-D5-02 | A5 | forward | skeleton `fins` to R3 (tube 0.344, half-fins 0.21, 7° mounts), `DATUMS.md` (DP-TUBE, DP-TE, DP-GROUND 0.368, `DX-FOOT-*` = pad contact ±0.218, `DX-COLLAR`, `DX-ANCHOR`), box 0.54; re-test after A4's `merge_check.py` change |
| CR-A2-14, CR-B1-16, CR-C2-08, CR-C3-07, CR-C4-21, CR-C6-14, CR-D5-08, CR-E3-06, CR-F3-10, CR-F4-06, CR-F5-05, CR-I1-08 | H1 | forward | one campaign plus the structures coupons and proofs: stand points at 14.0 / 13.6 V with the limiter, GT-02d peak at the cap, A/B hover ratio, mount stiffness, C2/C3/C6 coupons and proof loads, D5 cartridge coupon and pad friction, GT-04 pass lines (ESC ≤ 33 K, motor ≤ 38 K, 600 s τ step), I²C scan, range test at 25 mW with the RSSI line, Aloft tube bend test by 10 Dec |
| CR-B1-14, CR-C5-06, CR-C5-08, CR-E3-04, CR-F4-10, CR-F5-09, CR-D7-07, CR-F3-10 | H2, H3 | forward | flight card: wind ≤ 5 m/s for fin-tip landing, lay flat above 8 m/s, wingtip into wind, stance rules S1–S8 on the mat, full throttle ≤ 10 s, pack 20–34 °C, hatch open on the ground > 5 min, TX on before the pack, RSSI alarms, transition at 12 °/s until logs show ≤ 0.7, motor-out = throttle cut + glide; log 20 twin touchdowns |
| CR-C6-11, CR-D3-09, CR-D5-10, CR-E1-20, CR-E3-06, CR-F1-12, CR-F1-14, CR-F3-06, CR-F5-06, CR-B4-11, CR-I1-01 | I1 | forward (D-39) | fastener kit (M3 only), CF strips and plugs, neoprene, thermocouples, AS150U × 5, 8 / 16 / 20 AWG, UBEC, caps, fuse, PDB, CoreWing V2 now, MS4525DO, FCC RC, ground-test line ≤ $20, adapter set gated (X05); designers deliver `parts.csv` with prices |
| CR-E2-16, CR-I1-11 | I2 | forward | 2 sorties per test day; order dates 20 Nov / 10 Dec / 15 Dec, build start 19 Jan |
| CR-B3-16, CR-C2-04, CR-C4-06, CR-C5-03, CR-F1-01, CR-F1-15, CR-F3-09, CR-F4-09, CR-F5-08, CR-H1-07, CR-I1-12, CR-E3-08 | A2 | forward | `R-CG-RANGE` → `cg.x_range_m`; `R-VIBRATION` tap-test branch for the wing (D-45); `R-TIPOVER` and `R-LANDING-IMPACT` texts per C5; `R-DISCONNECT` wire limits 10 °C steady / 30 °C < 60 s and the pack-lead 20 °C; `R-FIELD-SETUP` one spanner (D-40); `R-AIRSPEED` RSS 0.5; `R-RC-LINK` 25 mW + RSSI; `R-FSW-PARAMS` 63 / 113 matched; H1 evidence names; `R-BUDGET` → I1 claims; `R-THERMAL` claims; per-type thread engagement (D-41) |
| CR-A4-05, CR-A5-12, CR-D2-07, CR-D3-12, CR-E1-18, CR-F1-07, CR-F3-05, CR-F4-04, CR-F5-04 | F2 | forward | first job: wire list and routing (8 AWG ≤ 0.15 m twisted; ESC leads 16 AWG in two taped surface grooves 5 mm apart, not buried, ≥ 0.12 m from the mast top; phase extension ≤ 100 mm if needed; I²C ≤ 0.5 m; RX lead; `signal.fc_port` on `E-HRN-24…29`), `team/F2/mass_estimate.csv`, `subsystems/harness/` |
| CR-F3-04, CR-E2-14, CR-F1-09, CR-I1-10 | F1 | closed | FC power board is `PWR-003`; UBEC stays; currents as E2 lists; AS150U answered |
| CR-E3-09, CR-F1-09, CR-D2-06, CR-D7-06, CR-F5-02, CR-I1-09, CR-B4-05 | F3 | closed / forward | answered in F3-R1 (1.73 W, 4.5 A BEC, gel pads, boom QD, RX on a DMA UART, V2 confirmed); write `subsystems/avionics/` |
| CR-C4-12, CR-F1-05, CR-B2-15 | J1 | forward | supersede `CL-J1-TUBE-MODE-SEP` by `CL-C4-D3-SEP` and the XT60 claims by F1's AS150U claims; re-point `cm0` at `P:b2.xfoil.cm0_2d_stall` |
| CR-E3-01 (G3 part), CR-C6-04 | G2, G3, E3 | forward | ASA (HDT 93 °C) for mounts and pads; 4 h / 50 °C post-cure for bonds within 50 mm of a motor; E3 gives the collar temperature |
| CR-H1-04, CR-H1-05, CR-H1-06, CR-I1-04, CR-I1-05 | F4, E1, E3 | forward | stand parameter set (25 A per station); `ASM-E1-RM` line-to-line at 25 °C; GT-04 limits (answered by CR-E3-06); one ESC 4-pack now; box adapters for the stand |

## Revision A1-R4 (integration round)

Inputs: A3-R5 roll-up (all nine flying `parts.csv`), A4-R4 `integration_check.py` (merge_check FAIL on one error, the CG),
A5 `check.py` (5 errors: CG + D5 caps), every designer's R3/R4 change requests. One configuration-level problem (the CG);
everything else is bookkeeping between owners.

| Id | Decision | From | Keys changed | Why (numbers) |
|---|---|---|---|---|
| **D-47** | **CG fix: pod nose shell −0.115 → −0.130 m (pod 0.225 × 0.14 × 0.07), nose block 14.8 → 8.8 mm, the whole pack bay (forward stop −0.1002 → −0.1212, crush block ≥ 24.3 mm, spreader, spacers, aft stop 0.077 → 0.056) 21 mm forward; pack nominal centroid x −0.022 m (new key `pod.pack_x_nominal_m`), per weighed pack 680 g −0.014 / 550 g −0.022 / 503 g −0.0245; CG range 0.050–0.0549 m, target 0.0522 (B3 R3); pitot tip −0.210 (boom unchanged); envelope x 0.498 m** | CR-A3-22, CR-D2-16, CR-B3-17, CR-A4-36, CR-A5-20; supersedes CR-B3-18, CR-C5-12, CR-A3-15 | `pod.x_le_m`, `pod.size_m`, `pod.pack_x_nominal_m`, `cg.x_range_m`, `cg.x_target_m`, `avionics.pitot_tip_xyz_m`, `transport.envelope_props_off_m`, `mass_budget.json#cg_x_m` | with every parts.csv the take-off CG is 0.0577 m (18.0 % c), 2.8 mm aft of B3's aft limit 0.05495 (`CL-A3-CG-X-RANGE` 2.07, `CL-A5-ASSY-CG-X` FAIL; shares of the 5.5 mm shift from the layout: power +3.2, avionics +1.4, propulsion +1.2, mechanisms +1.1 mm) and the pack has 3.4 mm of forward room; moving the whole pod (A3 −15 mm) is impossible because the spar saddle `POD-007` sits at x 0.080; moving the power boxes (A5, −3.4 mm) or the stations (−25 mm) is not enough or not buildable. Result at 0.236 mm of CG per mm of pack (A3): 550 g 0.0525 basic / 0.0540 predicted, 503 g 0.0540 / 0.0555 (2.5 mm forward slide), 680 g 0.0486 → 0.0508 with an 8 mm spacer: all inside. Cost +3 g shell, +15 mm of length (`CL-A1-BOX-FIT` slack 2 mm; D7 re-fits the nose pad), CG 5 mm higher in the stance (C5 re-checks tip-over, +2 % today). C5's crush block is kept whole (the bay moves with the nose), which is what CR-C5-12 asked for |
| **D-48** | **Mass allocations 2 355 g: wing 405, fins 418, pod 131, landing 43, propulsion 462, power 648, avionics 45, harness 123, mechanisms 80; A1 reserve 245 g; growth allowance 145 g; sized = gate 2.600 kg.** Directed reductions inside the allocations: mechanisms 3/32 in inter-panel rod (−3.6 g, D6's own fallback), propulsion ESCs carried stripped of the factory power leads (−13.6 g, F2 solders its own), fins collar 16 → 12 mm (−3 g) pays C6's 15 mm root fillets (+3 g), harness returns 12 g if the factory phase leads reach | CR-A3-21, CR-A4-37, CR-A5-28, CR-F1-19, CR-F3-13 (over CR-F1-19's 52 g), CR-D2-09, CR-D3-16, CR-C4-28, CR-D6-01 (83 asked), CR-F2-01, CR-D1-08, CR-A3-20, CR-C6-24, CR-C4-25 | `mass.allocation_g.*`, `mass.growth_reserve_g`, `requirements.growth_allowance_kg`, `mtow_sized_kg`, `mass_budget.json` | six subsystems over the D-38 allocations by 71 g in all, all of it real hardware the R3 joints and installations added (collars with the 40 mm tail, pins, torque tubes, routed ESC leads, the power frame); the 28 g CoreWing power board moved from avionics to power (`PWR-003`). Predicted mass stays 2 449 g with the 550 g pack (A3-R5 growth 119 g ≤ 145); reserve covers growth + overrun with 26 g free. `CL-A1-MASS-SIZED` 2.600 (+0 %): the gate now rests on the pack weigh-in (above 601 g the overrun is not covered; I1's fetched listing says 680 g, see D-58) |
| **D-49** | **Sag factor 0.76 → 0.851 (one E1/E2 calculation); cruise 240 W / 16.2 A, L/D 6.2 (E1 on B1 rev 3, D-13 conservative rule; B1 227.8 W / 300.6 W pessimistic); cruise after hover 12.7 / 6.8 min (E2 on B1 rev 3)** | CR-E1-25, CR-E2-18, CR-E1-24, CR-B1-19, CR-E2-21 | `propulsion.voltage_sag`, `performance.cruise_power_w`, `cruise_current_a`, `ld_cruise`, `cruise_after_hover_min`, `cruise_after_hover_pess_min` | E1 and E2 now agree (CALC-E1-WORST on E2's OCV, cell R, cold factor and F1's 6.5 mΩ: 0.851; closed-form check 0.873); E2's (V/14.8)² on an already current-limited thrust is withdrawn. `CL-A1-HOVER-TW-SAG` 1.89 → 2.12. B1 rev 3 adds the 0.14 m pod, braces and collars (CD0 0.0452 → 0.0513); E1's 234 + 6 W is the conservative cruise figure. B1 states what its pessimistic case covers against E2's K09-based 386 W (CR-E2-21); the first tune flight's logged current settles it |
| **D-50** | **VD stays 27.2 m/s, n⁺ 3.4: F4 caps fixed-wing `THR_MAX` at 70 % (7 750 rpm, level 21.3 m/s ≤ 21.8), shown in the first full-throttle level log; the "≤ 1/3 travel at VD" half of the D-29 schedule is held by envelope (no raw-stick FW mode, `PTCH_LIM_MIN_DEG` −10, `AIRSPEED_MAX` 18), not by an airspeed surface limit; servo stays 3.93 kgf·cm; C6 bond areas fall back to 720 mm²; `vd_ms` is not rounded to 27.25** | CR-B1-17 (b), CR-C1-20 (recommended), CR-F4-15, CR-F4-12, CR-C6-21b, CR-C6-23, CR-A2-20c (rejected) | `requirements.vd_ms` note | B1's VH at the 9 350 rpm cap is 25.7 m/s (`CL-B1-VMAX`), which would make VD 32.1 m/s and q +39 % (elevon hinge, horns, servo 5.9 kgf·cm, stall-line n 7.3); the structure is insensitive but the mechanisms are not. ArduPilot Plane has no airspeed-dependent surface limit and no Lua on the F405. C1 re-runs on the capped VH (`CL-F4-VLEVEL-VH`), which closes the −0.05 % rounding failure of `CL-C1-VD` without touching the key |
| **D-51** | **Prop plane x −0.0082 → −0.0077 m (D3 `face_ahead_m` 0.0025, `prop_stack_m` 0.0373); `propulsion.motor_length_m` 0.0265; `x_plate_face_m` 0.0309 added** | CR-E1-22 (rev), CR-E1-29, CR-A5-16 | `propulsion.stations.x_prop_plane_m`, `x_plate_face_m`, `propulsion.motor_length_m` | E1's paper stack is 37.3 mm (37.0 along x at 7°); with D3's 1 mm `face_ahead` the gap to the collar front is 38.0 mm against B4's 39.1 (`CL-E1-CAD-PROP-GAP` 0.97 FAIL); 2.5 mm fixes it. `CL-A1-PROP-CLEAR` 34.6 mm (gap to the tube face 41.7); B4's canted-disc tip-to-tube 27.3 mm ≥ 25. Frozen on the measured motor (T-E1-MOTOR-RM) |
| **D-52** | **Cant sense corrected: D3 sets `fin_detail.mount.cant_sense_UR = −1` (UR prop end leans toward the wing and outboard), same rule at every station; 7° kept, B4's 5° option open until T-B4-YAW; H1/H2 verify the sense on the built aircraft (inclinometer + hanging yaw test) before the first hover** | CR-F4-11, CR-B4-15a, CR-E1-32, CR-B4-14, CR-B4-16 | `propulsion.stations.cant_deg` note | three independent derivations (F4 from the motor map, B4 from the swirl model, E1 from the CAD thrust vector) agree that the R3 print sense opposes the reaction torque: hover yaw would reverse (yaw moment per N of differential thrust −0.003 m). At 7° with the right sense the yaw need is met even with no fin credit (1.30 ×); 5° would give back 4.3 mm of blade-to-tube gap and halve the thrust cost but is judged after the stand |
| **D-53** | **Transport: box 3.57 kg (loaded 5.84), 120 mm cradle columns, no lid lining; the 0.3 m drop is the floor drop; aft-wall drop taken by the feet (0.25 m); end, nose and lid-down drops are label-and-test only ("keep upright"); `transport.carry` added; props-on transport (CR-D7-15) rejected at R4** | CR-D7-08, CR-D7-12, CR-C1-22 (label option), CR-D7-15, CR-D7-13 | `mass.transport_box_kg`, `transport.cradle`, `transport.carry`, `requirements.box_drop_m` note | the 127 mm foam column bottomed 2 mm off the floor (`CL-D7-TUBE-CLEAR-DROP` −82 %); 120 mm and no lid lining give `CL-D7-A1-BOX-DROP-ALLOW` 0.339 m (+13 %), n 10.1 ≤ 11.0; 54–57 mm of end and side stroke would need ~0.2 m more box and no car takes it. Props-on would remove the only field tool but exposes a prop to the drop; D-40 stands until the twin's field days say otherwise. D7 re-fits the nose pad for the 15 mm longer pod (D-47) and antenna tube B (≤ 10 mm ahead of the nose) |
| **D-54** | **Feet: `foot_crush_stroke_min_m` 38 mm is the flange-to-sleeve gap (usable 35 mm after C5's 3 mm guard); envelope span 1.152 m with the TE corner caps; README feet row re-worded; the half-fin tip takes D5's step (`tip_square_m` 0.0454, flat step at \|z\| 0.2005 from x 0.2746, strips end at 0.2746), not D3's flat 0.210 tip** | CR-D5-16, CR-D5-11 (over CR-D3-19), CR-D5-21 (forwarded to F4, concur) | `requirements.foot_crush_stroke_min_m` note, `transport.envelope_props_off_m` | a 38 mm usable stroke would need a 51 mm foot; the R3/R4 foot's 17.1 mm sleeve must overlap the fin in x and cannot sit above a 0.21 m tip; twin sleeves beside the fin cost 62 g against 43. Q_LAND_SPEED 30 cm/s (D5): below 0.32 m/s no permanent crush, 2.3 landings per cartridge at 0.5 m/s; the structural design sink stays 1.5 m/s |
| **D-55** | **Shared R3 stations promoted to `params.json`: `fins.stations.collar_end_xyz_m` [0.045, 0.3023, 0.1535], `brace_anchor_y_m` 0.242, `brace_anchor_y_in_m` 0.234, `landing.pad_contact_z_m` 0.218, `propulsion.stations.x_plate_face_m` 0.0309; stale notes fixed (`wing.elevon.inboard_y_m`, DP-MOUNT = tube front face 0.034)** | CR-A5-16, CR-A5-18, CR-D7-08c | new keys, two notes | D5, D7, C4, C5 and `CALC-A1-TIPOVER` read these numbers; the datum rule says a datum moves only when `params.json` changes. A5 points `DATUMS.md` and `k09kit` at the keys; the owners (D3, D5) keep their local copies equal |
| **D-56** | **Requirement texts: `R-MASS-GATE`, `R-TIPOVER`, `R-DISCONNECT` re-worded in `params/claims.json` (A2's R3 text, with the R4 reserve); new keys `electrical.wire_temp_rise_short_max_c` 30, `pack_lead_rise_max_c` 20; `thermal.*` limits (motor 80, ESC 85, pack 50, FC 85 °C) as keys; CR-A1-37 closed** | CR-A2-20 (a, b, d), CR-A2-24b, CR-E3 limits | `params/claims.json`, `electrical.*`, `thermal.*` | one source per limit; F1 re-points the six rise claims, E3 the seven temperature claims (and drops `verifies` on the rejected PETG option, CR-A2-24a) |
| **D-57** | **Cost keys from I1-R3: spend 1 579.79 / 1 687.01, reserve 312.99 (+$3.99 over the crash), `reserve_pessimistic_allin_usd` 128.00; gates accepted: X05 adapter set, X07 box and field kit (built from Jacobs Hall stock first), X08 airspeed sensor (first fixed-wing tune on the synthetic estimate); lever order: borrow soldering / meter / hot-wire gear, then SpeedyBee FC, un-gate X08 if the bench is lent** | CR-I1-14, CR-I1-15, CR-I1-16 | `cost.*` | the designers' priced parts (Savox servos +$40, harness, mechanisms hardware, mat, fastener kit) ate the ≈ $326; `CL-A1-RESERVE` 313 ≥ 309 (+1 %); every gated line bought would leave $128 |
| **D-58** | **Deviations granted: (a) `E-PRP-01…04` prop-adapter screws minimum engagement 2.0 mm (vendor M3×4 in a ~2.5 mm bell top, 0.5 N·m + Loctite 243 tip, RF 1.70 at 2.0 mm, `CL-E1-ADAPTER-STRIP`), conditional on T-E1-MOTOR-RM measuring ≥ 2.5 mm of thread; (b) the supplied 2-56 clevises and M2 cover screws in mechanisms as exceptions to M3-only. Pack SKU: E2 names a 4S 6500 SKU ≤ 601 g with ≥ 10 AWG leads, or accepts re-leading and the 680 g mass (then the first build must come in under allocation, levers in MASS-CG.md)** | CR-E1-33, CR-A4-43, CR-A4-25, CR-D6-11b, CR-I1-13, CR-A3-24 | — (C6 lists both in `JOINTS.md`; A4 records them in the plan) | a 3.0 mm engagement is not available in the bell; the service load is 14 N shear / 4 N axial per screw against a 0.83 kN preload. The pack is 25 % of the aircraft and decides the gate: I1 holds the pack cart until E2 answers |
| **D-59** | **Pack bay trim (A1-R4a): aft travel 8 → 12 mm (`pod.pack_aft_travel_m` 0.012, aft stop 0.056 → 0.060), spacer step 2 mm (`pod.pack_spacer_step_m`); nose (−0.130), crush stack and the −0.022 datum unchanged. Each weighed pack flies at the spacer step, counted forward from the no-spacer station −0.010, that puts the basic CG nearest 0.0522 m, never ahead of the crush stack (−0.0254): 550 g −0.018 (8 mm), 503 g −0.024 (14 mm), 680 g −0.010 (none). Nose ballast ≤ 10 g from the A1 reserve if the balance test with a light pack is aft of the aft mark. Allocations unchanged (D-48 stands); the D-58 pack-SKU line moves 601 → 631 g** | CR-A4-36, CR-A4-37, CR-A5-20, CR-A3-22 (re-check on A3's roll-up of 20:35 that carries the D-47 bay and the D-48 allocations) | `pod.pack_aft_travel_m`, `pod.pack_spacer_step_m` (new), `pod.pack_x_nominal_m` note | after D-47 the delivered parts got lighter aft (D6 82 → 71 g at x 0.22, E1 ESCs stripped 476 → 462 g, POD-008 moved with the bay): the 550 g CG is 0.0513 m (16.0 % c), inside, but the 680 g pack at −0.014 is 0.0496, 0.4 mm ahead of the forward limit, needing 9.5 mm of aft travel (`CL-A3-PACK-TRIM` 1.5 mm). 12 mm gives 680 g 0.0507 / 0.0520 (+0.7 mm basic); 503 g 0.0523 / 0.0538 (+1.1 mm predicted, 1.4 mm travel left); 550 g 0.0522 / 0.0536 (`CALC-A1-PACK-CASES`). Moving the datum to −0.018 instead gives the same geometry but trips `pod.py`'s aft-face check before D2 re-lays, so D2 may propose it in its R5 (CR-A1-54). Mass: every subsystem is inside its D-48 allocation (`CL-A3-ALLOC-WORST` 1.00, propulsion 462.0 / 462); basic 2 305 g, predicted 2 419 g, margin +181 g with the 550 g pack; the reserve keeps 31 g free after growth (114 g) and the overrun. `merge_check` passes with no CG error (CG 0.051) |

### Change-request dispositions, revision A1-R4

Same rules as above (`accept` / `forward` with A1's position / `reject` / `closed` / `superseded`). Rows from the R3 round
that were never logged (A3-14…19, A4-22…35, A5-16…19, D-series R1 requests, F2-01…12) are included.

#### To A1

| CR | From | Decision | Reason |
|---|---|---|---|
| CR-A2-20 | A2 | accept (a, b, d) (D-56); reject (c) (D-50) | three texts pasted (R4 reserve 245 g, so A2 updates its table); two wire keys added; `vd_ms` stays 27.2 because C1 re-runs on the capped VH; CR-A1-37 closed |
| CR-A2-24 (b) | A2 | accept (D-56) | `thermal.*` keys; (a) forwarded to E3 |
| CR-A3-14 | A3 | superseded (CR-A3-20/21, D-48) | — |
| CR-A3-15 | A3 | superseded (CR-A3-22, D-47) | the 6 mm stop move alone gives 0.0554: not enough |
| CR-A3-16 | A3 | superseded (CR-A3-24, D-58) | threshold now 601 g |
| CR-A3-21 (1) | A3 | accept with changes (D-48) | avionics 45 (F3's number), power 648; (2) harness 123; (3) propulsion carried stripped, E1 re-runs |
| CR-A3-22 | A3 | **accept (D-47)** | the one lever that keeps the crush block and the saddle; D2 implements per CR-D2-16 (−0.130 / 0.225) |
| CR-A3-24 | A3 | accept (D-58) | E2 names the SKU |
| CR-A4-31 | A4 | accept (a, b) (README); (c) closed | `ground` row and the widened id rule in the README; the CG error is now real (CR-A4-36) |
| CR-A4-36 | A4 | accept (D-47) | pod nose + bay, not the pod group or the stations |
| CR-A4-37 | A4 | accept (D-48) | re-allocated to the delivered numbers with three directed reductions |
| CR-A5-16 | A5 | accept (D-55) | five keys |
| CR-A5-17 | A5 | closed (D-47) | the shift was mass growth aft of the CG, as A5 said |
| CR-A5-18 | A5 | accept (D-55) | both notes fixed |
| CR-A5-20 | A5 | accept (D-47) | the pack bay, not the power boxes (79 g × 0.1 m is −3.4 mm, not −5.5) |
| CR-A5-28 | A5 | accept (D-48) | — |
| CR-B1-17 | B1 | accept (b) (D-50) | THR_MAX 70 % (F4 CR-F4-15); C1 reads the capped VH |
| CR-B1-19 | B1 | accept in part (D-49) | B1's rev 3 ids carried; the params value is E1's 240 W by the D-13 rule |
| CR-B3-17 | B3 | accept (D-47) | range 0.050–0.0549, target 0.0522 |
| CR-B3-18 | B3 | superseded (D-47) | derived at A3-R3 (0.0548); A3-R5 is 0.0577, so the bay moves 21 mm, not the pack 11 mm |
| CR-B4-14 | B4 | reject for R4 (D-52) | 7° stays until T-B4-YAW; notes updated |
| CR-C1-20 | C1 | accept the recommended option (D-50) | — |
| CR-C4-28 | C4 | accept (D-48) | fins 418 with the collar 12 mm paying the fillets |
| CR-C5-12 | C5 | superseded (D-47) | the bay moves with the nose, so the block stays whole: C5's condition is met |
| CR-C6-21 (b) | C6 | closed (D-50) | 27.2 m/s is meant; `CL-C1-VD-ENV` re-runs on the capped VH |
| CR-D1-08 | D1 | accept (D-48) | wing 405 kept |
| CR-D2-09 (rev R4) | D2 | accept (D-48) | pod 131 incl. the 15 mm nose |
| CR-D2-16 | D2 | accept (D-47) | −0.130 / 0.225, A3's station (−0.022), spacer set 2/4/6/8/8; pitot boom unchanged (tip −0.210), not shortened |
| CR-D3-16 | D3 | accept (D-48) | 418 g; collar 12 mm if the tongue fits (CR-C4-25) |
| CR-D5-16 | D5 | accept (D-54) | span 1.152, README row, stroke wording |
| CR-D6-01 | D6 | accept with changes (D-48) | 80 g with the 3/32 in rod (D6's fallback) |
| CR-D7-08, CR-D7-12 | D7 | accept (D-53, D-55) | 3.57 kg; column 120 mm; floor drop; carry key; anchor edge key |
| CR-D7-15 | D7 | reject at R4 (D-53) | a prop exposed to the drop; revisit after the twin's field days |
| CR-E1-22 (rev), CR-E1-29 | E1 | accept (D-51) | −0.0077, motor length 0.0265 |
| CR-E1-24 | E1 | accept (D-49) | 240 W / 16.2 A / 6.2 |
| CR-E1-25 | E1 | accept (D-49) | 0.851 |
| CR-E1-33 | E1 | accept as a deviation (D-58a) | conditional on the measured thread depth |
| CR-E2-18 | E2 | accept (a, b, d) (D-49); (c) carried as E1's 240 W | B1's stored ids are what E2 reads; the params value is the conservative one |
| CR-F1-19 | F1 | accept in part (D-48) | power 648; avionics 45, not 52 (F3 owns it) |
| CR-F2-01 | F2 | accept (D-48) | 123 g; 12 g back after T-E1-MOTOR-RM |
| CR-F3-13 | F3 | accept (D-48) | 45 g; 7 g to the reserve; F1 confirms the board separates (CR-F1-21) |
| CR-F3-21 | F3 | closed | the baseline is MS4525DO / 45 g; the task text was stale |
| CR-F4-12, CR-F4-15 | F4 | accept (D-50) | envelope-held schedule; THR_MAX 70 % |
| CR-I1-14, CR-I1-15 | I1 | accept (D-57) | cost keys, gates, lever order |

#### Forwarded (A1's position; the named role acts)

| CR | To | Decision | Reason |
|---|---|---|---|
| CR-A3-22, CR-D2-16, CR-D2-10, CR-C5-13, CR-D2-11, CR-C6-17, CR-F1-17, CR-F2-03, CR-F3-12, CR-D7-13, CR-A5-27 (POD) | D2 (C3, C5) | forward (D-47) | re-lay the bay 21 mm forward with the nose at −0.130 and length 0.225; forward stop derived from the nose; spacer set 2/4/6/8/8 colour-coded per pack; C3 re-points `pod_structures.py` at the R4 keys (`stop_wall_h_m` is gone: `aft_stop_m[1]`, `fwd_stop_m[1]`, `pod.size_m[1]`) and confirms the 8.8 mm nose block keeps the crush-block load path; C5 re-runs `CALC-C5-CRASH` per pack (503/550/680) and the tip-over with the CG 5 mm higher; C3/D2 decide the full-section forward stop (+4 g from the reserve); corner fillets, UBEC plate, F2's exits and tie bar, F3's tie posts and strap slots; antenna tube B ≤ 10 mm ahead of the nose; `POD-008` / `POD-003` CGs from the bodies |
| CR-A3-23, CR-A2-26, CR-C1-25, CR-D1-03, CR-D5-26, CR-E1-34 | A3 | forward (D-47, D-48) | re-run on D2's new bay (pack at −0.022, 680/550/503 g at their stations) and the R4 allocations; add `verifies=['R-HOVER-SPLIT']`; map the four plugs (22 g) and the landing nodes; drop `GER-E02`; take E1's CAD centroids; publish `CL-A3-CG-X-RANGE` inside 0.050–0.0549 |
| CR-A3-23, CR-A2-19, CR-B4-13, CR-C2-03, CR-D6-08, CR-B3-19/20/21 (own) | B3 | forward (D-47, D-52) | re-run `sc_analysis.py` on A3's R4 roll-up (CG, inertia, split 1.214); publish `CL-B3-CG-FWD/AFT/TARGET` under the same ids; take B4's hover-yaw factor 1.79 (size the cant on `CL-B4-YAW-LOW` 1.40); D6's elevon effectiveness 0.93 at VA and 0.84° free play; the 12–15 Hz torsion mode in the hover loop |
| CR-A4-38, CR-A5-24, CR-F1-18, CR-D1-06, CR-D6-05, CR-F3-16, CR-D3-23, CR-A5-27 (HRN), CR-I1-19 | F2 | forward | first: re-run `harness.py` so the 21 parked wires (`E-HRN-02/04`, `-10…16`, `-21…32`) enter `interfaces.json` and the CAD registers them (16 unconnected / 8 unpowered parts today); apply CR-F1-18 (`E-HRN-21` ends at the fuse `PWR-007`, new `E-HRN-33` fuse → UBEC, `E-HRN-34…37` ESC → cap `CT-SOLDER-DC` ≤ 20 mm, `E-HRN-11/12` 10 AWG); end the wires on F3's port points and F1's stack; D1's lower servo pocket route (+15 mm), D3's lead hole 22 mm off the skin; `HRN-002` CG from the bodies; `parts.csv` with prices |
| CR-A4-39, CR-A5-25, CR-D1-05, CR-D5-11…15, 17…27 (own), CR-H1-14 | D5 (C5) | forward (D-54) | re-run `make_interfaces.py`: `E-GER-21/22` to `edges`, `GER-007-L/R` `MODELLED`, spares as `flight:false` nodes; C5 re-runs `landing_calc.py` on D5-R4 (plateau 37.49 N, bias 1.056, η 0.903, set 1.28 mm), fixes the `IndexError` in `CALC-C5-STANCE`, renames `GER-003-LR/LL` → `GER-008-LR/LL`, drops `verifies` on the superseded "foot today" claims (CR-A2-21a); H1 uses the `claims.json` coupon lines |
| CR-A4-40, CR-A5-26, CR-F1-22, CR-D5-11, CR-D3-17…24 (own), CR-E1-23, CR-E1-30, CR-E1-32, CR-F4-11, CR-B4-15, CR-C4-25, CR-C6-24, CR-C4-26, CR-D6-04, CR-I1-17, CR-I1-20 | D3 (C4, C6) | forward (D-48, D-51, D-52, D-54) | `cant_sense_UR = −1`; `face_ahead_m` 0.0025, `prop_stack_m` 0.0373; ESC pad height 0.031; the D5 tip step (0.0454 square, step at \|z\| 0.2005, strips end at 0.2746); collar 16 → 12 mm if the tongue fits; 15 mm root fillets; stop the lower root fillets over the link notch x 0.2376–0.2616; declare `E-FIN-81…88` with E3's thermal blocks; acknowledge `E-PWR-11…14`; update the stale `E-FIN-61…64` stack (3.5 mm, 0.20 N·m); stop reading `CL-C4-STRUT-LEN`; one 1 m length of 20×18 tube for the plugs (I1); ASA spool |
| CR-A4-41, CR-D1-04…07, CR-D1-09/10 (own), CR-D3-24, CR-D6-03, CR-D5-18, CR-F2-04 | D1 (C2) | forward | after D5 and F2 re-run, move `E-GER-21/22`, `E-HRN-02/04` to `acknowledges`; acknowledge `E-FIN-49…60`; D6's torque-tube grooves, horn slots and bare patches; scuff tape on the outboard elevon TE; C2 re-runs `CL-C2-WING-MASS` with four plugs (22 g) and the CAD core 187 g; C2 publishes the torsion corners, damping and station inertia as claims (CR-B3-21) and `CL-C2-WING-MODES-CLOSED` (CR-A2-22); D1 confirms the 1.1 mm foam under the tube groove with D6 |
| CR-A4-42, CR-A4-43, CR-A5-21, CR-E1-23, CR-E1-26…28, CR-E1-30…34 (own), CR-F2-07, CR-D7-16, CR-D3-22, CR-B4-20, CR-E2-17 | E1 | forward (D-48, D-51, D-58) | re-run `propulsion.py` (the stored input map still divides `r_ext` wrongly: CR-E2-17); carry `PRP-002` stripped (7.6 g) and the CAD centroids; call `k9.prop_keepout(..., rotate=rot, blade_half=0.010)`; acknowledge `E-HRN-13…20`, `-24…27`, `-34…37`, `E-TRN-17…20`, `E-FIN-81…88`; confirm base ≥ 28 mm, 16 × 19 mm pattern and hole depth ≥ 4.0 mm on the first motor; publish the ESC envelope for B4; retire `ASM-E1-PACK` once B4 moves (CR-E1-27); `CL-E1-IPACK-LIM` to A2 |
| CR-A4-42, CR-F1-16…18, 20…22 (own), CR-F2-02, CR-D6-06, CR-E2-19, CR-D2-13, CR-A2-20b | F1 | forward (D-48, D-56) | re-run `power.py` on the routed ESC lengths (0.512–0.650 m) and the 10 AWG main path; re-point the six rise claims at the two new keys and `ASM-F1-PROFILE` at E2's phase claims; servo stall 1.4 A (keep the UBEC); confirm the CoreWing power board separates from the stack (CR-F1-21) before the order; acknowledge the harness wires once F2 re-runs; C6 issues the `E-PWR-03` frame stack (CR-F1-20, CR-A4-44) |
| CR-A4-42, CR-A5-26, CR-D7-20, CR-F3-12, 14…20 (own), CR-A2-27, CR-C6-19, CR-F2-08, CR-B4-18, CR-D2-14, CR-H1-18 | F3 (F5) | forward (D-47, D-48) | acknowledge `E-TRN-21` and `E-HRN-22…32`; avionics 45 g; two 150 mm U.FL T-antennas (+0.5 g, ≈ $6, F5); confirm the CoreWing connector positions for F2; `R-COMPASS` ratio against the total field; GPS position for F4; FC strap retention (C6); B4's pitot numbers at the new tip (−0.210); F5 creates `subsystems/ground/interfaces.json` with `GND-001` (CR-A4-45, CR-A4-30) |
| CR-A4-42, CR-D6-02…12 (own), CR-D1-04, CR-C6-23, CR-D5-18, CR-A3-20 | D6 (C6) | forward (D-48) | 3/32 in inter-panel rod (−3.6 g); acknowledge `E-HRN-28/29` after F2; confirm the rod clears the lower half-fin slot through ±25° (OI-03) and the stopped root fillets with D3; bond areas 720 mm² at VD 27.2 (D-50); `parts.csv` with prices for I1; G3 print list |
| CR-A4-44, CR-C6-16…24 (own), CR-D2-12, CR-D3-17, CR-D5-12, CR-D5-24, CR-C4-23, CR-F1-20, CR-E1-33, CR-D6-11, CR-D7-10, CR-H1-12 | C6 | forward (D-58) | re-run `joints.py` on C4's R3 claims (collar max(C1, C4) + brace shear, strip tail 908 N per face, pins 64 N) and D3's R3 geometry; issue the `E-PWR-03` frame stack, the D5 bond block (1 350 mm², RF 1.54), the PA66 mast cross-bolt; withdraw `E-MEC-03/04` and `E-PWR-05` stacks; list the two deviations (D-58) in `JOINTS.md`; publish the strip-anchor design force as a claim for H1; handle stack confirmed |
| CR-A4-47, CR-C4-23…28 (own), CR-C1-21, CR-C1-24, CR-B1-18, CR-B4-19, CR-H1-10, CR-H1-17, CR-C6-20, CR-D3-18, CR-D5-14 | C4 (C1) | forward | re-run `fin_structures_d3.py` on D3-R3 (two layers, 10 × 2 brace, 16 or 12 mm collar, the D5 tip step) with μ 0.7 (29.1 N corner), B4's 0.57 N swirl at 7° (1.43 N misbuilt), the G3 set-down case 23.2 N on the lower mounts, the Campbell check at 5 416 / 5 894 rpm; fix the singular matrix / NaN (CR-C6-20); rename `FIN-001-LU/LD/RU/RD` → `FIN-001-UR/UL/LR/LL`; publish the collar torque as a claim C6 reads; brace section: fair with tape, not a new section, unless the 10 × 2 strip stiffness is unchanged; T-C4-FIN-PROOF on a test article at R3 loads |
| CR-A4-46, CR-A5-22, CR-D1-02, CR-D7-09…20 (own), CR-C1-22, CR-D7-14, CR-I1-18, CR-A2-18 | D7 (C1) | forward (D-53) | `also_contacts: ["WNG-003"]` on `E-TRN-06/07`; re-fit the nose pad and antenna tube B with the pod at −0.130 (envelope x 0.498, 15 mm longer); label "keep upright"; aft-wall case with the feet as the crush element (C1 confirms the axis names); landing mat TRN-104 (ply + rubber) replaces the EVA tile; two cars named for `CAR-FIT.md` (team lead, CR-A1-42 / CR-D7-11) |
| CR-A5-23, CR-A4-22…35 (R3 round, A4's own), CR-D1-09, CR-D2-17, CR-D6-10, CR-F2-06, CR-F3-18, CR-E1-28, CR-D7-18, CR-C6-20, CR-F4-17 | A4 (J2) | forward | document `also_contacts` in `SCHEMA.md`; count `acknowledges_pending` in `--compare`; merge D2's, D6's, F2's, F3's, E1's and D7's new ids and types (`CT-M3-PA66-NUT`, `CT-SERVO-EAR-SLOT`, `CT-CARD-SLOT`, `CT-PROP-ADAPTER`, `CT-PROP-NUT`, `CT-SOLDER-DC`); mark the four field joints; record the D-58 deviations in the plan (OI-14 closed); J2: guard `proofkit.fmt()` for NaN and inf (two scripts stop the whole build today) |
| CR-A5-19, CR-D3-21, CR-D5-13, CR-E1-29a, CR-E1-31, CR-F2-09 (done) | A5 | forward (D-51, D-55) | point `DATUMS.md` / `k09kit` at the promoted keys (DX-COLLAR, DX-ANCHOR, DX-FOOT, DP-MOTOR-FACE, DP-PROP at −0.0077); re-run `check.py` after D2, D5, F2 and E1 re-run; the as-built joints stay `UNVERIFIED-IN-FUSION` until BuildAll runs (CR-A5-08) |
| CR-E2-17, CR-E2-19…22 (own), CR-A3-24, CR-I1-13, CR-E1-25, CR-A1-31 | E2 (I1) | forward (D-49, D-58) | name the pack SKU (≤ 601 g, ≥ 10 AWG leads) or accept re-leading and 680 g; weigh the first pack; re-point `CL-E2-TW-SAG-WORST` at `CL-E1-TW-WORST`; re-run the budget if E1 and B1 reconcile at 240 W; test-day plan 58.5 of 180 min (I2) |
| CR-B4-16, CR-B4-17, CR-F4-16, CR-E2-21, CR-C1-20 | B1 | forward (D-49, D-50) | confirm level speed at 7 750 rpm (21.3 m/s) and FW climb at 70 % on the sagged pack; add B4's mount collars, ears and ESC pads (+0.0067 CD0) or state why not; state which drag terms the pessimistic case covers; re-run on sag 0.851 and sized 2.600 |
| CR-B4-13, CR-B4-16, CR-B4-18…21 (own), CR-E1-27, CR-A1-29 | B4 | forward (D-47, D-51, D-52) | re-run `props.py` at the pitot tip −0.210, prop plane −0.0077, the corrected sense; move to `ASM-E1-PACK-CELLS` + `P:electrical.r_ext_mohm`; T-B4-YAW with the fin on its own side-force cell (H1) |
| CR-A3-23, CR-B2-13, CR-C1-21…26 (own), CR-C6-21a, CR-D5-23, CR-D7-14, CR-H1-09, CR-H1-13, CR-H1-23 | C1 | forward (D-50) | re-run `loads.py` on the capped VH (`CL-F4-VLEVEL-VH`), A3-R5 mass and inertia, B2's c 0.32 inputs (CLmin 0.44, CLα 3.48), D5's per-type feet (39.6 / 59.4 N, η 0.903), the 7° side force in J-MOTOR / J-FINHALF; publish pad 4 of the whiffletree and the half-fin torsion as claims; agree one wing limit proof with C2 (GT-08 runs C1's tree); confirm the box axis names for D7 |
| CR-A3-23, CR-D5-21, CR-B3-19, CR-D6-09, CR-E2-20, CR-F4-13, CR-F4-14, CR-F3-20, CR-B4-16, CR-H1-18, CR-A2-14 | F4 (H2, H3) | forward (D-50, D-52, D-54) | `THR_MAX` 70, `Q_LAND_SPEED` 30, `BATT_LOW_MAH` 2 600, `RC_OPTIONS` 8480, pitch crossover ≤ 4.5 Hz (yaw ≤ 2.4) until the tap test, `SERVO5/6` limits per side from T-D6-THROW, `GPS1_POS` from F3's centre, raw-IMU logging ≥ 1 kHz, the `Q_M_BAT_CURR_MAX` claim; re-run `fsw_check.py` on split 1.214 and the R4 inertia; H3: pack station marks per weighed pack on the flight card, RC9 cut at contact, "never set down on the motors" (C1 G3); H2: 20 twin touchdowns, the cant-sense yaw test before the first hover |
| CR-A3-23, CR-A2-25, CR-B4-21, CR-C1-23, CR-C4-27, CR-D3-20, CR-D5-19, CR-D5-25, CR-H1-09…19 (own), CR-I1-21 | H1 | forward | re-run `ground_tests.py` (gate margin 0.151 kg, D5 coupon lines from `claims.json`); whiffletree from `data/whiffletree.json` with pad 4; optical-lever mount stiffness; FC raw IMU for the tap test above 80 Hz; T-B4-YAW with the fin cell; fin proof on a test article; strap eyes; Jacobs Hall's written yes for the borrow list before 20 Nov; T-H1-RESTRAINED-RUN, -PACK-PULL, -ARM-KILL ids to A2 |
| CR-A2-21…28 (own), CR-D6-07, CR-H1-19, CR-I1-22, CR-E1-26, CR-A4-13 | A2 | forward (D-56) | the three texts are in (R4 reserve: update the table); `R-SERVO-TORQUE` checked at the servo output through the linkage (D6); H1's three test ids; I1's two claims under `R-BUDGET` / `R-RESERVE`; `CL-E1-IPACK-LIM` under `R-ESC-CURRENT` (a); re-run `build_requirements.py` after the owners' re-runs |
| CR-A2-24a, CR-A4-34, CR-F3-07, CR-F3-14, CR-B4-20, CR-E2-17 | E3 | forward (D-56) | re-run `thermal.py` on `P:thermal.*`, B4's R3 hover/cruise shaft powers, the pod size, E2's tables and F3's 0.5 W at the FC / BEC losses on `PWR-003`; drop `verifies` on the PETG claims; give the `thermal` blocks for the ten thermal edges (owners copy them) |
| CR-A2-23, CR-C1-26, CR-H1-11, CR-H1-15, CR-A4-47 | J1 | forward | retire `CL-J1-TUBE-MODE-SEP`, the XT60 claims, `T-J1-TAP-TEST`, `T-J1-XT60-HEAT`, `ASM-J1-APC-KT`, `ASM-J1-MH45-CM0`; re-run `research_claims.py` on the R4 CG target 0.0522 and fin height 0.21; `GND-001` after F5 declares it |
| CR-A2-22, CR-A2-28, CR-B3-21, CR-D1-03, CR-H1-11, CR-H1-13 | B2 / C2 | forward | B2: `CL-B2-STALL-GATE-FWD` at 0.050 and the `ASM-A2-SERVO-TORQUE-FACTOR` alias; C2: as the D1 row |
| CR-D5-27, CR-D6-02, CR-D7-17, CR-C6-22, CR-F2-11, CR-I1-16…22 (own), CR-H1-16, CR-D5-20 | I1 (I2) | forward (D-57) | BOM at R4: Savox SH-0255MG+ ×3, 7/32 in brass tube, landing mat, tote, spares box, labels, fastener kit incl. PA66 and 2 × CF rod, harness and mechanisms lines once F2 / D6 price them; hold the pack cart until E2 answers CR-I1-13; G12 $17.00; I2: 2 sorties = 58.5 of 180 min |
| CR-D1-10, CR-D6-12, CR-E3-01 (G3 part), CR-I1-20 | G1, G2, G3 | forward | hot-wire bow ≥ 1.25 m with two S5010 templates, 22.4 mm slot cutter from below, 45° guide block, taped-sample weigh-in; print list (PETG 100 % for horns, ASA for mounts and pads, one 1 kg spool) |

## Revision A1-R4b (addendum, 2026-11-10)

| Id | Decision | From | Keys changed | Why (numbers) |
|---|---|---|---|---|
| **D-60** | **CG range [0.050, 0.0549] → [0.0509, 0.0548] m on B3's R4 limits** (0.05085 / 0.05490 rounded inward; B3's 0.0549 sat 2 µm aft of its own limit). B3's target 0.0529 was accepted but never written (`cg.x_target_m` stayed 0.0522); `CALC-A1-PACK-CASES` re-based on A3's live CG and `CL-A3-CG-X-PRED` (`ASM-A1-CG-GROWTH-DX` retired). Superseded by D-62 | CR-B3-22, CR-D6-19 | `cg.x_range_m` | D6's elevon effectiveness (0.973 at the stall) and half the 0.84° free play come out of the 12.5° trim budget, moving the forward limit 1.3 mm aft; `CALC-A1-CG-RANGE` had drifted negative (−0.85 mm) |

## Revision A1-R5 (simulation round)

Every analysis role re-ran its model on the settled CAD with the tools in `inputs/SIM-TOOLS.md` (SU2 RANS and FEA,
AVL, XFOIL, a 6-DOF touchdown model). Four requirements failed as designed and are fixed here: `R-STATIC-MARGIN`
(the CG sits 18.5 mm above the chord plane, which no earlier range allowed for), `R-PROP-CLEAR` (blade swept volume
21.1 mm from the motor tube), `R-LANDING-IMPACT` on a diagonal touchdown, and `R-STRUCT-MARGIN` at the wing's block
pocket corners and the pod's pack stops. `R-SPIRAL` (t2 3.5 s) goes to A2 with A1's position. `R-MASS-ALLOC` is
re-balanced (fins, pod, landing up; mechanisms down) with the reserve at 0 g free.

| Id | Decision | From | Keys changed | Why (numbers) |
|---|---|---|---|---|
| **D-61** | **Prop plane 5 mm forward: D3 sets `fin_detail.mount.face_ahead_m` 0.0025 → 0.0075 m; `propulsion.stations.x_prop_plane_m` −0.0077 → −0.0127, `x_plate_face_m` 0.0309 → 0.0244** (D3 publishes the exact values with `CL-D3-X-PROP`; A1 copies them). No tool exemption for the tube; the 5° cant stays the fallback after T-B4-YAW | CR-E1-44, CR-E1-48, CR-E1-49, CR-B4-23, CR-B4-25, CR-D3-26, CR-A5-30, CR-D1-11, CR-B4-22 | `propulsion.stations.x_prop_plane_m`, `x_plate_face_m` | with the corrected cant sense (D-52) the wing-side blade tip swings aft over the 22 mm CF tube: blade swept volume (E1 envelope +10 / −6 mm) to the tube 21.1 mm `FAIL` against 25 (`CL-E1-TIP-GAP-TUBE`, `CL-B4-GAP-TUBE-ENV`, `check.py` hull test 21.0 mm; three independent checks agree). The least `face_ahead` is 6.5 mm; 7.5 mm gives 26.1 mm at the tube (`CL-E1-TIP-GAP-AT-75`, `CL-B4-GAP-TUBE-FIX5`), 35.8 mm at the wing upper skin, 0 keep-out errors in `check.py`. Cost: mount cheeks +5 mm (C4 re-checks rocking stiffness against the new ≥ 1 100 N·m/rad pass level), the four stacks 5 mm forward (≈ −0.9 mm aircraft CG, counted in D-62), prop normal-force arm +8 % (B3 re-runs). D3's 0.020 m option buys 12.5 mm of cantilever for nothing; the wing is clear (B4 34.2 mm, E1 probe 34.1, D1 5.8 mm outside the keep-out: the R4 "≈ 23 mm" was a bounding-box artefact) |
| **D-62** | **CG range re-derived with the CG height: `cg.x_range_m` [0.0509, 0.0548] → [0.0466, 0.0514] m, `cg.x_target_m` 0.0522 → 0.0490; `cg.z_target_m` 0 → 0.0185 (A3's value), `cg.z_range_m` [−0.02, 0.03] → [0.010, 0.025]. The CG moves forward to the target by the pack bay: pod nose shell −0.130 → −0.140 (pod 0.235 × 0.14 × 0.07), the whole bay 10 mm forward (forward stop −0.1312, crush block ≥ 24.3 mm and spreader unchanged, aft stop 0.060 → 0.050), `pod.pack_x_nominal_m` −0.022 → −0.032; pitot tip −0.220; envelope x 0.508 m; D7's nose pad 3/4 → 1/2 in** | CR-B3-25, CR-B3-27, CR-B3-24, CR-B3-22 (superseded), CR-B3-29, CR-A3-27, CR-A3-29, CR-A3-25, CR-F4-19, CR-D7-23 | `cg.*`, `pod.x_le_m`, `pod.size_m`, `pod.pack_x_nominal_m`, `avionics.pitot_tip_xyz_m`, `transport.envelope_props_off_m`, `mass_budget.json#cg_x_m / cg_z_m` | B3's V1 run on the CAD fins and the A3-R6a roll-up: the take-off CG 18.5 mm above the chord plane moves the effective NP 3.4 mm forward at 1.3 Vs (AVL, hand formula within 0.4 %; `CL-B3-V-XNP-ENV` 0.0674 vs 0.0709 at z 0), so the SM-5 % aft limit is 0.0514 (`CL-B3-V-CG-AFT-ENV`) and the trim-at-stall forward limit 0.0466 (`CL-B3-V-CG-FWD`, width 4.85 mm ≥ 4). A3-R6a's 0.0522 is 0.77 mm aft (SM 4.76 %, `FAIL`), the predicted 0.0536 is 2.15 mm aft (SM 4.33 %). Every R0–R4 range was derived at z 0. Levers: 41 g of nose ballast (rejected: the reserve is 0 g), lowering the pod group (not buildable: the pack overhangs the LE), the whole pod (the saddle `POD-007` sits on the spar), nose ballast at the cap (10 g = 0.8 mm). The bay move is the D-47 lever again: −2.4 mm (0.237 mm per mm of pack and stack); with D-61's −0.9 mm the frame estimate is 0.0485 basic / 0.0498 predicted for the 550 g pack at −0.034 (14 mm spacer), margins +1.5 / +1.5 mm (`CALC-A1-PACK-CASES` on A3-R6a with `ASM-A1-A3-PACK-X`, `ASM-A1-STACK-DX`; A3 re-runs on D2's R6 bay). The 135 mm Ovonic pack (D-64) gains 2.5 mm of room at the crush stack (most forward centroid −0.0379, no-spacer station −0.020, 2 mm steps). Box: D7's nose gap 12.95 mm falls to 2.95 with a 3/4 in pad, 9.3 mm with 1/2 in (`CL-A1-BOX-FIT` on the real stack 17 mm; nose-first label-and-test drop allowance falls). CG height: each 10 mm costs 1.85 mm of aft limit and 0.27 s of spiral t2, so the top of `z_range_m` is held 6.5 mm above A3's value; the tip-over corner bound rises to 30.98° (`CL-A1-TIPOVER`). Per-pack stations come from A3's live roll-up only (CR-A3-27); the 503 g station dispute (CR-A3-29) is moot under D-64 |
| **D-63** | **Mass allocations 2 386 g: fins 418 → 437, pod 131 → 146, landing 43 → 48, mechanisms 80 → 72 (wing 405, propulsion 462, power 648, avionics 45, harness 123 unchanged); A1 reserve 245 → 214 g; growth allowance 145 → 114 g; sized = gate 2.600 kg. The D-48 "3/32 in rod" directive is withdrawn. C4's shoe-cheek extension (+16 g, CR-C4-30) is not allocated: T-C4-FIN-PROOF on the as-drawn article decides it (CR-C4-36)** | CR-D3-33, CR-D3-27 (superseded), CR-A3-26, CR-C4-34, CR-C6-31, CR-C6-32, CR-C3-19, CR-D6-13, CR-C5-18, CR-C4-36 | `mass.allocation_g.*`, `mass.growth_reserve_g`, `requirements.growth_allowance_kg`, `mass_budget.json` | fins: the 15 mm root fillets C6 asked for (CR-C6-24) weigh 30.6 g drawn as bodies, not the 3 g D-48 booked (D3 434.8 g; A3 436.4; C4 says no structural item can go: each of brace, strips, second layer drops the separation to ≤ 0.09); C6's pins Ø 2 → 2.5 mm (+1.5 g, pin RF 0.82 → 1.59 at C4's 72.7 N) and collar 12 → 13 mm (+0.6 g, RF 1.00 → 1.09 on C1's 7.4 N·m torsion) are structural. Pod: C3's 3-D FEA shows the 3 mm aft stop peeling the board under the tray at 408 kPa vs 50 (`CL-C3-FEA-AFT-*` `FAIL`), the forward-stop bed at 391 kPa, and the spar-clamped shell sending its shear to the recess step (bond R 1.40): strut to the handle bridge (+3.7 g), floor flange (+1.5), wall brackets at the handle feet (+8.7 g `EST`, R 1.40 → 0.56) = +13.9 g, plus 2 g for the D-62 nose. Landing: C5's SU2 FEA of the shoe sleeve end gives RF 0.22 at the simulated 59 N ultimate side load (0.38 at D5's basis); the fix (wall 2.0, rim 3.0, R 1 mm fillet, 25 mm engagement) is +5 g `EST`. Mechanisms: D6-R2 70.7 g with a 1/8 in pultruded CF rod (−6.6 g, 7.9 % loss, better than the 3/32 in steel fallback at 9.1 %). Reserve 214 g = A3's growth by maturity 114 g (A3-R6a) + the 100 g overrun: 0 g free; D3 returns what its levers give (fillet filler −5.6, block fill −13.8, cheeks −4), harness −12 g if the phase leads reach. Real mass added by R5 ≈ 21 g (`ASM-A1-R5-ADDED-G`), so the predicted take-off mass is ≈ 2 458 g with the 550 g pack |
| **D-64** | **Pack SKU: Ovonic 4S 6500 mAh 120C hard case, EC5, 551 ± 5 g, 135 × 46 × 49 mm (`battery.pack`, `size_m`; `mass_kg` stays 0.55). I1 releases the pack cart after E2's two order-time checks (10 AWG leads confirmed; EC5 / 4S / 6500 / hard case / 2 packs). The held 130C XT60 SKU (680 g, 12 AWG) is not bought; re-leading is rejected. Pack acceptance line 631 → `CL-A1-PACK-ACCEPT` (592.6 g today, "590 g"): E2's `PACK_ACCEPT_KG` and the T-E2-WEIGH pass line follow it. The 503 / 680 g bounding listings of D-58/D-59 are retired as flight cases: the CG and gate checks run on 546 / 550 / 590 g (`ASM-A1-PACK-CASES-G`; A3 updates `ASM-A3-PACK-RANGE`)** | CR-E2-24, CR-E2-25, CR-E2-26, CR-A3-24, CR-A3-29, CR-E2-15 | `battery.pack`, `battery.size_m`, `battery.mass_kg` note | D-58 asked E2 for a SKU ≤ 601 g with ≥ 10 AWG leads: named (`CL-E2-SKU-MASS-MARGIN` +45 g, `CL-E2-SKU-BAY-CLEAR` 1 mm). The acceptance line = carried 550 + A3's gate margin 164 − overrun 100 − R5 additions 21 g (`CALC-A1-PACK-ACCEPT`); the SKU maximum 556 g sits 37 g under it. The Tattu 4S 6750 (605 ± 10 g) fallback is above the line and is not pre-approved |
| **D-65** | **Landing: `requirements.landing_sink_ms` 1.5 → 1.2 m/s at ≤ 10° of combined tilt in any direction (F4 holds `Q_PILOT_SPD_DN` ≤ 1.2 m/s, `Q_LAND_FINAL_SPD` 0.3, `Q_LAND_SPEED` ≤ 0.5); `landing_n_design` 6.0 → 6.6; the design foot side load is C5's simulated 39.3 N limit / 59.0 N ultimate (`CL-C5-SIM3D-SIDE-LOAD`, `-SIDE-ULT`) in D5, C4/D3 and C1; D5 redesigns the shoe sleeve end to RF ≥ 1 at 59 N (wall 2.0, rim 3.0, R 1.0 inside fillet, 25 mm engagement). C1's 1.5 m/s level and pitch-pair cases (L1, L4) stay the structural bounds. A2 re-words `R-LANDING-IMPACT`** | CR-C5-17 (a), CR-C5-19, CR-C5-16, CR-C5-18, CR-C1-34, CR-F4-18, CR-C5-15 | `requirements.landing_sink_ms`, `landing_n_design` | C5's 6-DOF touchdown with four crushing feet and μ 0.7: a diagonal touchdown lands on one foot, which takes the energy alone; at 1.5 m/s a 5.0° tilt already bottoms the 35 mm usable stroke (`CL-C5-SIM3D-STROKE` 38.6 mm, `-BOTTOM-TILT` 5.0° `FAIL`), where n is 11–15 and the pack takes the shock. 1.2 m/s at 10° any direction needs 34.5 mm at 2.6 kg. The alternative (+19 mm foot, 54 mm stroke) moves the stance, wingtip clearance and box height for a case the flight controller never commands (final 0.3 m/s; pilot down-stick 1.2 m/s is the real hard-landing case). The same crush force gives n 6.59 at the as-designed 2.32 kg (`CL-C5-SIM3D-N`); the plateau is not lowered (longer stroke), so the airframe is checked at 6.6 (C1 L4-driven loads ≈ +10 %; C4's fin face MS is the tight one). The pads scrub while the aircraft rotates over the first foot: side load 39.3 N, 1.72 × the hand value (steady over 4 time steps, pad stiffness × 0.5–2) |
| **D-66** | **Spiral mode (A1's position for A2's `R-SPIRAL`, CR-B3-26): option (b). Keep the CG height; amend `R-SPIRAL` to t2 ≥ 3.3 s with wing-borne flight only in roll-stabilised modes (FBWA / AUTO / QSTABILIZE…), no MANUAL / ACRO above 5 m; F4 sets `FLTMODE*` accordingly. A2 decides and words it** | CR-B3-26 | — (A2's `params/claims.json` text) | CG 18.5 mm above the fin side-force centre gives Cl_β +0.023 and t2 3.51 s (`CL-B3-V-LAT-T2`, limit 4; 4.01 at z 0). Lowering the CG is not buildable (D-62); 3.5 s is MIL-F-8785C Level 3 for a hand-flown aircraft, but D-50 already removed every raw-stick fixed-wing mode (no airspeed-dependent surface limit on the F405), so the autopilot's roll loop holds the bank. Dutch roll 0.28 and short period 0.48 stay above their floors |
| **D-67** | **Performance and thermal keys from the simulation round: `electrical.r_ext_mohm` 6.5 → 6.7; `performance.cruise_after_hover_min` 12.7 → 12.0, `_pess_min` 6.8 → 6.4 (E2's 240 W case); `cruise_power_w` 240 stands (B1 as designed 238.9 W at the gate, 1 W under E1; pessimistic 312.4 W: E2 re-runs); `ld_cruise` 6.2 stands until E1 re-runs on `CL-B1V-CD0` / `-K` (B1 5.57 at 2.436 kg); `env.ambient_ceiling_c` 43 → 44; `thermal.*` notes 56.1 / 44.8 / 54.9 °C; `download_factor` note 1.025 (kept 1.06); `THR_MAX` 70 % stands (VH 21.0 m/s, 1.25 VH 26.3 ≤ 27.2)** | CR-F1-24 (rev), CR-E2-23 (a, b, c), CR-B1-20, CR-B1-21, CR-B1-22, CR-E3-16, CR-B4-28, CR-B4-24, CR-B4-27 | `electrical.r_ext_mohm`, `performance.cruise_after_hover_min`, `cruise_after_hover_pess_min`, `env.ambient_ceiling_c`, four notes | F1's R_ext on F2's trimmed leads (0.475–0.620 m): 6.69 mΩ (`CL-F1-R-EXT`); E1 re-runs `CALC-E1-WORST` (sag 0.851 moves slightly), E2 / E3 / H1 read the key. B1's SU2 fin sections put the fins and tubes at 1.23 × the hand drag (CD0 0.0515 → 0.0579, `CL-B1V-CD0`), offset by the lighter A3 mass: 235 W at 2.436 kg, 16.2 min cruise. E2's budget at the carried 240 W: 12.0 / 6.4 min (`CL-E2-CRUISE-MIN-BASE-240`, `-PESS-240`), cruise to `BATT_LOW` 6.1 min ≥ 5; the pessimistic basis rises 300.6 → 312.4 W (E2 re-runs, expect ≈ 6.2). E3's SU2 ESC-pad heat transfer (h 64.6 W/m² K, f 1.13) lowers the ESC peak 61.6 → 56.1 °C and raises the ceiling to 44.2 (`CL-E3-CEIL-MISSION`); `pack_takeoff_max_c` 34 and `full_throttle_max_s` 10 stay. B4's CFD tube + board section: download 1.025 (`CL-B4-SIM-DOWNLOAD`); B1's finA L3 extrapolation withdrawn (B4's 3-grid Cd 0.574 vs B1 build-up 0.577). The gate stays the hard stall limit: Vs 11.99 m/s at 2.6 kg (`CL-B1V-VS-GATE`, +0.1 %) |
| **D-68** | **Wing structure fixes from C2's 3-D FEA: D3 rounds the through-core block's four vertical edges R 3 mm; D1 cuts the pocket to match and lays a microballoon fillet bead ≥ 3 mm along the inboard and outboard pocket edges on both surfaces (60 mm doubler kept continuous over the edges); D1 radiuses the elevon cut-out corners at the fin-root tab (y ±0.30 / ±0.34) R ≥ 3 mm with the tab's tape carried round; the LE stays seam-free 32 mm each side (one continuous strip, seams aft of x/c 0.10, hot-wired LE sanded; block-pocket doublers exempt); the fin root fillet is credited fail-safe only (C4 sends C2 the fillet-intact load share for L4 and G2; C6 keeps the fillet RF on the joint side). Wing allocation 405 g unchanged (the beads sit inside the 18 g cushion); C2 re-runs the FEA on the revised pocket** | CR-C2-11, CR-C2-12, CR-C2-13, CR-B2-17, CR-C1-28, CR-C1-27 | — (D1 / D3 local params) | mesh-converged foam peaks (GCI 0.02 %) at the pocket's inboard-front-lower corner 203 kPa vs 150 (MS −0.26) and compression 199 vs 120 (MS −0.40) in the L4 corner + side landing at ultimate (`CL-C2-FEA-FOAM-CORNER-S1`, `-S3`); bulk foam MS ≥ +1.8. If the root fillet carried the station loads along the chord, the tab between the elevons would see 222 kPa shear vs 100 (`CL-C2-FEA-FOAM-FILLET-SENS`). A turbulent LE costs 13 % of section clmax = +7 % stall speed (12.84 m/s, `CL-B2R3-VS-GATE-FWD-TURB`), which fails `R-STALL` at zero mass and cost. One wing limit proof (`T-C1-WING-PROOF`, GT-08 step 1 + 2) replaces C2's 25 N pair; C2 reads `CL-C1-VD-ENV` 27.2 |
| **D-69** | **Pod structure fixes from C3's FEA (D2 implements, +13.9 g in D-63): aft stop backed by three PETG ribs 3 × 14 × 14 mm to the handle-foot bridge (x 0.063 → 0.077) ending in a 40 × 14 × 2 mm pad; forward stop carried through a 3 × 54 mm floor slot to a 12 mm PETG flange under the floor; handle feet tied to the pod side walls by one bracket per side with ≥ 1 000 mm² epoxied to the wall; a 5 mm microballoon fillet in the recess-step corner (D1, before the pod goes in); `CL-D2-AFT-STOP-BOND` retired as the aft-stop check; `T-C3-STOP-PUSH` on tray pieces bonded to board offcuts, `T-C3-POD-PROOF` + 200 N on the brackets** | CR-C3-14, CR-C3-15, CR-C3-16, CR-C3-17, CR-C3-18, CR-C3-20, CR-C3-11, CR-C3-13, CR-C6-27, CR-C5-07 | — (D2 local) | as drawn the 3 mm aft stop is a cantilever on the 1 mm tray whose 1.4 N·m root moment peels the board at 408 kPa vs 50 (`CL-C3-FEA-AFT-*` `FAIL`; tray 48 vs 25 MPa); with the strut 1.1 kPa / 0.03 MPa, ribs Euler 8 565 N. The forward-stop bed peels at 391 kPa (`CL-C3-FEA-FWD-BED-PEEL`). Bare XPS clamped only at the spar sends the pod's shear to the recess aft step (design R 1.40, hand 0.87); feet tied: 0.56, crash +z 0.95, +x 0.23. The recess-step corner is singular in linear FEA: the fillet and the proof pulls decide. The hand aft-stop check (`CL-C3-AFT-STOP-D2`) also fails at 16.6 vs 15 MPa on the pad-top lever. These replace D2's lighter levers; the 131 g pod cannot shed the strut |
| **D-70** | **Fin joints and vibration: edge-strip pins Ø 2 → 2.5 mm pultruded CF at the drawn 15 mm pitch (Ø 2 at 9 mm if 2.5 cannot be bought); station collar 12 → 13 mm (12 only if `T-C6-LAP-PETG` ≥ 4.1 MPa mean before the collars print); the strip-tail bond in the collar tail is a build inspection item (strips to the tube surface, epoxy fills both slots over the full 40 mm, tongue with 3 perimeters under each strip, tap/pull check before the fin closes); `T-C4-MOUNT-STIFF` pass level ≥ 1 100 N·m/rad; `R-VIBRATION` on the fin station passes at 0.29 (3-D, lower station 255.5 Hz vs 2P cruise 198.2 Hz) with re-run triggers: cruise rpm > 6 390 or station mass > +15 %; C4's shoe-cheek extension (CR-C4-30) held by `T-C4-FIN-PROOF` on the as-drawn article (legs 7 mm, 8 mm cheeks over both strip ends) with two strain gauges and a dial gauge; `T-C6-STRIP-ANCHOR` frame ≥ 1 560 N** | CR-C6-31, CR-C6-32, CR-C6-33, CR-C6-34, CR-C6-35, CR-C4-36, CR-C4-37, CR-C4-38, CR-C4-39, CR-C4-41, CR-C4-30 (held), CR-C4-32, CR-C4-35, CR-C2-15, CR-D6-18 | — (D3 local `edge_strip.pin_d_m`, `station_collar.height_m`) | C4's FE pin force has read 64 / 92 / 72.7 N in three runs; a 2 mm pin bends past 400 MPa at every one (`CL-C6-STRIP-PIN-RF` 0.82), a 2.5 mm pin has 1.95 × the capacity (`-RF-PROP` 1.59). C1's section torsion 7.39–7.42 N·m puts the 12 mm collar at RF 0.9998–1.003 on an unverified bond allowable. The 3-D solid FE does not reproduce the R4 shell `FAIL` at the tip (face MS +0.11 bound vs −0.54): the strip pair clamped in the cheeks carries 53 % of the side-load moment, so the 16 g extension is decided by test. With the tongue unbonded the LE tail corner reaches MS −0.17; bonded (≥ 0.2 GPa) +0.43. Separation 0.37 → 0.29 with cruise rpm +52 and motor +3.2 g; rocking stiffness needed 1 030 N·m/rad (estimate 3 000). C6 sizes on the frozen `CL-C4-D3-*` R4 set (1 248 N strip end, 72.7 N pin, 6.26 N·m collar): C4 freezes it and updates its text (CR-C6-34) |
| **D-71** | **`R-STALL` and `R-TRANSITION` are judged at the 2.6 kg gate and closed by test: `T-B2-STALL` (slow-flight stall at the gate mass and the forward CG, airspeed logged, three runs) is a gate on the twin and on the first build, before the December order and before `ARSPD_FBW_MIN` is frozen; F4 sets `ARSPD_FBW_MIN` = 1.3 × the measured trimmed stall, rounded up (15.6 from analysis until then); if the measured stall is > 12.3 m/s, cruise rises. B2 re-runs the forward-CG stall at the D-62 forward limit (0.0466) with the CG height (B3's `CL-B3-V-VT` 15.52 gives 11.94 m/s there); B1, B2 and B3 reconcile the trimmed CLmax (B1 AVL + XFOIL 0.862 vs B2 0.787 at SM 0.063) and the props-off NP (0.0708 vs 0.0738 m): A1 carries the lower CLmax. The forward limit is not moved further forward (each 1 mm costs ≈ +0.013 m/s)** | CR-B2-16 (a, b, c), CR-B1-22, CR-B1-23, CR-B3-28, CR-B2-19, CR-B2-18 | `performance.stall_ms` note (unchanged 11.9) | both requirements pass by 0.1 % at the forward CG (`CL-B2R3-VS-GATE-FWD` 11.99, `CL-B2R3-VTR-GATE-FWD` 15.58 vs 15.6), inside the clmax uncertainty (XFOIL panel spread 1.7 %; SU2 clmax GCI 71 %, not usable). B1: Vs reaches 12.0 m/s at 2.605 kg. A 9 % CLmax difference between two VLM models is the whole margin, and a 3 mm NP difference is 0.9 % SM. Servo: `R-SERVO-TORQUE` through D6's linkage needs 3.49 kgf·cm vs 3.9 at 6 V (+11 %); at 4.8 V (3.1) it fails by 13 %, so the UBEC 6 V servo rail stands (F1) |
| **D-72** | **Budget: the two 150 mm U.FL T-antennas (≈ $6, F5 CR-F5-11 / F3 CR-F3-15) are released against I1's first lever (borrow the soldering kit from Jacobs Hall, +$94.82); until H1 has Jacobs Hall's written yes (before 20 Nov) `CL-A1-RESERVE` reads $313 − $6 = $307, $2 under the $309 crash: I1 re-prices the BOM and A1 copies the cost keys** | CR-F5-12, CR-D6-16, CR-D5-27, CR-C6-35, CR-D7-17, CR-B4-11 | `cost.*` (I1 re-publishes) | the stock RP3 antennas (65 mm) do not reach past the carbon-free zone of the hatch and nose tubes (RX → tube ends 80 / 60 + 12 mm); D-57's reserve is $3.99 over the crash. BOM lines also changed by the designers: 1/8 in pultruded CF rod (D6), 7/32 in brass tube (D5), Ø 2.5 mm CF rod × 2 (C6), landing mat / tote / spares box / labels (D7), optional 11×5.5E/EP pair for the stand A/B (B4) |
| **D-73** | **Tooling notes for `inputs/SIM-TOOLS.md` (orchestrator) and A4's checker: SU2 8.5 `LINEAR_SOLVER_PREC= ILU` diverges on thin-walled tube meshes yet exits "Success" (use `LU_SGS` or check `LINSOL_RESIDUAL` in every elasticity log); the installed SU2 has no PaStiX direct solver and its CG/ILU and FGMRES/ILU do not converge on laminated foam-board solids (C4's hex8 code + SciPy SuperLU, benchmarked against SU2 to 4.7 × 10⁻¹¹, is the structures fallback). `merge_check.check_budget` / `check.py graph:mass` compare at 0.05 g (CR-A1-59 stands: "462 g > 462 g" is float dust)** | CR-C2-14, CR-C4-40, CR-E1-40, CR-E1-47, CR-A1-55 | — | two SU2 pitfalls found by C2 and C4 and C5's successful SU2 shoe FEA (GCI 0.35 %) define the FEA practice for the remaining structures runs |

Notes carried without a decision number: `fins.stations.collar_end_xyz_m` note fixed to the 12 mm ring (CR-D3-32);
`pod.pack_x_nominal_m` note now points at A3's live stations (CR-A3-27); `pod.pack_aft_travel_m` note gives the D-62
aft stop 0.050; the `CL-A1-HOVER-TW-SAG` how-line cites `CL-E1-SAG-FACTOR` (CR-E2-23a); `CALC-A1-BOX` reads D7's real
wall stack (`ASM-A1-WALL` 12.5 mm per side along the chord, was 25).

### Change-request dispositions, revision A1-R5

Same rules (`accept` / `forward` with A1's position / `reject` / `closed` / `superseded`). Rows from the integration-fix
deliveries of 2026-11-10 (A3-25…30, A5-29…31, C1-27…34, C6-31…35, D1-01/07/11, D3-25…33, D5-28…30, D6-13…19, D7-21…25,
E1-35…50, E2-23…27, F1-23…30, F2-12…18, F3-22/23, F4-18…20, F5-11…14) are included with the simulation-round rows.

#### To A1

| CR | From | Decision | Reason |
|---|---|---|---|
| CR-A3-25 | A3 | forward to D2 (D-62) | the aft stop is now 0.050 in the D-62 bay; D2 draws the 135 mm pack on the stack (−0.0379) and the play |
| CR-A3-26 | A3 | accept (D-63) | fins 437 g; D3 returns what its levers give |
| CR-A3-27 | A3 | accept (D-62) | the `pack_x_nominal_m` note points at `CL-A3-CG-X-STATIONS` / `rollup.json`; H3 writes the card from the re-run |
| CR-A3-28, CR-A3-30 | A3 | closed | A1 re-ran on A3-R6a (`CALC-A1-PACK-CASES`, `ASM-A1-CG-GROWTH-DX` retired at R4b); the others are in the forward table |
| CR-A3-29 | A3 | closed by D-64 | the 503 g listing is no longer a flight case; both rules agree on the 546–590 g packs |
| CR-A5-29 | A5 | closed | done by C3-R2.1 (`stop_wall_h_m` re-pointed, all ten `CALC-C3-*` run) |
| CR-A5-30 | A5 | accept (D-61) | `face_ahead_m` 0.0075; no exemption |
| CR-A5-31 | A5 | forward to A2 | `CL-A5-ASSY-CG-X` (aft), `-FWD`, `-RANGE-USE` under `R-CG-RANGE` beside `CL-A3-CG-X-RANGE`; `CL-A5-LAYOUT-CG-X` withdrawn |
| CR-B1-20 | B1 | accept in part (D-67) | 240 W stands (B1 238.9 at the gate); E2 re-runs the pessimistic budget on 312.4 W; E1 re-runs on `CL-B1V-CD0` / `-K` |
| CR-B1-21 | B1 | accept (D-67, D-50) | `THR_MAX` 70 % is a loads limit; C1's `CL-F4-VLEVEL-VH` ≤ 21.76 m/s is the flight-test gate (CR-C1-32) |
| CR-B1-22 | B1 | accept (D-71) | the gate is the hard stall limit; `R-STALL` judged at 2.6 kg |
| CR-B2-16 | B2 | accept (a, b); (c) keep the gate mass, test-closed (D-71) | — |
| CR-B3-22 | B3 | superseded (D-60 → D-62) | the z-aware V1 range replaces the R4 range |
| CR-B3-25 | B3 | **accept (D-62)** | range [0.0466, 0.0514], target 0.0490; the bay moves 10 mm, not ballast |
| CR-B3-26 | B3 | forward to A2 with A1's position (D-66): option (b) | lowering the CG is not buildable; D-50 already bars raw-stick modes |
| CR-B3-27 | B3 | accept (D-62) | `cg.z_target_m` 0.0185, `z_range_m` [0.010, 0.025] |
| CR-B4-22 | B4 | forward to A2 / A5 | list `CL-B4-TIP-WING`, `-LOWER` under `R-PROP-CLEAR`; the wing hits were box artefacts (A5's hull test cleared them, CR-E1-45) |
| CR-B4-23, CR-B4-25 | B4 | accept (D-61) | `face_ahead_m` 0.0075 (E1's option), not the 5° cant |
| CR-B4-28 | B4 | accept (D-67) | `download_factor` note; 1.06 kept |
| CR-C2-10 | C2 | closed | spar stays 22 × 20 (D-43) |
| CR-C2-14 | C2 | accept as a tooling note (D-73) | orchestrator adds it to `inputs/SIM-TOOLS.md` |
| CR-C3-19 | C3 | accept (D-63) | pod 146 g (incl. the D-62 nose) |
| CR-C4-34, CR-C4-28 | C4 | accept (D-63) | fins 437 g |
| CR-C4-39 | C4 | accept (D-70) | separation 0.29 ≥ 0.20 with re-run triggers; A2 records them under `R-VIBRATION` |
| CR-C4-40 | C4 | accept as a tooling note (D-73) | — |
| CR-C5-17 | C5 | accept (a) (D-65) | `landing_sink_ms` 1.2 at ≤ 10° any direction; A2 re-words |
| CR-C5-19 | C5 | accept (D-65) | `landing_n_design` 6.6 |
| CR-D1-08 | D1 | closed | wing 405 kept (D-48, D-63) |
| CR-D3-26 | D3 | accept option (a) at 0.0075, not 0.020 (D-61) | `x_plate_face_m` 0.0244; D3 publishes the exact `CL-D3-X-PROP` |
| CR-D3-27 | D3 | superseded by CR-D3-33 | — |
| CR-D3-32 | D3 | accept | `collar_end_xyz_m` note fixed |
| CR-D3-33 | D3 | accept (D-63) | 437 g incl. C6's pins and collar; levers (a)–(c) returned to the reserve when they land |
| CR-D6-13 | D6 | accept (D-63) | mechanisms 72 g, 8 g back, the 3/32 in directive withdrawn |
| CR-D6-19 | D6 | closed | A1 re-ran (R4b, R5) |
| CR-D7-25 | D7 | closed | `transport_box_kg` 3.57 stands |
| CR-E1-40, CR-E1-47 | E1 | closed (D-73) | float tie; A4 applies CR-A1-59 |
| CR-E1-43 | E1 | closed | `CL-E1-TW-WORST` 2.12 / sag 0.851 are what `CL-A1-HOVER-TW-SAG` reads |
| CR-E1-44, CR-E1-48 | E1 | **accept (D-61)** | tube gap 26.1 mm; the four stacks 5 mm forward |
| CR-E2-23 | E2 | accept (a, b as 12.0 under c) (D-67) | the how-line cites `CL-E1-SAG-FACTOR`; 12.0 / 6.4 carried (240 W case) |
| CR-E2-25 | E2 | accept (D-64) | pack, size, mass note |
| CR-E3-16 | E3 | accept (D-67) | ceiling 44; notes 56.1 / 44.8 / 54.9 |
| CR-F1-24 (rev) | F1 | accept (D-67) | 6.7 mΩ |
| CR-F3-21 | F3 | closed (R4) | — |
| CR-F4-15, CR-F4-12 | F4 | closed (D-50) | — |
| CR-F5-12 | F5 | accept (D-72) | $6 against I1's first lever; the reserve reads $307 until Jacobs Hall's written yes |

#### Forwarded (A1's position; the named role acts)

| CR | To | Decision | Reason |
|---|---|---|---|
| CR-B3-25, CR-A3-25, CR-C3-14…18, CR-C5-14, CR-E2-26, CR-D7-23, CR-F3-12, CR-C6-27, CR-E3-15, CR-F1-26, CR-A1-62 | **D2** (C3, C5) | forward (D-62, D-69) | re-lay the bay 10 mm forward with the nose at −0.140 (forward stop −0.1312, datum −0.032, aft stop 0.050, 135 × 46 × 49 mm pack on the stack at −0.0379, 2 mm spacer steps to −0.020); the three C3 fixes and the recess-corner fillet; antenna tube B ≥ −0.150; PDB bosses Ø 7.2 mm and the unplug-moment path; E3's 44.8 / 54.9 °C blocks; F3's tie posts / plate / strap slots / pitot key; 10 mm left-channel clearance ahead of the deck; publish `subsystems/pod/` at R6 against 146 g |
| CR-E1-44, CR-D3-26, CR-C2-11, CR-C6-31, CR-C6-32, CR-C4-37, CR-E3-13, CR-F2-16, CR-D3-28, CR-D5-30, CR-A1-63 | **D3** (C4, C6) | forward (D-61, D-63, D-68, D-70) | `face_ahead_m` 0.0075 (publish `CL-D3-X-PROP`, A1 copies it), block vertical edges R 3 mm, pins Ø 2.5 at 15 mm, collar 13 mm, strip-tail inspection in `BUILD.md`, E3's 56.1 °C blocks on `E-FIN-85…88`, F2's tie lug at x 0.060 opening along x, `E-FIN-81…88` with E1; re-run `make_fins.py` against 437 g and report the levers. C4: re-run `fin_structures_d3.py` / `sim_fin.py` on the 7.5 mm mount (cheeks +5 mm, ≥ 1 100 N·m/rad), the 39.3 / 59.0 N side load and n 6.6; freeze one `CL-C4-D3-*` set and update CR-C4-23 / `BOOM-STRUCTURES.md` (CR-C6-34a); publish the coincident strip force (CR-C6-29 / -34b); send C2 the fillet-intact share (CR-C2-12); `CL-C4-D3-BLOCK-MS` with the R 3 mm edges. C6: re-run `joints.py` on the frozen set, the 13 mm collar and 2.5 mm pins; D5's R5 bond (85.7 N, RF 1.57) |
| CR-A3-25, CR-A3-27, CR-A3-29, CR-B3-24, CR-F4-19, CR-C1-33, CR-D5-29, CR-E1-47, CR-E2-15, CR-A1-64 | **A3** | forward (D-62, D-63, D-64) | re-run `mass_rollup.py` on D2's R6 bay, D3's R5 fins, D5's R5 shoe and E1's D-61 centroids, the D-63 allocations and the D-64 pack cases (546 / 551 / acceptance; retire 503 / 680 in `ASM-A3-PACK-RANGE`); publish `CL-A3-CG-Z` (basic and predicted, m) and the per-group centroids and own inertia for C1; publish the pack acceptance from `CL-A3-GATE-MARGIN`; then tell A1 to retire `ASM-A1-A3-PACK-X`, `ASM-A1-STACK-DX`, `ASM-A1-R5-ADDED-G`; regenerate the `MASS-CG.md` block |
| CR-B3-25…29, CR-B4-24a, CR-B4-26, CR-C2-03, CR-D6-15, CR-B1-23 | **B3** | forward (D-62, D-61) | re-run `sc_analysis.py` / `verify_asdesigned.py` on `cg.z_target_m` 0.0185, the D-62 range and target, the prop plane −0.0127 (prop normal-force arm, B4's H-force 0.43–0.88 N per prop in the pitch-over as a hub term), B4's yaw 1.785 / 1.392, D6's 0.92 / 0.079 / 0.071, C2's 11.9 / 24.1 Hz; publish the V1 ids as the ids of record and retire the z 0 `CL-B3-CG-FWD/-AFT/-CENTRED-AFT`; reconcile CLmax and NP with B1 / B2 (CR-B1-23) |
| CR-B4-22, CR-B4-23, CR-B4-25, CR-E1-46, CR-E1-50, CR-B3-20 | **B4** | forward (D-61, D-62) | re-run `props.py` and `sim/sim_claims.py` at `x_prop_plane_m` −0.0127, pitot tip −0.220 (expect ≤ 1.8 %), the corrected sense; retire `CL-B4-GAP-TUBE` (mid-plane) for `CL-B4-GAP-TUBE-ENV`; move to `ASM-E1-PACK-CELLS` + `P:electrical.r_ext_mohm` (CR-E1-46b); T-B4-YAW with the fin cell (H1); 5° only if the measured factor ≥ 0.92 |
| CR-B1-20, CR-B1-23, CR-B4-27, CR-B4-24b, CR-C1-32, CR-F4-16, CR-E2-21 | **B1** | forward (D-67, D-71) | drop the finA L3 extrapolation or converge it; reconcile CLmax / NP with B2 and B3; state the pessimistic drag terms for E2; re-run `sim_verify.py` on the D-62 CG (0.0490) and the D-61 prop plane; confirm level speed 21.0 at 7 750 rpm stays ≤ 21.76 |
| CR-B2-16, CR-B2-17, CR-B2-18, CR-B2-19, CR-B3-28, CR-B1-23, CR-C1-28 | **B2** (D1, C2) | forward (D-68, D-71) | re-run the forward-CG stall at 0.0466 with the CG height; reconcile CLmax with B1 / B3; D1 applies the LE finish rule; C2 reads `CL-C1-VD-ENV` 27.2 and the R4 loads (CR-C1-28), re-runs the FEA on the R 3 mm pocket and the elevon cut-out radii, publishes the torsion corners and damping as claims (CR-B3-21) |
| CR-C2-11, CR-C2-13, CR-B2-17, CR-F2-14, CR-D5-28, CR-D1-04, CR-D6-14, CR-C3-17 | **D1** (C2) | forward (D-68, D-69) | pocket fillet beads ≥ 3 mm on both surfaces, R 3 mm pocket corners to D3's rounded block, R ≥ 3 mm elevon cut-out corners with tape round the edge, seam-free LE 32 mm each side, F2's 18 × 10 × 5 mm JR recess at x 0.150–0.168, D6-R2's groove and patch sizes, the 5 mm recess-step fillet before the pod goes in; `E-GER-21/22` and `E-HRN-02/04` are acknowledged (closed) |
| CR-C5-16, CR-C5-18, CR-C5-15, CR-C1-34, CR-C4-36, CR-D5-30, CR-A1-65 | **D5** (C5) | forward (D-63, D-65, D-70) | shoe sleeve end to RF ≥ 1 at 59.0 N ultimate (wall 2.0, rim 3.0, R 1.0 inside fillet, 25 mm engagement, inside corners ≥ R 1.0, layers along the sleeve axis), report the mass against 48 g; size the cartridge and fitting to C1's 40.38 N limit / 60.56 N ultimate upper-foot bound; keep the drawn cheeks (legs 7 mm) for the proof article; re-run `feet_calc.py`. C5: re-run the shoe FEA on the new stack, the 6-DOF sim at 1.2 m/s / 10° any direction and n 6.6, `CALC-C5-CRASH` per D-64 pack on the D-62 bay, tip-over at the 0.0466 forward limit and z 0.025 (A1 corner bound 30.98°); mat μ option (≤ 0.5 cuts the side load to 29.1 N) |
| CR-C5-19, CR-C5-16, CR-C1-29, CR-C1-30, CR-C1-31, CR-C1-33, CR-B2-18, CR-C4-29, CR-D7-24 | **C1** (C4, C5, C6, H1, D7) | forward (D-65) | re-run `loads.py` at n 6.6, the 39.3 / 59.0 N side load, A3's R7 inertia and group centroids, the D-62 CG; publish `CL-C1-G3-CAN-F`; GT-08 pad table and step 2 to H1; D7 reads the aft-wall allowable n 9.22 and the 0.059 m nose-drop allowance |
| CR-C6-26, CR-F2-13, CR-F2-18, CR-F1-28, CR-F1-29, CR-B2-19, CR-E2-26, CR-D6-06 | **F1** (F2, F3) | forward (D-67) | `E-PWR-03` at 0.08 N·m on PA66 socket heads; the `PWR-008` 680 µF ripple rating vs F2's 4.2 / 12.4 A RMS (name the part if short); EC5 → AS150U re-termination step; the UBEC 6 V servo rail stands (B2 +11 % at 6 V, −13 % at 4.8 V); Vx never across `E-HRN-23`. F2: `ASM-F2-WIRE-GPM` cites `CL-F1-W16-GPM`; every ESC lead ≤ 0.640 m; re-route for the D-62 bay (+10 mm on the pack lead and pod crossing) |
| CR-E2-24, CR-E2-26, CR-E2-27, CR-E2-23c, CR-B1-20, CR-F1-27 | **E2** (I1, E3) | forward (D-64, D-67) | release the pack cart with the two checks; `PACK_ACCEPT_KG` = `CL-A1-PACK-ACCEPT` (0.5926 today) and the T-E2-WEIGH pass line; re-run `CALC-E2-BUDGET-PESS` on `CL-B1V-CRUISE-P-PESS` 312.4 W and r_ext 6.7; E3 re-points `thermal.py` at `P:electrical.r_ext_mohm` and the 7.6 g ESC (CR-E1-41) |
| CR-E1-44, CR-E1-48, CR-E1-49, CR-B1-20, CR-E3-14, CR-D3-28, CR-D3-22, CR-A1-63 | **E1** (D3, B4) | forward (D-61, D-67) | re-run `propulsion.py` and `make_propulsion.py` on D3's 7.5 mm mount (hub at D3's `CL-D3-X-PROP`; publish the new CAD centroids for A3), `CALC-E1-WORST` on r_ext 6.7, `CL-E1-CRUISE-P-55` / `-LD-EFF` on `CL-B1V-CD0` / `CL-B1V-K` (A1 then copies `ld_cruise`); SPEC thermal row 56.1 / 64.8 °C; acknowledge `E-FIN-81…88`; `check.py` must show 0 keep-out errors |
| CR-C5-17, CR-C5-19, CR-C4-39, CR-B3-26, CR-B3-16, CR-A5-31, CR-B4-22, CR-E3-18, CR-C6-21 (a), CR-D6-07, CR-B2-19, CR-E1-36 | **A2** | forward (D-65, D-66, D-70, D-71) | re-word `R-LANDING-IMPACT` (1.2 m/s, ≤ 10° any direction) and `R-SPIRAL` (option b, or decide otherwise), `R-CG-RANGE` → `cg.x_range_m` with the V1 ids; record the `R-VIBRATION` re-run triggers; list `CL-B4-TIP-WING`, `CL-E1-TIP-GAP-TUBE`, `CL-B4-GAP-TUBE-ENV` under `R-PROP-CLEAR`; E3's `-ASD-*` ids and `T-E3-ESC-PAD-CFD` under `R-THERMAL`; `CL-B2R3-SERVO-TORQUE-REQ` verifies `R-SERVO-TORQUE` (at the servo output through the linkage); `CL-A5-ASSY-CG-X*` under `R-CG-RANGE`; re-run `build_requirements.py` |
| CR-F4-18, CR-F4-19, CR-F4-20, CR-C5-17, CR-C5-05, CR-B3-26, CR-B3-19, CR-B2-16b, CR-C1-32, CR-C1-08, CR-D5-21 | **F4** (H2, H3, F3, D6) | forward (D-65, D-66, D-71) | `Q_PILOT_SPD_DN` ≤ 1.2, `Q_LAND_FINAL_SPD` 0.3, `Q_LAND_SPEED` 0.3; `FLTMODE*` roll-stabilised only (no MANUAL / ACRO) once A2 words `R-SPIRAL`; `ARSPD_FBW_MIN` from the measured stall after `T-B2-STALL`; `INS_POS` / `GPS1_POS` from CG (0.0490, 0, 0.0185) once F3 re-runs `CALC-F3-OFFSETS` (CR-F4-19); H3: QLAND for the last 6 m on the card, block B and the spacer as no-fly items (CR-C3-13), stations from A3's re-run; D6: `theta_dn` claim and T-D6-THROW ends (CR-F4-20), servo neutral centred in the play band (CR-B3-23) |
| CR-D7-23, CR-A1-66, CR-C1-31, CR-D5-29 | **D7** (C1) | forward (D-62) | nose pad 3/4 → 1/2 in for the pod at −0.140 (keep `CL-D7-NOSE-GAP` ≥ 9 mm and `CL-D7-ANTENNA-PAD-GAP` ≥ 2 mm), re-run `transport_calc.py` on envelope x 0.508 (`CL-D7-NOSE-DROP-ALLOW` falls; floor and aft-wall drops unchanged; aft-wall n 9.22 allowable); add 193 + 15 g to the tote if `TRN-108` is weighed |
| CR-C4-36, CR-C4-38, CR-C4-41, CR-C6-33, CR-C3-20, CR-C2-15, CR-C2-08, CR-C1-30, CR-E3-17, CR-B3-29, CR-A1-60, CR-D5-30, CR-D6-18, CR-F3-10, CR-F5-05 | **H1** (H2, H3) | forward (D-65, D-70, D-72) | `T-C4-FIN-PROOF` on the as-drawn article with two strain gauges and the dial gauge; `T-C4-MOUNT-STIFF` ≥ 1 100 N·m/rad; `T-C6-STRIP-ANCHOR` ≥ 1 560 N frame; `T-C3-STOP-PUSH` on bonded tray pieces, `T-C3-POD-PROOF` + 200 N on the brackets; `T-C4-TUBE-BEND` with GJ; `T-E3-ESC-PAD-CFD` dummy ESC (~$3); GT-08 pad table at R4 with step 2; balance marks 0.0466 / 0.0514 m (GT-07); `T-D5-SIDE` 35 N → the C5 59 N ultimate basis after D5's fix; Jacobs Hall's written yes for the soldering kit (D-72) before 20 Nov; re-run `ground_tests.py` |
| CR-E2-24, CR-C6-35, CR-D6-16, CR-D5-27, CR-D7-17, CR-B4-11, CR-F5-12, CR-C4-38 | **I1** (I2) | forward (D-64, D-72) | pack cart (`P01` Ovonic 120C EC5, 2-pack, re-priced in USD, the two checks); kit R4 with Ø 2.5 mm CF rod × 2 and the PA66 socket heads; 1/8 in CF rod; 7/32 in brass tube; mat / tote / spares box / labels; two strain gauges for the fin proof; apply lever 1 (borrow the soldering kit) and re-price the BOM so `CL-A1-RESERVE` returns ≥ $309 (A1 copies the cost keys) |
| CR-E1-45 (done), CR-B4-22, CR-D1-11 (done), CR-A1-59, CR-F5-14, CR-F3-23, CR-D7-21, CR-E1-49 | **A4 / A5** (J2) | forward (D-61, D-73) | A5: re-run `check.py` after D3's 7.5 mm mount, D2's R6 and D5's R5 (expect 0 keep-out errors), `DATUMS.md` / `k09kit` at `x_prop_plane_m` −0.0127, `DP-MOTOR-FACE` 0.0244, `DX-BOX` for the 0.508 envelope; A4: `check_budget` tolerance 0.05 g and one one-sided warning per subsystem (CR-A1-59), close CR-A4-30/45 (`GND-001` declared), E-AVN-09 100 mW note, merge the new types; J2: nothing open |
| CR-E3-13, CR-E3-14, CR-E3-15, CR-E3-17, CR-E3-18, CR-E2-27, CR-E1-41, CR-F3-14 | **E3** | forward (D-67) | re-run `thermal.py` on r_ext 6.7 (`P:electrical.r_ext_mohm`), the 7.6 g ESC, F3's 0.5 W; the owners (D3, E1, D2) copy the R3 values into the thermal blocks and SPEC rows |
| CR-F2-12…18, CR-F3-22, CR-F3-23, CR-F5-13, CR-F5-14, CR-F1-30 | **F2, F3, F5** | closed or forward | F2-13 done by F1-R4; F2-17 done by F3; F3-22/23 closed; F5-13: F3 moves `E-AVN-09` to `EDGES` (done per CR-F3-23); F5-14 to A4; F1-30 to F3 (acknowledge `E-HRN-22/23`); F2-14 → D1, F2-15 → D6, F2-16 → D3, F2-18 → F1 (above) |
| CR-C4-02…05, -10, -11, CR-D3-06, CR-D5-05, -17, -22, CR-E2-13, CR-F2-05, -10, CR-F4-05, -08, CR-D1-01, -07, -11 | — | closed | history rows already answered in the owners' own tables (done, superseded or forwarded at R1–R4) |

## 2026-11-11 · fins allocation 437 -> 438 g
Accepted (A1, at the team lead's request). Modelling every joint-stack fastener as a CAD part (team/C6/FASTENERS-CAD.md) put the fins 0.1 g over 437 g. 1 g moved from requirements.growth_allowance_kg (114 -> 113 g); sized total unchanged at 2 600 g, growth reserve 214 -> 213 g (113 g growth + 100 g build overrun).

## 2026-11-11 · power board facts, servo supply and the pod–wing power plug (WB-01, WB-02, WB-03, WB-09; BR-05, BR-24, BR-25)

| Id | Decision | From | Keys changed | Why (numbers) |
|---|---|---|---|---|
| **D-74** | **Drop the UBEC `PWR-005` and its 5 A fuse `PWR-007`: the CoreWing V2 power board's servo BEC, jumpered to 6 V (never 7.2 V), feeds the two elevon servos through the FC's Vx rail. Fallback only if `subsystems/power/BOARD-CHECK.md` step 7 reads Vx < 5.8 V at ≈ 5.4 A: then a named 4S-input 6 V UBEC with its own pod zone (BOM gate X12: F04, F05, F06). Add one Amass XT30U per ESC pair at the pod side exits (BOM `H06`, `HRN-113`); every bus-bar joint is made on the bench (one build order in power and harness `BUILD.md`). Define the power-board keep-out `KO-PWR-BOARD` (x −0.066 … −0.010, 34 mm wide, z to 0.0626 m) so the pod fits the board split or as the whole stack** | BUILDABILITY-REVIEW BR-05 / BR-24 / BR-25; WIRING-BATTERY WB-01, WB-02, WB-03, WB-09; CR-F1-21, CR-F1-29, CR-D2-27 | none in `params.json` yet. Pending owners: F1 removes `PWR-005` / `PWR-007` from `make_power.py`, `fusion/power.py`, `power_claims.py` and re-draws the deck to 56 mm; F2 removes `W-FUSE-IN`, `W-UBEC-IN`, `W-UBEC-OUT`, adds the XT30U and re-types `W-PMOD` in `team/F2/harness.py`; D2 reserves the keep-out (power `SPEC.md`); A3 books −16.5 g power, +4.2 / +5.8 g harness | CoreWing manual V2.1 and ArduPilot: servo BEC 8 A cont / 14 A peak at 5 / 6 / 7.2 V. Need: 2 × 1.4 A stall = 2.8 A, × 2 = 5.6 A (`CL-F1-SERVO-BEC-REQ`): margin 43 %. The 4.5 A behind the UBEC is the SpeedyBee F405 Wing APP column of CoreWing's own comparison table. The BOM's UBEC was also listed 2–3S on a 4S pack. FC BEC 5.2 V 4 A vs 1.74 A. The board splits by construction (three PCBs on a pin-header link, no GH-6 power port; outputs on the FC; PDB and FC 52 × 32 mm, M2 on 30.5 × 26.5). Mass: aircraft −10.7 to −12.3 g (harness 121.5 / 123.1 g vs 123). Cost: −$18.01 pre-tax; pessimistic reserve $326.41 → $346.26. XT30U adds ≤ 2.4 mΩ per ESC loop: the LR lead drop goes ≈ 4.89 → 5.3 % at the 100 A limiter, over F1's 5 % guideline (WB-11), measured at `T-F1-DROP` |

## 2026-11-11 · fin tip, landing mass and the CG (BR-00, BR-01 / SW-02)

| Id | Decision | From | Keys changed | Why (numbers) |
|---|---|---|---|---|
| **D-75** | **One fin tip: the step front is where D5's foot stack puts it, x 0.2614 (step \|z\| 0.2010, 9.0 mm deep), not D-54's 0.2746. D5's stack (`CL-D5-FIN-STEP-X/-Z`, from `landing.py stack()`) is the single source; D3 copies it into `fin_detail.fin.tip_square_m` 0.0586, `tip_step_z_m` 0.2010, `tip_clear_x_m` 0.2536 (cheek front), and `CL-D3-TIP-STEP-MISMATCH` (≤ 0.5 mm) guards the copy. Strips end at 0.2614; the pins stop at x 0.249 (11 per half, was 12 to 0.264)** | BUILDABILITY-REVIEW BR-01 / SW-02 / MF-08; CR-D5-11 (re-opened); CR-D5-31 (never logged, superseded) | `subsystems/fins/params.json` `fin_detail.fin.{tip_square_m, tip_step_z_m, tip_clear_x_m, top_edge}` | The shoe's back wall sits at flange − 2 × stroke − engagement − 1 mm. Both terms are fixed by analysis: C5's 3-D touchdown sim uses the whole 35 mm usable stroke at 1.2 m/s and 10° (`CL-C5-SIM3D-STROKE` 35.0 mm, so the 38 mm gap stays), and the 25 mm engagement holds the sleeve-end FEA (D-65, CR-C5-18). Going back to 0.2746 would need 6.5 mm less stroke or 13 mm less engagement; both fail. So the fin moves, not the foot. D-54's x 0.2746 was R5's shorter stack. Result: the CAD shoe and fin no longer overlap (min clearance 0.20 mm, the glue line); D3 `make_fins.py`, D5 `make_interfaces.py` / `feet_calc.py`, `fins_calcs.py` re-run, mismatch 0. Fin area loses ~120 mm² per half-fin at the tip (negligible for B3). C4 re-solves its fin station on the 58.6 mm tip and the shorter pin row (CR-C6-38); C6 re-checks the strip pin RF with 11 pins |
| **D-76** | **Landing D5-R7: crush cartridges in FOAMULAR 400 (40 psi, 276 kPa) at 14.5 × 9.8 mm with a 5/32 in bore for type L (same 37.5 N mean plateau, bias 1.046); the shoe sleeve shrinks to 19.1 × 14.4 mm (walls 1.2 mm kept, rim 2.8 → 3.4 mm), tine 16.3 × 11.6 mm with 2.0 mm rails, flange 1.6 → 1.8 mm. Landing 69.9 → 59.1 g. Fallback if F-400 cannot be bought or fails `T-D5-COUPON`: the R6 F-250 parts (+11 g, CG +1.1 mm)** | BR-00, BR-09; CR-D5-32, -33 | `subsystems/landing/params.json` `cartridge.{section_y_m, section_z_m, bore_lower_d_m, material, density_kgm3}`, `shoe.{rim_t_m, lip_m}`, `piston.{flange_t_m, window_rail_m}`, `kit.tube_od_m` | Where the 69.9 g came from: four shoes 45.9 g (sleeve floor + roof 5.0 g each, walls 2.5, rim 2.0), four pistons 15.8, pads 3.9, cartridges 2.9, caps 1.5. The section is the driver: a 50 % stronger foam cuts the crush area to 142 mm², which narrows the sleeve 25.5 → 19.1 mm. D5 FEA sweep on the narrow sleeve (`team/D5/sim/runs/log_k11_*`, `log_k12_*`, h 0.4 mm, 59.25 N ult): walls 1.2 / rim 2.8 gives +y 47 MPa (fails), 1.0 / 3.0 52 MPa, 0.8 / 3.2 60 MPa; 1.2 / 3.4 on 14.5 × 9.8 gives +y 37.6 / +z 31.0 MPa, RF 1.06 (R6 1.03). Tine SF 1.15 (rails 2.0), flange SF 1.07, bond RF 1.44, snap 1.7 %, stroke, n 5.88, η 0.84 and tip-over 32.0 / 31.0° unchanged. Other levers rejected: shorter stroke (C5's sim needs all 35 mm), thinner walls (FEA), ASA or nylon (lower allowable or poor epoxy bond), 1/32 in pad (−2 g, moves the stack). 48 g needs the side-load fuse (SW-03), a concept change for C1/C4/C6 |
| **D-77** | **Pack datum 4 mm forward: `pod.pack_x_nominal_m` −0.032 → −0.036 (16 mm CAD spacer stack: blue + green + white), `pod.pack_aft_travel_m` 0.012 → 0.016 (aft stop stays at 0.0475). Per-pack flight stations from A3's re-run: 546 g −0.036 (16 mm), 550 g −0.034 (14 mm), 590 g −0.030 (10 mm). D2 moves the forward strap −0.062 → −0.079 (slots 37 → 26 mm) to clear D-74's keep-outs** | BR-00 option B; CR-A3-32 | `pod.pack_x_nominal_m`, `pod.pack_aft_travel_m`; pod `pack_aft_face_m`, `spacer_flown_m`, `pack_x_per_pack_m`, `strap_x_m`, `strap_slot_m` | −0.036 is the most forward 2 mm step that keeps C5's crush block B: 26.2 mm vs 25.8 (550 g) and 25.6 (546 g); C5's own limit is −0.0364. The review's 6 mm (to −0.038) rested on A1's 24.3 mm block and would cut C5's block to 24.2 mm (crash pack load > 100 g). A longer nose is blocked by antenna B (tube end must stay ≥ −0.150) and D7's box gap. Hatch, stops, nose and the strut are unchanged; the pack still goes in through the hatch with its block and spreader (aft face 0.0315 inside the opening to 0.066); antenna B to pack 36.5 ≥ 30.7 mm; hover split 1.21 (≤ 1.25) and stance unchanged (CG height). CG (A3, before F1/F2 book D-74): basic 48.7 mm, predicted 50.3 mm against 46.6–51.4 |
| **D-78** | **Mass allocation: landing 48 → 60 g, power 648 → 636 g (total 2 387 g and the 213 g reserve unchanged)** | D-74, D-76 | `mass.allocation_g.landing`, `.power`, `mass_budget.json` | D-76 is the honest minimum of this foot concept (59.1 g `EST`). D-74 takes the UBEC and fuse out of power (−16.5 g), so power's basic falls to ≈ 623.5 g and 12 g can move without touching the reserve; harness keeps its 123 g (D-74 puts it at 121.5–123.1 g). If the side-load fuse (SW-03) later brings the feet back toward 50 g, the difference returns to the reserve |

## 2026-11-11 · harness allocation after D-74 as built (F2-R4)

| Id | Decision | From | Keys changed | Why (numbers) |
|---|---|---|---|---|
| **D-79** | **Mass allocation: harness 123 → 129 g, power 636 → 630 g (6 g moved; total allocations and the 213 g reserve unchanged)** | D-74, D-78; F1/F2 D-74 implementation (`CL-PWR-MASS`, `CL-F2-MASS`, `CL-F2-SERVO-V`) | `mass.allocation_g.harness`, `.power`, `params/mass_budget.json` (A1 `frame_claims.py`) | D-74 as modelled: power 638.2 → 622.4 g (UBEC −13.0, fuse −3.5, 56 mm deck +0.7), so 630 g leaves power 7.6 g. Harness 119.8 → 127.7 g: four XT30U at 2.0 g now drawn as parts `HRN-113-*` (+8.0), `W-FUSE-IN` / `W-UBEC-IN` / `W-UBEC-OUT` out (−3.8), 10-way board-link ribbon (+1.0), fittings −0.45, and the elevon servo + / − moved from 26 to 22 AWG (+3.2 g, signal 28 AWG) because the board link's Vx / GND drop (0.10–0.12 V in case S) put the stalled servo at 5.61 V < 5.7 V; with 22 AWG and 4 Vx + 3 GND link conductors it reads 5.75 V. No link-conductor option alone reaches 5.7 V: the 10 × 3 mm under-pack channel takes at most a 22 AWG pair at fill 0.40, and even a soldered 22 AWG Vx / GND pair leaves 5.66 V. 129 g gives the harness 1.3 g (1 %) until `T-F2-WEIGH`. If case U (whole stack, no link cable) is chosen at `BOARD-CHECK.md`, the ribbon (2.2 g) comes back to the reserve |

## 2026-11-11 · buildability CAD defects and the no-phasing (collision) gate (BR-02 / MM-01, MM-02, BR-03 / MF-01; Dillon Alcouffe)

A new gate, `collision/collide.py`, meshes every CAD body and fails when two different parts penetrate each other by
more than 0.05 mm (static pose and both elevon limits), so the assembly can go into a rigid-body physics simulator as
drawn. Its first run found 117 penetrating part pairs; the rows below and `interfaces/seats.json` (53 seats: holes,
pockets and slots the real parts have) bring it to 0. Report: `collision/out/REPORT.md`.

| Id | Decision | From | Keys changed | Why (numbers) |
|---|---|---|---|---|
| **D-80** | **Motor-mount outboard cheek ends 1 mm ahead of the clamp slit** (inboard cheek keeps the full 17 mm) | BR-02 / MM-01 | `fin_detail.mount.cheek_slit_gap_m` 0.001 (new); `fins.py build_mount` | The outboard cheek bridged the 1.5 mm slit and both pinch ears for the top 8.4 mm, so the clamp could not close. It now ends at x 0.04325 against the slit front at 0.04425 and joins only the front half of the collar and the front ear. C4 re-checks rocking stiffness on the first print (`T-C4-MOUNT-STIFF`, MM-07). Feeler-check the slit on the first print. |
| **D-81** | **Clocking key: a 3 × 2.5 mm dog under the mount collar (front, −x) in a 3.4 mm notch at the top of the `FIN-008` ring**; the pinch bolt stays the clamp | MM-02 | `fin_detail.mount.key_w_m` 0.003, `key_d_m` 0.0025, `key_clear_m` 0.0002 (new, `UNVERIFIED`); `fins.py` collar + mount | The 7° cant clocking rested on friction alone. The notch removes 8.5 mm² of the 1 037 mm² collar bond (`A_collar_tube` 1 036.7 → 1 027.5 mm², −0.9 %): C6 re-reads `CL-C6-COLLAR-RF-15MM`. **Open:** the dog's shear strength now adds to the D-23 slip fuse; C6 sizes it (shear tab or 1.75 mm filament pin) before the 18 Dec freeze. |
| **D-82** | **Horn blade front follows the elevon bevel (+0.2 mm) instead of a vertical edge at hinge + 6 mm; the wing's horn slot opens from the hinge line** | MF-01 (shop export: bore broke out of the blade edge) | `mec.horn.blade_x_mm` [6, 40] → [0, 40], `mec.horn.blade_bevel_gap_m` 0.0002 (new); `mechanisms.py`, `wing.py` | The 5 mm torque-tube bore (front 5.0 mm aft of the hinge) broke out of the blade's 6 mm front edge. The bevel-following front leaves ≥ 1.2 mm of wall ahead of the bore and keeps the panel's TE-down clearance. The link-horn arm cut-off is now a true polygon clip (the old z clamp left a zero-width spike). |
| **D-83** | **Fin-hole grommets drawn as parts `HRN-110-UR/UL/LR/LL`** (flange OD 10, bore 7, 12 mm overall, barrel 7.9 mm in the 8 mm hole, CA'd), edges `E-HRN-42…45` to `FIN-001-<st>` | MF-01 (no CAD body) | `team/F2/harness.py` (`GROM_DIM_M`, `GROM_G` 0.5 g `EST`); harness params/interfaces/parts | Mass moved from the bundle fittings to the four parts: harness total unchanged at 127.7 g. Sizes are the G3 print proposal, `UNVERIFIED` until the first print. |
| **D-84** | **Collision fixes that change geometry** (no mass or performance number moves beyond the re-run) | `collision/collide.py` first run | see each | (a) **Pack leads re-routed**: the one-box lead stand-in ran 6 mm through the PETG aft stop and the cradle side wall; now over the stop to x 0.066, then left and down into the AS150U pack half's wire end (`power.py`). (b) **Left handle leg solid**: its 4.2 mm bore was a sealed void (shop export showed two pieces) (`pod.py`). (c) **Hinge tape follows the upper skin** (it sat 1.7 mm inside the core ahead of the hinge) (`mechanisms.py`). (d) **Recess-step fillet vertical leg capped at the 4.8 mm pod floor** (5.0 → 4.8 mm; it stood 0.2 mm into the tray): C3 re-reads CR-C3-17, the 5 mm floor leg is unchanged (`wing.py`). (e) **Handle saddle 0.2 mm bond gap over the spar** (`pod.saddle_gap_m`, new). (f) **Tape skins offset along the surface normal**, and the wing and fin-root sections use 96 stations (were 48 and 24), so the bonded skins, fins and core no longer cross by tessellation (`wing.py`, `fins.py`). |

## 2026-11-11 · wiring routed as built: every wire collision-free (D-85; Dillon Alcouffe)

`collision/collide.py` now meshes every routed wire as the 3-D model draws it (filleted at its declared bend radius,
at each strand's diameter) and checks it against every part and every other wire. First run: 97 wire clashes (wires
through fins, foam, connectors, the FC and power board, and through each other). Now 0, static and at both elevon
limits, with all of F2's own route rules passing except the two listed under **Open** below.

| Id | Decision | From | Keys changed | Why (numbers) |
|---|---|---|---|---|
| **D-85** | **Harness routed as built; three holes and two slots that the routes need are now in the CAD** | collision check with wires | `team/F2/harness.py` (routes), `subsystems/wing/fusion/wing.py` (P1, P1s cuts), `subsystems/mechanisms/fusion/mechanisms.py` (frame lead notch), `subsystems/power/fusion/power.py` (cup slot, pack-lead boxes removed), `interfaces/seats.json` | (a) **P1** 8 mm 45° lead hole cut in the core and tape (was "not modelled"; the lower leads ran 10 mm through solid foam). (b) **P1s**: a second 4 mm pass-through, 4.5 mm ahead of the signal groove, for the lower-station ESC signal lead, which otherwise must cross the power pair inside P1. (c) **Servo-frame lead notch**: D1's lead hole lands on the frame rim (window starts x 0.1764); a 4 mm notch under the hole. (d) **Cradle cup slot** cut (it was named, not cut). (e) **Fin crossing**: the 16 AWG pair goes from its groove end straight into the grommet along the bore and arcs out and back onto the outboard face (a pair tied flat on the face cannot turn square into the bore at its 10.4 mm bend radius; the old route slanted through the laminate); the signal lead is tied to the pair and shares the bore 2.5 mm off it. (f) **Pod**: under-pack channel on the floor through the tray gap (was 1.5 mm inside the floor); risers outboard of the guides; FC outputs on a 3 mm plug pitch, pigtails crossing over one another on three levels; ribbon between the FC gel cubes and beside its end stop; airspeed and RX leads over the RX into the sensor's aft face; pack lead from the D-77 pack station over the aft stop into the AS150U pack half; board-to-bars jumper onto the bars' forward end; the four ESC pairs share the bench joint on the bar end. (g) **GPS cable**: the cross bolt fills the 6 mm mast bore, so the cable climbs the mast's aft face (tied), out of the grip groove and aft of the socket boss. |

**Open (team lead / F2 / F3):**
- **Harness mass 135.2 g vs the 129 g allocation (+6.2 g, `CL-F2-MASS` FAILS).** The routes are now physical: the
  fin-crossing arcs, the P1 paths and the pigtail cross-overs add copper. Either reallocate (as D-79 did) from the
  213 g reserve, or accept a heavier harness in A3's roll-up. Not changed here.
- **I2C bus 0.512 m vs 0.500 m (`CL-F2-I2C-LEN` FAILS, +2 %).** The GPS cable cannot run inside the mast (cross
  bolt). Options: accept (test with `T-F2-DSHOT`-style bench check of the I2C bus), move the GPS plug, or shorten
  the airspeed branch.

Checker rules added with the wire check (`collision/README.md`): the tape skin conforms over wires (wire-vs-tape is
not penetration; wire-vs-foam is); a wire may sit 6 mm into its terminal part (solder pad, heat-shrink tail) and pass
through connectors fitted in-line on it (XT30U, AS150U pack half); wires sharing a terminal part meet in one bench
joint for its first 10 mm.

## 2026-11-11 · every wire seated, nothing through the tape: connectors drawn, strict check (D-86; Dillon Alcouffe)

A close inspection of the D-85 model (`review/inspection-2026-11-11/`, before and after pictures) found seven wiring
faults the D-85 check let through, because its rules excused them: leads ending in mid-air where the JR connectors
were counted for mass but not drawn, the four ESC pairs pinched into one point short of the bus bar, wires passing
through the tape skin, the lower-station signal lead running 26 mm outside the lower skin, and the phase leads
hanging 89 mm in free air. All seven are fixed in CAD, and the checker no longer excuses any of them.

| Id | Decision | From | Keys changed | Why (numbers) |
|---|---|---|---|---|
| **D-86** | **JR connectors drawn; ESC pairs and main jumper landed conductor by conductor; tape slit where leads pass; lower signal lead under the tape; phase leads tied along the tube; strict no-phasing gate** | close inspection of the D-85 model | `team/F2/harness.py` (JR, routes, `skin_slots()`), `subsystems/harness/fusion/harness.py` (JR bodies), `subsystems/wing/fusion/wing.py` (`p1s_jog()`, `skin_slits()`), `subsystems/wing/params.json` (`jr_recess.width_y_m` 0.010 → 0.0108), harness `groove.jr_recess_x_m` (0.150–0.168 → 0.1375–0.168), `collision/collide_blender.py` | (a) **JR pairs as parts** `HRN-105-1…6` (tray, one per FC output) and `HRN-105-SL/-SR` (servo recesses), sized from the Pololu drawings checked 2026-11-11 (male shroud 18.00 × 10.30 × 4.00 mm, female 14.00 × 7.90 × 2.75 mm; female showing 6 mm behind the shroud is an EST). Tray: on edge on D2's tie bar at 4.5 mm pitch in FC-output order, so the pigtails run straight back with parallel 43° S-bends and never cross. Their mass (6 × 0.50 g, 2 × 0.25 g EST) moved from the fittings list to the parts. (b) **Servo recess** 30.5 × 10.8 × 5 mm: the old 18 × 10 mm recess was 0.3 mm narrower than the shroud and too short for the mated pair. (c) **Bus bars**: each ESC pair lands as two conductors, + on the + bar and − on the − bar, at four stations 6 mm apart, each rising over the landings behind it; the first bend off each pad is formed on the bench at 2 × OD (F1's `ASM-PWR-BEND`), every other bend keeps F2's 4 × OD. The 10 AWG main jumper is drawn as its two conductors through the deck window either side of the pairs (F1's own description) onto the bars' forward ends. (d) **Tape slits**: wherever a drawn lead passes the skin, the tape is cut round it (computed from the drawn strands, `cad.skin_slots`): pod exits and groove ends, upper and lower. (e) **P1s jog groove** in the lower surface from the P1s mouth to the signal groove, so the lower-station ESC signal lead stays under the tape. (f) **Phase leads**: forward along the board face, up outboard of the collar tail wall, tied at the collar's phase lug (FIN-008), taped up the outboard cheek face over the pinch nut, into the motor's lead exit. (g) **Checker**: the tape skin is a solid like any other (only a drawn slit lets a lead through); no shared "bench joint" allowance; every strand end must be seated in or on its own part or an in-line connector (radius + 0.5 mm). |

Result: `collision/collide.py` PASS under these rules; F2 route rules unchanged (bend 1.03, free span, DShot 0.699 m
against 0.70 m, fill) except the two open items below. Harness mass rises from 135.2 g to 138.9 g (+3.7 g: the real
landing, phase and pigtail routes), against the 129 g allocation.

**Open (team lead / F2 / D1 / F1):**
- **Harness mass 138.9 g vs the 129 g allocation (`CL-F2-MASS` FAILS, +9.9 g)** and **I2C bus 0.512 m vs 0.500 m
  (`CL-F2-I2C-LEN` FAILS)**: carried over from D-85; the decision is still the team lead's.
- **D1**: the longer JR recess (forward end 0.1375, was 0.150) reaches further along the servo branch; check the foam
  under its floor and the tape flap size. **F1**: confirm the bus landing order and the 2 × OD formed first bend.
- **DShot 0.699 m against 0.70 m** has 1 mm of margin; any later reroute of the LL signal lead must keep it.

## 2026-11-11 · wires that cannot exist: same-wire crossings, folds, butt-ended leads (D-87; Dillon Alcouffe)

The team found more wiring faults in the 3-D model after D-86 (ESC leads stopping at the box edge, a lead hooking
back over the power pairs at the left pod exit). A sweep of every wire end and every bend found the classes the
D-86 gate still missed, and the gate now fails all of them.

| Id | Decision | From | Keys changed | Why (numbers) |
|---|---|---|---|---|
| **D-87** | **Conductors drawn concentric round every bend; no lead folds or crosses itself; leads land where the real pads are; bus bars 35 mm** | team inspection of the D-86 model | `team/F2/harness.py` (`draw_strands`, routes), `subsystems/power/params.json` (`bar_m` 0.025 → 0.035 m, `bus_mass_g` 7.3 → 8.8 g EST), `subsystems/wing/fusion/wing.py` (servo-groove corner relief), `collision/collide.py`, `collision/collide_blender.py` | (a) **Same-wire crossings**: the two conductors of each ESC pair crossed where they arc out of the fin grommet, and the servo ribbon's conductors crossed at every corner (12 cases, up to 0.64 mm): each conductor was offset and then rounded on its own at the same radius. Now the centre line is rounded first and each conductor offset from it (inner R − o, outer R + o), with the spacing and lay eased in. (b) **ESC leads** enter the ESC's aft END face, where its power pads are under the heat-shrink (up the 3.5 mm gap before the cap), not its bottom face. (c) **Left pod exit**: the signal leads cross over the left power pairs inside the pod and leave at the window's forward edge like the right side; the lower-station lead no longer hooks back over the pairs outside. (d) **Folds**: the pack lead (6 mm bundle), the 10 AWG main jumper and the ESC-pair landings turned tighter than their own radius (the tube passed through itself). Now: the pack lead turns on 4 mm arcs and loops 4 mm aft of the pack half (its end 1 mm inside it); the main jumpers start and end ON the board pads and land on the bars through 3.5 mm arcs; the ESC pairs land at 8 mm stations, which needs **35 mm bars** (was 25; the FR4 carrier is 36 mm). The first two bends of each pad lead-off are bench-formed at 2 × OD (F1 `ASM-PWR-BEND`). (e) **Servo-groove corner relief**: a 3 mm triangle cut at the inside corner where the groove turns into its branch (the 3.6 mm ribbon in the 4.0 mm groove needs it to turn on its 3.9 mm bend). (f) **Checker**: strands of one wire are checked against each other; a bend tighter than the strand's radius fails ("folds"). |

Result: `collision/collide.py` PASS (1007 bodies, 193 parts, 3 poses; 0 overlaps incl. same-wire, 0 loose ends, 0
folds). F2 rules: bend 1.01, DShot 0.696 m, the two open items below. Harness mass 139.9 g (was 138.9 g).

**Open:** harness mass 139.9 g vs 129 g and I2C 0.512 m vs 0.500 m (team lead, carried over). **F1**: the 35 mm bars
(+1.5 g EST), the landing order (LR aft-most, then UR, LL, UL, main jumper at the front) and the 3.5 mm main-jumper
landing arcs (tighter than `ASM-PWR-BEND`'s 2 × OD: check the formed 10 AWG for insulation cracking at T-PWR-FIT).
**D1**: the servo-groove corner relief.

Media regenerated from this design (team request: nothing shown may lag the CAD): 15 renders and site thumbnails, GA
drawing, flight animation + GIF, build animation, STLs, GLB + viewer data, page snapshots, inspection pictures
(`review/inspection-2026-11-11/`, `fixed/` and `round2/`). `site/index.html` rebuilt from `site/app.html` (it lacked
the build-animation section); the Status section's Media phase now reads PARTIAL.

## 2026-11-12 · checked as exported: no part or wire phases in the 3-D model, every lead ends at a real termination (D-88; Dillon Alcouffe)

The team still found leads ending on the face of a box and parts showing through each other in the Explorer. The
D-87 gate checked the CAD bodies with the drawn cutters (slots, recesses, grooves) treated as already cut. The
Explorer, the renders and the videos show the exported model. Where a cut failed or left a sliver in the export,
the gate passed but the picture was wrong. A second gate now checks the exported `assembly.glb` itself, with no
cutters assumed.

| Id | Decision | From | Keys changed | Why (numbers) |
|---|---|---|---|---|
| **D-88** | **Second gate on the exported model; every soldered lead enters square onto a real pad, under heat-shrink; cap drawn as its real can; booleans made exact** | team inspection of the D-87 media | `collision/collide.py` (`--glb`, `--job-only`), new `collision/collide_glb_blender.py`, `blender/blender_backend.py` (MANIFOLD union per part, all cuts at once), `team/F2/harness.py` (ESC ends, `SLEEVE`, `CT-HEATSHRINK`, `p1s_jog_m`), `subsystems/harness/fusion/harness.py` (sleeves), `subsystems/power/params.json` (`cap_m` [0.016, 0.010], `cap_gap_x_m` 0.015), `subsystems/power/fusion/power.py` (cap as a cylinder), `fusion/check.py` | (a) **GLB gate** (Blender 4.5.14 LTS): the exported meshes are checked against each other with no cutter allowance. Every wire end must enter its part within 25° of square to the face, with its whole section on that face (0.1 mm ring) and at most 6 mm past it. Before: 34 bad entries; after: 0. (b) **Exact booleans**: each part's bodies are joined with Blender's MANIFOLD solver, and every cut is applied at once and then verified. A failed cut now stops the export, where before it left the cutter's volume behind. (c) **ESC ends**: the + / − pair rises on the fin face in the 2.3 mm gap ahead of the cap and lands square on the ESC's aft-end pads (z 116 / 123.5 mm); the signal lead rises first (x 126.2 mm) to the lowest pad (z 110.5 mm), so no lead crosses another; the phase leads start on the motor-side pads. (d) **Cap**: Panasonic EEU-FR1E681, Ø10 × 16 mm can (DigiKey datasheet, checked 2026-11-12), 15 mm aft of the ESC; legs drawn at Ø0.6 mm into the solder joint. (e) **Heat-shrink sleeves** `HRN-107-*` (17 parts, adhesive-lined 3:1 polyolefin from BOM HRN-107; 0.4 mm wall, 0.15 mm on the phase leads, EST) where each soldered lead leaves its part. They are new connection type `CT-HEATSHRINK` (bonded, non-structural) and carry their own mass and CG. (f) **P1s jog groove** moved onto the lead's own line (the GLB showed the lead 0.2–0.35 mm into the wing foam). (g) `fusion/check.py`: a lead whose two ends are on one part (the pack lead into its own AS150U half) is seated. (h) **Tape trimmed square along the fin root fillets**: the fins and their fillets go on before the skin (BUILD-GUIDE stages 4 and 6), so the tape is cut round each fillet with a blade. The model cut the tape against the fillet's curved feather edge, which left 0.075–0.094 mm tape slivers in the export. The wing module now cuts the tape square along each fillet edge (`wing.py` `fillet_trims`, from the fins module's own fillet zones), and the fillet underside follows the wing section's own stations (`fins.py`). Fillets unchanged: 6.2–6.3 g each. (i) The overlap work (exporter cut check, union, 5-ray parity) found that none of the 57 GLB part pairs first reported was a geometry fault; all were the exporter or the gate. |

Result: `collision/collide.py --glb` PASS (1028 bodies in 210 parts, 3 poses): CAD gate 0 overlaps, 0 loose ends, 0
folds; GLB gate 0 part pairs > 0.05 mm (was 57), 0 unseated wire ends, 0 bad entries (was 34); export 0 `CUT NOT
VERIFIED` (was 47), 0 `UNION NOT CLEAN`. `fusion/check.py` and `interfaces/merge_check.py` PASS. F2 rules: bend
1.01, DShot 0.692 m against 0.70 m. Harness mass 141.8 g (was 139.9 g: the
sleeves and the real end routes).

**Open:** harness mass 141.8 g vs 129 g (`CL-F2-MASS` FAILS, +12.8 g) and I2C 0.517 m vs 0.500 m (`CL-F2-I2C-LEN`
FAILS): the team lead's call, as before. **F1**: the 35 mm bars and the bench-formed first bends (carried over); the
cap 15 mm aft of the ESC. **D1**: the JR recess and the servo-groove corner relief (carried over).

Media regenerated from this design: renders and site thumbnails, GA drawing, flight animation + GIF, build
animation, STLs, GLB + viewer data, page snapshots and inspection pictures.

## 2026-11-13 · every lead ends on a drawn termination, checked by name: pads, plugs, joints, sleeves (D-89; Dillon Alcouffe)

The team still found leads in the pod ending on the bare face of a box: the flight controller, receiver,
airspeed sensor, GPS and power board were drawn as plain envelopes. D-86 to D-88 checked only that a wire end was
seated *inside* one of its parts, and a wire buried in an envelope met that rule. The CAD gate now accepts an
end only on a named termination body.

| Id | Decision | From | Keys changed | Why (numbers) |
|---|---|---|---|---|
| **D-89** | **A wire end must land on a drawn termination (pad, solder joint, plug, header, cups, sleeve, lead exit, bus bar); the avionics boards, power board, pack and servos get them** | team inspection of the D-88 Explorer (FC area) | `collision/collide_blender.py` (`TERMINATION`, `end_seats(require_term)`), `collision/collide.py` (splice sleeves in-line on two wires), `fusion/check.py` (an end may sit in an in-line sleeve), `subsystems/avionics/params.json` (`fc_pcb_t_m`, `fc_strip_m`, `fc_out_field`, `gh_side_m`, `fc_ports`, `fc_link_m`, `rx_pads`, `aspd_gh_z`, `gps_gh_m`), `subsystems/avionics/fusion/avionics.py`, `subsystems/power/fusion/power.py`, `subsystems/mechanisms/fusion/mechanisms.py`, `subsystems/harness/fusion/harness.py`, `team/F2/harness.py` (`PORTS`, `pigtail_fix`, `add_sleeve`, routes) | (a) **Gate rule**: the CAD gate (bodies keep their names) counts an end only within r + 0.5 mm of a termination body of its parts or an in-line part. Before: 0 flagged by the old rule, but the FC, RX, airspeed, GPS, PDB, pack and servo ends sat in envelopes. After: 0. The GLB gate (one united solid per part) keeps the seating and square-entry checks. (b) **FC** drawn as its 1.6 mm PCB plus a component envelope set back 9 mm (aft) and 4.1 mm (fore), EST. Outputs 1–6: each conductor is soldered in its own hole of the S / Vx / G field (2.54 mm EST; power SPEC.md [M] p. 3, p. 7), rises on a 2 × OD lead-off, runs aft stacked and enters its JR contact (pins vertical): 14 solder joints, no bundle on the board. GPS: JST-GH 6 side-entry header plus mated plug on the aft edge. SERIAL6: GH-4 on the fore edge. Power-board link: 2 × 5 header plus ribbon plug under the FC, between the gel cubes (EST). (c) **JST-GH sizes** from the JST GH catalogue pp. 27 and 29 (https://www.farnell.com/datasheets/5438.pdf, checked 2026-11-12): header B = 1.25 (n − 1) + 4.5 mm, 4.05 deep, 4.25 high; housing B = 1.25 (n − 1) + 2.5, 4.15 thick; side-entry mated length 7.15. (d) **Airspeed I²C**: back to the declared Y-splice (E-HRN-32 wire text): the branch is soldered to the GPS cable's four conductors on its riser, about 15 mm from the FC plug, under one adhesive sleeve `HRN-107-I2C` (Ø5.8 × 10 mm), and plugs into a GH-4 on the sensor's aft face above the tie post. D-88 had landed it on FC top-face "I²C pads" that no source or CAD body showed. (e) **RX**: four 5 V / GND / TX / RX pads on the RP3 top (order and pitch EST; openelab RP3 V2 page says pads, no plug, checked 2026-11-12). The 4-core cable ends in a 2 mm breakout sleeve `HRN-107-RX`; its conductors fan onto the pads and lie on them. (f) **GPS**: the GH-6 plug on the module's aft-upper end face; the cable enters it square along the 45° pad. (g) **Power board**: four pad joints on the aft edge (6 × 4.4 × 0.5 mm EST) under the four 10 AWG conductors. The battery jumper W-MAIN-1 is now drawn as its two conductors (was one 6 mm tube), with the cup slot widened to 10.4 mm. The ribbon plug sits on a top-face header at the forward-inboard corner. (h) **Pack**: lead-exit boot on the case's aft face. **Servos**: lead-exit grommet on each case's forward end face (sizes EST). (i) Sleeve parts can now lie along any axis (`dir`). The two new sleeves are solid (shrunk full of conductors), edges E-HRN-71/72 (`CT-HEATSHRINK`). (j) JST-GH ends in the fittings: 4 (was 6). |

Result: `collision/collide.py --glb` PASS (1077 bodies in 212 parts, 3 poses): CAD gate 0 overlaps, 0 wire ends off
a termination, 0 folds; GLB gate 0 part pairs > 0.05 mm, 0 unseated wire ends, 0 bad entries; export 0 `CUT NOT
VERIFIED`. `fusion/check.py` and `interfaces/merge_check.py` PASS. F2 rules: bend 1.006 (W-SRV-L-P lead-off), DShot
0.689 m against 0.70 m, RX lead 0.145 m against 0.15 m. Harness mass 140.9 g (was 141.8 g).

**Open:** harness mass 140.9 g vs 129 g (`CL-F2-MASS` FAILS) and I²C 0.522 m vs 0.500 m (`CL-F2-I2C-LEN` FAILS, was
0.517 m: the splice sits on the GPS riser): the team lead's call. **F3, on arrival** (T-F3-ARRIVAL): FC connector
types and positions, the output-field pitch, the RP3 pad order, the GPS module's connector (the M100 Pro ships SH 1.0,
UNVERIFIED), and the FC underside board-link header. **F1**, **D1**: as in D-88.

Media regenerated from this design: GLB and viewer data, STLs, renders and thumbnails, GA drawing, flight
animation, site build guide and proof-chain pages, page snapshots, inspection pictures. The build animation is
re-rendered with the new assembly sequence (separate entry).
