davinciucberkeley-collab/DBF-Combined/analysis/cfd3d/out/cases/L1_a4.0/history.csv

Time_Iter | Outer_Iter | Inner_Iter | "rms[P]" | "rms[U]" | "rms[V]" | "rms[W]" | "RefForce" | "CD" | "CL" | "CSF" | "CMx" | "CMy" | "CMz" | "CFx" | "CFy" | "CFz" | "CEff" | "Cauchy[CL]" | "Cauchy[CD]" | "Cauchy[CMy]"
0 | 0 | 0 | -4.279303779 | -3.218946351 | -3.674311744 | -3.697908213 | 76.66699005 | 0.6662924255 | 0.5811775858 | -0.01004221095 | 1.013375033 | -0.3840679643 | -0.8458133021 | 0.6241284717 | -0.01004221095 | 0.6262400765 | 0.8722560298 | 1 | 1 | 1
0 | 0 | 1 | -4.145005728 | -2.67359858 | -2.828761288 | -2.787438917 | 76.66699005 | 0.7328035955 | 0.7320539075 | -0.01193713371 | 1.270641713 | -0.478517262 | -0.9177754686 | 0.6799530236 | -0.01193713371 | 0.7813884557 | 0.9989769592 | 0.001030500078 | 0.0004538130706 | 0.0009868954074
0 | 0 | 2 | -4.22017523 | -2.734841545 | -2.85537005 | -2.738498468 | 76.66699005 | 0.7374822284 | 0.7803486909 | -0.016207473 | 1.354747783 | -0.5069095073 | -0.9315282284 | 0.6812513858 | -0.016207473 | 0.8298919604 | 1.058125418 | 0.001339943689 | 0.0004855333804 | 0.001266947813
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
