davinciucberkeley-collab/DBF-Combined/analysis/cfd3d/out/cases/L2_a0.0/history.csv

Time_Iter | Outer_Iter | Inner_Iter | "rms[P]" | "rms[U]" | "rms[V]" | "rms[W]" | "RefForce" | "CD" | "CL" | "CSF" | "CMx" | "CMy" | "CMz" | "CFx" | "CFy" | "CFz" | "CEff" | "Cauchy[CL]" | "Cauchy[CD]" | "Cauchy[CMy]"
0 | 0 | 0 | -1.24820883 | 0.01234309161 | -0.809881347 | 0.5478347 | 76.66699005 | 0.005549713559 | 0.4956454434 | 0.01681964165 | 0.8445953459 | -0.07230865453 | -0.03679090683 | 0.005549713559 | 0.01681964165 | 0.4956454434 | 89.31009468 | 1 | 1 | 1
0 | 0 | 1 | -1.38886374 | -0.129877923 | -0.9698423198 | 0.4053247712 | 76.66699005 | 0.005549705384 | 0.4956455503 | 0.01681964984 | 0.8445954669 | -0.07230892382 | -0.0367908943 | 0.005549705384 | 0.01681964984 | 0.4956455503 | 89.31024549 | 1.077971271e-09 | 4.087281893e-10 | 1.346444798e-08
0 | 0 | 2 | -1.471242512 | -0.2109773649 | -0.893744718 | 0.3265371242 | 76.66699005 | 0.005549708437 | 0.4956455002 | 0.01681965671 | 0.844595406 | -0.07230881107 | -0.03679089843 | 0.005549708437 | 0.01681965671 | 0.4956455002 | 89.31018735 | 1.58271649e-09 | 5.61367418e-10 | 1.910188097e-08
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
