davinciucberkeley-collab/DBF-Combined/analysis/cfd3d/out/cases/L2_a4.0/history.csv

Time_Iter | Outer_Iter | Inner_Iter | "rms[P]" | "rms[U]" | "rms[V]" | "rms[W]" | "RefForce" | "CD" | "CL" | "CSF" | "CMx" | "CMy" | "CMz" | "CFx" | "CFy" | "CFz" | "CEff" | "Cauchy[CL]" | "Cauchy[CD]" | "Cauchy[CMy]"
0 | 0 | 0 | -4.587737603 | -3.549978379 | -3.988558509 | -4.027033404 | 76.66699005 | 0.6547100991 | 0.5343459339 | -0.01274969851 | 0.9229731535 | -0.3563563831 | -0.8118713783 | 0.6158411701 | -0.01274969851 | 0.5787145619 | 0.8161565472 | 1 | 1 | 1
0 | 0 | 1 | -4.548730793 | -3.055047555 | -3.207455205 | -3.24575626 | 76.66699005 | 0.8064575682 | 0.7455958136 | -0.01534710333 | 1.287865773 | -0.4872829033 | -0.9960980751 | 0.7524829433 | -0.01534710333 | 0.8000352158 | 0.9245319816 | 0.001416651461 | 0.0009408273608 | 0.001343434372
0 | 0 | 2 | -4.627699046 | -3.099227578 | -3.210371307 | -3.195518193 | 76.66699005 | 0.8684211218 | 0.845109833 | -0.01858947329 | 1.46222297 | -0.5491753968 | -1.081919345 | 0.8073538097 | -0.01858947329 | 0.9036291831 | 0.9731566999 | 0.002005415285 | 0.001297587187 | 0.001906938252
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
