davinciucberkeley-collab/DBF-Combined/analysis/cfd3d/out/cases/L2_a6.0/history.csv

Time_Iter | Outer_Iter | Inner_Iter | "rms[P]" | "rms[U]" | "rms[V]" | "rms[W]" | "RefForce" | "CD" | "CL" | "CSF" | "CMx" | "CMy" | "CMz" | "CFx" | "CFy" | "CFz" | "CEff" | "Cauchy[CL]" | "Cauchy[CD]" | "Cauchy[CMy]"
0 | 0 | 0 | -1.549071174 | -0.2777458554 | -1.117220335 | 0.2453542832 | 76.66699005 | 0.05732836817 | 0.4923501428 | 0.01681964165 | 0.8445953459 | -0.07230865453 | -0.03679090683 | 0.005549713559 | 0.01681964165 | 0.4956454434 | 8.588246247 | 1 | 1 | 1
0 | 0 | 1 | -1.690047689 | -0.4225504046 | -1.273696223 | 0.1032720196 | 76.66699005 | 0.05732837121 | 0.4923502499 | 0.01681964984 | 0.8445954669 | -0.07230892382 | -0.0367908943 | 0.005549705384 | 0.01681964984 | 0.4956455503 | 8.58824766 | 1.087919613e-09 | 1.519982123e-10 | 1.346445286e-08
0 | 0 | 2 | -1.77340287 | -0.503821628 | -1.199935909 | 0.02342669321 | 76.66699005 | 0.05732836902 | 0.4923501998 | 0.01681965672 | 0.844595406 | -0.07230881107 | -0.03679089843 | 0.005549708437 | 0.01681965672 | 0.4956455002 | 8.588247115 | 1.596500199e-09 | 2.616992442e-10 | 1.910188531e-08
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
