davinciucberkeley-collab/DBF-Combined/analysis/cfd3d/out/cases/L3_a4.0/history.csv

Time_Iter | Outer_Iter | Inner_Iter | "rms[P]" | "rms[U]" | "rms[V]" | "rms[W]" | "RefForce" | "CD" | "CL" | "CSF" | "CMx" | "CMy" | "CMz" | "CFx" | "CFy" | "CFz" | "CEff" | "Cauchy[CL]" | "Cauchy[CD]" | "Cauchy[CMy]"
0 | 0 | 0 | -4.882506071 | -3.856963415 | -4.305159097 | -4.328980394 | 76.66699005 | 0.662111995 | 0.5242803554 | -0.01193682433 | 0.9070986293 | -0.3543189799 | -0.8213353764 | 0.6239271747 | -0.01193682433 | 0.5691898328 | 0.7918303237 | 1 | 1 | 1
0 | 0 | 1 | -4.866968817 | -3.377623362 | -3.553240585 | -3.603028421 | 76.66699005 | 0.8378797164 | 0.733860749 | -0.01428352695 | 1.269566396 | -0.4849970221 | -1.039511549 | 0.7846471455 | -0.01428352695 | 0.7905206356 | 0.8758545345 | 0.001427930257 | 0.001048883974 | 0.001347204584
0 | 0 | 2 | -4.955263262 | -3.420563379 | -3.561534069 | -3.596652668 | 76.66699005 | 0.9080765978 | 0.8249717717 | -0.01716814461 | 1.427766506 | -0.5413157533 | -1.133950514 | 0.8483174471 | -0.01716814461 | 0.8863064033 | 0.9084825814 | 0.001980137168 | 0.001435398072 | 0.001867406803
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
