davinciucberkeley-collab/DBF-Combined/analysis/cfd3d/out/cases/L4_a4.0/history.csv

Time_Iter | Outer_Iter | Inner_Iter | "rms[P]" | "rms[U]" | "rms[V]" | "rms[W]" | "RefForce" | "CD" | "CL" | "CSF" | "CMx" | "CMy" | "CMz" | "CFx" | "CFy" | "CFz" | "CEff" | "Cauchy[CL]" | "Cauchy[CD]" | "Cauchy[CMy]"
0 | 0 | 0 | -8.240470721 | -6.382247598 | -6.485199007 | -6.347026344 | 76.66699005 | 0.03451144702 | 0.5233306681 | 0.02428658862 | 0.8869100998 | -0.06674232656 | -0.01867760571 | -0.002078323138 | 0.02428658862 | 0.5244632578 | 15.1639735 | 1 | 1 | 1
0 | 0 | 1 | -8.305211557 | -6.402179427 | -6.501191358 | -6.390995882 | 76.66699005 | 0.03451052181 | 0.5233301878 | 0.02428702371 | 0.8869096127 | -0.06674054971 | -0.01867575308 | -0.002079212585 | 0.02428702371 | 0.524462714 | 15.16436612 | 4.589546138e-09 | 4.626048222e-08 | 8.884269961e-08
0 | 0 | 2 | -8.413085991 | -6.421881308 | -6.511819896 | -6.425431717 | 76.66699005 | 0.0345105293 | 0.5233308042 | 0.02428754121 | 0.8869108015 | -0.06673922187 | -0.01867489523 | -0.002079248118 | 0.02428754121 | 0.5244633295 | 15.16438069 | 1.04795336e-08 | 4.663496012e-08 | 1.552345378e-07
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
