davinciucberkeley-collab/DBF-Combined/analysis/cfd3d/out/cases/L4_a4.0/history_leg1.csv

Time_Iter | Outer_Iter | Inner_Iter | "rms[P]" | "rms[U]" | "rms[V]" | "rms[W]" | "RefForce" | "CD" | "CL" | "CSF" | "CMx" | "CMy" | "CMz" | "CFx" | "CFy" | "CFz" | "CEff" | "Cauchy[CL]" | "Cauchy[CD]" | "Cauchy[CMy]"
0 | 0 | 0 | -5.183182271 | -4.182494563 | -4.618721982 | -4.650666897 | 76.66699005 | 0.673744129 | 0.5210292549 | -0.01319020717 | 0.8997837053 | -0.3525851105 | -0.8308110977 | 0.6357577586 | -0.01319020717 | 0.5667580685 | 0.7733340188 | 1 | 1 | 1
0 | 0 | 1 | -5.186494176 | -3.687369798 | -3.890546052 | -3.942456597 | 76.66699005 | 0.8766847617 | 0.7398081508 | -0.01560994078 | 1.277727616 | -0.4913481101 | -1.082117398 | 0.8229427938 | -0.01560994078 | 0.7991604529 | 0.8438702065 | 0.001478619124 | 0.00115743219 | 0.001412064041
0 | 0 | 2 | -5.277910552 | -3.725815526 | -3.905607151 | -3.963679006 | 76.66699005 | 0.9609256722 | 0.8318972669 | -0.01855772112 | 1.437725516 | -0.5499462127 | -1.196109232 | 0.9005546857 | -0.01855772112 | 0.8969015934 | 0.8657248849 | 0.002032107636 | 0.001595764274 | 0.001944826166
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
