davinciucberkeley-collab/DBF-Combined/analysis/cfd3d/out/tests/L1_a4.0_nolim/history.csv

Time_Iter | Outer_Iter | Inner_Iter | "rms[P]" | "rms[U]" | "rms[V]" | "rms[W]" | "RefForce" | "CD" | "CL" | "CSF" | "CMx" | "CMy" | "CMz" | "CFx" | "CFy" | "CFz" | "CEff" | "Cauchy[CL]" | "Cauchy[CD]" | "Cauchy[CMy]"
0 | 0 | 0 | -3.920791116 | -2.759364906 | -3.493098264 | -3.336797394 | 67.67363295 | 0.6206958545 | 0.4859188363 | -0.01008826402 | 0.9632555304 | -0.3596578908 | -0.8589821555 | 0.5852878861 | -0.01008826402 | 0.5280327166 | 0.7828614172 | 1 | 1 | 1
0 | 0 | 1 | -3.717082351 | -2.27272256 | -2.555288636 | -2.341853549 | 67.67363295 | 0.6966087737 | 0.6567911762 | -0.01194865443 | 1.299598403 | -0.4667003519 | -0.9525862689 | 0.6490964333 | -0.01194865443 | 0.7037842376 | 0.9428408039 | 0.001300811781 | 0.0005448748426 | 0.001146800733
0 | 0 | 2 | -3.889424719 | -2.391989539 | -2.600489998 | -2.377317677 | 67.67363295 | 0.7262463084 | 0.7508326039 | -0.01821406219 | 1.490674854 | -0.5151913749 | -1.005853484 | 0.672101774 | -0.01821406219 | 0.799663995 | 1.033853935 | 0.00192705941 | 0.0007489208687 | 0.001617412484
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
