davinciucberkeley-collab/DBF-Combined/analysis/cfd3d/out_rev1/cases/L1_a4.0/history.csv

Time_Iter | Outer_Iter | Inner_Iter | "rms[P]" | "rms[U]" | "rms[V]" | "rms[W]" | "RefForce" | "CD" | "CL" | "CSF" | "CMx" | "CMy" | "CMz" | "CFx" | "CFy" | "CFz" | "CEff" | "Cauchy[CL]" | "Cauchy[CD]" | "Cauchy[CMy]"
0 | 0 | 0 | -3.920791116 | -2.759364906 | -3.493098264 | -3.336797394 | 67.67363295 | 0.6206952527 | 0.4859166259 | -0.01008806839 | 0.9632510434 | -0.3596566982 | -0.8589820766 | 0.5852874399 | -0.01008806839 | 0.5280304695 | 0.782858615 | 1 | 1 | 1
0 | 0 | 1 | -3.819139195 | -2.363802301 | -2.602671122 | -2.390122352 | 67.67363295 | 0.6871092062 | 0.6504939439 | -0.01302294335 | 1.288381053 | -0.4609287775 | -0.9385061787 | 0.640059279 | -0.01302294335 | 0.6968396886 | 0.9467111458 | 0.001265018065 | 0.0004832852834 | 0.001098565378
0 | 0 | 2 | -3.910490558 | -2.434036767 | -2.627422676 | -2.403130815 | 67.67363295 | 0.6920991692 | 0.7162010718 | -0.01825547267 | 1.422767129 | -0.489684003 | -0.9585433266 | 0.6404535892 | -0.01825547267 | 0.7627348396 | 1.034824348 | 0.001723737903 | 0.0005193347632 | 0.001392175393
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
