davinciucberkeley-collab/DBF-Combined/analysis/cfd3d/out_rev1/cases/L2_a6.0/history.csv

Time_Iter | Outer_Iter | Inner_Iter | "rms[P]" | "rms[U]" | "rms[V]" | "rms[W]" | "RefForce" | "CD" | "CL" | "CSF" | "CMx" | "CMy" | "CMz" | "CFx" | "CFy" | "CFz" | "CEff" | "Cauchy[CL]" | "Cauchy[CD]" | "Cauchy[CMy]"
0 | 0 | 0 | -1.933115079 | -0.6652121189 | -1.291025873 | -0.1787663906 | 67.67363295 | 0.05692148943 | 0.4477894287 | 0.02022827159 | 0.8759253149 | -0.05783205969 | -0.03769829841 | 0.009802926701 | 0.02022827159 | 0.4512863072 | 7.866790438 | 1 | 1 | 1
0 | 0 | 1 | -2.08569134 | -0.8250965906 | -1.528299373 | -0.3237352315 | 67.67363295 | 0.05692149487 | 0.4477895237 | 0.02022827752 | 0.8759253014 | -0.05783232745 | -0.03769827654 | 0.009802922183 | 0.02022827752 | 0.4512864023 | 7.866791354 | 1.061171004e-09 | 2.722967667e-10 | 1.338771875e-08
0 | 0 | 2 | -2.190288814 | -0.9249875011 | -1.416877598 | -0.4060451824 | 67.67363295 | 0.05692152072 | 0.4477896603 | 0.0202282658 | 0.8759252902 | -0.05783271017 | -0.0376983048 | 0.009802933609 | 0.0202282658 | 0.4512865408 | 7.866790182 | 2.586416179e-09 | 1.56459475e-09 | 3.252371922e-08
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
