davinciucberkeley-collab/DBF-Combined/analysis/cfd3d/out_rev1/cases/L2_a8.0/history.csv

Time_Iter | Outer_Iter | Inner_Iter | "rms[P]" | "rms[U]" | "rms[V]" | "rms[W]" | "RefForce" | "CD" | "CL" | "CSF" | "CMx" | "CMy" | "CMz" | "CFx" | "CFy" | "CFz" | "CEff" | "Cauchy[CL]" | "Cauchy[CD]" | "Cauchy[CMy]"
0 | 0 | 0 | -1.632229869 | -0.3613901191 | -0.9924583072 | 0.1214622561 | 67.67363295 | 0.07251444008 | 0.4455301161 | 0.02022827159 | 0.8759253149 | -0.0578320597 | -0.03769829841 | 0.009802926701 | 0.02022827159 | 0.4512863072 | 6.144019255 | 1 | 1 | 1
0 | 0 | 1 | -1.784842233 | -0.5217513862 | -1.23787768 | -0.02416670673 | 67.67363295 | 0.07251444884 | 0.4455302109 | 0.02022827752 | 0.8759253014 | -0.05783232745 | -0.03769827654 | 0.009802922183 | 0.02022827752 | 0.4512864023 | 6.14401982 | 1.063766389e-09 | 4.379647693e-10 | 1.338767835e-08
0 | 0 | 2 | -1.888851851 | -0.6199375294 | -1.117445295 | -0.1051592738 | 67.67363295 | 0.07251447944 | 0.4455303466 | 0.0202282658 | 0.8759252902 | -0.05783271017 | -0.0376983048 | 0.009802933604 | 0.0202282658 | 0.4512865408 | 6.144019098 | 2.585725465e-09 | 1.967591535e-09 | 3.25236011e-08
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
