davinciucberkeley-collab/DBF-Combined/analysis/cfd3d/out_rev1/cases/L3_a4.0/history.csv

Time_Iter | Outer_Iter | Inner_Iter | "rms[P]" | "rms[U]" | "rms[V]" | "rms[W]" | "RefForce" | "CD" | "CL" | "CSF" | "CMx" | "CMy" | "CMz" | "CFx" | "CFy" | "CFz" | "CEff" | "Cauchy[CL]" | "Cauchy[CD]" | "Cauchy[CMy]"
0 | 0 | 0 | -4.526030417 | -3.418856273 | -4.053648891 | -3.898207021 | 67.67363295 | 0.6774216731 | 0.5036403032 | -0.008149997323 | 1.003552155 | -0.3708762622 | -0.9441967376 | 0.6406393364 | -0.008149997323 | 0.5496680079 | 0.7434664747 | 1 | 1 | 1
0 | 0 | 1 | -4.518568198 | -3.089289652 | -3.339574034 | -3.118942099 | 67.67363295 | 0.797131412 | 0.674732569 | -0.01003054577 | 1.340436921 | -0.4833087405 | -1.095535596 | 0.7481226752 | -0.01003054577 | 0.7286940308 | 0.8464508597 | 0.001267852433 | 0.0007508783187 | 0.001163153786
0 | 0 | 2 | -4.610444617 | -3.144042502 | -3.366966462 | -3.146932289 | 67.67363295 | 0.8346996752 | 0.7538980542 | -0.01358792262 | 1.497351221 | -0.5305135144 | -1.148416825 | 0.780077119 | -0.01358792262 | 0.8102873024 | 0.9031967743 | 0.001792893482 | 0.0009759189192 | 0.001608050783
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
