davinciucberkeley-collab/DBF-Combined/analysis/cfd3d/out/scheme2d/3D-L3/a0/history.csv

Time_Iter | Outer_Iter | Inner_Iter | "rms[P]" | "rms[U]" | "rms[V]" | "RefForce" | "CD" | "CL" | "CSF" | "CMx" | "CMy" | "CMz" | "CFx" | "CFy" | "CFz" | "CEff" | "Cauchy[CL]" | "Cauchy[CD]" | "Cauchy[CMz]"
0 | 0 | 0 | -2.647565219 | -1.559123178 | -1.861446121 | 63.88919145 | 0.3981511827 | 0.02715798521 | 0 | 0 | 0 | 0.0939207075 | 0.3981511827 | 0.02715798521 | 0 | 0.06821023368 | 1 | 1 | 1
0 | 0 | 1 | -2.709678047 | -1.468811649 | -1.276741937 | 63.88919145 | 0.4086581455 | 0.03932151241 | 0 | 0 | 0 | 0.1099856861 | 0.4086581455 | 0.03932151241 | 0 | 0.09622104159 | 0.0006081763604 | 0.0001285544281 | 0.0007303213334
0 | 0 | 2 | -2.923472719 | -1.663898985 | -1.419229072 | 63.88919145 | 0.3932772106 | 0.03555807142 | 0 | 0 | 0 | 0.1074692147 | 0.3932772106 | 0.03555807142 | 0 | 0.09041477731 | 0.0007963484101 | 0.0003241026883 | 0.0008474000408
0 | 0 | 3 | -2.981831428 | -1.737681012 | -1.484668685 | 63.88919145 | 0.3578840867 | 0.0321893803 | 0 | 0 | 0 | 0.09976239993 | 0.3578840867 | 0.0321893803 | 0 | 0.08994359208 | 0.0009647829659 | 0.0008185801635 | 0.001232740781
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
