davinciucberkeley-collab/DBF-Combined/analysis/cfd3d/out/scheme2d/3D-L3/a4/history.csv

Time_Iter | Outer_Iter | Inner_Iter | "rms[P]" | "rms[U]" | "rms[V]" | "RefForce" | "CD" | "CL" | "CSF" | "CMx" | "CMy" | "CMz" | "CFx" | "CFy" | "CFz" | "CEff" | "Cauchy[CL]" | "Cauchy[CD]" | "Cauchy[CMz]"
0 | 0 | 0 | -2.625818216 | -1.517195331 | -1.858607587 | 63.88919145 | 0.4397103355 | 0.5633817566 | 0 | 0 | 0 | 0.2367561578 | 0.3993396986 | 0.5926820294 | 0 | 1.281256571 | 1 | 1 | 1
0 | 0 | 1 | -2.695671671 | -1.429535482 | -1.248163703 | 63.88919145 | 0.4587335706 | 0.6712142605 | 0 | 0 | 0 | 0.2805438173 | 0.4107945787 | 0.7015788526 | 0 | 1.463189755 | 0.000803264399 | 0.0002073451373 | 0.0007804067811
0 | 0 | 2 | -2.896185911 | -1.609046495 | -1.380006523 | 63.88919145 | 0.4422104475 | 0.6578175384 | 0 | 0 | 0 | 0.2731643839 | 0.3952462132 | 0.6870621694 | 0 | 1.487566705 | 0.000905091436 | 0.0003941693424 | 0.0009154799056
0 | 0 | 3 | -2.962619182 | -1.694217156 | -1.451530502 | 63.88919145 | 0.4031269186 | 0.6116568365 | 0 | 0 | 0 | 0.2528283356 | 0.3594778976 | 0.6382875835 | 0 | 1.517281055 | 0.001282432938 | 0.0008789239832 | 0.001317650973
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
