davinciucberkeley-collab/DBF-Combined/analysis/cfd3d/out/scheme2d/3D-L4/a0/history.csv

Time_Iter | Outer_Iter | Inner_Iter | "rms[P]" | "rms[U]" | "rms[V]" | "RefForce" | "CD" | "CL" | "CSF" | "CMx" | "CMy" | "CMz" | "CFx" | "CFy" | "CFz" | "CEff" | "Cauchy[CL]" | "Cauchy[CD]" | "Cauchy[CMz]"
0 | 0 | 0 | -2.802117814 | -1.713490889 | -2.015877356 | 63.88919145 | 0.4022307742 | 0.02768222907 | 0 | 0 | 0 | 0.0931910088 | 0.4022307742 | 0.02768222907 | 0 | 0.06882175817 | 1 | 1 | 1
0 | 0 | 1 | -2.870470245 | -1.625471697 | -1.441714936 | 63.88919145 | 0.4199269942 | 0.04001507342 | 0 | 0 | 0 | 0.1098649548 | 0.4199269942 | 0.04001507342 | 0 | 0.09529054804 | 0.0006166422174 | 0.0002107059117 | 0.0007588382503
0 | 0 | 2 | -3.072770853 | -1.80078127 | -1.578263676 | 63.88919145 | 0.4090753037 | 0.0363133481 | 0 | 0 | 0 | 0.1080687167 | 0.4090753037 | 0.0363133481 | 0 | 0.08876934825 | 0.0008017284832 | 0.0003433427438 | 0.0008419445432
0 | 0 | 3 | -3.137223354 | -1.88180289 | -1.649506863 | 63.88919145 | 0.3752495415 | 0.03325317424 | 0 | 0 | 0 | 0.1009645046 | 0.3752495415 | 0.03325317424 | 0 | 0.0886161622 | 0.0009547371764 | 0.0007940529845 | 0.001193761855
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
