davinciucberkeley-collab/DBF-Combined/analysis/cfd3d/out/scheme2d/3D-L4/a4/history.csv

Time_Iter | Outer_Iter | Inner_Iter | "rms[P]" | "rms[U]" | "rms[V]" | "RefForce" | "CD" | "CL" | "CSF" | "CMx" | "CMy" | "CMz" | "CFx" | "CFy" | "CFz" | "CEff" | "Cauchy[CL]" | "Cauchy[CD]" | "Cauchy[CMz]"
0 | 0 | 0 | -2.780348149 | -1.671559927 | -2.013030202 | 63.88919145 | 0.4437340174 | 0.5624825936 | 0 | 0 | 0 | 0.2354594259 | 0.4034163013 | 0.5920657346 | 0 | 1.267612064 | 1 | 1 | 1
0 | 0 | 1 | -2.856622259 | -1.5842347 | -1.413831601 | 63.88919145 | 0.4707321915 | 0.6705480855 | 0 | 0 | 0 | 0.2807777659 | 0.4228104416 | 0.7017512819 | 0 | 1.424478924 | 0.0008057997201 | 0.0002867678756 | 0.0008070143991
0 | 0 | 2 | -3.044848671 | -1.746215378 | -1.537900539 | 63.88919145 | 0.4585825317 | 0.6593812958 | 0 | 0 | 0 | 0.2747191213 | 0.4114693337 | 0.6897641765 | 0 | 1.437868323 | 0.00089047599 | 0.0004192375937 | 0.0009172842006
0 | 0 | 3 | -3.11780584 | -1.839978407 | -1.616287852 | 63.88919145 | 0.4214510066 | 0.6156689689 | 0 | 0 | 0 | 0.2557634309 | 0.3774774769 | 0.6435681663 | 0 | 1.460831649 | 0.00124547461 | 0.0008597576605 | 0.001287854973
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
