davinciucberkeley-collab/DBF-Combined/analysis/cfd3d/out/scheme2d/fine/a0/history.csv

Time_Iter | Outer_Iter | Inner_Iter | "rms[P]" | "rms[U]" | "rms[V]" | "RefForce" | "CD" | "CL" | "CSF" | "CMx" | "CMy" | "CMz" | "CFx" | "CFy" | "CFz" | "CEff" | "Cauchy[CL]" | "Cauchy[CD]" | "Cauchy[CMz]"
0 | 0 | 0 | -2.551943777 | -1.464585118 | -1.76471182 | 63.88919145 | 0.3922433792 | 0.03809698185 | 0 | 0 | 0 | 0.09610507615 | 0.3922433792 | 0.03809698185 | 0 | 0.09712587611 | 1 | 1 | 1
0 | 0 | 1 | -2.631136821 | -1.413580027 | -1.185964768 | 63.88919145 | 0.4026518434 | 0.0445313025 | 0 | 0 | 0 | 0.1121302561 | 0.4026518434 | 0.0445313025 | 0 | 0.1105950543 | 0.0003217160324 | 0.0001292489334 | 0.0007145787652
0 | 0 | 2 | -2.831284513 | -1.5939769 | -1.319445071 | 63.88919145 | 0.3866253334 | 0.03651905073 | 0 | 0 | 0 | 0.1084356297 | 0.3866253334 | 0.03651905073 | 0 | 0.09445591784 | 0.0007223286208 | 0.0003365104424 | 0.0008849391168
0 | 0 | 3 | -2.876176285 | -1.632873853 | -1.371193521 | 63.88919145 | 0.3488368887 | 0.0335625285 | 0 | 0 | 0 | 0.1002165812 | 0.3488368887 | 0.0335625285 | 0 | 0.09621267013 | 0.0008701547323 | 0.0008781453147 | 0.00129500342
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
