davinciucberkeley-collab/DBF-Combined/analysis/cfd3d/out/scheme2d/finest/a4/history.csv

Time_Iter | Outer_Iter | Inner_Iter | "rms[P]" | "rms[U]" | "rms[V]" | "RefForce" | "CD" | "CL" | "CSF" | "CMx" | "CMy" | "CMz" | "CFx" | "CFy" | "CFz" | "CEff" | "Cauchy[CL]" | "Cauchy[CD]" | "Cauchy[CMz]"
0 | 0 | 0 | -2.856781565 | -1.748741214 | -2.088519741 | 63.88919145 | 0.448459935 | 0.56746031 | 0 | 0 | 0 | 0.237418196 | 0.4077834789 | 0.5973609889 | 0 | 1.265353415 | 1 | 1 | 1
0 | 0 | 1 | -2.934310593 | -1.678010805 | -1.491258023 | 63.88919145 | 0.4768333823 | 0.6774349322 | 0 | 0 | 0 | 0.2840962001 | 0.4284163681 | 0.7090469501 | 0 | 1.420695273 | 0.0008116987842 | 0.0002975195148 | 0.0008215175721
0 | 0 | 2 | -3.120534617 | -1.838565404 | -1.613203022 | 63.88919145 | 0.4645764198 | 0.6636599447 | 0 | 0 | 0 | 0.2772167574 | 0.4171501575 | 0.6944505153 | 0 | 1.428526969 | 0.0009154792489 | 0.0004294349754 | 0.0009455981422
0 | 0 | 3 | -3.194556698 | -1.926748937 | -1.694765695 | 63.88919145 | 0.4280967815 | 0.6192484477 | 0 | 0 | 0 | 0.2579811633 | 0.3838573712 | 0.6476025115 | 0 | 1.446515074 | 0.001274071161 | 0.0008555026293 | 0.001318408194
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
