davinciucberkeley-collab/DBF-Combined/redesign/subsystems/flight-software/K09L.param

SERVO1_FUNCTION,33
SERVO2_FUNCTION,34
SERVO3_FUNCTION,35
SERVO4_FUNCTION,36
SERVO5_FUNCTION,77
SERVO6_FUNCTION,78
Q_M_PWM_TYPE,5
SERVO5_REVERSED,1
SERVO5_TRIM,1500
SERVO5_MIN,1003
SERVO5_MAX,1976
SERVO6_REVERSED,0
SERVO6_TRIM,1500
SERVO6_MIN,1024
SERVO6_MAX,1997
Q_M_SPIN_MAX,0.84
Q_M_BAT_CURR_MAX,100
Q_M_BAT_IDX,0
Q_M_BAT_CURR_TC,1
Q_M_BAT_VOLT_MAX,16.8
Q_M_BAT_VOLT_MIN,13.2
Q_M_SPIN_MIN,0.15
Q_M_THST_EXPO,0.65
Q_M_THST_HOVER,0.49
Q_A_ANGLE_MAX,30
Q_A_RATE_R_MAX,120
Q_A_RATE_P_MAX,120
Q_A_RATE_Y_MAX,90
Q_A_RAT_RLL_P,0.08
Q_A_RAT_RLL_I,0.08
Q_A_RAT_RLL_D,0.002
Q_A_RAT_RLL_FLTD,32
Q_A_RAT_PIT_P,0.08
Q_A_RAT_PIT_I,0.08
Q_A_RAT_PIT_D,0.002
Q_A_RAT_PIT_FLTD,32
Q_A_RAT_YAW_P,0.40
Q_A_RAT_YAW_I,0.04
INS_GYRO_FILTER,40
INS_HNTCH_ENABLE,1
INS_HNTCH_MODE,3
INS_HNTCH_REF,1
INS_HNTCH_FREQ,70
INS_HNTCH_BW,35
INS_HNTCH_HMNCS,7
BATT_MONITOR,4
BATT_VOLT_MULT,11.05
BATT_AMP_PERVLT,64
BATT_CAPACITY,6500
BATT_LOW_MAH,2600
BATT_CRT_MAH,1300
BATT_LOW_VOLT,14.0
BATT_CRT_VOLT,13.6
BATT_FS_VOLTSRC,1
BATT_FS_LOW_ACT,1
BATT_FS_CRT_ACT,4
BATT_ARM_VOLT,16.4
SERIAL6_PROTOCOL,23
FLTMODE_CH,6
FLTMODE1,17
FLTMODE2,18
FLTMODE3,19
FLTMODE4,5
FLTMODE5,7
FLTMODE6,11
SERIAL5_PROTOCOL,5
