davinciucberkeley-collab/DBF-Combined/redesign/team/B3/cfd/cases/L3_SA_dm10_a4/case.cfg

% B3 cfd_elevon.py: S5010 elevon -10 deg, alpha 4.0 deg, Re 260000, SA, mesh L3
SOLVER= INC_RANS
KIND_TURB_MODEL= SA

MATH_PROBLEM= DIRECT
RESTART_SOL= NO
INC_DENSITY_MODEL= CONSTANT
INC_DENSITY_INIT= 1.225
INC_VELOCITY_INIT= ( 11.970769, 0.837078, 0.0 )
INC_NONDIM= INITIAL_VALUES
VISCOSITY_MODEL= CONSTANT_VISCOSITY
MU_CONSTANT= 5.65384615e-05
FREESTREAM_TURBULENCEINTENSITY= 0.001
FREESTREAM_TURB2LAMVISCRATIO= 10.0
AOA= 4.0
REF_ORIGIN_MOMENT_X= 0.25
REF_ORIGIN_MOMENT_Y= 0.0
REF_ORIGIN_MOMENT_Z= 0.0
REF_LENGTH= 1.0
REF_AREA= 1.0
MARKER_HEATFLUX= ( airfoil, 0.0 )
MARKER_FAR= ( farfield )
MARKER_PLOTTING= ( airfoil )
MARKER_MONITORING= ( airfoil )
NUM_METHOD_GRAD= WEIGHTED_LEAST_SQUARES
CFL_NUMBER= 0.5
CFL_ADAPT= YES
CFL_ADAPT_PARAM= ( 0.5, 1.2, 1.0, 10.0 )
ITER= 8000
LINEAR_SOLVER= FGMRES
LINEAR_SOLVER_PREC= LU_SGS
LINEAR_SOLVER_ERROR= 1E-5
LINEAR_SOLVER_ITER= 10
CONV_NUM_METHOD_FLOW= FDS
MUSCL_FLOW= YES
SLOPE_LIMITER_FLOW= VENKATAKRISHNAN
VENKAT_LIMITER_COEFF= 0.05
LIMITER_ITER= 1500
TIME_DISCRE_FLOW= EULER_IMPLICIT
CONV_NUM_METHOD_TURB= SCALAR_UPWIND
MUSCL_TURB= NO
TIME_DISCRE_TURB= EULER_IMPLICIT
CONV_FIELD= ( RMS_PRESSURE, LIFT, MOMENT_Z )
CONV_RESIDUAL_MINVAL= -9
CONV_STARTITER= 300
CONV_CAUCHY_ELEMS= 200
CONV_CAUCHY_EPS= 2E-6
MESH_FILENAME= s5010_d-10_L3.su2
MESH_FORMAT= SU2
TABULAR_FORMAT= CSV
CONV_FILENAME= history
SURFACE_FILENAME= surface_flow
OUTPUT_FILES= ( SURFACE_CSV )
OUTPUT_WRT_FREQ= 100000
HISTORY_OUTPUT= ( ITER, RMS_RES, AERO_COEFF, CAUCHY )
SCREEN_OUTPUT= ( INNER_ITER, RMS_PRESSURE, LIFT, DRAG, MOMENT_Z )
SCREEN_WRT_FREQ_INNER= 200
