davinciucberkeley-collab/DBF-Combined/redesign/team/F2/harness.py

"""F2 harness engineer: K09-L wire list, routes through the structure, installation checks, mass and CG.

Run (from the repo root):
    python -I redesign/team/F2/harness.py           # route, check, write every output below, emit claims
    python -I redesign/team/F2/harness.py --check   # exit 1 if a generated file is stale or an install rule fails
then python -I redesign/fusion/check.py ; python -I redesign/interfaces/merge_check.py ;
     python -I redesign/proofs/build_graph.py

Inputs (read, never typed twice): params/params.json (A1), subsystems/fins/{params,interfaces}.json (D3),
subsystems/pod/{params,interfaces}.json (D2), subsystems/propulsion/interfaces.json (E1), team/D3/claims.json
(motor face), subsystems/wing/s5010.dat (B2), the F1/F3/F4/F5 change requests quoted in RULES below.

Outputs (generated; edit this script, not them):
    subsystems/harness/params.json       rules, groove spec, wire table (route polylines), fittings, CAD bundles
    subsystems/harness/WIRE-LIST.csv     one row per physical wire
    subsystems/harness/interfaces.json   HRN parts + every edge whose two parts are declared somewhere
    subsystems/harness/edges-pending.json  edges waiting for the other side's part declaration (WNG/PWR/AVN/MEC)
    subsystems/harness/parts.csv         3 lumped bundle parts + bought consumables (0 g lines, mass in the bundles)
    team/F2/mass_estimate.csv            A3 mass_model.csv columns, one row per item group
    team/F2/claims.json                  proofkit claims
    team/F2/fig-hrn-01-route.svg         route, right half (top view + fin outboard face)

Geometry model: every wire is a polyline of points [x, y, z, code] in the aircraft frame (README): code is the
support of the segment that LEAVES the point: G groove (continuous), P pod floor/wall (tied/taped <= 0.08 m),
B fin board face (tape strips <= 0.05 m), L liner (straw, leg bore, grommet), M mast/handle (tied), F free air,
T tie point (a support; the segment after it is free air), E end. Cut length = path x helix factor (twisted segments) + service loop. Corners are checked for the largest
fillet radius the neighbouring segments allow (a polyline vertex is a bend, not a kink).
Python 3 standard library only.
"""
import argparse
import csv
import io
import json
import math
import sys
from pathlib import Path

HERE = Path(__file__).resolve().parent
RED = HERE.parents[1]
SUB = RED / "subsystems" / "harness"
sys.path.insert(0, str(RED / "proofs"))
import proofkit as pk  # noqa: E402

kit = pk.Kit(__file__, params=["../../params/params.json", "../../subsystems/harness/params.json"])

STATIONS = ("UR", "UL", "LR", "LL")
GEN_NOTE = "GENERATED by redesign/team/F2/harness.py - edit the script, not this file"

# Connector points the wires end on (aircraft frame, m), as the owning roles published them. The wire ends must lie on
# their parts (fusion/check.py touch check); a change here is a change request from that role, quoted in `src`.
PORTS = {
    # F1 PWR-R1 stack (CR-F1-18)
    "pack_mate": ((0.031, -0.046, 0.046), "CR-F1-18: AS150U mating face"),
    "as150u_cups": ((0.0025, -0.040, 0.046), "CR-F1-18: AS150U aircraft-half solder cups x 0.002"),
    "board_in": ((-0.0105, -0.040, 0.0478), "CR-F1-18: power-board input pads, aft edge x -0.010, z 0.0486"),
    "board_out": ((-0.0105, -0.052, 0.0478), "CR-F1-18: power-board output pads, aft edge"),
    "bars_end": ((-0.0105, -0.046, 0.0245), "CR-F1-18: aft end of the bus bars, z 0.024"),
    "bars_out": ((-0.005, -0.0464, 0.024), "CR-F1-18: bars (+ y -0.0499, - y -0.0429), ESC pigtails (D-74)"),
    "pdb_link": ((-0.0612, -0.034, 0.0506), "D-89: rear of the ribbon plug on the PDB board-to-board header (power.py "
                 "PWR-003 'board-link header', fore face x -0.0615, top-face forward-inboard corner); pin map at "
                 "BOARD-CHECK.md step 4"),
    # F3 avionics ports (CR-F3-16, ASM-F3-PORTS +/- 10 mm). D-89: each is a drawn termination on the board part
    # (subsystems/avionics/fusion/avionics.py): the point is 0.3 mm inside the plug's rear face / on the solder joint
    "fc_aft": ((0.0188, 0.0358, 0.029325), "D-89: rear of the mated JST-GH 6 plug (GPS + I2C) on the FC aft edge, "
               "cable leaves +x (avionics.py gh_side, fc_ports.gps_y)"),
    "fc_fore": ((-0.0388, 0.0355, 0.029325), "D-89: rear of the mated JST-GH 4 plug (SERIAL6) on the FC fore edge, "
                "cable leaves -x"),
    "fc_link": ((-0.021, 0.0393, 0.0236), "D-89: inboard face (y 0.039) of the W-PMOD header + ribbon plug under the "
                "FC (avionics.py fc_link_m)"),
    "fc_out": ((0.0150, 0.0565, 0.0272), "D-89: FC output field, PCB top z 0.0272; rows S / Vx / G at x 0.0150 / "
               "0.01246 / 0.00992, output n at y 0.0565 + 0.00254 (n - 5) (avionics params fc_out_field)"),
    "gps": ((0.08481, 0.0, 0.18690), "D-89: rear of the mated JST-GH 6 plug on the GPS module's aft-upper end face, "
            "cable leaves along (0.7071, 0, 0.7071)"),
    "rx": ((-0.0445, -0.0470, 0.0265), "D-89: RX solder pads (x -0.0475 ... -0.0415 at 2 mm, y -0.048 ... -0.045, "
           "joint top z 0.0261): the four conductors lie on them"),
    "aspd": ((-0.0552, -0.04636, 0.027875), "D-89: rear of the mated JST-GH 4 plug on the sensor's aft face (x "
             "-0.0549), cable leaves +x"),
}
FC_OUT_ROWS = {"S": 0.0150, "V": 0.01246, "G": 0.00992}      # D-89: hole x per row (avionics.py fc_holes)
FC_OUT_Y = lambda n: 0.0565 + 0.00254 * (n - 5)              # hole y of output n
FC_PCB_TOP, FC_JOINT_H = 0.0272, 0.0005                      # PCB top z, solder joint height (avionics params)
GPS_PLUG_DIR = (0.70711, 0.0, 0.70711)                       # cable direction out of the GPS plug
PORT_LIST = [[k, list(v[0])] for k, v in PORTS.items()]
XT30 = {}                     # station -> (XT30U centre [x, y, z], path length bars -> centre m); filled by build()
GROM = {}                     # station -> (hole centre [x, y, z], outboard sign); filled by build() (D-83)
BAR_X0, BAR_Y, BAR_TOP = -0.0075, -0.04635, 0.0255   # F1 bus bars (PWR-004): aft-most pad x (D-87: bars 35 mm,
#                                                     x -0.0385 ... -0.0035), centre y between the
#                                                     + / - bars (y -0.0499 / -0.0429), top z (power CAD)
P1S_DX = 0.0045              # D-85: P1s signal pass-through, ahead of the signal-groove line (1.25 mm foam wall)
PIG_PITCH = 0.003            # FC output plugs along the aft edge (servo plug 2.54 mm + housing)
PWR_EDGE = dict(zip(("UR", "UL", "LR", "LL"), ("E-HRN-13", "E-HRN-14", "E-HRN-15", "E-HRN-16")))   # power pair per station
# HRN-110 fin-hole grommet (D-83, drawn as parts HRN-110-<st>): printed ASA, "10/7 x 12": flange OD 10, bore 7, overall
# 12 mm; barrel 7.9 mm in the 8 mm D3 hole (CR-D3-23), flange on the outboard face, 1.2 mm lip proud of the inboard
# face; CA'd in (BUILD step 4). Sizes are the G3 print proposal, UNVERIFIED until the first print.
GROM_DIM_M = {"flange_od": 0.010, "barrel_od": 0.0079, "bore": 0.007, "length": 0.012, "flange_t": 0.0012}
GROM_G = 0.50                 # g each, EST (the value the fittings table carried before D-83)
GROM_EDGES = ("E-HRN-42", "E-HRN-43", "E-HRN-44", "E-HRN-45")      # HRN-110-<st> bonded in FIN-001-<st> (D-83)
# Amass XT30U mated pair (manual, manufacturer's drawing: length 20.1 +/- 0.5, height across the two contacts
# 10.2 +/- 0.3 mm; housing thickness 5.2 mm from the Amass listing, UNVERIFIED): [along the wire, across the pins, thick]
XT30_SIZE_M = (0.0201, 0.0102, 0.0052)
XT30_G = 2.0                  # g per mated pair with adhesive heat-shrink (resellers 1.7 g bare), EST
# D-86: JR servo connectors (BOM HRN-105) drawn as parts HRN-105-<n> (tray, FC output n) and HRN-105-S<L|R> (servo
# recess). Pololu dimension drawings, checked 2026-11-11 (https://www.pololu.com/product/1925/pictures): male shroud
# 18.00 x 10.30 x 4.00 mm, female housing 14.00 x 7.90 x 2.75 mm, 2.54 mm pitch. Mated, JR_TAIL_M of the female
# shows behind the shroud: EST (the drawings give no insertion depth). [along the wire, across the pins, thickness]
JR_SHROUD_M = (0.0180, 0.0103, 0.0040)
JR_FEMALE_M = (0.0140, 0.0079, 0.00275)
JR_TAIL_M = 0.006
JR_G = 0.50                   # g per tray pair, EST (the value the fittings table carried before D-86)
JR_SRV_G = 0.25               # g per recess female + contacts, EST (the male is on the servo's own lead, MEC-001)
JR_PITCH = 0.0045             # tray row pitch: pairs on edge (4.0 mm thick), 0.5 mm apart
JR_RECESS_D = 0.005           # subsystems/wing/params.json#jr_recess.depth_m
SLEEVE = {}                   # D-88: part id -> heat-shrink sleeve at a soldered wire end (HRN-107-*), filled by build()
SLEEVE_RHO = 1.3              # g/cm3, polyolefin heat-shrink, EST
SLEEVE_EDGE0 = 54             # E-HRN-54... one per sleeve
JR = {}                       # part id -> {"x": [front, female/shroud, end], "y", "zb": [at mid, at end], "orient", "wire"}
JR_EDGES = tuple("E-HRN-%02d" % i for i in range(46, 54))   # HRN-105-1..6, HRN-105-SL, HRN-105-SR (D-86)
STRAND_FIX = {}               # wire row id -> function(strands) -> strands: conductors that leave the pair (D-86)
OTHER_FORMED = ("W-PACK", "W-MAIN-1", "W-MAIN-2")
BEND_K = [[8, 5.0], [10, 3.0], [16, 4.0], [20, 4.0], [22, 3.0], [26, 3.0], [28, 3.0]]


def add_sleeve(pid, start, axis_dir, sign, length, r_in, r_out, wire, also=()):
    """D-89: a heat-shrink sleeve part (HRN-107-*) along X, Y or Z from `start` (sign: +1 / -1), shrunk on `wire`;
    `also`: other wires that run through it (a Y-splice holds two cables). Mass = pi (r_out^2 - r_in^2) L rho."""
    k = "XYZ".index(axis_dir)
    cg = list(start)
    cg[k] += sign * length / 2
    SLEEVE[pid] = {"start": list(start), "axis": sign, "dir": axis_dir, "length": length, "r_in": r_in,
                   "r_out": r_out, "wire": wire, "also": list(also),
                   "mass_g": math.pi * (r_out ** 2 - r_in ** 2) * length * SLEEVE_RHO * 1e6, "cg": cg}


def port(name, dy=0.0, dz=0.0, dx=0.0):
    x, y, z = PORTS[name][0]
    return [x + dx, y + dy, z + dz]

# ============================================================================ pure calculations (proof chain)
# A wire-table row: [wire_id, edge_id, awg, n_cond, twisted, lay_m, loop_m, gpm, factory_m, points]
# points: [[x, y, z, code], ...]


def seg_len(points):
    return [math.dist(a[:3], b[:3]) for a, b in zip(points, points[1:])]


def helix(od_mm, lay_m):
    """Length factor of a conductor in a twisted pair: helix of diameter = conductor OD, pitch = lay length."""
    return math.sqrt(1.0 + (math.pi * od_mm / 1000.0 / lay_m) ** 2) if lay_m else 1.0


def path_len(row, od_table):
    """Cut length of one conductor (m) and the harness-supplied length (cut minus factory lead)."""
    _wid, _eid, awg, _n, tw, lay, loop, _gpm, factory, pts = row
    od = dict((int(a), b) for a, b in od_table).get(int(awg), 1.0)
    L = 0.0
    for s, a in zip(seg_len(pts), pts):
        L += s * (helix(od, lay) if tw and a[3] in ("P", "B", "M", "L") else 1.0)
    cut = L + loop
    return cut, max(0.0, cut - factory)


def lengths(wires, od):
    """Routed lengths the other roles asked for (F1 ESC leads, F3 I2C, F5 RX, E1 phase reach, F1 main path)."""
    by = {r[0]: r for r in wires}
    cut = {k: path_len(r, od)[0] for k, r in by.items()}
    out = {}
    for st in STATIONS:
        out["esc_" + st] = cut["W-PWR-" + st]
        out["phase_reach_" + st] = cut["W-PH-" + st]
        out["dshot_" + st] = cut["W-SIG-" + st + "-P"] + cut["W-SIG-" + st]
    out["esc_max"] = max(out["esc_" + s] for s in STATIONS)
    out["esc_min"] = min(out["esc_" + s] for s in STATIONS)
    out["phase_reach_max"] = max(out["phase_reach_" + s] for s in STATIONS)
    out["dshot_max"] = max(out["dshot_" + s] for s in STATIONS)
    out["main_path"] = cut["W-MAIN-1"] + cut["W-MAIN-2"]
    out["main_1"], out["main_2"] = cut["W-MAIN-1"], cut["W-MAIN-2"]
    out["i2c_total"] = cut["W-GPS"] + cut["W-ASPD"]
    out["rx"] = cut["W-RX"]
    out["servo_max"] = max(sum(cut.get("W-SRV-%s%s" % (s, e), 0.0) for e in ("-P", "", "-S")) for s in "LR")
    out["cap_lead_max"] = max(cut["W-CAP-" + s] for s in STATIONS)
    out["pmod"] = cut["W-PMOD"]
    out["servo_own_max"] = max(cut.get("W-SRV-%s-S" % s, 0.0) for s in "LR")
    return out


def mass_points(wires, od, fittings):
    """Harness mass as point masses (g, [x, y, z]): wire mass spread along each segment in <= 10 mm pieces (service
    loop split to both ends), fittings at their stations. Rows with gpm 0 are carried by another subsystem (pack
    lead: pack; 10 AWG main jumpers and cap legs: power; servo's own lead: mechanisms)."""
    out = []
    for row in wires:
        _wid, _eid, awg, n, tw, lay, loop, gpm, factory, pts = row
        if not gpm:
            continue
        cut, supplied = path_len(row, od)
        if supplied <= 0:
            continue
        k = supplied / cut                                    # factory lead: harness supplies only part of it
        segs = seg_len(pts)
        tot = sum(segs) or 1.0
        for s, a, b in zip(segs, pts, pts[1:]):
            npc = max(1, math.ceil(s / 0.010))
            for j in range(npc):
                t = (j + 0.5) / npc
                out.append((gpm * n * s / tot * (cut - loop) * k / npc, [a[i] + t * (b[i] - a[i]) for i in range(3)]))
        out.append((gpm * n * loop * k / 2, list(pts[0][:3])))
        out.append((gpm * n * loop * k / 2, list(pts[-1][:3])))
    for _name, qty, g_each, x, y, z in fittings:
        out.append((qty * g_each, [x, y, z]))
    return out


def mass_cg(wires, od, fittings, pod_box):
    """Harness mass (g) and CG, total and per bundle part (HRN-001 inside the pod box, HRN-002-R/L outside)."""
    groups = {"HRN-001": [0.0, 0.0, 0.0, 0.0], "HRN-002-R": [0.0, 0.0, 0.0, 0.0], "HRN-002-L": [0.0, 0.0, 0.0, 0.0]}
    for m, p in mass_points(wires, od, fittings):
        g = bundle_of(p, pod_box)
        groups[g][0] += m
        for i in range(3):
            groups[g][i + 1] += m * p[i]
    total = sum(v[0] for v in groups.values())
    cg = [sum(v[i + 1] for v in groups.values()) / total for i in range(3)]
    parts = {k: {"mass_g": v[0], "cg": [v[i + 1] / v[0] for i in range(3)] if v[0] else None}
             for k, v in groups.items()}
    return total, cg, parts


def bundle_of(p, pod_box):
    (x0, x1), ymax, z0 = pod_box
    if x0 - 0.001 <= p[0] <= x1 + 0.0015 and abs(p[1]) <= ymax + 0.0005 and p[2] >= z0 - 0.001:
        return "HRN-001"
    return "HRN-002-R" if p[1] >= 0 else "HRN-002-L"


BUNDLE_RHO_G_M3 = 3.0e6        # mean density of a silicone-wire bundle (16 AWG pair: 32 g/m in about 10.6 mm2), EST
LEG_DIA_M = (0.002, 0.012)     # CAD bundle-leg diameter clamp


def _seg_dist(p, a, b):
    d = [b[i] - a[i] for i in range(3)]
    L2 = sum(v * v for v in d) or 1e-12
    t = max(0.0, min(1.0, sum((p[i] - a[i]) * d[i] for i in range(3)) / L2))
    return math.dist(p, [a[i] + t * d[i] for i in range(3)])


def bodies(wires, od, fittings, pod_box, legs):
    """CAD bundle legs sized by the harness mass nearest to each (right side only; the left bundle is its mirror):
    d = sqrt(4 m / (pi L rho)), clamped. Returns the legs with their diameters, each bundle's body centroid (the
    volume centroid fusion/check.py measures) and its gap to the wire-mass CG."""
    key_of = {"HRN-001": "pod", "HRN-002-R": "side_R"}
    m_leg = {k: [0.0] * len(v) for k, v in legs.items()}
    for m, p in mass_points(wires, od, fittings):
        k = key_of.get(bundle_of(p, pod_box))
        if k is None:                                          # left side: the body is the mirror of the right
            continue
        i = min(range(len(legs[k])), key=lambda j: _seg_dist(p, legs[k][j][0], legs[k][j][1]))
        m_leg[k][i] += m
    out, cgb = {}, {}
    for k, v in legs.items():
        rows, vol, mom = [], 0.0, [0.0, 0.0, 0.0]
        for (a, b, *_d), m in zip(v, m_leg[k]):
            L = math.dist(a, b) or 1e-6
            d = min(LEG_DIA_M[1], max(LEG_DIA_M[0], math.sqrt(4 * m / (math.pi * L * BUNDLE_RHO_G_M3))))
            rows.append([a, b, d])
            vv = d * d * L
            vol += vv
            for i in range(3):
                mom[i] += vv * (a[i] + b[i]) / 2
        out[k] = rows
        cgb[k] = [mom[i] / vol for i in range(3)]
    _m, _cg, parts = mass_cg(wires, od, fittings, pod_box)
    body = {"HRN-001": cgb["pod"], "HRN-002-R": cgb["side_R"],
            "HRN-002-L": [cgb["side_R"][0], -cgb["side_R"][1], cgb["side_R"][2]]}
    gap = {pid: math.dist(body[pid], parts[pid]["cg"]) for pid in body}
    return {"legs": out, "leg_mass_g": m_leg, "body_cg": body, "gap": gap, "cg_gap_max": max(gap.values())}


def bends(wires, od, k_table):
    """Smallest ratio (largest fillet radius the polyline allows / required radius) over every corner > 5 deg.
    Formed parts owned by another role are skipped: the 10 AWG main jumpers (F1 CL-PWR-BEND, 2 x OD formed before
    soldering), the pack's own lead (pack) and the cap legs (F1)."""
    kd = dict((int(a), b) for a, b in k_table)
    odd = dict((int(a), b) for a, b in od)
    worst = (1e9, "")
    for row in wires:
        wid, awg, pts = row[0], int(row[2]), row[9]
        if wid in OTHER_FORMED or wid.startswith("W-CAP-"):
            continue
        r_req0 = kd.get(awg, 3.0) * odd.get(awg, 1.0) / 1000.0
        segs = seg_len(pts)
        for i in range(1, len(pts) - 1):
            # D-86/87: a row that starts with "J" is soldered on its pad: its lead-off (the bend off the pad and the
            # bend at the top of the rise) is formed on the bench and never flexed, so it may be 2 x OD (F1
            # ASM-PWR-BEND, the same rule as the formed main jumpers); the same for the last bend into a "J" end
            r_req = 2.0 * odd.get(awg, 1.0) / 1000.0 if ((i in (1, 2) and pts[0][3] == "J") or   # lead-off: pad
                                                          #   bend and the top of the rise, both bench-formed
                                                          (i == len(pts) - 2 and pts[-1][3] == "J")) else r_req0
            a, b, c = (pts[i - 1][:3], pts[i][:3], pts[i + 1][:3])
            u = [b[j] - a[j] for j in range(3)]
            v = [c[j] - b[j] for j in range(3)]
            nu, nv = math.hypot(*u), math.hypot(*v)
            if nu < 1e-9 or nv < 1e-9:
                continue
            cosang = max(-1.0, min(1.0, sum(u[j] * v[j] for j in range(3)) / nu / nv))
            th = math.acos(cosang)
            if th < math.radians(5):
                continue
            t_prev = segs[i - 1] * (1.0 if i - 1 == 0 else 0.5)
            t_next = segs[i] * (1.0 if i + 1 == len(pts) - 1 else 0.5)
            r_max = min(t_prev, t_next) / math.tan(th / 2)
            ratio = r_max / r_req
            if ratio < worst[0]:
                worst = (ratio, "%s corner %d (%.0f deg, r_max %.1f mm, needs %.1f mm)" % (
                    wid, i, math.degrees(th), r_max * 1000, r_req * 1000))
    return worst


def free_span(wires):
    """Longest run of consecutive free-air (F) segments, and longest tape-strip (B) segment between strips."""
    worst_f, worst_b = 0.0, 0.0
    for row in wires:
        pts, run = row[9], 0.0
        for s, a in zip(seg_len(pts), pts):
            if a[3] in ("F", "T"):
                run = s if a[3] == "T" else run + s                # a tie point starts a new free span
                worst_f = max(worst_f, run)
            else:
                run = 0.0
    return worst_f


def mast_clear(wires, gps_xyz):
    """Nearest point of any wing-groove ESC power segment to the GPS mast top (F3: >= 0.12 m)."""
    best = 1e9
    for row in wires:
        if not row[0].startswith("W-PWR-"):
            continue
        for a, b in zip(row[9], row[9][1:]):
            if a[3] != "G":
                continue
            for t in [i / 20 for i in range(21)]:
                p = [a[j] + t * (b[j] - a[j]) for j in range(3)]
                best = min(best, math.dist(p, gps_xyz))
    return best


# ---- proofkit calculations: pure functions of named inputs
@kit.calc("CALC-F2-LENGTHS", title="Routed cut lengths per wire (path x helix + service loop)",
          equation="L_cut = sum(seg x helix(OD, lay) if twisted) + loop; helix = sqrt(1 + (pi OD / lay)^2)",
          inputs={"wires": "P:harness.wire_table", "od": "P:harness.wire_od_mm"},
          units={"od": "AWG,mm"}, output="esc_max")
def calc_lengths(wires, od):
    return lengths(wires, od)


@kit.calc("CALC-F2-PHASE-EXT", title="Phase extension = routed reach - factory motor lead - factory ESC lead",
          equation="ext = max(0, reach - L_motor - L_esc)",
          inputs={"reach": "CL-F2-PHASE-REACH", "leads": "ASM-F2-FACTORY-LEADS"}, output="ext")
def calc_phase_ext(reach, leads):
    return {"ext": max(0.0, reach - leads[0] - leads[1])}


@kit.calc("CALC-F2-MASS", title="Harness mass and CG (wire g/m x routed length + fittings at their stations)",
          equation="m = sum(gpm n L_supplied) + sum(fittings); CG = sum(m_i r_i) / m",
          inputs={"wires": "P:harness.wire_table", "od": "P:harness.wire_od_mm",
                  "fittings": "P:harness.fittings_table", "pod_box": "P:harness.pod_box",
                  "plugs": "P:harness.xt30u_table", "grommets": "P:harness.grommet_table",
                  "jrs": "P:harness.jr_table", "sleeves": "P:harness.sleeve_table"},
          units={"od": "AWG,mm"}, output="mass_g")
def calc_mass(wires, od, fittings, pod_box, plugs, grommets, jrs, sleeves):
    m, cg, parts = mass_cg(wires, od, fittings, pod_box)
    plugs = list(plugs) + list(grommets) + list(jrs) + list(sleeves)  # HRN-113-* (D-74), HRN-110-* (D-83), HRN-105-*,
    #                                                                   HRN-107-* (D-88)
    #                                                                   (D-86): own nodes
    mp = sum(q[1] for q in plugs)
    cgt = [(m * cg[i] + sum(q[1] * q[2 + i] for q in plugs)) / (m + mp) for i in range(3)]
    return {"mass_g": m + mp, "cg_x": cgt[0], "cg_y": cgt[1], "cg_z": cgt[2], "plugs_g": mp,
            "pod_g": parts["HRN-001"]["mass_g"], "side_g": parts["HRN-002-R"]["mass_g"]}


@kit.calc("CALC-F2-INSTALL", title="Installation geometry: bends, free spans, groove-to-mast distance",
          equation="r_max = min(tangent room) / tan(theta/2) >= k OD; free span; min |p - GPS|",
          inputs={"wires": "P:harness.wire_table", "od": "P:harness.wire_od_mm", "k": "P:harness.rules.bend_k",
                  "gps": "P:harness.ref.gps_top_xyz_m"},
          units={"od": "AWG,mm", "k": "AWG,-", "gps": "m"}, output="bend_ratio")
def calc_install(wires, od, k, gps):
    return {"bend_ratio": bends(wires, od, k)[0], "free_span": free_span(wires), "mast_clear": mast_clear(wires, gps)}


@kit.calc("CALC-F2-FILL", title="Fill of every pass (exits, crossing, straws, grommets)",
          equation="fill = sum(pi/4 OD_i^2) / opening area",
          inputs={"passes": "P:harness.passes", "od": "P:harness.wire_od_mm"}, units={"od": "AWG,mm"},
          output="fill_max")
def calc_fill(passes, od):
    odd = dict((int(a), b) for a, b in od)
    worst = 0.0
    for _name, area_mm2, contents in passes:
        a = sum(n * math.pi / 4 * odd[int(awg)] ** 2 for awg, n in contents)
        worst = max(worst, a / area_mm2)
    return {"fill_max": worst}


@kit.calc("CALC-F2-SERVO-V", title="Servo terminal voltage with both servos stalled (power-board servo BEC, D-74)",
          equation="V = V_bec - I_stall (2 (L - L_own) R'_22AWG + 2 L_own R'_26AWG + n_contacts R_c) - 2 I_stall "
                   "(L_link R'_28AWG + 2 R_c) (1/n_Vx + 1/n_GND)  (harness servo leads: + / - 22 AWG; servo's own lead "
                   "26 AWG; case S: both servos' current through the board link's Vx and GND conductors)",
          inputs={"L": "CL-F2-SERVO-LEN", "L_own": "CL-F2-SERVO-OWN-LEN", "I": "ASM-F1-SERVO-STALL",
                  "elec": "ASM-F2-SERVO-CIRCUIT", "L_link": "CL-F2-PMOD-LEN", "n": "ASM-F1-PMOD-CONDUCTORS"},
          units={"L": "m", "L_own": "m", "I": "A", "L_link": "m"}, output="v_servo")
def calc_servo_v(L, L_own, I, elec, L_link, n):
    v_bec, r22, n_contacts, r_contact, r28, r26 = elec
    _n5, nvx, ngnd = n
    link = 2 * I * (L_link * r28 + 2 * r_contact) * (1.0 / nvx + 1.0 / ngnd)
    lead = I * (2 * (L - L_own) * r22 + 2 * L_own * r26 + n_contacts * r_contact)
    return {"v_servo": v_bec - lead - link, "v_link_drop": link, "v_lead_drop": lead}


@kit.calc("CALC-F2-CAP-RIPPLE", title="ESC bus-cap leg current (E-HRN-34..37): AC ripple RMS, no DC",
          equation="I_esc,cont = I_hover / 4 x split_max; I_esc,peak = I_motor,max; "
                   "I_cap,rms = I_esc sqrt(D (1 - D)) <= 0.5 I_esc (worst D = 0.5, leads carry the DC)",
          inputs={"i_hover": "P:performance.hover_current_a", "split": "P:requirements.hover_split_max",
                  "i_max": "P:propulsion.current_max_per_motor_a"},
          units={"i_hover": "A", "split": "-", "i_max": "A"}, output="cap_rms_peak")
def calc_cap_ripple(i_hover, split, i_max):
    i_cont = i_hover / 4 * split
    return {"esc_cont": i_cont, "cap_rms_cont": 0.5 * i_cont, "cap_rms_peak": 0.5 * i_max}


@kit.calc("CALC-F2-BODIES", title="CAD bundle legs sized by the wire mass they carry; body centroid vs wire-mass CG",
          equation="d_leg = sqrt(4 m_leg / (pi L_leg rho)); cg_body = sum(d^2 L r_mid) / sum(d^2 L); gap = |cg_body - cg_wire|",
          inputs={"wires": "P:harness.wire_table", "od": "P:harness.wire_od_mm",
                  "fittings": "P:harness.fittings_table", "pod_box": "P:harness.pod_box",
                  "legs": "P:harness.cad.bundle_legs"},
          units={"od": "AWG,mm"}, output="cg_gap_max")
def calc_bodies(wires, od, fittings, pod_box, legs):
    r = bodies(wires, od, fittings, pod_box, legs)
    return {"cg_gap_max": r["cg_gap_max"], "gap_pod": r["gap"]["HRN-001"], "gap_side": r["gap"]["HRN-002-R"]}


# ---- sources, assumptions, claims, tests (declarations only; numbers come from the calcs and params)
kit.source("SRC-F2-HELIX", "Helix length of a twisted pair: L = sqrt(1 + (pi D / lay)^2) per unit axis length",
           "book", where="geometry of a circular helix, D = conductor-centre circle diameter = conductor OD")
kit.source("SRC-F2-MIL-HDBK-522", "NASA-STD-8739.4 / IPC/WHMA-A-620 practice: wire bend radius >= 3-10 x OD",
           "standard", url="https://www.ipc.org/TOC/IPC-WHMA-A-620E-TOC.pdf",
           where="A-620 Table 4-1: minimum bend radius 3 x OD unshielded (<= 10 AWG ... 6 x) ; F2 uses 3 / 4 / 5",
           note="table of contents and summary only; the full standard was not opened", status="UNVERIFIED")
kit.assumption("ASM-F2-WIRE-GPM", "Wire mass per conductor metre",
               "[AWG, g/m] silicone hook-up wire; 16 AWG = F1 CL-F1-ESC-MASS / 4.0 m, 20 AWG = F1 POWER.md",
               basis="maker tables (BNTECHGO-type silicone) +/-10 %; weigh 1 m of each reel (T-F2-WEIGH)",
               value=[[16, 16.15], [20, 6.6], [22, 4.0], [26, 1.8], [28, 1.1]], unit="AWG,g/m", status="UNVERIFIED",
               cites=["CL-F1-ESC-MASS"])
kit.assumption("ASM-F2-FACTORY-LEADS", "Factory phase-lead lengths",
               "[motor lead beyond the stator, ESC phase lead] in m; X3108S lead length is not published (E1), the "
               "LANRC ESC is taken as bare phase pads (worst case)",
               basis="E1 PROPULSION.md open item; measured at T-E1-MOTOR-RM on the first motor", value=[0.06, 0.0],
               unit="m", status="UNVERIFIED")
kit.assumption("ASM-F2-SERVO-CIRCUIT", "Servo supply circuit",
               "[servo-BEC set point V, 22 AWG Ohm/m (harness servo + / -), contacts in series per servo lead, Ohm "
               "per contact, 28 AWG Ohm/m (board link), 26 AWG Ohm/m (servo's own lead)]",
               basis="D-74: CoreWing power-board servo BEC on the 6 V jumper (F1 CL-F1-SERVO-BEC-RATING), reaching the "
                     "FC Vx header through the board link (W-PMOD, case S); 22 AWG 0.0530, 28 AWG 0.2128 and 26 AWG "
                     "0.1339 Ohm/m at 20 degC; 2 JR junctions x 2 contacts (+ and -), 10 mOhm each (typical crimp / "
                     "header contact)",
               value=[6.0, 0.0530, 4, 0.010, 0.2128, 0.1339], unit="V,Ohm/m,-,Ohm,Ohm/m,Ohm/m", status="UNVERIFIED")
kit.assumption("ASM-F2-DSHOT-MAX", "Longest DShot300 lead without termination",
               "0.7 m from FC pad to ESC, signal twisted with its ground",
               basis="common practice on wings and large quads; bidirectional DShot error rate checked on the bench "
                     "(T-F2-DSHOT)", value=0.7, unit="m", status="UNVERIFIED")
kit.assumption("ASM-F2-FC-PORTS", "FC and avionics connector points (F3 ASM-F3-PORTS, +/- 10 mm)",
               "FC aft edge (0.014, 0.046, 0.030): outputs 1-6, GPS (SERIAL5 + I2C), servo rail; FC fore edge "
               "(-0.034, 0.046, 0.030): SERIAL6 (RX), power-board port; GPS connector (0.081, 0, 0.183); RX pads "
               "(-0.0425, -0.046, 0.025); airspeed JST-GH (-0.060, -0.046, 0.026)",
               basis="team/F3/CHANGE-REQUESTS.md#CR-F3-16 (F3's placement, +/- 10 mm); CoreWing F405 Wing V2 pin-out "
                     "still unpublished: lengths move by about +/- 0.02 m", value=PORT_LIST, unit="m",
               status="UNVERIFIED")
kit.assumption("ASM-F2-PWR-STACK", "Power stack connector points (F1 PWR-R1 + D-74)",
               "AS150U mating face (0.031, -0.046, 0.046), cups x 0.002; power-board input and output pads at the board "
               "aft edge x -0.010, z 0.0486; 10 AWG output jumper down the deck window to the aft end of the bus bars "
               "(-0.0105, z 0.024); the four ESC pigtails leave the bars aft through the tunnel under the cradle "
               "(z 0.0198-0.0366) to an XT30U just inside each pod side exit; no fuse, no UBEC (D-74); board-to-board "
               "link contacts on the PDB top face at its forward-inboard corner (-0.058, -0.034), board 52 mm long "
               "(x -0.062 ... -0.010) on the 56 mm deck (KO-PWR-BOARD)",
               basis="team/F1/CHANGE-REQUESTS.md#CR-F1-18, subsystems/power/SPEC.md (PWR-R1, D-74 keep-out), "
                     "fusion/power.py layout", status="UNVERIFIED")
kit.assumption("ASM-F2-SERVO-POCKET", "Elevon servo station and lead path (lower pocket)",
               "servo in D6's lower-skin pocket (x 0.172-0.208, |y| 0.253-0.288); harness lead in the upper branch groove "
               "at |y| 0.285 to a JR in-line in an 18 x 10 x 5 mm recess (x 0.150-0.168, CR-F2-14), servo's own lead "
               "shortened to 0.040 m and re-terminated, down D1's 4 mm lead hole (x 0.173-0.177) to the case front",
               basis="team/D1/CHANGE-REQUESTS.md#CR-D1-06, team/D6/CHANGE-REQUESTS.md#CR-D6-05, "
                     "subsystems/wing/params.json#servo_pocket", status="UNVERIFIED")

kit.claim("CL-F2-ESC-LEN-MAX", "Longest routed ESC power lead (bus pad to ESC pad, incl. loops)", calc="CALC-F2-LENGTHS",
          output="esc_max", unit="m", parts=["PRP-002-UR", "PRP-002-LR"],
          how="Cut list in WIRE-LIST.csv; measure each lead on the dry fit (T-F2-FIT) before skinning",
          verifies=["R-HARNESS-INSTALL"], note="right side: the pairs cross the pod behind the aft stop")
kit.claim("CL-F2-ESC-LEN-MIN", "Shortest routed ESC power lead", calc="CALC-F2-LENGTHS", output="esc_min", unit="m",
          parts=["PRP-002-UL", "PRP-002-LL"], how="as CL-F2-ESC-LEN-MAX")
for _st in STATIONS:
    kit.claim("CL-F2-ESC-LEN-" + _st, "Routed ESC power lead " + _st, calc="CALC-F2-LENGTHS",
              output="esc_" + _st, unit="m", parts=["PRP-002-" + _st], how="T-F2-FIT dry fit, tape measure")
kit.claim("CL-F2-MAIN-LEN", "10 AWG AS150U-to-bus path per conductor (cups -> board -> bars)", calc="CALC-F2-LENGTHS",
          output="main_path", unit="m", limit=("<=", "P:harness.rules.main_path_max_m"),
          parts=["PWR-002", "PWR-003", "PWR-004"], how="Measure on the power-frame mock-up (T-F2-FIT, T-PWR-FIT)",
          verifies=["R-HARNESS-INSTALL"], note="10 AWG per CR-F1-18 (8 AWG cannot make the 24.8 mm drop)")
kit.claim("CL-F2-MAIN-1-LEN", "10 AWG jumper AS150U cups -> power-board input pads, per conductor incl. slack",
          calc="CALC-F2-LENGTHS", output="main_1", unit="m", parts=["PWR-002", "PWR-003"],
          how="T-PWR-FIT: cut, form, measure before soldering", note="F1 sized R and rise on 0.030 m (CR-F1-18)")
kit.claim("CL-F2-MAIN-2-LEN", "10 AWG jumper power-board output pads -> bus bars, per conductor incl. slack",
          calc="CALC-F2-LENGTHS", output="main_2", unit="m", parts=["PWR-003", "PWR-004"],
          how="T-PWR-FIT: cut, form, measure before soldering", note="F1 sized R and rise on 0.050 m (CR-F1-18)")
kit.claim("CL-F2-CAP-LEAD", "Longest ESC-cap lead (cap body to ESC power pad) incl. bend slack", calc="CALC-F2-LENGTHS",
          output="cap_lead_max", unit="m", limit=("<=", "P:harness.rules.cap_lead_max_m"),
          parts=["PRP-002-UR", "PWR-008-UR"], how="T-F2-FIT: measure each cap leg after forming, before soldering",
          verifies=["R-HARNESS-INSTALL"])
kit.claim("CL-F2-CAP-RIPPLE-CONT", "ESC bus-cap leg ripple current, hover (RMS, upper-bound D = 0.5)",
          calc="CALC-F2-CAP-RIPPLE", output="cap_rms_cont", unit="A", parts=["PWR-008-UR", "PRP-002-UR"],
          how="T-F1-RIPPLE: current probe on one cap leg at hover throttle, props on, tethered",
          note="current_a.cont of E-HRN-34..37; F1 checks the PWR-008 ripple rating against it")
kit.claim("CL-F2-CAP-RIPPLE-PEAK", "ESC bus-cap leg ripple current, per-motor max (RMS, upper-bound D = 0.5)",
          calc="CALC-F2-CAP-RIPPLE", output="cap_rms_peak", unit="A", parts=["PWR-008-UR", "PRP-002-UR"],
          how="T-F1-RIPPLE: current probe on one cap leg at full throttle burst (< 5 s)",
          note="current_a.peak of E-HRN-34..37; 22 AWG legs 11 mm long carry it with negligible rise")
kit.claim("CL-F2-I2C-LEN", "I2C bus total (FC to GPS + Y-branch to airspeed)", calc="CALC-F2-LENGTHS",
          output="i2c_total", unit="m", limit=("<=", "P:harness.rules.i2c_max_m"), parts=["AVN-001", "AVN-002", "AVN-004"],
          how="T-F3-I2C-SCAN with the routed cables; all three addresses found, no bus errors in 10 min")
kit.claim("CL-F2-RX-LEN", "RX lead FC to RP3 (JST-GH 4)", calc="CALC-F2-LENGTHS", output="rx", unit="m",
          limit=("<=", "P:harness.rules.rx_max_m"), parts=["AVN-003"], how="Measure the made lead")
kit.claim("CL-F2-PHASE-REACH", "Routed ESC-phase-pad to motor-lead-exit reach incl. loop", calc="CALC-F2-LENGTHS",
          output="phase_reach_max", unit="m", parts=["PRP-001-UR", "PRP-002-UR"],
          how="Hold the motor on its mount and the ESC on its pad, measure the reach (T-E1-MOTOR-RM)")
kit.claim("CL-F2-PHASE-EXT", "Phase extension needed per lead", calc="CALC-F2-PHASE-EXT", output="ext", unit="m",
          limit=("<=", "P:harness.rules.phase_ext_max_m"), parts=["PRP-001-UR"],
          how="T-E1-MOTOR-RM measures the factory leads; cut ext = reach - leads")
kit.claim("CL-F2-DSHOT-LEN", "Longest DShot lead FC pad to ESC", calc="CALC-F2-LENGTHS", output="dshot_max", unit="m",
          limit=("<=", "ASM-F2-DSHOT-MAX"), parts=["AVN-001"], how="T-F2-DSHOT bench: bdshot error rate < 1 %")
kit.claim("CL-F2-SERVO-LEN", "Longest servo lead FC pad to servo plug", calc="CALC-F2-LENGTHS", output="servo_max",
          unit="m", parts=["MEC-001-L", "MEC-001-R"], how="Measure the made lead")
kit.claim("CL-F2-SERVO-V", "Servo terminal voltage, both servos stalled", calc="CALC-F2-SERVO-V", output="v_servo",
          unit="V", limit=(">=", "P:harness.rules.servo_v_min"), parts=["MEC-001-L", "MEC-001-R"],
          how="T-F1-SERVO-STALL: measure at the servo plug with the servo stalled",
          note="D-74 case S: includes the board link's Vx / GND drop (CL-F2-SERVO-LINK-DROP, 4 Vx + 3 GND "
               "conductors); case U has no link cable. The servo + / - are 22 AWG from the FC pad to the wing recess "
               "(the 26 AWG leads gave 5.61 V)")
kit.claim("CL-F2-SERVO-LINK-DROP", "Board-link (W-PMOD) Vx + GND drop, both servos stalled", calc="CALC-F2-SERVO-V",
          output="v_link_drop", unit="V", parts=["PWR-003", "AVN-001"],
          how="BOARD-CHECK.md step 7 / T-F1-SERVO-STALL: Vx at the PDB contacts minus Vx at the FC header")
kit.claim("CL-F2-SERVO-LEAD-DROP", "Servo lead drop (harness 22 AWG + / -, servo's own 26 AWG lead, 4 JR contacts)",
          calc="CALC-F2-SERVO-V", output="v_lead_drop", unit="V", parts=["MEC-001-L", "MEC-001-R"],
          how="T-F1-SERVO-STALL: Vx at the FC header minus the voltage at the servo case, servo stalled")
kit.claim("CL-F2-SERVO-OWN-LEN", "Servo's own lead (MEC-001, shortened, 26 AWG) cut length", calc="CALC-F2-LENGTHS",
          output="servo_own_max", unit="m", parts=["MEC-001-L", "MEC-001-R"], how="Measure the re-terminated lead")
kit.claim("CL-F2-PMOD-LEN", "Power-board link ribbon PDB -> FC (case S), cut length", calc="CALC-F2-LENGTHS",
          output="pmod", unit="m", parts=["PWR-003", "AVN-001"],
          how="T-F2-FIT: lay the ribbon over the deck front edge and through the under-pack channel, measure")
kit.claim("CL-F2-MASS", "Harness mass (basic, wires + fittings, routed)", calc="CALC-F2-MASS", output="mass_g",
          unit="g", limit=("<=", "P:mass.allocation_g.harness"), parts=["HRN-001", "HRN-002-R", "HRN-002-L"],
          how="T-F2-WEIGH: weigh each made-up lead before installation", verifies=["R-HARNESS-INSTALL"])
kit.claim("CL-F2-CG-X", "Harness CG x", calc="CALC-F2-MASS", output="cg_x", unit="m",
          parts=["HRN-001", "HRN-002-R", "HRN-002-L"], how="from the weighed leads and their stations")
kit.claim("CL-F2-BEND", "Worst corner: allowed fillet radius / required radius (k x OD)", calc="CALC-F2-INSTALL",
          output="bend_ratio", unit="-", limit=(">=", 1.0), how="T-F2-FIT: no corner tighter than the rule",
          verifies=["R-HARNESS-INSTALL"])
kit.claim("CL-F2-FREE-SPAN", "Longest unsupported free-air span", calc="CALC-F2-INSTALL", output="free_span",
          unit="m", limit=("<=", "P:harness.rules.free_span_max_m"), verifies=["R-HARNESS-INSTALL"],
          how="T-F2-FIT: tape or tie at every support in WIRE-LIST.csv")
kit.claim("CL-F2-GROOVE-MAST", "ESC-lead grooves to the GPS mast top, nearest point", calc="CALC-F2-INSTALL",
          output="mast_clear", unit="m", limit=(">=", "P:harness.rules.groove_mast_min_m"), parts=["AVN-002"],
          how="Measure on the built wing; compassmot (H1)")
kit.claim("CL-F2-FILL", "Fullest pass (exit, crossing, straw, grommet)", calc="CALC-F2-FILL", output="fill_max",
          unit="-", limit=("<=", "P:harness.rules.fill_max"), how="T-F2-FIT: bundle passes without force")
kit.claim("CL-F2-CG-BODY", "Largest gap between a bundle's declared CG (CAD body centroid) and its wire-mass CG",
          calc="CALC-F2-BODIES", output="cg_gap_max", unit="m", limit=("<=", "P:harness.rules.cg_body_gap_max_m"),
          parts=["HRN-001", "HRN-002-R", "HRN-002-L"],
          how="python -I redesign/fusion/check.py: no cg WARN on HRN parts; T-F2-WEIGH stations",
          note="bundle legs sized by the wire mass each carries, so the body centroid stands for the wire mass")

kit.test("T-F2-FIT", "Dry fit of the whole harness on the wing and pod before skinning",
         ["CL-F2-ESC-LEN-MAX", "CL-F2-MAIN-LEN", "CL-F2-BEND", "CL-F2-FREE-SPAN", "CL-F2-FILL", "CL-F2-CAP-LEAD"],
         procedure="lay every lead in its groove/route, check supports, bends, loops and the pod passes; photo")
kit.test("T-F2-WEIGH", "Weigh 1 m of each reel and every made-up lead", ["CL-F2-MASS"],
         procedure="0.1 g scale; update ASM-F2-WIRE-GPM and the wire table")
kit.test("T-F2-DSHOT", "Bidirectional DShot error rate with the full-length leads", ["CL-F2-DSHOT-LEN"],
         procedure="bench, props off, 4 ESCs on the routed leads, ESC telemetry error rate < 1 % over 5 min")
kit.test("T-F2-CONT", "Continuity, polarity, isolation and pull test", ["CL-F2-ESC-LEN-MAX"],
         procedure="every conductor end to end < 0.1 Ohm signal / polarity by colour; > 1 MOhm between nets; "
                   "10 N pull on every solder joint after heat-shrink")


# ============================================================================ geometry and wire table (main only)
def load_json(p):
    return json.loads(Path(p).read_text(encoding="utf-8"))


def pv(d, key):
    cur = d
    for k in key.split("."):
        cur = cur[k]
    return cur["value"] if isinstance(cur, dict) and "value" in cur else cur


def airfoil(path, chord):
    pts = []
    for line in Path(path).read_text().splitlines()[1:]:
        s = line.split()
        if len(s) == 2:
            pts.append((float(s[0]), float(s[1])))
    i = min(range(len(pts)), key=lambda k: pts[k][0])
    up, lo = pts[:i + 1][::-1], pts[i:]

    def z(surf, x):
        u = x / chord
        for a, b in zip(surf, surf[1:]):
            if a[0] <= u <= b[0]:
                return chord * (a[1] + (u - a[0]) / (b[0] - a[0]) * (b[1] - a[1]))
        return 0.0
    return (lambda x: z(up, x)), (lambda x: z(lo, x))


def fins_geometry(P):
    """D3's own derived fin dimensions (subsystems/fins/fusion/fins.py geometry()), so the collar tail and its tie lug
    are read, never re-typed. Pure Python (k09kit + the section file); no CAD backend."""
    for d in (RED / "fusion", RED / "subsystems" / "fins" / "fusion"):
        if str(d) not in sys.path:
            sys.path.append(str(d))
    import k09kit  # noqa: E402
    import fins as fins_mod  # noqa: E402
    return fins_mod.geometry(P, fins_mod.load_local(), k09kit.section(P)[0])


def geometry():
    P = load_json(RED / "params/params.json")
    F = load_json(RED / "subsystems/fins/params.json")
    D = load_json(RED / "subsystems/pod/params.json")
    fins_if = {p["id"]: p for p in load_json(RED / "subsystems/fins/interfaces.json")["parts"]}
    prp_if = {p["id"]: p for p in load_json(RED / "subsystems/propulsion/interfaces.json")["parts"]}
    d3 = {n["id"]: n for n in load_json(RED / "team/D3/claims.json")["nodes"]}
    c = pv(P, "wing.chord_m")
    zU, zL = airfoil(RED / "subsystems/wing/s5010.dat", c)
    g = {"zU": zU, "zL": zL, "c": c}
    g["yf"] = pv(P, "fins.y_m")
    g["t_fin"] = pv(P, "fins.board_t_m") * pv(P, "fins.layers")
    g["y_in"], g["y_out"] = g["yf"] - g["t_fin"] / 2, g["yf"] + g["t_fin"] / 2
    g["x_tube"], g["r_tube"] = pv(P, "fins.le_x_m"), pv(P, "fins.tube.od_m") / 2
    g["x_spar"], g["r_slot"] = pv(P, "wing.spar.x_m"), pv(P, "wing.spar.od_m") / 2 + 0.0002
    g["block_y_in"] = g["yf"] - pv(F, "fin_detail.block.width_m") / 2
    g["boss_h"] = pv(F, "fin_detail.boss.height_m")
    g["boss_tail_end"] = g["x_tube"] + g["r_tube"] + pv(F, "fin_detail.boss.tail_m")
    g["esc_x0"] = pv(F, "fin_detail.esc_pad.x0_m")
    g["esc_x1"] = g["esc_x0"] + pv(F, "fin_detail.esc_pad.len_m")
    g["esc_z"] = pv(F, "fin_detail.esc_pad.z_m")
    g["esc_y"] = prp_if["PRP-002-UR"]["cg_xyz_m"][1]
    g["collar_z"] = fins_if["FIN-008-UR"]["cg_xyz_m"][2]
    FG = fins_geometry(P)
    g["tail_x0"] = FG["xt"] + FG["sc_r_out"] + 0.002                    # collar tail wall, 2 mm aft of the ring
    g["tail_top"] = FG["ztop"]                                          # tail top edge |z| at x (D3)
    g["lug_x"] = FG["tl"]["collar_x_m"]                                 # D3's phase tie lug today (x 0.084)
    g["tail_face_y"] = FG["yf"] + FG["t_fin"] / 2 + FG["es_t"] + 2 * FG["sc_clear"] + FG["sc_wall"]
    g["zm"] = pv(P, "propulsion.stations.z_m")
    g["x_face"] = d3["CL-D3-X-FACE"]["value"]
    g["r_motor"] = pv(P, "propulsion.motor_diameter_m") / 2
    # pod (D2)
    g["pod_x0"] = pv(P, "pod.x_le_m")
    L, W, H = pv(P, "pod.size_m")
    g["pod_x1"], g["pod_hw"], g["pod_z0"] = g["pod_x0"] + L, W / 2, pv(P, "pod.z_base_m")
    g["wall"] = 0.0048
    g["y_wall_in"] = g["pod_hw"] - g["wall"]
    g["tray_top"] = g["pod_z0"] + g["wall"] + pv(D, "tray_floor_t_m")
    g["tray_floor_t"] = pv(D, "tray_floor_t_m")
    g["jr_bar"] = pv(D, "jr_bar_m")                                    # D2 JR tie bar: x0, x1, x width, height, ...
    g["half"] = pv(P, "wing.span_m") / 2
    g["bay_hw"] = pv(D, "bay_min_m")[1] / 2 + pv(D, "guide_t_m")
    g["y_ch"] = (g["bay_hw"] + g["y_wall_in"]) / 2                      # channel centre |y|
    g["fc_x"], (g["fc_l"], g["fc_w"], _h) = pv(D, "fc_centre_x_m"), pv(D, "fc_board_m")
    g["pdb_x"] = pv(D, "pdb_plate_x_m")
    g["park_x"] = pv(D, "park_x_m")
    g["avn_x"] = pv(D, "avn_plate_x_m")
    g["leg_y"], (g["leg_side"], _b) = pv(D, "leg_y_m"), pv(D, "leg_m")
    g["x_leg"] = g["x_spar"]                                           # handle on the spar (POD-007 at x 0.08)
    g["aft_exit"] = pv(D, "cable_exit_m")                              # y0, y1, z0, z1 (aft wall)
    g["strap_x"], g["pad_len"] = pv(D, "strap_x_m"), pv(D, "pad_len_m")
    g["grip_z"] = g["pod_z0"] + H + pv(D, "grip_gap_m") + pv(D, "grip_m")[1] / 2
    g["side_exit"] = pv(D, "side_exit_m")                              # x0, x1, z0, z1 (D2, CR-F2-03 a)
    g["x_under"] = pv(D, "floor_channel_m")[0]                         # under-pack channel centre x (D2)
    g["hole_x"] = pv(F, "fin_detail.wire_hole.x_m")                    # fin lead hole (D3, CR-D3-23)
    g["hole_off"] = pv(F, "fin_detail.wire_hole.off_skin_m")
    Wp = load_json(RED / "subsystems/wing/params.json")
    g["lead_hole_x"] = pv(Wp, "servo_pocket.lead_hole_x_m")            # D1 servo lead hole into the lower pocket
    g["pocket_ceiling_z"] = pv(Wp, "servo_pocket.ceiling_z_m")
    avn = {p["id"]: p for p in load_json(RED / "subsystems/avionics/interfaces.json")["parts"]}
    pwr = {p["id"]: p for p in load_json(RED / "subsystems/power/interfaces.json")["parts"]}
    mec = {p["id"]: p for p in load_json(RED / "subsystems/mechanisms/interfaces.json")["parts"]}
    g["gps"] = list(avn["AVN-002"]["cg_xyz_m"])                        # GPS/compass module centre (F3)
    # D-74 deleted the UBEC PWR-005. The right-channel routes keep the lane heights they were cleared on
    # (ROUTE-CLEARANCE.md), referenced to the former 41 x 23 x 10 mm UBEC envelope on D2's plate (x 0.044-0.085):
    # its centre and top are now only a lane datum in a free zone.
    g["rlane"] = [0.044 + 0.0205, g["y_ch"], g["pod_z0"] + g["wall"] + pv(D, "plate_t_m") + 0.005]
    g["cap"] = list(pwr["PWR-008-UR"]["cg_xyz_m"])                     # cap body centre, UR (others mirror)
    g["servo"] = list(mec["MEC-001-R"]["cg_xyz_m"])
    # clearance references for the routes (ROUTE-CLEARANCE.md): what the wires must clear by >= 1 mm
    g["foot_top"] = 0.0228 + pv(D, "foot_plate_t_m")                   # POD-007 foot plate / bridge top z (D2 CAD)
    g["flange_x0"] = pv(D, "bracket_m")["flange_x0"]                   # POD-007 wall-bracket flange, x from 0.066
    g["rlane_top"] = g["rlane"][2] + 0.005                             # former PWR-005 top (lane datum, D-74)
    g["leg_in"] = g["leg_y"] - g["leg_side"] / 2                       # POD-007 handle leg, inboard face |y|
    g["cradle_leg_x1"] = PORTS["pack_mate"][0][0] + 0.029              # PWR-006 cradle aft end x 0.060 (F1); legs
    #                                                                    x 0.046-0.050 since D-74 (leg_setback_m)
    g["boss_z"] = lambda surf, x: abs(surf(x)) + pv(F, "fin_detail.boss.height_m")   # block boss top |z| (D3)
    g["ear_y"] = 0.3422                                                # FIN-003 pinch ear outboard face |y| (D3 CAD)
    g["ear_x"] = 0.046                                                 # FIN-003 pinch ear pair centre x (D3 CAD)
    g["ear_top"] = 0.172                                               # FIN-003 collar / ear top |z| (D3 CAD)
    g["aft_stop_x"] = pv(D, "aft_stop_x_m")                            # POD-002 aft stop (D2)
    return g


def build(g):
    """Wire table + fittings + passes + CAD bundle legs. All coordinates in metres, aircraft frame."""
    zU, zL = g["zU"], g["zL"]
    # wing grooves (ahead of the spar slot, 5 mm pitch; see SPEC.md)
    x_neg = g["x_spar"] - g["r_slot"] - 0.003 - 0.0015                 # 3 mm foam wall to the spar slot
    x_pos = x_neg - 0.005
    x_sig = x_pos - 0.005
    x_pair = (x_pos + x_neg) / 2
    x_srv = g["x_spar"] + g["r_slot"] + 0.017                           # servo groove aft of the spar slot
    y_gend = g["block_y_in"] - 0.006                                    # groove ends 6 mm short of the block
    y_p1 = g["pod_hw"] + 0.022                                          # pass-through P1 (upper mouth)
    y_p1b = y_p1 + 0.030                                                # lower mouth (45 deg slant)
    x_hole = g["hole_x"]                                                # fin lead hole (D3 CR-D3-23: x 0.086)
    hole_dz = g["hole_off"]                                             # 22 mm off the skin (was 10, CR-D3-23)
    zw = g["tray_top"] + 0.0025                                         # wires on the tray
    yc = g["y_ch"]
    x_cross = (g["x_leg"] + g["leg_side"] / 2 + g["pod_x1"] - g["wall"]) / 2
    x_sexit = (g["side_exit"][0] + g["side_exit"][1]) / 2               # D2 side exits (CR-F2-03 a)
    z_sexit = (g["side_exit"][2] + g["side_exit"][3]) / 2
    x_jr = 0.030                                                        # JR in-line row, right channel
    # D-86: the six JR pairs drawn (HRN-105-<n>), on edge on the D2 tie bar, pins vertical, one per FC output n at
    # JR_PITCH from y 0.0385 outboard (output order, so no pigtail crosses another): female (FC pigtail) forward,
    # x 0.025-0.031, shroud x 0.031-0.049 (its front 2.5 mm on the 4 mm bar)
    x_jr0 = 0.025
    x_t1 = x_jr0 + JR_TAIL_M + JR_SHROUD_M[0]                           # shroud aft end
    z_jr = g["tray_top"] - g["tray_floor_t"] + g["jr_bar"][3] + JR_SHROUD_M[1] / 2 + 0.0001
    y_jr = lambda n: 0.0385 + JR_PITCH * (n - 1)
    fc_x0, fc_x1 = g["fc_x"] - g["fc_l"] / 2, g["fc_x"] + g["fc_l"] / 2
    x_under = g["x_under"]                                              # under-pack crossing channel (D2)
    z_under = g["tray_top"] + 0.00115                                   # D-85: through the tray gap, under the pack
    #                                                                    (z 0.0233) and over the side plates (0.0206)
    pdb_out = g["pdb_x"][1] - 0.004
    x_tun = PORTS["pack_mate"][0][0] + 0.003                            # aft end of the tunnel under the cradle
    x_rec = (0.1375, 0.168)                                             # JR in-line recess, servo branch (CR-F2-14);
    #                                                                     D-86: 30.5 mm (was 18) for the mated pair
    x_lh = (g["lead_hole_x"][0] + g["lead_hole_x"][1]) / 2              # D1 servo lead hole
    yo = g["y_out"] + 0.0035                                            # leads on the outboard board face (legs)
    yof = g["y_out"] + 0.0045                                           # routed lead centre: 5.2 mm pair, 1.9 mm off
    # drawn conductors in the D1 grooves (wing params grooves.*, cut in WNG-001): each 16 AWG conductor (2.6 mm) in its
    # own 3.0 x 3.1 mm groove (+ at x_pos, - at x_neg), centre 1.7 mm deep (0.1 mm off the floor, 0.4 mm under the
    # skin); the 28 AWG pair (1.8 mm bundle) 1.2 mm deep in the 2.5 x 2.4 signal groove; the 26 AWG servo ribbon
    # (3 x 1.1 mm) 1.0 mm deep in the 4.0 x 1.6 mm servo groove. Points marked "s" (5th element) carry the
    # conductors at groove spacing (draw_strands()).
    d_pwr, d_sig, d_srv = 0.00155, 0.0012, 0.00085   # 16 AWG: 0.05 mm under the skin and off both groove floors;
    #                                                   servo 22 AWG (1.3 mm): 0.2 mm under the skin, 0.1 off the floor
    y_g0 = 0.086                                                        # groove start |y| (wing grooves.y_m)

    def gz(surf, x, depth):
        return surf(x) - depth if surf is zU else surf(x) + depth

    # D-85: the 16 AWG power pair goes from its groove end straight into the grommet, along the bore axis, and arcs
    # out and back onto the outboard face: a pair tied flat on the face cannot turn square into the bore at the
    # required bend radius (rules.bend_k x OD = 10.4 mm). Offsets (m) from a random search against bends() (upper,
    # lower station): rise (dy, dz) out of the groove end, approach point (back from the hole, inboard of the face,
    # toward the skin), bore approach / exit lengths, then two outboard-face points (x ahead of the hole, z away from
    # the skin); the pair is supported by the groove tape and the grommet (free span <= 50 mm, CL-F2-FREE-SPAN)
    FIN_ARC = {1: [0.0094, 0.0089, 0.0089, 0.0182, 0.0028, 0.0098, 0.026, 0.026, 0.026, 0.0292, 0.0324], -1: [0.0074, 0.0083, 0.014, 0.0223, 0.0014, 0.0139, 0.026, 0.026, 0.026, 0.016, 0.0403]}

    def fin_pair(sgn_y, sgn_z, x_groove, depth, end, hole=(0.0, 0.0)):
        ry, rz, ex, ey, ez, e, f, g2, q, g3, q3 = FIN_ARC[sgn_z]
        surf = zU if sgn_z > 0 else zL
        zs = surf(x_hole)
        zh = zs + sgn_z * (hole_dz + hole[1])
        g0 = [x_groove, sgn_y * (y_gend - 0.012), gz(surf, x_groove, depth), "F", "s"]
        return [g0, [x_groove, sgn_y * (y_gend - 0.012 + ry), g0[2] + sgn_z * rz, "F", "s"],
                [x_hole - ex, sgn_y * (g["y_in"] - ey), zh - sgn_z * ez, "F"],
                [x_hole, sgn_y * (g["y_in"] - e), zh, "L"], [x_hole, sgn_y * g["yf"], zh, "L"],
                [x_hole, sgn_y * (g["y_out"] + f), zh, "L"],
                [x_hole + g2, sgn_y * (g["y_out"] + 0.6 * f), zh + sgn_z * q, "B"],
                [x_hole + g3, sgn_y * yof, zh + sgn_z * q3, "B"]] + end

    def fin_follow(sgn_y, sgn_z, x_groove, depth, pw):
        """D-85: the ESC signal lead rises out of its own groove end and joins the power pair at the pair's approach
        point, then rides 2.5 mm off the pair (away from the root) through the grommet (pair -0.9 mm, signal +1.6 mm
        from the bore centre) and round the pair's arc onto the outboard face."""
        surf = zU if sgn_z > 0 else zL
        j0 = next(i for i, p in enumerate(pw) if p[3] == "L" and abs(abs(p[1]) - g["yf"]) < 1e-6) - 2   # approach
        out = [[x_groove, sgn_y * (y_gend - 0.012), gz(surf, x_groove, depth), "F"],
               [x_groove, sgn_y * (y_gend - 0.004), surf(x_groove) + sgn_z * 0.0095, "F"]]
        for j in range(j0, j0 + 3):                         # approach (tied to the pair), bore in, bore centre
            out.append(beside(pw, j, 0.0025, sgn_z) + ["T" if j == j0 else pw[j][3]])
        c = out[-1]
        out.append([c[0], sgn_y * (g["y_out"] + 0.0035), c[2], "L"])   # out of the flange, then down the face
        return out

    def fin_side(sgn_y, sgn_z, x_groove, depth, end, r, r_c=None, dx=0.0, hole=(0.0, 0.0)):
        """From the groove to `end` on the outboard face, clear of the structure by >= 1 mm (ROUTE-CLEARANCE.md):
        the lead leaves its groove 12 mm before the groove end (bend radius), rises out of the tape skin, passes
        over the bead lip and the block boss (top |z| = skin + boss height), is tied above the boss-tail lug on the
        inboard face, crosses the half-fin in the grommeted hole and runs down the outboard face. r = drawn radius."""
        surf = zU if sgn_z > 0 else zL
        zs = surf(x_hole)
        x_t = g["boss_tail_end"] - 0.003 + dx                            # D3 boss-tail lug (signal lane 4 mm ahead)
        z_over = sgn_z * (g["boss_z"](surf, g["boss_tail_end"]) + r + 0.0015)
        r_c = r if r_c is None else r_c                                  # conductor radius (rises out of its groove)
        zh = zs + sgn_z * (hole_dz + hole[1])
        return [[x_groove, sgn_y * (y_gend - 0.012), gz(surf, x_groove, depth), "F", "s"],
                [x_groove, sgn_y * (y_gend - 0.004), surf(x_groove) + sgn_z * (r_c + 0.0008), "F", "s"],
                [x_groove + 0.005, sgn_y * (y_gend + 0.004), z_over, "F"],
                [x_t, sgn_y * (g["y_in"] - r - 0.001), z_over, "T"],
                # collision fix (D-85): square through the grommet bore, not slanted through the laminate. In the
                # 7 mm bore the pair lies across x, toward the root (hole[1] -0.9 mm), the signal lead 2.5 mm above it
                [x_hole + hole[0], sgn_y * (g["y_in"] - 0.006), zh, "L"],
                [x_hole + hole[0], sgn_y * g["yf"], zh, "L"],
                [x_hole + hole[0], sgn_y * (g["y_out"] + 0.006), zh, "L"],
                [x_hole - 0.004 + dx, sgn_y * yof, zh + sgn_z * 0.008, "B"]] + end   # ahead of the pair's arc

    # pod side exits (D2 16 x 12 mm window, x 0.056-0.072): the power pair passes forward of the POD-007 wall-
    # bracket flange (x >= 0.066) and aft of the PWR-006 cradle legs (x <= 0.060); signals above it, at x 0.0635.
    x_ex_p = {1: g["flange_x0"] - 0.004, -1: g["flange_x0"] - 0.004}   # pair ahead of the flange (x >= 0.066)
    x_ex_s = g["side_exit"][0] + 0.0015                                 # signals at the window's forward edge
    # power pairs in layers (2.9 mm): bottom the right pairs (LR, UR), above them the left pairs (LL, UL), so the left
    # pairs turn outboard over the right ones; on each side the lower-station pair (to the P1 straw) runs under the
    # upper-station pair (to the upper grooves). D-74: no UBEC feed above them any more.
    lay = {"LR": 0, "UR": 1, "LL": 2, "UL": 3}
    z_lay = lambda st: g["tray_top"] + 0.0015 + 0.0030 * lay[st]
    # XT30U stations (D-74, mated pairs drawn as HRN-113-* at XT30_SIZE_M): two stacked flat on the right pairs' last
    # pod run before the exit (axis along the run, 0.4 mm over the POD-007 foot plate, between the handle leg and the
    # right signal leads), two stacked flat in the outboard half of the tunnel under the AS150U cradle (left pairs,
    # axis x); the stacks are 5.8 mm pitch
    th = XT30_SIZE_M[2]
    XT30_Z_R = (g["foot_top"] + 0.0004 + th / 2, g["foot_top"] + 0.0004 + 1.5 * th + 0.0006)
    XT30_Z_L = (z_lay("UL") + 0.0022 - th - 0.0006, z_lay("UL") + 0.0022)   # UL 0.5 mm under the cradle floor
    XT30_X_L = 0.0259
    z_ub = g["rlane_top"] + 0.0016                                      # right lane height (former UBEC top + 1.6)
    x_cr = g["pod_x1"] - g["wall"] - 0.0052                             # power crossing, aft of the strut ribs
    z_cr = g["foot_top"] + 0.0062                                       # ... 3.6 mm over the foot bridge

    wires, fittings = [], []
    pwr_rows = {}

    def beside(row_pts, i, dist, sz):
        """Point `dist` off pair vertex i along the normal of the pair's plane (sz > 0: the +z side, else -z)."""
        lat = draw_strands(["tmp", "", 16, 2, 0, 0, 0, 0, 0, row_pts], [[16, 2.6]], want_lat=True)[i]   # D-87
        p0, p1 = row_pts[max(i - 1, 0)], row_pts[min(i + 1, len(row_pts) - 1)]
        t = _unit([p1[k] - p0[k] for k in range(3)])
        nv = _unit(_cross(t, lat))
        if nv[2] * sz < 0 or (abs(nv[2]) < 1e-6 and nv[1] < 0):
            nv = [-c for c in nv]
        return [row_pts[i][k] + dist * nv[k] for k in range(3)]

    # ---- power: bus bars -> ESC, 16 AWG pair (E-HRN-13..16). Start at the aft end of F1's bars, leave aft through
    # the tunnel under the AS150U cradle (CR-F1-18). At the ESC the pair rises along the board face BELOW the ESC and
    # lands on the power pads at its aft end from underneath, because the 680 uF cap (PWR-008) now sits on the face
    # in line aft of the ESC (x 0.127-0.147): an approach from aft would run into it.
    # D-87: into the ESC's aft END face, where its power pads are under the heat-shrink (not up through its bottom):
    # up the 3.5 mm gap between the ESC end (x 0.1235) and the cap (x 0.127, bottom |z| 0.113), then forward into the
    # end face below the cap legs, 4.5 mm in. J: soldered on the pads, the last bend formed (2 x OD, ASM-PWR-BEND)
    # D-88: the cap now sits 15 mm aft of the ESC (power params cap_gap_x_m), so the joint is laid out as it is
    # soldered: the pair rises in that gap on the fin face (conductors side by side across x, + at x 0.1327, - at
    # 0.1354, y 0.3285; the - conductor 2.3 mm ahead of the can), then each conductor turns forward on its own radius (2 x OD, formed) and enters the ESC's
    # aft end face square, + at z 0.116 and - at 0.1235 (|z|; the signal pad below them at 0.1105; pad heights EST,
    # the ESC listing gives none), 0.3 mm into the heat-shrink. The row's centre line runs between them (length, mass); STRAND_FIX draws the two ends.
    x_ef = 0.1235                                                       # ESC aft end face (PRP-002 body, x 0.0785-0.1235)
    y_er, x_rise = 0.3285, (0.1327, 0.1354)                             # risers on the fin face, under the cap legs
    z_pad = (0.116, 0.1235)                                             # + / - pad heights, EST
    esc_pwr_end = lambda sy, sz: [[g["esc_x1"] - 0.004, sy * yof, sz * (g["esc_z"] - 0.030), "B"],
                                  [sum(x_rise) / 2, sy * y_er, sz * (g["esc_z"] - 0.020), "B"],
                                  [sum(x_rise) / 2, sy * y_er, sz * (g["esc_z"] - 0.006), "B"],
                                  [x_ef - 0.0003, sy * y_er, sz * sum(z_pad) / 2, "J"]]

    def esc_pair_fix(sy, sz):
        """Per-conductor ends at the ESC: each drawn conductor is cut where it starts its vertical rise in the gap
        (|z| >= 0.105 aft of x 0.128, where both conductors are vertical) and continued on its own: up to its pad height, a formed 2 x OD bend, square
        into the end face."""
        R = 2.0 * 2.6 / 1000.0

        def fix(strands):
            out = []
            for d, line in strands:
                k = next(i for i, p in enumerate(line) if p[0] > 0.128 and sz * p[2] >= 0.105)   # both vertical
                cut = line[k]
                j = min(range(2), key=lambda i: abs(cut[0] - x_rise[i]))         # nearer riser: its pad
                corner = [x_rise[j], sy * y_er, sz * z_pad[j]]
                end = [x_ef - 0.0003, sy * y_er, sz * z_pad[j]]
                base = [x_rise[j], sy * y_er, cut[2]]
                tail = _fillet([base, corner, end], R, steps=12)
                out.append([d, line[:k] + [[round(c, 5) for c in p] for p in tail]])
            return out
        return fix
    bars = PORTS["bars_out"][0]
    for st, eid in zip(STATIONS, ("E-HRN-13", "E-HRN-14", "E-HRN-15", "E-HRN-16")):
        sy = 1 if st[1] == "R" else -1
        sz = 1 if st[0] == "U" else -1
        zl, k = z_lay(st), lay[st] % 2
        # D-86: each pair lands conductor by conductor on F1's bars (+ y -0.0499, - y -0.0429): pair k (= its layer)
        # lies 3 mm along the bar tops from x_a = -0.0105 - 6 mm k, rises 1.5 mm later to its pass height (2.75 mm a
        # layer, over the landings aft of it), runs aft over the bar end and drops into its layer
        # D-87: 8 mm stations on the 35 mm bars (x -0.0075, -0.0155, -0.0235, -0.0315 from the aft end): the pair's
        # two conductors lie 3.5 mm on the bar tops, one per bar ("b": 6 mm apart), rise in 3.5 mm to the pair's pass
        # height and run aft over the stations behind it; the rounded centre line keeps every bend >= the conductor
        xa = BAR_X0 - 0.008 * lay[st]
        zc = BAR_TOP + 0.00135
        zp = zc + 0.00275 * lay[st]
        pod = [[xa, BAR_Y, zc, "J", "b"], [xa + 0.0035, BAR_Y, zc, "P", "b"]]
        pod += [[xa + 0.007, BAR_Y, zp, "P"]] if lay[st] else []               # the aft-most pair does not climb
        pod += [[-0.0040, BAR_Y, zp, "P"]] if xa + 0.007 < -0.0050 else []     # past the bar end, then descend
        if sy > 0:          # tunnel inboard half (y -0.043, beside the left XT30U), then cross aft of the strut ribs,
            #                 over the POD-007 foot bridge, through the XT30U pair stacked in the crossing (D-74), in
            #                 the right lane to the exit (D2 R6 / F1 R1 layout)
            zx = XT30_Z_R[k]
            pod += [[0.012, -0.043, zl, "P"], [x_tun, -0.043, zl, "P"],
                    [g["cradle_leg_x1"] - 0.004, -0.0410, zl, "P"],
                    [g["flange_x0"] + 0.002, -0.040, z_cr - 0.0025 + 0.0033 * k, "P"],
                    [x_cr, -g["bay_hw"] - 0.0025, zx, "P"],
                    [x_cr, g["bay_hw"] + 0.0005, zx, "P"],
                    [x_cr - 0.013, g["leg_in"] - 0.005, zx, "P"],
                    [x_ex_p[1], g["y_wall_in"] - 0.0042, zx, "P"]]
        else:               # tunnel outboard half: through the XT30U pair stacked under the cradle floor (D-74, x
            #                 0.016-0.036), then aft of the (set-back) cradle legs out to the side exit
            zx = XT30_Z_L[k]
            pod += [[XT30_X_L - 0.0110, -0.0520, zx, "P"], [XT30_X_L + 0.0110, -0.0520, zx, "P"],
                    [0.0560, -0.0525, zl, "P"], [0.0625, -0.0600, zl, "P"]]
        r = pod + [[x_ex_p[sy], sy * (g["pod_hw"] + 0.004), z_sexit - 0.002 + 0.003 * k, "F"]]
        surf = zU if sz > 0 else zL
        if sz > 0:          # over the skin and over the P1 mouth (the lower pair dives there), then down into the
            #                 + / - grooves 18 mm after their start
            r += [[x_pair, sy * (y_g0 + 0.018), zU(x_pair) + 0.0016, "F", "s"],
                  [x_pair, sy * (y_g0 + 0.030), gz(zU, x_pair, d_pwr), "G"]]
        else:               # P1 pass-through, 45 deg, straw liner, then the lower + / - grooves
            p1z = lambda y: zU(x_pair) + (zL(x_pair) - zU(x_pair)) * (y - y_p1) / (y_p1b - y_p1)   # P1 axis
            r += [[x_pair, sy * (y_p1 - 0.0045), p1z(y_p1 - 0.0045), "F"],       # on the hole axis, above the skin
                  [x_pair, sy * (y_p1 + 0.0015), p1z(y_p1 + 0.0015), "L", "s"],     # in the 8 mm hole, on its axis
                  [x_pair, sy * (y_p1b - 0.0015), p1z(y_p1b - 0.0015), "L", "s"],   # (conductors at groove pitch)
                  [x_pair, sy * (y_p1b + 0.012), zL(x_pair) + d_pwr, "G"]]        # bend radius into the groove
        r += fin_pair(sy, sz, x_pair, d_pwr, esc_pwr_end(sy, sz), hole=(0.0, -0.0009))
        pwr_rows[st] = r
        wires.append(["W-PWR-" + st, eid, 16, 2, 1, 0.025, 0.020, 16.15, 0.0, r])
        STRAND_FIX["W-PWR-" + st] = esc_pair_fix(sy, sz)

    # ---- phase: ESC -> motor, 3 x 16 AWG (E-HRN-17..20), soldered (CT-SOLDER-PHASE)
    for st, eid in zip(STATIONS, ("E-HRN-17", "E-HRN-18", "E-HRN-19", "E-HRN-20")):
        sy = 1 if st[1] == "R" else -1
        sz = 1 if st[0] == "U" else -1
        # clear of the collar tail wall and its lug, over the motor-mount pinch bolt / nut / ear and the collar lip
        # (ROUTE-CLEARANCE.md); ties at the collar lug (E-HRN-06..09) and over the pinch ear (free span <= 50 mm)
        # D-86: laid on the parts, not across the air: forward off the ESC along the board face, up outboard of the
        # collar tail wall (y 0.3274), tied at the collar's phase lug (FIN-008, x 0.0575-0.0625, z 0.153-0.158),
        # aft of the pinch-bolt end (x <= 0.0558), taped up the outboard cheek face (y 0.334) over the ear and nut,
        # into the motor's phase-lead exit (PRP-001, x 0.0217-0.0262). Positions from the FIN-003 / -008 and PRP-001
        # CAD bodies (collision/out, 2026-11-11)
        # D-88: out of the ESC's forward END face square (0.3 mm in, mid-face) and 5.5 mm straight before the first
        # bend, under a 5 mm heat-shrink sleeve (HRN-120); into the motor's lead exit square (exit face x 0.0262,
        # 0.3 mm in) after a 7 mm straight run, as the factory leads leave the can
        r = [[0.0788, sy * g["esc_y"], sz * g["esc_z"], "J"],                    # soldered on the ESC's phase pads:
             [0.0730, sy * g["esc_y"], sz * g["esc_z"], "B"],                    # the lead-off is bench-formed
             [0.0645, sy * 0.3300, sz * 0.1215, "B"],
             [0.0615, sy * 0.3320, sz * 0.1400, "B"],
             [0.0615, sy * 0.3345, sz * 0.1557, "T"],                       # phase lug tie (lug face y 0.3308)
             [0.0590, sy * 0.3375, sz * 0.1785, "T"],                       # tape on the cheek face
             [0.0330, sy * 0.3375, sz * g["zm"], "T"],
             [0.0259, sy * 0.3375, sz * g["zm"], "E"]]
        wires.append(["W-PH-" + st, eid, 16, 3, 1, 0.030, 0.020, 16.15, 0.06, r])

    def pigtail(out_n):
        """D-89: output n's conductors are soldered in the FC's through-hole field (rows S / Vx / G at 2.54 mm EST,
        avionics.py fc_holes), rise off the PCB on a formed 2 x OD lead-off, run aft stacked (S lowest, the forward
        holes higher, over the risers aft of them) and fan into the JR female's contacts (HRN-105-n, pins vertical:
        S bottom, Vx middle, G top). Row = the S conductor's centre line (length, mass); STRAND_FIX draws each
        conductor (no bundle ends on the board, D-89)."""
        yc, y = FC_OUT_Y(out_n), y_jr(out_n)
        x_s, z0 = FC_OUT_ROWS["S"], FC_PCB_TOP + FC_JOINT_H / 2
        return [[x_s, yc, z0, "J"], [x_s, yc, 0.0325, "P"], [0.0230, y, z_jr - 0.00254, "P"],
                [x_jr0 + 0.001, y, z_jr - 0.00254, "E"]]

    def pigtail_fix(out_n, rows, dias):
        """Per-conductor pigtail: each from its hole (on the joint, 0.25 mm in), up, aft, into its JR contact."""
        yc, y = FC_OUT_Y(out_n), y_jr(out_n)
        z0 = FC_PCB_TOP + FC_JOINT_H / 2
        zh, lvl, dprev = {}, 0.0293, None                               # S level: 2 x OD lead-off over the joint
        for row, d in zip(rows, dias):
            if dprev is not None:
                lvl += dprev / 2 + d / 2 + 0.0003                       # stacked, 0.3 mm clear of the one below
            zh[row], dprev = lvl, d
        zp = {"S": z_jr - 0.00254, "V": z_jr, "G": z_jr + 0.00254}    # JR contacts, pins vertical

        def fix(_strands):
            out = []
            for row, d in zip(rows, dias):
                x = FC_OUT_ROWS[row]
                pts = [[x, yc, z0], [x, yc, zh[row]], [0.0170, yc, zh[row]], [0.0230, y, zp[row]],
                       [x_jr0 + 0.001, y, zp[row]]]
                # lead-off formed at 2 x OD (ASM-PWR-BEND, as the ESC pads); the run bends at k x OD (BEND_K, 3)
                c = _fillet_r(pts, [2.0 * d, 3.0 * d, 3.0 * d], steps=12)
                out.append([d, [[round(v, 5) for v in p] for p in c]])
            return out
        return fix

    def jr_tray(n, eid):
        JR["HRN-105-%d" % n] = {"x": [x_jr0, x_jr0 + JR_TAIL_M, x_t1], "y": y_jr(n),
                                "zb": [z_jr - JR_SHROUD_M[1] / 2] * 2, "orient": "edge", "wire": eid}

    # ---- ESC signal: FC pad -> 100 mm pigtail -> JR in-line -> 28 AWG twisted pair -> ESC signal lead
    ports = {"UR": 4, "UL": 2, "LR": 1, "LL": 3}
    for st, eid in zip(STATIONS, ("E-HRN-24", "E-HRN-25", "E-HRN-26", "E-HRN-27")):
        sy = 1 if st[1] == "R" else -1
        sz = 1 if st[0] == "U" else -1
        n = ports[st]
        yp = y_jr(n)
        jr_tray(n, eid)
        pig = pigtail(n)
        wires.append(["W-SIG-%s-P" % st, eid, 28, 2, 1, 0.015, 0.060, 1.1, 0.0, pig])
        STRAND_FIX["W-SIG-%s-P" % st] = pigtail_fix(n, "SG", [0.0009, 0.0009])     # D-89: S + G, 28 AWG
        hi = 0.004 if sz > 0 else 0.002                                 # upper-station lead 2 mm above the lower one
        he = 0.0028 if sz > 0 else -0.002                               # ... and at the exit window (z 0.027-0.039)
        # D-86: from the male contacts out of the shroud's aft end (x 0.049), up to its level 4.5 mm on
        pod = [[x_t1 - 0.012, yp, z_jr, "P"], [x_t1 + 0.0015, yp, z_jr, "P"]]
        if sy > 0:          # right: lowest; outboard along the 9 mm gap ahead of the right XT30U pair (x >= 0.058)
            zr = z_jr + 0.0038 + (0.002 if sz > 0 else 0.0)            # (behind the other risers) to the window
            if sz > 0:      # UR: up first, then across over the LR lead's run (2 mm above it)
                pod += [[x_t1 + 0.0045, yp, zr, "P"], [x_ex_s, g["y_wall_in"] - 0.007, zr, "P"]]
            else:           # LR: across behind the other risers
                pod += [[x_t1 + 0.0068, yp + 0.003, zr, "P"], [x_t1 + 0.0068, g["y_wall_in"] - 0.0095, zr, "P"],
                        [x_ex_s, g["y_wall_in"] - 0.007, zr, "P"]]
        else:               # left: over the right leads and the XT30U pair, inboard aft of the aft stop, then as before
            pod += [[x_t1 + 0.0045, yp, 0.039 + (0.002 if sz > 0 else 0.0), "P"],
                    [x_cross - 0.004, g["bay_hw"] - 0.0045, zw + 0.016 + hi, "P"],
                    [x_cross - 0.004, -g["bay_hw"] + 0.006, zw + 0.016 + hi, "P"],
                    # D-87: over the left pairs inside the pod (>= 3 mm above them), aft of the cradle (x 0.060) and
                    # outboard of its wall (y -0.0593), out at the window's FORWARD edge like the right side, so
                    # outside no lead has to hook back over the pairs
                    [0.0625, -0.0615, 0.0385 + (0.002 if sz > 0 else 0.0), "P"],
                    [0.0585, -0.0632, 0.0375 if sz > 0 else 0.0345, "P"]]
        xe = x_ex_s                                                          # the window's forward edge, both sides
        r = pod + [[xe, sy * (g["pod_hw"] + 0.004), z_sexit + he, "L"]]       # in the exit's PET chafe sleeve
        if sz > 0:          # over the skin into the signal groove 6 mm after its start (left: over both pairs first)
            r += [[x_sig - 0.0008, sy * (g["pod_hw"] + 0.010), zU(x_sig) + 0.0091, "F"]]   # forward of the
            #                                                       lower-station lead that dives into P1s
            r += [[x_sig, sy * (y_g0 + 0.006), zU(x_sig) + 0.0012, "F"],
                  [x_sig, sy * (y_g0 + 0.016), gz(zU, x_sig, d_sig), "G"]]
            r += fin_follow(sy, sz, x_sig, d_sig, pwr_rows[st])
        else:               # through the P1 straw beside the power pair (2.4 mm off its plane), out under the lower
            #                 skin, across to the signal groove
            pw = pwr_rows[st]
            i0 = next(i for i, p in enumerate(pw) if p[3] == "L")       # straw: above-mouth, upper mouth
            # beside the lower-station pair (forward of it on the right, aft of it on the left), under the upper one
            # D-85: its own 4 mm pass-through P1s on the signal-groove line (1.5 mm of foam from P1), so it never
            # meets the power pair: over the pairs at the exit, down onto the skin, through P1s, into its lower groove
            xs1 = x_sig - P1S_DX
            p1s = lambda y: zU(xs1) + (zL(xs1) - zU(xs1)) * (y - y_p1) / (y_p1b - y_p1)
            r += [[xs1, sy * (g["pod_hw"] + 0.009), zU(xs1) + 0.0068, "F"]]      # forward, under the upper lead
            # D-86: no run on the outside of the skin: from the P1s mouth straight into a jog groove (P1S_JOG, cut
            # in the core under the tape) across to the signal groove
            r += [[xs1, sy * (y_p1 - 0.003), p1s(y_p1 - 0.003), "L"],              # P1s straw, standing 3 mm proud
                  [xs1, sy * (y_p1 + 0.0015), p1s(y_p1 + 0.0015), "L"],
                  [xs1, sy * (y_p1b - 0.0040), p1s(y_p1b - 0.0040), "L"],
                  [xs1, sy * (y_p1b + 0.0005), gz(zL, xs1, d_sig), "G"],
                  [x_sig, sy * (y_p1b + 0.0070), gz(zL, x_sig, d_sig), "G"],
                  [x_sig, sy * (y_p1b + 0.0140), gz(zL, x_sig, d_sig), "G"]]
            r += fin_follow(sy, sz, x_sig, d_sig, pwr_rows[st])
        # fin root (D-85): the signal lead keeps its own tie at the boss-tail lug and passes the grommet 2.5 mm off
        # the power pair (fin_side bore points); on the outboard face it runs ahead of (toward the LE of) the pair's arc
        # D-88: below the ESC, over the pair's slant, then up the gap AHEAD of the pair's risers (x 0.1262, 2.7 mm aft
        # of the ESC) and square into the ESC's aft end face on the lowest pad (z 0.1105, 0.3 mm in)
        r += [[g["esc_x1"] - 0.013, sy * yof, sz * (g["esc_z"] - 0.022), "B"],          # below the ESC
              [0.1262, sy * y_er, sz * (g["esc_z"] - 0.018), "B"],
              [0.1262, sy * y_er, sz * 0.1105, "B"],
              [x_ef - 0.0003, sy * y_er, sz * 0.1105, "J"]]
        wires.append(["W-SIG-" + st, eid, 28, 2, 1, 0.015, 0.030, 1.1, 0.0, r])

    # ---- ESC cap legs (E-HRN-34..37, CR-F1-18): PWR-008 on the face in line aft of the ESC, legs formed forward onto
    # the ESC power pads, <= 20 mm, soldered with the power lead (CT-SOLDER-DC). Mass in PWR-008 (F1).
    # D-88: the 10 x 16 mm can (EEU-FR1E681, lead pitch 5.0 mm, leads 0.6 mm; DigiKey datasheet, checked 2026-11-12)
    # lies on the fin face 15 mm aft of the ESC, x 0.139-0.155. Each lead leaves the can's forward end face square
    # (1.4 mm outboard of the can axis, 2.5 mm either side of it), is formed 2 mm on and runs to the ESC end face,
    # where it lands on its pad beside the conductor (+ leg z 0.1160, - leg 0.1235, 1.4 mm outboard of the pair), and
    # enters square 2 mm before the face. Drawn as the two legs (STRAND_FIX).
    cap_x0 = g["cap"][0] - 0.008                                        # can forward face (cap_m 16 mm long)
    y_leg, d_leg = g["cap"][1] + 0.0014, 0.0006
    for st, eid in zip(STATIONS, ("E-HRN-34", "E-HRN-35", "E-HRN-36", "E-HRN-37")):
        sy = 1 if st[1] == "R" else -1
        sz = 1 if st[0] == "U" else -1
        legs = []
        for zc_, ze in ((g["cap"][2] - 0.0025, z_pad[0]), (g["cap"][2] + 0.0025, z_pad[1])):
            legs.append([[cap_x0 + 0.0003, sy * y_leg, sz * zc_], [cap_x0 - 0.002, sy * y_leg, sz * zc_],
                         [x_ef + 0.002, sy * y_leg, sz * ze], [x_ef - 0.0003, sy * y_leg, sz * ze]])
        r = [[cap_x0 + 0.0003, sy * y_leg, sz * g["cap"][2], "B"], [cap_x0 - 0.002, sy * y_leg, sz * g["cap"][2], "B"],
             [x_ef + 0.002, sy * y_leg, sz * sum(z_pad) / 2, "B"], [x_ef - 0.0003, sy * y_leg, sz * sum(z_pad) / 2, "J"]]
        wires.append(["W-CAP-" + st, eid, 22, 2, 0, 0.0, 0.003, 0.0, 0.0, r])   # 3 mm forming allowance
        STRAND_FIX["W-CAP-" + st] = lambda s, legs=legs: [[d_leg, [[round(c, 5) for c in p] for p in L]]
                                                          for L in legs]

    # ---- D-88: adhesive-lined heat-shrink (BOM HRN-107) over every soldered end that leaves a part's face, drawn as
    # parts HRN-107-*: a tube on the lead's straight run against the face, inner = the lead's drawn OD, wall 0.4 mm
    # (3:1 shrunk, EST), lengths inside each straight run. Cap legs (bare, in the joint), board pads, JR / XT30U
    # contacts and the AS150U aircraft-half cups (inside the cradle's cup slots) have none.
    SLEEVE.clear()
    dd = {16: 0.0026, 28: 0.0018}
    for st in STATIONS:
        sy = 1 if st[1] == "R" else -1
        sz = 1 if st[0] == "U" else -1
        k = STATIONS.index(st)
        ep, es, eh = "E-HRN-%d" % (13 + k), "E-HRN-%d" % (24 + k), "E-HRN-%d" % (17 + k)
        for tag, eid, (y, z), d, L, x0, ax in (
                ("P1", ep, (y_er, z_pad[0]), dd[16], 0.0030, x_ef, 1),     # + (straight 4.0 mm before its bend)
                ("P2", ep, (y_er, z_pad[1]), dd[16], 0.0030, x_ef, 1),     # -
                ("S", es, (y_er, 0.1105), dd[28], 0.0015, x_ef, 1),        # signal (straight 1.3 mm + start of bend)
                ("PH", eh, (g["esc_y"], g["esc_z"]), 0.0056, 0.0030, 0.0785, -1)):   # phase, forward face
            wall = 0.00015 if tag == "PH" else 0.0004                  # phase: thin-wall over-sleeve, 0.05 mm
            #                                                                  off the fin's ESC pad (FIN-007)
            SLEEVE["HRN-107-%s-%s" % (st, tag)] = {"start": [x0, sy * y, sz * z], "axis": ax, "length": L,
                                                   "r_in": d / 2, "r_out": d / 2 + wall, "wire": eid}
    SLEEVE["HRN-107-PACK"] = {"start": [0.0600, BAR_Y, 0.0456], "axis": 1, "length": 0.0035, "r_in": 0.003,
                              "r_out": 0.0034, "wire": "E-HRN-10"}             # pack lead at the cup end (x 0.060)
    for v in SLEEVE.values():
        v["mass_g"] = math.pi * (v["r_out"] ** 2 - v["r_in"] ** 2) * v["length"] * SLEEVE_RHO * 1e6
        v["cg"] = [v["start"][0] + v["axis"] * v["length"] / 2, v["start"][1], v["start"][2]]

    # ---- elevon servos: FC pad -> pigtail -> JR -> 22 AWG + / - and 28 AWG signal (D-74 follow-up) via the D2 aft exits and a groove aft of the spar
    ax0, ax1 = (g["aft_exit"][0] + g["aft_exit"][1]) / 2, (g["aft_exit"][2] + g["aft_exit"][3]) / 2
    for side, eid, out_n in (("L", "E-HRN-28", 5), ("R", "E-HRN-29", 6)):
        sy = 1 if side == "R" else -1
        yp = y_jr(out_n)
        jr_tray(out_n, eid)
        pig = pigtail(out_n)
        wires.append(["W-SRV-%s-P" % side, eid, 22, 3, 0, 0.0, 0.040, SRV_GPM, 0.0, pig])
        STRAND_FIX["W-SRV-%s-P" % side] = pigtail_fix(out_n, "SVG", [v / 1000.0 for v in SRV_DIA_MM])   # D-89
        # D-86: conductors stacked across the pins (B: in the vertical plane) out of the shroud, up over everything
        # D-88: 3 mm straight out of the shroud's aft face before the rise, so every conductor leaves it square
        pod = [[x_t1 - 0.012, yp, z_jr, "B"], [x_t1 + 0.0030, yp, z_jr, "B"],
               [x_t1 + 0.0060, yp, zw + 0.0212 + 0.0025 * (sy > 0), "P"]]
        if sy < 0:
            pod += [[x_cross + 0.001, g["bay_hw"] - 0.006, zw + 0.0267, "P"],
                    [x_cross + 0.001, -g["bay_hw"] + 0.006, zw + 0.0267, "P"]]
        else:
            pod += [[x_cross + 0.001, g["bay_hw"] + 0.0015, zw + 0.0294, "P"]]
        pod += [[x_cross + 0.001, sy * ax0, ax1, "L"],
                [g["pod_x1"] + 0.004, sy * ax0, ax1, "F"],
                [x_srv, sy * 0.088, zU(x_srv) + 0.0009, "F", "s"],                # over the skin into the groove
                [x_srv, sy * 0.098, zU(x_srv) - d_srv, "G"],
                [x_srv, sy * 0.2850, zU(x_srv) - d_srv, "G"]]   # centred in both grooves (D-87 corner relief)           # D1 branch groove at |y| 0.285
        #                                       22 AWG bundle 3.6 mm in the 4.0 mm groove: 0.1 mm outboard of centre so
        #                                       the corner fillet (3.9 mm bend) clears the inboard wall
        pod += [[xb, sy * 0.28495, zU(xb) - d_srv, "G"] for xb in (0.118, 0.128, 0.138)   # floor follows the skin
                if xb < x_rec[0] - 0.006]
        # D-86: the mated JR pair lies flat on the recess floor (HRN-105-S<side>): female forward x 0.1415-0.1475,
        # shroud 0.1475-0.1655 (recess 0.1375-0.168), bottom 0.1 mm over the floor (zU - 5 mm); the lead drops off the groove floor into
        # the female housing on the pair's mid-plane
        xr = (x_rec[0] + 0.004, x_rec[0] + 0.004 + JR_TAIL_M, x_rec[0] + 0.004 + JR_TAIL_M + JR_SHROUD_M[0])
        zb = lambda x: zU(x) - JR_RECESS_D + 0.0001
        zmid = lambda x: zb(x) + JR_SHROUD_M[2] / 2
        JR["HRN-105-S" + side] = {"x": list(xr), "y": sy * 0.285, "zb": [zb(xr[1]), zb(xr[2])], "orient": "flat",
                                  "wire": eid}
        # D-88: off the groove floor past the recess front edge, down 1.5 mm onto the female housing's level and
        # straight into its forward face (0.7 mm above the pair's mid-plane: the conductors clear its top by 0.15 mm)
        z_in = zmid(xr[0]) + 0.0007
        pod += [[x_rec[0] - 0.003, sy * 0.28495, zU(x_rec[0] - 0.003) - d_srv, "G"],   # D-87: 0.15 mm in (the
                [x_rec[0] + 0.001, sy * 0.28495, zU(x_rec[0] + 0.001) - d_srv, "G"],    # rounded corner)      # past the recess front edge
                [xr[0] - 0.0003, sy * 0.285, z_in, "G"],
                [xr[1] + 0.0005, sy * 0.285, z_in, "E"]]                            # female contacts
        wires.append(["W-SRV-" + side, eid, 22, 3, 0, 0.0, 0.040, SRV_GPM, 0.0, pod])
        # servo's own lead (mass in MEC-001), shortened to 40 mm and re-terminated: JR male in the recess -> branch
        # groove -> D1 lead hole (4 mm, straw) -> pocket ceiling -> case front (CR-D1-06, CR-D6-05)
        # D-85: rises out of the recess onto the branch-groove floor before the recess end, along the branch to the
        # lead hole, down the hole and through the new notch in the frame rim (MEC-008), then down the 4.8 mm gap
        # ahead of the case to the case front
        srv = [[xr[1] + 0.003, sy * 0.285, zmid(xr[1] + 0.003), "G"],                   # male contacts in the shroud
               [xr[2] - 0.0005, sy * 0.285, zmid(xr[2] - 0.0005), "G"],                   # out of its aft end
               [x_rec[1] - 0.0003, sy * 0.285, zU(x_rec[1]) - d_srv, "G"],                # up over the recess end
               [g["lead_hole_x"][1] - 0.0006, sy * 0.285, zU(x_lh) - d_srv, "G"],
               [g["lead_hole_x"][1] - 0.0006, sy * 0.285, g["pocket_ceiling_z"] + 0.001, "L"],
               [0.1755, sy * 0.285, 0.0015, "F"],
               # D-88: in the 4.8 mm gap ahead of the case, inboard to the band between the mounting ear (|y| <=
               # 0.2739) and the case's outboard face (0.2797), and square into the case's forward end face (x 0.1784,
               # 0.3 mm in) where the factory lead leaves it; the last bend formed (2 x OD)
               [0.1755, sy * 0.2768, -0.0002, "F"],
               [0.1787, sy * 0.2768, -0.0002, "J"]]
        wires.append(["W-SRV-%s-S" % side, eid, 26, 3, 0, 0.0, 0.010, 0.0, 0.040, srv])

    # ---- D-74: no UBEC feed, fuse or UBEC rail (E-HRN-21 / -33 / -22 deleted). The servo rail is the FC's Vx header,
    # fed by the power board's servo BEC (6 V jumper) through the board link W-PMOD below.
    # XT30U per ESC pair (D-74, WB-03), drawn as parts HRN-113-<st>: centre on the pair's route, path length from the
    # bars to it (the pigtail F1 solders on the bench)
    xt30 = {}
    for st in STATIONS:
        r = pwr_rows[st]
        if st[1] == "R":    # on the last pod run (x 0.072 -> 0.062, toward the exit), between the leg and the signals
            i_ex = next(i for i, p in enumerate(r) if p[3] == "F") - 1
            a2, b2 = r[i_ex - 1], r[i_ex]
            c = [(a2[0] + b2[0]) / 2, (a2[1] + b2[1]) / 2, XT30_Z_R[lay[st] % 2]]
            ax = _unit([b2[0] - a2[0], b2[1] - a2[1], 0.0])[:2]
        else:
            c = [XT30_X_L, -0.0520, XT30_Z_L[lay[st] % 2]]
            ax = [1.0, 0.0]
        k = min(range(len(r) - 1), key=lambda i: _seg_dist(c, r[i][:3], r[i + 1][:3]))
        a, b = r[k][:3], r[k + 1][:3]
        ab = [b[j] - a[j] for j in range(3)]
        t = max(0.0, min(1.0, sum((c[j] - a[j]) * ab[j] for j in range(3)) / sum(v * v for v in ab)))
        xt30[st] = (c, sum(seg_len(r[:k + 1])) + t * math.dist(a, b), [round(v, 4) for v in ax])
    XT30.update(xt30)

    # ---- pack lead (E-HRN-10, pack-owned) and 10 AWG main jumpers (E-HRN-11/12, mass in PWR-002), CR-F1-18
    # D-85: from the pack's aft face (D-77 station, x 0.0315) over the aft stop (top z 0.0503) to just behind the park,
    # then outboard and down into the wire end of the AS150U pack half (x 0.060, pins z 0.0456); the drawn 6 mm bundle
    # is the pair of 10 AWG leads
    # D-87: the turns are drawn as arcs no tighter than the 6 mm bundle can bend (r 4 mm in plan and a 4 mm loop
    # aft of the pack half, clear of the left handle leg at x 0.0765); the end stays 2 mm inside the pack half
    r = [[0.0330, -0.014, 0.0535, "F"], [0.0635, -0.014, 0.0535, "P"], [0.0635, -0.04235, 0.0535, "P"],
         [0.0647, -0.0452, 0.0535, "P"], [0.0675, BAR_Y, 0.0535, "P"], [0.07029, BAR_Y, 0.0523, "P"],
         [0.07145, BAR_Y, 0.04955, "P"], [0.07029, BAR_Y, 0.0468, "P"], [0.0675, BAR_Y, 0.0456, "P"],
         [0.0597, BAR_Y, 0.0456, "E"]]       # D-88: into the solder cups at the pack half's wire end (x 0.060), 0.3
    #                                          mm in, under a heat-shrink sleeve (HRN-120); it no longer runs through it
    wires.append(["W-PACK", "E-HRN-10", 10, 2, 0, 0.0, 0.0, 0.0, 0.0, r])
    # D-88: out of the AS150U aircraft half's cup end square (x 0.002, 0.3 mm in) and 5 mm straight, then up onto the
    # board's input pads (top, z 0.0486) and along them
    r = [[0.0023, -0.0403, 0.046, "P"], [-0.003, -0.0403, 0.046, "P"], [-0.009, -0.0403, 0.0525, "P"],
         [-0.0145, -0.0403, 0.0514, "E"]]
    wires.append(["W-MAIN-1", "E-HRN-11", 10, 2, 0, 0.0, 0.015, 0.0, 0.0, r])
    # D-89: drawn as its two 10 AWG conductors side by side (y -0.04272 / -0.03788, 4.84 mm apart) from the cups
    # through the widened cup slot onto the board's two input pads (power.py PWR-003 'input pad', joint top z
    # 0.0491), lying on them (axis 2.3 mm over the joint): not one 6 mm tube on the bare board top
    STRAND_FIX["W-MAIN-1"] = lambda s, r=r: [[0.0048, [[p[0], y, p[2]] for p in r]] for y in (-0.04272, -0.03788)]
    # D-85: down through the deck window outboard of the ESC pairs' band (y -0.0502 ... -0.0425), forward under the
    # deck at y -0.054 (clear of the PDB-boss screws at y -0.0588) and onto the bars' forward end (x -0.0305), ahead of
    # the four pair landings (x -0.0095 ... -0.0245)
    # D-86: drawn as its two 10 AWG conductors (F1: "drops through the window to the bars"): from the board's output
    # pads aft and down through the deck window at x -0.003 either side of the ESC pairs' band (+ outboard at y
    # -0.0532, - inboard at -0.0396, clear of the spacer columns), forward under the deck beside the bars at z 0.0295
    # (over the PDB bosses, z <= 0.0266) and onto the bars' forward ends (x -0.0338 ... -0.0325), ahead of the four
    # pair landings (x -0.0285 ... -0.0075). Centre line = the + conductor (mass, length)
    # D-87: from the output pads ON the board top, and onto the bars' forward ends through a 3.5 mm arc in plan
    # (no turn tighter than the conductor; the stations start at x -0.0315)
    zm2, zbar = 0.0295, BAR_TOP + 0.0024
    arc = lambda yc, s: [[-0.0350 - 0.0035 * math.sin(math.radians(a)), yc - s * 0.0035 * math.cos(math.radians(a)),
                          zm2 - (zm2 - zbar) * a / 90.0] for a in (0, 30, 60, 90)]
    # D-89: the first two points lie on the output pads (joint top z 0.0491)
    mp = [[-0.0145, -0.0545, 0.0514], [-0.0085, -0.0545, 0.0514], [-0.003, -0.0532, 0.044], [-0.003, -0.0532, zm2]]
    mp += arc(-0.0497, 1)                                               # the arc ends lying on the + bar
    mn = [[-0.0145, -0.0495, 0.0514], [-0.0085, -0.0495, 0.0514], [-0.0040, -0.0480, 0.0440],   # down first, then in
          [-0.0030, -0.0430, 0.0405], [-0.0030, -0.0396, 0.0370], [-0.0030, -0.0396, zm2]]   # under main 1, over
    #                                                                                      the pairs (top 0.0364)
    mn += arc(-0.0431, -1)                                              # ... and on the - bar
    r = [[-0.0145, -0.0545, 0.0484, "P"]] + [p + ["P"] for p in mp[1:-1]] + [[-0.0380, -0.04985, BAR_TOP - 0.0005, "E"]]
    #                                                                     centre line on the pad and on the bar
    wires.append(["W-MAIN-2", "E-HRN-12", 10, 2, 0, 0.0, 0.020, 0.0, 0.0, r])
    STRAND_FIX["W-MAIN-2"] = lambda s, mp=mp, mn=mn: [[0.0048, mp], [0.0048, mn]]

    # ---- power board -> FC (E-HRN-23), FC -> RX (E-HRN-31), airspeed I2C branch (E-HRN-32): under-pack channel
    # (D2 R5: x -0.0245, lands on the PDB plate (left) and the FC (right)); left-side runs stay inboard of the RX
    yb = g["bay_hw"] + 0.004
    z_fc = g["tray_top"] + 0.0023                                       # under the FC board (gel cubes 5 mm)
    # under-pack channel (D2, 10 mm wide): three lanes, PMOD aft, RX middle, airspeed forward; left of the bay the
    # three run forward stacked in the corridor between the pack and the PDB boss / spacer column (y -0.028)
    xl = {"PMOD": x_under + 0.0035, "RX": x_under, "ASPD": x_under - 0.0033}
    zc = {"ASPD": 0.0290, "RX": 0.0315, "PMOD": 0.0345}
    y_c, y_out = -0.028, -(g["bay_hw"] + 0.0018)                        # D-85: rise outboard of the left guide
    # D-74 case S: W-PMOD is a 10-way 28 AWG ribbon (ASM-F1-PMOD-CONDUCTORS) from the PDB's board-to-board contacts
    # (top face, forward-inboard corner) forward over the deck front edge (KO-PWR-BOARD x -0.066), down in front of
    # it inboard of the airspeed board (AVN-004, y <= -0.0358), into the corridor under the deck, then as before
    # D-89: the ribbon plug sits on the PDB's board-to-board header (top face, forward-inboard corner, power.py) and
    # on the FC's underside header between the gel cubes (avionics.py fc_link_m): it leaves the PDB plug's fore face
    # square, and enters the FC plug's inboard face square from the under-FC lane (no lead ends on a bare board)
    r = [port("pdb_link") + ["F"], [-0.0685, -0.0335, 0.0506, "F"], [-0.0685, -0.033, 0.0350, "P"],
         [-0.0555, y_c, zc["PMOD"], "P"], [xl["PMOD"], y_out, zc["PMOD"], "P"],
         [xl["PMOD"], y_out, z_under, "L"], [xl["PMOD"], yb, z_under, "P"],
         [xl["PMOD"], 0.0362, 0.0236, "P"], port("fc_link") + ["E"]]
    wires.append(["W-PMOD", "E-HRN-23", 28, 10, 0, 0.0, 0.020, 1.1, 0.0, r])
    # D-89: out of the FC's fore-edge GH-4 plug (SERIAL6) square (-x), down in front of the fore end stop, aft under
    # the FC inboard of the gel cubes (y <= 0.0333), into the lane; at the RX the 4-core cable ends in a 2 mm breakout
    # sleeve (HRN-107-RX) and its four conductors fan onto the RP3's four solder pads (avionics.py rx_pads), lying on
    # them along -y
    r = [port("fc_fore") + ["P"], [-0.0416, 0.0355, 0.029325, "P"], [-0.0416, 0.0328, 0.0232, "P"],
         [-0.0275, 0.0328, 0.0224, "P"], [xl["RX"], 0.0298, z_under, "L"],
         [xl["RX"], y_out, z_under, "P"], [xl["RX"], y_out, zc["RX"], "P"],
         [-0.040, y_c, zc["RX"], "P"], [-0.0445, -0.0330, 0.0310, "P"],   # over the airspeed lead, then down
         [-0.0445, -0.0370, 0.0280, "P"], [-0.0445, -0.0400, 0.0280, "P"],
         [-0.0445, -0.0445, 0.0265, "P"], port("rx") + ["E"]]
    wires.append(["W-RX", "E-HRN-31", 28, 4, 1, 0.020, 0.010, 1.1, 0.0, r])   # 10 mm loop (F5: <= 0.15 m)
    rx_x = [-0.0475 + 0.002 * i for i in range(4)]                     # pad centres (avionics params rx_pads)
    add_sleeve("HRN-107-RX", [-0.0445, -0.0380, 0.0280], "Y", -1, 0.0020, 0.0019, 0.0022, "E-HRN-31")

    def rx_fix(strands):
        """Bundle up to the middle of the breakout sleeve; then the four 28 AWG conductors side by side (0.93 mm
        pitch) to the sleeve end, fanned and lowered onto the pads (formed 2 x OD), lying on them to the end."""
        d, line = strands[0]
        cut = next(i for i, q in enumerate(line) if q[1] <= -0.0389)
        out = [[d, line[:cut] + [[-0.0445, -0.0389, 0.0280]]]]
        for i, xp in enumerate(rx_x):
            xo = -0.0445 + 0.00093 * (i - 1.5)
            pts = [[xo, -0.03895, 0.0280], [xo, -0.0400, 0.0280], [xp, -0.0445, 0.0265], [xp, -0.0470, 0.0265]]
            out.append([0.0009, [[round(v, 5) for v in q] for q in _fillet(pts, 0.0018, steps=12)]])
        return out
    STRAND_FIX["W-RX"] = rx_fix
    # GPS cable from the aft-edge GPS port: up the right side to z 0.06, into the right handle leg, grip, mast
    # D-85: the cross bolt (POD-011) fills the 6 mm mast bore, so the cable cannot run inside the mast. From the
    # aft-edge GPS plug it rises clear of the output pigtails, crosses to the right leg's window, climbs the leg bore,
    # leaves it inboard under the grip, runs in the grip groove, drops out of the groove before the centre block,
    # passes aft of the grip and the socket boss and climbs the mast's aft face (tied), aft of the 45 deg pad
    # D-89: out of the FC's aft-edge GH-6 plug square (+x), up at x 0.022 (the I2C splice sleeve on this riser), and
    # at the top square into the GH-6 plug on the GPS module's aft-upper end face (along -(0.707, 0, 0.707))
    gz0 = g["grip_z"] - 0.004                                                          # grip underside
    ge = PORTS["gps"][0]
    r = [port("fc_aft") + ["P"], [0.0220, 0.0358, 0.029325, "P"], [0.0220, 0.0358, 0.050, "P"],
         [g["x_leg"] - 0.008, g["leg_y"] + 0.010, 0.060, "P"],                          # outboard of the leg
         [g["x_leg"], g["leg_y"] + 0.010, 0.060, "L"],                                  # D2 window, outboard face
         [g["x_leg"], g["leg_y"], 0.064, "L"],
         [g["x_leg"], g["leg_y"], gz0 - 0.004, "L"],                                    # top of the bore, opened inboard
         [g["x_leg"], g["leg_y"] - 0.0065, gz0 - 0.002, "M"],                           # out of the leg, under the grip
         [g["x_leg"], g["leg_y"] - 0.010, gz0 + 0.0015, "M"],                           # up into the groove
         [g["x_leg"], 0.0072, gz0 + 0.0015, "M"],                                       # groove, to the centre block
         [g["x_leg"], 0.0072, gz0 - 0.0045, "M"],                                       # down out of the groove
         [0.0887, 0.0030, gz0 - 0.0045, "M"], [0.0887, 0.0, gz0 + 0.004, "M"],           # aft of grip and socket boss
         [0.0887, 0.0, 0.160, "M"],                                                     # up the mast's aft face
         [0.0916, 0.0, 0.163, "M"], [0.0916, 0.0, 0.184, "M"],                           # aft of the 45 deg pad
         [ge[0] + 0.0043 * GPS_PLUG_DIR[0], 0.0, ge[2] + 0.0043 * GPS_PLUG_DIR[2], "P"],   # 4 mm out from the plug
         list(ge) + ["E"]]
    wires.append(["W-GPS", "E-HRN-30", 28, 6, 1, 0.030, 0.040, 1.1, 0.0, r])
    # I2C Y-branch (SDA, SCL, 5 V, GND) spliced 15 mm from the GPS port, forward along the FC to the channel
    # D-89: back to the declared Y-splice (E-HRN-32 wire text): the branch is soldered to the four GPS-cable
    # conductors beside the riser and both are shrunk in one adhesive sleeve (HRN-107-I2C, z 0.036-0.046, ~15 mm
    # along the cable from the plug); D-88 had it on FC top-face "I2C pads" that no source or CAD body shows. Then
    # down inboard of the GPS plug, forward beside the FC (y 0.0292) and into the airspeed sensor's GH-4 plug on its
    # aft face, square (-x)
    add_sleeve("HRN-107-I2C", [0.0220, 0.03465, 0.0360], "Z", 1, 0.0100, 0.0025, 0.0029, "E-HRN-32",
               also=["E-HRN-30"])
    ae = PORTS["aspd"][0]
    r = [[0.0220, 0.03324, 0.0400, "P"], [0.0220, 0.03324, 0.0345, "P"], [0.0190, 0.0292, 0.0320, "P"],
         [0.010, 0.0292, zc["ASPD"], "P"],                                                    # inboard of the FC,
         [xl["ASPD"], 0.0292, zc["ASPD"], "P"], [xl["ASPD"], 0.0292, z_under, "P"],    # down outboard of the guide
         [xl["ASPD"], y_out, z_under, "L"], [xl["ASPD"], y_out, zc["ASPD"], "P"],      # under it, up outboard
         [-0.040, y_c, zc["ASPD"], "P"],
         [-0.050, -0.038, 0.0274, "P"], [-0.0520, ae[1], ae[2], "P"],             # over the RX, onto the plug axis
         list(ae) + ["E"]]                                       # 0.3 mm into the plug's rear face, square
    wires.append(["W-ASPD", "E-HRN-32", 28, 4, 1, 0.020, 0.020, 1.1, 0.0, r])

    # ---- fittings: [name, qty, g each, x, y, z]
    for st in STATIONS:
        sy = 1 if st[1] == "R" else -1
        sz = 1 if st[0] == "U" else -1
        ex, ez = g["esc_x1"], sz * g["esc_z"]
        zs = (zU if sz > 0 else zL)(x_hole)
        GROM[st] = ([x_hole, sy * g["yf"], zs + sz * hole_dz], sy)       # D-83: grommet drawn as HRN-110-<st>
        fittings += [
            ["ESC pad joints: solder at 2 power pads + 2 signal splices (sleeves: HRN-107) " + st, 1, 0.40, ex, sy * g["esc_y"], ez],
            ["Phase joints: 3 staggered splices + outer sleeve " + st, 1, 0.40, g["esc_x0"] - 0.03, sy * yo, sz * 0.15],
            ["Tape strips 20 x 40 mm on the board face (6) " + st, 6, 0.05, ex - 0.01, sy * yo, sz * 0.08],
            ["Ties: boss tail, collar, pinch ear, ESC end " + st, 4, 0.12, 0.08, sy * yo, sz * 0.10],
            ["Groove hold-down tape tabs (4) under the skin " + st, 4, 0.03, x_pair, sy * 0.19, sz * 0.02],
        ]
    for sy in (1, -1):
        fittings += [["P1 pass-through straw liner 7 mm", 1, 0.15, x_pair, sy * (y_p1 + 0.015), 0.006],
                     ["Servo groove hold-down tape tabs (3)", 3, 0.03, x_srv, sy * 0.18, zU(x_srv)],
                     ["Recess tape flap 25 x 30 mm (re-openable)", 1, 0.04, x_rec[0] + 0.009, sy * 0.285,
                      zU(x_rec[0] + 0.009)],
                     ["Servo lead-hole straw 4 mm x 15 mm", 1, 0.03, x_lh, sy * 0.285, 0.013],
                     ["Exit chafe sleeve PET braid 6 mm x 40 mm", 2, 0.08, x_sexit, sy * g["pod_hw"], z_sexit]]
    fittings += [["JST-GH housings + pre-crimped contacts (4 ends: GPS x2, RX at the FC, airspeed; D-89)", 4, 0.15, g["fc_x"], 0.02, zw + 0.004],
                 ["Board-link pin-header ends (2, W-PMOD case S)", 2, 0.30, PORTS["pdb_link"][0][0],
                  PORTS["pdb_link"][0][1], PORTS["pdb_link"][0][2]],
                 ["I2C Y-splice, 4 conductors", 4, 0.08, fc_x1 - 0.006, 0.040, zw + 0.010],
                 ["Bus-bar solder joints (8: 4 pigtails, bench)", 8, 0.05, bars[0], bars[1], bars[2]],
                 ["Ties in the pod (10)", 10, 0.12, 0.03, 0.0, zw + 0.005],
                 ["Crossing chafe sleeve PET braid 6 mm x 60 mm", 2, 0.12, x_cross, 0.0, zw + 0.008],
                 ["GPS-cable ties on mast and grip", 3, 0.12, g["x_leg"], 0.02, g["grip_z"]]]


    # ---- passes: [name, opening area mm2, [[awg, conductors], ...]]
    passes = [
        ["Pod side exit (16 x 12 mm), one side", 16 * 12, [[16, 4], [28, 4]]],
        ["Pod aft exit (D2, 11 x 16 mm), one side", 11 * 16, [[26, 3]]],
        ["Crossing behind the aft stop (6.7 x 26 mm)", (g["pod_x1"] - g["wall"] - g["x_leg"] - g["leg_side"] / 2) * 1000 * 26,
         [[16, 4], [28, 4], [26, 3]]],
        ["P1 straw liner, ID 7 mm", math.pi / 4 * 49, [[16, 2], [28, 2]]],
        ["Fin-hole grommet, ID 7 mm", math.pi / 4 * 49, [[16, 2], [28, 2]]],
        ["Under-pack channel 10 x 3 mm (board-link ribbon 10 + RX 4 + airspeed 4)", 30, [[28, 18]]],
        ["Handle leg bore 4.2 mm square (GPS cable)", 4.2 * 4.2, [[28, 6]]],
        ["Tunnel under the AS150U cradle, 10 x 20 mm", 200, [[16, 8]]],
        ["Servo lead-hole straw, ID 3.4 mm (D1 4 mm hole)", math.pi / 4 * 3.4 ** 2, [[26, 3]]],
    ]

    # ---- CAD bundle legs (axis-aligned, k09kit.bundle), right side; the module mirrors to the left. Diameters are
    # set later from the wire mass each leg carries (bodies()), so the body centroid stands for the wire mass.
    zg = gz(zU, x_pair, 0.003)                                          # lump body fully below the surface
    zgl = gz(zL, x_pair, 0.003)
    zh_u, zh_l = zU(x_hole) + hole_dz, zL(x_hole) - hole_dz             # fin-hole centres (D3: +0.0447 / -0.0307)
    x_boss = g["boss_tail_end"] - 0.003                                 # boss-tail tie lug (D3: x 0.071)
    x_face = (x_hole + g["esc_x1"]) / 2                                 # outboard-face run, hole -> under the ESC
    side_legs = [
        [[x_pair, g["pod_hw"] + 0.002, zg], [x_pair, y_gend, zg]],                  # upper grooves
        [[x_pair, y_p1b, zgl], [x_pair, y_gend, zgl]],                              # lower grooves
        [[x_pair, (y_p1 + y_p1b) / 2, zgl], [x_pair, (y_p1 + y_p1b) / 2, zg]],      # P1 pass-through
        [[x_boss, g["y_in"] - 0.003, zU(x_boss)], [x_boss, g["y_in"] - 0.003, zh_u]],   # boss tie -> hole, upper
        [[x_boss, g["y_in"] - 0.003, zL(x_boss)], [x_boss, g["y_in"] - 0.003, zh_l]],   # boss tie -> hole, lower
        [[x_face, yo, zh_u], [x_face, yo, g["esc_z"] - 0.014]],                     # outboard face, upper
        [[x_face, yo, zh_l], [x_face, yo, -g["esc_z"] + 0.014]],                    # outboard face, lower
        [[g["esc_x0"] - 0.012, yo, g["esc_z"]], [g["esc_x0"] - 0.012, yo, g["tail_top"](g["tail_x0"])]],   # phase, up
        [[g["esc_x0"] - 0.012, yo, -g["esc_z"]], [g["esc_x0"] - 0.012, yo, -g["tail_top"](g["tail_x0"])]],  # phase, low
        [[x_srv, g["aft_exit"][1] + 0.004, zU(x_srv) - 0.003], [x_srv, 0.285, zU(x_srv) - 0.003]],  # servo groove
        [[x_srv, 0.285, zU(x_rec[0]) - 0.003], [x_rec[1], 0.285, zU(x_rec[0]) - 0.003]],    # branch + JR recess
    ]
    pod_legs = [
        [[bars[0], -0.044, bars[2]], [x_cross - 0.012, -0.044, bars[2]]],          # left channel, bars aft (tunnel)
        [[x_cross, -g["bay_hw"] - 0.006, zw + 0.004], [x_cross, g["bay_hw"] + 0.006, zw + 0.004]],  # crossing
        [[fc_x1, yc - 0.004, zw + 0.006], [x_cross, yc - 0.004, zw + 0.006]],     # right channel aft of the FC
        [[x_sexit, yc, z_sexit], [x_sexit, g["pod_hw"], z_sexit]],                 # right side exit
        [[x_sexit, -yc, z_sexit], [x_sexit, -g["pod_hw"], z_sexit]],               # left side exit
        [[x_under, -yb, z_under], [x_under, yb, z_under]],                         # under-pack channel
        [[x_under, 0.040, 0.030], [fc_x1, 0.040, 0.030]],                          # right channel along the FC
        [[x_under, -0.032, 0.025], [-0.058, -0.032, 0.025]],                       # left channel front (RX, airspeed)
        [[g["x_leg"], g["leg_y"], 0.064], [g["x_leg"], g["leg_y"], g["grip_z"]]],  # GPS cable in the right leg
    ]
    pod_box = [[g["pod_x0"], g["pod_x1"]], g["pod_hw"], g["pod_z0"]]
    grooves = {"x_sig_m": x_sig, "x_pos_m": x_pos, "x_neg_m": x_neg, "x_servo_m": x_srv, "y_end_m": y_gend,
               "p1_y_upper_m": y_p1, "p1_y_lower_m": y_p1b, "fin_hole_x_m": x_hole, "fin_hole_dz_m": hole_dz,
               "side_exit_x_m": [x_sexit - 0.008, x_sexit + 0.008], "side_exit_z_m": [z_sexit - 0.006, z_sexit + 0.006],
               "cross_x_m": x_cross, "under_pack_x_m": x_under, "jr_row_x_m": x_jr,
               "jr_recess_x_m": list(x_rec), "servo_lead_hole_x_m": x_lh,
               "p1s_jog_m": [x_sig - P1S_DX - 0.0020 * P1S_DX / 0.0065, y_p1b - 0.0015, x_sig, y_p1b + 0.0070]}
    # D-86: P1s -> signal groove (x0 y0 x1 y1); D-88: on the lead's own line (P1s mouth y_p1b + 0.5 mm -> signal
    # groove at y_p1b + 7 mm, run back 2 mm into the mouth); before it ran at a shallower slope and the lead rubbed its wall
    for st in STATIONS:
        grooves["xt30u_%s_xyz_m" % st] = xt30[st][0]
        grooves["xt30u_%s_pigtail_path_m" % st] = xt30[st][1]
    passes.append(["Tunnel under the cradle at the left XT30U pair (y -0.0582 ... -0.0345, z 0.0206 ... 0.0366: two "
                   "5.2 mm plugs stacked + the right pairs)", 23.7 * 16.0 - 2 * 10.2 * 5.2, [[16, 4]]])
    return wires, fittings, passes, {"side_R": side_legs, "pod": pod_legs}, pod_box, grooves


# ============================================================================ edges, parts, outputs
EDGE_INFO = {
    # edge: (part_a, part_b, via, signal/current text)
    "E-HRN-10": ("PWR-001", "PWR-002", "CT-AS150U"),
    "E-HRN-11": ("PWR-002", "PWR-003", "CT-SOLDER-DC"),
    "E-HRN-12": ("PWR-003", "PWR-004", "CT-SOLDER-DC"),
    "E-HRN-13": ("PWR-004", "PRP-002-UR", "CT-XT30U"),
    "E-HRN-14": ("PWR-004", "PRP-002-UL", "CT-XT30U"),
    "E-HRN-15": ("PWR-004", "PRP-002-LR", "CT-XT30U"),
    "E-HRN-16": ("PWR-004", "PRP-002-LL", "CT-XT30U"),
    "E-HRN-17": ("PRP-002-UR", "PRP-001-UR", "CT-SOLDER-PHASE"),
    "E-HRN-18": ("PRP-002-UL", "PRP-001-UL", "CT-SOLDER-PHASE"),
    "E-HRN-19": ("PRP-002-LR", "PRP-001-LR", "CT-SOLDER-PHASE"),
    "E-HRN-20": ("PRP-002-LL", "PRP-001-LL", "CT-SOLDER-PHASE"),
    "E-HRN-34": ("PRP-002-UR", "PWR-008-UR", "CT-SOLDER-DC"),
    "E-HRN-35": ("PRP-002-UL", "PWR-008-UL", "CT-SOLDER-DC"),
    "E-HRN-36": ("PRP-002-LR", "PWR-008-LR", "CT-SOLDER-DC"),
    "E-HRN-37": ("PRP-002-LL", "PWR-008-LL", "CT-SOLDER-DC"),
    "E-HRN-23": ("PWR-003", "AVN-001", "CT-PIN-HEADER-LINK"),
    "E-HRN-24": ("AVN-001", "PRP-002-UR", "CT-SERVO-JR"),
    "E-HRN-25": ("AVN-001", "PRP-002-UL", "CT-SERVO-JR"),
    "E-HRN-26": ("AVN-001", "PRP-002-LR", "CT-SERVO-JR"),
    "E-HRN-27": ("AVN-001", "PRP-002-LL", "CT-SERVO-JR"),
    "E-HRN-28": ("AVN-001", "MEC-001-L", "CT-SERVO-JR"),
    "E-HRN-29": ("AVN-001", "MEC-001-R", "CT-SERVO-JR"),
    "E-HRN-30": ("AVN-001", "AVN-002", "CT-JST-GH-6"),
    "E-HRN-31": ("AVN-001", "AVN-003", "CT-JST-GH-4"),
    "E-HRN-32": ("AVN-001", "AVN-004", "CT-JST-GH-4"),
}
XT30_EDGES = ("E-HRN-38", "E-HRN-39", "E-HRN-40", "E-HRN-41")      # HRN-113-<st> tied to the pod bundle (D-74)
SRV_GPM = round((2 * 4.0 + 1.1) / 3, 3)    # servo lead g/m per conductor: + / - 22 AWG, signal 28 AWG (D-74 follow-up)
SRV_DIA_MM = (0.9, 1.3, 1.3)               # drawn conductors across the 4.0 mm servo groove: signal 28, + 22, GND 22
HRN_CTS = [
    {"id": "CT-XT30U", "kind": "electrical", "method": "connector",
     "spec": "Amass XT30U 2-pin keyed (20 A) in line in an ESC power pair just inside the pod side exit: female on the "
             "bus-bar pigtail (soldered on the bench), male on the ESC lead; both ends of the pair soldered (D-74, WB-03)"},
    {"id": "CT-PIN-HEADER-LINK", "kind": "electrical", "method": "connector",
     "spec": "28 AWG ribbon with a male pin header at each end, plugged into the CoreWing PDB and FC board-to-board "
             "sockets (pitch measured at power BOARD-CHECK.md step 4; 1.27 mm -> bought IDC ribbon); case S only"},
    {"id": "CT-HEATSHRINK", "kind": "mechanical", "method": "bonded", "structural": False,
     "spec": "adhesive-lined 3:1 heat-shrink (BOM HRN-107) shrunk over a soldered lead where it leaves the part face; "
             "holds on the lead and the joint, carries no load (D-88)"},
]
FC_PORT = {"E-HRN-24": "SERVO4 (out 4, motor UR)", "E-HRN-25": "SERVO2 (out 2, motor UL)",
           "E-HRN-26": "SERVO1 (out 1, motor LR)", "E-HRN-27": "SERVO3 (out 3, motor LL)",
           "E-HRN-28": "SERVO5 (out 5, elevon L)", "E-HRN-29": "SERVO6 (out 6, elevon R)"}

# per-wire text columns: signal, connector at each end, supports, strain relief, disconnect note
WTEXT = {
    "W-PACK": ("Pack + / - (pack's own 10 AWG lead)", "pack terminal (factory)", "AS150U pack half",
               "over the aft stop (edge taped) inboard of the left handle leg into the park",
               "AS150U body held in the 60 mm park; lead heat-shrink at the plug", "field disconnect (only one)"),
    "W-MAIN-1": ("Vbat main + / - (10 AWG jumper, F1 PWR-002)", "AS150U aircraft half (solder cup)",
                 "power board input pads (aft edge)", "power frame deck plane (cups in line with the pads)",
                 "adhesive heat-shrink 15 mm over each cup; formed before soldering", "soldered"),
    "W-MAIN-2": ("Vbat main + / - (10 AWG jumper, F1 PWR-002)", "power board output pads (aft edge)",
                 "bus bars, aft end (solder)", "down through the deck window, two bends >= 2 x OD (F1 CL-PWR-BEND)",
                 "heat-shrink; jumpers formed before soldering", "soldered"),
    "W-PMOD": ("Power-board link, case S (D-74): BATT_VOLT, BATT_CURR, FC-BEC 5 V x1, servo-BEC Vx 6 V x4, GND x3 "
               "(10 of the board-to-board contacts, flat 28 AWG ribbon folded in two)",
               "male pin header (pitch per power BOARD-CHECK.md step 4) in the PDB board-to-board socket",
               "male pin header in the FC board-to-board socket",
               "over the deck front edge, down inboard of the airspeed board, corridor under the deck (y -0.028), "
               "under-pack channel (taped), under the FC", "tie within 20 mm of each header; header held by the "
               "board's own socket + a dab of hot glue", "pin headers both ends (case U: no cable, boards stacked)"),
    "W-GPS": ("GPS UART (SERIAL5 TX/RX) + I2C SDA/SCL + 5 V + GND", "JST-GH 6 (pre-crimped contacts, housing "
              "fitted after threading the leg)", "JST-GH 6 at the GPS", "right side wall at z 0.06 m (taped), "
              "right handle-leg bore, grip (2 ties), mast (1 tie)", "30 mm service loop at the mast base; ties",
              "GH at the GPS; FC end GH"),
    "W-ASPD": ("I2C branch SDA/SCL + 5 V + GND to MS4525DO (0x28)", "Y-splice on W-GPS, 15 mm from the FC port",
               "JST-GH 4 at the airspeed sensor", "along the FC, under-pack channel, left channel front",
               "splice under adhesive heat-shrink, tied to the FC plate", "GH at the sensor"),
    "W-RX": ("CRSF: 5 V, GND, FC TX -> RX RX, FC RX <- RX TX", "JST-GH 4 at the FC (SERIAL6)",
             "JST-GH 4 / solder pads at the RP3", "under-pack channel, left channel", "tie at the RX",
             "GH at the FC"),
}


def wire_text(w):
    wid, eid = w[0], w[1]
    if wid in WTEXT:
        return WTEXT[wid]
    if wid.startswith("W-PWR-"):
        st = wid[-2:]
        return ("ESC %s power + / -" % st, "bus bar (solder on the bench, D-74) -> pod pigtail -> XT30U female",
                "XT30U male -> ESC %s power pads (solder) + 680 uF cap" % st,
                "pod floor (tied every <= 80 mm), XT30U body (HRN-113) tied in its station, side exit "
                "(sleeve), + and - in two grooves 5 mm apart under tape, boss-tail tie, fin-hole grommet, tape strips "
                "every <= 50 mm on the outboard face",
                "adhesive heat-shrink over each pad and XT30U joint; lead taped 20 mm from the ESC; never under the "
                "ESC strap", "XT30U (HRN-113-" + st + ") at (%.3f, %.3f, %.3f), %.3f m of route from the bars "
                "(bench: ESC, lead or half-fin swap, WB-03): the pod pigtail is cut to that length + 10 mm loop, the wing "
                "lead gets the rest; ESC end soldered" % (tuple(XT30[st][0]) + (XT30[st][1],)) if st in XT30 else
                "XT30U just inside the pod side exit")
    if wid.startswith("W-PH-"):
        st = wid[-2:]
        return ("Motor %s phases A/B/C" % st, "ESC %s phase pads (solder)" % st,
                "motor %s factory leads (staggered in-line splices)" % st,
                "outboard board face (tape strips), tie at the collar-tail front (x 0.060, CR-F2-16), free <= 50 mm to the motor base, >= 5 mm off the bell",
                "splices staggered 10 mm, each heat-shrunk, outer 30 mm sleeve; collar tie takes the pull",
                "none: motor swap = 3 splices (bench); phase order recorded on a label (F4 rotation)")
    if wid.startswith("W-SIG-") and wid.endswith("-P"):
        st = wid[6:8]
        return ("DShot300 bidirectional + GND, motor %s" % st, "FC output pad (solder)",
                "JR male on the tray tie bar", "tray", "tie bar on the tray; pigtail <= 100 mm (F3)", "JR in-line")
    if wid.startswith("W-SIG-"):
        st = wid[6:8]
        return ("DShot300 bidirectional + GND, motor %s (twisted, no power)" % st, "JR female on the tray tie bar",
                "ESC %s factory signal lead (solder splice)" % st,
                "pod floor, side exit, signal groove (upper) or P1 + lower signal groove, boss tie, fin hole, "
                "board-face tape strips", "tie at the JR; splice heat-shrunk and taped 20 mm from the ESC",
                "JR in-line on the tray")
    if wid.startswith("W-SRV-") and wid.endswith("-P"):
        return ("Elevon %s PWM 50 Hz + servo rail (+ / - 22 AWG, signal 28 AWG)" % wid[6], "FC output pad + rail (solder)",
                "JR male on the tray tie bar", "tray", "tie bar; pigtail <= 100 mm", "JR in-line")
    if wid.startswith("W-SRV-") and wid.endswith("-S"):
        return ("Elevon %s servo's own lead (MEC-001, shortened to 40 mm)" % wid[6],
                "JR male, re-terminated (crimp kit HRN-105), in the recess", "servo case (factory)",
                "branch groove 8 mm, D1 lead hole (4 mm square, straw), pocket ceiling to the case front",
                "straw in the hole; lead pinched by the pocket cover at the case front", "JR in the recess")
    if wid.startswith("W-SRV-"):
        return ("Elevon %s PWM 50 Hz + 6 V + GND (+ / - 22 AWG red / black, signal 28 AWG, laid flat)"
                % wid[6], "JR female on the tray tie bar",
                "JR female in the 18 x 10 x 5 mm recess at the branch end (x 0.150-0.168)",
                "pod floor, crossing (L only), D2 aft exit, servo groove aft of the spar, upper branch groove at "
                "|y| 0.285 (D1)", "tie at the JR; JR bodies taped in the recess under a re-openable tape flap",
                "JR in the wing recess (servo swap: lift the flap, unplug)")
    if wid.startswith("W-CAP-"):
        st = wid[-2:]
        return ("ESC %s bus decoupling: 680 uF cap + / - (cap's own legs, PWR-008)" % st,
                "ESC %s power pads (solder, with the power lead)" % st, "cap body (factory legs)",
                "on the fin outboard face, cap in line aft of the ESC; legs formed forward 90 deg",
                "legs sleeved (heat-shrink), cap foam-taped to the face (E-PWR-11...14)", "soldered")
    return ("", "", "", "", "", "")


def route_id(w):
    return "R-HRN-" + w[0][2:]


BUNDLE_K = {1: 1.0, 2: 2.0, 3: 2.155, 4: 2.414, 5: 2.701, 6: 3.0}   # circumscribed circle of n equal circles


def draw_dia(wires, od_table):
    """{edge id: drawn tube diameter m}: bundle OD of the edge's largest row, capped at 6 mm (10 AWG pairs)."""
    od = dict((int(a), b) for a, b in od_table)
    out = {}
    for w in wires:
        d = min(0.006, od.get(int(w[2]), 1.0) * BUNDLE_K.get(int(w[3]), 3.0) / 1000.0)
        out[w[1]] = round(max(out.get(w[1], 0.0), d), 4)
    return dict(sorted(out.items()))


def _unit(v):
    n = math.sqrt(sum(c * c for c in v))
    return [c / n for c in v] if n > 1e-12 else None


def _cross(a, b):
    return [a[1] * b[2] - a[2] * b[1], a[2] * b[0] - a[0] * b[2], a[0] * b[1] - a[1] * b[0]]
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
