davinciucberkeley-collab/DBF-Combined/redesign/team/D6/mech_calcs.py

"""D6 mechanisms claims for the proof chain (K09-L, revision D6-R2: mass reduction, CF bridge rod).

Run from the repo root after subsystems/mechanisms/make_mechanisms.py:
    python -I redesign/team/D6/mech_calcs.py
then python -I redesign/proofs/build_graph.py. Every calculation is a pure function of its named inputs; the four-bar
solver is the one in subsystems/mechanisms/fusion/mechanisms.py (same code as the CAD).

Sign convention (hinge frame, x-z plane): delta > 0 = trailing edge DOWN; theta > 0 = servo arm hole moving aft.
Hinge moment model: H(delta) = Ch_max (delta / 25 deg) q c^2 b (ASM-D6-CH-LINEAR), Ch_max = B2's inviscid bound.
"""
import importlib.util
import math
import sys
from pathlib import Path

HERE = Path(__file__).resolve().parent
REDESIGN = HERE.parents[1]
sys.path.insert(0, str(REDESIGN / "proofs"))
import proofkit as pk  # noqa: E402

_spec = importlib.util.spec_from_file_location("mec_cad", REDESIGN / "subsystems" / "mechanisms" / "fusion" /
                                               "mechanisms.py")
sys.path.insert(0, str(REDESIGN / "fusion"))
MEC = importlib.util.module_from_spec(_spec)
_spec.loader.exec_module(MEC)

kit = pk.Kit(__file__, params=["../../params/params.json", "../B2/params.json",
                               "../../subsystems/mechanisms/params.json", "../../subsystems/fins/params.json"])
G0 = 9.80665
SERVOS = ["MEC-001-L", "MEC-001-R"]
LINK = ["MEC-002-L", "MEC-002-R", "MEC-003-L", "MEC-003-R", "MEC-004-L", "MEC-004-R"]
BRIDGE = ["MEC-004-L", "MEC-004-R", "MEC-005-L", "MEC-005-R", "MEC-006-L", "MEC-006-R"]
TUBES = ["MEC-009-LI", "MEC-009-LO", "MEC-009-RI", "MEC-009-RO"]

# ---------------------------------------------------------------- sources and assumptions
kit.source("SRC-D6-SH0255", "Savox SH-0255MG+ listing (3.1/3.9 kgf cm at 4.8/6 V, 15.8 g, 22.8 x 12.0 x 29.4 mm)",
           "web", url="https://lindinger.at/en/RC-ELECTRONICS/Servos-Accessories/Servos-Digital-Low-Voltage/"
                      "SAVOEX-SH-0255MG-6V-3-9KG-0-13s-Digital-Micro-Servo/9795255",
           where="spec table; distributor sheet https://www.cmldistribution.co.uk/product/SAV-SH0255MG+/ gives 16 g",
           note="retailer data, not the maker's sheet; weigh and bench the delivered servo", status="UNVERIFIED")
kit.source("SRC-D6-SH0255-STALL", "SH-0255MG stall current 1.2 A / 1.4 A at 4.8 / 6.0 V", "web",
           url="https://www.rcjaz.com/savox-sh0255mg-metal-gear-digital-servo-micro-p-90039418.html",
           where="retailer spec list", status="UNVERIFIED")
kit.source("SRC-D6-SH0255-PRICE", "SH-0255MG+ price $41.99 (US retailers, Nov 2026)", "web",
           url="https://www.whiterosehobbies.com/products/savox-sh0255mgp-micro-digital-mg-servo-with-soft-start",
           status="UNVERIFIED")
kit.source("SRC-D6-ES3054", "EMAX ES3054 listing (3.0/3.5 kgf cm, 17 g class, 20.1 g measured by one seller)",
           "web", url="https://alofthobbies.com/products/emax-es3054-servo-3-5kg-48-6-oz-in-13-sec-17-grams",
           note="fallback servo, cheaper; fails the unprotected VD case", status="UNVERIFIED")
kit.source("SRC-D6-WIRE", "Music wire ASTM A228: E 200 GPa, G 79 GPa, 7.85 g/cm3, UTS >= 1 700 MPa at 1/8 in",
           "web", url="https://www.astm.org/a0228_a0228m-16.html", status="UNVERIFIED")
kit.source("SRC-D6-CFROD", "Pultruded unidirectional carbon rod 1/8 in: E 110-140 GPa, 1.55-1.6 g/cm3, flexural "
           "strength >= 1 000 MPa", "web", url="https://www.cstsales.com/carbon_rods.html",
           where="rod table; low-end modulus used (110 GPa)", note="weigh and bend-test one rod (T-D6-TWIST)",
           status="UNVERIFIED")
kit.source("SRC-D6-CLEVIS", "Du-Bro 2-56 threaded rod (0.072 in) and 2-56 steel clevis", "web",
           url="https://www.dubro.com/collections/pushrods-and-control-rods", status="UNVERIFIED")
kit.source("SRC-D6-CFTUBE", "Roll-wrapped CF tube 5 x 4 mm x 1 000 mm, 1.55 g/cm3", "web",
           url="https://www.dragonplate.com/", note="any hobby roll-wrapped 5 x 4 tube; G unknown, see ASM-D6-TUBE-G",
           status="UNVERIFIED")
kit.source("SRC-D6-PETG", "PETG filament density 1.27 g/cm3 (maker data sheets)", "web",
           url="https://www.prusa3d.com/product/prusament-petg-jet-black-1kg/", status="UNVERIFIED")

kit.assumption("ASM-D6-CH-LINEAR", "Hinge moment linear in deflection",
               "H(delta) = Ch_max * delta / 25 deg * q c^2 b; Ch_max is B2's inviscid bound at 25 deg",
               basis="XFOIL inviscid HMOM grows close to linearly with deflection (FIG B2-04); the bound at 25 deg is "
                     "kept, so mid-travel values are slightly conservative", status="UNVERIFIED")
kit.assumption("ASM-D6-SERVO-THROW", "Servo throw +/-45 deg at 1000-2000 us",
               "The SH-0255MG+ turns at least +/-45 deg between 1000 and 2000 us (ArduPilot SERVOn_MIN/MAX)",
               basis="typical of digital micro servos; not published for this servo (T-D6-THROW)", value=45.0,
               unit="deg", status="UNVERIFIED")
kit.assumption("ASM-D6-BACKLASH", "Servo output backlash 1 deg", "Free play at the metal-gear output, new servo",
               basis="hobby metal-gear micro servos measure 0.5-1 deg; upper value used", value=1.0, unit="deg",
               status="UNVERIFIED")
kit.assumption("ASM-D6-TUBE-G", "Torque-tube shear modulus 5 GPa", "In-plane shear modulus of a 0/90 roll-wrapped CF "
               "tube", basis="0/90 laminates 4-6 GPa; +/-45 wraps reach 20 GPa; low end used", value=5.0e9, unit="Pa",
               status="UNVERIFIED")
kit.assumption("ASM-D6-XPS-G", "XPS shear modulus 8 MPa", "F-250 class XPS, 25-35 kg/m3",
               basis="published XPS shear moduli 5-12 MPa", value=8.0e6, unit="Pa", status="UNVERIFIED")
kit.assumption("ASM-D6-CLEAR-MIN", "Minimum running clearance 1 mm", "Gap between a moving part and anything it passes, "
               "through the full mechanical travel", basis="print and cut tolerance 0.3-0.5 mm, foam dents",
               value=0.001, unit="m")
kit.assumption("ASM-D6-SLOP-MAX", "Surface free play <= 1 deg", "Worst-case sum of linkage free play at the surface",
               basis="hobby practice for stabilised flying wings; ArduPilot rate loops limit-cycle with more",
               value=1.0, unit="deg")
kit.assumption("ASM-D6-EFF-LOSS-MAX", "Elevon effectiveness loss <= 10 % at VA",
               "Mean panel lag (rod bending + twist) at full travel and VA, as a fraction of the 25 deg travel",
               basis="the loss scales with q: about 6 % at cruise; B3 to confirm against its roll-rate and trim "
                     "margins (CR-D6-08)", value=0.10, unit="-")
kit.assumption("ASM-D6-TAPE-G", "Closed tape skin effective shear modulus 0.5 GPa", "BOPP packing tape, one layer, "
               "LE bevel face taped so the panel skin is a closed cell", basis="BOPP G about 1 GPa; 50 % credit for "
               "adhesive shear lag and overlaps", value=0.5e9, unit="Pa", status="UNVERIFIED")
kit.assumption("ASM-D6-TORQUE-AT-SERVO", "R-SERVO-TORQUE applies at the servo output",
               "The 1.5 x hinge moment is compared with the servo stall torque after the linkage ratio dDelta/dTheta "
               "(virtual work), at the worst point of the travel",
               basis="the servo sees the hinge moment through the four-bar; B2's 3.93 kgf cm assumed 1:1; A2 to "
                     "confirm (CR-D6-07)", status="PROPOSED")


# ---------------------------------------------------------------- helpers (pure)
def interp(xs, ys, x):
    for (x0, y0), (x1, y1) in zip(zip(xs, ys), zip(xs[1:], ys[1:])):
        if x0 <= x <= x1:
            return y0 + (y1 - y0) * (x - x0) / (x1 - x0)
    return ys[0] if x < xs[0] else ys[-1]


def rot(X, Z, delta):
    """Rotate a hinge-frame point by delta (TE down positive moves points below the axis forward)."""
    d = math.radians(delta)
    return (X * math.cos(d) + Z * math.sin(d), -X * math.sin(d) + Z * math.cos(d))


def sweep(lo, hi, n=121):
    return [lo + (hi - lo) * i / (n - 1) for i in range(n)]


def linkage(xh, sx, szl, rh, rs, xs, above):
    zh = interp(sx, szl[0], xh)
    zs = interp(sx, szl[1], xs) + above
    return (xh, zh, rh, xs, zs, rs)


# ---------------------------------------------------------------- calculations
@kit.calc("CALC-D6-HINGE", title="Elevon hinge moment per servo (two panels)",
          equation="H = Ch_max (delta/25) q c^2 (b_in + b_out), q = rho V^2 / 2",
          inputs={"ch": "P:b2.xfoil.hinge_coef_max", "rho": "P:env.rho_kgm3", "c": "P:wing.chord_m",
                  "yin": "P:wing.elevon.inboard_y_m", "yout": "P:wing.elevon.outboard_y_m", "vd": "P:requirements.vd_ms",
                  "va": "ASM-F4-VA-SCHED", "vc": "P:performance.cruise_ms", "trim": "CL-B3-ELEVON-TRIM-CRUISE",
                  "defl": "P:wing.elevon.deflection_deg"},
          units={"rho": "kg/m3", "c": "m", "yin": "m", "yout": "m", "vd": "m/s", "va": "m/s", "vc": "m/s"},
          assumes=["ASM-D6-CH-LINEAR", "ASM-B2-HINGE-INVISCID"])
def hinge(ch, rho, c, yin, yout, vd, va, vc, trim, defl):
    bi, bo = yin[1] - yin[0], yout[1] - yout[0]
    dmax = max(abs(defl[0]), abs(defl[1]))
    H = lambda v, d: ch * (abs(d) / 25.0) * 0.5 * rho * v * v * c * c * (bi + bo)
    return {"H_vd_full_Nm": H(vd, dmax), "H_va_full_Nm": H(va, dmax), "H_cruise_trim_Nm": H(vc, trim),
            "share_out": bo / (bi + bo), "b_in_m": bi, "b_out_m": bo, "q_vd_Pa": 0.5 * rho * vd * vd}


@kit.calc("CALC-D6-KIN", title="Servo-to-elevon four-bar: throw, ratio, torque factor",
          equation="|P(theta) - Q(delta)| = L0; k(theta) = d delta / d theta; worst servo torque / H25 = "
                   "max over travel of (delta/25) k",
          inputs={"xh": "CL-A5-HINGE-X", "sx": "P:mec.section.x_m", "szu": "P:mec.section.zu_m",
                  "szl": "P:mec.section.zl_m", "rh": "P:mec.horn.r_m", "rs": "P:mec.arm.r_m",
                  "xs": "P:mec.station.shaft_x_m", "above": "P:mec.station.shaft_above_skin_m",
                  "defl": "P:wing.elevon.deflection_deg", "stop": "P:mec.mech_stop_deg"},
          units={"xh": "m", "rh": "m", "rs": "m", "xs": "m", "above": "m"})
def kinematics(xh, sx, szu, szl, rh, rs, xs, above, defl, stop):
    lk = linkage(xh, sx, (szu, szl), rh, rs, xs, above)
    dmax = max(abs(defl[0]), abs(defl[1]))
    th_dn, th_up = MEC.theta_of_delta(lk, dmax), MEC.theta_of_delta(lk, -dmax)
    ratio = lambda t, h=0.05: abs(MEC.delta_of_theta(lk, t + h) - MEC.delta_of_theta(lk, t - h)) / (2 * h)
    worst = 0.0
    for t in sweep(min(th_dn, th_up), max(th_dn, th_up), 181):
        worst = max(worst, abs(MEC.delta_of_theta(lk, t)) / 25.0 * ratio(t))
    return {"theta_dn_deg": th_dn, "theta_up_deg": th_up, "theta_need_deg": max(abs(th_dn), abs(th_up)),
            "theta_stop_dn_deg": MEC.theta_of_delta(lk, stop), "theta_stop_up_deg": MEC.theta_of_delta(lk, -stop),
            "k_neutral": ratio(0.0), "k_end_dn": ratio(th_dn), "k_end_up": ratio(th_up), "torque_factor": worst,
            "rod_len_m": MEC.rod_length(lk)}


@kit.calc("CALC-D6-SERVO", title="Servo torque required at the output vs rating",
          equation="T = SF x H x torque_factor (four-bar, worst point); kgf cm = N m / g x 100",
          inputs={"hvd": "CL-D6-H-VD-FULL", "hva": "CL-D6-H-VA-FULL", "tf": "CL-D6-TORQUE-FACTOR",
                  "sf": "P:requirements.servo_torque_factor"}, units={"hvd": "N*m", "hva": "N*m"},
          assumes=["ASM-D6-TORQUE-AT-SERVO"])
def servo_torque(hvd, hva, tf, sf):
    t = lambda h: sf * h * tf / G0 * 100
    return {"T_req_vd_kgfcm": t(hvd), "T_req_va_kgfcm": t(hva), "T_hold_vd_kgfcm": hvd * tf / G0 * 100,
            "T_req_1to1_vd_kgfcm": sf * hvd / G0 * 100}


@kit.calc("CALC-D6-PUSHROD", title="Pushrod force, buckling and horn bond area",
          equation="F = H / (r_h sin phi) worst; Pcr = pi^2 E I / L^2; A_min = F sf ff pf / (kd sigma_XPS)",
          inputs={"hvd": "CL-D6-H-VD-FULL", "xh": "CL-A5-HINGE-X", "sx": "P:mec.section.x_m",
                  "szu": "P:mec.section.zu_m", "szl": "P:mec.section.zl_m", "rh": "P:mec.horn.r_m",
                  "rs": "P:mec.arm.r_m", "xs": "P:mec.station.shaft_x_m", "above": "P:mec.station.shaft_above_skin_m",
                  "d": "P:mec.pushrod.d_m", "E": "P:mec.pushrod.e_pa", "sf": "P:requirements.safety_factor_ult",
                  "ff": "ASM-C1-FITTING-FACTOR", "pf": "ASM-C1-PRINTED-FACTOR", "kd": "ASM-C6-FOAM-KD",
                  "s_xps": "ASM-D3-XPS-TENSILE", "flange": "P:mec.horn.flange_mm", "back": "P:mec.horn.backplate_mm",
                  "blade": "P:mec.horn.blade_x_mm", "defl": "P:wing.elevon.deflection_deg"},
          units={"hvd": "N*m", "xh": "m", "rh": "m", "rs": "m", "xs": "m", "above": "m", "d": "m", "E": "Pa"})
def pushrod(hvd, xh, sx, szu, szl, rh, rs, xs, above, d, E, sf, ff, pf, kd, s_xps, flange, back, blade, defl):
    lk = linkage(xh, sx, (szu, szl), rh, rs, xs, above)
    L0 = MEC.rod_length(lk)
    dmax = max(abs(defl[0]), abs(defl[1]))
    fmax = 0.0
    for dl in sweep(-dmax, dmax, 101):
        th = MEC.theta_of_delta(lk, dl)
        p, q = MEC.arm_hole(lk, th), MEC.horn_hole(lk, dl)
        ux, uz = (p[0] - q[0]) / L0, (p[1] - q[1]) / L0
        ax, az = q[0] - lk[0], q[1] - lk[1]                         # horn arm vector
        lever = abs(ax * uz - az * ux)                              # r_h sin(phi)
        fmax = max(fmax, hvd * abs(dl) / 25.0 / lever)
    I = math.pi * d ** 4 / 64
    pcr = math.pi ** 2 * E * I / L0 ** 2
    fd = fmax * sf * ff * pf
    a_min = fd / (kd * s_xps) * 1e6
    zu = lambda x: interp(sx, szu, x)
    zl = lambda x: interp(sx, szl, x)
    t_blade = sum(zu(xh + x / 1000) - zl(xh + x / 1000) for x in sweep(blade[0], blade[1], 21)) / 21
    area = (flange[1] - flange[0]) * flange[2] + (back[1] - back[0]) * back[2] + \
        2 * (blade[1] - blade[0]) * t_blade * 1000
    return {"F_max_N": fmax, "F_design_N": fd, "Pcr_N": pcr, "buckling_sf": pcr / fmax, "A_min_mm2": a_min,
            "A_horn_mm2": area, "rod_len_m": L0}
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
