davinciucberkeley-collab/DBF-Combined/(commit log)

2026-11-09 Repository rules: Git LFS for CAD/media, ignore generated copies, logs and secrets
    .gitattributes routes STEP/STP/F3D/SOLIDWORKS/STL/3MF/MP4/MOV/PDF/XLSX through
    Git LFS, except cad/mesh/*.stl (read by the CI review build) and the drawing
    set PDF (linked from the review page, served by GitHub Pages).
    .gitignore starts from the DillonVTOL rules and adds: env/secret files,
    the review/ and inventory/ fragment copies of the generated pages, logs,
    Python caches, and OpenCAE example solver runs.
2026-11-09 Import the C0 lift + cruise package from DillonVTOL main (cd21931)
    Snapshot of davinciucberkeley-collab/DillonVTOL at cd21931662516fe07fee9faf010b61712e2d3372
    (2026-11-03): the 11-02 resize (Vc 18 m/s, MTOW 7.44 kg, S 0.774 m2), CAD rev G,
    3-D CFD, validation matrix, review pages and GitHub Pages entry point. For every
    file that also exists in DBF-VTOL this is the newer version: DBF-VTOL changed
    none of them after the shared commit 3d45b69 except README/CLAUDE/PRODUCT.
    Left out (see PROVENANCE.md):
    - review/{vtol-review,build-manual,test-plan,flight-software,templates}.html,
    fragment copies of the root pages that review/build.mjs writes twice
    - orchestration/build logs nothing cites: anal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
    [Aileron_L.SLDPRT, Aileron_L.STL, Aileron_R.SLDPRT, Aileron_R.STL, Battery_6S_LiPo.SLDPRT, Battery_6S_LiPo.STL, Battery_Tray.SLDPRT, Battery_Tray.STL]
2026-11-09 Import DBF-VTOL-only content from DBF-VTOL main (9cc31fe)
    From davinciucberkeley-collab/DBF-VTOL at 9cc31fe911dcad87f8b70c105177b248588870b1
    (2026-11-04), the material that never reached DillonVTOL:
    - inventory/ (master list, electrical, hardware schedule, Fusion model, v031/ frozen inputs)
    - fusion/ (Fusion 360 build, joint, kinematics and clearance scripts)
    - concepts/ (eleven literature concepts and alternative designs A1-A3)
    - sim/ (browser flight demo), Inventory-Overview.html, Concept-Models.html
    - docs/research/{electrical-architecture,hardware-schedule,nautical-wings-props,tolerance-analysis}.md
    - CLAUDE.md and PRODUCT.md (only DBF-VTOL edited them after the fork: team list, sibling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
    [ASPD1.stl, Aileron_L.STL, Aileron_L.stl, Aileron_R.STL, Aileron_R.stl, Arm_Aileron_L.stl, Arm_Aileron_R.stl, Arm_Elevator.stl]
2026-11-09 Add the tilt-wing exploration and OpenCAE Studio as snapshots
    explorations/tiltwing/: davinciucberkeley-collab/TiltWing at 1488f8f, which is
    DBF-VTOL branch design2 (aef0007) tiltwing/ plus an origin note. Marked in its
    README as an archived exploration, not the baseline. The source paper PDF is not
    included (licence unknown); the README cites doi:10.3906/elk-2105-59 instead.
    tools/opencae-studio/: davinciucberkeley-collab/OpenCAEModel at 792f0ab
    (OpenCAE Studio 0.2 source, docs, packaging, examples, tests). Not included:
    opencae/tests/data/pe/{fakeccx.exe,libdep-1.dll,libfwd.dll,libmid.dll}
    (compiled test fixtures) and opencae/examples/projects/*_data/results/
    (solver runs, regenerated by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
    [Fuselage.stl, H_Tail_NACA0009.stl, Tail_Nacelle_1.stl, Tail_Nacelle_2.stl, Tail_Prop_1.stl, Tail_Prop_2.stl, Tail_Tilt_Spar.stl, TiltWing_cruise_tilt0.step]
2026-11-09 Docs: merged README, DECISIONS.md, PROVENANCE.md; CLAUDE/PRODUCT point here
    README.md is hand-merged: DillonVTOL's current-design table (11-02 resize,
    checked against analysis/results.json, mass_budget.json, validation_matrix.json)
    and DBF-VTOL's inventory, Fusion, concepts and artifact sections. Adds a start
    table, status, one-line-per-folder directory map with the baseline each folder
    is on, how to view the pages, Git LFS note, secrets rule, known issues
    (hard-coded user paths) and the source commits.
    DECISIONS.md records the open design conflicts without resolving them:
    baseline, cruise speed, MTOW/wing, ballast (R12), battery plug (R20, safety),
    ESC, airspeed sensor, GPS, spare motor, s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
2026-11-09 Fix references to the dropped duplicate pages and the moved tilt-wing folder
    - CI: stop diffing review/*.html; those fragment copies are git-ignored now and
    the root pages remain checked
    - tools/vtol.py status: report VTOL-Review.html instead of review/vtol-review.html
    - inventory/build_variants.mjs: "Full design note" links to DBF-Combined
    - explorations/tiltwing/README.md: note that script headers still say tiltwing/
    - drop analysis/cfd3d/out_rev1/scheme_check_2d.json, byte-identical to the
    scheme_check_2d_rev1.json that verify_cfd.py cites
2026-11-09 Redesign v1: brief, adopted decisions (CAD moves to Fusion), folder layout
2026-11-09 Configuration study: 43 concepts, 7 sized and reviewed, 3 judges, synthesis (K09 recommended, tie-break pending)
    [cost.csv]
2026-11-09 Redesign tooling (Fusion framework, interfaces, proofs, Blender, manual kit, viewer) and tie-break evidence (wind, tailsitter)
    [asos_OAK.csv, asos_SFO.csv, cost.csv, kitting.csv, parts.csv, tools.csv]
2026-11-09 Tooling: independent code review and fixes (Fusion sketch visibility, joint frames, vacuous passes, demo ids)
2026-11-09 Design program: frame (A1-A5, J1) and analysis round (B1-B4, C1, E1, E2) for K09-L
    [apc_per3_11x45MR.csv, apc_per3_11x47SF.csv, apc_per3_11x55E.csv, apc_per3_11x55MR.csv, apc_per3_12x45MR.csv, feet.csv, fin_envelope.csv, fin_heightwise.csv]
2026-11-09 Design program: analysis resolution and detail-analysis work in progress
    [BOM.csv, K09L.param, bench_checks.csv, cg.csv, derating.csv, feet.csv, fin_envelope.csv, fin_heightwise.csv]
2026-11-09 Design program: detail analysis round (C2-C6, E3, F1, F3, F5) and resolutions
    [deflection_cases.csv, deflection_envelope.csv]
2026-11-10 Design program: detail resolutions, early design and fix-round work
    [BOM.csv, K09L-STAND.param, K09L.param, WIRE-LIST.csv, feet.csv, fin_envelope.csv, fin_heightwise.csv, joints.csv]
2026-11-10 Design program: subsystem CAD designs and integration checks
    [K09L-STAND.param, K09L.param, mass_model.csv, overrides.csv, parts.csv]
2026-11-10 Design program: integration resolution and partial fix round
    [K09L-STAND.param, K09L.param, WIRE-LIST.csv, derating.csv, feet.csv, fin_envelope.csv, fin_heightwise.csv, gauge_sweep.csv]
2026-11-10 Design program: integration fixes, re-check, simulation round in progress
    [K09L.param, WIRE-LIST.csv, case.cfg, deflection_cases.csv, deflection_envelope.csv, derating.csv, feet.csv, fin_envelope.csv]
2026-11-10 Design program: simulation round partial results (CFD, BEMT, FEA, thermal)
    [case.cfg, history.csv, history_leg00.csv, history_leg01.csv, surface_flow.csv]
2026-11-10 Design program: simulation round complete; stop tracking bulky solver meshes/fields (regenerable)
    [L1_F1-PULLUP-VD_MC-C_B.cfg, L1_F1-PULLUP-VD_MC-C_T.cfg, L1_G2-HANG-MOTOR_MC-P_B.cfg, L1_G2-HANG-MOTOR_MC-P_T.cfg, L1_L1-LEVEL_MC-C_B.cfg, L1_L1-LEVEL_MC-C_T.cfg, L1_L4-CORNER-SIDE-Y_MC-C_B.cfg, L1_L4-CORNER-SIDE-Y_MC-C_T.cfg]
2026-11-10 Design program: simulation resolution and partial fix round
    [case.cfg, feet.csv, fin_envelope.csv, fin_heightwise.csv, joints.csv, mass_model.csv, whiffletree.csv, wing_envelope.csv]
2026-11-11 Design program: simulation fixes and verification update
    [BOM.csv, K09L.param, case.cfg, deflection_cases.csv, deflection_envelope.csv, feet.csv, fin_envelope.csv, fin_heightwise.csv]
2026-11-11 Showcase: Blender renders of the K09-L CAD, STL models for GitHub's 3-D viewer, page captures (morphological chart, decision, overview) and SHOWCASE.md
    [avionics.stl, fins.stl, harness.stl, k09l-assembly.stl, landing.stl, mechanisms.stl, pod.stl, power.stl]
2026-11-11 One-page K09-L explorer site (3-D CAD viewer, decision, team, subsystems, simulations, status, docs)
2026-11-11 Flight-sequence animation (Blender) in the explorer and showcase; explorer quality upgrade (realistic materials, lighting, outlines, part-list fix)
2026-11-11 Animation: show differential thrust, pitching moment and elevons (what rotates the aircraft)
2026-11-11 Proof chains: re-run drifted claims, PROOFS.md summary, proof viewer in the explorer (Proofs link)
    [case.cfg, derating.csv, feet.csv, fin_envelope.csv, fin_heightwise.csv, gauge_sweep.csv, joints.csv, mass_model.csv]
2026-11-11 BOM: Excel workbook with live formulas (team/I1/K09L-BOM.xlsx) and a BOM tab in the explorer
    [K09L-BOM.xlsx]
2026-11-11 Fasteners: servo-cover joint specified (2x M2x6 self-tapping), every joint-stack fastener modelled as a CAD part (41 parts), BOM/Excel, GLB and viewer data rebuilt
    [BOM.csv, K09L-BOM.xlsx, parts.csv]
2026-11-11 Mass budget: fins allocation 437 -> 438 g from the growth allowance (fastener CAD parts); sized total unchanged at 2 600 g
2026-11-11 Explorer: Fasteners view (H) highlights every screw, nut, washer and insert with a hardware summary
2026-11-11 Explorer: Fasteners button works when clicked before the model loads; version tags on scripts/data so browsers pick up updates
2026-11-11 Explorer polish: BOM product links, fast proof viewer, clean harness routing, readable simulations
    - BOM: every line links to a product page (LINKS-CHECK.md logs how each was matched); xlsx and BOM tab regenerated (site/sync_bom_tab.py)
    - Proof viewer: requirements list + 2-D chain view by default, light 2-D overview, calm drift/status line
    - Harness: HRN bundle proxies are mass-only (not drawn); wires re-routed with zero solid and wire-to-wire penetrations (team/F2/ROUTE-CLEARANCE.md); harness 119.8 g, CG unchanged; GLB, renders, drawing, animation regenerated
    - Explorer: simulations tab rewritten as plain-language questions with verdicts; figure frames and lightbox; parts tree starts colla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
    [BOM.csv, K09L-BOM.xlsx, WIRE-LIST.csv, mass_estimate.csv, parts.csv]
2026-11-11 Buildability review, build guide, and clean proof re-run
    - review/: five builder reviews (structure and wing, motor mounts, servos, wiring and battery, manufacturing)
    merged into BUILDABILITY-REVIEW.md: 6 blockers, 30 major, 37 minor, each verified against its evidence
    - BUILD-GUIDE.md: short ordered build guide with stages, inspections, parts and open-fix warnings
    - Proofs: every drifted script re-run (incl. C4 fin FEA, D5 shoe FEA fixed to refuse unconverged runs);
    graph builds clean (0 drift, 0 errors). Real landing mass now counted: predicted CG 52.6 mm is aft of
    the 46.6-51.4 mm range (BR-00), mass gate margin +7 %
    - README, STATUS, PROOFS and explorer Docs tab link the review and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
    [case.cfg, derating.csv, feet.csv, fin_envelope.csv, fin_heightwise.csv, joints.csv, mass_model.csv, parts.csv]
2026-11-11 WIP: fix buildability blockers (CG, fin tip/foot, power board, shop files)
    - D-74/D-79: CoreWing power-board BEC replaces the UBEC and fuse; XT30U pod-wing disconnects; servo power on 22 AWG;
    board bench check (subsystems/power/BOARD-CHECK.md)
    - D-75..D-78: fin tip and foot share one datum (no overlap), lighter feet 59.1 g, landing allocation 60 g, pack forward;
    predicted CG 50.2 mm, back inside 46.6-51.4 mm
    - manufacturing/: one command generates STLs, DXFs, hot-wire templates and jigs from the CAD
    - Paused: motor-mount slit fix not started; proof graph has 82 drifted values to re-run. See RESUME.md.
    [AVN-005_PETG_x1.stl, BOM.csv, CUT-LIST.csv, FIN-003-A_ASA_x4.stl, FIN-003-B_ASA_x4.stl, FIN-004-A_PETG_x2.stl, FIN-004-B_PETG_x1.stl, FIN-007_ASA_x4.stl]
2026-11-12 Fix the remaining buildability blockers; add a no-phasing collision gate
    CAD fixes (params/CHANGE-LOG.md D-80..D-84):
    - D-80/D-81: motor-mount outboard cheek stops 1 mm ahead of the clamp slit (MM-01);
    clocking dog under the mount collar in a notch in the station collar (MM-02, dog
    shear size still open for C6)
    - D-82: horn blade front follows the elevon bevel, so the torque-tube bore no longer
    breaks out; link-horn arm cut-off is a true polygon clip
    - D-83: fin-hole grommets modelled as parts HRN-110-UR/UL/LR/LL (harness mass unchanged)
    - D-84: pack leads re-routed over the aft stop, left handle leg solid (sealed void),
    hinge tape on the upper skin, recess fillet leg 4.8 mm, handle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
    [FIN-003-A_ASA_x4.stl, FIN-003-B_ASA_x4.stl, FIN-008-A_PETG_x4.stl, FIN-008-B_PETG_x4.stl, FIN-010-A_PETG_x1.stl, FIN-010-A_PETG_x2.stl, FIN-010-B_PETG_x1.stl, FIN-010-B_PETG_x2.stl]
2026-11-12 Route every wire without phasing; build animation per stage
    - D-85 harness re-route: fin pairs and signals share square bore approaches,
    lower-station signals through their own 4 mm P1s hole, servo leads via a
    frame lead notch, pod leads between the FC gel cubes, pack lead into the
    AS150U half. Collision gate now meshes every wire: 990 bodies in 185 parts,
    0 penetrations > 0.05 mm, static and at both elevon limits.
    - Proof graph re-converged (0 drift, 0 errors); 90 claims fail on margin.
    New: CL-F2-MASS 135.2 g vs 129 g, CL-F2-I2C-LEN 0.511 m vs 0.5 m (team-lead
    decision, D-85 Open). CG and mass gate unchanged.
    - Shop files: 249 checks, 0 FAIL. GLB and viewer data re-exported.
    -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
    [MEC-008-A_PETG_x2.stl, MEC-008-B_PETG_x2.stl, MEC-008_PETG_x4.stl, PRINT-LIST.csv, PWR-006_PETG_x1.stl, WIRE-LIST.csv, derating.csv, mass_estimate.csv]
2026-11-12 Seat every wire: JR connectors drawn, tape slit, strict no-phasing gate (D-86)
    A close inspection found seven wiring faults the D-85 check excused; all fixed:
    - JR mated pairs drawn as parts HRN-105-1..6 (tray, on edge, FC-output
    order) and HRN-105-SL/SR (servo recess, now 30.5 x 10.8 x 5 mm), sized
    from Pololu drawings; leads no longer end in mid-air.
    - ESC pairs land conductor by conductor on the + and - bars; the 10 AWG
    main jumper drops through the deck window as two conductors.
    - Tape skin slit wherever a lead passes it (cad.skin_slots).
    - Lower-station signal lead stays under the tape via a P1s jog groove.
    - Phase leads tied at the collar lug and taped up the cheek to the motor.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
    [WIRE-LIST.csv, derating.csv, mass_estimate.csv, parts.csv]
2026-11-12 No wire crosses or folds through itself; leads land on real pads; all media regenerated (D-87)
    Team-reported faults (ESC leads stopping at the box edge, a lead hooking over
    the pairs at the left pod exit) plus an end-by-end sweep of every wire:
    - Conductors of a pair / ribbon drawn concentric round every bend (centre line
    rounded first, spacing eased); 12 same-wire crossings removed.
    - ESC pair and DShot lead enter the ESC's aft end face (power pads).
    - Left signal leads cross the pairs inside the pod, leave at the window's
    forward edge; no hook outside.
    - No folds: pack lead on 4 mm arcs, main jumpers on the board pads and onto
    the bar fronts through 3.5 mm arcs, ESC pairs at 8 mm sta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
    [WIRE-LIST.csv, avionics.stl, derating.csv, fins.stl, harness.stl, k09l-assembly.stl, landing.stl, mass_estimate.csv]
2026-11-12 Lighter wire tessellation; all media re-made on the final geometry
    - Corner rounding uses ~10 deg per step (gentle corners stay light) and strand
    polylines drop points within 0.02 mm of their chord: the published model is
    10.2 MB (was 13.9 MB, over the artifact limit). Collision gate re-run on this
    geometry: PASS (0 overlaps, 0 loose ends, 0 folds; 3 poses).
    - Renders + thumbnails, GA drawing, flight animation + GIF, build animation,
    STLs, GLB + viewer data, inspection pictures and page snapshots regenerated
    from it; site/index.html re-synced with app.html.
    [harness.stl, k09l-assembly.stl, wing.stl]
2026-11-13 Check the exported model too; every lead ends square on a real pad (D-88)
    - Second collision gate on the exported assembly.glb (collide.py --glb,
    collide_glb_blender.py), no cutter allowance: 0 part overlaps > 0.05 mm
    (was 57), 0 unseated wire ends, 0 leads off square / off a face (was 34).
    - Exporter: every cut verified (was 47 unverified), each part united into
    one solid with MANIFOLD; Blender 4.5.14 LTS.
    - ESC ends: power pair and signal lead land square on the aft-end pads;
    heat-shrink sleeves HRN-107-* (CT-HEATSHRINK); cap drawn as its 10 x 16
    can; P1s jog groove on the lead's line.
    - Tape trimmed square along the fin root fillets (wing.py fillet_trims);
    fillets on the wing'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
    [WIRE-LIST.csv, avionics.stl, fins.stl, harness.stl, k09l-assembly.stl, landing.stl, mass_estimate.csv, mechanisms.stl]
2026-11-13 Site: in-page build guide with stage clips and in-page proof chain
    Add make_build_guide.py (BUILD-GUIDE.md -> #build, each stage embeds its stage-NN.mp4)
    and make_proof_embed.py (proof viewer markup/CSS -> #proof; app.js gains an embedded
    mode with plain-hash routing #proof, #proof-overview, #proof-<id>). Nav, the Docs
    buttons, the build-animation stage buttons and the Explorer's claim list now link in-site.
2026-11-13 Every lead ends on a drawn termination, checked by name (D-89)
    The FC, RX, airspeed sensor, GPS and power board were plain envelopes, so
    leads in the pod ended on the face of a box; the gate only asked that an end
    sit inside its part. The CAD gate now accepts a wire end only on a named
    termination (pad, solder joint, plug, header, cups, sleeve, lead exit, bus
    bar), and those are drawn:
    - FC: PCB + component envelope; output conductors soldered in their own
    holes, up and into their JR contacts; GH-6 (GPS) and GH-4 (SERIAL6)
    plugs; board-link header under the board.
    - I2C back to the declared Y-splice on the GPS cable, under one sleeve;
    GH-4 plug on the airspeed sensor; GH-6 plug on the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
    [PRINT-LIST.csv, PWR-006_PETG_x1.stl, WIRE-LIST.csv, avionics.stl, harness.stl, k09l-assembly.stl, mass_estimate.csv, mechanisms.stl]
2026-11-13 Build and program planning: G1-G4, H2, H3, I2, F5 plans; Maker Pass BOM R4
    BOM/order plan R4 (owner fact 2026-11-13, Jacobs Maker Pass paid outside the
    budget; Jacobs pages checked the same day):
    - delete soldering-kit lines G07-G09 (Electronics Lab covers iron, solder,
    multimeters); G10 flux/wick stays as a gated fallback X10
    - Jacobs lists no hot-wire cutter: G11 + H05 are bought (gate X11 dissolved),
    G11 moves to the 20 Nov order; withdraws "stated Jacobs capability"
    - bridge() kept balanced; pessimistic spend 1,653.74 -> 1,716.28, reserve
    346.26 -> 283.72 (short of 309 by 25.28); all-in pessimistic reserve
    -57.82 -> +20.45
    - T-I1-BORROW, JACOBS-LOAN-REQUEST, H1 plan, HANDOFF, BUI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
    [BOM.csv, K09L-BOM.xlsx, flight_log.csv, range_log.csv, traveler.csv, wind_log.csv]
